digitalinvitro/CPLD-plus-8085/hardware/README.md

# hardware/ — машиночитаемые и визуальные данные платы retro_PCLD_board V2

Экспорт из EasyEDA (проект **CPLD_108_for_retro V2**, дата экспорта 2026-10-20) для платы
retro_PCLD_board V2 (Intel 8085 + CPLD XC95108). Словесным эталоном схемы остаётся
[SCHEMATIC.md](../SCHEMATIC.md) в корне репозитория; файлы здесь — экспорты того же проекта
в стандартных форматах.

## Состав

| Файл | Содержимое | Формат |
|---|---|---|
| `retro_PCLD_board-V2_2026-10-20.net` | Нетлист: 74 компонента, 126 цепей, 394 пина, с номиналами и корпусами | Текст (Protel/Tango): блоки `[ refdes / корпус / значение ]` + цепи `( ИМЯ пины )` |
| `retro_PCLD_board-V2_2026-10-20.svg` | Визуальная схема, один лист (Sheet_1, REV 1.0) | SVG, вектор, текст ищется поиском по странице |
| `BOM_CPLD_108_for_retro-V2_2026-10-20.csv` | Перечень элементов: 45 позиций / 74 компонента | CSV, UTF-8, разделитель — табуляция |

## Верификация (2026-10-21)

- 126/126 цепей и все 394 пина нетлиста совпали с §6 SCHEMATIC.md (имена и наборы пинов);
- цоколёвки всех компонентов совпали с §5 SCHEMATIC.md, расхождений нет;
- одно-пиновых цепей нет; номиналы нетлиста совпадают с колонкой Name в BOM;
- нетлист 2026-10-20 побитно совпал по топологии с ранее проверенным нетлистом
  2026-10-05 — схема не менялась.

## Примечания

- В экспортном BOM отсутствовала позиция LD1 — добавлена строка 45:
  **LD1 = 4-разрядный 7-сегментный индикатор 14,2 мм (0.56"), общий анод,
  Kingbright CA56-126WA** (аноды цифр CA0–CA3 = пины 6/8/9/12; сегменты
  a/b/c/d/e/f/g/dp = пины 11/7/4/2/1/10/5/3).
- Штамп SVG не обновлялся с 2024-12-25 (TITLE: Sheet_1, Company: Your Company) —
  косметика исходного проекта EasyEDA, на схему не влияет.
- «retro_PCLD_board V2» — имя листа/платы, «CPLD_108_for_retro» — имя проекта в
  EasyEDA; это одна и та же плата.
- Не включены (есть в поставке экспорта, добавляются по решению владельца): исходник
  проекта EasyEDA (JSON), Altium .schdoc, PADS-вариант нетлиста (без номиналов),
  SPICE-нетлист.
- Ключевые компоненты: U1 XC95108-PQG100, U3 i8085 в панели ZIF40, U4 SRAM 64K×8
  (UM61512AK-15), U6 CH340G с кварцем X1 12 МГц, U7 LTC6905HS5-80 (в схеме — 80MHz),
  U10 A29040B (flash 512K×8).
