digitalinvitro/CPLD-plus-8085/SCHEMATIC.md

# SCHEMATIC.md — центральная база знаний схемы retro_PCLD_board

> **Правила ведения (договорённость с владельцем проекта):**
> 1. Этот файл — **единственный центральный источник сведений о схеме**.
>    Возвращаясь к проекту, читаем его, а НЕ перечитываем SCHDOC/нетлисты/переписку.
> 2. История изменений проекта ведётся **только в `history.txt`** (корень проекта).
> 3. В исходниках проекта (HDL, прошивки, программы) **исторических сведений нет**.
> 4. При любом изменении схемы: обновляем этот файл + дописываем запись в `history.txt`.
> 5. Таблицы ниже генерируются скриптом `scripts/build_kb.py`; курируемые разделы
>    (описания, проблемы, блоки) редактируются в самом скрипте или прямо в файле.

## 1. Что это за плата

Отладочная плата ретро-системы на процессоре **Intel 8080/8085** (совместимость по шине):
- **U1 XC95108-PQG100** (Xilinx CPLD, MQFP-100, LCSC C3273098) — вся логика обвязки:
  шина процессора, дешифраторы, клавиатура/индикатор, UART-мост, JTAG-логика;
- **U3 ZIF40** — панель под i8085 (процессор устанавливается без пайки);
- **U10 A29040B** (DIP32) — flash 512Kx8, ПЗУ;
- **U4** «64k x 8 bit SRAM» SKINNY-32 (аннотация на схеме: UM61512AK-15) — ОЗУ;
- **U6 CH340G** — USB-UART мост (Type-C), кварц X1 12 МГц + C1/C2 22p;
- **USB2 Type-C 16P** — разъём питания и USB-UART;
- **U7 LTC6905HS5-80** — тактовый генератор (синтезатор частот) для CPLD: фиксированная опорная частота 80 МГц, встроенный делитель на входе DIV, управляется перемычкой H1 (§5); расхождение с замером Task 29 — §7.5;
- **LD1** — 4-разрядный 7-сегментный индикатор (общий анод, 14,2 мм); драйверы цифр VT1-VT4;
- клавиатура 5x4 (19 тактовых кнопок SW1-SW19 + SW20 RESET);
- **J1** — нестандартный JTAG 1x6 для прошивки CPLD;
- **BUZZER1** — звукоизлучатель (звуковая сигнализация);
- **LED2** — светодиод индикации питания;
- питание: +5 В с USB VBUS; блокировочные конденсаторы — керамика 0,1 мкФ (12 шт.) и электролиты 1000 мкФ (2 шт.); R21-R25 10k — подтяжки рядов клавиатуры на GND.

Концепция: CPLD эмулирует недостающую обвязку классической микро-ЭВМ (шина, COM-порт,
клавиатура/индикация), пользовательский i8085 выполняет программу из flash, ОЗУ — данные.

## 2. Источники и их статус

| Файл | Что это | Статус |
|---|---|---|
| `upload/retro_PCLD_board-V2_2026-10-07.schdoc` | Схема, экспорт EasyEDA Pro -> Protel ASCII v5 | **ЭТАЛОН** (22/22 проверки пройдены, 2026-10-07) |
| `upload/retro_PCLD_board-V2_2026-10-07(1).net` | Нетлист PADS-PCB (родной экспорт FreePCB, RX/TX поправлен пользователем) | Валиден; **топологически идентичен эталону** (126/126 цепей) |
| `ref/retro_PCLD_board-V2_2026-10-05.net` | Нетлист PADS-PCB, восстановлен из git-истории репо (коммит `d8ca176`); RX/TX уже объединены | Источник фактических имён цепей для §6 (126 сигналов) |
| `download/schdoc_netlist_final.json` | Машиночитаемый нетлист эталона | производный от SCHDOC |
| `download/schdoc_netlist_final.txt` | Текстовый список цепей эталона | производный |
| `scripts/freepcb_parsed.json` | Машиночитаемый разбор .net | производный |
| EasyEDA-JSON нетлист (первая сессия) | Экспорт EasyEDA Classic | **ЗАБРАКОВАН** — 28 некорректных пинов U10 |

Важно: SCHDOC от 2026-10-07 — уже **исправленная** версия (объединены метки UART TX/RX).
Старая версия от 2026-10-05 имела разрыв UART: TX(U6.2)!=Tx(U1.38), RX(U6.3)!=Rx(U1.39).

## 3. Сводка соединений (проверено)

- компонентов: **74**, физических пинов: **431**
- цепей: **126**, подключённых пинов: **394**
- не подключёно: **37 пинов**, все помечены No-ERC (X) на схеме
- VCC: **38 пинов**, GND: **44 пина**
- прямых касаний пин-пин без провода: **10** (драйверы индикатора — см. §7)
- 1-пиновых цепей: **0**

## 4. Состав компонентов (74)

| Ref | Библиотека | Корпус | Комментарий |
|---|---|---|---|
| BUZZER1 | BUZZER-12X9 | BUZ-TH_BD12.0-P7.60-D0.6-FD | BUZZER-12X9 |
| C1 | 22pF | C0805 | 22pF |
| C10 | 0.1uF | C0805 | 0.1uF |
| C11 | 0.1uF | C0805 | 0.1uF |
| C12 | 0.1uF | C0805 | 0.1uF |
| C13 | 0.1uF | C0805 | 0.1uF |
| C14 | 1000u | CAP-D6.3-F2.5 | 1000u |
| C15 | 0.1uF | C0805 | 0.1uF |
| C16 | 1000u | CAP-D6.3-F2.5 | 1000u |
| C17 | 0.1uF | C0805 | 0.1uF |
| C2 | 22pF | C0805 | 22pF |
| C3 | 0.1u | C0805 | 0.1u |
| C4 | 0.1uF | C0805 | 0.1uF |
| C5 | 0.1uF | C0805 | 0.1uF |
| C6 | 0.1uF | C0805 | 0.1uF |
| C7 | 0.1uF | C0805 | 0.1uF |
| C8 | 0.1uF | C0805 | 0.1uF |
| C9 | 0.1uF | C0805 | 0.1uF |
| H1 | 2.54-1*3 | HDR-TH_3P-P2.54-V-M-1 | 2.54-1*3 |
| J1 | JTAG | HDR-M-2.54_1X6 | JTAG |
| LD1 | DISPLAY 14.2MM RED 4DIGIT CA | 12PIN QUAD LED DISPLAY TH100X600 | DISPLAY 14.2MM RED 4DIGIT CA |
| LED2 | POWER | LED-TH_BD3.0_GREEN | POWER |
| R1 | 1K | R0805 | 1K |
| R10 | 240 | R0805 | 240 |
| R11 | 240 | R0805 | 240 |
| R12 | 240 | R0805 | 240 |
| R18 | 240 | R0805 | 240 |
| R19 | 16K | R0805 | 16K |
| R2 | 240 | R0805 | 240 |
| R20 | 1.1K | R0805 | 1.1K |
| R21 | 10k | R0805 | 10k |
| R22 | 10k | R0805 | 10k |
| R23 | 10k | R0805 | 10k |
| R24 | 10k | R0805 | 10k |
| R25 | 10k | R0805 | 10k |
| R3 | 5.1k | R0805 | 5.1k |
| R4 | 100 | R0805 | 100 |
| R5 | 240 | R0805 | 240 |
| R6 | 240 | R0805 | 240 |
| R7 | 240 | R0805 | 240 |
| R8 | 240 | R0805 | 240 |
| R9 | 240 | R0805 | 240 |
| SW1 | A | B3F-1052 | A |
| SW10 | 5 | B3F-1052 | 5 |
| SW11 | 6 | B3F-1052 | 6 |
| SW12 | F | B3F-1052 | F |
| SW13 | 1 | B3F-1052 | 1 |
| SW14 | 2 | B3F-1052 | 2 |
| SW15 | 3 | B3F-1052 | 3 |
| SW16 | _ | B3F-1052 | _ |
| SW17 | 0 | B3F-1052 | 0 |
| SW18 | F1 | B3F-1052 | F1 |
| SW19 | F2 | B3F-1052 | F2 |
| SW2 | B | B3F-1052 | B |
| SW20 | RESET | KEY-TH_OMRON_B3F-31XX | RESET |
| SW3 | C | B3F-1052 | C |
| SW4 | D | B3F-1052 | D |
| SW5 | 7 | B3F-1052 | 7 |
| SW6 | 8 | B3F-1052 | 8 |
| SW7 | 9 | B3F-1052 | 9 |
| SW8 | E | B3F-1052 | E |
| SW9 | 4 | B3F-1052 | 4 |
| U1 | XC95108-PQG100 | MQFP-100_L20.0-W14.0-P0.65-LS24.0-BL | XC95108-PQG100 |
| U10 | A29040B | DIP32 | A29040B |
| U3 | ZIF40 | 40 PIN ZIF SOCKET | ZIF40 |
| U4 | 64k x 8 bit SRAM | SKINNY-32 | 64k x 8 bit SRAM |
| U6 | CH340G | CH340G | CH340G |
| U7 | 80MHz | TSOT-23-5_L2.9-W1.6-P0.95-LS2.8-BR | 80MHz; по маркировке: LTC6905HS5-80 |
| USB2 | CQ-USB- TYPE-C 16P | USB-C-SMD_CQ-USB-TYPE-C | CQ-USB- TYPE-C 16P |
| VT1 | ? | TO-92-3_L4.9-W3.7-P1.27-L | — |
| VT2 | ? | TO-92-3_L4.9-W3.7-P1.27-L | — |
| VT3 | ? | TO-92-3_L4.9-W3.7-P1.27-L | — |
| VT4 | ? | TO-92-3_L4.9-W3.7-P1.27-L | — |
| X1 | 12MHZ | OSC-49S-1 | 12MHZ |

## 5. Ключевые цоколёвки (пин -> цепь)

### U1 — Xilinx XC95108, PQFP-100 (CPLD)

Все 100 пинов подключены: 7xVCC (7,28,40,53,59,90,100), 8xGND (2,23,33,46,64,71,77,86), 85 I/O.

| Пин | Имя пина | Цепь |
|---|---|---|
| 1 | IO_GSTR | RST |
| 2 | GND | GND |
| 3 | IO3F2 | A14 |
| 4 | IO4F2 | A12 |
| 5 | IO_GTS1 | g |
| 6 | IO_GTS2 | dig0 |
| 7 | VCCint_5V | VCC |
| 8 | IO8F2 | A13 |
| 9 | IO9F2 | A7 |
| 10 | IO10F2 | A8 |
| 11 | IO11F2 | A6 |
| 12 | IO12F2 | A9 |
| 13 | IO13F2 | A5 |
| 14 | IO14F2 | A11 |
| 15 | IO15F1 | A4 |
| 16 | IO16F1 | #OEr |
| 17 | IO17F1 | A3 |
| 18 | IO18F1 | A10 |
| 19 | IO19F1 | A2 |
| 20 | IO20F1 | #CSr |
| 21 | IO21F1 | A1 |
| 22 | IO22F1 | D7 |
| 23 | GND | GND |
| 24 | IO_GCK1 | #WE |
| 25 | IO_GCK2 | #CS |
| 26 | IO26F1 | A0 |
| 27 | IO27F1 | D6 |
| 28 | VCCio_3.3/5 | VCC |
| 29 | IO_GCK3 | clk |
| 30 | IO30F1 | D0 |
| 31 | IO31F3 | D5 |
| 32 | IO32F3 | D1 |
| 33 | GND | GND |
| 34 | IO34F3 | D4 |
| 35 | IO35F3 | D2 |
| 36 | IO36F3 | D3 |
| 37 | IO37F3 | #OE |
| 38 | IO38F3 | TX |
| 39 | IO39F3 | RX |
| 40 | VCCio_3.3/5 | VCC |
| 41 | IO41F3 | col3 |
| 42 | IO42F3 | col2 |
| 43 | IO43F3 | col1 |
| 44 | IO44F3 | col0 |
| 45 | IO45F3 | a |
| 46 | GND | GND |
| 47 | TDI | TDI |
| 48 | IO48F5 | dig3 |
| 49 | TMS | TMS |
| 50 | TCK | TCK |
| 51 | IO51F3 | row4 |
| 52 | IO52F5 | row3 |
| 53 | VCCio_3.3/5 | VCC |
| 54 | IO54F5 | row2 |
| 55 | IO55F5 | row1 |
| 56 | IO56F5 | row0 |
| 57 | IO57F5 | d |
| 58 | IO58F5 | e |
| 59 | VCCint_5V | VCC |
| 60 | IO60F5 | dp56 |
| 61 | IO61F5 | c |
| 62 | IO62F5 | b |
| 63 | IO63F5 | dig1 |
| 64 | GND | GND |
| 65 | IO65F5 | dig2 |
| 66 | IO66F5 | f |
| 67 | IO67F6 | SND |
| 68 | IO68F6 | cpu21 |
| 69 | IO69F6 | cpu20 |
| 70 | IO70F6 | cpu19 |
| 71 | GND | GND |
| 72 | IO72F6 | cpu18 |
| 73 | IO73F6 | cpu17 |
| 74 | IO74F6 | cpu16 |
| 75 | IO75F6 | cpu15 |
| 76 | IO76F6 | cpu14 |
| 77 | GND | GND |
| 78 | IO78F6 | cpu13 |
| 79 | IO79F6 | cpu12 |
| 80 | IO80F6 | cpu11 |
| 81 | IO81F6 | cpu10 |
| 82 | IO82F4 | cpu9 |
| 83 | IO83F4 | cpu8 |
| 84 | IO84F4 | cpu7 |
| 85 | TDO | TDO |
| 86 | GND | GND |
| 87 | IO87F4 | cpu6 |
| 88 | IO88F4 | cpu5 |
| 89 | IO89F4 | cpu4 |
| 90 | VCCio_3.3/5 | VCC |
| 91 | IO91F4 | cpu3 |
| 92 | IO92F4 | cpu2 |
| 93 | IO93F4 | cpu1 |
| 94 | IO94F4 | cpu0 |
| 95 | IO95F4 | A18 |
| 96 | IO96F4 | A16 |
| 97 | IO97F4 | A15 |
| 98 | IO98F2 | A17 |
| 99 | IO99F2 | CS |
| 100 | VCCint_5V | VCC |

### U3 — ZIF-панель на 40 пинов под i8085

Цоколёвка = Intel P8085A: AD0-AD7(12-19)->шина A0-A7, A8-A15(21-28), VCC=40, GND=20; управление: cpu0-21 (29-39 = cpu0..cpu10; 1-11 = cpu21..cpu11 по убыванию).

| Пин | Имя пина | Цепь |
|---|---|---|
| 1 | 1 | cpu21 |
| 2 | 2 | cpu20 |
| 3 | 3 | cpu19 |
| 4 | 4 | cpu18 |
| 5 | 5 | cpu17 |
| 6 | 6 | cpu16 |
| 7 | 7 | cpu15 |
| 8 | 8 | cpu14 |
| 9 | 9 | cpu13 |
| 10 | 10 | cpu12 |
| 11 | 11 | cpu11 |
| 12 | 12 | A0 |
| 13 | 13 | A1 |
| 14 | 14 | A2 |
| 15 | 15 | A3 |
| 16 | 16 | A4 |
| 17 | 17 | A5 |
| 18 | 18 | A6 |
| 19 | 19 | A7 |
| 20 | 20 | GND |
| 21 | 21 | A8 |
| 22 | 22 | A9 |
| 23 | 23 | A10 |
| 24 | 24 | A11 |
| 25 | 25 | A12 |
| 26 | 26 | A13 |
| 27 | 27 | A14 |
| 28 | 28 | A15 |
| 29 | 29 | cpu0 |
| 30 | 30 | cpu1 |
| 31 | 31 | cpu2 |
| 32 | 32 | cpu3 |
| 33 | 33 | cpu4 |
| 34 | 34 | cpu5 |
| 35 | 35 | cpu6 |
| 36 | 36 | cpu7 |
| 37 | 37 | cpu8 |
| 38 | 38 | cpu9 |
| 39 | 39 | cpu10 |
| 40 | 40 | VCC |

### U10 — A29040B flash 512Kx8, DIP32

| Пин | Имя пина | Цепь |
|---|---|---|
| 1 | A18 | A18 |
| 2 | A16 | A16 |
| 3 | A15 | A15 |
| 4 | A12 | A12 |
| 5 | A7 | A7 |
| 6 | A6 | A6 |
| 7 | A5 | A5 |
| 8 | A4 | A4 |
| 9 | A3 | A3 |
| 10 | A2 | A2 |
| 11 | A1 | A1 |
| 12 | A0 | A0 |
| 13 | D0 | D0 |
| 14 | D1 | D1 |
| 15 | D2 | D2 |
| 16 | GND | GND |
| 17 | D3 | D3 |
| 18 | D4 | D4 |
| 19 | D5 | D5 |
| 20 | D6 | D6 |
| 21 | D7 | D7 |
| 22 | /CE | #CSr |
| 23 | A10 | A10 |
| 24 | /OE | #OEr |
| 25 | A11 | A11 |
| 26 | A9 | A9 |
| 27 | A8 | A8 |
| 28 | A13 | A13 |
| 29 | A14 | A14 |
| 30 | A17 | A17 |
| 31 | /WE | N$14 |
| 32 | VCC | VCC |

### U4 — SRAM 64Kx8 (UM61512AK-15), SKINNY-32

| Пин | Имя пина | Цепь |
|---|---|---|
| 1 | N/C | — не подключён (No-ERC) — |
| 2 | N/C | — не подключён (No-ERC) — |
| 3 | A14 | A14 |
| 4 | A12 | A12 |
| 5 | A7 | A7 |
| 6 | A6 | A6 |
| 7 | A5 | A5 |
| 8 | A4 | A4 |
| 9 | A3 | A3 |
| 10 | A2 | A2 |
| 11 | A1 | A1 |
| 12 | A0 | A0 |
| 13 | I/O1 | D0 |
| 14 | I/O2 | D1 |
| 15 | I/O3 | D2 |
| 16 | GND | GND |
| 17 | I/O4 | D3 |
| 18 | I/O5 | D4 |
| 19 | I/O6 | D5 |
| 20 | I/O7 | D6 |
| 21 | I/O8 | D7 |
| 22 | /CE | #CS |
| 23 | A10 | A10 |
| 24 | /OE | #OE |
| 25 | A11 | A11 |
| 26 | A9 | A9 |
| 27 | A8 | A8 |
| 28 | A13 | A13 |
| 29 | /WE | #WE |
| 30 | CE2 | CS |
| 31 | A15 | A15 |
| 32 | +5v | VCC |

### U6 — CH340G USB-UART, SOP-16

| Пин | Имя пина | Цепь |
|---|---|---|
| 1 | GND | GND |
| 2 | TXD | TX |
| 3 | RXD | RX |
| 4 | V3 | N$4 |
| 5 | UD+ | N$39 |
| 6 | UD- | N$38 |
| 7 | XI | N$2 |
| 8 | XO | N$3 |
| 9 | CTS# | — не подключён (No-ERC) — |
| 10 | DSR# | — не подключён (No-ERC) — |
| 11 | RI | — не подключён (No-ERC) — |
| 12 | DCD# | — не подключён (No-ERC) — |
| 13 | DTR# | — не подключён (No-ERC) — |
| 14 | RTS# | — не подключён (No-ERC) — |
| 15 | R232 | — не подключён (No-ERC) — |
| 16 | VCC | VCC |

### USB2 — USB Type-C 16P

| Пин | Имя пина | Цепь |
|---|---|---|
| 0 | EP | — не подключён (No-ERC) — |
| A1B12 | GND | GND |
| A4B9 | VBUS | VCC |
| A5 | CC1 | — не подключён (No-ERC) — |
| A6 | DP1 | N$39 |
| A7 | DN1 | N$38 |
| A8 | SBU1 | — не подключён (No-ERC) — |
| B1A12 | GND | GND |
| B4A9 | VBUS | VCC |
| B5 | CC2 | N$18 |
| B6 | DP2 | N$39 |
| B7 | DN2 | N$38 |
| B8 | SBU2 | — не подключён (No-ERC) — |

### U7 — LTC6905HS5-80: тактовый генератор 80 МГц, TSOT-23-5 (см. §7.5)

| Пин | Имя пина | Цепь |
|---|---|---|
| 1 | V+ | VCC |
| 2 | GND | GND |
| 3 | OE | N$15 |
| 4 | DIV | N$5 |
| 5 | OUT | clk |

Назначение выводов (даташит LTC6905-XXX): V+ — питание; OE — разрешение выхода
(подключён через R19 16K + R20 1.1K к VCC — выход постоянно включён); DIV —
трёхуровневый вход выбора деления (VCC -> /1, плавающее состояние -> /2, GND -> /4),
управляется перемычкой H1; OUT — выход тактовой частоты в цепь clk.

### LD1 — Индикатор на 4 цифры, общий анод, 12 пинов

| Пин | Имя пина | Цепь |
|---|---|---|
| 1 | e | e |
| 2 | d | d |
| 3 | CL | dp56 |
| 4 | c | c |
| 5 | g | g |
| 6 | CA0 | N$9 |
| 7 | b | b |
| 8 | CA1 | N$6 |
| 9 | CA2 | N$7 |
| 10 | f | f |
| 11 | a | a |
| 12 | CA3 | N$8 |

### J1 — JTAG 1x6 (нестандартная распиновка)

| Пин | Имя пина | Цепь |
|---|---|---|
| 1 | 1 | VCC |
| 2 | 2 | TCK |
| 3 | 3 | TDO |
| 4 | 4 | TDI |
| 5 | 5 | TMS |
| 6 | 6 | GND |

### H1 — Перемычка 1x3 (выбор режима генератора U7)

| Пин | Имя пина | Цепь |
|---|---|---|
| 1 | 1 | GND |
| 2 | 2 | N$5 |
| 3 | 3 | VCC |

Средний контакт H1.2 соединён с входом DIV генератора U7.4 (цепь N$5); крайние
контакты: H1.1 — GND, H1.3 — VCC. Вход DIV — трёхуровневый (three-state): уровень
на нём задаёт коэффициент деления опорной частоты U7 80 МГц (даташит LTC6905-XXX).
Такое подключение реализует все три состояния входа DIV, предусмотренные даташитом:

| Положение перемычки | Уровень DIV -> деление | GCK3 | X1 (после /5 в U1) | CPU (X1/2) | Режим |
|---|---|---|---|---|---|
| Шунт H1.1–H1.2 | GND -> /4 | 20 МГц | 4,0 МГц | 2,0 МГц | **штатный** (замер Task 29 дал 25 МГц — см. §7.5) |
| Шунт снят (H1.2 свободен) | плавающее состояние -> /2 | 40 МГц | 8,0 МГц | 4,0 МГц | нештатный: CPU выше спецификации i8085A (3 МГц) |
| Шунт H1.2–H1.3 | VCC -> /1 | 80 МГц | 16,0 МГц | 8,0 МГц | **запрещено**: срыв генерации CPU (см. §7.5). НЕ переключать |

Примечание: штатное положение — шунт между H1.1 и H1.2 (DIV = GND, деление /4);
фактическую установку на плате сверить по фото Task 29 (upload/).

## 6. Полный список цепей (126)

Имена цепей канонические — как в SCHDOC. Колонка «Имя в .net» заполнена фактическими
именами из нетлиста `retro_PCLD_board-V2_2026-10-05.net` (см. §2, `ref/`); сопоставление
выполнено скриптом `scripts/fill_net_names.py` по наборам пинов: 126/126 цепей идентичны.
Правила имён: именованные цепи — в верхнем регистре (`cpu0`->`CPU0`, `clk`->`CLK`),
безымянные — автогенерированы в формате `REF_PIN` (`N$5`->`U7_4`, `N$15`->`U7_3`).

| Цепь (SCHDOC) | Имя в .net | Пины | Назначение |
|---|---|---|---|
| #CS | #CS | U1.25, U4.22 |  |
| #CSr | #CSR | U1.20, U10.22 |  |
| #OE | #OE | U1.37, U4.24 |  |
| #OEr | #OER | U1.16, U10.24 |  |
| #WE | #WE | U1.24, U4.29 |  |
| A0 | A0 | U1.26, U10.12, U3.12, U4.12 |  |
| A1 | A1 | U1.21, U10.11, U3.13, U4.11 |  |
| A10 | A10 | U1.18, U10.23, U3.23, U4.23 |  |
| A11 | A11 | U1.14, U10.25, U3.24, U4.25 |  |
| A12 | A12 | U1.4, U10.4, U3.25, U4.4 |  |
| A13 | A13 | U1.8, U10.28, U3.26, U4.28 |  |
| A14 | A14 | U1.3, U10.29, U3.27, U4.3 |  |
| A15 | A15 | U1.97, U10.3, U3.28, U4.31 |  |
| A16 | A16 | U1.96, U10.2 |  |
| A17 | A17 | U1.98, U10.30 |  |
| A18 | A18 | U1.95, U10.1 |  |
| A2 | A2 | U1.19, U10.10, U3.14, U4.10 |  |
| A3 | A3 | U1.17, U10.9, U3.15, U4.9 |  |
| A4 | A4 | U1.15, U10.8, U3.16, U4.8 |  |
| A5 | A5 | U1.13, U10.7, U3.17, U4.7 |  |
| A6 | A6 | U1.11, U10.6, U3.18, U4.6 |  |
| A7 | A7 | U1.9, U10.5, U3.19, U4.5 |  |
| A8 | A8 | U1.10, U10.27, U3.21, U4.27 |  |
| A9 | A9 | U1.12, U10.26, U3.22, U4.26 |  |
| CS | CS | U1.99, U4.30 |  |
| D0 | D0 | U1.30, U10.13, U4.13 |  |
| D1 | D1 | U1.32, U10.14, U4.14 |  |
| D2 | D2 | U1.35, U10.15, U4.15 |  |
| D3 | D3 | U1.36, U10.17, U4.17 |  |
| D4 | D4 | U1.34, U10.18, U4.18 |  |
| D5 | D5 | U1.31, U10.19, U4.19 |  |
| D6 | D6 | U1.27, U10.20, U4.20 |  |
| D7 | D7 | U1.22, U10.21, U4.21 |  |
| GND | GND | C1.2, C10.2, C11.2, C12.2, C13.2, C14.2, C15.2, C16.2, C17.2, C2.2, C3.2, C4.2, C5.2, C6.2, C7.2, C8.2, C9.2, H1.1, J1.6, LED2.2, R21.2, R22.2, R23.2, R24.2, R25.2, R3.2, R4.1, SW20.3, SW20.4, U1.2, U1.23, U1.33, U1.46, U1.64, U1.71, U1.77, U1.86, U10.16, U3.20, U4.16, U6.1, U7.2, USB2.A1B12, USB2.B1A12 | Земля (44 пина) |
| RST | RST | SW20.1, U1.1 | Сброс системы: SW20 -> GSTR(U1.1). ПРИМЕЧАНИЕ Task 25: на плате кнопка с активным уровнем 1 (покой RST=0, нажатие RST=1 — эксперименты A/B/C); netlist противоречит (подтяжка R2 240 к VCC на SW20.2 должна давать актив.0) — проверить установку R2/SW20 мультиметром (U1.1: покой ~0 В, нажатие ~+5 В) |
| RX | RX | U1.39, U6.3 | UART RX: CH340G RXD(U6.3) <-> CPLD Tx-выход(U1.39); метки унифицированы 2026-10-07 |
| SND | SND | BUZZER1.1, U1.67 | Звук: CPLD -> BUZZER1.1 (активный звукоизлучатель, питание от VCC) |
| TCK | TCK | J1.2, U1.50 | JTAG TCK (J1.2) |
| TDI | TDI | J1.4, U1.47 | JTAG TDI (J1.4) |
| TDO | TDO | J1.3, U1.85 | JTAG TDO (J1.3) |
| TMS | TMS | J1.5, U1.49 | JTAG TMS (J1.5) |
| TX | TX | U1.38, U6.2 | UART TX: CH340G TXD(U6.2) <-> CPLD Rx-вход(U1.38); метки унифицированы 2026-10-07 |
| VCC | VCC | C10.1, C11.1, C12.1, C13.1, C14.1, C15.1, C16.1, C17.1, C4.1, C5.1, C6.1, C7.1, C8.1, C9.1, H1.3, J1.1, R1.1, R18.2, R2.1, R20.1, U1.100, U1.28, U1.40, U1.53, U1.59, U1.7, U1.90, U10.32, U3.40, U4.32, U6.16, U7.1, USB2.A4B9, USB2.B4A9, VT1.1, VT2.1, VT3.1, VT4.1 | Питание +5 В (38 пинов): USB VBUS; блокировка C4-C17 — керамика 0,1 мкФ x12 + электролиты 1000 мкФ x2 (C14, C16) |
| a | A | LD1.11, U1.45 |  |
| b | B | LD1.7, U1.62 |  |
| c | C | LD1.4, U1.61 |  |
| clk | CLK | U1.29, U7.5 | Тактирование CPLD: U7.5 (LTC6905HS5-80: опорная частота
  80 МГц; штатно деление /4 через H1 -> GCK3 = 20 МГц; замер Task 29 дал 25 МГц —
  см. §7.5) -> GCK3(U1.29) — глобальный тактовый сигнал CPLD;
  делитель U1: /5 -> X1 = 4,0 МГц штатно |
| col0 | COL0 | SW1.4, SW13.4, SW17.4, SW5.4, SW9.4, U1.44 |  |
| col1 | COL1 | SW10.4, SW14.4, SW18.4, SW2.4, SW6.4, U1.43 |  |
| col2 | COL2 | SW11.4, SW15.4, SW19.4, SW3.4, SW7.4, U1.42 |  |
| col3 | COL3 | SW12.4, SW16.4, SW4.4, SW8.4, U1.41 |  |
| cpu0 | CPU0 | U1.94, U3.29 |  |
| cpu1 | CPU1 | U1.93, U3.30 |  |
| cpu10 | CPU10 | U1.81, U3.39 |  |
| cpu11 | CPU11 | U1.80, U3.11 |  |
| cpu12 | CPU12 | U1.79, U3.10 |  |
| cpu13 | CPU13 | U1.78, U3.9 |  |
| cpu14 | CPU14 | U1.76, U3.8 |  |
| cpu15 | CPU15 | U1.75, U3.7 |  |
| cpu16 | CPU16 | U1.74, U3.6 |  |
| cpu17 | CPU17 | U1.73, U3.5 |  |
| cpu18 | CPU18 | U1.72, U3.4 |  |
| cpu19 | CPU19 | U1.70, U3.3 |  |
| cpu2 | CPU2 | U1.92, U3.31 |  |
| cpu20 | CPU20 | U1.69, U3.2 |  |
| cpu21 | CPU21 | U1.68, U3.1 |  |
| cpu3 | CPU3 | U1.91, U3.32 |  |
| cpu4 | CPU4 | U1.89, U3.33 |  |
| cpu5 | CPU5 | U1.88, U3.34 |  |
| cpu6 | CPU6 | U1.87, U3.35 |  |
| cpu7 | CPU7 | U1.84, U3.36 |  |
| cpu8 | CPU8 | U1.83, U3.37 |  |
| cpu9 | CPU9 | U1.82, U3.38 |  |
| d | D | LD1.2, U1.57 |  |
| dig0 | DIG0 | R5.1, U1.6 |  |
| dig1 | DIG1 | R10.1, U1.63 |  |
| dig2 | DIG2 | R11.1, U1.65 |  |
| dig3 | DIG3 | R12.1, U1.48 |  |
| dp56 | DP56 | LD1.3, U1.60 |  |
| e | E | LD1.1, U1.58 |  |
| f | F | LD1.10, U1.66 |  |
| g | G | LD1.5, U1.5 |  |
| row0 | ROW0 | R25.1, SW1.1, U1.56 |  |
| row1 | ROW1 | R24.1, SW5.1, U1.55 |  |
| row2 | ROW2 | R23.1, SW9.1, U1.54 |  |
| row3 | ROW3 | R22.1, SW13.1, U1.52 |  |
| row4 | ROW4 | R21.1, SW17.1, U1.51 |  |
| N$1 | BUZZER1_2 | BUZZER1.2, R4.2 | звукоизлучатель BUZZER1.2 -> токоограничивающий R4 100 -> GND |
| N$2 | U6_7 | C1.1, U6.7, X1.2 | кварц 12 МГц X1 -> C1 22p -> XI(U6.7) CH340G |
| N$3 | U6_8 | C2.1, U6.8, X1.1 | кварц 12 МГц X1 -> C2 22p -> XO(U6.8) CH340G |
| N$4 | U6_4 | C3.1, U6.4 | V3(CH340G) -> C3 0.1u -> GND (внутренний источник 3,3 В) |
| N$5 | U7_4 | H1.2, U7.4 | U7.4 -> перемычка H1.2 (H1: 1=GND, 3=VCC) — выбор коэффициента деления генератора (см. §5, H1) |
| N$6 | LD1_8 | LD1.8, R7.2 | CA1 индикатора LD1.8 -> R7 240 (коллекторная цепь VT2) |
| N$7 | LD1_9 | LD1.9, R8.2 | CA2 индикатора LD1.9 -> R8 240 (коллекторная цепь VT3) |
| N$8 | LD1_12 | LD1.12, R9.2 | CA3 индикатора LD1.12 -> R9 240 (коллекторная цепь VT4) |
| N$9 | LD1_6 | LD1.6, R6.2 | CA0 индикатора LD1.6 -> R6 240 (коллекторная цепь VT1) |
| N$10 | R1_2 | LED2.1, R1.2 | LED2 POWER (зелёный) -> R1 1K -> VCC |
| N$11 | VT2_2 | R10.2, VT2.2 | база VT2 -> R10 240 -> dig1 |
| N$12 | VT3_2 | R11.2, VT3.2 | база VT3 -> R11 240 -> dig2 |
| N$13 | VT4_2 | R12.2, VT4.2 | база VT4 -> R12 240 -> dig3 |
| N$14 | U10_31 | R18.1, U10.31 | ВНИМАНИЕ: /WE(U10.31) -> R18 240 -> VCC — единственное управление записью во flash |
| N$15 | U7_3 | R19.2, U7.3 | U7.3 -> R19 16K (цепь OE генератора 80 МГц) |
| N$16 | R19_1 | R19.1, R20.2 | узел R19.1–R20.2; R20 1.1K -> VCC (последовательно в цепи OE генератора) |
| N$17 | R2_2 | R2.2, SW20.2 | SW20 RESET.2 -> R2 240 -> VCC (подтяжка сброса); см. примечание к цепи RST (Task 25: плата ведёт себя как актив.1) |
| N$18 | USB2_B5 | R3.1, USB2.B5 | CC2 (USB2.B5) -> R3 5.1K -> GND (Rd для USB-C) |
| N$19 | VT1_2 | R5.2, VT1.2 | база VT1 -> R5 240 -> dig0 |
| N$20 | R6_1 | R6.1, VT1.3 | коллектор VT1 -> R6 240 -> CA0 |
| N$21 | R7_1 | R7.1, VT2.3 | коллектор VT2 -> R7 240 -> CA1 |
| N$22 | R8_1 | R8.1, VT3.3 | коллектор VT3 -> R8 240 -> CA2 |
| N$23 | R9_1 | R9.1, VT4.3 | коллектор VT4 -> R9 240 -> CA3 |
| N$24 | SW1_2 | SW1.2, SW2.1 | сегмент линии row0: SW1.2–SW2.1 (через внутренние выводы 1-2 кнопок) |
| N$25 | SW10_2 | SW10.2, SW11.1 | сегмент линии row2: SW10.2–SW11.1 |
| N$26 | SW9_2 | SW10.1, SW9.2 | сегмент линии row2: SW9.2–SW10.1 |
| N$27 | SW11_2 | SW11.2, SW12.1 | сегмент линии row2: SW11.2–SW12.1 |
| N$28 | SW14_1 | SW13.2, SW14.1 | сегмент линии row3: SW13.2–SW14.1 |
| N$29 | SW14_2 | SW14.2, SW15.1 | сегмент линии row3: SW14.2–SW15.1 |
| N$30 | SW15_2 | SW15.2, SW16.1 | сегмент линии row3: SW15.2–SW16.1 |
| N$31 | SW18_1 | SW17.2, SW18.1 | сегмент линии row4: SW17.2–SW18.1 |
| N$32 | SW19_1 | SW18.2, SW19.1 | сегмент линии row4: SW18.2–SW19.1 |
| N$33 | SW2_2 | SW2.2, SW3.1 | сегмент линии row0: SW2.2–SW3.1 |
| N$34 | SW3_2 | SW3.2, SW4.1 | сегмент линии row0: SW3.2–SW4.1 |
| N$35 | SW5_2 | SW5.2, SW6.1 | сегмент линии row1: SW5.2–SW6.1 |
| N$36 | SW6_2 | SW6.2, SW7.1 | сегмент линии row1: SW6.2–SW7.1 |
| N$37 | SW7_2 | SW7.2, SW8.1 | сегмент линии row1: SW7.2–SW8.1 |
| N$38 | U6_6 | U6.6, USB2.A7, USB2.B7 | USB D- (USB2.A7/B7 -> UD- U6.6) |
| N$39 | U6_5 | U6.5, USB2.A6, USB2.B6 | USB D+ (USB2.A6/B6 -> UD+ U6.5) |

## 7. Функциональные блоки (как устроено)

### 7.1 Шина процессора
- AD0-AD7 (ZIF 12-19) <-> CPLD, буферизуются в шину A0-A7; A8-A15 (ZIF 21-28)
  идут напрямую в память; A15 заведён и в SRAM (U4), A16-A18 — только во flash;
- D0-D7 — общая шина данных flash+SRAM+CPLD (cpu-порт D0-D7);
- управление: cpu0..cpu21 (29-39: HOLD,HLDA,CLK,RESET_IN,READY,IO/M,RD,WR,ALE,S0,S1;
  1-11: INTA->cpu11 … X1->cpu21 — по убыванию); RST -> GSTR(U1.1); тактирование: U7 LTC6905HS5-80 (база 80 МГц, штатно /4 = 20 МГц) -> GCK3(U1.29).

### 7.2 Питание и USB
- VBUS Type-C -> VCC (38 пинов); блокировочные конденсаторы C4-C17: керамика 0,1 мкФ (по одному у каждой МС) + электролиты 1000 мкФ (C14, C16);
- CC2 (B5) имеет Rd 5.1K на GND (R3); **CC1 (A5) НЕ подключён** — см. проблемы;
- LED2 POWER + R1 1K.

### 7.3 UART
- CH340G: UD±->USB, TXD(U6.2)->TX->U1.38, RXD(U6.3)<-RX<-U1.39; кварц 12 МГц X1+C1/C2 22p;
- неиспользуемые модемные сигналы U6.9-15 — No-ERC.

### 7.4 Индикатор и клавиатура
- Драйвер цифр: U1 dig0-3 -> R5/R10/R11/R12 240 -> базы VT1-VT4 (PNP, эмиттер на VCC);
  коллекторы -> R6/R7/R8/R9 240 -> CA0-CA3 (пины 6/8/9/12 LD1) — касания пин-пин без проводов;
- сегменты a-g и dp56 идут с CPLD напрямую (U1.45->a…U1.5->g, U1.60->dp56);
- клавиатура 5x4: ряды row0-row4 (R21-R25 10k на GND — подтяжки вниз), столбцы col0-col3;
  линии рядов замыкаются ЧЕРЕЗ внутренние выводы 1-2 тактовых кнопок (N$24-N$37 —
  сегменты этих линий; при трассировке PCB помнить: пины 1-2 B3F закорочены внутри);
- SW20 RESET: RST = SW20.1, подтяжка R2 240 к VCC на SW20.2. ПРИМЕЧАНИЕ Task 25:
  кнопка на плате с активным уровнем 1 (покой 0, нажатие 1); в CPLD RESET_IN = ~(RST|POR),
  сброс всех FF синхронный (RST|POR), GSR не используется.

### 7.5 Генератор тактовой частоты и JTAG
- **U7 = LTC6905HS5-80** (Analog Devices/Linear Technology, TSOT-23-5; чип подтверждён
  владельцем по маркировке корпуса) — кремниевый тактовый генератор семейства
  LTC6905-XXX с фиксированной опорной частотой 80 МГц и встроенным делителем
  на входе DIV. По даташиту вход DIV трёхуровневый: VCC -> /1 (80 МГц), плавающее
  состояние -> /2 (40 МГц), GND -> /4 (20 МГц); вход OE разрешает выход.
  На плате: OE (U7.3) подтянут к VCC через R19 16K + R20 1.1K (выход всегда включён),
  DIV (U7.4) идёт на средний контакт перемычки H1 (см. §5, H1), выход clk -> GCK3(U1.29).
  Характеристики семейства (даташит): питание 2,7-5,5 В, точность частоты ±0,5 % (тип.),
  температурная стабильность ±20 ppm/°C, запуск ~100 мкс, скважность 50 % ±2,5 %.
- Расхождение с замером Task 29 (2026-10-10, осциллограф, фото в upload/): при штатном
  DIV = GND (/4) ожидается GCK3 = 20 МГц -> X1 = 4,0 МГц -> CPU = 2,0 МГц; замер дал
  GCK3 = 25 МГц, X1 = 6,4 МГц, CLK OUT = 3,14 МГц (CPU исправен, CLK OUT = X1/2).
  Замеренные 25 МГц соответствовали бы чипу LTC6905-100 при делении /4. Причина не
  выяснена: неточность замера или другой чип семейства на плате — сверить маркировку,
  повторить замер.
- История: до установки делителя /5 в U1 наблюдались срывы тактирования CPU:
  X1 получал полную частоту GCK3 (замер 25 МГц -> внутренние 12,5 МГц) -> срыв
  генератора CPU на субгармонику ~1,5 МГц с паразитным акустическим шумом (в записях
  Task 29 фигурирует как «сверчок»). После добавления делителя U1: /5 (mod-5, декод
  с регистрацией) -> X1 = 5,0 МГц, CPU = 2,5 МГц — под прежнюю гипотезу базы ~100 МГц;
  при подтверждении опорной частоты 80 МГц ожидается X1 = 4,0 МГц, CPU = 2,0 МГц
  (см. ARCHITECTURE.md §7).
- J1 JTAG: 1=VCC, 2=TCK, 3=TDO, 4=TDI, 5=TMS, 6=GND; подтяжек TMS/TDI нет (см. проблемы).

### 7.6 Звук
- SND (CPLD) -> BUZZER1.1; BUZZER1.2 -> R4 100 -> GND.
- **10-24, статус по факту:** BUZZER1 (BUZZER-12X9) был активным излучателем —
  владелец заменил его на **пассивный** (тон чище, форму задаёт строб SND).
  Остался выброс индуктивности на фронте SND (слышен как глитч): кандидат —
  последовательный резистор 100–470 Ом в цепь SND, снаббер RC или
  встречно-параллельный диод. Детали — beta/01_timer/README.md.

## 8. Известные проблемы схемы

| № | Проблема | Статус |
|---|---|---|
| 1 | UART разорван из-за несовпадения регистра меток (TX!=Tx, RX!=Rx) | **ИСПРАВЛЕНО** в SCHDOC 2026-10-07: метки унифицированы, цепи TX/RX объединены |
| 2 | CC1 (USB2.A5) висит: Rd 5.1K только на CC2 — питание USB гарантировано только в одной ориентации кабеля | **ОТКРЫТА** |
| 3 | U10.31 /WE управляется только подтяжкой R18 240 к VCC — запись во flash невозможна (цепь N$14) | **ОТКРЫТА** |
| 4 | EP (shell) разъёма USB висит | **ОТКРЫТА** (низкий приоритет) |
| 5 | J1 JTAG без подтяжек TMS/TDI | **ОТКРЫТА** (для отладочной платы допустимо) |

## 9. Верификация

- `scripts/schdoc_extract.py` — парсер SCHDOC + 22 встроенные проверки эталона: все PASS
  (74 компонента / 431 пин / 126 цепей / 394 пина / VCC=38 / GND=44 / U10=32 / U3=i8085 /
  цепи UART объединены / 0 одно-пиновых / 37 No-ERC).
- `scripts/diff_nets.py` — поцепное сравнение SCHDOC <-> FreePCB .net: **126/126 цепей идентичны**
  по наборам пинов; расхождения только в именах (регистр + автогенерация).
- История вопроса «+10 цепей» (118->126): закрыта. 10 цепей — прямые касания пин-пин
  драйверов индикатора (VT/LD/R), старый парсер их не учитывал, FreePCB-нетлист — корректен.

## 10. Инструменты (scripts/)

| Скрипт | Назначение |
|---|---|
| `schdoc_extract.py` | Разбор Protel ASCII SCHDOC (диалект EasyEDA Pro) -> нетлист JSON/TXT + проверки эталона |
| `freepcb_parse.py` | Парсер/валидатор нетлистов FreePCB (`[parts]`/`[nets]`) и PADS-PCB (`*PART*`/`*NET*`/`*SIGNAL*`) |
| `diff_nets.py` | Поцепное сравнение двух нетлистов по множествам пинов |
| `build_kb.py` | Повторная генерация этого файла из JSON |

Повторная генерация эталона: `python3 scripts/schdoc_extract.py upload/retro_PCLD_board-V2_2026-10-07.schdoc --json download/schdoc_netlist_final.json --report download/schdoc_netlist_final.txt`

## 11. Памятка ИИ-агенту

- Любой вопрос про соединения/цоколёвку/состав — смотреть §4-6 этого файла,
  а не перечитывать исходники; углубляться в SCHDOC только при подозрении на ошибку.
- При изменении схемы пользователем: прогнать `schdoc_extract.py` (если есть новый SCHDOC)
  и `diff_nets.py`, обновить §3-§8 и дописать `history.txt`.
- Имена цепей: канонические — SCHDOC; в HDL допустимы имена в верхнем регистре (clk->CLK и т.п.).
- Формат координат/записей SCHDOC и типичные проблемы парсинга — см. докстринг `schdoc_extract.py`.
