digitalinvitro/CPLD-plus-8085/ОПИСАНИЕ_РЕПОЗИТОРИЯ.md

# Описание сути репозитория (тестовый файл)

> Этот файл создан ИИ-агентом (Z.ai) в качестве тестового задания на работу с GitHub.
> Дата анализа: 21.10.2026. Анализ выполнен по файлам репозитория: нетлист, PDF-схема, состав файлов.

## Что это за проект

**CPLD-plus-8085** — экспериментальная учебная плата для ретро-вычислений на базе
легендарного 8-битного процессора **Intel 8085** (1976 г.) в корпусе DIP-40.

Особенность проекта: вместо классической «обвязки» из множества микросхем логики
(дешифраторы адреса, регистры, буферы) используется **CPLD Xilinx XC95108**
(семейство XC9500, 108 макроячеек, корпус TQFP-100 / PQG100), программируемый по JTAG.
Отсюда и название: **CPLD + 8085**.

## Ключевые компоненты (по нетлисту V2 от 2026-10-05)

| Обозначение | Компонент | Назначение |
|---|---|---|
| U3 | 40-pin ZIF-панель | Установка процессора Intel 8085 без пайки |
| U1 | Xilinx XC95108-PQG100 | CPLD: дешифрация адреса, системная логика, ввод-вывод |
| U4 | SKINNY-32 (панель) | Гнездо ПЗУ/EEPROM (32 выв.) |
| U10 | DIP32 | SRAM типа 62xx (статическое ОЗУ) |
| U6 | CH340G | USB-UART преобразователь (связь с ПК, загрузка программ) |
| U7 | TSOT-23-5 | Стабилизатор питания |
| X1 | OSC-49S | Кварцевый резонатор / тактирование |
| LD1 | QUAD LED DISPLAY | 4-разрядный семисегментный индикатор |
| BUZZER1, LED2 | Зуммер, светодиод | Звуковая и световая индикация |
| J1 | 6-pin разъём | JTAG-программирование CPLD (TCK, TDI, TDO, TMS) |

## Состав файлов репозитория

- `Schematic_CPLD_108_for_retro-V2_2026-10-05.pdf / .svg` — принципиальная схема (V2)
- `PCB_retro_CPLD_PCB-V2_2026-10-05.pdf / .svg` — печатная плата (V2)
- `retro_PCLD_board-V2_2026-10-05.schdoc` — исходник схемы (Altium Designer)
- `retro_PCLD_board-V2_2026-10-05.net` — нетлист платы (формат PADS-PCB)
- `i8085-DIP40.png` — изображение процессора Intel 8085

## Вывод

Это полноценный DIY-проект для изучения архитектуры классических микропроцессоров:
плата собирается из доступных компонентов, процессор вставляется в ZIF-панель,
логика проекта меняется перепрошивкой CPLD по JTAG, а результат виден на семисегментном
индикаторе и слышен через зуммер. Отличный «конструктор» для ретро-энтузиастов
и изучения того, как компьютер устроен «на низком уровне».

---
*Файл добавлен агентом Z.ai по просьбе владельца репозитория. Если он вам не нужен — просто удалите.*
