digitalinvitro/CPLD-plus-8085/beta/README.md

# beta/ — экспериментальные доработки «харда»

Папка для опытов над дизайном CPLD поверх **стабильного baseline** из `hdl/`
(`top_suart.v` v3.2, фит 2026-10-22 «POR6»: 91/108 MC, 0 WARNING/ERROR,
72/72 ноги по UCF, железо проверено в работе).

**Дневник разработки** — `beta/DEVLOG.md`: история версий, перенесённые из
RTL комментарии (с 11-7 шапки чистятся: v3.9.8 → `lowsize/top_suart_por6_v398_clear.v`),
наблюдения железа. В файлах дизайнов остаются только действующие решения.

## Правила

1. `hdl/` не трогаем: baseline остаётся эталоном, от него делаются ветки.
2. Каждый эксперимент — подпапка `beta/<имя>/` со своим комплектом:
   изменённый `.v` (или патч к baseline), `.ucf` (если меняются ноги),
   отчёт фиттера `.rpt` и краткий вывод (влез / не влез / что дало).
3. В `hdl/` переезжает только то, что прошло фит без ошибок И проверку
   на железе. Откат тривиален — baseline всегда в `hdl/`.
4. Свободный ресурс baseline (целься в него, не забивай под ноль):
   **17 MC, 50 FB-входов, 315 PT**; исчерпаны FB1 (входы 36/36) и
   FB6 (макроячейки 18/18); свободные ноги: P74, P75, P76, P78, P79,
   P81, P95, P96, P98 (сейчас PGND).

## Очередь экспериментов

| # | Идея | Статус |
|---|---|---|
| 1 | **Программируемый интервальный таймер** с выходом на маскируемое прерывание CPU (RST 7.5, нога P75): 8-разрядный с устанавливаемым значением, квант 51,2 мкс, ре-арм из ISR | **v3.3b3: ФИТ УСПЕШЕН** (10-22 22:04): 103/108 MC (запас 5), FB-входы 188/216, 0 ERROR; единственный WARNING 897 — D<7> в буфере (FB1: входы 36/36, пин P22 привязан к плате). **Готова тест-прошивка ПЗУ** `01_timer/rom/` v2 (тон ~470 Гц + мигание сегмента ~1 Гц; тихий blink-only вариант; v1 отозвана: PUSH B/POP B затирали счётчик мигания — тон работал, 'g' не мигал; протокол дефекта в README) — см. README. История провалов v3.3b1/b2 и лекарство — там же; ждёт tb и железа. **10-23: железо — тон/мигание v2 ПАСС** (осциллограмма: 493 Гц, меандр 50/50; «нечистый» тон — свойство активного излучателя). **10-23: тест UART** — `timer_test_uart.hex` v4 (бит = N×Q от таймера, 1 прерывание = 1 бит, 2400 бод по умолчанию; референс `uart_sw_test.hex` на софт-делеях). **Прогон на железе: мусор сериями в ~25% строк (дамп) → диагноз: коллизия границы кадра при TX 2465 бод (+2,7%) при кадрах вплотную (след. старт на 26% бита раньше конца кадра приёмника) → фикс v4: 2-й стоп-бит (холостой бит, 11 фронтов/символ), 207 байт. **Уточнена модель кванта**: период = ровно N тиков, Q ≈ 50,7 мкс (clk ≈ 25,2 МГц — «сверчок» +1%); 50 Гц — N=197; арбитр — частотомер на CLKOUT (~2,52 МГц) или прогон n10 (~986 Гц). **10-24: v4 ПАСС на железе** («текст ровный») — TX-тракт закрыт. **10-24: BUZZER1 заменён владельцем на пассивный** (тон чище; остался глитч от выброса индуктивности на фронте SND — кандидат на гасящий резистор, см. README 01_timer). **Следующий шаг: тест приёма-передачи (эхо, RIM/SID)**. XXX_ECHO_READY_XXX — `uart_echo_test.hex` (229 байт): баннер '>' + посимвольное эхо, приём через RIM/SID опросом с DI, 1-й зазор 1,5 бита загрузкой в таймер, сетка 8 квантов/бит из ISR, хвост 3 интервала (урок v4 зеркально: эхо-старт после конца кадра ПКА, запас +2,15 бита); CPLD не менялся (шьётся только ПЗУ); модель sim_uart_echo.py — 400 свипов, запас выборки 130 мкс; verify_hex.py v5 — 5 образов побайтово; paste — задокументированное ограничение v1. **10-24: эхо на железе — баннер '>' ЕСТЬ, эха НЕТ** (ввод не возвращается): TX доказан, приём PC→плата (CH340G.TXD → P38 → SID → RIM) упражняется впервые; бумажная сверка чиста (транзит в фите v3.3b3, медь по нетлисту) → **сделан uart_echo_diag.hex** (352 байта): логика эха не тронута, на дисплей выведены счётчик пойманных старт-битов и последний принятый байт (hex) — локализует разрыв (flow control терминала — главный подозреваемый: модемные линии CH340G не разведены; обрыв P38; SID/ZIF). Верификация: ISR = v1 байт в байт, вставки по контрольным точкам, симуляция с латентностью diag — ПАСС. **10-27: ВЕТКА ПРИОСТАНОВЛЕНА РЕШЕНИЕМ ВЛАДЕЛЬЦА** — возврат к baseline v3.2 (без таймера), софт-машину UART на таймере снять с испытаний, не дожидаясь эхо-теста. Счёт верификации на момент снятия: **TX ПАСС** (v4 «текст ровный», 10-24), **RX-уровень ПАСС дважды** (diag6 10-26, исход N1; 10-27 владелец подтвердил мультиметром сигнал терминала вплоть до CPU.SID и живую реакцию DIG0 на набор = RIM читает биты), **эхо-тест diag4 после починки контакта так и не прогнан** — финальная точка в верификации RX не поставлена (при этом найденные и исправленные по симуляции баги RX-кода v1–v3 никуда не деваются). Возврат: CPLD — фит baseline `hdl/` (POR6, 91/108 MC), ПЗУ — fw_mon в offset 0 (сейчас там diag6). Код, журнал и методика diag2–diag6 сохранены в `beta/01_timer/` — пригодятся при возвращении к таймеру (естественное место — второй CPLD, вариант «чипсет», см. обсуждение V3). Освободившиеся ресурсы baseline: 17 MC, 50 FB-входов, 315 PT |
| 2 | **hiclock — апгрейд тактирования**: U7 LTC6905-80 80 МГц → шунт H1 1-2 → GCK3 25 МГц → CLK_DIV в CPLD → X1/X2 противофазой на CPU (3,125 МГц) | Готовый v3.4 УЖЕ в `hdl/` как релиз (коммит `670c4da`, фит 10-27 10:06PM, железо ПАСС clk10-38: монитор 6000 8N1) — в beta живёт только **кандидат v3.5 «регистровая противофаза X2»** (`hiclock/`): латентный дефект v3.4 — комб. `assign X2 = ~X1` фиттер поднял в same-D регистр (X2 В ФАЗЕ с X1; CPU не задет, не блокер); v3.5 строит противофазу по построению — X2 = регистр `x2_q`, D = `~(x1_q ^ t0_q)` != D(x1_q), init (x1_q=1, x2_q=0), все 4 ветки generate, UCF без изменений (байт-в-байт = hdl). Статус: **дизайн закоммичен; ждёт фита владельца в ISE → .rpt на аудит (чек-лист в README hiclock) → только потом .jed; ДО АУДИТА НЕ ШИТЬ**. Фит 10-28 7:09PM (без v3.5, = v3.4 функционально) в зачёт не идёт — см. worklog clk10-42. **11-6/11-7: линия ВОЗВРАЩЕНА владельцем** — директива «на базе 3.9.8 поднять частоту до 4.167МГц, создать ее в hiclock»: кандидат **v3.9.9h** (база v3.9.8, ЕДИНСТВЕННАЯ переменная — кольцо one-hot N=7→N=6: r0..r5, X1 = r0 duty 1/6 120 нс, X2 = r1|..|r5 = ~r0; clk25/POR-цепь/сброс байт-в-байт v3.9.8) — CPU 4,167 МГц (T=240 нс), терминал 8000 8N1, POR 960 нс (запас 1,33x тот же). Верификация: перебор 64 кодов кольца (sim_v399h_ring6 — двойной kill необходим и достаточен) + tb_poweron_v399h (Icarus: P0a 1280 комбинаций, PX геометрия 120 нс — ПАСС). **Фит владельца 11-6 11:29PM — SUCCESSFUL: 93/108 МЦ (86%), 286 ПТ, 181 вх.ФБ, 64 рег — прогноз сошёлся ТОЧНО, аудит ПАСС** (r6 в нетлисте нет; X2 — своя МЦ, 1 ПТ/5 вх; WARNING 897 — известный буфер D<7>; GSR не использован, п.21 жив). Дизайн перенесён из корня репо в **beta/hiclock/** (историческая папка линии), отчёт: retro_pcld_top (v399h-fit1-1106-1129PM).rpt, шапка RTL дополнена п.25 (аудит фита). **ОГОВОРКА**: у экземпляра 4,17 МГц уже отклонялась (v3.10/v3.11, 10-29/30) — v3.9.9h = перепроверка на новой архитектуре тактирования (X1 duty 1/6 вместо 50/50); откат — .jed v3.9.8. Следующий шаг: .jed → железо (осциллограф: X1 120 нс duty 1/6, X2 противофаза, зазор WR#→ALE 60..108 нс, PUSH-стресс), терминал 8000 8N1. **ИТОГ 11-7: ЖЕЛЕЗО ОТКЛОНИЛО 4,167 МГЦ — кампания ЗАКРЫТА директивой владельца («отставим попытки выбраться за 4МГц»)**: у владельца полный запуск не состоялся (лучший результат линии за всю историю — стабильный POST «8.8.8.8»), стенд коллеги с регулируемым напряжением — CPU не пошёл даже на повышенном питании → предел в ядре ИМ1281ВМ85А, НЕ в питании и НЕ в тактовом тракте CPLD; лестница 25/N между 3,571 (N=7) и 4,167 (N=6) промежуточных шагов не имеет. Производство — **v3.9.8**; v3.9.9h — архивная проверенная платформа на случай экземпляра с лучшим частотным потенциалом |

| 3 | **lowsize — снижение количества ресурсов CPLD** (своя папка `beta/lowsize/`, директива владельца 10-30): база v3.9.1 (перенесена из hiclock; удалена защёлка wb_ram_q — предложение коллеги, п.16); кандидат v3.9.2 — делитель «кольцо N=7» → двоичный счётчик mod-7 (−4 МЦ, частоты/POR бит-в-бит v3.9). Решение владельца: соединение CE2/READY — внутри CPLD дизайном, без пайки (CS1/READY = ровно 2 МЦ по 0 ПТ и 0 входов ФБ). Тест-прошивки дисплея/клавиатуры — в `beta/lowsize/rom/` | **v3.9.1: фит 10-30 (88/108 МЦ, 205 ПТ, 186/216 вх. ФБ, 58 триггеров) — РАБОТАЕТ В ЖЕЛЕЗЕ 10-30** (МЦ не 87: фиттер отдал освободившуюся ячейку под переупаковку; выигрыш −9 ПТ, −16 вх. ФБ, исчерпан остался только ФБ3). **v3.9.2: фит 10-30 8:32PM — АУДИТ ПАСС (85/108 МЦ = ровно «85 при хелпере por_ce», 209 ПТ, 180/216 вх. ФБ, 54 триггера, X1/X2 XOR 4 ПТ, запрещённых литералов 0); ЖЕЛЕЗО 10-30: дисплей ПАСС, клавиатура ПАСС** (9 «мёртвых» кнопок были просто нераспаяны — цепи замыкались через них в линию); послесвечение глифов устранено в прошивках блэнкингом «гашение → разряд → глиф» (клк10-67). **ФИНАЛ 10-30: v3.9.2 ПРИНЯТА владельцем** — перепрошивка образами с блэнкингом, послесвечения нет; итог lowsize против v3.9: −3 МЦ (88→85), −22 вх. ФБ (202→180, 94%→83%), −5 ПТ, −5 триггеров, исчерпанных ФБ 4→1). **v3.9.3 (11-2): сброс логики → сеть GSR (п.18) — ЗАКРЫТА ПО ПОЛНОМУ ЦИКЛУ**: фит 11-2 7:54PM аудит ПАСС (86/108 МЦ, 192/540 ПТ, 173/216 вх. ФБ, 54 триггера — лучшие значения линейки; «Signal 'RST' mapped onto global set/reset net GSR», «GSR : 1 1», 38 триггеров через GSR, литералы сброса в термах 133→3); узловой сим владельца A–G ПАСС; **железо 11-2 — работоспособность подтверждена**; повторный фит 11-2 9:54PM (тот же RTL, 85/108 МЦ, 195 ПТ, 171/216 вх. ФБ — рекорд линии, исчерпанных ФБ нет, por_ce-хелперы $449/$452 как в v3.9.2, без Cpld:897) **ПРОШИТ и РАБОТАЕТ** — его .jed известен хороший. Следствие для txclient: перенос GSR-схемы (cpu_rst в фите v5 = 306 вхождений) — ВЫПОЛНЕНО 11-3 (txclient v7, см. строку 4). **11-5: v3.9.4 = М1 (por_sh 8→4 со стробом x1_n, одобрена «Делаем Б») — кандидат: генератор gen_v394.py (3 строки + п.19), дифсим v3.9.3 vs v3.9.4 (tb_v394_diff, Icarus) 10 595 циклов 0 расхождений + T0 (ровно 4 сдвига F→7→3→1→0, por_run 1020 нс ≥ 840, повторного POR нет); фит владельца 11-4 10:15PM — **SUCCESSFUL (82/108 МЦ, 182 ПТ, 168/216 вх. ФБ, 50 рег — рекорды линии по всем метрикам), аудит ПАСС** (М1 в нетлисте точная, GSR бит-в-бит v3.9.3; IL 16 вместо 28 — оговорка, разбор в README lowsize); .jed — чекпоинт маршрута Б «запасная прошивка»; дальше — v4.0.1 (перебазирование hwuart). **11-5: v3.9.5 — ДЕФЕКТ СТАРТА v3.9.3/v3.9.4 НАЙДЕН И ПОЧИНЕН** (жалоба владельца: нестабильный запуск по питанию/кнопке, v3.9.2 стабилен): мера GSR п.18 оставила FSM живой в окне POR на плавающей шине CPU — доказано fuzz-тестом «плавающей» шины (tb_por_fuzz.v, 100 сидов: грязь на выходе из POR v3.9.2 0/100 — v3.9.4 100/100 — v3.9.5 0/100; rd_drive-контеншн в POR 86 тактов только у v3.9.4); фикс п.20 — GSR-источник расширен RST → cpu_rst = RST|por_run (2 слова RTL, gen_v395.py; условие v3.9.2 на асинхронной структуре v3.9.3); дифсим v3.9.4 vs v3.9.5 — 10 595 циклов 0 расхождений, RST-окна строгие, T0 POR бит-в-бит; .jed v3.9.4 НЕ ШИТЬ (дефектная база) — фит v3.9.5 → .rpt на аудит (чек-лист 3c); НАСЛЕДНИКАМ ТА ЖЕ МЕРА: hwuart v4.0.2, txclient v9. **11-6: v3.9.6 — ХАРДРЕНИНГ ЦЕПИ СБРОСА (п.21)**: жалоба владельца на v3.9.5 (у ОБОИХ фитов Exhaustive ON/OFF): «только выкл-вкл питания возвращает работоспособность по сбросу; просто сброс не может восстановить»; гипотеза п.1 разбора (подтяжка RST) владельцем СНЯТА — резистор стоит давно; причина: в фите v3.9.5 сырой пин RST доходит напрямую до гейта RESET_IN и 40 PTC-сбросов (дребезг/фронт размазывает отпускание CPU и логики; модель sim_v395_rst_float: спад 10 мкс — BOOT 7-10/20, ложные /WE ~50%); мера: RST входит в кристалл ТОЛЬКО через регистры — 2FF-синхронизатор + квалификатор 8 тактов + cpu_rst = rst_press\|por_run + RESET_IN — регистр reset_q (INIT=0) + гейт S_T2 с !rst_press; POR бит-в-бит v3.9.4; tb_v396_rst — ВСЕ ПАСС (EQ 62 400 выборок 0 расхождений, кнопка 398 нс латентность, глитчи 100/250 нс НЕ сбрасывают — новое свойство, дребезг 8 экскурсий — финал чистый, сброс посреди /WE — импульс доводится до конца); прогноз 85-87 МЦ / 220-230 ПТ / 165-172 вх.ФБ / 57 рег; RTL+генератор+тб в beta/lowsize, ждёт фита владельца — ДО УСПЕШНОГО ФИТА НЕ ШИТЬ; наследникам — вместо «2 слов v4.0.2» полная мера п.21. **11-6bis: застревание сведено к аналоговой лотерее включения** (M1 «clk мёртв» — точное воспроизведение жалобы tb_poweron P2; «недопустимая ситуация делителя» опровергнута перебором; чек-лист D1-D4 владельцу). **11-6 (позже): v3.9.7 = ВОЗВРАТ КОЛЬЦЕВОГО ДЕЛИТЕЛЯ (п.22, директива владельца)** — полевой эксперимент с одной переменной: кольцо one-hot r0..r6 вместо счётчика mod-7 (пор-цепь М1/GSR/хардренинг — бит-в-бит v3.9.6); отказоустойчивость доказана на RTL (P0a: 4096 комбинаций, one-hot ≤2 фронтов из любого кода); выходы бит-в-бит v3.9.6 (tb_v397_diff: 69 044 выборки, 0 расхождений); кросс-версионная матрица tb_poweron (дополнение 11-7): дефект 11-5 воспроизведён на 3.9.3/3.9.4 (139-140 провалов P1 из 100 сидов), v3.9.2/v3.9.5 чисты, классы включения у ВСЕХ версий идентичны — контраст «v3.9.2 стабилен» окончательно не в RTL; окно 40 нс v3.9.6+ самозаживляющееся (100/100 за ≤2 цикла), кандидат v3.9.8 (RESET_IN = ~cpu_rst) заготовлен на будущее. **11-6bis-2: v3.9.8 = УЗЕЛ ТАКТИРОВАНИЯ НА 50 МГц (п.23, схема владельца «берем делитель /2»)**: перемычка H1 без шунта (DIV=÷2 генератора → 50 МГц на GCK3), кольцо r0..r6 напрямую (период 140 нс), x1_n и negedge-домен УДАЛЕНЫ (X1 = r0, duty 1/7: 20/120 нс; X2 = OR(r1..r6) = ~r0 без инверсии регистра — прецедент v3.4); clk25 = ÷2-триггер — вся логика (rst/TX/FSM/порты) бит-в-бит v3.9.7 на 25 МГц (XC95108-15 FSM на 50 не закроет; /WE 80 нс и квалификатор 320 нс живы); por-цепь в 50-домене: por_sh[7:0], строб por_ce = r0 («раз в 140 нс»; r1|r6 дало бы 2 строба/период, а сэмпл стробов clk25 — фазовая лотерея), POR = 1120 нс — номинал v3.9.4-3.9.7; CPU по-прежнему 3,571 МГц (внутренний /2 ВМ85А). Верификация: дифсим tb_v398_diff 69 044 выборки 0 расхождений (por_run/RESET_IN на тех же кромках), tb_poweron_v398 P0a 2560 комбинаций ПАСС, P1 сид-в-сид эталону; прогноз ~92-94/108 МЦ; главная точка аудита фита — clk25 на глобальной тактовой (прецедент GCK2); перед шитьём — переставить H1; риск 20-нс high X1 — откат X1 = r0|r1 одной строкой. **ИТОГ 11-7: v3.9.8 СФИТЧЕНА (94/108 МЦ, 287 ПТ, 183–185 вх.ФБ, 65 рег — аудит «фит золотой») И ПОДТВЕРЖДЕНА владельцем НА ЖЕЛЕЗЕ: стабильно, зависаний нет** — фактическое производство; ветка продолжена линией hiclock → v3.9.9h (строка 2) |
| 4 | **txclient — вывод в ПК без UART-терминала** (своя папка `beta/txclient/`, директива владельца 10-31: «убери SOD, будем знать, когда процессор пишет в область вывода UART»; база v3.9.2): **v6-логгер — ОКНО 8000h–BFFFh (решение владельца «может всё таки перейти к захвату конкретного региона ОЗУ, скажем 8000-C000?» — ДА), ПОЛНЫЙ 16-БИТНЫЙ АДРЕС В ПАКЕТЕ**: классификация цикла по статусу **S0/S1** (MW = IO/M#=0, S1=0, S0=1) → HOLD(P81) в T1 только для записей в окно (ЧТЕНИЯ НЕ ТОРМОЗЯТ; стек FFxx и C000–FFFF вне окна по построению) → **пакет [A15..A8][A7..A0][данные] 3 байта 8N1** в CH340G через TX P39; hi-байт — СЕРИАЛЬНЫЙ захват с живых AH-пинов (9 тиков, старт-бит через мультиплексор на bc==0); **кадры 2/3 — СЕРИАЛЬНАЯ ПРЕДЗАГРУЗКА во время передачи предыдущего, v6/п.23: ИСТОЧНИК СДВИГАЕТСЯ К LSB синхронно с инжекцией — в shreg<8> входит ОДИН провод (addr_latch[0]/bus_reg[0]), 16-входового мультиплексора НЕТ** (фит v5: shreg<8>.D = 26 вх. — ERROR 892); регистровые хелперы adv_q/ld_q (п.21); фазировка baud_cnt<=1 — сетка 13 тиков и зазоры 0 точные; релиз HOLD — в конце пакета; фильтрация региона и рендер — целиком на ПК; soft-UART SOD удалён (−3 МЦ), приём не тронут (RX→SID, RIM 20h); бод **1 923 077** (25 МГц/13) | **ФИТЫ v2 (9:26AM), v3 (11:02AM), v4 (6:16PM), v5 (7:31PM) 11-1: все Placement Failed** (входы ФБ 216/216 → 216/216 → 212/216 → 213/216; v5: 103+8 МЦ = ~111 > 108, ERROR 892 на shreg<8> 18 ПТ/26 вх. — mux in_frame 8+8 источников свернут фиттером в один узел; отчёты заархивированы в beta/txclient/*.rpt). **Лекарство v6: сдвиг источников кадров 2/3 к LSB — инжекция ОДНОГО провода вместо мультиплексора; НОВЫХ ТРИГГЕРОВ НОЛЬ; сдвиг стартует с bc=2 (~1,9 мкс после WR#(вверх), WB давно позади — запас ~1,7 мкс); mux-хелперы $OpTx$ и дубли A<3:4>_BUFR умирают: sim_txclient_v6.py 55/55 ПАСС (T12: в окне WB регистры ЦЕЛЫ, addr_latch=0 к началу кадра 2, bus_reg=0 к началу кадра 3; кадры бит-в-бит как v5; границы BFFF/C000; сбросы). Прогноз: ~102–106/108 МЦ, вх. ФБ ~185–205/216, ПТ ~350–380; UCF без правок. План Б: Collapsing Input Limit 36→24–28; окно 8000–9FFF; BAUD_DIV 16; por_sh 8→4 (база, с одобрения). История: v1-окно F0xx 2 байта (sim 29/29), v3.10-порт 07h (sim 33/33), v2/v3/v4/v5 — сохранены с разбором провалов. Ждёт: tb_txclient_v6.v у владельца (iverilog) → фит С TXCLIENT-UCF → .rpt НА АУДИТ (чек-лист шапки п.23: в shreg<8>.D допустимы РОВНО addr_latch[0]/bus_reg[0]; в addr_latch/bus_reg ДОЛЖНО быть слагаемое сдвига п.23; adv_q/ld_q обязаны быть; HOLD P81 = OUT ~; PGND 8 шт без P81; AH-пины только в 1 ФБ) → .jed и железо. **11-3: v7 = база v3.9.3 — СБРОС ЛОГИКИ И СЕРИАЛИЗАТОРА → СЕТЬ GSR (п.24, задание владельца «на основе последнего lowsize дизайна можно попробовать txclient»)**: RTL v6 бит-в-бит (протокол/шина/сериализатор не тронуты), ОБА always-блока асинхронно по RST → GSR, cpu_rst удалён (в v5 — 306 литералов, должны исчезнуть), ДВА гейта !por_run (вход в WB — класс v3.9.3; взвод hold_req — специфика txclient: floated шина в окне POR не взводит HOLD и не рожает мусорный кадр в TX); вне домена por_sh/por_run и делитель. sim_txclient_v7.py **68/68 ПАСС** (сценарии v6 + POR-окно 3000 тиков: ноль /WE/HOLD/TX; GSR гасит пакет мгновенно); tb_txclient_v7.v — владельцу. **ФИТ 1 v7 (11-3 6:46PM): Placement Failed — 107/108 МЦ размещено + 7 сироп = 114 > 108, вх. ФБ 208/216, ПТ 310/540; при этом МЕРА П.24 СРАБОТАЛА: литералы сброса 306 → 5 (RST×1 = RESET_IN + por_run×4 = RESET_IN и оба гейта), cpu_rst 0, 62 триггера в GSR-домене (53 CLR=RST + 9 PRE=RST — shreg сбрасывается в '1' idle через SET-ветку), SR-ПТ=0 (суммы ПТ по ФБ сходятся), ПТ лучше прогноза на 25-65; «Global ...unused» в шапке — артефакт любого проваленного фита (v2-v5 — то же), чек «GSR : 1» — на первый успешный фит. Стены: (1) МЦ — TX-блок +29 к базе 85; (2) вх. ФБ — свободно 8 на кристалл, а in_cap (mux AH8-14×bit_cnt, единственная нагрузка shreg<8>) коллапсировал в D → shreg<8> 18ПТ/19вх (ERROR 892), 5×D<X>_BUFR по 18 вх. (shift-гварды п.23 разнесли ширину в шинные регистры), addr_latch<1> 9 вх. Лекарства: М1 por_sh 8→4 со стробом вдвое реже (1 строб/цикл cnt: POR = 4×280 ≈ 1120 нс ≥ 840 — возражение расчёта п.18 считало старый строб; −4 МЦ, вся четвёрка por_sh<7:4> в ФБ2 18/18*→14; ЖДЁТ ОДОБРЕНИЯ владельца — там v8 RTL+симы) + М2 Input Limit 28→18 (сам ERROR 892 просит; in_cap остаётся узлом, shreg<8>.D ~8 вх; +1..2 МЦ) + М3 READY/CS1 аппаратно (владелец уже решал «внутри CPLD, без пайки» в lowsize — только последний резерв, −2 МЦ) + резерв М4 hlda_q (−1 МЦ); арифметика: 114 −4 +2 −2 (−1) = 108–109. Аудит: scripts/fit_audit_v7.py; отчёт заархивирован как retro_pcld_top (v7-fit1-1103-646PM-FAILED).rpt. **11-3: владелец ОДОБРИЛ М1 («Делай M1») → v8 ГОТОВ — текущий кандидат**: por_sh 8→4 бита (−4 МЦ por_sh<7:4>, прогноз потребности 110; триггеров 71, из них 62 в GSR-домене — без изменений) СО СТРОБОМ ВДВОЕ РЕЖЕ: por_ce = x1_n — регистровый импульс 40 нс в [140,180) каждого периода cnt (п.17), ровно ОДИН posedge-строб/период ПО ПОСТРОЕНИЮ; три причины: декодов равенства в POR-пути больше НЕТ (класс фитов 7:31/8:55 исключён; в фите 1 v7 декод из 6 литералов был реплицирован во все 8 T-цепей), T-цепь бита 2 ПТ/3 литерала (x1_n AND (sh[k] XOR sh[k+1])), строб = 1 импорт ФБ вместо 3 (cnt<0..2> разбросаны по ФБ1/ФБ2/ФБ6); POR = 4×280 = 1120 нс ≥ нормы 840 (от INIT ~1040 нс, снятие por_run на 26-м такте; в v7 было ~1160), возражение п.18 (560<840) считало СТАРЫЙ строб 2/период; кодовая дельта v7→v8 — 4 строки; sim_txclient_v8.py 73/73 ПАСС (НОВОЕ T0 — цикл-точная модель POR-цепи с NBA-семантикой: стробы [4,11,18,25] t=160 нс, сдвиги F→7→3→1→0, повторного POR нет), tb_txclient_v8.v — владельцу (iverilog); файлы top_txclient_v8_utf8.v / top_txclient_v8.v (CP1251), UCF без правок; ждёт фита: если снова перелив (прогноз 110 > 108, shreg<8> М1 не лечит) — М2 Input Limit 28→18 в ISE, далее М3/М4** |
| 5 | **hwuart — аппаратный UART-трансивер на базе lowsize v3.9.3** (своя папка `beta/hwuart/`, директива владельца 11-3 «отставим пока txclient… сделаем полноценный UART трансивер, пусть полудуплексный, применяя в том числе и мои наработки по размещению UART в малых CPLD»; база v3.9.3, фит 11-2 9:54PM — прошит и работает): **ПОЛУДУПЛЕКСНОЕ ЯДРО 23 МЦ (общие shreg 9 / bit_cnt 4 / baud_cnt 4 на TX и RX — одновременность исключена построением: оба старта только из idle)**: TX = OUT 04h (параллельная загрузка {A,1'b0} из живых A-пинов T2, старт-бит на шине с того же такта, jam baud_cnt<=1 компенсирует лаг adv_q — старт РОВНО 13 тиков; инжекция '1' — shreg сам приходит в idle), RX = hardware-приёмник (2FF-синхронизатор, валидация старта в центре, выборки в центрах битов, стоп-проверка → rx_full); **IN 04h = RX-байт (A-пины, механизм KBROW), IN 05h = статус (RXRDY/TXRDY), IRQ = rx_full → P75 (RST 7.5, прецедент 01_timer; UCF: PGND 9→8)**; TX-транзит v3.7 выпилен (sod_q/tx_pass/tx_q, −3 МЦ), SID = RX сохранён наблюдателем; наработки: uart.v владельца (GOWIN, через v3.10), сериализатор txclient v8 (jam-фазировка, сам-idle shreg, adv_q/ld_q), уроки RX 01_timer (diag1-6), GSR v3.9.3 (ядро в GSR-домене, shreg через SET-ветку) | **v4.0.0 (11-3): RTL + UCF + симуляции ГОТОВЫ: scripts/sim_hwuart_v400.py 75/75 ПАСС** (С1 POR/idle; С2 сетка кадров ровно 13 тиков/бит и старт ровно 13; С3 поток с TXRDY-поллингом; С4 отброс при busy; С5 RX+IRQ+чтение; С6 RX при TX игнор; С7 сбросы посреди кадров — GSR; С8 глитч-аборт с инвариантом bc==0; С9 регрессия базы: порты/KBROW/writeback); tb_hwuart_v400.v — владельцу (iverilog). Прогноз фита: **105-107/108 МЦ**, вх. ФБ ~190-200/216, ПТ ~250-285, рег ~76, ноги 73/81. Ждёт: фит владельца в ISE (top_hwuart_por6_v400.v CP1251 + top_hwuart.ucf) → .rpt НА АУДИТ (чек-лист в README и шапке RTL п.26) → .jed и железо. ДО АУДИТА НЕ ШИТЬ. План Б: −ld_q-декоды (−1 МЦ), 1-ступенный синхронизатор (−1 МЦ), Input Limit 28→18. **Фиты 1-3 (11-4): HDLCompilers:28 исправлен (f137818, блок автомата выше ядра); фит 1 — Design Rule Checking Failed (опции 1/1/ON — вина опций); фит 2 (28/18/OFF) — Placement Failed: стена вх.ФБ 213/216 (99%), потребность 106 МЦ = прогноз README точно, корень — декод io_wr_tx (11 литералов) растворён в 16 МЦ-потребителей (+42 вх.ФБ); фит 3 (16/18/OFF, мера 1) — та же стена: 213/216, потребность выросла до 109 (891 bit_cnt<3>, бездомных 11; Input Limit не действует на $OpTx-хелперы; фаттер держит io_wr_tx узлом И растворяет копии) — опции фиттера исчерпаны. **ПЛАН (одобрен «Делаем Б» 11-5): М1 (por_sh 8→4 со стробом x1_n, −4 МЦ → ~105) — база lowsize v3.9.4 СФИТЧЕНА 11-4 10:15PM (SUCCESSFUL, аудит ПАСС: 82/182/168/50 — база легче v3.9.3 на 3 МЦ/3 вх.ФБ), следующий шаг — те же 3 строки в базовую часть top_hwuart → v4.0.1 (симы на мне, фит владельца); довесок при остаточной стене входов — KEEP io_wr_tx в UCF (ноль RTL); резерв rx_s1 1-ступень (−1 МЦ, риск метастабильности). ОТЧЁТЫ заархивированы: retro_pcld_top (v400-fit1/fit2/fit3-...-FAILED).rpt; ДО УСПЕШНОГО ФИТА НЕ ШИТЬ** **11-5: v4.0.1 ГОТОВ (команда владельца «делаем hwuart v4.01»)** — те же 3 строки М1 в базовой части (por_sh[3:0]=F, строб por_ce=x1_n, сдвиг [3:1]); код-дифф = ровно дельта М1, норм-путь бит-в-бит v4.0.0. Верификация: дифсим v4.0.0 vs v4.0.1 (tb_v401_diff + run_tb_v401.sh, Icarus): ЭКВИВАЛЕНТНОСТЬ ПОДТВЕРЖДЕНА (10 595 циклов + TX/RX-кадры: 0 расхождений, 0 spec, ОЗУ-логи 4077=4077, T0: 4 сдвига F→7→3→1→0, por_run 1020 нс ≥ 840); sim_hwuart_v401.py 75/75; tb_hwuart_v401.v 18/18. Попутно: tb_hwuart_v400.v прогнан впервые — 3 дефекта стимула исправлены (RTL не тронут); открыто свойство RTL: декод io_rd_rx держит rx_full в 0 после OUT 04h до следующего цикла шины (прошивке — поллинг IN 05h, как и написано в контракте). Прогноз фита: потребность 105-106 МЦ (было 109), вх.ФБ ~209-210 (было 213), ПТ ~315-325, рег 69; находка 11-5 для аудита: в фятах 2-3 v4.0.0 GSR-сеть НЕ использована (в lowsize v3.9.3/3.9.4 — использована) — точка «GSR» в чек-листе обязательная. Фит владельца (IL 16 как фит 3, Pterm 18, Exhaustive OFF) → .rpt НА АУДИТ → .jed и железо; ДО УСПЕШНОГО ФИТА НЕ ШИТЬ. **Фит 1 v4.0.1 (11-5 6:50AM): Placement Failed — М1 в нетлисте ТОЧНАЯ (пор-цепь бит-в-бит эталону v3.9.4), стена продвинулась по всем метрикам: потребность МЦ 109→106, вх.ФБ 213→208, ПТ 332→322, рег 74→70 (−4 ровно М1), бездомных 11→7 — но окна ≥8 вх.ФБ для bit_cnt<1..3> нет ни в одном ФБ (свободно 9 МЦ и 8 вх.ФБ, разнесённые по разным ФБ: МЦ-полны FB2/FB5/FB6, вх-полны FB1/FB3; единственная пара — FB4 1 МЦ/1 вх под rx_s0). GSR-разбор закрыт: анатомия RST (1 вх.ФБ/1 терм/65 порт-мэпов) идентична успешному GSR-эталону v3.9.4 — сбросы идут контрольными линиями мимо AND-массивов, гипотеза «GSR-импорт даст 6-12 вх.ФБ» СНЯТА. Следующий выстрел (ноль RTL): фит 2 = IL16/Pterm18 + Exhaustive Fitting ON + KEEP io_wr_tx в UCF; затем IL 12 + Exhaustive; резерв rx_s1 1-ступень против bit_cnt-стены недостаточен. Отчёт: retro_pcld_top (v401-fit1-1105-650AM-FAILED).rpt. ДО УСПЕШНОГО ФИТА НЕ ШИТЬ** **11-5 (вечер): НАЙДЕН ДЕФЕКТ КЛАССА GSR (см. lowsize v3.9.5) — в базе hwuart ТА ЖЕ мера п.18: FSM живёт в окне POR на плавающей шине CPU → нестабильный старт; фиксы фит-2 v4.0.1 (Exhaustive ON) НЕ КАСАЮТСЯ — фит можно гнать ради ресурсной картины, НО .jed v4.0.1 НЕ ШИТЬ ДАЖЕ ПОСЛЕ УСПЕШНОГО ФИТА; нужен v4.0.2 = v4.0.1 + те же 2 слова (posedge RST→posedge cpu_rst, if (RST)→if (cpu_rst) в блоке логики; GSR-источник станет cpu_rst = RST|por_run — RST/por_run уже импортированы в ФБ гейта RESET_IN, цена ~+1 ПТ) — делается после закрытия фит-вопроса v4.0.1, по команде владельца. **11-6, ПОПРАВКА ПОСЛЕ ЖАЛОБЫ НА v3.9.5: 2 слов НЕДОСТАТОЧНО** — cpu_rst-расширение (v3.9.5 lowsize) чинит старт по питанию, но НЕ восстановление по кнопке (сырой RST всё равно доходит до PTC-сбросов и RESET_IN напрямую — дребезг/фронт размазывают отпускание); когда дойдёт до v4.0.2 — делать сразу ПОЛНУЮ МЕРУ П.21 из lowsize v3.9.6: 2FF-синхронизатор + квалификатор 8 тактов + cpu_rst = rst_press\|por_run + регистровый RESET_IN (~+7 рег, +6-8 МЦ, tb_v396_rst — все ПАСС; см. раздел v3.9.6 README lowsize) **|
| 6 | **txuart — исключительно аппаратный передатчик UART** («счётчиковый» бод-рейтинг; своя папка `beta/txuart/`, директива владельца 11-8: «организовать исключительно аппаратный трансмиттер UART, на удобный для счетчиков делителей бод рейтинг, реализации посмотри в txclient, проект разместим в beta\txuart»; v1.0: база v3.9.3; **v2.0: база v3.9.8-clear, кольцо, XC95144**): **TX-ONLY ЯДРО 20 МЦ** — shreg 9 бит (сам-idle, SET-ветка GSR), bit_cnt 4, baud_cnt 4 (**mod-16 СВОБОДНЫЙ ХОД — wrap НАТУРАЛЬНЫЙ без декода терминального счёта: «удобный для счетчиков делителей» рейтинг**), tx_run, adv_q, **ld_tx_q — РЕГИСТРОВЫЙ строб загрузки** (п.28: у декода io_wr_tx ЕДИНСТВЕННЫЙ потребитель вместо 16 у hwuart — лекарство от стены вх.ФБ фитов 11-4/11-5; загрузка {A,1'b0} на тик позже строба — CPU держит данные до подъёма WRn); бод **1 562 500** (25 МГц/2⁴, из списка альтернатив шапки txclient v8); OUT 04h = TXDATA, IN 05h = {000000, TXRDY, 0}; TX-транзит v3.7 выпилен (−3 МЦ), SID = RX сохранён, SOD P72 — наблюдатель keep; UCF = hdl/top_suart.ucf по LOC 1-в-1 (PGND 9, P75 возвращается в PGND) | **11-8: v1.0 — RTL + верификация ГОТОВЫ**: gen_v1.py (12 якорных правок из базы) + check_v1.py 76/76 (CP1251 round-trip, мёртвых идентификаторов в коде нет — Xst:1780 по построению, база бит-в-бит 20 контрольных строк, порядок объявлений); sim_txuart_v1.py **87/87 ПАСС** (С1-С9: сетка 16 тиков точная, старт ровно 16, поток с поллингом без потерь, отброс при busy, гейт POR, GSR-сброс посреди кадра, регрессия базы); tb_txuart_v1.v (реальный RTL, Icarus) **18/18 ПАСС**. Класс-урок: 4'd16 усекается в 0 — BAUD_DIV объявлен [4:0]/5'd16. Прогноз фита: **102-104/108 МЦ**, вх.ФБ ~190-205, ПТ ~250-280, рег 71. Ждёт: фит владельца → .rpt НА АУДИТ → .jed и железо (терминал 1 562 500 8N1). ДО УСПЕШНОГО ФИТА НЕ ШИТЬ. **11-8веч: v2.0 НА БАЗЕ v3.9.8-clear** (директива владельца «Берем дизайн beta\lowsize 398_clear и переделываем txuart на основе него») — кольцо r0..r6 ВЕРНУЛОСЬ в нетлист (разбор вопроса «почему пропало кольцо»: v1.0 был на базе v3.9.3 — линия счётчика mod-7, до-перемычечная эпоха 25 МГц; на плате 50 МГц он давал ТРИ 2х: бод 3,125 М, CPU 7,14 МГц вместо 3,571 (X1 = 2×clk/7 — второй 2х, аудит 11-8 пропустил), FSM на clk 50 — тайминг не закроет); ядро v1.0 бит-в-бит пересажено на (clk25, cpu_rst) — бод = 25/16 = РОВНО 1 562 500 (фикс v1.1 mod-32 не нужен), GSR-источник = cpu_rst (ядро чистится и в POR), RESET_IN = регистр reset_q; ЦЕЛЬ XC95144-15PQ100C (94−3+20 = 111 > 108 МЦ — на 95108 не влезает; совместимость доказана). Верификация: check_v2 129/129, sim_txuart_v2 92/92 (два домена, POR-кромка 1020 нс = документации базы), tb_txuart_v2 (реальный RTL) 23/23. Владельцу: ISE Device → xc95144-15pq100c, фит IL16/Pterm18/DENSITY → .rpt НА АУДИТ (чек-лист п.32) → .jed → железо (терминал 1 562 500 8N1). ДО УСПЕШНОГО ФИТА НЕ ШИТЬ |

## Встретившиеся проблемы

Журнал проблем, встретившихся при отработке экспериментов (детали — в README
соответствующей подпапки). Проблема закрывается записью диагноза и фикса;
открытые помечены ✚.

| Дата | Симптом | Локализация → диагноз | Статус |
|---|---|---|---|
| 10-24 | UART-эхо v1: баннер '>' в терминале есть, эха нет (ввод не возвращается) | Диагностические образы v1–v4 (счётчики и таймлайн кадра на дисплее/в hex-терминале): сигнал с PC до CPU доходит, но ввод «не собирался» → в v4 найдены и исправлены 3 бага RX-кода (RAR не кладёт SID в CY; LHLD TSB затирал накопитель L; LHLD разворачивал пару таймлайна в очереди) | закрыта 10-24 (фикс v4; проверка instruction-level симуляцией) |
| 10-25→10-26 | ✚ diag4: вместо баннера '>' терминал непрерывно принимает `00` (~150–170 Б/с), при этом `timer_test_uart.hex` (TX-поток) работает как положено | ПО исключено на всех уровнях: файл == чип == исполнение (тройная CRC-сверка эталон/ридбек/pzu `C5D3FD9A`; дисплей 8.8.8.8→0000 = BAN жив). Диф «поток vs одиночный кадр» → diag5 «кричащий баннер» (RX отключён): 10-26 на железе поток '>' + счётчик кадров = **TX-тракт ЦЕЛ** ⇒ флуд `00` — автоэхо нулей: при SID=0 цикл POLL diag4 ловит «старт-бит» на каждом проходе, 12 выборок дают L=00 → эхо `00 00 00` | локализована; уровень SID снят diag6 10-26 (idle ВЫСОКИЙ, исход N1); финал — эхо-тест diag4 ✚ |
| 10-26 | Почему SID (U3.5) читает 0: RX-линия (провод «TX» CH340G.TXD → P38, транзит → SID) либо прижата, либо её нет | Выдан `uart_echo_diag6.hex` «монитор SID» (ISR/init/DMUX = diag5 байт-в-байт, плотный опрос RIM ~25–50 мкс): DIG0 = живой уровень SID ('1'/'0'), DIG1 = счётчик нулевых выборок (любая активность с линии уводит из нуля навсегда), DIG2/3 = сырое RIM hex (норма 8B при SID=1, 0B при SID=0; 83 = IE=0). Исходы: `[1][0][8B]` = тракт RX до CPU цел → вернуть diag4; `[0][крутится][0B]` = линия прижата → мультиметр P38/CH340G.TXD (ожидание ~3,3–5 В; пин TXD, не RTS/DTR; питание CH340; пайка P38) | **закрыта 10-26**: diag6 на железе — исход N1: дисплей `8B 8 1` (слева направо: RIM=8Bh, счётчик нулей=8, уровень SID=1), приглашение '>' после сброса. SID idle ВЫСОКИЙ, RIM = 8Bh — каждый бит в норме (SID=1, RST7.5-латч чист, IE=1, маски как в init). Счётчик нулей = 8 ≈ один импульс ~0,2–0,4 мс с линии (глитч CH340G при подаче питания/открытии терминала; печатный символ дал бы десятки выборок) — «датчик движения» подтвердил: линия живая, прижатия НЕТ. Флуд-условие (SID=0) не воспроизводится → финальная проверка RX-тракта — diag4 (эхо-тройки `[байт][tl-hi][tl-lo]`) |
| 10-27 | «Моргание» дисплея на diag6: DIG0 мигает, DIG1 — «мерцающая восьмёрка» одинаково в покое и при приёме, DIG3 «не меняется, горит 8», на DIG2 слегка подсвечены потушенные в 'b' сегменты | Расшифровка по коду DMUX/SIDLP: DIG0 1↔0 при приёме = НОРМА (живой SID, данные читаются RIM — исход N4, RX-динамика ПАСС). DIG3 «твёрдый 8» — не противоречие: глифы '8'(7Fh)/'0'(3Fh) отличаются ТОЛЬКО сегментом g — самым тусклым при 25% duty и токоограничении 240 Ом на анод — мерцание 8↔0 есть, но глазом почти неуловимо. DIG2: 'b' стабильна корректно (мл. ниббл 8B/0B одинаков), подсветка a/b — призрак перехода DIG2→DIG3 (OUT SEGP грузит глиф DIG3 за ~7 мкс до переключения строба, ghost ~1,6%) — косметика. Единственный открытый вопрос: мерцание DIG1 в ПОКОЕ (замороженный счётчик мерцать не может): (а) SID фонит на idle (нет подтяжки P38 — UCF «прямое подключение»; предельный контакт) или (б) драйвер разряда DIG1 (P63→R10→VT2) — 30-секундный дискриминатор (руки прочь / P38→+5В 1 кОм) не завершён ✚. Измерительная кампания 10-27: сигнал терминала владельцем подтверждён DMM вплоть до CPU.SID (нога 5) — цепь CH340G.TXD→P38→транзит→SID цела | **ветка приостановлена владельцем 10-27** (решение: возврат к baseline v3.2); линия по всем фактам ЖИВАЯ (данные читаются CPU); открытый пункт — тест DIG1 в покое, ничего не блокирует |
