digitalinvitro/CPLD-plus-8085/beta/xstream/README.md

# beta/xstream — ПРЕРЫВАНИЕ → ВЕСЬ ЭКРАН В UART (XSTREAM v1)

> **Идея владельца (ТЗ 11-12):** «8085, *прерываясь*, выдаёт в UART весь экран,
> потом идёт работать по своим делам в монитор fw_mon_ACdE.hex. Частоту
> прерывания надо рассчитать так, чтобы не нагружать ЦП больше 50% — от этого
> зависит FPS, но FPS не должен проваливаться и должен быть в интервале 20–25
> кадров/с. Если ЦП перегружен выдачей экрана — требование к FPS снижается,
> скажем до 10 FPS. Экран лежит по фиксированному адресу ОЗУ, например 0xB000.
> ПО клиента на ПК принимает поток и формирует экран в окне GUI».
>
> Это подпроект **xstream** — не путать с `beta/gfxstream` (демо-плеер с темпом
> от ПК): здесь темп задаёт ПЛАТА, экран — текстовый буфер ОЗУ, а монитор
> продолжает работать. Вся папка — прошивка, клиент, симулятор, расчёты.

**Статус (11-12, после железного прогона владельца):** первая прошивка дала
на живой плате глифы-призраки «L.L.L.1» поверх ACdE — **урок 6: указатель
глифа в XDIG был парой DE, а я положил D=0F5h/E=бит → LDAX D читал мусор ОЗУ
0F5xx** (сим не ловил: читал дефолт и не проверял глифы). Исправлено
(DE=0FFF5h+idx, бит в C; порядок ГАШЕНИЕ→РАЗРЯД→ГЛИФ как в REFRESH), в сим
добавлена дисплейная модель «чужие глифы, норма 0» — на старой сборке она
воспроизводит 110 призраков, на новой 0. Симулятор ПО РЕАЛЬНОМУ HEX —
**«ВСЁ ОК»** в обоих вариантах (SW-тик и HW-таймер): 0 отбросов TX, мин. гэп
33T ≥ 31.25T, период 49.75/49.98 мс = 20.1/20.0 FPS, нагрузка ЦП 48.5/48.2%,
SEQ без пропусков, побайтовая сверка экрана, клавиши монитора работают.
Клиент `xstream_view.ps1` v1.1: DoubleBuffered через рефлексию (защищённое
свойство — прямое присвоение роняло GUI на 5.1), SelfTest #2 детерминирован.
Аппаратный вариант требует CPLD v24 — см. §7 (стена МЦ XC95108).

**Статус (11-13, второй железный отчёт владельца, v1.2):** три факта — всё
найдено и исправлено. (1) **SelfTest №2 FAIL «frames=1, rs=0»**: в v1.1 мусор
`$garb` создавался, но НЕ подавался в парсер (потерян `Add-Bytes`) —
подача добавлена. (2) **GUI падал на старте окна**:
`[Brush]::new([SolidBrush](…))` — `Brush` абстрактный, конструктора с 1
аргументом нет → `SolidBrush::new(цвет)`. (3) **«Дрожание» дисплея платы** —
настоящий корень в ПРОШИВКЕ, **урок 9**: XDIG v1.1 брала бит разряда из C,
но к вызову C=0 (съеден счётчиком подгруппы `MVI C,25`), и `LDA SNDST`
затирал бит в A → `OUT DIGP = SNDST (0/1)`: дисплей гас на всю посылку
24.2 мс (при тоне — все 4 глифа циклом на DIG0) → 20 Гц мигание.
**Фикс v1.2**: XDIG самодостаточна — бит вычисляется из фазы глифа E
(`idx=(E+3)&3`, `01h RLC idx`) и переживает `LDA SNDST` в C (как в REFRESH —
там бит живёт в B); недо-фикс rc1 (бит снова затёрт LDA) поймала трасса
портов сима (OUT DIGP=00). В сим добавлена модель «глиф ⇔ РАЗРЯД»: на v1.1
воспроизводит 230 гашений посылки, на v1.2 — 0. Сим по реальному hex —
**«ВСЁ ОК»** SW и HW: 0 отбросов, мин. гэп 33T, период 49.86/50.09 мс =
20.06/19.97 FPS, нагрузка 48.6/48.3%. (4) Аудит клиента нашёл **ЛАТЕНТНЫЙ**
дефект RX: `Register-ObjectEvent -Action` НЕ видит `$script:`-переменные
(Action живёт в скопе PSEventJob-модуля, там `$script:RxQueue = $null`,
Enqueue падал в пустой `catch{}` → 0 кадров при живом потоке — всплыло бы
сразу после фикса кистей); чтение порта перенесено в GUI-таймер (опрос
BytesToRead→Read, буфер драйвера 256 КБ ≈ 2.6 с потока). Плюс фикс A5-набега
в state 1 (мусор, кончающийся A5 перед шапкой, копился в Buf и сдвигал кадр
на 1 Б: SEQ=5A). SelfTest теперь 5/5 (зеркальный прогон векторов в Python
подтвердил и фикс, и воспроизведение дефектов v1.1). КЛИЕНТ v1.2,
ПРОШИВКА v1.2 — ВЛАДЕЛЬЦУ: перезалить xstream_view.ps1, перешить
xstream_v1.hex (4175b2e8) — «дрожание» уйдёт: дисплей во время выдачи кадра
теперь реально регенерируется.

**Статус (11-13, третий железный отчёт владельца, v1.2.1):** фиксы v1.2
подтверждены на живом железе: SelfTest у владельца — все проверки OK,
включая бывший FAIL «ресинк мусора» («ресинк=1, кадр принят без потерь»)
и кейс 2b A5-набега (SEQ=7, scr0=87); дисплей платы —
**«работает замечательно»** — урок 9 закрыт. Новый дефект №4 — только
с `-Log`: `FormatException «Индекс (отсчитываемый от нуля) должен быть
... меньше размера списка аргументов»` в `Write-Log` (строка 63) —
**урок 11**: `-f <список>` прямо в скобках метод-вызова PowerShell делит
по запятым на АРГУМЕНТЫ метода: `WriteLine("fmt" -f a,b,c)` парсится как
`WriteLine(("fmt" -f a), b, c)` → `-f` получал 1 аргумент при 7
подстановках `{0}..{6}` → FormatException при вычислении первого
аргумента, скрипт умирал на первой же записи OPEN (EAP=Stop) — окно
не открывалось только с `-Log` (SelfTest и GUI без лога `Write-Log` не
вызывали; статус-строка и `Write-Host` всегда работали — там `-f` в своих
скобках; в gfx_view v1.5 то же место обёрнуто двойными скобками
`.Add(("…" -f …))` — потому капкан не стрелял). Фикс v1.2.1: формат
собирается в переменную `$line`, затем `WriteLine($line)` (WriteLine(string)
без composite-formatting). Заодно: счётчик SelfTest 5/5 → **6/6** (кейс 2b
добавили в v1.2, счётчик не обновили — у владельца было 6 OK при «5/5»),
OK payload не печатается после FAIL. Прошивка не тронута
(4175b2e8/e5ed908c в силе).

**Статус (11-13, четвёртый железный отчёт владельца, v1.2.2):** живой
сеанс с `-Log` — **117.9 с, 2412 кадров, 4 838 677 Б, ресинков 0** (линия
чистая все 118 с), «Итог»: FPS 21.39 (EMA), SEQ-гэпов 113. Разбор лога
`scripts/xlog_analyze.py upload/xlog.csv --frames 2412`:

- **РАБОЧАЯ ТОЧКА ПОДТВЕРЖДЕНА ЖИВЫМ ЛОГОМ**: медиана dt 49.1 мс =
  **20.4 FPS** (сим-прогноз 20.1 FPS / 49.8 мс — сходимость в 1.4%,
  урок 15 в силе); средний за сеанс 20.46 FPS (окно ТЗ 20–25 ✓).
  «EMA 21.4» в статусе просто перекош в быстрые кадры (dt 37.6–58.6
  p10–p90) — по медиане нагрузка ≈ 49% ≤ 50% ТЗ ✓.
- **113 «гэпов» = 110 + 3**: один эпизод 14:37:18 — пауза 462 мс,
  SEQ 145 → **0**: плата ПЕРЕЗАПУСТИЛА поток (счётчик SEQ обнулился —
  рестарт, не потеря кадров) → +110 ложных «гэпов»; остальные 3 —
  честные пропуски по 1 кадру (SEQ n→n+2, dt 86–99 мс: плата
  промедлила один период — 3 за 110 с, безвредно).
- **Дефект №5, найден в логе — «фантомная 8-я колонка»** (урок 12):
  шапка CSV объявляет 7 колонок, а ВСЕ 2516 строк несут 8 полей,
  5-е — всегда одна цифра 0–9. Корень: `{3:F1}` в `Write-Log`
  форматируется оператором `-f`, который берёт КУЛЬТУРУ ПОТОКА —
  на ru-RU Windows `F1` даёт `17,1` (десятичная ЗАПЯТАЯ), и в
  запятой-CSV поле расщепляется на `17` и `1`. Данные не терялись
  (анализатор склеивает обратно), но лог был невалидным CSV.
- **Фикс v1.2.2**: (1) `Write-Log` — dt и штамп времени ЯВНО через
  InvariantCulture, строка собирается конкатенацией (ни `-f`, ни
  культурных сюрпризов); (2) правило рестарта: dt > 250 мс (~5
  периодов) И скачок SEQ → счётчик `Restarts` + строка `R` в CSV,
  `SeqGaps` не растёт (на живом логе даёт: гэпов 3, рестартов 1 —
  вместо пугающих 113); (3) статус и «Итог» показывают рестарты,
  «ресинк N Б» → «ресинков N»; (4) SelfTest 6/6 → **7/7** (кейс 3b:
  пауза 1 с + скачок SEQ = рестарт). Байтовая смета: 2412 × 2003 =
  4 831 236 + 7441 Б мусора/недокадров (0.15% — стык: клиент стартовал
  посреди кадра платы) = 4 838 677 ✓. Скорость линии 40.1 КБ/с = 40%
  от 100 КБ/с — как рассчитано. Прошивка НЕ тронута
  (4175b2e8/e5ed908c в силе, перешивать не надо). ВЛАДЕЛЬЦУ:
  перезалить `xstream_view.ps1` (v1.2.2).

---

## 1. Архитектура режима

```
                    ┌───────────────────────── плата ─────────────────────────┐
 тик кадра ────────▶│  ISR/тик: выдать ВЕСЬ экран B000h..B7CFh в TX-UART      │
 (таймер v24 или    │  (2000 Б равномерно 35..49T/Б, слоты дисплея внутри)    │
  SW-накопитель)    │  → возврат: монитор fw_mon "ACdE" живёт дальше          │
                    └──────────────┬──────────────────────────────────────────┘
                                   ▼  1 000 000 бод 8N1 (CPLD TX-ядро v2.3, OUT 04h)
                    ┌──────────────┴──────────────────────────────────────────┐
                    │  xstream_view.ps1: A5 5A [SEQ] + 2000 Б → GUI 80x25     │
                    │  ресинк по магии, SEQ mod 256, FPS/гэпы/ресинки, -Log   │
                    └─────────────────────────────────────────────────────────┘
```

- **Экран** = текстовый буфер ОЗУ **B000h..B7CFh** (80×25 = 2000 Б, row-major).
  Любая программа (и сам монитор через режим E/C) может писать туда свой
  текст/графику — кадр уходит в ПК целиком, «как есть» (у клиента CP1251).
- **Монитор fw_mon «ACdE» не переписан, а ДОПОЛЕН**: вектор RST 7.5 (003Ch),
  init демо-экрана при холодном старте, тик кадра. Все режимы A/C/D/E/F1/F2,
  клавиатура, бип и дебаунс — работают как раньше.
- **Кто рисует в B000h:** при холодном старте прошивка выводит демо-экран
  (заголовок + живой счётчик SEQ в строке 22). Дальше буфер — полная
  собственность пользователя: пишешь текст по B000h → он появляется в окне ПК.

## 2. Что в папке

| Файл | Что это |
|---|---|
| `xstream_v1.asm` | прошивка-канон (CP1251): монитор fw_mon + XSTREAM-блок, ключ `TMR_HW 0/1` |
| `xstream_v1_utf8.asm` | тот же исходник в UTF-8 (близнец, как принято в репо) |
| `xstream_v1.hex` / `.lst` | сборка TMR_HW=0 (для текущего CPLD txuart v2.3), 1829 Б, md5 `4175b2e8…` (v1.2) |
| `xstream_v1_hw.hex` / `_hw.lst` | сборка TMR_HW=1 (для будущего CPLD v24 с таймером), 1854 Б, md5 `e5ed908c…` (v1.2) |
| `xstream_view.ps1` | клиент ПК v1.2.2: GUI 80×25, ресинк, метрики (гэпы/рестарты/ресинки), `-Log` (InvariantCulture), `-SelfTest` 7/7, опрос порта в таймере |
| `scripts/xlog_analyze.py` | анализатор CSV-лога: форматы v1.2.1 (фантомная 8-я колонка, авто-склейка dt) и v1.2.2 (R-строки), гэпы/ресинки/байтовая смета/FPS |
| `scripts/asm85.py` | копия ассемблера (с фиксом резолва меток в IF-ветках — см. §8) |
| `scripts/xstream_calc.py` | расчёты режима (таблицы §3, смета, периоды) |
| `scripts/sim_xstream_v1.py` | симуляция ПО РЕАЛЬНОМУ HEX: интерпретатор 8085 + TX-ядро v2.3 + клавиатура + таймер v24 |

Сборка (регрессия: `asm85.py` пересобирает `fw_mon.hex` и `fw_mon_fast.hex`
байт-в-байт, md5 `f9ad5c6d…` и `33c37943…`):

```bash
python3 scripts/asm85.py xstream_v1.asm -o xstream_v1.hex -l xstream_v1.lst
python3 scripts/asm85.py xstream_v1.asm -o xstream_v1_hw.hex -D TMR_HW=1
python3 scripts/sim_xstream_v1.py xstream_v1.hex          # SW: вердикт «ВСЁ ОК»
```

## 3. РАСЧЁТ режима (scripts/xstream_calc.py, подтверждено симом)

### 3.1 Исходные данные (железо, проверено на плате)

| Параметр | Значение | Откуда |
|---|---|---|
| CPU 1821ВМ85 (8085) | **3.125 МГц, T = 320 нс** | кольцо s0..s3 на 25 МГц (txuart v2.2/v2.3) |
| TX-UART CPLD | **1 000 000 бод 8N1**, байт = 10.0 мкс = **31.25T** | 25 МГц / 25, сетка CH340G точная |
| Линия | 100 000 Б/с; потолок подачи CPU **97 656 Б/с (97.7%)** | p04-прогон железно 97 887 Б/с |
| Запись в busy | **отбрасывается** ядром (кадр не портится) | топология v2.x; урок SPRINT 11-10-5 |

### 3.2 Кадр

- Экран 2000 Б + шапка `A5 5A [SEQ]` = **2003 Б/кадр**; чистый провод 20.03 мс.

### 3.3 Посылающий цикл — почему именно 35T/Б

TX-ядро принимает 1 Б за 31.25T; запись в занятое ядро **отбрасывается**, поэтому
пейсинг обязан быть **равномерным на КАЖДЫЙ байт** (урок SPRINT: пачки
развёртки 31T → каждый 2-й байт отбрасывается, даже при среднем 31T). Минимальная
петля из ОЗУ `MOV A,M (7) + OUT 04h (10) + INX H (6) = 23T` + пад из NOP с шагом 4T
→ 31T (8T пада) **меньше 31.25T — отбросы**; рабочий шаг = **35T/Б** (3 NOP).
Амортизация счётчика (DCR C + JNZ = 14T) на подгруппу 8 Б:

- подгруппа: 7×35T + 49T = **294T/8 Б = 36.75T/Б**;
- слот дисплея XDIG (~180T с CALL, без стеша) каждые 200 Б → **итого ≈ 37.7T/Б**;
- **посылка = 24.21 мс** (сим v1.2; расчёт 24.12 + слоты XDIG — сходится).

### 3.4 Нагрузка ЦП vs FPS (нагрузка = доля тактов, отданная выдаче кадра)

| FPS | период, мс | нагрузка ЦП | вердикт |
|---:|---:|---:|---|
| 10.0 | 100.0 | 24.1% | фолбэк ТЗ (не потребовался) |
| **20.0** | **50.0** | **48.2%** | **нижняя граница окна — ПРИНЯТО** |
| 20.1 | 49.9 | 48.6% | **рабочая точка v1.2 (сим: 49.86 мс)** |
| 21.0 | 47.6 | 50.6% | ЦП > 50% — не годится |
| 21.3 | 46.9 | 51.4% | (сетка 3 тика — не достижима при ≤50%) |
| 25.0 | 40.0 | 60.3% | не достижима при ≤50% |

**Вывод по ТЗ:** при 20–25 FPS и нагрузке ≤50% достижимое окно — **20.0–20.5 FPS**;
21 FPS и выше требуют >50% ЦП → по ТЗ владельца требование к FPS снижается до
**20 FPS** (нижняя граница окна 20–25, без провалов: сим держит 46.9–49.8 мс
даже при нажатых клавишах). Фолбэк 10 FPS = 24% ЦП — константой `XS_TH`/`TMR_N`,
не понадобился.

### 3.5 Период тика

- **SW-режим (TMR_HW=0, текущий CPLD):** тик = накопитель слотов скана монитора
  (`XS_TH=71` слотов × 0.361 мс) + посылка 24.2 мс → **период 49.86 мс = 20.1 FPS**.
  Тик живёт в контексте монитора: поток идёт в меню, при наборе адреса/кода и
  во время дебаунса; **во время пользовательской программы (E) поток
  останавливается** — ЦП у программы.
- **HW-режим (TMR_HW=1, CPLD v24):** таймер CPLD → RST 7.5. Период =
  посылка + `XS_DIVN × N × 51.2 мкс`; **N=250, XS_DIVN=2 → 24.2 + 25.6 =
  49.8 мс (сим 50.09 с накладными ISR) = 20.0 FPS, 48.3%**. ISR выбивает из монитора и из пользовательской
  программы (пока та не DI) — поток НЕ останавливается никогда. Сим HW-варианта:
  50.09 мс, 0 отбросов, «ВСЁ ОК».

### 3.6 Дисплей и тон платы

Во время посылки регенерация 7-сегментника НЕ замирает: слот XDIG каждые 200 Б
(2.35 мс) → полный цикл 4 разрядов ~9.4 мс (~106 Гц — выше порога слияния
мерцания; в паузе между кадрами монитор сканирует своими слотами ~0.36 мс на
разряд). Заполнение разряда в обоих режимах ~25% — яркость и частота обновления
не скачут, «дрожания» нет (в v1.1 XDIG писала в DIGP съеденный C: дисплей гас
на всю посылку — урок 9 в §8; фикс v1.2 подтверждён симом: 230 гашений → 0).
Тон бипа продолжается: XDIG OR-ит SNDST (D4) в бит разряда.

## 4. Память и порты

| Область | Что |
|---|---|
| 0000h–7FFFh | ПЗУ (flash, запись железом отбрасывается); 0000h `JMP MAIN`; **003Ch вектор RST 7.5 = `JMP XISR`**; монитор с 0040h (вектор сместил SETTLE на 3 Б) |
| **B000h–B7CFh** | **ЭКРАН 80×25 (2000 Б)** — пользовательская область, xstream читает её каждый кадр |
| FFFAh–FFFCh | переменные xstream: `XSSEQ` (SEQ mod 256), `XSPASS` (SW-накопитель), `XSDIV` (HW-делитель); выше PREVST (FFF9h), стек (FFE7h↓) не доходит |
| FFE8h–FFF9h | переменные монитора (без изменений) |
| 8000h–B7CEh | остальное ОЗУ — свободно для программ |
| 00h/01h/02h/03h | сегменты / разряды+SND / колонки / ряды (монитор) |
| 04h / 05h | TXDATA / TXRDY (ядро TX v2.3) |
| 06h | **в v24 — загрузка N таймера** (на v2.3 записи игнорируются — прошивка безопасна на обоих образах CPLD) |

## 5. Формат провода (2003 Б/кадр)

```
A5 5A [SEQ] [2000 Б экрана: строка 0 (80 Б), строка 1, ... строка 24]
```
- SEQ++ mod 256 в каждом кадре — клиент считает гэпы (пропуски/сброс платы).
- Ресинк по A5 5A: мусор до магии отбрасывается (счётчик ресинков).
- Хвост без добивки — кадр распознаётся по счёту 2000 Б после шапки.

## 6. Запуск

**Плата (SW-режим, текущий CPLD txuart v2.3):** прошить `xstream_v1.hex`
во flash с offset 0 (вместо монитора — монитор внутри), терминал на 1 000 000
8N1 закрыть.

**ПК:**
```powershell
.\xstream_view.ps1 -Port COM13                    # окно 80x25, метрики в статусе
.\xstream_view.ps1 -Port COM13 -Log xs_log.csv    # + CSV: utc,kind,seq,dt_ms,...
.\xstream_view.ps1 -SelfTest                      # 7/7 без порта: склейка чтения,
                                                  # мусор→ресинк (2 кейса), гэп SEQ,
                                                  # рестарт потока, CP1251
```
Статусная строка: FPS (EMA), период мс, кадров, SEQ-гэпы, рестарт, ресинки,
КБ, время.

**CSV-лог (v1.2.2):** 7 колонок `utc,kind,seq,dt_ms,bytes_total,resyncs,seq_gaps`,
всё через InvariantCulture (десятичная ТОЧка — урок 12). kind:
`OPEN` — порт открыт; `D` — декодирован кадр (dt — межкадровый интервал);
`S` — статус-снимок раз в ~1 с; **`R` — рестарт потока платы** (пауза
> 250 мс + скачок SEQ — счётчик SEQ обнулился, кадры не терялись;
в v1.2.1 такие эпизоды раздували seq_gaps — живой лог 11-13: 110 из 113);
`FIN` — порт закрыт. Логи v1.2.1 (фантомная 8-я колонка) читаются
анализатором: `python3 scripts/xlog_analyze.py xlog.csv --frames N`.

Критерий приёмки: **FPS 20±0.5 стабильно (медиана dt ≈ 49–50 мс), SEQ-гэпов 0
в стационаре** (3 пропуска по 1 кадру за 110 с — норма платы в SW-режиме),
рестартов 0 без вмешательства в плату, ресинков 0, экран в окне = демо-экран
платы, счётчик SEQ в строке 22 ticking.

## 7. Железо: таймер → RST 7.5 (CPLD v24) и стена МЦ XC95108

Для «настоящего» прерывания нужен остров таймера в CPLD (база таймерной линии —
`beta/01_timer`, v3.3b3: тик 51.2 мкс, загрузка N через порт, стоп-в-нуле,
ре-арм из ISR, вектор 003Ch). Но:

| Сборка | МЦ | Источник |
|---|---|---|
| база v3.9.8-clear | 94/108 | фит 11-7 |
| **txuart v2.3 (текущая)** | **103/108** (вх.ФБ 211/216 = 98%) | фит 11-9 7:26PM |
| txuart + остров таймера | **~121/108** — НЕ ЛОЖИТСЯ | прескалер 8 МЦ (txm_cnt в базе v2.3 удалён) + счётчик 8 + строб 1 + P75 1 |

Вывод: на XC95108 совмещение «1М TX-ядро + таймер» невозможно (это же
подтверждает обе линии по отдельности: txuart-103 и таймер-v3.3b3-103 на
базе v3.2). Варианты: (а) XC95144 — недоступна; (б) v24 с зачисткой — отдельная
работа по смете. Поэтому v1 работает в SW-режиме на текущем образе CPLD, а
прошивка уже содержит полный HW-путь: вектор 003Ch, ISR с делителем и ре-армом
(`OUT 06h`), маску SIM — при будущем фите v24 достаточно `-D TMR_HW=1`.
Расчёты HW-режима (§3.5) и сим таймера v24 (инъекция прерываний по `OUT 06h`)
уже выполнены.

## 8. Уроки этой линии (для DEVLOG)

1. **asm85: метка на строке `IF`** получает адрес… никакой — резолв уходил в
   0x0000 (`CALL XSCHK` = `CALL 0000` → цикл перезагрузок 30 мс). Метки — на
   всегда-активных строках; фикс резолва в `scripts/asm85.py` (неактивные
   ветки не участвуют), регрессия fw_mon/fw_mon_fast — байт-в-байт.
2. **Равномерность пейсинга важнее среднего**: развёртка 4 Б с общим падом
   давала гэпы 23T (отбросы) при среднем 32.5T. Гэп КАЖДОЙ записи ≥ 31.25T —
   как в p04.
3. **Счётчик группы — часть бюджета тактов**: DCR C+JNZ добавлял 3.5T/Б сверх
   модели → посылка 25.8 мс вместо 24.2. Амортизировать на подгруппу 8 Б.
4. **Сим: CMP не меняет A; STAX/LDAX — полная пара; MOV r,M — из памяти** —
   три классических бага интерпретатора, пойманы побайтовыми сверками.
5. **Период HW = посылка + XS_DIVN × N тиков** (не (DIVN−1)!): делитель
   инкрементируется в ISR ПОСЛЕ ре-арма; делитель 3 дал 61 мс (сим поймал до
   железа).

6. **LDAX D — это DE-пара** (D — СТАРШИЙ байт!): «D=0F5h, E=бит» дало адреса
   0F5xx — мусор ОЗУ вместо DIGIMG → глифы-призраки на живой плате
   («L.L.L.1» поверх ACdE). Сим не поймал — у него не было модели дисплея;
   добавлена проверка «чужие глифы, норма 0» (на старой сборке = 110,
   воспроизводит железо 1-в-1).
7. **PowerShell 5.1: Form/Panel.DoubleBuffered — защищённое свойство**,
   прямое присвоение = PropertyAssignmentException до открытия порта.
   Лечение — рефлексия: `GetProperty("DoubleBuffered", Instance+NonPublic)`.
8. **SelfTest не должен зависеть от сида рандома**: «мусор» из NextBytes
   мог не содержать одиночного A5 → Resyncs=0 → FAIL. Мусор теперь
   детерминированный: A5 + заведомо не-5A.
9. **Слот дисплея внутри посылки — САМОДОСТАТОЧНЫЙ** (урок железа 11-13): XDIG
   v1.1 брала бит разряда из C — но к вызову C=0 (съеден счётчиком подгруппы
   `MVI C,25`) и `LDA SNDST` затирал бит в A → `OUT DIGP = SNDST (0/1)`:
   дисплей гас на ВСЮ посылку (или все глифы циклом на DIG0 при тоне) =
   «дрожание» на живой плате. Фикс v1.2: бит вычисляется из фазы глифа E
   (`idx=(E+3)&3`, `01h RLC idx`) и переживает `LDA SNDST` в C (как в REFRESH —
   там бит живёт в B). НЕДО-ФИКС rc1 (бит вычислили, но LDA опять затёр)
   поймала трасса портов сима (OUT DIGP=00). Сим добил модель «глиф ⇔ РАЗРЯД»:
   v1.1 = 230 гашений посылки, v1.2 = 0 — класс «дисплей не проверяли».
10. **PowerShell: `Register-ObjectEvent -Action` НЕ видит `$script:`-переменные** —
    Action выполняется в скопе PSEventJob-модуля: очередь чтения молча умирала
    в пустом `catch{}` (0 кадров при живом потоке; не всплыло только потому,
    что GUI раньше падал на кистях — `[Brush]::new([SolidBrush](…))`, Brush
    абстрактный → `SolidBrush::new(цвет)`). Чтение — опросом в GUI-таймере
    (BytesToRead→Read). Плюс: SelfTest обязан не только СОЗДАВАТЬ тестовые
    данные, но и ПОДАВАТЬ их (v1.1 создала `$garb` и не вызвала `Add-Bytes` →
    frames=1, rs=0); парсер: в state 1 держим ТОЛЬКО последний A5 — иначе
    A5-набег из мусора перед шапкой копится в Buf и сдвигает кадр на 1 Б
    (SEQ=5A, экран со сдвигом; фикс v1.2 + кейс 2b).
11. **PowerShell: `-f <список>` в скобках метод-вызова режется запятыми на
    аргументы метода** (урок железа 11-13): `WriteLine("fmt" -f a,b,c)`
    парсится как `WriteLine(("fmt" -f a), b, c)` — формат получал 1 аргумент
    при 7 подстановках `{0}..{6}` → `FormatException «Индекс ... меньше
    размера списка аргументов»` при вычислении ПЕРВОГО аргумента (v1.2
    Write-Log, всплывало только с `-Log`, скрипт умирал до открытия окна).
    Лечение: формат в переменную на уровне оператора (`$line = "fmt" -f …`
    — там список = массив), затем `WriteLine($line)`; либо обёртка в
    лишние скобки `WriteLine(("fmt" -f a,b,c))` — так сделано в
    gfx_view v1.5, поэтому там тот же капкан не стрелял. Диагностика по
    отчёту без кода: подчёркнут весь вызов `WriteLine(...)` = исключение
    при вычислении аргумента метода, а не внутри `-f`.
12. **CSV и культура потока: `-f` и `ToString()` дают ДЕСЯТИЧНУЮ ЗАПЯТУЮ
    на ru-RU Windows** (урок живого лога 11-13, v1.2.2): `{3:F1}` в
    `Write-Log` на машине владельца печатало `17,1` — и в запятой-CSV
    поле расщеплялось на `17` и `1`: шапка объявляла 7 колонок, все 2516
    строк несли 8 полей (5-е — всегда одна цифра 0–9: дробный разряд dt).
    Правило: **в машиночитаемые форматы — только InvariantCulture**
    (`.ToString("F1", [Globalization.CultureInfo]::InvariantCulture)` и
    конкатенация полей, `-f` для CSV не использовать вовсе); культурно-
    чувствительное форматирование — только в ЧЕЛОВЕЧЕСКИЙ вывод (статус,
    «Итог»). Диагностика по логу без кода: 5-е поле из одной цифры 0–9 в
    каждой строке = расщеплённая дробная часть dt, а не «лишний счётчик».
13. **Скачок SEQ после большой паузы — рестарт потока, а не потеря кадров**
    (v1.2.2): плата при перезапуске потока обнуляет счётчик SEQ (живой
    лог 11-13: пауза 462 мс, SEQ 145 → 0 → +110 ложных «гэпов» и
    «SEQ-гэпов 113» в «Итоге», из которых честных только 3). Правило
    клиента: dt > 250 мс (~5 периодов) И d ≠ 1 → `Restarts++` + строка
    `R` в CSV, `SeqGaps` не растёт. Честные пропуски той сессии (SEQ
    n→n+2 при dt 86–99 мс) классифицируются как раньше.
