digitalinvitro/CPLD-plus-8085/beta/txuart/README.md

# beta/txuart — исключительно аппаратный передатчик UART («счётчиковый» бод-рейтинг)

> **АКТУАЛЬНО (11-10-5): ШАГ 0 ПЛАНА GFXSTREAM ПРИНЯТ — ПОТОЛОК 32T ПОДТВЕРЖДЁН
> ЖЕЛЕЗОМ: FLOOD 97 887 Б/с = 97,9% ЛИНИИ, СМЕШАННЫЙ ЦИКЛ 91,4%, 0 ОШИБОК.**
> Полный 60-с прогон uart_speed v1.3 на p04-прошивке (COM13, 1М 8N1, ПЗУ
> `txstress_v11_p04.hex` = TX_BOTH=0, `uart_speed_v13_com13_p04_60s.log`):
> **71/71 цикла** ровно 76 711 Б за 840 мс (ср 839,1; цикл 1 = 799 мс — пачки
> доставки), ср **91 402 Б/с = 91,4% линии** (было 69 770 = 69,8% на TX_BOTH=1);
> FLOOD 65 536×71, паттерн +1 ЦЕЛ (0 разрывов), B=7/7, токены 7→497 (+7/цикл),
> стационар **97 887 Б/с** против потолка 32T = 97 656 (+0,24% — пачки ПК);
> SPRINT U=581 632 = 8192×71 ровно (фаза 21T/Б: 16 384 записей → каждый 2-й,
> модель 110,07 мс), BURST U=199 936 = 2816×71 ровно, ЧУЖИХ 0; вердикт «бит-
> ошибок НЕТ». Модель цикла сошлась: 671,1 (FLOOD) + 110,1 (SPRINT) + 39,0
> (BURST) + ~20 (пауза/маркеры) ≈ 840 мс. Разбор — СТАТУС 11-10-5. **ВЛАДЕЛЬЦУ:
> p04 принят — шаг 0 закрыт; ПЗУ оставить на p04 до сборки gfxstream v1.**
>
> **ПРЕДЫДУЩЕЕ (11-10-3): ПРИЁМКА TXSTRESS ЗАКРЫТА — КОНТРОЛЬНЫЙ ПРОГОН v1.3
> ЧИСТЫЙ, ВЕРДИКТ «бит-ошибок НЕТ».** Полный 60-с прогон uart_speed v1.3
> (COM13, 1М 8N1, ПЗУ txstress_v11.hex, `uart_speed_v13_com13_60s.log`):
> 52/52 цикла ровно 76 711 Б за 1097-1100 мс, ср 69 770 Б/с = 69,8% линии —
> ЕДИНИЦЫ теперь честные (v1.2 показала бы «70 Б/с, 0,1% линии»); FLOOD
> 65 536×52 с паттерном +1 ЦЕЛ (0 разрывов), B=7/7, токены 7→364 (+7/цикл);
> SPRINT U=425 984 = 8192×52 ровно, BURST U=146 432 = 2816×52 ровно, ЧУЖИХ 0;
> окно 4 024 333 Б = 52 цикла + хвост FLOOD 53-го; старт чистый (HEXDUMP с
> баннера). Два полных лога суммарно (v1.2 + v1.3) = 8,22 МБ без единой
> бит-ошибки. **ВЛАДЕЛЬЦУ: приёмка завершена — вернуть в ПЗУ монитор ACdE**
> (txstress_v11.hex больше не нужен; uart_speed.ps1 v1.3 — финальная,
> заморожена, оставить регресс-измерителем). Разбор, уточнение модели фаз и
> известная косметика — СТАТУС 11-10-3.
>
> **ПРЕДЫДУЩЕЕ (11-10-2): TXSTRESS v1.1 ПОДТВЕРЖДЁН ЖЕЛЕЗОМ — ФАЗЫ, ПАТТЕРН,
> ЛЕНДМАРКИ, СКОРОСТИ ЦИКЛОВ — ВСЁ КАК В ТЕОРИИ.** Живой прогон владельца
> (COM13, 1М 8N1, ПЗУ txstress_v11.hex): 53 ЦИКЛА ЗА 60 С БЕЗ СБОЯ (полный
> лог v1.2 = 4,19 МБ, 0 бит-ошибок; паста 8 циклов — начало), такт цикла
> ~1.100 с (сим обещал 1.091), FLOOD 65 536 Б/цикл с паттерном
> +1 ЦЕЛ, B= 7/7 (токены " TXSTRESS" растут +7/цикл), SPRINT U=8192 чужих 0,
> BURST U=2816 чужих 0 (ровно уточнённая сетка 14T/28T), цикл 76 711 Б =
> 65 536 + 8 192 + 2 816 + 167 маркеров — сходится БАЙТ В БАЙТ. Коррумпиро-
> ванный v1.0.hex был единственной причиной трёх «безбаннерных» прогонов.
> **БАГ ЕДИНИЦ uart_speed v1.2 ИСПРАВЛЕН (v1.3)**: скорость считалась как
> байты/dt(мс), а печаталась «Б/с» — занижение ровно ×1000; все 8 вычислений
> через Get-Rate(байты, dt_мс); чанк чтения 65536→4096, ReadBufferSize
> 128 КБ не тронут. Самотест pwsh 7.4.6 на эталоне 4/4. Пункт «перекачать
> v1.3 и повторить полный прогон 60 с» — ВЫПОЛНЕН 11-10-3 (СТАТУС 11-10-3).
> ПЗУ НЕ ТРОГАТЬ (v1.1 подтверждён). Разбор — СТАТУС 11-10-2.
>
> **ПРЕДЫДУЩЕЕ (11-10): ТРИ ПРОГОНА TXSTRESS РАСКРЫТЫ — hex v1.0 В ПЗУ БЫЛ
> КОРРУПТИРОВАН БАГОМ АССЕМБЛЕРА** (`size_of()` считал ANI/ADI/ACI/CPI
> однобайтовыми → все метки после первого ANI уезжали на +13..14 → баннер
> печатался как 13 байтов КОДА, после FLOOD ЦП уходил в дикий цикл, печатая
> байт 53h ('S') ~58.2 КБ/с — реконструкция симуляцией 1-в-1 совпала с
> прогонами владельца: 58 936/59 624 Б/с, 0 баннеров, топ-байт 53h 99.99 %).
> **ЛЕКАРСТВО: ассемблер исправлен, TXSTRESS v1.1 пересобран** (баннер v1.1;
> POR-пауза 503 мс; чин гейта лендмарков → ровно 7 шт B=0020..00E0; токен
> " TXSTRESS" в лендмарке — поток сам называет себя каждые 8 КБ; пауза ~20 мс
> перед баннером), верифицирован интерпретатором ПО РЕАЛЬНОМУ HEX (4/4 баннера,
> FLOOD 73 942 Б/с, цикл 1091 мс, SPRINT 8192 U, BURST 2816 U). **uart_speed.ps1
> v1.2 — диагностический релиз**: сырая диагностика без баннера (+1-пробеги/
> топ-байт/кандидаты «фактический T»), HEXDUMP, пустые секунды, -Probe, -SaveRaw.
> **ВЛАДЕЛЬЦУ: перекачать uart_speed.ps1 v1.2 и ПРОШИТЬ rom/txstress/
> txstress_v11.hex** (v1.0.hex в ПЗУ — битый). Полный разбор — СТАТУС 11-10.
>
> **ПРЕДЫДУЩЕЕ (11-9веч): v2.3 — УРОК ПЕРВОГО ЖЕЛЕЗНОГО ПРОГОНА: МУСОР В ТЕРМИНАЛЕ.**
> **ДИАГНОЗ ДОКАЗАН ПО ДАМПУ: TX-путь 1-в-1 (CPLD v2.2 + прошивка РАБОТАЮТ!),**
> **но CH340G ФИЗИЧЕСКИ НЕ УМЕЕТ 1 562 500.** Байтовая статистика дампа (1143 байта):
> биты 0–6 ВСЕГДА точны, старший бит = '1' в ~половине байтов ('2'→0xB2, '.'→0xAE,
> '='→0xBD, CR→0x8D, LF→0x8A) — приёмник получил НЕ запрошенные 1 562 500: сетка
> CH340G = 48 МГц/(2^k·m), 1 562 500 = 12 МГц/7,68 в ней НЕ СУЩЕСТВУЕТ (даташит WCH:
> …921600, **1500000**, 2000000), драйвер **МОЛЧА ставит 1 500 000** (Linux ch341.c:
> div = 48М/(4×1562500) = 7.68 → div 4, fact 0 = ровно 1,5 М). Систематика +4,17 %:
> семпл бита 7 съезжает в стоп-бит → старший бит '1'. **ЛЕКАРСТВО — v2.3: бод
> 25/25 = РОВНО 1 000 000** (точная сетка любого моста: 48М/48 = 12М/12, ошибка 0 %;
> численная модель: 0 % сбоев по всем битам даже при пессимистичном лаге
> синхронизатора +2 такта 12 МГц и дрожании ±83 нс). baud_cnt 4→5 бит (+1 МЦ,
> ожидание фита 104/108); FW/узел/CPU/контракт — БЕЗ ИЗМЕНЕНИЙ (hex прошивки
> байт-в-байт тот же, сим 10/10 при кадре 31 T). Верификация: check_v23 **75/75**,
> tb_v23 **27/27** (сетка кадров ровно 1000 нс). **Терминал теперь 1 000 000 8N1.**
> **ФИТ 11-9 7:26PM: Successful, 103/108 МЦ — ПОДНЯЛСЯ БЕЗ РОСТА МЦ** (наивный
> бюджет 104; фиттер поглотил 5-й бит baud_cnt: рег 76→77 — ровно +1, ПТ
> 341→339, вх.ФБ 213→211). Прошита, в терминале 1М — **ЧИСТО** («TXUART v2.2
> OK N=87…98», подпись v2.2 в ПЗУ намеренно). **v2.3 ПРИНЯТА ЖЕЛЕЗОМ.** Нюанс
> прогона: владелец запустил фит с Exhaustive ON + IL 15 (INFO:Cpld:994 в
> отчёте) вместо рецепта (OFF/IL 28) — упаковка другая, check_fit_v23 даёт 7
> строгих несовпадений (все разбораны — см. СТАТУС 11-9веч-2); на следующий
> фит ОПЦИИ ВЕРНУТЬ К РЕЦЕПТУ. Дальше — стресс-тест скорости
> `rom/txstress` (TXSTRESS v1.0) + измеритель PC-стороны `scripts/uart_speed.ps1`.
> История: v2.2 (фит 11-8 23:51: 103/108 МЦ, аудит 55/55 — пришит, дал мусор → урок),
> v2.1 (ядро 18 МЦ), v2.0 (цель XC95144), v1.0 (база v3.9.3).
>
> **ПРЕДЫДУЩИЙ СТАТУС — v2.2: ФИТ ПРОШЁЛ 11-8 23:51: 103/108 МЦ, ЧЕК-ЛИСТ ЗАКРЫТ —**
> **ГОТОВО К ПРОШИВКЕ CPLD И ЖЕЛЕЗНОЙ ПРОВЕРКЕ** (директива владельца «Может быть уйти
> на более простой делитель тактовой, подать на вход тактовой не 50, а 25, потом /4 и
> подать на процессор»): кольцо s0..s3 на clk 25 МГц (X1 = 6,25 МГц duty 1/4 → CPU
> 3,125 МГц), clk25_q выпилен — ВСЯ логика на clk 25, ядро бит-в-бит v2.1 (18 МЦ), бод
> 25/16 = РОВНО 1 562 500. Фит: **103/108 МЦ** — верх окна ожидания 101–103 (допуск
> 101–105); аудит `check_fit_v22.py` **55/55** (кольцо 1-в-1 в Equations, PGND ровно
> 9, GCK3, мусора коллапсинга 0, WARNING 897×3 — бенигная буферизация).
> **ЦЕНА: CPU 3,125 МГц (−12,5 %, FW-константы ×1,143) и ШУНТ H1 ОБЯЗАТЕЛЕН**
> (без шунта CPU 6,25 МГц = 1,75× разгона — НЕ ВКЛЮЧАТЬ).
> Верификация: check_v22 77/77, tb 27/27 (P0a — все 16 кодов кольца),
> **прошивка ПЗУ для проверки TX собрана и просимулирована — rom/uart_tx_test**
> (строка «TXUART v2.2 OK N=xx» раз в ~200 мс, индикатор «t.-N», сим 10/10).
> Полное описание — «СТАТУС 11-9» ниже. История: v2.1 (ядро 18 МЦ,
> ждала 105–108 — впритык), v2.0 (база v3.9.8-clear, цель XC95144),
> v1.0 (база v3.9.3).

**Директива владельца (11-8):** «Хорошо давай попробуем организовать исключительно
аппаратный трансмиттер UART, на удобный для счетчиков делителей бод рейтинг,
реализации посмотри в txclient, проект разместим в beta\txuart».

**База:** `beta/lowsize/top_suart_por6_v393.v` (v3.9.3, фит 11-2 9:54PM **прошит
и работает**: 85/108 МЦ, 195/540 ПТ, 171/216 вх.ФБ, 54 триггера, 72/81 ноги,
сброс → GSR). **Правило линии:** база бит-в-бит, ядро ложится ТОЛЬКО на свободный
ресурс + ресурс выпиленных soft-UART-транзитов. Дисплей/клавиатура/FSM/шина/
writeback/POR — не тронуты (контрольные строки — `scripts/check_v1.py`).

## Спека

| Параметр | Значение | Основание |
|---|---|---|
| Что | **TX-only**: только передатчик, RX нет | директива «исключительно аппаратный трансмиттер»; приём — программный (SID = RX, RIM 20h — как в lowsize) |
| Скорость | v2.2: 1 562 500 → **v2.3: 1 000 000 бод 8N1** (25 МГц / 25) | v2.2 брал «удобный» mod-16 (1 562 500 = 25/16) — но эта скорость **вне сетки CH340G** (48М/(2^k·m)); драйвер молча ставил 1,5 М → +4,17 % → мусор (урок железа 11-9). v2.3: mod-25, wrap **явный** по (==24) — компаратор 1 ПТ/5 вх; 1М = **точная** сетка CH340G (48М/48 = 12М/12), 0 % ошибки |
| Доступ CPU | **IO-порты**: `OUT 04h` = TXDATA, `IN 05h` = статус | декод по `addr_latch[2:0]` (класс hwuart); 04h-07h — резерв от удалённого UART (Task 69) |
| Статус | `IN 05h` = {000000, **TXRDY**, 0}: бит A1 = `!tx_run` | позиция бита — совместимость с hwuart v4.0.x (та же прошивка поллинга); чтение — механизмом KBROW (A-пины, `rd_drive`) |
| Кадр | 8N1, 10 бит, стоп ≥ 1 бита (бесконечный idle) | стандарт терминалов; приёмник терпит длинный стоп |
| Транзиты v3.9.3 | **TX-транзит выпилен** (sod_q/tx_pass/tx_q/cpu_rst, −3 МЦ); **SID = RX сохранён** (0 доп. МЦ; старый RIM-ввод и diag6 живут); **SOD (P72) — вход-наблюдатель keep** (выход CPU заземлять нельзя) | класс hwuart v4.0.x |
| Сброс | ядро в GSR-домене: shreg — SET-ветка (INIT=1FF, idle '1' до всякого клока), счётчики/tx_run — CLR; пор-цепь/делитель — вне GSR | класс v3.9.3 п.18 / hwuart п.26 |

## Карта портов (дополнение к §5 базовой)

| Порт | R/W | Биты | Функция |
|---|---|---|---|
| `04h` | OUT | D7..D0 | **TXDATA**: старт кадра. Запись при TXRDY=0 — байт **тихо отбрасывается** (кадр не портится) |
| `05h` | IN | A1 | **TXRDY** (1 = ядро в idle, кадр можно стартовать) |
| `05h` | IN | A0, A7..A2 | 0 (резерв) |
| `04h` | IN | — | **НЕ определён** (RX нет; уходит в bus_reg, не использовать) |

## Архитектура ядра (п.26-п.28 шапки RTL) — 20 МЦ

```
shreg[8:0]    9 МЦ — {данные/выход}: [0]->TX (IO-MC P39, INIT=1 — idle '1');
              загрузка ld_tx_q: {A[7:0], 1'b0} с живых A-пинов (CPU держит
              данные до подъёма WRn — запас ≥ 20 тиков); сдвиги вправо с
              инжекцией '1' -> после 9 сдвигов shreg САМ в все-'1' (idle по
              построению, как shreg 9'h1FF txclient; параллельных загрузок idle НЕТ);
bit_cnt[3:0]  4 МЦ — 0..9 (0=idle, 1..9 — сдвиги кадра);
baud_cnt[3:0] 4 МЦ — mod-16 СВОБОДНЫМ ходом: D = bc+1, wrap натуральный —
              «счётчиковый» делитель; jam <= 1 при загрузке;
tx_run        1 МЦ — идёт передача (TXRDY = !tx_run);
adv_q         1 МЦ — регистровый хелпер тика сдвига (п.21 v8: декод не
              копируется в D-функции битов shreg);
ld_tx_q       1 МЦ — РЕГИСТРОВЫЙ строб загрузки (п.28, см. ниже).
```

**п.28 — главное отличие от hwuart v4.0.x (лекарство от стены вх.ФБ фитов
11-4/11-5):** там декод `io_wr_tx` (11 литералов) грузил shreg НАПРЯМУЮ →
16 потребителей, +42 вх.ФБ, 213/216 (99%), Placement Failed ×3. Здесь
`io_wr_tx` (12 литералов: state×3, 04h×3, IOM, !WRn, !tx_run, !ld_tx_q,
!por_run) имеет **ЕДИНСТВЕННОГО потребителя** (`ld_tx_q.D`); загрузка — на
тик позже строба (данные живы); D-функция бита shreg = 3 ПТ/~5 вх
{ld_tx_q, A[k], adv_q, shreg[k+1], shreg[k]} → все 9 бит ложатся в ОДИН ФБ
(~27 вх ≤ 36).

**Тайминг кадра (п.29):** загрузка → старт-бит '0' с этого такта; jam
`baud_cnt <= 1` → первый сдвиг (adv_q) ровно на T+16 (лаг adv_q 1 такт; jam 0
дал бы 17 — урок v8/hwuart) → старт **ровно 16 тиков**, ВСЕ переходы на сетке
16 тиков; инжекция '1' — на 9-м сдвиге стоп сам в [0]; кадр закрывается на
10-м тике ядра (TXRDY ~15-й тик стопа) — при непрерывном поллинге фактический
стоп у ПК ≥ 1 полного бита.

## Контракт (для прошивки)

1. `OUT 04h` — только при TXRDY=1 (поллинг `IN 05h` бит 1; прецедент hwuart:
   период опроса ≪ бита, потерь нет).
2. Запись при активной передаче — байт ТИХО ОТБРАСЫВАЕТСЯ (кадр не портится).
3. Окно POR: запись 04h отбрасывается (!por_run в стробе) — floated-шина
   CPU в сбросе не рождает кадр-мусор (класс v8/v3.9.3 п.18).
4. ПК-сторона: терминал/приёмник на **1 000 000 8N1** (v2.3; точная сетка
   CH340G 48М/48. v2.2 просил 1 562 500 — CH340G такое не умеет: драйвер
   молча ставил 1 500 000, +4,17 % = мусор, урок 11-9).

## Наработки, применённые в ядре

| Источник | Что взято |
|---|---|
| txclient v8 / hwuart v4.0.1 | shreg 9 бит с idle-заполнением '1' от INIT (SET-ветка GSR), регистровый выход бита из IO-MC пина TX, jam-фазировка baud_cnt<=1, регистровый хелпер adv_q |
| шапка txclient v8 (список альтернатив BAUD_DIV) | выбор 16 → 1 562 500 «wrap без декода» — «удобный для счётчиков» рейтинг |
| hwuart фиты 11-4/11-5 (разбор стены) | регистровый строб загрузки ld_tx_q: у декода io_wr_tx один потребитель вместо 16 |
| lowsize v3.9.3 (п.18) | GSR-схема сброса (ядро в GSR-домене), декоды портов по addr_latch[2:0], гейт !por_run |
| 01_timer / hwuart контракт | TXRDY-поллинг, тихий отброс при busy, «RX терпит длинный стоп» |

## Чек-лист фита (владельцу, после прогона ISE)

Опции: как у фит-3 hwuart/успешной линии — **Input Limit 16, Pterm 18,
Exhaustive OFF, DENSITY**; если ERROR 891/892 — IL 28, далее Exhaustive ON.

1. `Fitting Status: Successful`, 0 ERROR; WARNING Cpld:897 ≤ 1-2 (класс D<7>);
   **WARNING:Xst:1780 в логе синтеза БЫТЬ НЕ ДОЛЖНО** (точка приёмки
   v398_clear: в RTL нет мёртвых идентификаторов — проверено check_v1).
2. Ресурсы (прогноз п.30 шапки): МЦ **102-104**/108 (85 − 3 транзит + 20 ядро
   + 1-2 хелпера $OpTx), вх.ФБ **~190-205**/216, ПТ **~250-280**/540, рег **71**,
   ноги **72/81** (пины = базе, UCF = hdl/top_suart.ucf по LOC 1-в-1).
3. **GSR**: «Signal 'RST' mapped onto global set/reset net GSR.» + «GSR : 1»;
   ядро TXUART + FSM/шина — CLR/SET=RST; por_sh×8/por_run/делитель — вне GSR.
4. **Транзит исчез**: sod_q/tx_pass/tx_q/cpu_rst в .rpt НЕТ; `TX` = shreg[0]
   (IO-MC P39, FDCPE с PRE=RST — SET-ветка GSR, idle '1').
5. **Счётчик бода**: D-функции baud_cnt — свободный инкремент БЕЗ декода
   терминального счёта (натуральный wrap); декод ==15 живёт ТОЛЬКО в baud_tick.
6. Пины: TX P39 вых, SOD P72 вх (INP, наблюдатель), SID P73 вых, RX P38 вх;
   PGND ровно 9: {P74,P75,P76,P78,P79,P81,P95,P96,P98} (rx_int НЕТ — P75
   возвращается в PGND); clk → GCK3, RST = P1.
7. Литералы сброса в термах: RST ×1 (RESET_IN) + por_run ×2 (RESET_IN-класс,
   io_wr_tx) — `scripts/check_fit_v1.py` (после появления .rpt).

## Состав

| Файл | Что |
|---|---|
| `top_txuart_por6_v1.v` | **RTL v1.0**, CP1251 — эталон для ISE |
| `top_txuart_por6_v1_utf8.v` | UTF8-двойник v1.0 для чтения/диффов |
| `top_txuart.ucf` | UCF, CP1251: ноги = hdl/top_suart.ucf 1-в-1 (72/72 LOC), комментарии актуализированы |
| `top_txuart_utf8.ucf` | UTF8-двойник UCF |
| `scripts/gen_v1.py` | генератор v1.0 из базы v3.9.3: 12 якорных правок (E0-E9) + CP1251 round-trip |
| `scripts/check_v1.py` | верификатор: кодировка/двойники, шапка, мёртвые идентификаторы (Xst:1780), структура ядра, база бит-в-бит (20 контрольных строк), порядок объявлений, хвост |
| `scripts/sim_txuart_v1.py` | цикл-точная модель v1.0 (NBA-семантика), сценарии С1-С9 — **87/87 ПАСС** |
| `tb_txuart_v1.v` | тестбенч владельцу (iverilog, реальный RTL) — **18/18 ПАСС** |
| `scripts/run_tb_v1.sh` | раннер tb (Icarus 12.0 из tools/iverilog) |
| `scripts/gen_ucf_v1.py` | генератор UCF из hdl/top_suart.ucf (6 правок комментариев, NET 1-в-1) |
| `README.md` | этот документ |

## СТАТУС 11-8веч: v2.0 НА БАЗЕ v3.9.8-clear — RTL + ВЕРИФИКАЦИЯ ГОТОВЫ, ЖДЁТ ФИТА ВЛАДЕЛЬЦА (XC95144)

Директива владельца: «Берем дизайн beta\lowsize 398_clear и переделываем txuart
на основе него». Причина (разбор фита v1.0 и вопроса «почему пропало кольцо»):
v1.0 был собран от базы v3.9.3 — до-перемычечной эпохи 25 МГц с двоичным
счётчиком mod-7 вместо кольца; на текущей плате (H1 без шунта, 50 МГц) он давал
ТРИ 2х-проблемы: бод 3,125 М (известный БЛОКЕР), CPU 7,14 МГц вместо 3,571
(X1 = 2×clk/7 — второй 2х, аудит 11-8 его пропустил), FSM/шина на clk 50
напрямую (тайминг XC95108-15 не закроет — собственное заключение v3.9.8 п.23).

**v2.0 = база v3.9.8-clear ред.2 БИТ-В-БИТ** (кольцо r0..r6 на clk 50, X1 = r0,
X2 = OR(r1..r6), clk25 = /2, por-цепь в 50-домене со стробом r0, харденинг
сброса п.20/21, FSM шины) **+ ядро TXUART v1.0, пересаженное на (clk25,
cpu_rst)**:

| Что | v1.0 (база v3.9.3) | **v2.0 (база v3.9.8-clear)** |
|---|---|---|
| Узел тактирования | счётчик mod-7 + x1_n (¬clk) | **КОЛЬЦО r0..r6** на clk 50, X1 = r0 |
| Такт ядра | clk (на плате 50 МГц → бод 2х) | **clk25** → бод = 25/16 = ровно 1 562 500 |
| CPU | 2×clk/7 → 7,14 МГц на плате (2х) | 3,571 МГц (кольцо, бит-в-бит базы) |
| FSM/шина | clk напрямую | clk25 (тайминг закрывается — доказано фитами v3.9.8) |
| GSR | сырой RST (POR-окно не покрывал) | **cpu_rst** = rst_press \| por_run (п.20: ядро чистится и в POR) |
| RESET_IN | ~(RST\|por_run) комб. | регистр **reset_q** (п.21, бит-в-бит базы) |
| Сброс кнопки | мгновенный | квалификатор ~400..440 нс (класс п.21 — приёмник кадр отбрасывает) |
| Целевое устройство | XC95108 (100/108) | **XC95144-15PQ100C** (прогноз 111–113/144) |
| io_wr_tx | 12 литералов, !por_run | + !rst_press (класс п.21e, оба источника сброса) |

Ядро (shreg/bit_cnt/baud_cnt/tx_run/adv_q/ld_tx_q, mod-16, jam, инжекция '1',
регистровый строб ld_tx_q) — **бит-в-бит v1.0**, пересажено только по такту и
сбросу. Транзит v3.7 выпилен (sod_q/tx_pass/tx_q); SOD (P72) — вход-наблюдатель
keep; SID = RX сохранён.

**Верификация:** `check_v2.py` **129/129 ПАСС** (CP1251 round-trip, двойники
синхронны, мёртвых идентификаторов в коде НЕТ — sod_q/tx_pass/tx_q + legacy
узла cnt/x1_n/…; 40+ контрольных строк базы бит-в-бит — кольцо с двойным kill,
por-цепь 50-домена, квалификатор, FSM; структура ядра на clk25/cpu_rst;
порядок объявлений). `sim_txuart_v2.py` (цикл-точная NBA-модель, ДВА домена:
тик 20 нс, узел на clk 50, логика/ядро на clk25) — **92/92 ПАСС**: С1 POR
кромка ~1020 нс (= документации базы), X1 период 7 тиков duty 1/7, X2 = ~X1,
one-hot кольца; С2 кадры на сетке РОВНО 32 тика (640 нс), PC-приёмник,
shreg сам в 1FF; С3 поток с поллингом; С4 отброс при busy; С5 статус;
С6 гейт POR (GSR + !por_run); С7 сброс через квалификатор ~400 нс — ядро
вычищено, после снятия кадр идёт; С8 ALE-глюк; С9 регрессия базы (/WE ровно
4 тика = 2 такта clk25, ПЗУ без /WE, кольцо живо). `tb_txuart_v2.v`
(владельцу, iverilog, РЕАЛЬНЫЙ RTL): **23/23 ПАСС** — X1 период ровно 140 нс,
X2 противофаза, старт ровно 640 нс.

**Прогноз фита (п.31 шапки):** 94 (база) − 3 (транзит) + 20 (ядро) + 1–2
$OpTx = **111–113/144 МЦ** на **XC95144-15PQ100C** (77–78 %); вх.ФБ ~225–240/288,
ПТ ~340–370/720, рег ~82, ноги 72/81, PGND 9. На XC95108 НЕ влезает (111 > 108)
— в ISE-проекте СМЕНИТЬ устройство. UCF — `top_txuart.ucf` (ноги 1-в-1,
комментарии/TIMESPEC актуализированы: 50 МГц).

**Владельцу (TODO ред. v2.0, п.32 шапки):** 1) в ISE-проекте Device →
xc95144-15pq100c, Set as Top Module = `top_txuart_por6_v2.v` (CP1251), UCF =
`top_txuart.ucf`; 2) фит IL 16 / Pterm 18 / Exhaustive OFF / DENSITY (при
891/892 — IL 28, далее Exhaustive ON) → .rpt НА АУДИТ ДО ПРОШИВКИ (чек-лист
п.32: кольцо в FB без декодов, X1 = r0, X2 без регистра в фазе, GSR : 1 или
fallback, ядро в GSR-домене, baud_cnt без декода, PGND ровно 9, Xst:1780
НЕТ); 3) .jed → железо (H1 уже без шунта = 50 МГц; осциллограф: X1 = 7,14
МГц duty 1/7, X2 противофаза, CLKOUT 3,57 МГц; терминал **1 562 500 8N1**).
**ДО УСПЕШНОГО ФИТА НЕ ШИТЬ.**

### Состав v2.0 (дополнение)

| Файл | Что |
|---|---|
| `top_txuart_por6_v2.v` | **RTL v2.0**, CP1251 — эталон для ISE (XC95144) |
| `top_txuart_por6_v2_utf8.v` | UTF8-двойник v2.0 |
| `top_txuart.ucf` / `top_txuart_utf8.ucf` | UCF: ноги 1-в-1 (72/72 LOC), комментарии/TIMESPEC актуализированы (50 МГц, XC95144) |
| `scripts/gen_v2.py` | генератор v2.0 из базы v3.9.8-clear: 16 якорных правок (E0-E13) + CP1251 round-trip |
| `scripts/gen_ucf_v2.py` | актуализация UCF: 8 правок комментариев + TIMESPEC 50 МГц, LOC нетронуты |
| `scripts/check_v2.py` | верификатор v2.0 — 129/129 ПАСС |
| `scripts/sim_txuart_v2.py` | цикл-точная модель v2.0 (два домена) — 92/92 ПАСС |
| `tb_txuart_v2.v` + `scripts/run_tb_v2.sh` | тестбенч владельцу (iverilog) — 23/23 ПАСС |
| `retro_pcld_top (txuart-fit1-1108-0510PM-SUCCESSFUL).rpt` | фит v1.0 (11-8) — заархивирован, история линии |
| `retro_pcld_top.rpt` (upload, 11-8 7:14PM) | FAILED-фит v2.0 на xc95108 — заархивирован у владельца; разбор — п.27 шапки v2.1 |

## СТАТУС 11-9: v2.2 — УЗЕЛ /4 НА 25 МГЦ (ШУНТ) — ФИТ ПРОШЁЛ 103/108, ЧЕК-ЛИСТ ЗАКРЫТ, ГОТОВО К ПРОШИВКЕ

Директива владельца (11-9): «Может быть уйти на более простой делитель
тактовой, подать на вход тактовой не 50, а 25, потом /4 и подать на
процессор». Контекст: v2.1 была готова, но её запас был впритык
(105–108 из 108 МЦ); кольцо N=7 + clk25_q — самые «дорогие» части узла.

### Что изменилось (узел, п.34 шапки RTL)

| Что | v2.1 (узел v3.9.8-clear) | **v2.2** |
|---|---|---|
| Вход CPLD | 50 МГц (H1 БЕЗ шунта, DIV=/2) | **25 МГц (H1 С ШУНТОМ, DIV=/4) — шунт ОБЯЗАТЕЛЕН** |
| Делитель | кольцо r0..r6 (N=7, 9 МЦ с X1/X2) | **кольцо s0..s3 (N=4, 6 МЦ с X1/X2) — −3 МЦ** |
| X1 | r0, 7,14 МГц duty 1/7 (20/120 нс) | **s0, 6,25 МГц duty 1/4 (40/120 нс — ШИРЕ)** |
| X2 | OR(r1..r6) = ~r0 (класс п.10) | **OR(s1..s3) = ~s0 (тот же класс п.10)** |
| Такт логики | clk25 = /2-триггер (+1 МЦ) | **clk 25 МГц напрямую, clk25_q ВЫПИЛЕН (−1 МЦ)** |
| CPU | 3,571 МГц (T = 280 нс) | **3,125 МГц (T = 320 нс, −12,5 %)** |
| por-цепь | 50-домен, строб r0, 8×140 = 1120 нс | **домен clk 25, строб s0, 8×160 = 1280 нс (норма 960, запас 1,33 — тот же)** |
| Бод TX | 25/16 = 1 562 500 | **ТОТ ЖЕ: 25/16 = 1 562 500 (сетка 16 тиков × 40 нс = 640 нс/бит не изменилась)** |
| Ядро TXUART | 18 МЦ | **БИТ-В-БИТ v2.1** (проверено check_v22 C5) |
| Кольцо, самоочистка | 128 кодов → one-hot ≤ 2 фронтов | **16 кодов → one-hot (tb P0a — все 16 проверены)** |

Бюджет: 94 (база) − 3 (транзит) − 3 (узел) − 1 (clk25_q) + 18 (ядро) =
105 наивно; прецедент v1.0 (−2) → **ожидание 101–103, допуск 101–105 ≤ 108**.
Если фит скажет «needs N», N > 108 — НЕ крутить опции, писать на аудит
(резерв п.33 не трогать).

### Цена решения (принята владельцем) — ПРОВЕРИТЬ ПРОШИВКУ

1. **CPU 3,571 → 3,125 МГц (×0,875)**: все такто-калиброванные константы
   FW тянутся **×1,143** (DLY ~1 мс = LXI D,0095h → ~00AAh; программный
   UART 4800 диагностики uart_echo → 4200, константы 744 → 651 такт/бит).
   **Монитор ACdE терминала НЕ использует** — индикатор/клавиатура/звук
   деградируют безбольно (частота сканирования/тон SND ниже на 12,5 %).
2. **ШУНТ H1 ОБЯЗАТЕЛЕН ДО ПОДАЧИ ПИТАНИЯ**: без шунта 50 МГц →
   X1 = 12,5 МГц → CPU 6,25 МГц (1,75× разгона ВМ85А/ОЗУ), бод 3,125 М
   (вне CH340G). После v3.9.8 плата стоит БЕЗ шунта — **ПЕРЕСТАВИТЬ**.
3. Безопасность частоты: 3,125 < 3,571 — ОЗУ/ВМ85А только в выигрыше;
   high X1 40 нс ШИРЕ золотого 20 нс (v3.9.8, железом подтверждён).

### Верификация (всё зелёное)

- `check_v22.py` — **77/77 ПАСС**: CP1251 round-trip, двойники, мёртвых
  идентификаторов в КОДЕ нет (r0..r6/clk25/clk25_q/x1_n/cnt/adv_q/tx_run/
  sod_q/tx_pass/tx_q/wb_ram_q), узел s0..s3 (двойной kill, NOR4, X1 = s0,
  X2 = s1|s2|s3, por_ce = s0, CLK_DIV == 4), ядро **строки 1-в-1 v2.1**
  (26 кодовых строк), база 1-в-1 v2.1 (210 строк, кроме узла), порядок
  объявлений, POR-структура, константы документа.
- `tb_txuart_v22.v` (iverilog, РЕАЛЬНЫЙ RTL) — **27/27 ПАСС**: C1 POR
  (RESET_IN поднимается на 1220 нс — расчёт 8×160+дрейн сходится), C1b
  X1 период ровно 160 нс / high 40 / low 120, X2 противофаза; C2 кадр 55h
  — старт ровно 640 нс, PC-приёмник декодирует, shreg сам в 1FF; C3 поток
  с поллингом; C4 busy-drop; C5 статус 02h; C7 сброс посреди кадра;
  **P0a — все 16 кодов кольца** (× инъекция между кромками) → one-hot,
  кольцо продолжает цикли, X1 160 нс после восстановления.
- Ядро бит-в-бит v2.1: доказательства переносимы — sim_txuart_v21.py
  92/92, diffsim_v2_v21.py 8 283 тика 0 расхождений (механика кадра не
  менялась ни на бит; сменился только сетевой такт clk25 → clk с той же
  частотой 25 МГц).
- Регрессия v2.1/v2.0/v1.0: файлы не тронуты (check_v22 C0).

### ФИТ 11-8 23:51 — ЗАКРЫТ (retro_pcld_top, xc95108-15pq100c, Successful)

Отчёт: `retro_pcld_top (txuart-fit2-1108-1151PM-SUCCESSFUL).rpt` (в репо).
Аудит: `scripts/check_fit_v22.py` — **55/55 ПАСС**. Ключевое:

- **МЦ 103/108 (95%)**, ПТ 341/540 (63%), вх.ФБ 213/216 (99% — впритык,
  но Successful), регистры 76, ноги 72/81 = UCF 1-в-1. Верх окна
  ожидания 101–103 (допуск 101–105) — прецедент «−2 от наивного» снова
  сработал точно.
- **Кольцо s0..s3 в Equations 1-в-1**: `X1_D = ~X1 & ~s1 & ~s2` (1 ПТ —
  advance от s3 + рестарт из dead легально свёрнуты: на достижимых
  состояниях эквивалент s3 | ~s0&~s1&~s2&~s3), `s2_D`/`s3_D`/`s1_rnm0_D`
  по 1 ПТ, `X2 = NOT(~s1 & ~s2 & ~s3)` = s1|s2|s3 (1 ПТ через polarity
  макроячейки — функционально 1-в-1). Старое r0..r6/clk25_q/adv_q/tx_run
  в нетлисте НЕТ.
- **Ядро v2.1 в отчёте**: baud_cnt_D(0) = `~ld_tx_q & ~bc0` (jam), декод
  bc==15 только в тиках bit_cnt, строб `ld_tx_q_D` = порт 04h (addr=100,
  IOM, !WRn, ~|bit_cnt), чтение 05h A1 = ~|bit_cnt (TXRDY), TX = P39
  4 ПТ SET, ld_tx_q есть, shreg<1..8> есть.
- Глобальное: clk → GCK3 (P29); **GSR-сеть НЕ используется** — это
  СТАРТОВАЯ архитектура v2.2 (RST — обычный вход, синхронизатор
  rst_meta/rst_sync + por_sh<0..7> по X1: 8×160 = 1280 нс, por_run,
  rst_press/rst_qcnt) — пункт «GSR: 1» чек-листа v1.0-эпохи заменён
  fallback-вариантом сознательно (п.32 ред. v2.2).
- Чистота: $OpTx$BIN_* = **0** (мусора коллапсинга нет), $OpTx$FX_DC
  ровно 5 здоровых декодов {61,67,70,71,73}, INFO:Cpld:994 нет,
  WARNING:Xst нет; WARNING:Cpld:897 ×3 (A<1>, D<5>, D<4> буферизация)
  — бенигный класс п.25, граница «≤1-2» v1.0-эпохи превышена на 1,
  на результат не влияет (по 1 буферному МЦ).
- PGND: закопанные МЦ ровно на {74,75,76,78,79,81,95,96,98}; READY
  (P87) и CS1 (P99) — константы '1' (0 ПТ); CLKOUT/HLDA/S0/S1/INTAn/
  RSTOUT/AH8..14/RX/SOD — входы-наблюдатели на местах.

**Вердикт: РАЗОБРАН, ЧЕК-ЛИСТ ЗАКРЫТ — CPLD МОЖНО ШИТЬ (после установки
шунта H1). До прошивки ПЗУ — раздел ниже.**

### Владельцу (TODO, ред. 11-9веч-2 — после железной приёмки v2.3)

0. **ВЫПОЛНЕНО 11-9:** фит v2.3 (7:26PM, 103/108), CPLD прошита, терминал
   1 000 000 8N1 — вывод чистый («TXUART v2.2 OK N=87…98»). TX-путь и
   скорость 1М — **ПРИНЯТЫ**.
1. **ТЕСТ СКОРОСТИ:** в ПЗУ вместо `uart_tx_test.hex` прошить
   `rom/txstress/txstress_v10.hex` (TX_BOTH=1 — пишет в 04h и 05h, безопасно
   при любой редакции ядра; порт 05h на запись — no-op в v2.3). Когда
   подтвердится рабочий порт — можно собрать/прошить вариант
   `txstress_v10_p04.hex` (только 04h, темпы выше). Терминал/PuTTY ЗАКРЫТЬ.
2. **ИЗМЕРИТЕЛЬ (PC-сторона, Windows PowerShell):**
   `scripts/uart_speed.ps1` — `.\uart_speed.ps1 -Port COM3` (по умолчанию
   1 000 000, окно 60 с; для ядра v2.2 — `-Baud 1562500`; список портов
   `-ListPorts`; чистый замер потока без TXSTRESS — `-Mode monitor`).
   Утилита печатает ожидания по фазам и сверяет факт: скорость фаз,
   целостность паттерна FLOOD (+1), объём U в SPRINT/BURST, лендмарки B=,
   вердикт по бит-ошибкам; CSV — `-Csv speed.csv`.
3. **ОПЦИИ ФИТА — ВЕРНУТЬ К РЕЦЕПТУ** (класс-урок п.27 повторился): в
   прогоне 11-9 7:26PM стояли Exhaustive ON + Input Limit 15 (INFO:Cpld:994
   в отчёте) вместо рецепта **Exhaustive OFF, IL 28, Pterm 18, DENSITY**.
   Фит прошёл (103/108), но упаковка изменилась (TX 3 ПТ вместо 4, новые
   ID FX_DC-декодов, буфер A<1>_BUFR) — строгий чекер это ловит. На
   следующий фит — сверять опции до прогона.
4. После прогона TXSTRESS (или вместо него): вернуть в ПЗУ монитор ACdE
   (его FW-константы ×1,143 — DLY 0095h→00AAh; терминал монитора НЕ
   использует).

## СТАТУС 11-9веч-2: v2.3 ПРИНЯТА ЖЕЛЕЗОМ (1М — ЧИСТО); ТЕСТ СКОРОСТИ `rom/txstress` (TXSTRESS v1.0) + ИЗМЕРИТЕЛЬ `scripts/uart_speed.ps1`

Директивы владельца 11-9веч: «1. Смотри отчет. Выдавай по нему резюме сразу
же. 2. Напиши тест который максимально загружает UART на вывод» → далее
«комить и пуш тест» + «напиши утилиту на powershell для проверки скорости
передачи в UART».

### Фит v2.3 (11-9 7:26PM, `retro_pcld_top (txuart-fit3-1109-0726PM-SUCCESSFUL).rpt`) — разбор

- **Successful, XC95108-15-PQ100: 103/108 МЦ (95 %), 339/540 ПТ, 211/216
  вх.ФБ (98 %), 77 триггеров, 72/81 ноги.** Наивный бюджет 104 (103 v2.2 +
  1 бит baud_cnt) — фиттер поглотил 5-й бит БЕЗ роста МЦ: триггеры 76→77
  (ровно +1 = `baud_cnt<4>`), ПТ 341→339, вх.ФБ 213→211.
- Ядро на месте: `TX` = FB3_11, P39, **3 ПТ, FAST SET** (idle '1'); в v2.2
  было 4 ПТ — следствие другой упаковки, пин и SET верны. `baud_cnt<0>`
  FB2_7 (2 ПТ, jam/wrap в D(0) через FX_DC$18098), `ld_tx_q` FB4_12,
  `s1_rnm0` FB4_1, буфер `A<1>_BUFR` FB4_18. `$OpTx$BIN_*` = 0 (мусора
  коллапсинга нет), FX_DC-декодов ровно 5 (новые ID 18098/18105/18110/
  18116/18120 вместо v2.2-шных 61/67/70/71/73), WARNING 897 ×1 (A<1> —
  бенигный класс п.25).
- **ОТКЛОНЕНИЕ ОТ РЕЦЕПТА:** в отчёте `INFO:Cpld:994 - Exhaustive fitting
  is trying pterm limit: 18 and input limit: 15` — фит запущен с
  **Exhaustive ON + IL 15** (рецепт: Exhaustive OFF, IL 28). Класс-урок
  п.27 повторился. Последствия — ТОЛЬКО упаковка (числа ПТ, ID декодов,
  форма уравнений), функция та же: `check_fit_v23.py` даёт 7 несовпадений,
  все 7 — строгие строковые/числовые паттерны прежней упаковки (994-строка,
  s1_rnm0, TX 4 ПТ, jam-форма в D(0), строб 04h, TXRDY-чтение, ID FX_DC).
  Вердикт: **ПРИНЯТО ПО ФАКТУ ЖЕЛЕЗА** (чистый вывод на 1М = ground truth),
  чекер к этой упаковке не применять, на следующий фит — рецепт опций.
- Железо: строка «TXUART v2.2 OK N=87…98» на 1 000 000 8N1 — чисто, счётчик
  идёт → **v2.3 принята** (подпись v2.2 в тексте ПЗУ — намеренная, hex не
  менялся).

### TXSTRESS v1.0 — `rom/txstress/` — тест максимальной нагрузки на TX

Автономная прошивка ПЗУ (0–0163h, 356 байт кода, `asm8085.py`), бесконечный
цикл из трёх фаз с маркерами в потоке; T = 320 нс (CPU 3,125 МГц):

| Фаза | Что шлёт | Темп записи | 1 000 000 бод (кадр 31,25T) | 1 562 500 (кадр 20T) |
|---|---|---|---|---|
| FLOOD | 64 КБ инкремент (+1 mod 256), лендмарк `B=xxxx` на каждые 32 блока (8 КБ) — **7 шт**: 0020…00E0 | 42T/Б (TX_BOTH=1) / 32T/Б (p04) | чисто, **74 405 Б/с** (p04: 97 656) | чисто, те же 74 405 / 97 656 |
| SPRINT | 16 384 × `U` (0x55) слепо | 31T/Б / 21T (p04) | **каждый 2-й принят** (31 < 31,25T) → 50 403 Б/с, U=8192 (p04: 74 405) | чисто **100 807 Б/с**, U=16384 (p04: 148 810) |
| BURST | 8 КБ × `U`, порт 04h | 14,875T/Б | перегруз ~1 из 3 → ~70 000 Б/с | перегруз ~1 из 2 → ~105 000 Б/с |

- Фазы разделяются маркерами `TXSTRESS v1.0` / `FLOOD OK` / `SPRINT OK` /
  `BURST OK` + CRLF; после BURST — пауза ~154 мкс (слив искорёженного кадра).
- **TX_BOTH=1** (головной `txstress_v10.hex`): каждый байт пишется и в 04h,
  и в 05h — работает при любой редакции ядра (чужой порт на запись — no-op,
  декод записи в ядре только addr=100). **TX_BOTH=0** (`_p04.hex`): только
  04h, темпы выше — собирать после подтверждения рабочего порта.
- Сборка: `python3 asm8085.py txstress_v10_utf8.asm txstress_v10
  [TX_BOTH=0]` (CP1251-канон `txstress_v10.asm` тоже собирается — фолбэк
  кодировки в asm8085.py). Верификация: `scripts/verify_txstress.py` —
  HEX↔BIN, CS, DAA-трюк перевода ниббла ('0'…'F' через ADI 90h/DAA/ACI 40h/
  DAA), аудит темпов. Оба .hex пересобраны бит-в-бит (utf8 = cp1251 = hex
  прошлой сессии).
- Лендмарков в цикле **7, не 8** (D&1F==0 даёт D = 0x20…0xE0; при 256-м
  блоке D = 0x01 — выход по CPI 001h) — поймано самотестом утилиты, см.
  урок ниже.

### `scripts/uart_speed.ps1` — измеритель скорости и целостности (Windows, PowerShell 5.1+)

- **Что меряет:** поток Б/с посекундно (мин/макс/средняя, % линии = baud/10);
  в режиме txstress — фазы по маркерам: счёт байтов и U/чужих в окнах,
  целостность паттерна FLOOD (+1 mod 256, лендмарки отфильтровываются),
  последовательность лендмарков, средний цикл banner→banner (самое точное
  окно), вердикт по бит-ошибкам, код выхода (0/1 порча/2 обрыв порта);
  CSV посекундно — `-Csv`. Ожидания по фазам считает из `-Baud`/`-TxBoth`
  и печатает перед прогоном. `-Mode monitor` — чистый замер любой прошивки.
- **Механика:** Latin-1 (байт↔символ 1:1), BaseStream.Read + таймаут 250 мс,
  буфер 128 КБ, машина фаз с хвостом 18 символов (маркеры через границу
  чанка не теряются и не дублируются), время позиции потока — интерполяция
  по чанкам приёма (счётчики байтов точные, скорости фаз — с точностью
  единиц процентов).
- **Самотест ДО железа (pwsh, синтетический поток = точная модель TXSTRESS
  на 1М, TX_BOTH=1, 25+ циклов):** чистый поток — все счётчики бит-в-байт
  (FLOOD 65 536, разрывов 0, B= 7/7 за цикл, SPRINT U=8192/цикл, BURST
  U=2731/цикл, чужих 0, вердикт зелёный); порченый поток (потеря байта
  FLOOD + бит-ошибка SPRINT + бит-ошибка BURST) — все три порчи найдены
  (РАЗРЫВОВ +1: 1, ЧУЖИХ 1+1, вердикт красный, exit 1). Монитор-режим и
  `-ListPorts` проверены. Сборка самотеста: `scripts/gen_txstress_sim.py`
  (эталон потока) + `scripts/make_ps1_sim.py` (подмена COM-порта фидером —
  код Close-Phase/Get-TimeAtPos остаётся 1-в-1).
- **УРОК (класс «лови до железа»):** первая вычитка предполагала 8 лендмарков
  (0020…0100) — самотест на эталонном потоке поймал 7 «плохих»: при D&1F==0
  D ходит 0x20…0xE0 (7 попаданий), на 256-м блоке D=0x01 — выход. Комментарий
  в asm «каждые 32 блока (8 КБ)» верен; «8 штук» в ожиданиях утилиты —
  исправлено на 7.

### Состав 11-9веч-2 (дополнение)

| Файл | Что |
|---|---|
| `rom/txstress/txstress_v10.asm` | **TXSTRESS v1.0**, CP1251+CRLF канон |
| `rom/txstress/txstress_v10_utf8.asm` | UTF-8 двойник (исходник сборки asm8085.py) |
| `rom/txstress/txstress_v10.hex` | Intel HEX, TX_BOTH=1, 356 байт кода (0000h–0163h) — **прошивать в ПЗУ** |
| `rom/txstress/txstress_v10_p04.hex` | вариант TX_BOTH=0 (только порт 04h), 330 байт |
| `rom/txstress/txstress_v10.lst` / `_p04.lst` | листинги сборки (с T-состояниями) |
| `rom/txstress/asm8085.py` | мини-ассемблер 8085 (листинг с T, .bin/.hex, фолбэк CP1251) |
| `scripts/verify_txstress.py` | верификатор: HEX↔BIN/CS, DAA-трюк, аудит темпов |
| `scripts/uart_speed.ps1` | **измеритель скорости/целостности PC-стороны** (UTF-8 BOM, PS 5.1+) |
| `scripts/gen_txstress_sim.py` + `scripts/make_ps1_sim.py` | самотест uart_speed.ps1: эталон потока TXSTRESS + подмена порта |
| `retro_pcld_top (txuart-fit3-1109-0726PM-SUCCESSFUL).rpt` | **фит v2.3 11-9 7:26PM**: 103/108 МЦ, Successful (Exhaustive ON/IL 15 — см. разбор) |

### Состав v2.2 (дополнение)

| Файл | Что |
|---|---|
| `top_txuart_por6_v22.v` | **RTL v2.2**, CP1251 — эталон для ISE (XC95108) |
| `top_txuart_por6_v22_utf8.v` | UTF8-двойник v2.2 |
| `top_txuart.ucf` / `top_txuart_utf8.ucf` | UCF v2.2: TIMESPEC/комментарии 25 МГц + шунт; LOC 1-в-1 (72/72) |
| `scripts/gen_v22.py` | генератор v2.2 из v2.1: 49 якорных правок + CP1251 round-trip |
| `scripts/gen_ucf_v22.py` | актуализация UCF: 7 правок (TIMESPEC/комментарии), LOC нетронуты |
| `scripts/check_v22.py` | верификатор v2.2 — **77/77 ПАСС** |
| `tb_txuart_v22.v` + `scripts/run_tb_v22.sh` | тестбенч владельцу (iverilog) — **27/27 ПАСС** |
| `retro_pcld_top (txuart-fit2-1108-1151PM-SUCCESSFUL).rpt` | **фит v2.2 11-8 23:51**: 103/108 МЦ, Successful |
| `scripts/check_fit_v22.py` | аудит фита по чек-листу — **55/55 ПАСС** |
| `rom/uart_tx_test.asm` (+ `_utf8`) | **прошивка ПЗУ для железной проверки TX** (CP1251 канон) |
| `rom/uart_tx_test.hex` / `.lst` | Intel HEX (0000h–0303h, 772 байта) / листинг CP1251 |
| `rom/sim_uart_tx_test.py` | симуляция прошивки (8085-интерпретатор + модель TXRDY/дисплея) — **10/10 ПАСС** |
| `rom/asm85.py` | копия ассемблера из beta/01_timer/rom (сборка) |

## Прошивка ПЗУ для железной проверки TX — `rom/uart_tx_test`

Задача владельца «готовь прошивку в ПЗУ для проверки работы UART на
передачу». Прошивка автономная (не монитор): после POR шлёт в
аппаратный TXUART строку и мультиплексирует индикатор.

**Что делает:**

- Раз в ~200 мс: строка **`TXUART v2.2 OK N=xx`** + CR LF, xx — счётчик
  строк (hex, mod 256). Каждый байт — строго после поллинга **TXRDY=1**
  (`IN 05h, ANI 02h` — контракт п.1; запись при busy тихо отбрасывается
  ядром, поэтому поллинг обязателен).
- Индикатор: мультиплекс 1 мс/разряд (250 Гц): DIG3=`t` (тест идёт),
  DIG2/DIG1=`-`, DIG0 = млад. нибл счётчика. OUT 00h = сегменты,
  OUT 01h = разряды (A4 = SND — держится 0, звук молчит).
- Прерывания запрещены (INT-линии заземлены PGND), стек в ОЗУ на
  0E000h, CPU 3,125 МГц (T = 320 нс).

**Тайминги (померены симуляцией по реальному HEX):** срез 1 мс =
3117 T = 997,4 мкс (−0,3 %); период строк 626 870 T = 200,6 мс; кадр
UART 6,4 мкс = 20 T; период опроса TXRDY ~27–90 T — TXRDY уровень,
промаха нет; первый байт уходит при TXRDY=1 (ядро idle с POR).

**Проверки симуляции `rom/sim_uart_tx_test.py` (10/10 ПАСС,
672 мс CPU = 2,1 млн T):** C0 первый байт при TXRDY=1; C1 все OUT 04h
при TXRDY=1 (84/84, нарушений 0); C2 поток 1-в-1 «TXUART v2.2 OK
N=00..03» ×4, хвост 0 (байты не теряются/не дублируются); C3 период
строк 626 870 T; C4 срез 3117 T; C5 фазы 01→02→04→08 по 3117 T, глифы
DIG0=HTAB[C&0F]/'-'/='t', призрак seg→dig < 15 T; C6 бит A4 (SND) всех
записей порта 01h = 0; C7 нет HLT/зависаний.

**Сборка и проверка:**

```
python3 beta/01_timer/rom/asm85.py beta/txuart/rom/uart_tx_test.asm \
        -o beta/txuart/rom/uart_tx_test.hex -l beta/txuart/rom/uart_tx_test.lst
python3 beta/txuart/rom/sim_uart_tx_test.py     # из любого места
```

(в `rom/` лежит копия asm85.py — можно собирать из каталога;
исходник CP1251, канон проекта; `_utf8`-двойник рядом.)

**Что ожидать на железе** (после шунта H1 + прошивки CPLD + прошивки
ПЗУ): терминал 1 562 500 8N1 — ~5 строк/с, N растёт на 1; индикатор:
`t.-N`. Если строк НЕТ, но индикатор жив — TX-путь (CPLD P39 → CH340G
RXD) или терминал; если нет и индикатора — CPU/шина/питание (индикатор
после сброса должен светить «8.8.8.8.» до первого OUT 00h — прошивка
берёт дисплей на себя за первые миллисекунды).

**Примечание:** уроки первой сборки (исправлены в v2 финала): (1)
таблицы глифов/масок положены на границы страниц 0200h/0300h — страничная
адресация `MVI H,страница` + `MOV L,индекс`; (2) PUTH шлёт в UART
ASCII-символ ('0'..'9','A'..'F'), а не глиф индикатора; HTAB — только
для дисплея. Симулятор (по прецеденту lowsize/verify_fw.py) выловил
оба до железа + собственные баги симулятора: PUSH 8085 — pre-decrement
SP, rp-пары (lo,hi).

## СТАТУС 11-10-5: ПРОГОН НА p04 (TX_BOTH=0) ПРИНЯТ — ПОТОЛОК 32T ПОДТВЕРЖДЁН ЖЕЛЕЗОМ, ШАГ 0 GFXSTREAM ЗАКРЫТ

**Доклад владельца 11-10-5** (COM13, 1 000 000 8N1, ПЗУ `txstress_v11_p04.hex`
— вариант TX_BOTH=0 из 63f64b2, uart_speed v1.3, полный прогон 60 с —
`uart_speed_v13_com13_p04_60s.log`, OEM-866 → UTF-8; разбор
`/home/z/my-project/scripts/analyze_log2_p04.py`). Это **шаг 0** плана
gfxstream: проверка прогноза «FLOOD 97 656 Б/с (97,7%), цикл ~845 мс (~91%),
~70 циклов за 60 с». **ИТОГ — ВСЁ СБЫЛОСЬ С ТОЧНОСТЬЮ ПАЧЕК ДОСТАВКИ:**

| Метрика | Прогноз p04 (63f64b2) | Факт (log2) | Статус |
|---|---|---|---|
| Циклов за 60 с | ~70 | **71** (71×76 711 = 5 446 481 из 5 484 263) | ✔ |
| Цикл, мс | ~845 | **839,1 ср** (69× ровно 840; 799/820 — циклы 1-2) | ✔ |
| Средняя по окну | ~91% | **91 402 Б/с = 91,4%** | ✔ |
| FLOOD | 97 656 Б/с (97,7%) | **ср 98 021, стационар 97 887** (+0,24%) | ✔ |
| SPRINT | U=8192, фаза ~110 мс | **U=581 632 = 8192×71 ровно**, приём ср 92 549 | ✔ |
| BURST | U=2816, ~42 мс | **U=199 936 = 2816×71 ровно**, приём ср 79 887 | ✔ |
| Паттерн/лендмарки | +1 ЦЕЛ, B=7/7, +7 токенов | 0 разрывов, B=7/7×71, токены 7→497 | ✔ |
| ЧУЖИХ / бит-ошибки | 0 / вердикт зелёный | **0 / «бит-ошибок НЕТ»** | ✔ |

**(1) АРИФМЕТИКА ЗАМКНУЛАСЬ ДО БАЙТА И ДО МИКРОСЕКУНДЫ.** Цикл p04 = 76 711 Б
за **840 мс** = сумма фаз из исходника: FLOOD 256 блоков×256×32T =
2 097 152T = **671,1 мс** (провод 65 536×31,25T = 655,4 мс → 97,7% фазы);
SPRINT 16 384 записей×21T (MOV+OUT+MOV+OUT+DCR+JNZ без второго OUT) =
344 064T = **110,1 мс**, TX_BUSY 31,25T > 21T → каждый 2-й → U=8192
(приём 74 425 Б/с по модели — пачки ПК показывают 92 549, как в 11-10-3);
BURST 8 192×14,875T = 121 856T = **39,0 мс** (U=2816, как в v1.1);
маркеры 167 Б + пауза 19,7 мс. Сумма ≈ 840,2 мс — **измерение совпало с
моделью**, дальше нечего объяснять.

**(2) ПОТОЛОК ПОЛОСЫ ТЕПЕРЬ ЖЕЛЕЗНЫЙ ФАКТ.** Стационарная FLOOD 97 887 Б/с
(после цикла 1) против теоретических 97 656 = зазор 240 нс/Б (32T−31,25T)
подтверждён; смешанный канал 91,4% — выше не бывает на этой архитектуре
(остаток = SPRINT/BURST-фазы с их сетками + пауза тишины). Для gfxstream
это даёт бюджет кадра **3 906 Б на 25 FPS** (40 мс × 97 656).

**(3) ФОРЕНЗИКА.** Цикл 1: dt 799 мс, FLOOD 107 401 Б/с — прогрев чтения
после 2-с паузы до сброса (та же картина, что в v1.2/v1.3: первый пачечный
чанк сжимает фазовые dt; счётчики цикла 1 точны — 76 711 ровно). Цикл 2:
820 мс. Далее 69 циклов подряд **ровно 840 мс** — такт стабильнее сотых
доли процента. Посекундно: мин 88 237 / макс 92 956 (±2,6% = пачки USB);
алиасинга 11-с бампов v1.3 больше нет — цикл 0,84 с не резонирует с 1-с
вёдрами. Хвост окна: 37 782 Б = баннер 72-го цикла на ~59,61 с + 0,387 с
FLOOD. В логе нет построчной таблицы «t=N c» (только сводка) — не ошибка:
v1.3 печатает её в полном виде, копия владельца обрезана по ИТОГ.

**(4) ИТОГ ШАГА 0.** Линия/CPLD/ядро/ПЗУ проверены в ОБЕИХ конфигурациях
(TX_BOTH=1: 69,8% цикл, 74,4% FLOOD; TX_BOTH=0: 91,4% цикл, 97,7% FLOOD),
суммарно три полных лога = 12,7 МБ без единой бит-ошибки. Заявленный в SPEC
(gfxstream §5) критерий шага 0 выполнен — **переходим к firmware gfxstream v1**
(beta/gfxstream/SPEC.md п.6): баннер `GFXSTREAM v1`, TYPE 01 160×100 1bpp
тест-паттерн на 25 FPS, затем TYPE 02 дельты; ПК-вьюер `gfx_view.ps1`.

## СТАТУС 11-10-3: КОНТРОЛЬНЫЙ ПРОГОН uart_speed v1.3 — ПРИЁМКА ПРОЙДЕНА (52/52 цикла, 0 ошибок), TXSTRESS-кампания ЗАКРЫТА

**Доклад владельца 11-10-3** (COM13, 1 000 000 8N1, ПЗУ `txstress_v11.hex`,
`uart_speed.ps1` v1.3, полный прогон 60 с — `uart_speed_v13_com13_60s.log`,
OEM-866 → UTF-8). Старт ЧИСТЫЙ: HEXDUMP начинается с баннера
`0D 0A "TXSTRESS v1.1" 0D 0A` (17 Б), данные с t≈2,3 с (t=0..1 — пауза до
сброса ПЗУ). ИТОГ прогона:

```
Циклов: 52; средний цикл 76 711 Б за 1099 мс -> 69 770 Б/с (69,8% линии)
  FLOOD : 65 536 Б/цикл, паттерн +1 ЦЕЛ, B= 7/7, ср. 74 786 Б/с (ожид. 74 405)
  SPRINT: U=425 984 (ожидание 425 984 — 1-в-1), ЧУЖИХ 0, ср. 59 529 Б/с
  BURST : U=146 432 (ожидание ~146 432 — 1-в-1), ЧУЖИХ 0, ср. 82 184 Б/с
ВЕРДИКТ: бит-ошибок НЕТ, все фазы целы
Окно: 60,0 c, 4 024 333 байт -> 67 070 Б/с (67,1% линии)
```

Сверка арифметики (скрипт-разбор): 52/52 цикла РОВНО 76 711 Б
(65 536 + 8 192 + 2 816 + 167), нумерация 1..52 без пропусков — ни одного
потерянного баннера; dt цикла 1097-1100 мс (ср 1099,58 — такт стабильнее
0,3%); скорость цикла 69 752-69 953 Б/с, ср 69 770 = 69,77% линии — та же
величина в v1.2 печаталась «70 Б/с (0,1% линии)», баг единиц закрыт на
живом прогоне; FLOOD 65 536×52, разрывов +1: 0, лендмарков 364 = 7×52
(плохих 0), токенов 364 с приростом ровно +7/цикл; SPRINT U=8192×52 и
BURST U=2816×52 — счётчики точные кратные числа циклов. Окно 4 024 333 Б =
52 цикла (3 988 972) + 35 361 Б хвоста = баннер 53-го цикла на ~59,5 с +
0,475 с FLOOD (74 405 Б/с) до закрытия окна. **Суммарно два полных лога
(v1.2: 4 190 994 + v1.3: 4 024 333) = 8 215 327 Б ≈ 8,22 МБ без ЕДИНОЙ
бит-ошибки.**

### Скорости фаз: уточнение модели — средние реальные, разброс был шумом интерполяции

FLOOD ср. 74 786 (ожидание 74 405, +0,5%) — отлично. SPRINT ср. 59 529 и
BURST ср. 82 184 — выше оценок ОЖИДАНИЙ (50 403 / 70 028). **Честная
поправка к прогнозу «после чанк-фикса подойдут к номиналу»**: v1.3 (чанк
4096) сжала именно РАЗБРОС фазовых скоростей (SPRINT 57-98 → 55,5-71,4
стационар; BURST 79-125 → 75,7-91,2 стационар), а средние остались ~60 К /
~82 К — значит завышение средних в v1.2 было НЕ интерполяционным шумом
(шум давал хвосты распределения), а реальной концентрацией доставки:
оценка ОЖИДАНИЙ делила U на ПОЛНУЮ номинальную длительность фазы
(162,5 / 39,0 мс), а фактические фазовые dt = 137,6 / 34,3 мс — буфер
вычитывается пачками на фоне производства записей, приём смещён к началу
фазы. На целостность и U это не влияет: U — счётная величина и точна
до байта.

### Единичные выбросы — пачки доставки, счётчики точны

- Цикл 1: фазовые скорости завышены (FLOOD 81 267 / SPRINT 73 881 / BURST
  93 418 против стационара 73,9-74,8 К / 55,5-71,4 К / 75,7-91,2 К) —
  прогрев чтения: после 2-с паузы первый чанк доставляется пачкой, фазовые
  dt занижены; счётчики цикла 1 точны (76 711 ровно, паттерн ЦЕЛ).
- Цикл 10, BURST 223 383 «Б/с»: 2 816 Б за ~12,6 мс — разовая пачка
  USB/драйвера; U = 2 816, чужих 0 — странная только мгновенная скорость.

### Посекундные бампы: алиасинг такта цикла с 1-секундными вёдрами

Бампы >70 К/с в t=9-11, 20-22, 31-33, 42-44, 53-55 — интервал между
группами РОВНО 11,0 с = бит-период 1/(1 − 1/1.0994) = 11,1 с между тактом
цикла 1.0994 с и сеткой 1-с вёдер: раз в бит-период граница фазы/тишины
выравнивается с краем ведра, и пачечная доставка перекидывает ~1,5-2,2 К
между соседними секундами. Сумма по окну сходится до байта — на счётчики
не влияет; этим же объясняется «макс 71 464» в ИТОГ.

### Косметика v1.3 (известна, вердикту не мешает, утилита ЗАМОРОЖЕНА)

- «ПУСТЫХ: 2 из 60 (поток прерывался!)» на каждом чистом холодном старте —
  секунды t=0..1 паузы до сброса ПЗУ, НЕ обрыв (подтверждено: HEXDUMP с
  баннера, 52/52 цикла подряд).
- «мин 1» в посекундной строке — краевое ведро t=60 (1 Б после закрытия
  окна), не разрыв.

### ИТОГ КАМПАНИИ

TXSTRESS v1.1 (ПЗУ) + uart_speed v1.3 — ПРИНЯТЫ. Линия 1 000 000 8N1,
CH340G, CPLD TXUART (v2.3), ядро и ПЗУ-прошивка закрыты 8,22 МБ двух
полных логов без единой бит-ошибки; три «безбаннерных» прогона полностью
объяснены коррумпированным v1.0.hex (баг size_of ассемблера). **ВЛАДЕЛЬЦУ:
вернуть в ПЗУ монитор ACdE** (txstress_v11.hex больше не нужен);
uart_speed.ps1 v1.3 — финальная версия, оставить регресс-измерителем на
случай правок CPLD.

## СТАТУС 11-10-2: TXSTRESS v1.1 ПОДТВЕРЖДЁН ЖЕЛЕЗОМ (8 циклов, паттерн +1 ЦЕЛ, B=7/7, U=8192/2816) + uart_speed v1.3 — ФИКС ЕДИНИЦ СКОРОСТИ (×1000)

**Доклад владельца 11-10-2** (COM13, 1 000 000 8N1, ПЗУ `txstress_v11.hex`,
`uart_speed.ps1` v1.2): фазовый разбор ЗАРАБОТАЛ — 8 циклов в пасте:

```
=== ЦИКЛ k: 76 711 Б за 1097-1100 мс -> 70 Б/с (0,1% линии)  [единицы v1.2, см. ниже]
  FLOOD : 65 536 Б, паттерн +1 ЦЕЛ, B= 7/7 (токенов 7k), 75-84 «Б/с»
  SPRINT: 8 192 Б, U=8 192, чужих 0, 57-98 «Б/с»
  BURST : 2 816 Б, U=2 816, чужих 0, 79-125 «Б/с»
```

Сверка с теорией/симуляцией v1.1: цикл 1.097-1.100 с (сим 1.091 с); FLOOD
65 536 Б/цикл ровно, разрывов +1 ноль; лендмарков ровно 7 за цикл, значения
по порядку 0020..00E0, токен " TXSTRESS" в каждом (счётчик +7/цикл); SPRINT
U=8192 (каждый 2-й из 16 384 записей), чужих 0; BURST U=2816 (ровно
уточнённая сетка 14T внутри прохода + 28T на стыке проходов), чужих 0 — на
границе линии кадры ЦЕЛЫ, переполнение = тихая потеря записей, как задумано.
**76 711 Б/цикл = 65 536 (FLOOD) + 8 192 (SPRINT) + 2 816 (BURST) + 167
маркеров (баннер 17 + 7 лендмарков ×17 + FLOOD OK 10 + SPRINT OK 11 +
BURST OK 10) — сходится БАЙТ В БАЙТ.** ВЫВОД: прошивка v1.1 работает
1-в-1 проекту; причина трёх «безбаннерных» прогонов — только коррумпированный
v1.0.hex (баг ассемблера), плата/ядро/линия ни при чём.

### БАГ ЕДИНИЦ v1.2: скорость печаталась в Б/мс под подписью «Б/с» (×1000)

Во всех скоростных строках v1.2: `$rate = байты / dt`, где dt — МИЛЛИСЕКУНДЫ
(Stopwatch/интерполяция), а печаталось «Б/с»; «% линии» делил ту же величину
на 100 000 Б/с. Живое доказательство: «76 711 Б за 1097 мс -> 70 Б/с (0,1%
линии)» — на самом деле 69 928 Б/с = 69,9% линии. **v1.3**: все 8 вычислений
(цикл+%, FLOOD, SPRINT/BURST, ИТОГ цикл/FLOOD/SPRINT/BURST) через
`Get-Rate(байты, dt_мс) = 1000·байты/dt`; блок ОЖИДАНИЙ и «средняя по окну»
в ИТОГ были правильными (там dt в секундах) — не тронуты. Бонус-точность:
чанк чтения 65536 → 4096 Б — сетка (время,позиция) для Get-TimeAtPos стала
плотнее фазы; по живому прогону v1.2 FLOOD шёл +1.4% (75 000 vs 74 405 —
норма), короткие SPRINT/BURST завышались ~+15% (57-98/79-125 «Б/мс» — шум
интерполяции на чанке ДЛИННЕЕ фазы). ReadBufferSize 131072 НЕ тронут — это
драйверный буфер против пульсаций USB, не размер чтения PS.

### САМОТЕСТ v1.3 (pwsh 7.4.6, эталон `gen_txstress_sim.py` = точная модель v1.1)

- **чистый поток 60 циклов**: счётчики 1-в-1 эталону (FLOOD 65 536 Б/цикл,
  паттерн +1 ЦЕЛ, B= 7/7, токены +7/цикл; SPRINT U=8192×N, BURST U=2816×N,
  чужих 0), вердикт зелёный, exit 0; единицы проверены по каждой строке ЦИКЛ
  («Б за X мс -> 1000·76711/X Б/с»);
- **порченый поток** (потеря байта FLOOD + бит SPRINT + бит BURST + битое
  ЗНАЧЕНИЕ лендмарка): все 4 порчи найдены в своих фазах (РАЗРЫВОВ +1: 1;
  ЧУЖИХ 1; ЧУЖИХ 1; B= 6/7 плохих 5), вердикт «ПОРЧЕНИЯ», exit 1;
- **v1.0-совместимость**: баннер «TXSTRESS v1.0» + лендмарки без токена —
  разбор идёт, токенов 0 (норма);
- **безбаннерный непрерывный +1**: «ПОХОЖЕ: непрерывный инкрементный (+1)
  поток», таблица кандидатов «фактический T», exit 1;
- парсер PS — 0 ошибок; копии download/, scripts/, beta/txuart/scripts/
  бит-в-бит.

### ПОЛНЫЙ ЛОГ v1.2 (60 с, COM13) — 53 ЦИКЛА ПОДРЯД, ВЕРДИКТ ЗЕЛЁНЫЙ (доклад 11-10-3)

Полный 60-секундный лог `uart_speed_v12_com13_60s.log` (консоль OEM-866,
декодирован в UTF-8) — усилывает пасту 8 циклов до **53 полных циклов
подряд** без единого сбоя:

- **все 53 цикла — 76 711 Б за 1100 мс** (разброс 0 — такт цикла стабильнее
  сотых доли процента); такт 69 737 Б/с = 69,7% линии;
- счётчики — точные кратные 53: лендмарков 371 = 7×53 (плохих 0, токенов
  371), SPRINT U=434 176 = 8192×53, BURST U=149 248 = 2816×53, ЧУЖИХ 0
  везде; **ВЕРДИКТ: бит-ошибок НЕТ, все фазы целы** (exit 0);
- окно 60,0 c: 53×1.100 = 58,3 c + 1,7 c частичных фрагментов = 125 311 Б
  (1,63 цикла-эквивалента); темп фрагментов 73 712 Б/с ≈ FLOOD 74 405 —
  оба фрагмента чистые FLOOD-хвосты: старт захвата В СЕРЕДИНЕ FLOOD
  (HEXDUMP начинается с 47h 'G', баннер пришёл на ~0,9 с; v1.2 верно
  показала «!! баннера нет, но найден лендмарк B=0040 TXSTRESS» и не
  засчитала хвост до первого баннера как порчу) и обрез окна посреди
  FLOOD 54-го цикла;
- **баг единиц v1.2 подтверждён на ИТОГ**: «FLOOD ср. 75» = 75 000 Б/с
  (+0,8% к ожиданию 74 405 — точность интерполяции для FLOOD отличная);
  «SPRINT ср. 60» = 60 000 (+19,0%: dt 136,5 мс против честных 162,5);
  «BURST ср. 81» = 81 000 (+15,7%: dt 34,8 мс против 39,0) — систематика
  ровно та, что предсказана (чанк 64 КБ длиннее короткой фазы), лечится
  чанком 4096 в v1.3; «средний цикл … -> 70 Б/с» = 69 737;
- строка, которая была права всегда: «средняя 69 846 Б/с (69,8% линии)» —
  dt в секундах, не тронута багом;
- посекундно: мин 1 / макс 76 711, секунд 61, ПУСТЫХ нет — «мин 1» это
  граничное ведро (секунда, обрезанная стартом/концом окна), не разрыв
  потока: 53 цикла идут тютелька в тютельку.

ЗАКЛЮЧЕНИЕ по железу: линия/CPLD/ядро/прошивка v1.1 — 53/53 цикла без
единой бит-ошибки на 4,19 МБ; утилита v1.2 умеет всё, кроме честных единиц
(исправлено в v1.3); остаётся только перекачать v1.3 и снять контрольный
прогон с настоящими Б/с.

### Владельцу (TODO, ред. 11-10-2)

1. **ПЕРЕКАЧАТЬ `scripts/uart_speed.ps1` (v1.3)** — в v1.2 скорости занижены
   ×1000 («70 Б/с» вместо 69 900).
2. **ПЗУ НЕ ТРОГАТЬ** — `txstress_v11.hex` подтверждён железом.
3. Полный прогон 60 с: `.\uart_speed.ps1 -Port COM13` (терминал закрыть).
   Ожидать в НАСТОЯЩИХ единицах: «=== ЦИКЛ N: ~76 711 Б за ~1097 мс ->
   ~69 900 Б/с (69,9% линии)»; ИТОГ: FLOOD ср. ~74 000 (ожидание 74 405),
   SPRINT ~50-55 К, BURST ~70-80 К (оценка по интерполяции), U за окно
   = 8192×циклов / ~2816×циклов, вердикт зелёный, exit 0.
4. Прислать ИТОГ целиком (можно с `-Csv speed.csv`) — после ОК вернуть в
   ПЗУ монитор ACdE (п.5 ред. 11-10).

## СТАТУС 11-10: КОРЕНЬ ТРЁХ ПРОГОНОВ НАЙДЕН — БАГ АССЕМБЛЕРА size_of; ПРОШИВКА TXSTRESS v1.1 (пересборка + лендмарки) + УТИЛИТА v1.2 (сырая диагностика)

**Доклад владельца 11-10** (COM13, 1 000 000 8N1, TX_BOTH=1, `uart_speed.ps1`
v1.1, окно 60 с, `rom/txstress/txstress_v10.hex` в ПЗУ): три прогона —
(1) 60.2 c, 614 871 Б → 10 212 Б/с, активных секунд 11 (мин 37 453 / макс
62 080); (A) 60.0 c, 3 577 536 Б → 59 624 Б/с (59.6 % линии), секунд 61,
мин 31 / макс 61 280; (B) 58 936 Б/с, мин 1 / макс 59 616. **Во всех трёх
ИТОГ без фаз: баннер «TXSTRESS v1.0» не найден ни разу** — ни циклов, ни
вердикта. Поток A/B непрерывен и стабилен ~59.6 КБ/с — не похож ни на одну
фазу (FLOOD 74 405, SPRINT-приём 50 403, BURST-приём ~70 028).

### Диагноз: hex v1.0 исполнялся КОРРУПТИРОВАННЫМ — виноват ассемблер, не плата

Разбор листинга `txstress_v11.lst` первой сборки: `JNZ FLC` кодировался
в 0x0086, а метка FLC реально стояла в 0x0093. Причина — `size_of()` в
`rom/txstress/asm8085.py` не знал двухбайтовых непосредственных ALU
(**ANI/ADI/ACI/SUI/SBI/XRI/ORI/CPI**): проход 1 считал их однобайтовыми,
проход 2 эмиссил два байта → все метки ПОСЛЕ первого ANI уезжали: +1 к
PB2D (один ANI гейта), **+13 к FLC** (гейт + 4 цифры × ANI+ADI+ACI), **+14
ко всему дальше** (ещё CPI). В прошитом v1.0.hex:

- `LXI H,M_BAN` грузил **M_BAN−14** → PBAN печатал байты КОДА до ближайшего
  00h: `CA 19 01 D3 04 D3 05 23 C3 0C 01 C3 0A 00` — баннера в потоке НЕТ,
  вместо него 13 мусорных байтов;
- лендмарки не печатались никогда (гейт `JNZ FLC` валился в середину
  цифро-печатного кода);
- **после FLOOD ЦП уходил в дикий цикл**: прыжки `JZ FDONE`/`JNZ SPIN`
  вели в чужой код, и программа навсегда печатала байт **53h ('S')** в темпе
  цикла печати 54T/байт ≈ 58.2 КБ/с.

**ДОКАЗАТЕЛЬСТВО** — `scripts/sim_txstress_v10_repro.py` (интерпретатор 8085
по РЕАЛЬНОМУ v10.hex + модель ядра TX): за 9.6 с — 0 вхождений «TXSTRESS
v1.0», средний темп **58 195 Б/с**, медиана активной секунды **58 962 Б/с**,
топ-байт **53h × 99.99 %**, макс-пробег +1 = 255 (единственный чистый блок
FLOOD в начале) — 1-в-1 картина прогонов A/B владельца (58 936/59 624,
0 баннеров, непрерывный поток). Прогон 1 (10.2 КБ/с, 11 активных секунд) —
та же прошивка: на плате поток непрерывен, значит рвалась ДОСТАВКА на PC
(USB/хост) — v1.2 теперь считает ПУСТЫЕ секунды и умеет `-SaveRaw`, при
повторении будет видно.

### ФИКС ассемблера + пересборка TXSTRESS v1.1

`size_of()` дополнен списком непосредственных ALU (2 байта). Повторная
сборка: все метки 1-в-1 (`LXI H,M_BAN` → 0138h = M_BAN; `JNZ FLC` → 0093h
= FLC; …). Изменения исходника v1.1:

1. **Баннер «TXSTRESS v1.1»** (PC-сторона принимает оба баннера по regex).
2. **Чин гейта лендмарков** (независимо от бага ассемблера, поймано по
   столу): в v1.0 гейт смотрел СТАРШИЙ байт счётчика (`MOV A,D; ANI 01Fh`)
   — весь первый килоблок DE=0000h..00FFh даёт D=00 → лендмарк печатался бы
   КАЖДЫЙ блок (256 «B=00xx» вместо 7). Теперь `MOV A,E; ANI 01Fh; JNZ FLC;
   MOV A,E; ORA A; JZ FLC` → кратен 32 блокам И E≠0 → **ровно 7 лендмарков
   B=0020..00E0**, 1-в-1 с ожиданиями uart_speed и эталон-генератором.
3. **Токен синхронизации**: лендмарк = `B=xxxx TXSTRESS\r\n` — поток сам
   называет себя каждые 8 КБ (~107 мс): если баннер цикла не пойман,
   PC-сторона доказуемо видит, что исполняется TXSTRESS, и где она внутри
   FLOOD.
4. **POR-пауза 126 → 503 мс** (`LXI D,0000h`): запас открыть терминал/скрипт
   до первого баннера.
5. **Пауза ~19.7 мс тишины** перед баннером каждого цикла (`LXI D,0A00h`):
   баннер выходит из чистого idle; хвост «BURST OK → баннер» остаётся пустым
   по байтам.

Темпы фаз НЕ тронуты (FLOOD 42T, SPRINT 31T, BURST 14.875T); head = 379
байт (0000h–017Ah), p04 = 353 байта.

### ВЕРИФИКАЦИЯ v1.1 (по реальному hex, `scripts/sim_txstress_v11.py`)

Мини-интерпретатор 8085 + модель ядра TX (кадр 31.25T, отброс при busy):
баннеров 4/4; лендмарков ровно 7 `0020..00E0` с токеном за цикл; FLOOD
65 536 байт +1 mod 256, 0 разрывов; SPRINT — слепо 16 384 записей по 31T →
принято ровно **8192 'U'**; **BURST — ровно 2816 'U'** (реальная сетка
записей 14T внутри прохода + 28T на стыке: 5.5 приёма/проход × 512 проходов
— прежнее «~2730» было приближением равномерной сетки 14.875T); FLOOD-факт
**73 942 Б/с** (42T + лендмарки), цикл **1091.2 мс**; p04: FLOOD **96 860
Б/с**, цикл **828.6 мс**; раскладки «05h = no-op» и «05h = алиас того же
ядра» дают **бит-в-бит одинаковый баннер+FLOOD** (алиас легально принимает
больше 'U' в SPRINT — 12 288 — это НЕ порча, uart_speed v1.2 это знает);
«BURST OK → баннер» — 0 байт. `verify_txstress.py`: HEX↔BIN/CS — 4 файла
(v10+v11) ОК.

### uart_speed.ps1 v1.2 — ДИАГНОСТИЧЕСКИЙ РЕЛИЗ

- баннер ищется ВЕСЬ поток по regex (`TXSTRESS v1.0` и `v1.1`); лендмарки
  принимаются с токеном и без (v1.0);
- **сырая диагностика при отсутствии баннера**: +1-разрывы/пробеги,
  доля 55h('U'), ТОП-байт (нативно через Add-Type C#, fallback — первые
  64 КБ в PS), период байта и таблица «если это FLOOD/SPRINT/BURST —
  фактический T = …нс» (совпал T=320нс → фаза опознана; не совпал нигде →
  в ПЗУ чужая программа);
- **HEXDUMP первых байт** (`-HexDump`, по умолчанию 256) — что реально идёт
  по линии с первого байта;
- счёт **ПУСТЫХ секунд** (симптом прогона 1 виден сразу);
- **-Probe**: короткий диагноз (3 с + hexdump 512) без полного замера;
- **-SaveRaw <файл>**: сырой поток в файл (до 64 МБ) для разбора;
- лендмарк-токен в IDLE печатается сразу: «баннера нет, но найден
  B=… TXSTRESS — это TXSTRESS, идёт FLOOD»;
- хвост до ПЕРВОГО баннера больше не считается порчей.

**Самотест (pwsh 7.4.6, хирургия порта `make_ps1_sim.py` — якоря $sp v1.2,
код Close-Phase/Get-TimeAtPos 1-в-1):** (1) чистый v1.1-эталон 60 циклов —
113/113 циклов по 76 711 Б точно, FLOOD +1 цел, B= 7/7, SPRINT U=8192/цикл,
BURST U=2816/цикл, вердикт зелёный, exit 0; (2) поток из СИМУЛЯЦИИ hex
(txs11_sim.bin) — зелёный, 52 цикла точных, exit 0; (3) v1.0-совместимость
(баннер v1.0, лендмарки без токена) — зелёный, exit 0; (4) порченый поток
(4 порчи: потеря байта FLOOD, бит в SPRINT, бит в BURST, битое ЗНАЧЕНИЕ
лендмарка) — все найдены, вердикт «ПОРЧЕНИЯ», exit 1; (5) АУТЕНТИЧНЫЙ
дикий поток реконструкции v1.0 (txs10_repro.bin из sim_repro) — «СИНХРОНИЗАЦИЯ:
баннер не найден… в ПЗУ, вероятно, НЕ TXSTRESS» + «монотонный поток одного
байта 53h — дикий цикл печати» + hexdump `CA 19 01 D3 04…`, exit 1;
(6) безбаннерный непрерывный +1 — «FLOOD-подобный, БЕЗ маркеров», exit 1;
(7) `-Probe` — 3 с, hexdump 512, диагноз, exit 1. Синтаксис парсером PS —
0 ошибок; BOM сохранён; копии download/, scripts/, beta/txuart/scripts/
бит-в-байт.

### Состав (новое 11-10)

| Файл | Что |
|---|---|
| `rom/txstress/txstress_v11.asm` | **прошивка v1.1**, CP1251 канон |
| `rom/txstress/txstress_v11_utf8.asm` | UTF8-двойник |
| `rom/txstress/txstress_v11.hex/.bin/.lst` | head, TX_BOTH=1, 379 Б |
| `rom/txstress/txstress_v11_p04.hex/.bin/.lst` | p04, TX_BOTH=0, 353 Б |
| `rom/txstress/asm8085.py` | **ИСПРАВЛЕН** (size_of: imm-ALU = 2 байта) |
| `scripts/sim_txstress_v11.py` | интерпретатор по hex: аудит v1.1 + дамп эталона |
| `scripts/sim_txstress_v10_repro.py` | реконструкция прогонов на битом v10.hex |
| `scripts/uart_speed.ps1` | **v1.2** — сырая диагностика, -Probe, -SaveRaw |
| `scripts/gen_txstress_sim.py` | эталон v1.1 (+v1.0-совместимость, +безбаннерные) |
| `scripts/make_ps1_sim.py` | хирургия под v1.2 ($sp + обход проверок порта) |

### Владельцу (TODO, ред. 11-10)

0. **ВЫПОЛНЕНО 11-9:** v2.3 принята железом (1М чисто); фит-опции к
   следующему фиту — по рецепту (Exhaustive OFF, IL 28, Pterm 18, DENSITY).
1. **ПЕРЕКАЧАТЬ `scripts/uart_speed.ps1` (v1.2)** — старая v1.1 не поймёт
   баннер v1.1 и не покажет сырую диагностику.
2. **ПРОШИТЬ В ПЗУ `rom/txstress/txstress_v11.hex`** — hex v1.0, который
   сейчас в ПЗУ, КОРРУПТИРОВАН (баг ассемблера), его обязательно заменить.
   (Позже, после подтверждения рабочего порта — вариант `txstress_v11_p04.hex`.)
3. Терминал/PuTTY ЗАКРЫТЬ; `.\uart_speed.ps1 -Port COM13` (1 000 000, окно
   60 с). Ожидать: баннер «TXSTRESS v1.1» каждые ~1.09 с, циклы «=== ЦИКЛ
   N: ~76 700 Б», вердикт зелёный.
4. **Если баннера снова нет** — сразу `.\uart_speed.ps1 -Port COM13 -Probe`
   и прислать вывод целиком; для длинного разбора добавить `-SaveRaw raw.bin`.
5. После ОК — вернуть в ПЗУ монитор ACdE (FW-константы ×1,143: DLY
   0095h→00AAh; терминал монитора НЕ использует).

## СТАТУС 11-8веч-2: v2.1 — СЖАТИЕ ЯДРА 20 → 18 МЦ ПОД XC95108, RTL + ВЕРИФИКАЦИЯ ГОТОВЫ, ЖДЁТ ФИТА ВЛАДЕЛЬЦА

**Директива владельца (11-8веч):** «У нас нет еще 144 Xilinxm все так же на
108, смотри отчет фит нее лезет» (+ `.rpt` 11-8 7:14PM: xc95108, **Fitting
Status: Design Rule Checking Failed**, ERROR:Cpld:837 «needs at least **431**
but only 108 left», ERROR:Cpld:868, «No logic has been mapped», 386
незмапленных узлов, GCK/GSR/GTS не назначены).

### Разбор фит-отчёта (п.27 шапки v2.1)

**431 МЦ — НЕ размер дизайна, а ФАНТОМ чужих опций фиттера.** В прогоне 11-8
7:14PM стояли **Exhaustive Fitting: ON + Input Limit: 1 + Pterm Limit: 1**
(видно в хвосте отчёта, «Compiler Options»). При IL/PT=1 коллапсинг выключен:
каждый аддер/мультиплексор рассыпается на однолитеральные осколки
`$OpTx$BIN_AND/BIN_STEP` (296 из 386 незмапленных узлов) — 111 МЦ честной
логики раздувается в 431 МЦ фантома. INFO:Cpld:994 «pterm limit: 1 and input
limit: 1» в успешных .rpt линии НЕ встречается вовсе. **Успешная линия всегда:
Exhaustive OFF, Input Limit 16..28, Pterm 18, DENSITY.**

НО: честный бюджет v2.0 (п.31 ред. v2.0) **111–113 МЦ > 108** — на XC95108
v2.0 не влезала и с правильными опциями (потому целью был XC95144). Директива
11-8веч: 144 НЕТ → ядро сжато, цель СНОВА XC95108.

### Что сделано в v2.1 (ядро 20 → 18 МЦ, п.31 шапки)

| Узел | v2.0 | **v2.1** |
|---|---|---|
| `adv_q` (1 МЦ) | хелпер тика сдвига | **ВЫПИЛЕН**: jam `baud_cnt <= 0` вместо `<= 1` — первый сдвиг на ТОТ ЖЕ фронт (лаг adv_q 1 такт скомпенсирован) |
| `tx_run` (1 МЦ) | флаг занятости | **СВЁРНУТ**: `bit_cnt` = 1..10 — НОМЕР БИТ-ТАЙМА кадра (1 = старт, 2..9 = данные, 10 = стоп), 0 = idle; busy = `\|bit_cnt` (1 ПТ), TXRDY = `~\|bit_cnt`, гейт io_wr_tx — 4 inline-литерала |
| `shreg[8:0]` 9 МЦ | сам-idle, `{A,1'b0}` | **БЕЗ ИЗМЕНЕНИЙ** |
| `ld_tx_q` 1 МЦ | регистровый строб (п.30) | **БЕЗ ИЗМЕНЕНИЙ** |
| Узел v3.9.8-clear | кольцо r0..r6, clk25, POR 50-домена | **БИТ-В-БИТ базы** |

**Бюджет (п.31):** наивно 94 − 3 (транзит) + 18 = **109 МЦ**; прецедент v1.0:
наивная сумма 102, фит лёг в 100 (−2 — фиттер сверяет логику ядра с шинной)
→ **ожидание 105–108 ≤ 108 — ВЛЕЗАЕТ**. Допуск чек-листа: МЦ 105–108,
рег ~78, вх.ФБ ~200–212/216, ПТ ~300–340/540, ноги 72/81. Если фит скажет
«needs N», N > 108 — НЕ крутить опции (класс-урок п.27!), писать на аудит;
следующий рычаг — **резерв п.33** (−1 МЦ: ld_tx_q → одноразовость от
`!wr_seen`, строб загрузки станет комбинационным) — ТОЛЬКО по команде
владельца.

**Верификация (всё зелёное):**

- `check_v21.py` — **131/131 ПАСС** (CP1251 round-trip, двойники синхронны;
  мёртвых идентификаторов в КОДЕ нет — sod_q/tx_pass/tx_q + **adv_q/tx_run**;
  40+ контрольных строк базы бит-в-бит; структура ядра v2.1: jam 0, tx_idle
  = `~\|bit_cnt`, закрытие `(bit_cnt == 4'd10) ? 4'd0`; порядок объявлений).
- `sim_txuart_v21.py` (цикл-точная NBA-модель, два домена) — **92/92 ПАСС**
  (С1–С9, те же сценарии, что v2.0).
- **`diffsim_v2_v21.py` — ДИФСИМ v2.0 ↔ v2.1: 8 283 тика, РАСХОЖДЕНИЙ 0**:
  обе модели с идентичным стимулом (POR, кадры 55h/00h/FFh/A3h, поток с
  поллингом TXRDY, busy-drop, порты 00h–05h, циклы памяти с writeback,
  ALE-глюк, OUT 04h в окне POR, сброс посреди кадра, случайные паузы) —
  сравнение ПОСЛЕ КАЖДОГО тика всех наблюдаемых выходов (TX, A_out вкл.
  TXRDY, D_out, CS/OE/WE, RESET_IN, SID, seg/dig/snd/col, X1/X2) и общих
  регистров (shreg, ld_tx_q, FSM, addr_latch, bus_reg, порты, rst-цепь,
  узел). Легальные внутренние отличия (не наблюдаются): фаза baud_cnt
  после jam (1 против 0 — фронты сдвигов совпадают, покрыто строгим
  равенством shreg), кодировка bit_cnt (1..10 против 0..9).
- `tb_txuart_v21.v` (iverilog, РЕАЛЬНЫЙ RTL) — **23/23 ПАСС** (X1 ровно
  140 нс, X2 противофаза, старт ровно 640 нс, busy-drop, сброс посреди
  кадра).
- Регрессия v2.0: check_v2 129/129, sim_v2 92/92, tb_v2 23/23 — файлы v2.0
  не тронуты.

**Владельцу (TODO ред. v2.1, п.32 шапки):**

1. В ISE-проекте **УСТРОЙСТВО xc95108-15pq100c** (v2.0 просил xc95144 —
   ВЕРНУТЬ, если менялось); Set as Top Module = `top_txuart_por6_v21.v`
   (CP1251); UCF — прежний `top_txuart.ucf` (ноги НЕ менялись).
2. **ОПЦИИ ФИТТЕРА СВЕРИТЬ С КОМПИЛЯТОРОМ: Input Limit 28, Pterm Limit 18,
   Exhaustive OFF, Optimization DENSITY** (в прогоне 11-8 7:14PM стояли
   IL 1 / PT 1 / Exhaustive ON — класс-урок п.27!). Фит и .rpt НА АУДИТ ДО
   ПРОШИВКИ (чек-лист п.32: кольцо в FB без декодов, X1 = r0, X2 без
   регистра в фазе, GSR : 1 или fallback, ядро в GSR-домене, baud_cnt без
   декода терминального счёта, бит-таймы bit_cnt 1..10, ld_tx_q в .rpt ЕСТЬ,
   PGND ровно 9, Xst:1780 НЕТ; МЦ 105–108).
3. Если фит скажет «needs N», N > 108 — НЕ крутить опции самовольно, писать
   на аудит; резерв п.33 (−1 МЦ) применить ТОЛЬКО по команде.
4. По успешному фит-у: .jed → железо (H1 БЕЗ шунта = 50 МГц; осциллограф:
   X1 = 7,14 МГц duty 1/7, X2 противофаза, RESET_IN низ ~1,04 мкс; терминал
   **1 562 500 8N1**, тест OUT 04h / поллинг IN 05h).
   **ДО УСПЕШНОГО ФИТА НЕ ШИТЬ.**

### Состав v2.1 (дополнение)

| Файл | Что |
|---|---|
| `top_txuart_por6_v21.v` | **RTL v2.1**, CP1251 — эталон для ISE (XC95108) |
| `top_txuart_por6_v21_utf8.v` | UTF8-двойник v2.1 |
| `scripts/gen_v21.py` | генератор v2.1 из v2.0: регионы A/B1/D/E + чек-листы f/g/h + CP1251 round-trip |
| `scripts/check_v21.py` | верификатор v2.1 — 131/131 ПАСС |
| `scripts/sim_txuart_v21.py` | цикл-точная модель v2.1 — 92/92 ПАСС |
| `scripts/diffsim_v2_v21.py` | **дифсим v2.0 ↔ v2.1** — 8 283 тика, 0 расхождений |
| `tb_txuart_v21.v` + `scripts/run_tb_v21.sh` | тестбенч владельцу (iverilog) — 23/23 ПАСС |

## Статус

- **11-8: v1.0 — RTL + верификация ГОТОВЫ, ждёт фита владельца.**
  Верификация: `sim_txuart_v1.py` **87/87 ПАСС** (С1 POR/idle/X1-узор/SID/статус;
  С2 кадры 55h/AAh — все переходы на сетке ровно 16 тиков, старт ровно 16,
  PC-приёмник декодирует, shreg сам в idle 1FF; С3 поток "ABC" с TXRDY-поллингом
  без потерь, межкадровые стопы ≥ 16 тиков; С4 отброс при busy — кадр цел,
  0x99 на линии нет; С5 статус 02h/00h; С6 гейт POR — OUT 04h в окне POR
  отброшен, после POR кадр проходит; С7 RST посреди кадра — GSR, TX='1' в
  первый такт, ядро вычищено, после сброса кадр идёт; С8 строб требует
  T2 && !WRn — ALE-глюк до данных кадра не рожает; С9 регрессия базы: порты
  00-02h, KBROW, writeback /WE ровно 2 тика, ПЗУ без /WE). `tb_txuart_v1.v`
  (владельцу, iverilog, РЕАЛЬНЫЙ RTL): **18/18 ПАСС**. `check_v1.py`: **76/76 ПАСС**
  (CP1251 round-trip, двойники синхронны, мёртвых идентификаторов в коде нет,
  база бит-в-бит — 20 контрольных строк, порядок объявлений).
  Владельцу: фит в ISE (`top_txuart_por6_v1.v` CP1251 + `top_txuart.ucf`),
  опции IL 16 / Pterm 18 / Exhaustive OFF / DENSITY → .rpt НА АУДИТ (чек-лист
  выше + шапка RTL п.31) → .jed и железо (терминал 1 562 500 8N1).
  **ДО УСПЕШНОГО ФИТА НЕ ШИТЬ.**
  По результату: механика ld_tx_q — кандидат на перенос в hwuart v4.0.2 и/или
  txclient v9 (лекарство от стены вх.ФБ, доказанное отдельным дизайном).

## СТАТУС 11-8: ФИТ 1 — Successful, ресурсы сошлись, НО БЛОКЕР БОД 2× — НЕ ШИТЬ

Фит владельца (txuart-fit1-1108-0510PM, заархивирован здесь): Successful,
0 ERROR, только benign-варнинги; 100/108 МЦ, 259/540 ПТ, 190/216 вх.ФБ,
71 рег, 72/81 ноги, PGND 9 — прогноз п.30 сошёлся по всем метрикам; стена
Cpld:891 взята (п.28 ld_tx_q сработал). Аудит уравнений нетлиста: ядро
здорово, база (X1/X2 mod-7) байт-в-байт v3.9.3.

БЛОКЕР: baud_cnt считает mod-16 на posedge clk (50 МГц) -> на плате
3,125 Мбод, а спека 1 562 500 (25 МГц/16); tb/sim моделировали ядро на
25 МГц (CLKP=40/TICK=40) и пропустили 2×; 3,125 М выше потолка CH340G
(2 Мбит/с). ФИКС v1.1: mod-32 — baud_cnt<4> (+1 МЦ), adv_q.D += b4;
бод = 50/32 = ровно 1 562 500; tb: CLKP=20 нс. Подробно — beta/DEVLOG.md,
запись 11-8 (ФИТ 1). Примечание аудита: b0 baud_cnt и shreg<8> в .rpt
напечатаны в инверсном домене (экономия 1 ПТ) — НЕ дефект, сверять с RTL.
