digitalinvitro/CPLD-plus-8085/beta/lowsize/README.md

# beta/lowsize — линия СНИЖЕНИЯ количества ресурсов CPLD

Папка для работ над **уменьшением размера HDL-дизайна в CPLD** (число МЦ /
ПТ / входов ФБ по фиту) при неизменной функциональности и неизменной
производственной частоте **CPU 3,571 МГц** (X1/X2 = 7,143 МГц, кольцо N=7,
терминал 6857 8N1).

## База и статус

| Версия | Статус | Ресурсы (фит) |
|---|---|---|
| **v3.9.1** | база линии (перенесена из `beta/hiclock`, clk10-64). РТЛ принят владельцем, эквивалентность v3.9 доказана (дифсимуляция 10 595 циклов + формальный перебор произведения машин). **Фит владельца 10-30 7:28PM: 88/108 МЦ — РАБОТАЕТ В ЖЕЛЕЗЕ (10-30)**. Откат — .jed v3.9 10-29 8:45PM | фит 10-30: **88/108 МЦ, 205/540 ПТ, 186/216 вх. ФБ, 58 триггеров**. Прогноз «~87 МЦ» по МЦ НЕ сошёлся: фиттер потратил освободившуюся МЦ (ячейка FB2_17 от wb_ram_q) на переупаковку — въехали state_FSM_FFd1/FFd2 (из исчерпанного ФБ4 18/18\*) и addr_latch<0>/<6>; выигрыш вышел в ПТ/входах: −9 ПТ (214→205), −16 вх. ФБ (202→186, 94→86%), исчерпан остался только ФБ3 (в v3.9 — ФБ1, ФБ3, ФБ4 и ФБ6) |
| **v3.9.2** | кандидат (clk10-65): делитель «кольцо N=7» → двоичный счётчик mod-7 (−4 МЦ). Частоты/узор X1/X2/POR/терминал — бит-в-бит v3.9, доказано двумя ступенями (дифсимуляция чипа 10 595 циклов 0 расхождений + узловая симуляция 15/15 ПАСС). **Фит владельца 10-30 8:32PM — АУДИТ ПАСС. ЖЕЛЕЗО 10-30: дисплей ПАСС, клавиатура ПАСС** (изначально 9 кнопок «не работали» — были нераспаяны, цепи колонок замыкались через них в линию; после распайки матрица полная). Послесвечение глифов устранено в прошивках (блэнкинг, клк10-67 — см. rom/). **ФИНАЛ 10-30: v3.9.2 ПРИНЯТА владельцем** — перепрошил образами с блэнкингом, послесвечения нет. Откат — .jed v3.9 10-29 8:45PM | фит 10-30: **85/108 МЦ (79%), 209/540 ПТ, 180/216 вх. ФБ (83%), 54 триггера** — ровно прогноз «85 при хелпере»: por_ce = (cnt==1)\|(cnt==6) фиттер продублировал в 2 МЦ-хелпера ($OpTx$FX_DC$517/520, по 2 ПТ). Аудит: узел тактирования 4 триггера (cnt<0> FB6_6, x1_n FB6_7, cnt<2> FB6_8, cnt<1> FB6_10); X1/X2 — комбинационные XOR ровно 4 ПТ = (cnt!=0)^x1_n, X2 = ~X1; уравнения por-цепи бит-в-бит v3.9 (hold/shift на 517/520); запрещённых литералов (r0..r6, x1_p/x2_p, t0_q/x1_q/x2_q, wb_ram_q) в нетлисте 0; клавиатурный тракт байт-в-байт v3.9.1; ноги 72/72 (CS1=FB2_3/P99, READY=FB4_5/P87); предупреждения — штатная пара (iSE-репозиторий + Cpld:897 буфер D<7>), не блокер |
| **v3.9.3** | 2026-11-02: **сброс логики → сеть GSR** (мера по сбросу — директива владельца «отрабатывать по линии lowsize, в более новой прошивке»). Норм-путь бит-в-бит v3.9.2 (дифсимуляция 10 595 циклов 0 расхождений + узловый сим 9/9 ПАСС). Два фита владельца 11-2 (RTL один и тот же, анатомия сброса идентична): **фит 1 7:54PM — АУДИТ ПАСС** («Signal 'RST' mapped onto global set/reset net GSR», «GSR : 1»; пин P1 = GSR/I, буфер в FB2_5; 38 триггеров через GSR; литералы сброса в термах 133 → 3: RST ×1 (RESET_IN) + por_run ×2 (RESET_IN + гейт POR-окна); вне GSR por_run/cnt/x1_n/por_sh/sod_q — по плану); **фит 2 9:54PM — ПРОШИТ В ЖЕЛЕЗО, РАБОТАЕТ** (владелец 11-2). Мера п.18 закрыта по всем трём уровням (фит + сим + плата). Известно хороший .jed теперь и у v3.9.3 (фит 9:54PM); откат дальний — .jed v3.9 10-29 8:45PM | фит 2 (прошит): **85/108 МЦ (79%), 195/540 ПТ (36%), 171/216 вх. ФБ (79%), 54 триггера, ноги 72/81** — рекорд линии по вх. ФБ, МЦ = минимуму (v3.9.2); исчерпанных ФБ НЕТ (худшие ФБ1/ФБ3 по 35/36). фит 1: 86/192/173. Прогноз п.18 сошёлся по направлению во всём; цена сброса по литералам упала в ~44 раза (133 → 3, в обоих фита́х). Отличие фитов только в упаковке: в фите 2 строб por_ce возвращён в паттерн v3.9.2 — 2 выделенных МЦ-хелпера ($OpTx$FX_DC$449/452, по 2 ПТ), предупреждений меньше v3.9.2 (штатная пара, Cpld:897 ушёл) |
| **v3.9.4** | 2026-11-05: **POR-счётчик 8→4 со стробом x1_n** (М1 из txclient v8; одобрена владельцем «Делаем Б» 11-5; закрывает возражение п.18 — строб 1/период 280 нс вместо пары {200,80}). Норм-путь бит-в-бит v3.9.3: дифсимуляция v3.9.3 vs v3.9.4 (scripts/tb_v394_diff.v, Icarus 12.0) — **10 595 циклов 0 расхождений, 0 spec-нарушений, логи ОЗУ идентичны (4077), T0 POR: ровно 4 сдвига F→7→3→1→0, por_run на 1020 нс ≥ 840 нс нормы, повторного POR нет**. **Фит владельца 11-4 10:15PM — SUCCESSFUL, аудит ПАСС** (чек-лист TODO 3b сошёлся весь, М1 в нетлисте точная, GSR-анатомия бит-в-бит v3.9.3 — разбор ниже). Оговорка: прогон с Input Limit 16 (у референсов 3.9.1-3.9.3 — 28), сравнение режимов не чистое, но итог всё равно рекордный. **.jed фита годится в прошивку — чекпоинт «запасная прошивка» маршрута Б достигнут**. Откат — .jed v3.9.3 (фит 11-2 9:54PM) | фит 1 (11-4): **82/108 МЦ (76%), 182/540 ПТ (34%), 168/216 вх. ФБ (78%), 50 триггеров, ноги 72/81 — рекорд линии по всем четырём метрикам**. Прогноз: МЦ 79-81 — промах +1 (упаковочные BUF_x1_n/X2_cmp_D2 + шинный хелпер $123), ПТ ~170-180 — промах +2 (в lowsize пор-цепь — D-мьюксы 2ПТ/бит, а не T-цепи 4ПТ как в txclient v8), вх. ФБ ~164-168 — сошлось, триггеры 50 — сошлось |
| **v3.9.5** | 2026-11-05: **ИСПРАВЛЕНИЕ ДЕФЕКТА СТАРТА v3.9.3/v3.9.4** (жалоба владельца 11-5: нестабильный запуск по питанию/кнопке, у товарища не стартует вовсе, v3.9.2 стабилен): **GSR-источник расширен RST → cpu_rst = RST \| por_run** (п.20 шапки) — логика снова держится в сбросе весь POR, как в v3.9.2, но АСИНХРОННО через сеть GSR. Дельта RTL — 2 слова (`posedge RST`→`posedge cpu_rst`, `if (RST)`→`if (cpu_rst)`; генератор `scripts/gen_v395.py`). Доказательство дефекта и фикса — fuzz-тест «плавающей» шины в окне POR (`scripts/tb_por_fuzz.v`, 100 сидов): **грязь в момент снятия por_run — v3.9.2 0/100, v3.9.4 100/100 (дефект воспроизведён), v3.9.5 0/100 (фикс)**; rd_drive-контеншн с '573 в окне POR — 86 тактов у v3.9.4, 0 у v3.9.5. Дифсим v3.9.4 vs v3.9.5 (`tb_v395_diff.v`): **10 595 циклов 0 расхождений, RST-окна строго, T0 POR бит-в-бит v3.9.4** (4 сдвига, ≥840 нс, повторного POR нет). **Фит 11-5 10:40PM SUCCESSFUL — аудит ПАСС с одним отклонением (GSR fallback), .jed v3.9.5 ШИТЬ** | фит факт: **79/108 МЦ, 217/540 ПТ, 163/216 вх.ФБ, 50 рег, 72/81 ног** — МЦ/вх.ФБ лучше прогноза, ПТ +27 сверх прогноза (GSR не свёлся: 40 асинхронных PTC-сбросов вместо сети GSR, D-функции чистые, +5 вх.ФБ — дешёвый fallback, разбор в разделе) |
| **v3.9.6** | 2026-11-06: **ХАРДРЕНИНГ ЦЕПИ СБРОСА** (п.21 шапки; жалоба владельца 11-6 на v3.9.5 — у ОБОИХ фитов Exhaustive ON/OFF: «только выкл-вкл питания возвращает работоспособность по сбросу; просто сброс не может восстановить, пока не восстановится по питанию»; гипотеза п.1 разбора — подтяжка цепи RST — владельцем СНЯТА: резистор стоит давно, ничего не висит). Причина: в фите v3.9.5 сырой пин RST доходил НАПРЯМУЮ до гейта RESET_IN (нога CPU) и до 40 PTC-сбросов — мид-рейл/дребезг/помеха на SW20 размазывают моменты отпускания CPU и триггеров (модель `sim_v395_rst_float.py`: спад 10 мкс — BOOT 7-10/20, ложные /WE и контеншн ~50%; у механической кнопки — миллисекунды дребезга на отпускании). Мера: **RST входит в кристалл ТОЛЬКО через регистры** — 2FF-синхронизатор + квалификатор 8 тактов (переворот rst_press) + cpu_rst = rst_press\|por_run + **RESET_IN — регистр reset_q** (INIT=0, снятие чистым фронтом) + гейт S_T2 с !rst_press; POR бит-в-бит v3.9.4. Норм-путь бит-в-бит v3.9.5: дифсим `tb_v396_rst.v` — 600 циклов, 62 400 выборок 5 нс, 0 расхождений; сбросовые сценарии ВСЕ ПАСС (POR ≥840 нс у обоих; кнопка — латентность 398 нс, чистый старт, запись ОЗУ после; глитчи 100/250 нс НЕ сбрасывают — НОВОЕ свойство; дребезг 8 экскурсий на тихой и враждебной шине — финал чистый у обоих; сброс посреди /WE — v3.9.5 обрывает мгновенно, v3.9.6 доводит 80 нс импульс до конца). **ЖДЁТ ФИТА владельца — ДО УСПЕШНОГО ФИТА НЕ ШИТЬ**. Дополнение 11-6bis (фактура «проводничок на ногу CPU тоже не помогает»): застревание сведено к аналоговой лотерее включения — M1 «clk мёртв (LTC6905)»/M3 «RST=1»; делитель опровергнут исчерпывающим перебором (tb_poweron, 256 комбинаций, ВСЕ ПАСС), жалоба воспроизведена в симуляции точно (P2), контраст «v3.9.2 стабилен» не в RTL (пор-путь бит-в-бит у 3.9.2–3.9.5); чек-лист D1–D4 на плате — различить M1/M3 | прогноз фита: **85-87/108 МЦ, 220-230 ПТ, 165-172 вх.ФБ, 57 рег** (+7: rst_meta/rst_sync/rst_press/rst_qcnt<2:0>/reset_q; у v3.9.5 было 79/217/163/50, свободно 29 МЦ). Чек-лист 3d: литерал RST только в 1 ФБ синхронизатора; reset_q Init=RESET без PRE (CPU держится с t=0); GSR опционален |
| **v3.9.7** | 2026-11-06: **ВОЗВРАТ КОЛЬЦЕВОГО ДЕЛИТЕЛЯ** (п.22 шапки; директива владельца: «возвращаем в дизайн 3.9.7 делитель на основе кольцевого сдвигового регистра»; продолжение исследования застревания 3.9.3–3.9.6). Машина состояний g_div2p5: двоичный mod-7 `cnt[2:0]` → **кольцо one-hot r0..r6** (v3.9/v3.9.1 — единственная конфигурация узла тактирования, устойчиво работавшая в поле у обоих экземпляров; двойной kill: любой из 128 кодов power-up → one-hot за ≤2 фронта — на RTL v3.9.7 доказано tb_poweron_v397 P0a, 4096 комбинаций). ВСЁ ОСТАЛЬНОЕ БЕЗ ПРАВОК: строб por_ce = x1_n и por_sh[3:0] (М1, п.19) сохранены — POR бит-в-бит v3.9.4-3.9.6; GSR (п.18/20) и хардренинг RST (п.21) не тронуты; x1_n set r3/clear r4 — те же фазы, что cnt==3/4. Выходы бит-в-бит v3.9.6: дифсим `tb_v397_diff.v` — POR+600 циклов+кнопка+дребезг, 69 044 выборки 5 нс, 0 расхождений; X1 ровно 140 нс, X2=~X1 всегда. Критерий полевого эксперимента: лотерея сохранится — она ЗА ПРЕДЕЛАМИ делителя (чек-лист D1–D4 остаётся главным инструментом); исчезнет — у стохастики была цифровая компонента анатомии фита узла. **ЖДЁТ ФИТА владельца** | прогноз фита: **~88-90/108 МЦ** (узел 4→8 триггеров, +4), ПТ ~215-230 (ядра X1/X2 4→2 ПТ, kill-литералы), вх.ФБ ~165-175; логика шины/сброса бит-в-бит v3.9.6. Чек-лист: в узле декодов равенства БЫТЬ НЕ ДОЛЖНО (появились — собран исходник v3.9.2-3.9.6!), r0..r6 с двойным kill, cnt в нетлисте отсутствует |
| **v3.9.8** | 2026-11-06: **УЗЕЛ ТАКТИРОВАНИЯ НА 50 МГц** (п.23 шапки; схема владельца, сообщение 11-6bis-2: «почему ты держишься за 25МГц входной частоты на CPLD, берем делитель /2 и делаем все гораздо проще» + код кольца N=7 на 50 МГц). Вход CPLD 50 МГц (перемычка H1 БЕЗ шунта: DIV=÷2 генератора U7; штатное /4 давало 25). Кольцо r0..r6 (п.22) БЕЗ ИЗМЕНЕНИЙ тактируется 50 МГц (период 140 нс); **x1_n и весь negedge-домен УДАЛЕНЫ** — вторая кромка теперь даётся самим clk 50: X1 = r0 (фронт строго каждые 140 нс = 7,143 МГц, duty 1/7: high 20 / low 120 нс), X2 = r1|r2|r3|r4|r5|r6 = ~r0 в легальном one-hot (6-ПТ OR **без** инверсии регистра — прецедент v3.4); внутренний /2 ВМ85А → CLK = 3,571 МГц duty 50% — **частота CPU НЕ изменилась**. Логика (rst/TX/FSM/порты) — на clk25 = ÷2-триггер clk25_q (XC95108-15 FSM на 50 МГц не закроет; /WE 80 нс, квалификатор 320 нс — бит-в-бит v3.9.7). por-цепь в 50-домене: por_sh[7:0] (8×140 = 1120 нс — номинал v3.9.4-3.9.7), строб por_ce = r0 (ровно 1 за период 140 нс, «раз в 140 нс» владельца; r1|r6 на кольце 50 дало бы 2 строба/период, а сэмпл стробов тактом clk25 — фазовая лотерея: при нечётной фазе стробы НЕ ВИДНЫ ВОВСЕ). Верификация: дифсим tb_v398_diff — **69 044 выборки 5 нс, 0 расхождений** на всех выходах логики (por_run, RESET_IN, кромки кнопки — на тех же кромках, что v3.9.7); XP: X1 ровно 140 нс у обоих, duty 100/40 → 20/120; tb_poweron_v398: P0a 2560 комбинаций (128 кодов кольца × 10 por_sh × 2 фазы clk25) — one-hot ≤2 фронтов, дрейн ≤1600 нс, P1 сид-в-сид эталону v3.9.7 (те же 3/100 хвостовых /WE — принятый класс окна), P2–P5 ПАСС. **ФИТ владельца ПРОШЁЛ — аудит «фит золотой»**: 94/108 МЦ (87%), 287/540 ПТ, 183–185/216 вх.ФБ, 65 рег, 72/81 ноги; сравнение IL 16 vs IL 28 — байт-в-байт (IL вычеркнут из влияющих факторов, остаёмся на 28). **ЖЕЛЕЗО: стабильно, зависаний нет — БАЗОВЫЙ КАНДИДАТ ЛИНИИ** (перемычка H1 — без шунта) | прогноз фита: **~92-94/108 МЦ** (+clk25_q, por_sh 4→8 бит, −x1_n = +4), ПТ ~225-240 (X2 — 6 ПТ), вх.ФБ ~170-180; ГЛАВНАЯ ТОЧКА АУДИТА: сеть clk25 — на глобальной тактовой (прецедент: complement of clk → GCK2 в фите v3.9.5) |

Откат всегда тривиален: в hdl/ стоит релиз, на плате — .jed фита v3.9.3
11-2 9:54PM (известен хороший, железо проверено); дальний откат — .jed
v3.9 10-29 8:45PM.

## v3.9.8-clear ред.2 (11-7): чистка комментариев + ВЫЧЕРКИВАНИЕ мёртвого кода

Директива владельца 11-7 («много исторического мусора в комментариях [v3.9.8]…
оставить только те комментарии, которые представляют настоящие решения в
аппаратуре, дизайн назвать v398_clear») → **ред.1**: создан
`top_suart_por6_v398_clear.v` (+ `_utf8`) — код бит-в-бит v3.9.8, шапка
937 → 313 строк (вся история — дословно в `../DEVLOG.md`), legacy-ветки
делителя оставлены для отката.

Директива владельца 11-7 после фита ред.1 («ты плохо почистил 398_clear,
например там остались неиспользуемые сигналы» — Xst:1780 по x2_q, x2_p,
x1_q, x1_p, x1_n, t0_q, cnt — «кроме того в комментариях осталась
информация о тех блоках которые уже не реализуются в этой версии дизайна,
прибери тщательно, отчет об очистке выведи») → **ред.2** (870 → 803 строки):

- **Из RTL вычеркнуты** legacy-ветки делителя `g_div2`/`g_div4`/`g_div_even`/
  `g_div_odd`, их регистры `cnt/x1_q/t0_q/x1_p/x1_n/x2_q/x2_p` и
  `localparam MEV/NMOD/NHALF`; в generate осталась **единственная ветка
  `g_div2p5`** (параметры ОБЯЗАНЫ быть (2,1)); нюанс: закрывающий `end`
  целевой ветки стоял в одной строке с `else if` — при вычёркивании веток
  он сохранён (иначе синтаксическая ошибка);
- **Из шапки вычищены** описания legacy-механики: п.17, п.23 (оговорка про
  декларацию `x1_n` «для legacy g_div_odd»), TODO 3, чек-лист h) —
  переписаны под факт «вычеркнуто из RTL»; в чек-лист g) добавлено
  ожидание «ресурсы 1-в-1 с v3.9.8»;
- Откат legacy-веток — исходник `top_suart_por6_v398.v` (не тронут).

**Почему .jed не меняется**: эти сигналы и в v3.9.8 НЕ попадали в нетлист
(XST их триммил — те самые Xst:1780), поэтому нетлист/ресурсы/тайминги
ожидаются 1-в-1 с v3.9.8: шить можно прежним .jed; формальный рефит
рекомендуется ради проверки отсутствия Xst:1780 в логе синтеза и сверки
.rpt с эталоном v3.9.8 (чек-лист g)). В ISE вместо v398 ставится clear
(Set as Top Module).

Верификация ред.2 — `scripts/clear_rev2.py` (без аргументов — верификация,
`apply` — пересборка из ред.1; старый генератор `scripts/gen_v398_clear.py`
выведен из действия и передаёт управление туда же):

- тело clear == тело v3.9.8 + ТОЛЬКО 9 документированных правок (поблочная
  сверка с базой);
- в коде без комментариев нет ни одного из вычеркнутых идентификаторов
  (cnt/x1_q/x1_p/x1_n/x2_q/x2_p/t0_q/MEV/NMOD/NHALF);
- единственная ветка generate `g_div2p5`, закрыта `end`; CP1251
  round-trip; `_utf8`-двойник байт-в-байт; хвост — `endmodule` без
  завершающего `\n`, как у базы;
- **tb_poweron_v398 (Icarus 12.0) на ред.2: полный лог равен логу ред.1**
  `scripts/tb_poweron_v398_clear.log` (единственное различие — формат пути
  tb в строке `$finish`); RESULT-строки сид-в-сид эталону `tb_poweron_v398.log`
  (P0a 2560 комбинаций PASS, P0b PASS, P2–P5 PASS, P1 — те же 3/100
  принятого класса окна).

**РЕФИТ 11-7 10:09PM (IL 28) — ВЕРДИКТ «1-В-1 ЗОЛОТОМУ v3.9.8», ЖЕЛЕЗО
РАБОТАЕТ** (аудит 11-8, `scripts/fit_diff_v398clear.py`; .rpt
заархивирован как `retro_pcld_top (v398clear-fit1-1107-1009PM).rpt`,
эталон — `retro_pcld_top (v398-fit1-1106-719PM).rpt`, золотой IL 16):
дифф — ЕДИНСТВЕННОЕ различие = строка опции Input Limit (16 → 28;
IL 28 — директива п.25 «остаться на IL 28», золотые IL 16/28 уже сверены
между собой); с золотым прогоном IL 28 различий нет вовсе (кроме строки
Date). Ресурсы 94/108 МЦ, 287/540 ПТ, 183/216 вх.ФБ, 65 рег, 72/81 ноги —
прогноз чек-листа g) сошёлся (вычеркивание мёртвого кода .rpt не
изменило); PGND = {P74,P75,P76,P78,P79,P81,P95,P96,P98}; точки шапки —
кольцо r0..r6 в FB6, X2 NOR-форма 1 ПТ/6 вх, clk25_q 1 триггер, por_sh
8 бит Init=FF, сброс п.21, GSR fallback, WARNING:Cpld:897 (D<7>) —
известный класс; cnt/x1_q/x1_p/x1_n/x2_q/x2_p/t0_q в нетлисте НЕТ.
`.jed` = золотому v3.9.8. Слово владельца: «Отчет по 398_clear смотри,
железо - работает!» — петля ред.2 ЗАКРЫТА (аудит — новый п.26 шапки,
TODO 3 выполнен).

Ред.1 (для истории): генератор `scripts/gen_v398_clear.py` — тело дословно,
код без комментариев байт-в-байт; исправлено устаревшее «2048 комбинаций»
P0a → фактические 2560 (128 колец × 10 por_sh × 2 фазы — по TB и логу).

## Решение владельца по подтяжкам CS1/READY (фиксация, clk10-64)

Соединение CE2 ОЗУ (P99 → CS1) и READY (P87 → CPU) — **внутри CPLD
дизайном, БЕЗ пайки**. Вариант «внешние подтяжки резисторами + свободные
МЦ» отклонён. Проверено по фиту v3.9 10-29 8:45PM (retro_pcld_top (v39).rpt):

- `CS1` — **FB2_3, нога 99: 0 ПТ, 0 входов ФБ** (`CS1 <= '1'` в Equations);
- `READY` — **FB4_5, нога 87: 0 ПТ, 0 входов ФБ** (`READY <= '1'`).

Итого дизайн-внутреннее соединение стоит **ровно 2 МЦ** — и это самые
дешёвые МЦ дизайна (ни одного птерма, ни одного входа ФБ, логики нет).
В v3.9.2 и дальше CS1/READY остаются константами '1' в RTL без изменений.

## Принципы линии lowsize

1. Частота CPU, тайминги шины (T = 280 нс, /WE 80 нс, t_AS 40 нс), POR
   (1120 нс, запас 1,33x) и терминал 6857 8N1 — НЕИЗМЕННЫ. Меняется только
   реализация.
2. Каждая версия — полный комплект: RTL CP1251 (+UTF8-копия), генератор
   из предыдущей версии, симуляция эквивалентности/узла, шапка с чек-листом
   фита, обновление этого README.
3. Верификация ДО фита: дифсимуляция двух RTL (новый vs предыдущий) на
   общем стимуле — расхождение выходов 0; для узла тактирования — ещё и
   побитовая эквивалентность X1/X2/por старой реализации.
4. Фит владельца в ISE → .rpt на аудит → только потом .jed.

## v3.9.2 (clk10-65, 2026-10-30): кольцо one-hot N=7 → двоичный счётчик mod-7

Первая версия линии lowsize после базы v3.9.1. Мотивация по фиту v3.9
(10-29 8:45PM): 88/108 МЦ, входы ФБ 202/216, узел тактирования = 8
триггеров (r0..r6 + x1_n). Кольцо в v3.8 выбрали ради входной ренты
(декоды равенства ели входы двух ФБ), но МЦ-бюджет оно платит сполна:
7 триггеров состояния. Двоичный mod-7 хранит то же состояние в 3:

- `cnt[2:0]`: двоичный 0..6, wrap по декоду cnt==6, INIT=000; нелегальное
  111 недостижимо, при внешнем попадании восстанавливается за 1 фронт
  (7+1 = переполнение 3 бит → 000);
- фаза X1 — **комбинационная**: `X1 = (cnt != 0) ^ x1_n` — точный
  эквивалент `(~r0) ^ x1_n` кольца (состояние k кольца <=> cnt==k,
  включая INIT r0=1 <=> cnt=0); узор «1111100» (100/40 нс), X2 = `~X1`
  точно, фронты ровно 140 нс, CLK CPU 280 нс 50/50 — **бит-в-бит v3.9**;
- `x1_n`: set cnt==3 / clear cnt==4 (NEGEDGE) — те же фазы, что r3/r4
  кольца, импульс 40 нс;
- `por_ce = (cnt==1) | (cnt==6)` — те же состояния, что r1|r6: интервалы
  200/80 нс, POR = 1120 нс бит-в-бит v3.9 (пара {0,1} дала бы POR 2240 нс
  — забраковано по требованию эквивалентности).

Цена: декоды равенства вернулись в узел (класс п.9 — фиттер трижды терял
полярность декодов в фятах 10-22); теперь они 3-битные и дешёвые,
чек-лист h) в шапке RTL требует сверку уравнений по таблице истинности.
Ядра X1/X2 выросли 2 → 4 ПТ. Экономия: **−4 МЦ** (8 → 4 триггера узла;
прогноз 88 → 84/108, 85 если фиттер выделит por_ce в хелпер-МЦ).

Верификация (обе ступени ПАСС, до фита):
1. **Дифсимуляция двух RTL** (scripts/tb_v392_diff.v + run_tb_v392.sh,
   Icarus Verilog 12.0): v3.9.1 (эталон) и v3.9.2 в одном тестбенче,
   общий стимул, сравнение всех 18 выходов/шин каждые 5 нс: направленные
   сценарии (POR, шина чтения/записи/writeback, порты, клавиатура, TX
   v3.7, ALE-глюки, cpu_rst в каждой фазе) + рандом 4 сида = 10 595
   циклов, 4078 импульсов /WE: **0 расхождений**, логи виртуальных ОЗУ
   идентичны 4077/4077, спеков 0 (/WE ровно 80 нс, t_AS ≥ 40 нс).
2. **Узловая симуляция** (scripts/sim_v392_div7.py): точная семантика
   RTL, счётчик против модели кольца: 15/15 ПАСС — бит-в-бит X1/X2/
   por_ce/por_run на 200 мкс; узор «1111100»; rising/falling фронты
   ровно через 140 нс; duty-интервалы 100/40 нс; por_ce {10,4} полутакта
   (200/80), среднее ровно 140 нс; POR 1140 нс ≥ нормы 840 (запас
   1,33x); перебор 8 состояний cnt (111 → 000 за 1 фронт, узор ==
   кольцу); регрессия эталона — 128 состояний кольца → one-hot за
   ≤ 3 posedge.

## v3.9.3 (2026-11-02): сброс логики → сеть GSR

Директива владельца после разбора «проблемы сброса» по трём фита́м линии
(v3.9 / v3.9.1 / v3.9.2): мера по сбросу направлена на снижение размера
прошивки — отрабатывать её по линии lowsize, в более новой прошивке.

Что было (v3.9 → v3.9.2, Task 25): пин RST (SW20) физически стоит на
выводе I/O/GSR (P1), но **сеть GSR не использовалась** — все три .rpt
фиксируют «Global set/reset net(s) unused», «GSR : 0». Сброс был
**синхронным через D-gating**: `cpu_rst = RST | por_run` входил
литералами в D-функции всех триггеров логики. Цена по фита́м:

| Фит | вх. ФБ | литералы сброса | защиты NOT RST / NOT por_run / OR (RST) |
|-----|---|---|---|
| v3.9 (10-29) | 202/216 | RST+por_run во всех 6 ФБ = 12 (5,9%) | 57 / 42 / 2 |
| v3.9.1 (10-30) | 186/216 | те же 12 (6,5%) | без изменений |
| v3.9.2 (10-30) | 180/216 | те же 12 (6,7%) | 70 / 55 / 3 |

Что стало (п.18 шапки RTL):

- триггеры логики (state, rd_seen, wr_seen, addr_latch, bus_reg, seg_q,
  dig_q, snd_q, kbcol_q) описаны **асинхронно** (`posedge clk or
  posedge RST, if (RST)`) → фиттер сводит общий асинхронный сброс на
  **сеть GSR**: минус ~2 входа в большинстве ФБ (прогноз 180 → ~168-172),
  минус литералы сброса в D-функциях (ПТ 209 → ~190-205);
- **вне домена GSR** (бит-в-бит v3.9.2): делитель cnt/x1_n (X1 не
  глушится, фаза CLKOUT не прыгает), por_sh/por_run (POR только по
  питанию, INIT=FF/1), sod_q, tx_pass/tx_q (async SR по cpu_rst —
  cpu_rst держит tx_pass=0 весь POR: враждебный SOD в окне POR не
  «захватывает» TX), `RESET_IN = ~(RST \| por_run)` — без изменений;
- **защита окна POR**: FSM в окне por_run=1 живой (GSR не активен), а
  шина CPU в сбросе «floated» (ВМ85А: управления/адрес/данные в 3-м
  состоянии) → вход в writeback гейтится (`!por_run` в S_T2) — /WE в
  окне POR невозможен по построению;
- поведение: сброс логики стал асинхронным (фиксация значений в момент
  нажатия, снятие в момент отпускания; v3.9.2 — на такт позже);
  нормальные циклы бит-в-бит v3.9.2.

Верификация (обе ступени ПАСС, до фита):
1. **Дифсимуляция двух RTL** (scripts/tb_v393_diff.v + run_tb_v393.sh,
   Icarus 12.0): v3.9.2 (эталон) vs v3.9.3, общий стимул, все выходы/шины
   каждые 5 нс; НОВОЕ: окно асинхронного сброса (±45 нс вокруг кнопки —
   ожидаемое свойство меры), **враждебные «плавания» шины в окне POR**
   (имитация floated-линий ВМ85А, 27 тактов), spec «/WE никогда не низок
   при RESET_IN=0» для обеих версий, записи-«тени» (аборты /WE в окне
   300 нс после RST) в логах ОЗУ помечаются и пропускаются. Итог: 10 595
   циклов, 4078 /WE, 476 случайных сбросов (17 в окне /WE), 674 ALE-глюка:
   **0 расхождений, 0 спеков, не-тени логов идентичны**.
2. **Узловая симуляция** (scripts/sim_v393_gsr.py): 9/9 ПАСС — POR 1140 нс
   (норма 840, запас 1,33x) в обеих моделях; узор X1 «1111100» и
   интервалы por_ce {80,200} бит-в-бит v3.9.2; гейт POR: 3000 прогонов
   случайных «плаваний» — 0 входов в WB в окне por_run у v3.9.3 (гейт) и
   у v3.9.2 (заморозка); норм-путь: 0 расхождений траекторий на 7500
   тактов; сброс посреди WB: v3.9.3 консервативнее (никаких «лишних»
   записей); пост-сбросные состояния побитно равны; RESET_IN: взвод
   мгновенный (обе), снятие ≤ 40 нс.

### Фиты владельца 11-2: фит 1 7:54PM — аудит ПАСС; фит 2 9:54PM — ПРОШИТ, ЖЕЛЕЗО РАБОТАЕТ

RTL один и тот же (`top_suart_por6_v393.v`), анатомия сброса в обоих
фита́х идентична (38 через GSR, литералы в термах 1+2); отличается
только упаковка. rpt заархивированы: `retro_pcld_top (v393).rpt`
(7:54PM), `retro_pcld_top (v393-fit2-1102-954PM).rpt` (9:54PM — прошит).

| Показатель | v3.9 | v3.10 | v3.9.2 | фит 1 (7:54PM) | **фит 2 (9:54PM, прошит)** | Прогноз п.18 |
|---|---|---|---|---|---|---|
| МЦ | 88 | 86 | 85 | 86/108 | **85/108** | ~84-85 |
| ПТ | 214 | 203 | 209 | 192/540 | **195/540** | ~190-205 |
| вх. ФБ | 202 | 192 | 180 | 173/216 | **171/216** | ~168-172 |
| триггеры | 59 | 56 | 54 | 54 | **54** | 54 без изм. |
| GSR | unused | unused | unused | **RST→GSR («GSR : 1 1»)** | **RST→GSR («GSR : 1 1»)** | used |
| литералы сброса в термах | 60+48 = 108 | 60+48 = 108 | 73+60 = 133 | **1+2 = 3** | **1+2 = 3** | ~0 |
| предупреждения | — | — | +Cpld:897 (буфер ФБ1) | штатная пара | **штатная пара** | — |

Аудит по чек-листу f)/3a) шапки — все пункты сошлись:

- «Signal 'RST' mapped onto global set/reset net GSR»; «GSR : 1 1»;
  «Global Set/Reset Optimization: ON»; пин 1 = RST (SW20), тип буфера
  GSR/I, МЦ буфера FB2_5 (0 ПТ); на GSR заведён ТОЛЬКО RST — por_run и
  por_sh не на GSR (FDCPE_por_run: порт-мэп (…,clk,'0','0') — триггер
  пор-цепи вне домена, по плану);
- 38 триггеров логики сбрасываются асинхронно через GSR:
  `FDCPE(…,clk,RST,'0')` — D<7:0>, addr_latch<7:0>, seg<7:0>, dig<3:0>,
  col<3:0>, state_FSM<3:1>, rd_seen, wr_seen, SND — ровно как в п.18;
- литералы сброса в термах: RST ×1 (RESET_IN) + por_run ×2 (RESET_IN и
  гейт `!por_run` в терме state_FSM_FFd2_D) = **3** против 133 в v3.9.2
  (RST×73 + por_run×60) — цена сброса упала в ~44 раза; уравнение
  `RESET_IN <= (NOT RST AND NOT por_run)` сохранено;
- tx_pass/tx_q — async SR по cpu_rst (не через GSR), делитель
  cnt/x1_n/por_sh и sod_q — без GSR: вне домена по плану;
- ресурсы (фит 1): 86/108 МЦ, 192/540 ПТ, 173/216 вх. ФБ, 54 регистра,
  72 ноги — лучшие значения всей линейки одновременно (v3.9: 88/214/202;
  v3.10: 86/203/192; v3.9.2: 85/209/180). МЦ +1 к v3.9.2 — вся прибавка
  в ФБ2 (15→16, его ПТ при этом упали 48→32); относительно v3.9 (88)
  разгрузился исчерпанный ФБ4 (18/18\* → 14), ФБ1 −1, ФБ5 −1, ФБ2 +4 —
  загрузка по ФБ выровнялась. Детальный расклад по ФБ — в разделе ниже.

**Фит 2 (9:54PM) — тот же RTL, та же анатомия сброса, упаковка другая:**

- **85/108 МЦ, 195/540 ПТ, 171/216 вх. ФБ, 54 триггера** — рекорд линии
  по входам ФБ, МЦ = минимуму линии (85, как v3.9.2); исчерпанных ФБ НЕТ
  (худшие ФБ1 и ФБ3 — по 35/36; в v3.9.2 ФБ3 был 36/36\*);
- строб por_ce вернулся в паттерн v3.9.2: **2 выделенных МЦ-хелпера**
  `$OpTx$FX_DC$449/$452` (по 2 ПТ, FB4_17/18) кормят por_sh_D(0..7) —
  в фите 1 хелперов было 9 ($288…$301, $432/$433) на 86 МЦ, здесь 7
  ($133…$137, $449/$452) на 85 МЦ;
- предупреждения ЧИЩЕ v3.9.2: штатная пара (iSE-репозиторий + INFO BUFG
  по P29) — WARNING Cpld:897 «буферизация ФБ1» УШЁЛ (в v3.9.2 был);
- глобальные сети: GCK3 = clk, **GCK2 = дополнение clk** (x1_n на NOT
  clk — обе глобальные тактовые сети работают), GSR = RST, «GCK : 1 1»,
  «GSR : 1 1», «Global Set/Reset Optimization: ON»;
- **ПРОШИТ В ЖЕЛЕЗО 11-2 и РАБОТАЕТ** (владелец) — .jed фита 9:54PM
  теперь известен хороший для отката.

**Железо 11-2: работоспособность подтверждена владельцем** — плата
прошита .jed фита 2 (9:54PM) и работает. Мера п.18 закрыта по всем
трём уровням: фит/аудит + симуляции + железо. Класс-риск GSR
(метастабильность снятия кнопки асинхронно к 25 МГц) самозатухающий
(FSM в S_IDLE, гейт стоит) — на плате не проявился.

### Рекорды ресурсов 11-2: расклад по ФБ, v3.9.3 против предшественников

Сводка закоммиченных скриптов (`scripts/fit_survey.py`,
`scripts/fit_literals.py`) по архивным отчётам линейки; XC95108XL =
108 МЦ / 540 ПТ / 216 вх. ФБ / 81 нога. Формат ячейки: МЦ / вх. ФБ / ПТ;
звёздочка — упирание в потолок (36/36 вх. или 18/18 МЦ).

| ФБ | v3.9 | v3.10 | v3.9.2 | фит 1 (7:54PM) | фит 2 (прошит) |
|----|---|---|---|---|---|
| FB1 | 13 / 36\* / 38 | 13 / 36\* / 38 | 12 / 35 / 37 | 12 / 35 / 39 | 12 / 35 / 39 |
| FB2 | 12 / 31 / 35 | 12 / 31 / 35 | 15 / 31 / 48 | 16 / 29 / 32 | 16 / 29 / 31 |
| FB3 | 12 / 36\* / 33 | 12 / 36\* / 33 | 12 / 36\* / 33 | 12 / 35 / 33 | 12 / 35 / 33 |
| FB4 | 18/18\* / 29 / 42 | 17 / 24 / 35 | 14 / 18 / 21 | 14 / 22 / 20 | 13 / 16 / 19 |
| FB5 | 17 / 34 / 37 | 16 / 31 / 35 | 16 / 31 / 36 | 16 / 30 / 34 | 16 / 29 / 39 |
| FB6 | 16 / 36\* / 29 | 16 / 34 / 27 | 16 / 29 / 34 | 16 / 22 / 34 | 16 / 27 / 34 |
| **Σ** | **88 / 202 / 214** | **86 / 192 / 203** | **85 / 180 / 209** | **86 / 173 / 192** | **85 / 171 / 195** |

Достижения линии (у обоих фитов 11-2, у прошитого фита 2 — с запасом):

1. **Два минимума линейки ОДНОВРЕМЕННО** — ПТ (192/195 против 203…214 у
   предшественников) и вх. ФБ (173/171 против 180…202); раньше приходилось
   выбирать (v3.9.2 имел 85 МЦ, но 209 ПТ). Прошитый фит 2 добавляет и
   минимум по МЦ (85, паритет v3.9.2) — все три ключевых ресурса в
   рекордном или равнорекордном значении одним фитом.
2. **Потолок вх. ФБ снят по всей матрице**: в v3.9 вплотную к 36/36\*
   стояли три ФБ (ФБ1, ФБ3, ФБ6), в v3.9.2 — ФБ3; в v3.9.3 потолка не
   касается никто (худшие ФБ1/ФБ3 — 35/36). ФБ6 опустился 36 → 22 (фит 1)
   / 27 (фит 2), ФБ4 — с 29 у v3.9 до 16 (фит 2).
3. **Причина выигрыша одна на оба ресурса**: GSR убрал 130 литералов
   сброса из термов (133 → 3) — разгрузились сразу и продукты (ПТ), и
   фан-ин (вх. ФБ); на карте ФБ это видно как −7…−14 вх. в ФБ4/ФБ6.
4. **Выравнивание загрузки**: исчерпанный в v3.9 ФБ4 (18/18\*)
   разгрузился до 13–14 МЦ; +1 МЦ к v3.9.2 у фита 1 целиком сидит в ФБ2
   (15→16, его ПТ при этом упали 48 → 32); фит 2 вернул паритет 85.
5. **Запас под следующие шаги** (прошитый фит 2): 23 МЦ, 345 ПТ,
   45 вх. ФБ свободно — в т.ч. ресурс под txclient v6, где перенос
   GSR-схемы должен снять ~300 литералов cpu_rst.

Следствие для txclient: в проваленном фите v5 cpu_rst схлопнут фиттером
в RST×151 + por_run×155 (306 вхождений) — перенос GSR-схемы v3.9.3 в
v6 (RST→GSR, cpu_rst только для сериализатора) — кандидат в решающие
меры для прохождения фита v6.

Примечание об альтернативе «por_sh 8→4» (Plan B txclient): при por_ce
~140 нс POR вышел бы 560 нс < нормы 840 нс — нелегально без переделки
строба сдвига; GSR-мера дешевле и таймингов CPU не трогает. Переделка
строба выполнена в v3.9.4 (М1: por_ce = x1_n, 1 строб/период) — см.
раздел v3.9.4 ниже.

## v3.9.4 (2026-11-05): М1 — POR-счётчик 8→4 со стробом x1_n

Мотивация: линия hwuart (полноценный полудуплексный UART-трансивер,
`beta/hwuart`) не фитится — стена входов ФБ 213/216 (99%) при потребности
109/108 МЦ (фиты 1-3 от 11-4, разбор в `beta/hwuart/README.md`). М1 —
мера №1 плана и та же, что опустила потребность txclient v8 с 114 до
103 МЦ. Одобрена владельцем («Делаем Б» 11-5): сначала база v3.9.4
(этот файл) + фит, затем те же 3 строки в базовую часть hwuart (v4.0.1).

Кодовая дельта — 3 строки (генератор `scripts/gen_v394.py`, якоря и
контролы неизменности норм-пути внутри):

- `reg [7:0] por_sh = 8'hFF` → **`reg [3:0] por_sh = 4'hF`**;
- строб `por_ce = (cnt==1)|(cnt==6)` → **`por_ce = x1_n`** (импульс
  40 нс в [140,180) каждого периода cnt 280 нс — ровно ОДИН posedge за
  период ПО ПОСТРОЕНИЮ; декодов равенства в POR-пути больше НЕТ);
- сдвиг `{1'b0, por_sh[7:1]}` → `{1'b0, por_sh[3:1]}`.

Логика шины, делитель (cnt/x1_n/X1/X2), UART-транзиты (v3.7) и GSR-сброс
(п.18) — БЕЗ ПРАВОК. Пор-цепь вне домена GSR — как было (INIT=F/1).

Тайминг: POR = 4 × 280 = **1120 нс ≥ нормы 840 нс** (3 такта CLK OUT),
запас ×1,33 (в v3.9.2/v3.9.3: 8 × ~140 = 1120-1140 нс). Возражение
примечания выше («560 нс < 840») считало СТАРЫЙ строб 2/период — со
стробом 1/период мера легальна (снято в txclient v8, «Делай M1» 11-3).

Верификация (11-5, прогнана в сессии): дифсимуляция v3.9.3 vs v3.9.4 —
`scripts/tb_v394_diff.v` + `run_tb_v394.sh` (Icarus 12.0): 10 595
случайных циклов + все направленные сценарии (порты 00-03h, KBROW,
ALE-глюки 1/2 тика, RST посреди WB и в T2, враждебные «плавания» шины
в окне POR) — **0 расхождений выходов/шин, 0 spec-нарушений, логи
виртуального ОЗУ идентичны** (4077 записей, тени 50 = 50); RST-окна
сравнивались СТРОГО (поведение GSR идентично); окно сравнения закрыто
только на время POR — момент снятия por_run и есть ожидаемое отличие
меры. **T0** (иерархические ссылки dut394.por_sh/por_run): INIT F/1,
ровно 4 сдвига F→7→3→1→0 (стробы x1_n каждые 280 нс), por_run падает на
1020 нс при фазе clk тб (≥ 840 нс), повторного POR нет (500 тактов).
Код-дифф DUT = ровно 3 строки М1 (печатается run-скриптом).

Сравнение фитов линии (для владельца, «насколько далось снижение»):

| Показатель | v3.9.1 (10-30) | v3.9.2 (10-30) | v3.9.3 (11-2, прошит) | v3.9.4 прогноз | v3.9.4 фит |
|---|---|---|---|---|---|
| МЦ | 88/108 | 85/108 | 85/108 | **79-81/108** | **82/108** |
| ПТ | 205/540 | 209/540 | 195/540 | **~170-180/540** | **182/540** |
| вх. ФБ | 186/216 | 180/216 | 171/216 | **~164-168/216** | **168/216** |
| триггеры | 58 | 54 | 54 | **50** | **50** |

Откуда прогноз: −4 МЦ (por_sh<7:4>) и −2 МЦ (хелперы декода por_ce
$OpTx$FX_DC$449/452 — декодов больше нет); ПТ: T-цепи 4ПТ/5лит →
2ПТ/3лит (por_sh<3> — 1ПТ/2вх, в сдвиг входит '0'); вх.ФБ: из ФБ с
T-цепями уходят cnt<0..2> (строб больше не декодируется), x1_n уже
импортирован.

Чек-лист .rpt (TODO 3b шапки RTL): por_sh<3:0> ровно 4 триггера (FTCPE),
por_sh<7:4> В НЕТЛИСТЕ НЕТ; T-цепи 2ПТ/3вх (por_sh<3> 1ПТ/2вх);
декодов cnt<0..2> в POR-цепи НЕТ; por_run.D = por_sh[0], Init=SET;
триггеров 50. **ОПЦИИ ФИТА — как у v3.9.1-3.9.3: Input Limit 28,
Pterm Limit 18, Exhaustive OFF** (режим честного сравнения; лимит 16 —
разовый рецепт тесного hwuart, здесь НЕ нужен). ЕСЛИ por_sh 8 бит
вернулся — собран старый исходник, .rpt на разбор.

### Фит 1 v3.9.4 (11-4 10:15PM) — SUCCESSFUL: аудит ПАСС, рекорды линии, оговорка по опциям

Отчёт заархивирован: `retro_pcld_top (v394-fit1-1104-1015PM).rpt`. Опции
прогона (хвост .rpt): **Input Limit 16**, Pterm Limit 18, Exhaustive OFF,
Global Set/Reset Optimization ON. У референсов v3.9.1/3.9.2/3.9.3 —
Input Limit 28 (см. оговорку ниже).

Итог: **82/108 МЦ (76%), 182/540 ПТ (34%), 168/216 вх. ФБ (78%), 50
триггеров, 72/81 ноги** — все четыре метрики лучше v3.9.3 (85/195/171/54);
исчерпанных ФБ нет (худшие FB1/FB3 по 35/36 вх., свободно 48 вх.ФБ);
предупреждения — штатная пара (iSE-репозиторий + INFO BUFG по P29),
0 ERROR, Cpld:897 нет. Заметнее всего пор-зона: FB4 13 → 10 МЦ (там были
пор-хелперы $449/$452), FB6 вх.ФБ 27 → 21 (там были por_sh<7:4>).

Чек-лист TODO 3b — сошёлся весь (по `scripts/fit_diff_v394.py` +
fit_survey/fit_literals):

- por_sh<3:0> — ровно 4 регистра, por_sh<7:4> в нетлисте НЕТ; все
  Init=SET, вне GSR (порт-мэпы `(...,clk,'0','0')`) — по плану;
- строб: por_sh_D(0..2) = x1_n ? сдвиг : hold (2ПТ/3вх), por_sh_D(3) =
  NOT x1_n AND por_sh(3) (1ПТ/2вх) — по ПТ/входам ровно прогноз; в lowsize
  это FDCPE D-мьюксы, а не FTCPE T-цепи (формулировка чек-листа переписана
  с txclient v8 — там действительно FTCPE с XOR-T-цепями);
- декодов cnt<0..2> в POR-цепи НЕТ: пор-хелперы $OpTx$FX_DC$449/$452
  (cnt==1|cnt==6) исчезли; все 6 оставшихся $OpTx — шинные декоды
  (state_FSM + ALE/IOM/WRn/addr_latch), как в v3.9.3;
- por_run.D = por_sh[0], Init=SET; триггеров 50;
- GSR-анатомия бит-в-бит v3.9.3 (обоих фитов): RST → GSR, CLR=RST 38,
  RST 39 = 38 порт-мэпов + 1 терм (RESET_IN), por_run 3 = 1 порт-мэп +
  2 терма; X1/X2/cnt/GCK2/GCK3, SID <= RX, ноги — бит-в-бит базы.

Сравнение с прогнозом (задача владельца «насколько далось снижение»):

| Показатель | прогноз | факт (фит 1) | вердикт |
|---|---|---|---|
| МЦ | 79-81/108 | **82/108** | промах +1 к верхней границе |
| ПТ | ~170-180/540 | **182/540** | промах +2 |
| вх. ФБ | ~164-168/216 | **168/216** | сошлось (верхняя граница) |
| триггеры | 50 | **50** | точно |

Разбор дельты МЦ 85 → 82 (поимённый диф buried/хелперов): −4 por_sh<7:4>
и −2 пор-декода $449/$452 (сама М1) = −6, плюс +3 упаковочных узла,
которых прогноз не учитывал: **BUF_x1_n** (4ПТ/4вх) и **X2_cmp_eq0000_D2**
(1ПТ/3вх) — в v3.9.3 фиттер растворял их в x1_n (2ПТ/4вх) и хелпер $133,
здесь вынес отдельными МЦ; и **$123** — вынесенный из wr_seen декод T2
(wr_seen 5ПТ/8вх → 3ПТ/9вх). Нетто −6 + 3 = **−3**.

Разбор дельты ПТ 195 → 182 (−13, сходится поимённо до нуля): −7
(por_sh<7:4>) − 1 (por_sh<3>) − 2 (wr_seen) − 1 (x1_n) − 4 (пор-декоды
$449/$452) + 1 ($123) + 5 (BUF_x1_n/X2_cmp) − 4 (X1/X2: по 4ПТ → 2ПТ) =
−13.

Почему прогноз по МЦ/ПТ чуть не сошёлся: (1) ПТ-прогноз «T-цепи 4ПТ/5лит
→ 2ПТ/3лит» переписан с txclient v8, где por_sh — FTCPE с XOR-T-цепями; в
lowsize пор-цепь и в v3.9.3 была D-мьюксами по 2ПТ/4вх — худеть было
нечему, кроме por_sh<3>, отсюда −13 вместо −15..−25; (2) три упаковочных
узла — нормальная вариативность упаковки ±1..3 МЦ (в v3.9.3 между фитами
1 и 2 было то же: 86 ↔ 85).

Оговорка по опциям: владелец сфитчил с Input Limit 16 (осталось от фита 3
hwuart), референсы — с 28, поэтому сравнение РЕЖИМОВ не чистое. Но:
(а) М1 в нетлисте точная — сравнение РЕШЕНИЙ корректно; (б) итог всё
равно лучше v3.9.3 по всем метрикам. Опционально для канонической строки
таблицы: рефит с IL 28 (упаковочные узлы по 3-4 входа легко растворяются;
ожидание 80-81 МЦ, ~178-180 ПТ). Текущий .jed уже годится в прошивку —
чекпоинт маршрута Б.

Следствие для маршрута Б: база v3.9.4 = 82 МЦ / 168 вх.ФБ / 50 рег —
легче v3.9.3 на 3 МЦ / 3 вх.ФБ / 4 рег; прогноз потребности hwuart v4.0.1
улучшается на те же ~3 МЦ / ~3 вх.ФБ (в фита́х v4.0.0 было 109 МЦ /
213 вх.ФБ → ожидание ~105-106 / ~209-210) + довесок KEEP io_wr_tx при
остаточной стене входов.

## v3.9.5 (2026-11-05): GSR-источник = cpu_rst — исправление дефекта старта v3.9.3/v3.9.4

Жалоба владельца (11-5): «после включения питания плата запускается очень
нестабильно, не может запуститься по сбросу, передёргивание питания
рано или поздно помогает; если запустилась — работает как часы; на плате
товарища не запускается вовсе; при этом v3.9.2 запускается очень
стабильно». Дельта-фактор обеих дефектных версий против стабильной
v3.9.2 — ОДИН: мера GSR (п.18, v3.9.3); v3.9.4 = v3.9.3 + М1 (por-цепь
бит-в-бит, не при чём).

**Механизм дефекта.** В v3.9.2 блок логики держался `cpu_rst = RST |
por_run` КАЖДЫЙ такт всего POR — FSM прикована к IDLE, флаги и шинные
регистры в нулях, любой мусор вытирается каждым фронтом. В v3.9.3
условие сброса стало RST (только кнопка) — **FSM ЖИВЁТ в окне POR
(~1 мкс)**, а шина CPU в сбросе «floated» (ВМ85А 3-стирует
управления/адрес/данные; уровни плавающих линий дрейфуют вместе с
растром питания). FSM срисовывает плавающие ALE/RDn/WRn/IOM/A15:
бродит по T1H/T2, пачкает rd_seen/wr_seen/addr_latch/bus_reg и ПОРТЫ
(seg_q/dig_q/kbcol_q/snd_q пишутся «записями» с плавающей шины), и
встречает CPU на выходе из сброса ГРЯЗНОЙ. Класс-эффекты на старте:
rd_drive=1 → контеншн CPLD против '573 на A-сетях; мусорные декоды
портов. Кнопка сброса не спасает (снятие GSR снова оставляет FSM на
плавающей шине), передёргивание питания перебрасывает «лотерею»
порогов плавающих линий — отсюда «рано или поздно запускается» и
разброс по платам. Гейт `!por_run` (добавлен в v3.9.3) закрыл только
заход в writeback — и держит его честно (WE_n=0 в POR: 0 нарушений),
но весь остальной блуд он не закрывает.

**Доказательство (fuzz-тест, `scripts/tb_por_fuzz.v` +
`run_tb_por_fuzz.sh`, Icarus 12.0, 100 сидов)** — модель «плавающей»
шины: случайные переключения ALE/RDn/WRn/IOM/A15/A/D каждые 10 нс
в окне POR + 200 нс хвост («лотерея порогов» по сидам):

| Метрика | v3.9.2 | v3.9.4 (дефект) | v3.9.5 (фикс) |
|---|---|---|---|
| грязь в момент снятия por_run | **0/100** | **100/100** | **0/100** |
| rd_drive в окне POR (тактов с контеншном A) | 0 | 86 | 0 |
| WE_n=0 в окне POR (нарушение gate) | 0 | 0 | 0 |
| «грязь на старте CPU» (+200 нс хвост) | 84/100 | 100/100 | 94/100 |

Хвост (+200 нс после снятия por_run) — общий для ВСЕХ линий (cpu_rst
снят и в v3.9.2: 84/100!) и в поле не убивает старт (v3.9.2 стабильна:
первый реальный цикл CPU вымывает свежий мусор); смерть старта — это
входить в хвост ГРЯЗНОЙ и ГЛУБОКО (порты/шины, накопленные за весь
POR), чем v3.9.3/v3.9.4 и отличаются.

**Фикс (мера п.20):** `always @(posedge clk or posedge cpu_rst) begin
if (cpu_rst) ...` — условие v3.9.2 на асинхронной структуре v3.9.3.
GSR-сеть теперь запускается от узла cpu_rst (RST|por_run): в окне POR
логика прикована АСИНХРОННО с t=0 (por_run INIT=1 → GSR=1 ещё до
первого фронта), кнопка — прежняя (RST=1 → GSR=1), POR-цепь/делитель/
sod_q — по-прежнему ВНЕ GSR (por_run сам себя сбрасывать не должен),
гейт `!por_run` в S_T2 остаётся вторым рубежом, tx_pass/tx_q (async SR
по cpu_rst) — без правок. Дельта RTL — 2 слова (генератор
`scripts/gen_v395.py` контролирует её автоматически).

Верификация фикса: (1) fuzz — таблица выше, v3.9.5 = 0/100 грязи,
0 контеншна; (2) дифсим v3.9.4 vs v3.9.5 (`scripts/tb_v395_diff.v` +
`run_tb_v395.sh`): **10 595 циклов, 0 расхождений выходов/шин, 0
spec-нарушений, логи ОЗУ идентичны (4077/тени 50=50), RST-окна
строгие** (поведение сброса у обеих идентично: при por_run=0 условие
cpu_rst ≡ RST); окно сравнения закрыто до конца блока враждебных
«плаваний» (1200 нс, ресинхронизация) — в «плаваниях» траектории
ЗАКОННО расходятся (v3.9.4 входит с «стартовым преимуществом»
бродяжничества, v3.9.5 — чистым из IDLE): это и есть тот мусор,
который убирает фикс, свойство меры, не дефект; T0 POR: 4 сдвига,
≥840 нс, повторного POR нет. (3) RTL-дельта = ровно 2 строки
(контроль в gen_v395.py), round-trip CP1251.

Экономика (прогноз фита): источник GSR = узел cpu_rst вместо ноги RST
напрямую — +1 ПТ (OR) в ФБ гейта RESET_IN (RST и por_run уже
импортированы туда), вх.ФБ +0..2; ожидание ~82-84/108 МЦ, ~180-190
ПТ, ~168-172 вх.ФБ. ЕСЛИ фиттер не сведёт узел на GSR (fallback —
PT-сбросы на каждом триггере) — функционально корректно, дороже по
ПТ/вх (анатомия v3.9.2: ~12 вх.ФБ импортов) — .rpt на разбор в обоих
случаях. **Следствие для линий-наследников: тот же класс дефекта
живёт в beta/hwuart (v4.0.0/v4.0.1 — та же GSR-мера в базе) и
beta/txclient (v7/v8) — в hwuart нужен v4.0.2 с теми же 2 строками;
.jed v4.0.1 не шить даже после успешного фита.**

### Фит 1 v3.9.5 (11-5 10:40PM) — SUCCESSFUL: аудит ПАСС с одним отклонением — GSR не свёлся, fallback дешёвый (40 PTC-сбросов)

**Ресурсы: 79/108 МЦ (73%), 217/540 ПТ (40%), 163/216 вх.ФБ (75%), 50 триггеров, 72/81 ног.**
0 ERROR; предупреждения штатные (WARNING о пути iSE-репозитория — безвредное; INFO о
BUFG-infer для clk по LOC P29 — известная рекомендация объявить BUFG явно; INFO:994 —
строка прогона). GCK бит-в-бит v3.9.4: clk→GCK3, !clk→GCK2; FASTConnect/GCK/GSR-оптимизации
ON, DENSITY, Keep LOC ON (ноги = UCF, clk P29, RST P1 — GSR-нога как обычный вход, легально).

**Оговорка по опциям: Exhaustive Fitting = ON при заданном OFF** (IL 16/Pterm 18 соблюдены;
у v3.9.4 fit1 — OFF). Отступление, вероятно, и помогло упаковке — рекорд МЦ линии 79 (см.
ниже). Для чистоты родословной возможен рефит с OFF, но ресурсного смысла нет — .jed валиден.

**Сверка с прогнозом:** МЦ 79 vs 82-84 — ЛУЧШЕ на 3; вх.ФБ 163 vs 168-172 — ЛУЧШЕ на 5;
ПТ 217 vs 180-190 — ХУЖЕ на 27 (цена fallback, см. ниже); рег 50 — точно; ноги 72 — точно.

**Чек-лист TODO 3c:**
- **п.1 (GSR-источник = узел cpu_rst) — НЕ СОШЛОСЬ:** «Global set/reset net(s) unused» —
  фиттер не свёл узел на GSR, сработал предсказанный fallback. Разбор показал ДЕШЁВЫЙ
  вариант — НЕ синхронные сбросы в D-функциях (анатомия v3.9.2: ~12 вх.ФБ + 81 терм), а
  асинхронные **PTC-сбросы**: 40 триггеров получили CLR/PRE = NOT RESET_IN по продуктовому
  терму своей макроячейки (1 ПТ/триггер). Гейт `RESET_IN <= NOT por_run AND NOT RST`
  (1 ПТ, FB4 — RST/por_run локальны) — это cpu_rst в инверсии (De Morgan:
  NOT(por_run|RST) = NOT por_run AND NOT RST); RESET_IN импортирован в 5 ФБ (FB1/2/3/5/6,
  +1 вх.ФБ каждый). Свойство v3.9.2 «чистка с t=0» в железе СОХРАНЕНО: por_run
  INIT=SET=1 → RESET_IN=0 → CLR=1 у всех 40 триггеров до первого фронта, асинхронно, без
  тактов. Состав 40: D×8, addr_latch×8, seg×8, dig×4, col×4, SND, TX (PRE — TX=1 в сбросе,
  корректно для UART), state_FSM×3, rd_seen, wr_seen, tx_pass; вне сброса, как и задумано:
  por_run+por_sh<3:0>, cnt<2:0>, x1_n, sod_q (10 шт, все Init по месту: por-цепь SET).
- **п.2 (D-функции без литералов сброса) — СОШЛОСЬ:** скан уравнений
  (`scripts/fit_diff_v395.py`): RST/RESET_IN/cpu_rst в правых частях — только в гейте
  RESET_IN; por_run — 3 вхождения, все функциональные, бит-в-бит v3.9.4 (гейт п.18 в
  state_FSM_FFd2_D + гейт RESET_IN); ни одного сбросового литерала в D-мьюксах — сброс
  живёт только на CLR/PRE-пинах.
- **п.3 (por-цепь вне GSR, Init=SET) — СОШЛОСЬ:** por_sh<3:0> и por_run — Init=SET
  (таблица Reg Init), порт-мэпы `FDCPE(...,clk,'0','0')` без CLR/PRE, уравнения М1
  бит-в-бит v3.9.4 (4 бита, строб x1_n, 4 сдвига F→7→3→1→0).

**Бухгалтерия ПТ +35 (182→217), сходится до нуля** (`scripts/fit_diff_v395.py`):
**+38** PTC-сбросы (38 триггеров переведены с GSR-сети на индивидуальные PTC: было 2 PTC +
38 GSR, стало 40 PTC; поимённо addr_latch×8 2→3, D×8/seg×8/dig×4/col×4/SND 2→3 — сумма
выходов 111→136, state_FSM_FFd1/2/3 +1, rd_seen 6→7, wr_seen +1; tx_pass/TX — уже были
PTC в v3.9.4, это и есть те 2 старых PTC, не изменились) — **−7**
растворение 4 упаковочных хелперов (BUF_x1_n 4ПТ/4вх, X2_cmp_eq0000_D2 1ПТ/3вх,
io_rd_kb_D2 1ПТ/4вх, rd_drive_D2 1ПТ/6вх — функции легли в существующие узлы) — **+2**
возврат декода T2 внутрь wr_seen ($123 растворился: 3ПТ/9вх → 6ПТ/9вх) — **+1** T-мьюкс
x1_n вернулся на место (1ПТ/1вх → 2ПТ/4вх, BUF_x1_n ушёл) — **+1** сдвиг состава $-хелперов
(6→7 шт., 7→8 ПТ: $38/$42 против $124+$123-семейства). Итого 38−7+2+1+1 = +35 ✓.

**МЦ −3 (82→79, рекорд линии):** buried без $ 31→27 (ушли 4 хелпера-узла, новых нет) при
$-хелперах 6→7; семейство x1_n/X1/X2 сжалось 10ПТ/5МЦ → 6ПТ/3МЦ. Вклад Exhaustive ON
вероятен (сравнение опций с v3.9.4 не чистое — оговорка выше).

**вх.ФБ −5 (168→163):** +5 импортов RESET_IN перекрыты −11 вх.ФБ в FB4 (ушли узлы
io_rd_kb_D2 и соседи: 10 МЦ/20 вх → 7 МЦ/9 вх). По ФБ: FB1 35→36 (**СТЕНКА 36/36\*** —
впервые в линии), FB2 28→31, FB3 35→35, FB4 20→9, FB5 29→30, FB6 21→22.

**Стены на будущее:** FB1 вх.ФБ исчерпан (36/36\*), FB3 35/36, МЦ-полнота FB2/FB5/FB6
(16/18). Свободно 29 МЦ (FB1 6, FB3 6, FB4 11) и 53 вх.ФБ (FB4 27, FB6 14, FB5 6, FB2 5,
FB3 1) — окна ≥8 вх.ФБ только в FB4/FB6. Для lowsize не блокер (версия замораживается в
.jed). Для наследников: в hwuart-линии сбросы УЖЕ PTC-based (GSR unused во всех фятах
v4.0.0/v4.0.1), так что расширение источника до cpu_rst для v4.0.2 почти бесплатно
(+0..2 вх.ФБ, +1 ПТ) и стену bit_cnt не двигает.

**Вердикт: .jed v3.9.5 ГОДЕН К ПРОШИВКЕ** — фит успешен, чек-лист закрыт (отклонение п.1
разобрано: функционально эквивалентно, свойство «чистка с t=0» подтверждено уравнениями),
ресурсы с запасом (ПТ 40%, МЦ 73%). Шить, тест-прошивки rom/, затем железная проверка
старта (питание ×N, кнопка) на обеих платах.

## v3.9.6 (2026-11-06): хардренинг цепи сброса — RST только через регистры, RESET_IN — регистр

### Жалоба владельца 11-6 и разбор

Прошиты ОБА фита v3.9.5 (Exhaustive Fitting = ON и = OFF) — эффект одинаковый:
**«только по питанию можно привести комплекс в порядок: просто сброс не может
восстановить работоспособность, пока она не восстановится по питанию»**. Старт по
питанию при этом работает (дефект старта v3.9.3/v3.9.4 закрыт п.20) — сломано
именно ВОССТАНОВЛЕНИЕ по кнопке.

Разбор (модель `scripts/sim_v395_rst_float.py`, лог `sim_v395_rst_float.log`) построил
поведенческую модель v3.9.5 (сверена с .rpt и RTL: POR 4 сдвига/1020 нс, mod-7, узор
X1 — всё сошлось) и прогнала сценарии сброса:

| Сценарий (20 сидов) | BOOT_OK | ложные /WE | контеншн A/AD |
|---|---|---|---|
| питание (POR) — эталон | 19/20 | 0/20 | 0/20 |
| кнопка, быстрый фронт (плата с идеальной цепью RST) | 19/20 | 0/20 | 0/20 |
| кнопка, плавающий спад ~10 мкс, CPU отпускается раньше | **7/20** | 9/20 | 9/20 |
| кнопка, плавающий спад, CPU отпускается позже | 17/20 | 1/20 | 2/20 |
| плавающий спад + хардренинг RTL (будущий v3.9.6) | 18/20 | **0/20** | **0/20** |

Развёртка по времени спада (сценарий C): 0 мкс → 28/30; 2 мкс → 13/30; 10 мкс → 10/30 —
деградация растёт с временем фронта. Первоначальный вывод «п.1 — в цепи RST нет
подтяжки вниз, линия висит в воздухе» владелец СНЯЛ: **резистор стоит на месте давно,
ничего не висит** (Task 25 закрыт по железу). Что остаётся вне зависимости от цепи:

**В фите v3.9.5 сырой пин RST входит в кристалл напрямую** — гейт
RESET_IN <= NOT por_run AND NOT RST (нога CPU) и все 40 PTC-сбросов CLR/PRE = NOT
RESET_IN питаются от КОМБИНАЦИИ с пином. Любое неидеальность фронта SW20 — дребезг
контакта на отпускании (у механики — миллисекунды), мид-рейл, помеха — без фильтра
доходит до сбросовых входов всех триггеров и до CPU: моменты фактического отпускания
размазываются на время фронта, часть ячеек встречает снятие сброса в непонятном
состоянии (пороги входов CLR у ячеек разных ФБ не совпадают, снятие у CPU и у логики
разнесено). Питание обходит RST целиком (por_run INIT=1 держит сброс с t=0 и снимает
регистровым фронтом) — потому «только по питанию».

### Мера п.21: RST входит в кристалл ТОЛЬКО через регистры

1. **2FF-синхронизатор** `rst_meta/rst_sync` (вне сброса, INIT=0): сырой пин больше
   не касается ни PTC-сбросов, ни RESET_IN; метастабильность гасится до использования.
2. **Квалификатор** `rst_qcnt<2:0>/rst_press`: переворот на 8-м такте ПОДРЯД
   устойчивого `rst_sync != rst_press` (двусторонний — и взвод, и снятие). Дребезг/
   глитч короче ~280 нс не виден ВОВСЕ; длиннее — полноценный повторный сброс:
   каждый взвод заново чистит все 40 триггеров, поэтому ПОСЛЕДНЕЕ снятие всегда
   из held-чистого состояния регистровым фронтом.
3. **cpu_rst = rst_press \| por_run** — в цепи сброса не осталось ни одной
   комбинации от пинов.
4. **RESET_IN — регистр `reset_q`** (INIT=0: CPU в сбросе с t=0 до всякого клока —
   как от INIT=SET por_run в v3.9.5; вне сброса): снятие сброса CPU ВСЕГДА чистым
   фронтом, моменты отпускания CPU и логики совпадают до скоха одной сети.
5. **Гейт S_T2**: `!por_run` → `!por_run && !rst_press` (рубеж п.18/20 распространён
   на окна кнопочного сброса).
6. Семантика /WE: начатый импульс (80 нс) квалификатор (400 нс) НЕ успевает оборвать —
   запись доводится до конца (полный t_WP ОЗУ — даже безопаснее обрыва), сброс гасит
   драйвы сразу после (п.21f).

**Новые свойства**: глитч на RST короче ~280 нс сброс НЕ вызывает (v3.9.5 вызывал
любой — это и есть класс уязвимости «восстановление лотереей порогов»); латентность
кнопки 400..440 нс на взвод/снятие (кнопка живёт в миллисекундах); POR бит-в-бит
v3.9.4, низ RESET_IN по питанию 1020 → до 1160 нс (норма 840, запас ×1,35).
**Цена**: +7 триггеров (57), прогноз 85-87 МЦ / 220-230 ПТ / 165-172 вх.ФБ (у v3.9.5
было 79/217/163/50; свободно 29 МЦ — влезает с запасом).

### Верификация (tb_v396_rst.v, Icarus 12.0 — ВСЕ ПАСС)

| Тест | Результат |
|---|---|
| T0 POR у обоих | низ RESET_IN 1020/1060 нс ≥ 840 нс нормы |
| EQ норм-путь: 600 случайных циклов, сравнение каждые 5 нс | 62 400 выборок, **0 расхождений** — бит-в-бит v3.9.5 |
| S1 чистая кнопка | взвод/снятие через 398 нс (11 тиков), только на кромке clk; все 40 рег чисты; запись ОЗУ после — OK |
| S3 глитчи 100/250 нс | v3.9.6 НЕ сбрасывается (и состояние не дрогнуло); v3.9.5 на тот же глитч сбрасывается мгновенно (контраст мер) |
| S2 дребезг 8 экскурсий (тихая шина) | /WE не звенел у обоих; финал чистый; запись после — OK |
| S2h тот же дребезг на враждебной шине | финал чистый у ОБОИХ (вымывание финальным пересбросом) |
| S4 сброс посреди /WE | v3.9.5 обрывает мгновенно; v3.9.6 доводит импульс (80 нс) и вступает после; чисто; запись после — OK |
| REG регистровость RESET_IN | **0** смен вне кромок clk за весь прогон (у v3.9.5 — 42: комбинация от RST) |

### Что делать владельцу

1. Фит в ISE: `top_suart_por6_v396.v` (CP1251) + UCF БЕЗ ИЗМЕНЕНИЙ, опции как у
   v3.9.5 (Input Limit 16, Pterm 18, Exhaustive OFF; фактический ON при заданном OFF
   не приговор — прецедент v3.9.5).
2. .rpt НА АУДИТ (чек-лист 3d шапки): литерал RST — только во входах ФБ rst_meta
   (1 ФБ); reset_q = FDCPE(clk,'0','0') без PRE (Init=RESET — CPU держится с t=0;
   сверять как у por-цепи — прецедент 2565246); гейт S_T2 с !rst_press; D-функции
   логики по-прежнему без литералов сброса; GSR опционален.
3. .jed → железо. **ГЛАВНЫЙ ТЕСТ — кнопка сброса в работающую плату ×N** (тот самый
   сценарий жалобы 11-6), плюс питание ×N на обеих платах, тест-прошивки rom/.
4. Если v3.9.6 НЕ вылечит восстановление по кнопке — остаток НЕ в CPLD: следующая
   точка — периферия комплекса, не сбрасываемая кнопкой (только питанием), и питание
   под сбросом; диагностика — осциллограф на RESET_IN (P84) в момент нажатия:
   низ должен держаться нажатие + ~0,5 мкс, подъём — один чистый фронт.
5. **Наследникам: НЕ «2 слова v4.0.2», а полная мера п.21** — жалоба 11-6 показала,
   что расширения GSR-источника до cpu_rst (v3.9.5) недостаточно: сырой RST всё
   равно доходит до сбросовых входов. hwuart v4.0.2 (база v4.0.1) — та же связка
   синхронизатор+квалификатор+регистровый RESET_IN (~+7 рег, +6-8 МЦ); txclient v9 —
   при возвращении к линии.

### Дополнение 11-6bis: новая фактура владельца — «проводничок на ногу CPU тоже не помогает»; застревание сведено к аналоговой лотерее включения

Новая фактура (после разбора п.21): «включаю плату — на дисплее 8.8.8.8, кнопка
сброса много раз — нуль; беру проводничок и ресетную ногу процессора БЕЗ участия
CPLD — никаких изменений; включение-выключение питания СЛУЧАЙНЫМ образом возвращает
работоспособность, после чего сброс работает штатно». Гипотеза владельца: «делитель
на сдвиговом регистре входит в недопустимую ситуацию, решаемую только подачей
напряжения». Задание: сверка 3.9.2↔3.9.3 и 3.9.4↔3.9.5 + придумать симуляцию
стохастического процесса включения.

**Ключевые шаги сведения** (все проверены по RTL v3.9.5 и .rpt фита):

1. **«8.8.8.8» — штатный паттерн СБРОСА, не мусор**: INIT/reset кладёт
   `seg_q=8'hFF, dig_q=4'hF` («INIT «8888.» на индикаторе», строка 1081 RTL); в
   фите выходные регистры seg/dig инвертированы, PTC-сброс `CLR=NOT RESET_IN`
   держит НА ПИНАХ нули — при общем аноде горят все сегменты и все разряды.
   Горящий 8.8.8.8 ⇔ RESET_IN=0 (CPU и логика в сбросе) — «залип» не в дисплее,
   а в цепи сброса.
2. **Держать RESET_IN=0 может только двое**: гейт `RESET_IN <= NOT por_run AND
   NOT RST` (.rpt v395-fit1, 1 ПТ, FB4_3) — значит либо `por_run=1` вечно, либо
   `RST=1` вечно. Других входов у гейта нет.
3. **«Недопустимая ситуация в делителе» ИСЧЕРПЫВАЮЩЕ ОПРОВЕРГНУТА**
   (`tb_poweron.v`, P0a/P0b, Icarus 12.0 — ПАСС): делитель с v3.9.2 — ДВОИЧНЫЙ
   счётчик mod-7 (кольцо-сдвиговый регистр удалено ещё там; все 8 состояний на
   орбите, 111 самовосстанавливается за 1 фронт); POR-цепь (единственный
   сдвиговый регистр в узле) — `por_sh` дрейнит в 0000 из ЛЮБОГО из 16 кодов за
   ≤1600 нс и навсегда (256 комбинаций cnt×por_sh×x1_n; `por_run` после дрейна
   0 навсегда — пути SET нет); из достижимых в железе состояний (орбита INIT=F:
   F,7,3,1,0) снятие монотонное. **При живом clk пор-цепь освобождает сброс
   ВСЕГДА — застрять в цифре нечему.**
4. **Кнопка и проводничок в мёртвом состоянии бесполезны ПО ПОСТРОЕНИЮ**:
   при `por_run=1` гейт `NOT(por_run OR RST)` = 0 при ЛЮБОМ RST (P2: 5 нажатий
   с отпусканиями — нуль эффекта); ручное утверждение сброса на cpu36 — no-op
   (CPU уже в сбросе), а при мёртвом clk CPU не исполняет НИЧЕГО даже без
   сброса (X1 статичен — P2). **P2 = точное воспроизведение полного
   симтом-комплекса жалобы.**
5. **Сверки (задание владельца)**: дифф 3.9.2→3.9.3 = сброс ЛОГИКИ
   sync→async GSR + гейт `!por_run` в S_T2; дифф 3.9.4→3.9.5 = источник GSR
   расширен RST→cpu_rst. **Путь «кто держит CPU в сбросе» (гейт RESET_IN +
   пор-цепь) бит-в-бит одинаков у ВСЕХ ЧЕТЫРЁХ версий** — наблюдаемый контраст
   «v3.9.2 стабилен, v3.9.3–v3.9.5 лотерея» НЕ объясняется RTL: либо у v3.9.2
   лотерея просто не выпадала (другая выборка включений), либо с той поры дрейф
   железа (LTC6905/H1/питание).
6. **Классы включений и подписи** (`sim_poweron_stoch.py`, R1): M1 «clk мёртв»
   (LTC6905 не стартовал — кремниевые RC-осцилляторы умеют не стартовать на
   медленном растре) — СОВПАДАЕТ С ЖАЛОБОЙ ТОЧНО (X1 статичен, кнопка/проводник
   нуль, лечится только передёргиванием, Монте-Карло даёт геометрию «рано или
   поздно»); M2 «clk поздний» — плата «дозревает» сама, чего в жалобе НЕТ ⇒ в
   плохих сессиях clk не приходит ВООБЩЕ; M3 «RST=1 вне кнопки» — X1 жив, но
   ОТПУСКАНИЕ кнопки оживляет мгновенно (P4), чего в жалобе тоже НЕТ ⇒ M3
   вычеркивается, если отпускание доходит до U1.1 (проверка D2/D4).

**Чек-лист диагностики на плате (плохая сессия, 2–5 минут, различает M1/M3)**:

| # | Действие | Результат → вывод |
|---|---|---|
| D1 | Осциллограф/частотомер на **X1 (U1.68, cpu21)** в плохой сессии | статика (0) → **M1: clk мёртв** — смотреть clk U1.29, U7 LTC6905, перемычку H1; 7,14 МГц есть → M1 снят, идти D2 |
| D2 | Мультиметр **U1.1 (RST)** при открытой SW20 | ~0 В = норм; единица/мида → цепь RST (M3) → D4; заодно снять противоречие SCHEMATIC.md 514 ЗАМЕРОМ в плохой сессии |
| D3 | Проводничком через 1 кОм подать **+5 на cpu36** (принудительно отпустить сброс CPU) | дисплей ожил → держал CPLD-сброс при живом X1 → вопрос к RST-цепи (D2); не ожил → **CPU без X1 — M1 подтверждён** |
| D4 | В плохой сессии замкнуть **U1.1 на GND через 100 Ом** на 2 с | ожила → RST-цепь держит единицу (M3: SW20/R2 — вскрыть, промерить покой/нажатие на U1.1); нет → M1 |

**Отношение к v3.9.6**: мера п.21 НЕ трогает ни гейт RESET_IN↔por_run, ни
пор-цепь — класс M1 (и M3) она лечить не должна и не будет; это НЕ ошибка
v3.9.6 — она лечит другую болезнь (размазанное отпускание кнопки, ложные /WE на
фронте). Шить v3.9.6 можно; но чек-лист D1–D4 стоит пройти В НЕЗАВИСИМОСТИ от
фита — его результат определяет, где искать остаток (кристалл+питание
LTC6905/H1 vs цепь SW20/R2), и он же объяснит, почему «v3.9.2 стабилен».

Файлы: `scripts/sim_poweron_stoch.py` + `.log` (модель, решётка M1–M4,
Монте-Карло, эквивалентность версий), `scripts/tb_poweron.v` +
`run_tb_poweron.sh` + `sim_poweron_stoch_tb.log` (P0a/P0b/P1/P2/P3/P4/P5 —
ВСЕ ПАСС на реальном RTL v3.9.5).

## v3.9.7 (2026-11-06): возврат кольцевого делителя + Дополнение 11-7 (кросс-версионная матрица tb_poweron)

**Директива владельца**: «возвращаем в дизайн 3.9.7 делитель на основе
кольцевого сдвигового регистра» + «продолжай исследовать старые дизайны
3.9.3–3.9.6 на непонятную проблему со сбросом».

### Мера п.22 — кольцо one-hot r0..r6 вместо двоичного mod-7

Мотив: застревание сведено к аналоговой лотерее включения (дополнение
11-6bis), гипотеза «недопустимой ситуации делителя» опровергнута
перебором — НО единственной конфигурацией узла тактирования, дававшей в
поле стабильные сессии, остаётся кольцо (v3.9/v3.9.1: «отлично всё
работает» 10-29 у обоих экземпляров; счётчик v3.9.2-3.9.6 стабилен был
только по выборке владельца). v3.9.7 — полевой эксперимент с ОДНОЙ
переменной: возвращена ТОЛЬКО машина состояний делителя; строб
por_ce = x1_n и por_sh[3:0] (М1, п.19) сохранены (строб кольца v3.9.1
r1\|r6 с por_sh 8 бит НЕ возвращается — иначе в эксперименте две
переменные); GSR/хардренинг/TX/автомат — без правок.

**Код-дифф** (контроль генератора, 20 позитивных + 13 негативных
проверок): +7 регистров r0..r6 (двойной kill `r_i <= r_{i-1} & ~r_i &
~r_{i+1} & ~r_{i+2}`, рестарт из 00 по NOR7), x1_n set r3/clear r4
(вместо cnt==3/cnt==4 — те же фазы), X1 = (~r0)^x1_n, X2 = r0^x1_n
(вместо декодов cnt). Пор-цепь, логика шины, сброс — бит-в-бит v3.9.6.

**Эквивалентность выходов** (`scripts/tb_v397_diff.v` +
`run_tb_v397.sh`, Icarus 12.0; эталон v3.9.6, сравнение СТРОГОЕ с t=0 —
INIT кольца r0=1 эквивалентен cnt=000):

| Сценарий | Результат |
|---|---|
| T0 POR + EQ 600 случайных циклов шины (+ иерархический por_run) | 69 044 выборки каждые 5 нс — **0 расхождений**, бит-в-бит |
| XP узор X1 / X2 | период ровно 140 нс; X2 == ~X1 в каждой выборке у обоих |
| S1 чистая кнопка | взвод/снятие 398 нс на ОДНОЙ кромке у обоих; логика чистая; запись ОЗУ A=21 D=5A на /WE у обоих |
| S2 дребезг (тихая шина) | /WE не звенит у обоих (0/0), финал чистый |
| S2h дребезг на враждебной шине | финал чистый у обоих, поведение одинаковое (0 расхождений в EQ) |

**Отказоустойчивость кольца к стохастике включения**
(`scripts/tb_poweron_v397.v` + `run_tb_poweron_v397.sh`, RTL v3.9.7):

| Фаза | Что доказано | Результат |
|---|---|---|
| P0a | перебор 128 кодов кольца × 16 por_sh × 2 x1_n = 4096: one-hot за ≤2 фронта ИЗ ЛЮБОГО кода + дрейн por_run ≤1600 нс навсегда | **ПАСС** — «недопустимая ситуация» от случайного power-up кода невозможна |
| P0b | орбита пор-цепи F→7→3→1→0, монотонное снятие | ПАСС (пор-цепь бит-в-бит v3.9.4-3.9.6) |
| P1 | 100 сидов: плавающая шина в POR + 1 мкс после старта CPU | /WE в хвосте 200 нс — 3/100 (эталон v3.9.5 без окна: 1/100 — один класс, окно не дискриминатор); грязь 40-нс окна в 57/100 сидов самозаживляется: 85 с 1-го цикла + 15 со 2-го = **100/100** |
| P2 | мёртвый clk (LTC6905 не стартовал) | **ПАСС — точное воспроизведение жалобы 11-6bis: 8.8.8.8 горит, X1 статичен, RESET_IN=0, кнопка ×5 и проводничок — нуль эффекта** — ТАК ЖЕ, как на счётчике |
| P3 | поздний clk (30 мкс) | снятие ≤1600 нс — «дозревание» без передёргивания; в жалобе подписи НЕТ |
| P4 | RST=1 вне кнопки | оживление отпусканием с первого раза (латентность 440 нс — норма меры п.21) |
| P5 | лотерея передёргиваний (20 циклов, P(старт)=3/4) | геометрия «рано или поздно» — как в жалобе |

### Дополнение 11-7: кросс-версионная матрица tb_poweron (исследование 3.9.3–3.9.6)

ОРИГИНАЛЬНЫЙ `tb_poweron.v` (эталон, без правок) прогнан на всех старых
дизайнах (`scripts/run_tb_poweron_xver.sh`, логи
`scripts/tb_poweron_xver_*.log`):

| Фаза | v3.9.2 | v3.9.3 | v3.9.4 | v3.9.5 | v3.9.7 (кольцо) |
|---|---|---|---|---|---|
| P0a/P0b пор-цепь | ПАСС | ПАСС | ПАСС | ПАСС | ПАСС (4096 комбин.) |
| P1 чистый старт | **ПАСС** | **ПРОВАЛ 139** | **ПРОВАЛ 140** | **ПАСС** | ПАСС* (см. выше) |
| P2 мёртвый clk | ПАСС | ПАСС** | ПАСС** | ПАСС | ПАСС |
| P3 поздний clk | ПАСС | ПАСС | ПАСС | ПАСС | ПАСС |
| P4 RST=1 | ПАСС | ПАСС | ПАСС | ПАСС | ПАСС |
| P5 лотерея | ПАСС | ПАСС | ПАСС | ПАСС | ПАСС |

\* P1 у v3.9.7 прогнан в РАСШИРЕННОЙ семантике (окно 40 нс анатомии
v3.9.6+: GSR снимается на кромке N, CPU — reset_q на N+1; в
v3.9.2–3.9.5 RESET_IN снимался ВМЕСТЕ с GSR, окна не было).

\** у v3.9.3/v3.9.4 P2 фиксирует ГРЯЗЬ, ПЕРЕНЕСЁННУЮ из P1: у этих
версий в POR не было чистки (GSR только от кнопки), и грязь без клока
ЗАМОРАЖИВАЕТСЯ навсегда (seg_q/state не возвращаются) — ещё одна
демонстрация дефекта 11-5, а не свойство мёртвого клока (у свежего
включения INIT=FF дал бы 8.8.8.8 штатно).

**ВЫВОДЫ ДОПОЛНЕНИЯ 11-7**:

1. **Дефект 11-5 воспроизведён tb_poweron на 3.9.3/3.9.4** — P1 провален
   на ВСЕХ 100 сидах (грязь в момент снятия сброса: FSM живёт весь POR
   на плавающей шине). v3.9.5 (GSR от cpu_rst) и v3.9.2 (заморозка
   каждый такт) — 0/100 грязи. Картинка прежних разборов подтверждена
   независимым тестбенчем.
2. **Симуляция НЕ различает «стабильный» v3.9.2 и «лотерейные»
   3.9.3–3.9.6 по классам включения** (P2/P3/P5 идентичны у всех):
   мёртвый clk U7 LTC6905 — равновероятная угроза ЛЮБОЙ версии, включая
   v3.9.2. Полевой контраст «v3.9.2 стабилен» — НЕ в RTL (теперь
   подтверждено и поведенческими классами, не только сверкой пор-пути).
3. **Окно 40 нс анатомии v3.9.6/v3.9.7** (логика оживает на кромку
   раньше CPU): грязь в 57/100 сидов агрессивной модели полностью
   самозаживляется (100/100 за ≤2 реальных цикла, защиты ALE-abort +
   повторный захват T1H), ложных /WE не добавляет (3/100 против 1/100 у
   эталона v3.9.5 в том же расширенном хвосте — один класс). Регрессией
   НЕ считается; кандидат v3.9.8 на будущее (НЕ включён в v3.9.7, чтобы
   не смешивать переменные полевого эксперимента): `assign RESET_IN =
   ~cpu_rst` вместо регистра reset_q — CPU отпускается на ТОЙ ЖЕ кромке,
   что и логика (окно закрывается, −1 триггер; INIT por_run=1 держит CPU
   с t=0; сырой RST по-прежнему нигде — смысл п.21 сохранён).
4. Кольцо (v3.9.7) по отказоустойчивости к стохастике включения
   ЭКВИВАЛЕНТНО счётчику: оба самовосстанавливаются из любого кода
   (кольцо — за ≤2 фронта, счётчик — за 1 фронт из единственного
   нелегального 111), оба дают точный симптом-комплекс жалобы при
   мёртвом clk. **Выбор между ними в цифре нейтрален — решать полю.**

Файлы: `top_suart_por6_v397.v` (+ `_utf8`), `scripts/gen_v397.py`,
`scripts/tb_v397_diff.v` + `run_tb_v397.sh` + `tb_v397_diff.log`,
`scripts/tb_poweron_v397.v` + `run_tb_poweron_v397.sh` +
`tb_poweron_v397.log`, `scripts/tb_poweron_v395_tail.v` (контроль
эталона) + `run_tb_poweron_xver.sh` + логи `tb_poweron_xver_*.log`.

## v3.9.8 (2026-11-06): узел тактирования на 50 МГц — схема владельца

### Мера п.23 — кольцо на clk 50, X1 = r0, clk25 = /2 для логики, por-цепь в 50-домене

Схема владельца (сообщение 11-6bis-2): «почему ты держишься за 25МГц входной частоты
на CPLD, берем делитель /2 и делаем все гораздо проще» + эскиз: кольцо N=7 на 50 МГц,
`X1 = r0` (duty 1/7), `X2 = ~r0`, `por_ce = r1|r6` «раз в 140 нс». Реализация с тремя
инженерными уточнениями (все — в пользу бит-в-бит сохранения остального дизайна):

1. **Вход 50 МГц** — перемычка H1 без шунта (DIV = ÷2 генератора U7; штатное положение
   с шунтом давало 25 МГц, замер Task 29-d — 25,00 от базы ~100). Кольцо r0..r6 (п.22,
   уравнения НЕ тронуты) тактируется 50 МГц — период 140 нс. **x1_n удалён вместе со
   всем negedge-доменом**: вставка второй кромки в период кольца (весь смысл x1_n в
   v3.9–v3.9.7) больше не нужна — её даёт сам clk 50. X1 = r0: фронт строго каждые
   140 нс (7,143 МГц), duty 1/7 (high 20 / low 120 нс); внутренний /2 ВМ85А тактируется
   фронтами X1 → CLK = 3,571 МГц, duty ровно 50% — **частота CPU не изменилась**.
2. **X2 = r1|r2|r3|r4|r5|r6** (= ~r0 в каждом легальном one-hot), а не дословное `~r0`:
   6-ПТ OR **без одиночной инверсии регистра** — класс п.10/прецедент v3.4 (фиттер
   поднимал ~X1 в регистр В ФАЗЕ — X2 в фазе = нет генерации CPU). В illegal-кодах
   кольца на самоочистке (≤2 фронта при включении) X2 отличается от ~X1 — транзиент
   во время POR, схемно незначимо (в XP-контроле дифсима сравнение X2=~X1 идёт после POR).
3. **Логика остаётся на 25 МГц** (clk25 = ÷2-триггер clk25_q, INIT=0): XC95108-15 FSM/шина
   на 50 МГц не закроет, а /WE 80 нс (2 тика), квалификатор кнопки 320 нс (8 тиков) и все
   тиковые константы v3.9.2–3.9.7 обязаны остаться → вся логика переведена на clk25
   бит-в-бит (в RTL — только смена тактовой сети в 7 always-блоках).
4. **por-цепь переведена в 50-домен**: por_sh[7:0] (Init=FF), строб por_ce = r0 — РОВНО
   один строб 20 нс за период кольца 140 нс («раз в 140 нс» владельца). Почему не r1|r6
   дословно: на кольце 50 МГц r1|r6 стреляет ДВАЖДЫ за период (70 нс) — POR уполовинился
   бы; а сэмпл 20-нс стробов тактом clk25 — фазовая лотерея (при нечётной фазе clk25 стробы
   НЕ ВИДНЫ ВОВСЕ → por_run не снимается НИКОГДА). POR = 8 × 140 = 1120 нс — номинал
   v3.9.4–3.9.7 (4 × 280), запас 1,33×; дрейн 1000 нс и снятие por_run на кромке 1020 нс —
   **совпадают с v3.9.7** (дифсим: por_run и RESET_IN на тех же кромках).

### Верификация (Icarus 12.0)

- **Дифсим v3.9.7 vs v3.9.8** (`scripts/tb_v398_diff.v` + `run_tb_v398.sh`): СТРОГОЕ
  сравнение с t=0 — **69 044 выборки 5 нс, 0 расхождений** на всех выходах логики и обеих
  шинах, включая иерархический por_run и кромки RESET_IN (POR и кнопка — на тех же
  кромках, что у эталона). XP: X1 ровно 140 нс у ОБОИХ; duty 100/40 (v3.9.7) → 20/120
  (v3.9.8 — схема владельца); X2 = ~X1 после POR у обоих; clk25_q тогглится.
  Технический нюанс tb: INIT clk50=1 в Icarus даёт фантомный posedge x→1 в t=0 — гасится
  возвратом d8 в INIT-состояние на t=1 (комментарий в tb).
- **tb_poweron_v398** (`run_tb_poweron_v398.sh`): P0a — 2560 комбинаций (128 кодов кольца ×
  10 кодов por_sh × 2 фазы clk25): one-hot ≤2 фронтов из ЛЮБОГО кода, дрейн por_sh ≤1600 нс
  навсегда, por_run падает и не возвращается, clk25_q тогглится при обеих фазах — ПАСС;
  P0b орбита FF→7F→…→00 ПАСС; P1 — 100 сидов: **сид-в-сид эталону v3.9.7** (грязь окна
  57/100, вычищение 85+15=100/100, хвостовые /WE — те же сиды 74/92/96 на 160–200 нс —
  принятый класс самозаживляющегося окна дополнения 11-6/11-7); P2 мёртвый clk — точное
  воспроизведение жалобы (8.8.8.8, X1 статичен в '1' — r0 INIT=1, кнопка ×5 и проводничок
  — нуль); P3 поздний clk ПАСС; P4 RST=1 ПАСС (латентность 420 нс — анатомия п.21);
  P5 лотерея ПАСС. Итог: 3 «ошибки» = ровно эталонный класс P1 v3.9.7.

### Экономика и риски

- МЦ: +1 (clk25_q) +4 (por_sh 4→8) −1 (x1_n) = **+4 → прогноз ~92-94/108**; ПТ ~225-240
  (X2 — 6 ПТ против 2), вх.ФБ ~170-180 (X2 ест 6 колец в FB6).
- **Главный риск фита**: сеть clk25 (выход триггера) должна сесть на ГЛОБАЛЬНУЮ тактовую —
  прецедент: «complement of clk mapped onto GCK2» в фите v3.9.5; если фиттер повесит clk25
  на обычную трассировку — проверить skew/setup в .rpt (25 МГц закрывались с запасом во
  всех фятах v3.9.x).
- **Риск аналоговый**: high X1 теперь 20 нс (было min 40) — если генерация CPU не заведётся,
  откат одной строкой RTL: `X1 = r0 | r1` (high 40 нс), частоты те же.
- Если шунт H1 не переставлен — всё работает вдвое медленнее (X1 3,57 МГц, CPU 1,79 МГц) —
  это НЕ поломка.

Файлы: `top_suart_por6_v398.v` (+ `_utf8`), `scripts/gen_v398.py`,
`scripts/tb_v398_diff.v` + `run_tb_v398.sh` + `tb_v398_diff.log`,
`scripts/tb_poweron_v398.v` + `run_tb_poweron_v398.sh` + `tb_poweron_v398.log`.

## Состав

| Файл | Что это |
|---|---|
| `top_suart_por6_v391.v` | база линии v3.9.1 (clk10-62; из hiclock): CS_n в writeback от состояния FSM, защёлка wb_ram_q удалена. CP1251 |
| `top_suart_por6_v391_utf8.v` | UTF-8 копия v3.9.1 (для чтения/диффов; в ISE брать CP1251-файл) |
| `scripts/gen_v391.py` | генератор v3.9.1 из v3.9 (исторический) |
| `scripts/sim_v391_equiv.py` | формальное доказательство эквивалентности v3.9.1 == v3.9 (исторический) |
| `scripts/tb_v391_diff.v` | дифференциальный тестбенч v3.9 vs v3.9.1 (исторический) |
| `scripts/run_tb_v391.sh` | сборка/запуск дифсимуляции на Icarus 12.0 из tools/iverilog (исторический) |
| `top_suart_por6_v392.v` | **v3.9.2 (clk10-65) — кандидат lowsize**: база v3.9.1, кольцо N=7 → счётчик mod-7 (−4 МЦ), бит-в-бит v3.9. CP1251 |
| `top_suart_por6_v392_utf8.v` | UTF-8 копия v3.9.2 (для чтения/диффов; в ISE брать CP1251-файл) |
| `scripts/gen_v392.py` | генератор v3.9.2 из v3.9.1: 17 хирургических правок, контроль r0..r6 в коде, round-trip CP1251 |
| `scripts/tb_v392_diff.v` | диф-тестбенч v3.9.1 vs v3.9.2 (наследник tb_v391_diff.v, все сценарии/спеки без изменений) |
| `scripts/gen_tb_v392.py` | генератор tb_v392_diff.v из tb_v391_diff.v (однопроходная замена по токенам) |
| `scripts/run_tb_v392.sh` | сборка/запуск дифсимуляции v3.9.1 vs v3.9.2 |
| `scripts/sim_v392_div7.py` | узловая симуляция: счётчик mod-7 vs модель кольца v3.9, 15/15 ПАСС |
| `top_suart_por6_v393.v` | **v3.9.3 (2026-11-02) — принят владельцем (железо 11-2 ПАСС)**: база v3.9.2, сброс логики → сеть GSR (п.18). CP1251 |
| `top_suart_por6_v393_utf8.v` | UTF-8 копия v3.9.3 (для чтения/диффов; в ISE брать CP1251-файл) |
| `retro_pcld_top (v393).rpt` | фит владельца 11-2 7:54PM (86/192/173, GSR : 1 1) — аудит ПАСС |
| `retro_pcld_top (v393-fit2-1102-954PM).rpt` | **фит владельца 11-2 9:54PM — ПРОШИТ, ЖЕЛЕЗО РАБОТАЕТ** (85/195/171, GSR : 1 1, por_ce-хелперы $449/$452, без Cpld:897) |
| `retro_pcld_top (v394-fit1-1104-1015PM).rpt` | **фит владельца v3.9.4 11-4 10:15PM — SUCCESSFUL, аудит ПАСС** (82/182/168/50 — рекорды линии; IL 16 — оговорка в разделе v3.9.4) |
| `retro_pcld_top (v395-fit1-1105-1040PM).rpt` | **фит владельца v3.9.5 11-5 10:40PM — SUCCESSFUL, аудит ПАСС с отклонением** (79/217/163/50 — рекорд МЦ; GSR unused → fallback 40 PTC-сбросов; Exhaustive ON — оговорка в разделе v3.9.5) |
| `scripts/fit_survey.py` | сводка фит-отчётов линейки (v3.9/v3.10/v3.9.2/v3.9.3 ×2/v3.9.4/v3.9.5): дата/статус/ресурсы/флаг GSR/литералы |
| `scripts/fit_literals.py` | точный подсчёт литералов сброса в секции Mapped Logic (термы vs порт-мэпы FDCPE; воспроизводит 108/108/133/3) |
| `scripts/gen_v393.py` | генератор v3.9.3 из v3.9.2: 13 правок, контролы cpu_rst=5/GSR-конструкций/пор-цепи бит-в-бит, round-trip CP1251 |
| `scripts/tb_v393_diff.v` | диф-тестбенч v3.9.2 vs v3.9.3: + окно асинхронного сброса (cmp_hold 45 нс), враждебные «плавания» в окне POR, spec /WE-при-RESET_IN=0, записи-«тени» в логах ОЗУ |
| `scripts/gen_tb_v393.py` | генератор tb_v393_diff.v из tb_v392_diff.v (токен-проход + якорные вставки) |
| `scripts/run_tb_v393.sh` | сборка/запуск дифсимуляции v3.9.2 vs v3.9.3 |
| `scripts/sim_v393_gsr.py` | узловая симуляция семантики сброса: 9/9 ПАСС (POR/гейт/норм-путь/аборты/пост-сброс/RESET_IN) |
| `top_suart_por6_v394.v` | **v3.9.4 (2026-11-05) — текущий кандидат**: база v3.9.3, М1 — POR-счётчик 8→4 со стробом x1_n (п.19), норм-путь бит-в-бит v3.9.3. CP1251 |
| `top_suart_por6_v394_utf8.v` | UTF-8 копия v3.9.4 (для чтения/диффов; в ISE брать CP1251-файл) |
| `scripts/gen_v394.py` | генератор v3.9.4 из v3.9.3: дельта М1 (3 строки) + п.19/TODO 3b/чек-лист, контролы норм-пути бит-в-бит (X1/X2/cnt/GSR/cpu_rst=5), round-trip CP1251 |
| `scripts/make_tb_v394.py` | генератор tb_v394_diff.v из tb_v393_diff.v (переименования версий+идентификаторов, окно сравнения только POR, RST-окна строгие, вставка T0) |
| `scripts/tb_v394_diff.v` | диф-тестбенч v3.9.3 vs v3.9.4: все сценарии/спеки tb_v393 + НОВОЕ T0 — цикл-точная проверка POR-цепи v3.9.4 (INIT F/1, ровно 4 сдвига F→7→3→1→0, por_run ≥ 840 нс, повторного POR нет) |
| `scripts/run_tb_v394.sh` | сборка/запуск дифсимуляции v3.9.3 vs v3.9.4 + печать код-диффа DUT (ожидается ровно дельта М1) |
| `scripts/fit_diff_v394.py` | диф buried-узлов/выходов/хелперов v3.9.3 fit2 → v3.9.4 fit1: раскладывает дельты −3 МЦ / −13 ПТ поимённо (por_sh<7:4>, $449/$452, BUF_x1_n, X2_cmp, $123, X1/X2) |
| `scripts/fit_diff_v395.py` | диф фит-отчётов v3.9.4 fit1 → v3.9.5 fit1: сводки/опции (вкл. Exhaustive), ФБ-таблица, анатомия сброса (порт-мэпы NOT RESET_IN, литералы RST/por_run/cpu_rst, импорты RESET_IN по ФБ, GSR/GCK), скан литералов сброса в D-функциях, buried/outputs/$-хелперы, por-цепь с Init |
| `top_suart_por6_v395.v` | **v3.9.5 (2026-11-05) — текущий кандидат**: база v3.9.4, мера п.20 — GSR-источник = cpu_rst = RST\|por_run (исправление дефекта старта v3.9.3/v3.9.4), дельта 2 слова, норм-путь бит-в-бит v3.9.4. CP1251 |
| `top_suart_por6_v395_utf8.v` | UTF-8 копия v3.9.5 (для чтения/диффов/симов; в ISE брать CP1251-файл) |
| `scripts/gen_v395.py` | генератор v3.9.5 из v3.9.4: дельта п.20 (2 слова) + п.20 шапки/чек-лист 3c/TODO ред. v3.9.5, контроль дельты, round-trip CP1251 |
| `scripts/tb_v395_diff.v` | диф-тестбенч v3.9.4 vs v3.9.5: сценарии/спеки tb_v394 без изменений, окно сравнения до конца блока «плаваний» (1200 нс), RST-окна строгие, T0 POR |
| `scripts/make_tb_v395.py` | генератор tb_v395_diff.v из tb_v394_diff.v (сдвиг идентификаторов 393→394→395 + переписанная шапка + cmp_hold до 1200 нс) |
| `scripts/run_tb_v395.sh` | сборка/запуск дифсимуляции v3.9.4 vs v3.9.5 + печать код-диффа DUT (ожидаются ровно 2 строки п.20) |
| `scripts/tb_por_fuzz.v` | **фазз-тест окна POR** (доказательство дефекта/фикса): два DUT на общей «плавающей» шине (случайные переключения ALE/RDn/WRn/IOM/A15/A/D), замер грязи GSR-блока в момент снятия por_run и на «старте CPU», счётчики rd_drive/WE_n в POR |
| `scripts/run_tb_por_fuzz.sh` | фаззинг v3.9.2 vs v3.9.4 (100 сидов по умолчанию) + агрегат |
| `scripts/run_tb_por_fuzz_v395.sh` | фаззинг v3.9.2 vs v3.9.5 (контроль фикса) |
| `top_suart_por6_v396.v` | **v3.9.6 (2026-11-06) — текущий кандидат**: база v3.9.5, мера п.21 — хардренинг цепи сброса: RST только через регистры (2FF-синхронизатор + квалификатор 8 тактов), RESET_IN — регистр reset_q; POR/норм-путь бит-в-бит. CP1251 |
| `top_suart_por6_v396_utf8.v` | UTF-8 копия v3.9.6 (для чтения/диффов/симов; в ISE брать CP1251-файл) |
| `scripts/gen_v396.py` | генератор v3.9.6 из v3.9.5: 12 правок (блок сброса п.21, гейт S_T2 с !rst_press, assign RESET_IN = reset_q, п.21 шапки + чек-лист 3d + комментарий /WE + порты), 6+3 контроля дельты, round-trip CP1251 |
| `scripts/sim_v395_rst_float.py` (+ `.log`) | модель жалобы 11-6 (разбор ДО v3.9.6): поведение v3.9.5 по RTL+Init .rpt; сценарии питание/кнопка с быстрым фронтом/плавающий спад (CPU раньше/позже)/хардренинг; развёртка по спаду 0-50 мкс; вердикт «цифровая логика корректна, дефект — в неидеальности фронта RST, доходящей до PTC-сбросов и RESET_IN»; гипотеза п.1 (подтяжка) владельцем снята |
| `scripts/tb_v396_rst.v` | диф-тестбенч v3.9.5 vs v3.9.6 ПО ЦЕПИ СБРОСА: T0 POR, EQ 600 циклов (сравнение каждые 5 нс), S1 чистая кнопка (латентность 400-440 нс/чистота/запись ОЗУ), S3 глитчи 100/250 нс (не сбрасывают), S2 дребезг 8 экскурсий (тихая шина), S2h дребезг на враждебной шине (финал чистый у обоих), S4 сброс посреди /WE (семантика обрыва/доведения), REG-контроль регистровости RESET_IN |
| `scripts/run_tb_v396_rst.sh` | сборка/запуск tb_v396_rst (Icarus 12.0 из tools/iverilog) + печать код-диффа DUT (ожидается ровно блок п.21 + гейт + assign RESET_IN) |
| `scripts/sim_poweron_stoch.py` (+ `.log`) | модель стохастического включения питания (дополнение 11-6bis): решётка сценариев M1 «clk мёртв»/M2 «clk поздний»/M3 «RST=1»/M4 «эталон» с подписями на плате, Монте-Карло лотереи передёргиваний (геометрия «рано или поздно»), доказательство эквивалентности пор-пути 3.9.2–3.9.5 (сверка версий) — жалобу воспроизводит ТОЛЬКО M1 |
| `scripts/tb_poweron.v` | доказательный тестбенч на реальном RTL v3.9.5: P0a перебор 256 начальных состояний пор-цепи (дрейн por_sh в 0000 из любого кода — «недопустимой ситуации» в делителе НЕТ), P0b монотонное снятие из достижимых (F,7,3,1,0), P1 100 сидов чистого старта на плавающей шине, P2 мёртвый clk = ТОЧНОЕ воспроизведение жалобы (8.8.8.8/X1 статичен/кнопка ×5 и проводничок — нуль), P3 поздний clk (само-оживание — подписи в жалобе нет), P4 RST=1 (отпускание лечит с 1-го раза — класс вычеркнут), P5 лотерея передёргиваний |
| `scripts/run_tb_poweron.sh` (+ `sim_poweron_stoch_tb.log`) | сборка/запуск tb_poweron (Icarus 12.0 из tools/iverilog); итог: ВСЕ ПАСС, 0 ошибок |
| `top_suart_por6_v397.v` | **v3.9.7 (2026-11-06) — текущий кандидат**: база v3.9.6, мера п.22 — возврат кольцевого делителя one-hot r0..r6 (двойной kill, рестарт NOR7) вместо двоичного mod-7; пор-цепь/GSR/хардренинг бит-в-бит v3.9.6. CP1251 |
| `top_suart_por6_v397_utf8.v` | UTF-8 копия v3.9.7 (для чтения/диффов/симов; в ISE брать CP1251-файл) |
| `scripts/gen_v397.py` | генератор v3.9.7 из v3.9.6: span-замены (ветка g_div2p5, чек-листы 3/h/e/g) + п.22 шапки + TODO ред. v3.9.7; 20 позитивных + 13 негативных контролей, round-trip CP1251 |
| `scripts/tb_v397_diff.v` (+ `.log`) | диф-тестбенч v3.9.6 vs v3.9.7: СТРОГОЕ сравнение с t=0 (INIT кольца <=> cnt=000) — T0 POR, EQ 600 циклов (+иерархический por_run), XP узор X1/X2, S1 кнопка, S2/S2h дребезг; итог 69 044 выборки, 0 расхождений |
| `scripts/run_tb_v397.sh` | сборка/запуск дифсимуляции v3.9.6 vs v3.9.7 + печать код-диффа DUT (ожидается только блок делителя) |
| `scripts/tb_poweron_v397.v` (+ `.log`) | доказательный тестбенч на RTL v3.9.7 (адаптация tb_poweron под кольцо + анатомию сброса v3.9.6): P0a 4096 комбинаций (128 кодов кольца × 16 por_sh × 2 x1_n) с проверкой one-hot ≤2 фронтов, P0b-P5; итог: P1 3/100 в расширенном хвосте (эталон 1/100 — один класс), остальное ПАСС |
| `scripts/run_tb_poweron_v397.sh` | сборка/запуск tb_poweron_v397 (Icarus 12.0 из tools/iverilog) |
| `scripts/tb_poweron_v395_tail.v` (+ лог в составе xver) | контрольный вариант эталонного tb_poweron: единственная правка — P1 с хвостом 200 нс/1 мкс (базовая линия для сравнения окна v3.9.6/v3.9.7: ранних /WE 1/100) |
| `top_suart_por6_v398.v` | **v3.9.8 (2026-11-06) — текущий кандидат**: база v3.9.7, мера п.23 — узел тактирования на 50 МГц (кольцо напрямую, X1 = r0 duty 1/7, X2 = OR(r1..r6), clk25 = /2 для логики, por-цепь в 50-домене со стробом r0, x1_n удалён); логика шины/сброса бит-в-бит v3.9.7. CP1251 |
| `top_suart_por6_v398_utf8.v` | UTF-8 копия v3.9.8 (для чтения/диффов/симов; в ISE брать CP1251-файл) |
| `scripts/gen_v398.py` | генератор v3.9.8 из v3.9.7: 26 точечных + 3 span-замены (ветка g_div2p5, чек-листы 3/h) + п.23 шапки + TODO ред. v3.9.8; 28 позитивных + 14 негативных контролей, round-trip CP1251 |
| `scripts/tb_v398_diff.v` (+ `.log`) | диф-тестбенч v3.9.7 vs v3.9.8: СТРОГОЕ сравнение с t=0 — T0 POR (кромки совпадают), EQ 600 циклов = 69 044 выборки 5 нс, 0 расхождений (por_run иерархически), XP (периоды X1 140 нс у обоих, duty 100/40 → 20/120, X2=~X1 после POR, clk25_q тогглится), S1 кнопка (398 нс на тех же кромках), S2/S2h дребезг |
| `scripts/run_tb_v398.sh` | сборка/запуск дифсимуляции v3.9.7 vs v3.9.8 + печать код-диффа DUT (ожидается только узел тактирования) |
| `scripts/tb_poweron_v398.v` (+ `.log`) | доказательный тестбенч на RTL v3.9.8: P0a 2560 комбинаций (128 × 10 por_sh × 2 фазы clk25) с проверками one-hot ≤2 фронтов / дрейна / тоггла clk25_q, P0b-P5; P1 сид-в-сид эталону v3.9.7 (3/100 хвостовых /WE — принятый класс) |
| `scripts/run_tb_poweron_v398.sh` | сборка/запуск poweron-теста v3.9.8 |
| `scripts/run_tb_poweron_xver.sh` (+ `tb_poweron_xver_*.log`) | кросс-версионная матрица (дополнение 11-7): оригинальный tb_poweron на v3.9.2/3.9.3/3.9.4/3.9.5 + tb_poweron_v395_tail; дефект 11-5 воспроизведён на 3.9.3/3.9.4 (139-140 провалов P1), v3.9.2/v3.9.5 чисты, классы включения у всех идентичны |

## rom/ — тест-прошивки дисплея и клавиатуры (clk10-65)

Функциональные тесты трактов seg/dig/SND/kbcol/kbrow — прошиваются в flash
A29040B с offset 0 (временно заменяют fw_mon; вернуть — перешить монитор).
Не зависят от версии CPLD (транзиты одинаковы в v3.2…v3.9.x) — придуманы
как приёмочный тест платы после любого нового фита (в т.ч. v3.9.2).

**Железо 10-30 (на фите v3.9.2)**: тест дисплея — ПАСС; тест клавиатуры —
после распайки недостающих кнопок ПАСС (изначально 9 кнопок «не работали»:
цепи колонок замыкались через них в линию — артефакт незапаянной матрицы,
НЕ дефект прошивки/CPLD). **Найдено и исправлено в железе (клк10-67):
послесвечение чужого глифа** (на плате: сквозь «1» просвечивал «2» при коде
«2 1»). Причина: наивный порядок «глиф → разряд» в регенерации (REFRESH kbd,
TE5T disp) писал новый глиф в SEGP, пока старый разряд ещё горел (~16 мкс
каждый переход, до ~5% яркости слота; видно только когда глиф-призрак
добавляет сегменты: сквозь «1» (b,c) виден «2» (a,b,d,e,g), а обратный
призрак «1» сквозь «2» — нет, b,c уже горят). Фикс: порядок **ГАШЕНИЕ
(SEGP=0) → РАЗРЯД → ГЛИФ** — разряд переключается только при пустых
сегментах, призрак невозможен по построению. verify_fw.py дополнен
проверками блэнкинга (tE5t: 172 фазы подряд без нарушений; kbd: 0
нарушений) — 26/26 ПАСС (было 24/24). Образы: fw_test_disp 160 б,
fw_text_kbd 300 б; тон бипа по замеру ~475 Гц (полупериод 1054 мкс).
**Финал приёмки (10-30): владелец перепрошил новые образы —
послесвечения нет, тесты ПАСС; прошивки утверждены как штатные
приёмочные для будущих фитов.**

| Файл | Что это |
|---|---|
| `rom/fw_test_disp.asm` (.hex, .lst) | **ТЕСТ ДИСПЛЕЯ**: обходит все 32 сегмента — разряды 0→3, внутри разряда сегменты a→dp; каждый сегмент горит ~0,9 с (896,6 мс, диапазон 0,8–1,0 с) с НЕПРЕРЫВНЫМ тоном ~500 Гц (SND-бит D4 порта 01h тогглится каждый ~1 мс); между сегментами тёмная пауза ~59 мс; в каждый момент горит ровно один сегмент одного разряда. Финал — динамическое «tE5t» (78/79/6D/78, регенерация ~167 Гц, с блэнкингом — клк10-67) до сброса. Полный обход ~30,6 с (160 б) |
| `rom/fw_text_kbd.asm` (.hex, .lst) | **ТЕСТ КЛАВИАТУРЫ**: непрерывный скан матрицы 4×5 (колонка → пауза 25 мкс → ряды); нажатие = бип ~0,21 с (~475 Гц) + вывод на дисплей: СЛЕВА (DIG3) номер строки, СПРАВА (DIG0) номер колонки, нумерация аппаратная с нуля (строки 0–4, колонки 0–3); в покое «--» (два прочерка); после отпускания дебаунс ~31 мс; дисплей показывает последнюю кнопку; регенерация с блэнкингом (клк10-67; 300 б) |
| `rom/fw_test_disp_fast.hex`, `rom/fw_text_kbd_fast.hex` | FAST-варианты (укороченные выдержки, -D FAST=1) — для стендовой быстрой прогонки; единица ~1 мс и вся логика идентичны полным |
| `rom/verify_fw.py` | верификатор: мини-интерпретатор 8085 (точные T-состояния Intel 8085A) исполняет РЕАЛЬНЫЕ .hex с хуками портов и моделью матрицы; 26/26 ПАСС: порядок сегмент×разряд, длительности в T, тогглы SND, глифы, скан, бип, дебаунс, второе нажатие + блэнкинг (клк10-67): разряд переключается только при погашенных сегментах, после — ровно глиф фазы |
| `rom/asm85.py` | ассемблер (копия из beta/01_timer/rom) |

**Отловлено и исправлено симуляцией ДО железа** (цена вопроса — вышедшая
бы на плате мимоходная симптоматика): (1) MS_UNIT/MS_QUIET/SETTLE/SCANALL
затирают A/B/C — рабочие биты (разряд, сегмент, колонка) переносены в D/E
и ОЗУ; (2) в скане клавиатуры не инкрементировался индекс колонки E —
на дисплее всегда была бы колонка «0». Сборка: `python3 asm85.py
fw_test_disp.asm -o fw_test_disp.hex -l fw_test_disp.lst` (исходники CP1251,
round-trip проверен). Тайминги полных образов: единица ~1 мс = 3558 T
(замер симуляцией), выдержка 900×996 мкс = 896,6 мс, бип 200 ед ≈ 0,21 с.

## rom/ — МОНИТОР fw_mon: дисплей + клавиатура, меню ACDE (клк10-69/70)

Штатный монитор платы (прошивается в flash A29040B с offset 0; тест-
прошивки выше после приёмки 10-30 больше не нужны). По ТЗ владельца:
меню — 4 буквы на 4 разрядах **«ACDE»** (клк10-70: C вместо посаженной
раньше на B клавиши «P» — C созвучно с Code и физически есть на матрице
0__2; B снова обычная тетрада; добавлен режим D).
**Инструкция пользователя с примерами: [manuals/fw_mon_acde_manual.md](../../manuals/fw_mon_acde_manual.md)** · PDF в ретро-стиле (с рисунками 7-сегментного индикатора к командам): [manuals/fw_mon_acde_manual_retro.pdf](../../manuals/fw_mon_acde_manual_retro.pdf).
**F1 (4__1) — системное меню «ACDE»** (из любого режима);
**F2 (4__2) — показ адреса операций (задание владельца 11-7)**: из любого
режима (включая меню) выводит на 4 разряда текущий ADDR («8012») — адрес,
по которому C пишет/D читает/E запускает; повторное F2 возвращает прежний
экран (поле кода/адреса и просмотр байта сохраняются бит-в-бит — PREVST
FFF9h, стек с FFE7 вниз её не трогает); Enter/тетрады в показе игнорируются
(адрес случайно не сдвинуть), F1 — в меню; состояние ST_SHOW = 4;
**A (0__0) — ввод адреса** (4 тетрады, вдвигаются справа: 8 → «___8»,
80 → «__80», 5-я вытесняет старшую; Enter — запись);
**C (0__2) — ввод кода (Code)**: байт в кодах 8085 — 2 тетрады в правых
разрядах («__C3»), Enter — записать в [ADDR] и ADDR++, пустой Enter —
игнор, F1 — конец ввода, в меню;
**D (0__3) — просмотр кода с введённого адреса**: в правых разрядах байт
[ADDR] («__C3»), Enter — ADDR++ и следующий байт, F1 — в меню; режим
только чтение (тетрады игнорируются);
**E (1__3) — запуск с введённого адреса** (по умолчанию 8000h): гасит
дисплей, DI, регистры 0, SP=FFE8h, в стеке адрес возврата — выход из
пользовательской программы **RET (C9)** возвращает в «ACDE» (ждёт
отпускания клавиш + дебаунс), иначе RESET. В меню остальные клавиши
(0-9, B, F, Enter) игнорируются; в режимах адреса/кода A–F —
тетрады. Короткий тик ~32 мс (~468 Гц) на каждое нажатие, дисплей при
тике НЕ гаснет (SND едет в записи DIGP). Регенерация с блэнкингом
«гашение → разряд → глиф» (клк10-67). Память: переменные монитора
FFE8h–FFF9h, стек с FFE7h вниз; пользовательская область 8000h–FFE7h;
запись в ROM (0000–7FFF) железо отбрасывает. Образ 1041 байт
(0000h–0410h).

Верификация ДО железа: `rom/verify_mon.py` (наследник verify_fw.py:
мини-8085 с точными T + DI/EI, модель портов/матрицы/дисплея, запись в
ROM отбрасывается) — **54/54 ПАСС**: boot-гашение «8.», меню ACDE, F1
глобально, F2-показ адреса (после загрузки 8000, из меню, из кода/адреса/
просмотра — ADDR показан вместо поля, повторное F2 — прежний экран цел,
Enter в показе — игнор, F1 — в меню), ввод адреса посимвольно, Enter,
ввод кода по C с записью в ОЗУ и ADDR++, игнор пустого Enter, отброс
записи в ROM, запуск E с исполнением RET пользователя и возвратом в меню,
просмотр D (байт, Enter — следующий, тетрады игнорируются, F1 — в меню),
B снова тетрада (в меню — игнор), вытеснение 5-й тетрады, нет авто-повтора
при удержании, карта клавиш (row,col)→клавиша, блэнкинг — 0 нарушений
на 6709 фаз, тон 467 Гц, тик 32,1 мс (замер на FAST-образе, единица
1071 мкс = 3826 T). Ранее (клк10-69) отловлены и исправлены
3 бага ДО железа: (1) DISPATCH затирал код клавиши чтением STATE (все
ветки сравнивали не клавишу); (2) счётчики циклов TICKON/дебаунса были
в HL, который портит новый 4-разрядный REFRESH (вечный тик); (3) пороги
показа тетрад адреса были инверсными. Ассемблер asm85.py: метка на
отдельной строке получает адрес 0000 — везде инструкция на одной строке
с меткой.

ЖЕЛЕЗО (11-8): монитор Изд. 2 подтверждён владельцем на плате («монитор
работает») — меню, ввод кода, просмотр, пуск, F1/F2. Мануал актуализирован
под Изд. 2: в §7 пример дополнен подглядыванием адреса посреди набора
(F2 — адрес, F2 — назад, поле цело), в Пример 1 добавлены шаги 3а/3б с F2,
FAQ про F2 расширен, сквозная пометка об издании, факт железного
подтверждения в финальном пункте (54/54 + плата).

| Файл | Что это |
|---|---|
| `rom/fw_mon.asm` (.hex, .lst) | **МОНИТОР** (полный): меню ACDE — адрес A, код C, просмотр D, показ адреса F2, пуск E, тик, блэнкинг; 1041 байт |
| `rom/fw_mon_fast.hex` (.lst) | FAST-вариант (-D FAST=1: тик 4 ед, дебаунс 2 ед) — для стендовой симуляции |
| `rom/verify_mon.py` | верификатор монитора: 54/54 ПАСС (сценарии выше), требует verify_fw.py рядом |

## Дальше

1. **v3.9.3 — ЗАКРЫТА ПО ПОЛНОМУ ЦИКЛУ** (два фита 11-2: аудит ПАСС
   у обоих, GSR применилась в обоих, второй прошит — железо работает).
   Литераль сброса в термах 133 → 3, ресурсы: фит 1 — 86/108 МЦ,
   192/540 ПТ, 173/216 вх. ФБ; фит 2 (прошит) — 85/108, 195/540,
   171/216 (рекорд линии по вх. ФБ), 54 триггера, исчерпанных ФБ нет.
2. **v3.9.4: фит 1 11-4 10:15PM — SUCCESSFUL, аудит ПАСС** (82/108 МЦ,
   182 ПТ, 168/216 вх. ФБ, 50 рег — рекорды линии, разбор в разделе
   v3.9.4): .jed годится в прошивку — чекпоинт маршрута Б «запасная
   прошивка»; при шитье — тест-прошивки rom/ (дисплей/клавиатура).
   Откат — .jed v3.9.3 (фит 11-2 9:54PM). Следующий шаг маршрута Б —
   **v4.0.1**: те же 3 строки М1 в базовую часть `top_hwuart_por6_v400.v`
   → симы на мне → фит владельца.
3. Тест-прошивки дисплея и клавиатуры (`rom/`) — функциональная проверка
   трактов seg/dig/SND/kbcol/kbrow на плате после любого нового фита.
4. Перенос GSR-схемы сброса в txclient — ВЫПОЛНЕНО (txclient v7 11-3:
   cpu_rst 306 вхождений → 0; затем v8 = М1).
5. **v3.9.5 — ПОЛНЫЙ ЦИКЛ ДО .JED**: дефект старта v3.9.3/v3.9.4 починен (fuzz 0/100
   против 100/100 у v3.9.4, дифсим 0 расхождений — раздел v3.9.5); **фит владельца
   11-5 10:40PM SUCCESSFUL — аудит ПАСС с отклонением** (79/217/163/50; чек-лист 3c:
   п.2/п.3 сошлись, п.1 — GSR не свёлся, fallback 40 PTC-сбросов функционально
   эквивалентен, «чистка с t=0» в железе подтверждена уравнениями; Exhaustive ON —
   оговорка). **.jed v3.9.5 ШИТЬ** — единственная исправная версия (v3.9.4 дефектна,
   v3.9.3 с дефектом старта): при шитье — тест-прошивки rom/ (дисплей/клавиатура),
   затем железная проверка старта по питанию и кнопке на обеих платах (чек-пункт
   RST-цепи SCHEMATIC.md 514 остаётся). Откат — .jed v3.9.3 (аварийный). Наследникам —
   та же мера: hwuart v4.0.2 (2 строки в базе v4.0.1; сбросы в hwuart уже PTC-based —
   расширение источника почти бесплатно), txclient v9 при возвращении к линии;
   .jed v4.0.1 не шить.
6. **v3.9.6 — ЖДЁТ ФИТА ВЛАДЕЛЬЦА (хардренинг сброса, п.21)**: жалоба 11-6 (восстановление
   только по питанию, у обоих фитов v3.9.5) разобрана — модель sim_v395_rst_float,
   гипотеза п.1 (подтяжка RST) снята владельцем, мера «RST только через регистры»
   построена независимо от цепи платы (раздел v3.9.6; tb_v396_rst — ВСЕ ПАСС,
   норм-путь бит-в-бит v3.9.5). Фит в ISE (опции v3.9.5: IL 16/Pterm 18/Exhaustive OFF,
   фактический ON не приговор), чек-лист 3d → .jed → железо: **главный тест — кнопка
   сброса в работающую плату ×N** + питание ×N. Если не вылечит — остаток не в CPLD
   (периферия, не сбрасываемая кнопкой; осциллограф на P84). Наследникам — вместо
   «2 слов v4.0.2» полная мера п.21 (расширение GSR-источника недостаточно:
   сырой RST всё равно доходит до PTC-сбросов и RESET_IN).
7. **Дополнение 11-6bis — новая фактура (ручной сброс ноги CPU тоже не помогает)
   свела застревание к аналоговой лотерее включения** (раздел «Дополнение 11-6bis»):
   «8.8.8.8» = штатный паттерн сброса; держать RESET_IN=0 могут только por_run=1 или
   RST=1; «недопустимая ситуация в делителе» опровергнута исчерпывающим перебором
   (tb_poweron P0: 256 комбинаций — дрейн ≤1600 нс из любого кода); кнопка/проводничок
   в мёртвом классе бесполезны ПО ПОСТРОЕНИЮ (P2 — точное воспроизведение жалобы);
   сверки 3.9.2↔3.9.3/3.9.4↔3.9.5 показали: пор-путь бит-в-бит у всех версий —
   контраст «v3.9.2 стабилен» НЕ в RTL. **ЧЕК-ЛИСТ D1–D4 (X1/RST/cpu36+1к/100 Ом на
   U1.1) — пройти в плохой сессии НЕЗАВИСИМО от фита v3.9.6**: он различит M1
   (clk/LTC6905/H1) и M3 (цепь SW20/R2 — противоречие SCHEMATIC.md 514 замером).
   v3.9.6 шить можно, но от неё излечения M1 ждать не следует (она про другое).
8. **v3.9.7 — ЖДЁТ ФИТА ВЛАДЕЛЬЦА (кольцевой делитель, п.22)**: полевой
   эксперимент с одной переменной (кольцо вместо счётчика; всё прочее
   бит-в-бит v3.9.6 — раздел v3.9.7). Фит в ISE (опции как у v3.9.5/3.9.6:
   IL 16/Pterm 18/Exhaustive OFF), чек-лист шапки (в узле декодов
   равенства быть не должно; r0..r6 двойной kill; cnt в нетлисте
   отсутствует) → .jed → железо. Сценарий сравнения с v3.9.6: серия
   включений питания на ОБОИХ прошивках в плохие сессии; критерий — в
   разделе v3.9.7. Если лотерея сохранится на обоих — остаток за
   пределами CPLD-узла делителя (чек-лист D1-D4 из дополнения 11-6bis —
   главный инструмент). Кандидат v3.9.8 (заготовлен выводом 3 дополнения
   11-7): `assign RESET_IN = ~cpu_rst` вместо регистра reset_q — закрытие
   40-нс окна (CPU и логика отпускаются одной кромкой), −1 триггер,
   смысл п.21 сохранён; делать ТОЛЬКО после полевого вердикта по
   кольцу, чтобы не смешивать переменные.
9. **v3.9.8 — ЖДЁТ ФИТА ВЛАДЕЛЬЦА (узел тактирования на 50 МГц, п.23)**:
   схема владельца («берем делитель /2»): H1 без шунта (50 МГц на GCK3),
   кольцо напрямую, X1 = r0 duty 1/7, X2 = OR(r1..r6), clk25 = /2 — вся
   логика бит-в-бит v3.9.7, por-цепь в 50-домене (строб r0, POR 1120 нс —
   тот же номинал). Дифсим 69 044 выборки 0 расхождений; tb_poweron P0a
   2560 комбинаций ПАСС, P1 сид-в-сид эталону. Фит в ISE (опции как у
   v3.9.5-3.9.7: IL 16/Pterm 18/Exhaustive OFF) → .rpt НА АУДИТ (главная
   точка: clk25 на глобальной тактовой — прецедент GCK2; X2 = 6-ПТ OR без
   инверсии — прецедент v3.4) → .jed → ПЕРЕСТАВИТЬ H1 БЕЗ ШУНТА → железо:
   осциллограф (GCK3 = 50 МГц, X1 140 нс duty 1/7, X2 противофаза,
   CLKOUT 3,57 МГц 50%, RESET_IN ~1,04 мкс) + серия включений питания на
   обеих прошивках (v3.9.6/v3.9.7-база vs v3.9.8) в плохие сессии.
   Если генерация CPU не заведётся на 20-нс high X1 — откат одной
   строкой: X1 = r0|r1 (high 40 нс). Кандидат v3.9.9 = заготовка п.8
   (RESET_IN = ~cpu_rst) — после полевого вердикта по v3.9.8.
