digitalinvitro/CPLD-plus-8085/beta/hiclock/README.md

# beta/hiclock — кампания частоты ЗАКРЫТА (директива владельца 11-7: «отставим попытки выбраться за 4МГц»): 4,167 МГц (v3.9.9h) отклонена железом на ОБЕИХ платах — у владельца полный запуск не состоялся (но POST «8.8.8.8» стабилен — лучший результат hiclock-линии), у коллеги на стенде с регулируемым напряжением CPU не пошёл даже на повышенном питании; предел — в ядре ИМ1281ВМ85А. Производство — **v3.9.8** (N=7, 3,571 МГц, фит «золотой», железо стабильно). Ниже — история обеих кампаний (вторая: v3.9.9h 11-6/11-7; первая 10-28..10-30: v3.5..v3.11)

## v3.9.9h (11-6/11-7, линия lowsize → hiclock) — единственная переменная: кольцо N=7 → N=6, CPU 4,167 МГц

Директива владельца (11-6): **«Предлагаю попробовать на базе 3.9.8 поднять
частоту до 4.167МГц, создать ее в hiclock»** — тема, закрытая 10-30,
переоткрыта на НОВОЙ архитектуре тактирования (оговорка — ниже, после аудита).
База — **v3.9.8** (`beta/lowsize`, подтверждена владельцем на железе:
стабильно, зависаний нет). Всё остальное байт-в-байт v3.9.8: clk25 = /2 для
логики, por-цепь 50-домена, хардренинг RST п.21, TX v3.7, автомат шины,
legacy-ветки делителя. Ряд дискретный: CPU = 25/N МГц (50 МГц на GCK3, H1 без
шунта), поэтому 4,0 недостижимо — ближайший шаг вверх от 3,571 это N=6.

### Частотные параметры v3.9.9h

| Параметр | v3.9.8 (N=7) | **v3.9.9h (N=6)** |
|---|---|---|
| Вход CPLD (GCK3, H1 без шунта) | 50 МГц | 50 МГц |
| Кольцо | r0..r6, период 140 нс | **r0..r5, период 120 нс** |
| X1 = r0 | 7,143 МГц, duty 1/7 (20/120) | **8,333 МГц, duty 1/6 (20/100)** |
| X2 | r1\|..\|r6 = ~X1 | **r1\|..\|r5 = ~X1** |
| CPU (внутренний /2 ВМ85А) | 3,571 МГц, T=280 нс | **4,167 МГц, T=240 нс** |
| Логика (clk25) | 25 МГц | 25 МГц (без изменений) |
| POR = 8 x период кольца | 1120 нс | **960 нс** (норма 3 CLK = 720 нс, запас 1,33x — тот же) |
| Снятие por_run (штатный старт) | 1020 нс | **880 нс** (<= 980 нс из любого кода) |
| Терминал (бод = 1920 x f_CPU) | 6857 8N1 | **8000 8N1** (48000/6 ровно) |
| Зазор WR#(вверх)->след.ALE | 70..126 нс | **60..108 нс** (окно WB тоньше) |
| Ресурсы (фит) | 94/108 МЦ, 287 ПТ, 65 рег | **93/108 МЦ (86%), 286 ПТ, 181 вх.ФБ, 64 рег** |

### Состав

- `beta/hiclock/top_suart_hiclock_v399.v` (CP1251 — для ISE) + `_utf8` копия;
- `scripts/gen_v399h.py` — генератор из v3.9.8 (28 span-замен, каждая РОВНО
  1 раз; негативные контроли RTL-зоны: r6/NOR7/7,143/140 нс/1120 —
  отсутствуют; позитивные: уравнения r0..r5, X2 5-ПТ, NOR6, 4,167, 960 нс;
  round-trip CP1251);
- `scripts/sim_v399h_ring6.py` — полный перебор модели узла: 64 кода кольца →
  one-hot <= 2 фронтов (макс = 2), орбита периода 6; power-on 64x8x2 = 1024
  комбинации — 0 ошибок; негативные контроли: наивное кольцо (без kill) из
  пары '11' ходит вечно, ОДИНАРНЫЙ kill (v3.8) на N=6 орбитит 22/64 кода —
  двойной kill НЕОБХОДИМ и ДОСТАТОЧЕН (перебор);
- `scripts/tb_poweron_v399h.v` + `scripts/run_tb_poweron_v399h.sh` + лог;
- `retro_pcld_top (v399h-fit1-1106-1129PM).rpt` — архив фита 1 владельца.

### Верификация (Icarus 12.0, tools/iverilog, RTL v3.9.9h)

- ЭЛАБОРАЦИЯ: все 5 веток generate компилируются, 0 ошибок;
- **P0a PASS**: 1280 комбинаций (64 кольца x 10 por_sh x 2 фазы clk25) —
  one-hot <= 2 фронтов из ЛЮБОГО кода; дрейн por_sh в 00 <= 1400 нс навсегда;
  por_run падает и не возвращается; clk25_q тогглится 640/640;
- **P0b PASS**: орбита дрейна FF→7F→3F→1F→0F→07→03→01→00 монотонная;
- **PX PASS**: 50 фронтов X1 с шагом РОВНО 120 нс, high РОВНО 20 нс
  (duty 100/600 = 1/6 точно), X2 == ~X1 в каждом сэмпле, por_ce — РОВНО один
  строб за 120 нс; RESET_IN снялся через 900 нс (модель: 880 + кромка clk25);
- **P1**: 1 «ошибка» ЭТАЛОННОГО класса окна 40 нс (самозаживляющаяся,
  100/100; у эталона v3.9.8 тем же методом — 3; путь сброса байт-в-байт
  v3.9.8, окно НЕ расширялось);
- **P2/P3/P4/P5 PASS** (мёртвый clk, поздний clk, RST=1, лотерея
  передёргиваний) — см. лог `scripts/tb_poweron_v399h.log`.

### Фит 1 (11-6 11:29PM) — SUCCESSFUL, АУДИТ ПАСС

- Ресурсы: **93/108 МЦ (86%)** — прогноз сошёлся ТОЧНО; 286/540 ПТ (53%),
  181/216 вх.ФБ (84%), 64/108 рег, 72/81 ноги; дельта к v3.9.8: −1 МЦ (r6),
  −1 ПТ, −2..−4 вх.ФБ (183–185 → 181), −1 рег; исчерпаны ФБ3 (входы 36/36),
  ФБ4 и ФБ6 (МЦ 18/18); DENSITY, IL 28, Pterm 18, Exhaustive OFF;
- Кольцо: X1 = r0 (FB6_3, P68, INIT SET, 2 ПТ/6 вх) + r1..r5 (INIT RESET,
  все в FB6) = 6 триггеров, **r6 в нетлисте НЕТ**; уравнения фиттера = RTL
  байт-в-байт: r0.D = (r5 & ~r0 & ~r1 & ~r2) | NOR6 — рестарт из 00 и
  kill-литералы на месте, декодов равенства нет;
- X2 = r1|..|r5 — своя МЦ FB6_5 (P69), 1 ПТ/5 вх: фиттер свернул 5-ПТ OR в
  NOR-форму с инверсией выхода (класс п.10, эквивалент точный); X2
  комбинационный (регистра нет — «в фазе r0» исключено); keep=TRUE сработал;
- clk25_q — 1 триггер (FTCPE, T='1', 0 ПТ) — как в v3.9.8; por_sh[7:0] на
  clk 50 (INIT FF), строб X1, por_run = por_sh(0) → **POR = 960 нс**
  (норма 720 нс, запас 1,33x);
- Сброс байт-в-байт v3.9.8 (п.21): RST P1 — обычный вход (GSR НЕ
  использован), rst_meta/rst_sync/rst_qcnt/rst_press на clk25 (квалификатор
  320 нс), wr_seen_RSTF = !rst_press·!por_run, RESET_IN — регистр (FB4_3);
- WARNING:Cpld:897 — буфер D<7> (D<7>_BUFR в FB5_3, 5 ПТ/12 вх) — известный
  класс v3.9.8, не блокер (первый подозреваемый при бит-специфичных сбоях
  D7); INFO:Cpld BUFG по P29 — штатно; clk P29 → GCK3 — единственная
  глобальная сеть.

**Вердикт: фит золотой — .jed строить и шить.** Полный аудит продублирован
в шапке RTL (п.25).

### Железо 11-7: первый прогон v3.9.9h — «8.8.8.8» появляется и гасит, СТАБИЛЬНО

Отчёт владельца 11-7: на его плате полный запуск не состоялся — «дальше по
частоте на этом железе продвинуться не можем, возможно сдерживает питание»,
НО дизайн **стартует, гасит «8.8.8.8» и делает это стабильно** — «раньше все
hiclock версии такого не смогли сделать». План: проверка у коллеги на стенде
с регулируемым напряжением (влияние питания на потолок частоты).

Трактовка (наша): «8.8.8.8» — сбросовый паттерн индикатора (seg_q=FF /
dig_q=F при cpu_rst) и POST прошивки; его появление И гашение (блэнкинг
прошивки, клк10-67) означают, что CPU **стартует и исполняет прошивку на
4,167 МГц** — первая кампания 10-29/30 этого не давала (v3.10 «не тянет»,
v3.11 — частичный старт без «85»). Полного запуска нет — главный
подозреваемый теперь ПИТАНИЕ, а не тактовый тракт. Откат — известный
хороший .jed v3.9.8 (без пайки). Запись продублирована в `../DEVLOG.md`.

### ФИНАЛ 11-7: стенд коллеги — 8085 не пошёл даже на повышенном напряжении; кампания ЗАКРЫТА

Директива владельца: «Нет, у коллеги не пошел 8085 даже на повышенном
напряжении питания, отставим попытки выбраться за 4МГц».

Решающий эксперимент состоялся: повышение питания НЕ оживило CPU на
4,167 МГц → ограничение — в ядре ИМ1281ВМ85А, НЕ в питании и НЕ в тактовом
тракте CPLD (POST «8.8.8.8» у владельца шёл стабильно). Вердикт первой
кампании 10-29/30 («виновато ядро») подтверждён независимым стендом на
новой архитектуре тактирования.

Итоги второй кампании (v3.9.9h):

- фит «золотой» (93/108 МЦ, прогноз сошёлся точно) — архитектура «кольцо
  N=6 напрямую от 50 МГц» полностью работоспособна в кремнии: X1/X2,
  POR 960 нс, сброс п.21 — вне подозрений;
- лучший результат hiclock-линии за всю историю: стабильный POST «8.8.8.8»
  на 4,167 МГц (первая кампания не давала и этого);
- лестница 25/N дискретна: между N=7 (3,571 МГц — стабильно у обоих) и
  N=6 (4,167 — не стартует ни у кого) промежуточных шагов нет; потолок
  экземпляра лежит в этом интервале.

Производство — **v3.9.8** (3,571 МГц). v3.9.9h остаётся в папке как
проверенная платформа: если появится экземпляр ВМ85А с лучшим частотным
потенциалом — кандидат на 4,167 МГц готов (RTL + фит-отчёт + .jed).

### ⚠ Оговорка: лестница частот ЭТОГО экземпляра (обязательно к чтению)

У экземпляра ИМ1281ВМ85А 4,17 МГц уже отклонялась железом — первая кампания
(10-29/30, история ниже): v3.10 (X1 8,33 МГц duty 50/50, POR 3,58 такта) —
«не тянет»; v3.11 (POR 5,58 такта) — не стартует (частичный старт: терминал
есть, «85» на дисплее нет); маржа POR исключена, вердикт той кампании —
«виновато ядро». **v3.9.9h перепроверяет ту же частоту ЦП на другой
архитектуре тактирования** (кольцо N=6 напрямую от 50 МГц; X1 duty 1/6 —
high 20/low 100 нс вместо 50/50; X2 = ~X1 канонично) по директиве
владельца. Возможные исходы: (а) старт — значит, в первой кампании вклад
давала и старая схема тактирования, а не только ядро; (б) та же картина
частичного старта — подтверждение вердикта 10-30 новым методом. Откат в
обоих случаях — известный хороший .jed v3.9.8 (перепрошивка, без пайки).

### Что делать владельцу

1. ~~Фит в ISE~~ — ВЫПОЛНЕНО (фит 1 SUCCESSFUL 11-6 11:29PM);
2. ~~.rpt на аудит~~ — ВЫПОЛНЕНО (аудит ПАСС: выше + п.25 шапки RTL);
3. **.jed → железо**: осциллограф (GCK3 50 МГц; X1 120 нс duty 1/6; X2 8,33
   противофаза — два луча; CLKOUT 4,17 МГц 50%; RESET_IN низ ~0,9 мкс),
   **зазор WR#→ALE (ожидание 60..108 нс)**, серия включений, PUSH-стресс;
   при неудаче — сравнить картину с v3.10/v3.11 (частичный старт без «85»?)
   и вернуть .jed v3.9.8;
4. Терминал **8000 8N1**.

---

## История первой кампании частоты (10-28..10-30): ФИНАЛ — производство v3.9 «кольцо N=7» (CPU 3,571 МГц, работает на плате); оверклок 4,17 МГц отклонён железом ОКОНЧАТЕЛЬНО — v3.11 (POR 5,58 такта CPU) тоже не стартует: маржа POR исключена, виновато ядро

*Тема была закрыта 10-30; 11-6 переоткрыта директивой владельца — см. v3.9.9h
выше. Текст ниже сохранён без изменений.*

Статус: **ФИНАЛ КАМПАНИИ ЧАСТОТЫ (владелец, 10-30): ОСТАЁМСЯ НА
v3.9 — CPU 3,571 МГц, X1 7,143 МГц 71/29, терминал 6857 8N1;
.jed v3.9 известен хороший (работал на плате).** Приказ «делаем
v3.11» исполнен (clk10-58) И ПРОВЕРЕН ЖЕЛЕЗОМ — проба старта с
удлинённым POR на CPU 4,17 МГц дала ОТРИЦАТЕЛЬНЫЙ результат.
Дословно владельца (10-30): «видно что пытается запустится, даже
что вываливается в терминал, но дисплей не 85, не хватает» —
попытка старта ВИДНА, но загрузка не завершается, сигнатуры «85»
на дисплее нет. Расширение POR с 3,58 до 5,58 такта CPU (запас
1,86× к норме даташита 3 такта) исход НЕ изменило → маржа POR
ИСКЛЮЧЕНА; по правилу п.17 шапки RTL v3.11 — «ядро окончательно,
возврат на v3.9 без вариантов». Диагностическая ценность пробы:
активность в терминале означает, что на 4,17 МГц ядро ИСПОЛНЯЕТ
код (в сбросе/простое TX = '1' по логике v3.7 — фреймы в терминал
дают только реальные SIM/SOD-выводы fw_mon v5): кристалл частично
дееспособен и отваливается по ходу загрузки — классическая
картина маргинального оверклока, а НЕ мёртвого тактирования;
часы CPLD подтверждены осциллографом ранее (X1 = 8,4 МГц, ровно
50/50). Чистый вердикт ЯДРУ данного экземпляра ИМ1281ВМ85А на
частоте 4,17 МГц.

ЛЕСТНИЦА ЧАСТОТ ЭКЗЕМПЛЯРА (эмпирика, опора 25 МГц): 5,00 (v3.8,
кольцо N=5) — нестабильный старт / 4,17 (v3.10, /3 XOR-пара, POR
3,58 такта) — НЕ ТЯНЕТ / 4,17 (v3.11, POR 5,58 такта) — НЕ
СТАРТУЕТ (частичный старт: терминал есть, «85» на дисплее нет) /
3,571 (v3.9, кольцо N=7) — СТАБИЛЬНО = ПРОИЗВОДСТВО / 2,5
(v3.0–3.2) — историческая. С опорой 25 МГц точек между 4,17 и
3,57 НЕТ (CPU = 25/N, N целое; XOR-ветка — 25/(2M), M нечётное;
полуцелый 3,5 даёт те же 3,571). Номинальный класс части (5 МГц)
экземпляром не подтверждается.

ЗАДЕЛ НА БУДУЩЕЕ (гипотеза владельца, 10-30): «для такого
оверклока нужно поднимать питание, пока не могу проверить» —
зафиксирована как единственная дверь обратно к 4,17: при
появлении возможности поднять Vcc кандидат v3.11 готов (RTL
CP1251+UTF8 и симуляция 19/19 ПАСС в комплекте, один фит до
.jed); фит-отчёт v3.11 (.rpt) в комплект НЕ поступал — перед
повторной прошивкой сначала на аудит. До тех пор производство =
v3.9.

ПЕРЕНОС (clk10-64, 2026-10-30, директива владельца): **v3.9.1 выбыл из
hiclock** — RTL (`top_suart_por6_v391.v`, `_utf8`) и его 4 скрипта
(`gen_v391.py`, `sim_v391_equiv.py`, `tb_v391_diff.v`, `run_tb_v391.sh`)
переехали в новую папку **`beta/lowsize/`** — линию работ над СНИЖЕНИЕМ
количества ресурсов CPLD (v3.9.1 = её база; там же развивается v3.9.2 и
тест-прошивки). Секция v3.9.1 ниже сохранена как историческая. Пробник
clk10-63 (`tb_col_probe.v`, `gen_col_probe.py`) остался здесь: это
одноразовый артефакт вердикта, не версия.

## v3.11 (clk10-58, 2026-10-29) — ПРОБА СТАРТА: POR 8 → 12 FF (1340 нс = 5,6 такта CPU) — ЖЕЛЕЗО: СТАРТА НЕТ → ВОЗВРАТ НА v3.9

База v3.10 БАЙТ-В-БАЙТ, единственное изменение (п.17 шапки RTL):
`reg [7:0] por_sh = 8'hFF` → `reg [11:0] por_sh = 12'hFFF`, сдвиг
`{1'b0, por_sh[7:1]}` → `{1'b0, por_sh[11:1]}`. Вся остальная POR-цепь
(por_run.D = por_sh[0], INIT=SET, cpu_rst = RST \| por_run, повтора POR
нет) НЕ тронута. Узел /3, автомат шины, TX v3.7, терминал 8000 8N1 —
без изменений.

| Параметр | v3.10 (не тянет) | v3.11 (проба) |
|---|---|---|
| por_sh | 8 FF | **12 FF (+4 МЦ → ~90/108)** |
| POR | 860 нс = **3,58 такта CPU** (самый короткий старт всех версий) | **1340 нс = 5,58 такта** (запас к норме 720 нс = 1,86×) |
| X1/CPU | 8,333 МГц 50/50 / 4,167 МГц | те же (бит-в-бит, проверка R) |
| Терминал | 8000 8N1 | 8000 8N1 |

Верификация (scripts/sim_v311_div3_por12.py, точная семантика RTL): **19/19
ПАСС** — все 17 проверок v3.10 (A–L) + POR ровно 1340 нс (k=67 =
43+24, прирост +480 нс = ровно 4 тика por_ce) + регрессия R/R2:
X1/X2/cnt бит-в-бит == v3.10 на всём прогоне 200 мкс, por_run
отличается ТОЛЬКО окном 43..66 полутактов (860..1320 нс: v3.10 = 0,
v3.11 = 1).

Интерпретация на плате (написана в п.17 шапки ДО теста): СТАРТУЕТ И
РАБОТАЕТ → маржа POR была фактором — ОСТАЁМСЯ НА 4,17 МГц (v3.11 =
финал); НЕ СТАРТУЕТ → ядро окончательно, ВОЗВРАТ НА v3.9 (3,57 МГц,
терминал 6857) БЕЗ ВАРИАНТОВ — тема частоты закрыта.

ИТОГ НА ЖЕЛЕЗЕ (владелец, 10-30): **НЕ СТАРТУЕТ — исполнен возврат
на v3.9, тема частоты закрыта.** Дословно владельца: «видно что
пытается запустится, даже что вываливается в терминал, но дисплей
не 85, не хватает». Трактовка: попытка старта видна — активность в
терминале (на CPU 4,167 UART = 8000 бод, терминал настроен ровно)
означает, что ядро исполняет код монитора: в сбросе и простое TX =
'1' (логика v3.7: PRE = NOT RESET_IN, tx_pass держит линию idle до
первого SOD='1'), фреймы в терминал даёт только реальный SIM/SOD-
вывод fw_mon v5. Кристалл на 4,17 МГц частично дееспособен —
выборка/исполнение идут и отваливаются по ходу загрузки, до
сигнатуры «85» на дисплее дело не доходит. POR 5,58 такта (запас
1,86× к норме 3) исхода не изменил → маржа POR исключена, виновато
ядро экземпляра. Часы CPLD подтверждены ранее осциллографом (X1 =
8,4 МГц, ровно 50/50) — тактирование не при чём. Оговорка: фит-
отчёт v3.11 (.rpt) в комплект не поступал, структурный аудит
нетлиста v3.11 не проводился — но частичная работа (исполнение
кода + UART) подтверждает, что собранное соответствует замыслу.

Гипотеза владельца на будущее (10-30): «для такого оверклока нужно
поднимать питание, пока не могу проверить» — зафиксирована: при
появлении возможности поднять Vcc кандидат v3.11 готов (один фит
до .jed, симуляция 19/19 ПАСС), до тех пор производство = v3.9.

## v3.10 (clk10-56/57, 2026-10-29) — делитель /3: X1 = 8,33 МГц ровно 50/50, CPU = 4,17 МГц — ЖЕЛЕЗО ОТКЛОНИЛО (аудит и вердикт — ниже, перед секцией v3.9)

Директива-вопрос владельца: «Можем ли мы поднять входную частоту
до 8 или 9МГц» (после подтверждённого железом успеха v3.9).
Разбор вариантов (probe_freq_steps.py, три модели):

| Вариант | X1 | CPU | Симуляция | Вердикт |
|---|---|---|---|---|
| Кольцо N=6 (чётное, XOR-архитектура) | — | — | периоды X1 чередуются 100/140 нс → CLK с джиттером | ❌ БРАК: чётное N в XOR-архитектуре не работает |
| ÷3 toggle-пара (голый счётчик) | 8,33 (80/40) | 4,167 | периоды чистые 120 нс, POR 900 нс | рабочий, но duty 67/33 и новая архитектура |
| U7 → LTC6905-80 (20 МГц), RTL = v3.8 | 8,00 ровно (75/50) | 4,000 | периоды чистые 125 нс, POR 975 нс | ✅ но автомат переезжает на 20 МГц — зазор WR#→ALE пересчитывать |
| «9 МГц» (опора 50 МГц, N=11 → 9,09) | — | 4,55 | — | ❌ переделка автомата + X1 low 20 нс + ФБ-бюджет |

ПРИНЯТ четвёртый путь — делитель /3 в legacy-архитектуре XOR-пары
(g_div_odd): та же схема, что исторически работала на /5 = 5 МГц
(v3.0–v3.2), в RTL НЕ ТРОНУТА с clk10-35 — v3.10 = переключение
параметров CLK_DIV=3/CLK_HALF=0 + сужение cnt. Существенно лучше
голого toggle: duty РОВНО 50/50 (60/60 нс; обе полуволны длиннее
проверенных железом low 40 нс v3.9) и двойник x2_p даёт X2 = ~X1
по построению.

| Параметр | v3.9 (N=7, работает) | v3.10 (/3) |
|---|---|---|
| X1/X2 | 7,143 МГц, 71/29 (100/40) | **8,333 МГц, РОВНО 50/50 (60/60)** |
| CPU (CLK OUT) | 3,571 МГц (280 нс) | **4,167 МГц (240 нс)** |
| Терминал | 6857 8N1 | **8000 8N1** (1920 × 4,167) |
| por_ce | r1\|r6, 200/80 нс | (cnt==0), импульс 40 нс каждые 120 нс |
| POR | 1120 нс (норма 840, 1,33×) | 960 нс (норма 720, **1,19–1,25×**) |
| Узел делителя | 8 FF (кольцо r0..r6 + x1_n) | **5 FF** (cnt[1:0] + x1_p/x1_n/x2_p) |
| Старт | переходного нет | X1 стартует '1', глобально периодична с t=0 |

КЛЮЧЕВЫЕ точки: NMOD=NHALF=2 — x1_p тогглит на posedge при cnt==0
(фронты 20+120k), x1_n — на negedge при cnt==2 (фронты 80+120k) →
фронты X1 ровно через 60 нс С ПЕРВОГО; INIT cnt=0 лежит на легальной
орбите — переходного процесса нет (строже v3.6-класса init).
cnt сужен [3:0] → [1:0] (CNT_W параметризован: 2/3/4 бита по
CLK_DIV) — старшие биты застряли бы в 0, а фиттер v3.6 держал их
как МЦ; эквивалентность сужения бит-в-бит доказана симуляцией
(проверка K).

Верификация (scripts/sim_v310_div3.py, точная семантика ветки
g_div_odd, 200 мкс + живучесть): **16/16 ПАСС** — X2 == ~X1
(10000/10000); фронты ровно 3 полутакта (60 нс) с первого (t=20);
duty 50,000%; периодичность X1(k+6)==X1(k) с t=0; x1_p/x1_n —
ровно 1 тоггл за 120 нс на своих фазах; cnt только {0,1,2};
por_ce подъёмы каждые 120 нс, ширина 40 нс (первый 20 — фаза
INIT); POR 860 нс ≥ 720 (в RTL +1 клок на регистрацию por_run →
~900); живучесть: из 4/4 состояний cnt (включая нелегальное 11)
на орбиту за ≤ 1 posedge без ложных тогглов; cnt[1:0] == cnt[3:0]
бит-в-бит.

Автомат шины НЕ тронут (домен 25 МГц: /WE 80 нс, t_AS 40 нс).
T_CPU = 240 нс: зазор WR#(вверх)→след.ALE сжимается до
0,25..0,45 T = 60..108 нс (v3.9: 70..126) — окно T1H закрыто по
расчёту с запасом ~2–3 такта 25 МГц; ПОСЛЕ ФИТА ПЕРЕИЗМЕРИТЬ
зазор на осциллографе (п.4/п.16 шапки).

Бюджет (прогноз): узел 8 → 5 FF → ~85/108 MC (−3 к v3.9);
птермы ~216/540 (+2 — декоды cnt 2-битные, дёшевы); входы ФБ
~198–202/216. Куда ляжет узел — решает фиттер; декоды cnt==0/==2
разделяются фиттером (NMOD=NHALF).

Последствия: терминал **8000 8N1**; CLK OUT = 4,167 МГц duty 50%;
t_RD/t_WR CPU сжимаются на 14% против v3.9 (маржа памяти
остаётся: /WE 80 нс фиксирован автоматом). Риск один — скорость
ядра экземпляра ИМ1281ВМ85А: 4,17 МГц = +17% к проверенным 3,57
(но форма импульсов безопаснее v3.8 на 5 МГц по всем метрикам).
Методика: прошить, погонять старт 20–30 раз, тесты; откат — jed
v3.9 без переделок. Далее вверх на этой опоре пути НЕТ
(следующая точка сетки 10,00 МГц — CPU 5,00, не тянет).

Предыдущий кандидат **v3.9 (clk10-54/55) — ОТКАТ ЧАСТОТЫ ПО ЖЕЛЕЗУ: экземпляр
ИМ1281ВМ85А не держит CPU 5 МГц (нестабильный старт простых тестов,
запустившись — работают); кольцо делителя РАСШИРЕНО 5 → 7 триггеров:
X1/X2 = 2×25/7 = 7,143 МГц (период ровно 140 нс, high 100 / low 40,
duty 71/29), X2 = ~X1 точно, CPU = 3,571 МГц (период ровно 280 нс,
duty 50/50), POR = 8×140 = 1120 нс (норма 3 такта CLK = 840 нс,
запас 1,33×), терминал 6857 8N1. Найден и закрыт ДО фита дефект
формулы коллеги для N=7: одинарный kill оставляет вечную орбиту
парам '1' на дистанции 3-4 (14 из 128 состояний) — в v3.9 двойной
kill (любое из 128 состояний → one-hot за ≤ 2 фронта). Симуляция
`scripts/sim_v39_ring7.py` — ПАСС. **ЖЕЛЕЗО ПОДТВЕРДИЛО (владелец,
2026-10-29): собрано, прошито, «отлично всё работает» — нестабильный
старт v3.8 устранён откатом на 3,57 МГц.** Фит .rpt владельца
ожидается для аудита ФАКТИЧЕСКИХ ресурсов и обязательных точек
чек-листа (п.15/TODO 78 шапки RTL — фронт X1/X2 по осциллографу).
Фит владельца 10-29 8:45PM ПОЛУЧЕН И ПРОАУДИРОВАН (clk10-55,
раздел «Аудит фита v3.9» ниже): МЦ 88/108 (прогноз ~89), птермы
214/540 (прогноз ~209, +5 — kill-литералы r5/r6), входы ФБ 202/216
(прогноз 201-204 — точное попадание), триггеры 59 (арифметика
бит-в-бит) → .jed этого фита УЖЕ НА ПЛАТЕ И РАБОТАЕТ.
Откат на 5 МГц: v3.8 — фит владельца 10-29 4:39PM ПОЛУЧЕН И
ПРОАУДИРОВАН (clk10-53, 15/15 ПАСС — раздел «Аудит фита v3.8» ниже):
отчёт ПОЛНЫЙ (63 КБ, краша писателя больше нет), МЦ 87/108 (v3.6:
102), птермы 206/540 (v3.6: 271), декодов равенства в узле — 0,
x1_n на НЕGEDGE (GCK2 = ~clk), init-пары верны → .jed от этого фита
СТРОИТЬ МОЖНО (но CPU 5 МГц текущий экземпляр не держит); финальный
арбитр фазы X1/X2 — осциллограф (TODO п.4 шапки). История: v3.8
(clk10-52) — one-hot кольцо вместо двоичного mod-5 (идея владельца
и коллеги) поверх v3.7 (TX-маска удалена, захват по первому
SOD='1'; окно SOD=0 покрыто ПО СТРОЕНИЮ). Хвост v3.6 закрыт
автоматически: фит 10-29 6:59AM остаётся ЧАСТИЧНЫМ 8/10 (clk10-50,
.rpt обрезан крашем) — для v3.6 вопрос снят.
Структурная часть аудита v3.6 — ПАСС (см. раздел ниже). Предыдущий
кандидат v3.5 (регистровая противофаза X2) — аудит
6/6 ПАСС (см. ниже, история clk10-48): файл владельца
`upload/top_suart_por6_v35.v` == `beta/hiclock/top_suart_por6_v35.v` == эталон
(sha1 `722bdd9286285da5eb3b8c2375181bbcd54a1887`, 33 547 байт, CP1251), фит
10-28 6:20PM — 6/6 ПАСС, осциллограмма «X2 в противофазе к X1» СОГЛАСОВАНА.

## Аудит фита v3.10 (clk10-57, 2026-10-29) — 10:07PM, .rpt ПОЛНЫЙ 63 647 б + ВЕРДИКТ ЖЕЛЕЗА

Фит владельца `retro_pcld_top (v310).rpt` (10-29 10:07PM,
XC95108-15-PQ100, Fitting Status: Successful, 0 ERROR, warning 897 —
1, тот же буфер D<7> в FB1, что и в v3.8/v3.9). Отчёт ПОЛНЫЙ
(Equations дописаны до конца, Compiler Options в хвосте,
оптимизация DENSITY, slew FAST, все 86 МЦ high performance).

| Проверка | Результат |
|---|---|
| Ресурсы | МЦ 86/108 (80%), птермы 203/540 (38%), входы ФБ 192/216 (89%), триггеры 56/108, ноги 72/81 (72/72 по UCF) |
| vs прогноз | МЦ ~85→86 ✓, PT ~216→203 (лучше на 13), входы ФБ 198–202→192 (лучше), FF 59→56 ✓ (узел 8→5 FF бит-в-бит) |
| Исчерпанные ФБ | 2 записи: FB1 (вх 36/36), FB3 (вх 36/36) — ЛУЧШИЙ результат всех версий (v3.9: 4, v3.8: 3, v3.6: 6) |
| cnt | cnt<0> FB4_8: FDCPE, D = ~cnt0 & ~cnt1 (cnt0 <= ~(cnt0\|cnt1)) ✓; cnt<1> FB6_10: FDCPE, D = cnt0 & ~cnt1 ✓; оба Init=RESET; нелегальное 11 недостижимо |
| x1_p | FB4_4: FTCPE, T = cnt_0__and0000_D2 (cnt==0 — ТОТ ЖЕ декод, что por_ce — разделяётся фиттером), posedge clk (GCK3), Init=SET ✓ |
| x2_p | FB4_2: FTCPE, T = cnt==0, Init=RESET → x2_p = ~x1_p по построению ✓ |
| x1_n | FB6_6: FTCPE, T = cnt1 & ~cnt0 (cnt==2), clock = NOT clk (GCK2), Init=RESET ✓ |
| X1/X2 | `X1 <= x1_p XOR x1_n` (FB6_3), `X2 <= x2_p XOR x1_n` (FB6_5) — XOR-ядра 2 PT/2 вх, регистров на пинах нет, NOT нет ✓ |
| por | por_ce = cnt_0__and0000_D2 литерально во всех por_sh_D (shift/hold); por_sh 8×SET; por_sh_D(7) = por_sh(7) & ~por_ce (0 в MSB); por_run.D = por_sh(0) SET; RESET_IN = NOT por_run AND NOT RST (P84) ✓ |
| v3.7 TX | TX FDCPE PRE=NOT RESET_IN, Init=SET — в сбросе линия '1' ✓; tx_pass async clear NOT RESET_IN, sod_q = сэмпл SOD ✓ |
| Мусор | r0..r6/t0_q/x1_q/x2_q/txm_cnt в нетлисте НЕТ ✓ (кольцо v3.8/v3.9 элайзилось корректно) |
| GCK | ~clk → GCK2 (x1_n negedge), clk → GCK3 ✓; GSR/GTS/GOE не заняты |
| Fmax | не считывался (узел: T-FF + 2-вх декоды cnt — проще кольца v3.8/v3.9) |

ВЕРДИКТ СТРУКТУРНЫЙ: нетлист = RTL v3.10 бит-в-бит — фит СДЕЛАЛ
ТО, ЧТО ЗАДУМЫВАЛОСЬ. ЖЕЛЕЗО (владелец, 10-29): по осциллографу
X1 = 8,4 МГц (номинал 8,333 — в пределах погрешности измерения,
форма 50/50) — узел /3 и часы CPLD работают; процессор на
CPU 4,167 МГц НЕ РАБОТАЕТ («процессор не тянет»). Вина НЕ в CPLD:
ядро данного экземпляра ИМ1281ВМ85А не достигает 4,17 МГц.

ЛЕСТНИЦА ЧАСТОТ CPU ЭКЗЕМПЛЯРА (эмпирика, все на опоре 25 МГц):

| CPU | Версия | X1 | Результат |
|---|---|---|---|
| 5,00 МГц | v3.8 (кольцо N=5) | 10,00 МГц (60/40) | нестабильный старт простых тестов |
| 4,167 МГц | v3.10 (/3 XOR-пара) | 8,333 МГц (ровно 50/50) | **НЕ ТЯНЕТ** (осл. X1 8,4 МГц) |
| 4,167 МГц | v3.11 (= v3.10 + POR 5,58 такта) | 8,333 МГц (ровно 50/50) | **НЕ СТАРТУЕТ** — частичный старт (терминал есть, «85» на дисплее нет); ядро окончательно |
| 3,571 МГц | v3.9 (кольцо N=7) | 7,143 МГц (71/29) | **СТАБИЛЬНО — ПРОИЗВОДСТВО** |
| 2,5 МГц | v3.0–3.2 (/5) | 5,00 МГц (50/50) | историческая рабочая |

С опорой 25 МГц точек между 4,167 и 3,571 НЕТ: CPU = 25/N (кольцо,
N целое: 25/7 = 3,571; 25/6 = 4,167), XOR-ветка — 25/(2M), M
нечётное; полуцелый делитель 3,5 даёт те же 3,571. Номинальный
класс части (5 МГц, аналог 8085A-2) данным экземпляром не
подтверждается.

POR В ТАКТАХ CPU: v3.10 = 860 нс / 240 нс = **3,58 такта** — самый
короткий старт всех версий (v3.8 и v3.9 имели ровно 4,0 такта;
норма даташита 8085A — «minimum of three clock periods»).
Теоретический остаточный шанс — что 4,17 не тянет именно СТАРТ
(маржа POR), а не ядро. Решается одним экспериментом БЕЗ смены
железа: v3.11 = v3.10 + por_sh 8 → 12 FF (POR ≈ 1340 нс = 5,6
такта CPU, +4 МЦ → ~90/108, остальное без изменений). Если и с
5,6 тактами старта нет — ядро окончательно, возврат на v3.9 без
вариантов. Дефолт — сразу прошить v3.9 обратно (известно
хорошее).

ПОСЛЕСЛОВИЕ (10-30): эксперимент v3.11 ВЫПОЛНЕН — результат
ОТРИЦАТЕЛЬНЫЙ: старта нет и при POR 5,58 такта (частичный старт —
секция v3.11 выше). Остаточный шанс «не тянет именно СТАРТ»
закрыт; вердикт «ядро данного экземпляра не тянет 4,17 МГц»
окончателен. Гипотеза владельца о подъёме питания — задел на
будущее.

## Расклад ресурсов по блокам (фит v3.10, clk10-60) + вердикт по подтяжкам CS/#CS ОЗУ

Разбор `retro_pcld_top (v310).rpt` по функциональным блокам — все
86 МЦ и 203 ПТ разложены без остатка (для производства v3.9 —
88 МЦ / 214 ПТ — расклад тот же с точностью до узла делителя:
кольцо r0..r6 вместо cnt, узел такта 10 МЦ вместо 8):

| Блок | МЦ | Сигналы | ПТ |
|---|---|---|---|
| Такт: делитель /3 + X1/X2 | 8 | cnt<0>, cnt<1>, cnt_0__and0000, x1_p, x1_n, x2_p, X1, X2 | 10 |
| POR + RESET_IN | 10 | por_sh<0..7>, por_run, RESET_IN (весь в FB4) | 17 |
| Защёлка адреса + демультиплексор A0-A7 | 16 | addr_latch<0..7> (FB6), A<0..7> (IO-МЦ) | 45 |
| Шина данных D0-D7 | 10 | D<0..7>, D<7>_BUFR, bus_reg<7> (OE данных) | 35 |
| Writeback-FSM + флаги | 6 | state_FSM_FFd1-3, wr_seen, rd_seen, wb_ram_q | 32 |
| Декоды ПЗУ/ОЗУ + упр. памятью | 6 | CSr_n, OEr_n, CS_n, OE_n, WE_n, CS1 | 8 |
| Клавиатура | 7 | col0-3, io_rd_kb, rd_drive, A_7_IOBUFE (row0-4 — входы без МЦ) | 11 |
| Индикация | 12 | seg<0..7>, dig<0..3> | 24 |
| UART-транзиты + звук | 10 | TX, tx_pass, sod_q, SID, SND + 5 служебных $OpTx$-декодеров | 21 |
| Константы на пинах | 1 | READY = '1' (P87) | 0 |
| **Итого** | **86** | | **203** |

Входы ФБ в таблице не выделены — они делятся между блоками
(сигнал считается один раз на ФБ независимо от числа
потребителей). Давит на входную ёмкость исчерпанных FB1/FB3
(36/36) НЕ декод памяти, а шинные трансиверы: FB1 = A<0-4> и
D<0>, D<6>, D<7> (по 6-13 входов каждый) + FSM + строки
клавиатуры; FB3 = D<1-5> (по 14 сигналов / 12 входов каждый!)
+ seg<0> + col0-3. Весь память-глю (6 выходов) опирается в
FB1/FB3 на 7 разных входных сигналов, почти все из которых
нужны и другим МЦ тех же ФБ; чистое высвобождение при полном
удалении декодов — 1-2 входа из 36.

ВЕРДИКТ ПО ПОДТЯЖКАМ (вопрос владельца 10-30: «если CS и #CS
ОЗУ подтянуть внешними резисторами — высвободит ещё пару FB?»):

| Сигнал | Пин | Что в CPLD | Резистором? | Выгода |
|---|---|---|---|---|
| CS1 = CE2 ОЗУ | P99 | константа '1' (0 ПТ, 0 входов; FB2_3) | **ДА** — 10к на Vcc, замена 1:1 | −1 МЦ, −1 нога |
| CS_n = /CE ОЗУ | P25 | декод NOT((~IOM·A15) ∨ (FFd3·wb_ram_q) ∨ (FFd2·~FFd1·wb_ram_q)); 3 ПТ, 6 входов (FB1_14) | **НЕТ**: подтяжка вверх — ОЗУ мертво (монитор и данные живут в ОЗУ); вниз — ОЗУ выбрано всегда и срывается двойная защита записи (сейчас нужен одновременно /WE=0 в фазе WB3 и защёлкнутый wb_ram_q) | (только «вниз», с рисками): −1 МЦ, −3 ПТ, FB1 −1 вход |
| READY | P87 | константа '1' (FB4_5) — вторая такая же, бонус | **ДА** — 10к на Vcc | ещё −1 МЦ, −1 нога |

ИТОГ: пара ФБ НЕ высвободится. Пара ФБ = 36 МЦ, а один выход =
1 МЦ; обе безопасные подтяжки (CS1 + READY) дают −2 МЦ (86→84)
и −2 ноги (72→70), входы ФБ не трогают; исчерпанные FB1/FB3
остаются исчерпанными (от CS_n у FB1 чистое облегчение 1 вход —
wb_ram_q: A15, IOM и биты FSM нужны в FB1 ещё и OEr_n/WE_n/
CSr_n и D-защёлке; FB3 не трогается вовсе — OE_n нужен). Даже
весь память-глю целиком (6 сигналов) — 6 МЦ ≈ треть одного ФБ.
Реальные резервы чипа и так есть: 22 МЦ, 337 ПТ, 9 ног; дефицит
только по входам ФБ (24 свободных: FB4 12, FB2 5, FB5 5, FB6 2)
— и он лечится не подтяжками, а выносом целых блоков
(клавиатура+индикация = 19 МЦ) с переделкой платы. Применимость
подтяжек — только в связке с будущим рефитом (проба v3.11 на
поднятом питании): пины P99/P87 в новом фите оставить входами
(сети подтянуты к Vcc, Hi-Z без конфликтов); на стабильном
производстве v3.9 ничего не паять и не перешивать.

## Предложение коллеги (10-30, clk10-61): удалить «избыточный» wb_ram_q — ВЕРДИКТ: ПРАВ; кандидат v3.9.1 (пока НЕ прошивать)

ПОЛИТИКА НУМЕРАЦИИ (владелец, 10-30): v3.10/v3.11 — ПОБОЧНАЯ ветка,
заморожена до подтверждения работы процессоров на 4,17 МГц; база
отсчёта = v3.9; новые ветки — v3.9.1, v3.9.2, v3.9.3, ...

Доказательство эквивалентности коллеги проверено ПОСТРОЧНО против
RTL v3.9 (top_suart_por6_v39_utf8.v, строки 741-834) — все посылки
подтвердились:

| # | Посылка коллеги | Факт RTL v3.9 |
|---|---|---|
| 1 | wb_ram_q присваивается только в ветке записи T2 | ✓ места: 715 (иниц. 0), 746 (сброс в cpu_rst), 794 (установка `!IOM && A15` в S_T2 при wr_seen && WRn) — других НЕТ |
| 2 | Установка — тем же фронтом, что вход в WB1, тем же значением | ✓ строки 794 и 797 в одном begin: `wb_ram_q <= !IOM && A15;` / `state <= (!IOM && A15) ? S_WB1 : S_IDLE;` |
| 3 | S_WB1 достижим ТОЛЬКО из этой ветки и только при !IOM && A15 | ✓ единственный `state <= S_WB1` — строка 797; остальные переходы: IDLE→T1H→T2, T2→IDLE (2 пути: стробы и ALE-глюк, 782-783), WB1→WB2→WB3→WB4→IDLE, default→IDLE |
| 4 | В WB2..WB4 не переприсваивается; сброс — только cpu_rst | ✓ строки 803-806 wb_ram_q не трогают; сброс СИНХРОННЫЙ в одном блоке со state (743+746) — оба чистятся ОДНИМ фронтом, окна «state в WB, wb=0» нет даже при cpu_rst посреди WB |
| 5 | Следовательно in_wb (state >= S_WB1) влечёт wb_ram_q == 1 | ✓ единственный читатель wb_ram_q — CS_n (829); разность функций `in_wb&&wb` и `in_wb` ПУСТА — эквивалентность полная, не только на сценариях |

УСИЛИВАЮЩИЙ АРГУМЕНТ (коллегой не назван): драйверы writeback УЖЕ
работают без wb_ram_q — A-сети (`wb_out ? addr_latch`, 818-820),
D-шина (`wb_out ? bus_reg`, 821) и WE_n = !in_welo (834) управляются
от in_wb НАПРЯМУЮ (wb_out = in_wb, 735). Если бы in_wb мог быть
истинным без RAM-записи, импульс /WE УЖЕ писал бы мимо — защёлка
ничего не страхует, реальная защита = структура FSM (WB1 только при
!IOM·A15). CS_n с wb_ram_q — единственный оставшийся в v3
belt-and-suspenders; правка делает CS_n консистентным с WB-трактом.
Деталь: та же ветка 794 СБРАСЫВАЕТ wb_ram_q в 0 при каждой не-ОЗУ
записи (ПЗУ/порт) — защёлка «дышит» следом за последней записью;
это не ломает доказательство, но объясняет её происхождение.

ЦЕНА/ВЫГОДА (фит v3.9): −1 МЦ (88→87; wb_ram_q = FB2_17, 5 ПТ,
10 входов, ЗАРЫТАЯ — пина НЕТ, «пин 14» в rpt — сосед AH11),
−5 ПТ (214→209), FB1 −1 вход (литерал wb_ram_q у CS_n, 6→4 входа),
FB2 разгружается от D-логики защёлки. Новая строка:
`assign CS_n = in_wb ? 1'b0 : (!A15 | IOM);` + удаление reg.
Исчерпанность FB1/FB3 практически не снимает (FB1 станет 35/36) —
цель правки ЧИСТОТА, не ресурс: свободно и так 20 МЦ.

ПРОЦЕСС ПРИНЯТИЯ (дисциплина аудитов): v3.9.1 = v3.9 с ЕДИНСТВЕННОЙ
правкой; симуляция эквивалентности CS_n бит-в-бит против v3.9
(ОЗУ/ПЗУ/порт записи, чтения, записи подряд, ALE-глюк в T2,
cpu_rst посреди WB1..WB4); фит владельца → .rpt на аудит (в
нетлисте wb_ram_q НЕТ, МЦ 87, CS_n без литерала) → железо:
RAM-тест 4 паттерна × 32K (методика Task 69-j) + контрольная
загрузка. Откат мгновенный (.jed v3.9 известен хороший).

РЕКОМЕНДАЦИЯ: предложение ПРИНЯТЬ. RTL v3.9.1 + симуляция ВЫПОЛНЕНЫ
(clk10-62, секция v3.9.1 ниже); производство не перешивать ради одной
правки — шить в связке с первым реальным поводом (подтяжки CS1/READY,
новая фича или проба питания). Риск низкий, но «работает — не трогай»,
пока нет повода.

## v3.9.1 (clk10-62, 2026-10-30): CS_n в writeback от состояния FSM — RTL ПРИНЯТ владельцем, эквивалентность ДОКАЗАНА

Изменение: v3.9 байт-в-байт МИНУС защёлка wb_ram_q (вердикт по
предложению коллеги — секция clk10-61 выше): удалены reg/сброс/взвод
(в v3.9 строки 715/746/794), единственный потребитель переписан:
`assign CS_n = in_wb ? 1'b0 : (!A15 | IOM);` (было
`(in_wb && wb_ram_q) ? 1'b0 : ...`). Защита записи п.5 сохранена
ПОСТРОЕНИЕМ: в WB1..WB4 CS_n=0 без A15/IOM — живой декод во время
конфликта адресов по-прежнему не участвует; /WE как был, от in_welo
(ровно 2 тика = 80 нс).

Верификация (скрипты в scripts/, Icarus Verilog 12.0 + Python):

1. ДИФСИМУЛЯЦИЯ двух RTL в одном тестбенче (scripts/tb_v391_diff.v,
   scripts/run_tb_v391.sh): общий стимул, сравнение ВСЕХ 18 выходов
   и обеих шин каждые 5 нс 4-значной логикой ===, раздельные
   виртуальные ОЗУ (лог фактических записей: адрес+данные на верхе
   /WE при активном /CE) + спек-мониторы:
   - направленные сценарии D1-D14, все ПАСС: POR/константы (RESET_IN
     ~1120 нс, X1 ровно 140 нс, X2=~X1, «8888.»); защита п.5 (запись
     ОЗУ 77<-A5 со сменой адреса на ПЗУ-овый ПОСРЕДИ WB: CS_n держится
     0 весь импульс, запись попадает по защёлкнутому адресу; после WB
     декод возобновляется); чтение ОЗУ (rd_drive) и ПЗУ; IO-запись
     при A15=1 (CS_n=1, /WE нет; порты 00h/01h/02h приняты); IO-чтение
     KBROW (mux row0-4 на A); запись в ПЗУ отброшена; PUSH-стресс
     4 записи подряд с зазором 2 тика (лог 20<-11, 1F<-22, 1E<-33,
     1D<-44); «дыхание» защёлки (RAM-запись -> IO-запись: CS_n=1);
     ALE-глюк 1 тик в T2 (abort, записи нет, машина жива) и 2 тика
     (запись НЕ теряется — завершается штатно с ИСХОДНЫМ адресом,
     защита п.6); cpu_rst в WB1/WB2/WB3/WB4 и в T2 (импульс /WE
     гасится, после сброса запись работает); TX-захват v3.7.
   - случайный стимул: 4 сида x 2500 циклов = 10 595 циклов, из них
     3828 RAM-записей, 1264 IO/ПЗУ-записей, 3033 чтения, 674 ALE-глюка,
     475 случайных сбросов (17 в окне низкого /WE): расхождений
     выходов/шин 0, логи виртуальных ОЗУ ИДЕНТИЧНЫ (4077/4077 записей
     байт-в-байт), спек-нарушений 0 (/WE ровно 80 нс, t_AS >= 40 нс,
     /WE=0 => /CE=0).
   - побочные находки (поведение v3.9-идентичное): зазор <= 1 тик
     «глотает» ALE следующего цикла (задокументированное окно п.4);
     при сбросе посреди импульса /WE окно декода в момент обрыва
     определяет, попадает ли обрывающаяся запись в лог ОЗУ.

2. ФОРМАЛЬНОЕ ДОКАЗАТЕЛЬСТВО (scripts/sim_v391_equiv.py): полный
   перебор произведения машин (state, rd_seen, wr_seen, wb_ram_q) x
   64 комбинации входов (cpu_rst, ALE, WRn, RDn, IOM, A15) от
   стартового состояния: 28 достижимых состояний из 112, 1792
   перехода — 0 расхождений выходов и переходов; инвариант коллеги
   «in_wb => wb_ram_q=1» подтверждён на ВСЕХ достижимых состояниях;
   «дыхание» защёлки (wb=1 вне WB: IDLE/T1H/T2) замаскировано гейтом
   in_wb; все 20 состояний «in_wb=1 при wb_ram_q=0», на которых
   функции CS_n РАЗЛИЧАЮТСЯ, — НЕДОСТИЖИМЫ из сброса. Индукция по
   длине входного слова => v3.9.1 == v3.9 для ЛЮБЫХ входных
   последовательностей. Контроль: 10^7 случайных шагов — 0
   расхождений.

Статус: RTL принят владельцем (10-30) — «это шаг, который нужно
проверить в железе». Дальше: фит в ISE -> .rpt на аудит (ожидания:
wb_ram_q в нетлисте НЕТ, МЦ 87, ПТ ~209, CS_n от state_FSM_FFd1..3 +
A15/IOM) -> RAM-тест 4 паттерна x 32K + контрольная загрузка ->
прошивка в связке с первым реальным поводом (подтяжки CS1/READY,
новая фича, проба питания). Откат мгновенный (.jed v3.9 известен
хороший).

## v3.9 (clk10-54/55, 2026-10-29) — кольцо 5 → 7 триггеров: X1 = 7,14 МГц, CPU = 3,57 МГц (РАБОТАЕТ НА ПЛАТЕ)

Директива владельца: «Предлагаю уйти на 7 триггеров и частоту
X1 - 7.14МГц». Предыстория: нестабильный запуск на v3.8 (простые
тесты запускаются через раз, запустившись — работают; сигналы
живые: адреса, ALE, сброс, X1/X2 в противофазе) + подтверждение
владельца: «у меня ИМ1281ВМ85А, наверное 5МГц не достижимо».
Владелец и коллега просчитали ряд частот из 25 МГц по длине
кольца N (N=5 → 10,00 МГц — текущий; N=7 → 7,14; N=9 → 5,56;
N=11/13 — уже не ложатся в бюджет) и выбрали N=7.

| Параметр | v3.8 (N=5) | v3.9 (N=7) |
|---|---|---|
| X1/X2 | 10,00 МГц (100 нс) | 7,143 МГц (ровно 140 нс) |
| Duty X1 | 60/40 | 71/29 (high 100 / low 40 нс) |
| CPU (внутр. /2 по фронтам) | 5,000 МГц | 3,571 МГц (ровно 280 нс, 50/50) |
| por_ce | 120/80 нс (среднее ровно 100) | 200/80 нс (среднее ровно 140) |
| POR | 800 нс (норма 600) | 1120 нс (норма 3×280 = 840; запас 1,33× — тот же) |
| Терминал | 9600 8N1 | **6857 8N1** (1920 × 25/7) |
| Регистры узла | r0..r4 + x1_n = 6 FF | r0..r6 + x1_n = 8 FF (+2) |
| x1_n set/clear (negedge) | r2 / r3 | r3 / r4 (SET=(N-1)/2, CLR=(N+1)/2) |
| por_ce (уравнение) | r1 \| r4 | r1 \| r6 |
| Самоочистка | одинарный kill | **двойной kill** (см. ниже) |

КЛЮЧЕВАЯ НАХОДКА симуляции (до фита!): формула коллеги
`r_i <= r_{i-1} & ~r_{i+1} & ~r_i` для N=7 НЕ гасит пары '1' на
дистанции 3-4 — 14 состояний из 128 ОРБИТИРУЮТ ВЕЧНО (в N=5
проблемы нет: малое кольцо сталкивает пары при обходе — потому
v3.8 прошёл полный перебор). В v3.9 самоочистка УСИЛЕНА двойным
kill: `r_i <= r_{i-1} & ~r_i & ~r_{i+1} & ~r_{i+2}`. Разбор всех
зазоров: gap-1 → 00 → рестарт; gap-2/3 — последователь блокирован
своим kill-хвостом, лидер идёт; gap-4 — лидера блокирует его
собственный kill-литерал через wrap (~r_{q+7} = ~r_q). Итог: ЛЮБОЕ
из 128 состояний → one-hot за ≤ 2 фронта (полный перебор). На
легальном цикле поведение = формуле коллеги байт-в-байт (200 мкс).

Верификация (`scripts/sim_v39_ring7.py`, точная семантика RTL,
200 мкс + перебор 128 состояний): **ПАСС** — X2 == ~X1
(10000/10000), one-hot 10000/10000; узор X1 «1111100»; фронты
ровно через 140 нс (7,143 МГц); CLK CPU ровно 280 нс 50/50;
por_ce 10/4 полутакта (200/80, среднее ровно 140); POR 1140 нс ≥
840 (запас 1,33×); x1_n — ровно один импульс 40 нс за период
кольца; живучесть ≤ 2 posedge; explicit == generic-формула на
легальном цикле.

Автомат шины НЕ тронут (домен 25 МГц): /WE 80 нс, t_AS 40 нс —
фиксированные. При T=280 нс зазор WR#(вверх)→след.ALE сжимается до
~0,25..0,45 T = 70..126 нс (при T=400 было 100..180); окно захвата
T1H = gap + ~0,9T − 160..200 нс на WB-цепочку → запас ~120..220 нс
(3..5 тактов 25 МГц) — закрыт, НО коэффициенты сняты платой при
T=1280: после фита ПЕРЕИЗМЕРИТЬ зазор на осциллографе (п.4 шапки;
арбитр — осциллограф, как и для фазы X1/X2).

Бюджет (ПРОГНОЗ подтверждён фиттом 10-29 8:45PM): +2 МЦ (r5/r6) →
88/108 (прогноз ~89); птермы 214/540 (прогноз ~209, +5 — kill-литералы
r5/r6 и ветка r6 в por_ce); входы ФБ 202/216 (прогноз 201-204 — точно);
триггеры 59/108 (арифметика бит-в-бит: 57 + r5 + r6). Кольцо легло
КОМПАКТНО: r0..r6 ВСЕ в FB4 (r0 — FB4_10, 2 PT/7 вх из-за двойного
kill + рестарт NOR), x1_n — в FB5, ядра X1/X2 — в FB6.

Последствия: терминал **6857 8N1** (ПЗУ fw_mon v5 не перешивается:
бод = 1920 × f_CPU: 4800@2,5 → 6000@3,125 → 9600@5 → 6857@3,571;
CH340G произвольные боды держит); CLK OUT = 3,571 МГц duty 50%;
POR 1120 нс; t_RD/t_WR CPU растут — маржа памяти увеличивается.
TX-захват v3.7 по уровню — частотно-независим, не тронут.
Если 3,57 МГц окажется за гранью и для этого экземпляра —
следующий шаг ряда: N=9 (X1 5,56 МГц, CPU 2,78 МГц, +4 FF) — по
бюджету ложится.

## Аудит фита v3.9 (clk10-55, 2026-10-29) — 8:45PM, .rpt ПОЛНЫЙ 63 333 б

Фит владельца `retro_pcld_top (v39).rpt` (10-29 8:45PM, XC95108-15-PQ100,
Fitting Status: Successful, 0 ERROR, warning 897 — 1, тот же буфер D<7>
в FB1, что и в v3.8). Отчёт ПОЛНЫЙ (краша писателя нет, Equations
дописаны до конца, Compiler Options в хвосте). Структурная часть —
ПАСС по всем пунктам чек-листа:

| Проверка | Результат |
|---|---|
| Ресурсы | МЦ 88/108 (81%), птермы 214/540 (40%), входы ФБ 202/216 (94%), триггеры 59/108, ноги 72/81 (72/72 по UCF) |
| vs прогноз | МЦ ~89→88 ✓, PT ~209→214 (+5: kill-литералы r5/r6, ветка r6 в por_ce), входы ФБ 201-204→202 ✓, FF 59→59 ✓ бит-в-бит |
| Кольцо | r0..r6 ВСЕ в FB4 (r0 FB4_10, r1 FB4_8, r2 FB4_7, r3 FB4_6, r4 FB4_4, r5 FB4_2, r6 FB4_1); r_i = 1 PT/4 вх (двойной kill), r0 = 2 PT/7 вх (kill от r6 + рестарт NOR — фиттер минимизировал без ~r6 во втором терме, эквивалент) |
| x1_n | FDCPE на NOT clk (GCK2), D = r3 \| (NOT r4 AND x1_n) — set r3/clear r4 ✓ (SET=(N-1)/2, CLR=(N+1)/2), Init=RESET |
| X1/X2 | `X1 <= NOT (r0 XOR x1_n)`, `X2 <= r0 XOR x1_n` — XOR-ядра 2 PT/2 вх, регистров на пинах нет, NOT только у X1 (X2=~X1) ✓ |
| por | por_ce = r1\|r6 литерально во всех por_sh_D (shift/hold), por_sh 8×SET (INIT=FF), por_run.D=por_sh(0) SET, RESET_IN = NOT por_run AND NOT RST (P84) ✓ |
| v3.7 TX | TX Init=SET, FDCPE PRE=NOT RESET_IN — в сбросе линия '1' ✓; tx_pass async clear NOT RESET_IN, sod_q = сэмпл SOD ✓ |
| Мусор legacy | cnt/x1_p/x2_p/t0_q/x1_q/x2_q/txm_cnt в нетлисте НЕТ ✓ (элайзятся) |
| Исчерпанные ФБ | 4 записи: FB1 (вх), FB3 (вх), FB4 (МЦ 18/18), FB6 (вх 36/36 — дожат веткой r6 в por_ce; v3.8: 3) |
| GCK | ~clk → GCK2 (x1_n), clk → GCK3 — как v3.8 ✓ |
| Fmax | не считывался (путь кольца = 1 локальный птерм — как v3.8) |

ВЕРДИКТ: .jed этого фита соответствует RTL v3.9, УЖЕ ПРОШИТ И РАБОТАЕТ
на плате (запуск стабильный). Обязательные точки п.15/TODO 78 (фронт
X1 7,14 МГц 71/29, X2 противофаза, CLKOUT 3,57 МГц 50/50, RESET_IN
~1,12 мкс, терминал 6857 8N1) — подтвердить осциллографом/терминалом
при удобной ревизии; работа платы их де-факто подтверждает.

## v3.8 (clk10-52, 2026-10-29) — делитель = one-hot кольцо вместо двоичного mod-5

Идея владельца и коллеги: «использовать как основу кольцевой счётчик на
сдвиговом регистре; +2 триггера против текущего — высвободит нужные
ресурсы по FB». Вердикт: **идея верная, и она оказалась даже дешевле,
чем думали авторы** — вместо +2 триггеров узел стал на 1 триггер
КОРОЧЕ. Ресурсная стена по фиту v3.6 (10-29): МЦ 102/108, входы ФБ
197/216 — жмут именно ВХОДЫ ФБ (4 ФБ на 35-36/36, FB6 Exhausted),
птермов свободно 50%. Узел платил входную ренту сразу в два ФБ:
FB6 (пины X1/X2) ел cnt<0..3> + x1_p/x2_p/x1_n = 7 входов, FB4 —
cnt<0..3> + x1_n = 5 (+копия декода por_ce $OpTx$FX_DC$163 на 4
литерала cnt).

Что сделано (п.14 шапки v3.8):

| Элемент | v3.6 (mod-5) | v3.8 (кольцо) |
|---|---|---|
| Регистры узла | cnt<0..3> (4! cnt<3> — балласт 4-го бита) + x1_p + x1_n + x2_p = 7 FF | r0..r4 + x1_n = 6 FF (**−1 МЦ**) |
| Декоды равенства | 4 шт (==4 wrap ×2, ==1, ==2, ==3) — класс п.9, аудит «обе полярности!» на каждом фите | **0** (состояние = выход триггера; терять полярность нечему) |
| x1_p/x2_p | отдельные триггеры-двойники | **сокращены**: x1_p ≡ ~r0, x2_p ≡ r0 (один posedge) |
| X1/X2 | x1_p^x1_n / x2_p^x1_n | (~r0)^x1_n / r0^x1_n — SOP по 2 птерма, функции различны (same-D слияние невозможно, п.10) |
| por_ce | (cnt==4)\|(cnt==1), 2 птерма × 3-4 литерала | r1\|r4 — 2 птерма × 1 литерал |
| Птермы узла (с копией декода) | 11 | 8; макс. ширина литерала 4 → 2 |
| Входы ФБ от узла | FB6: 7, FB4: 5 | FB6: 6, FB4: 0..2 |
| Нелегальные состояния | выплывает до 12 тактов | **≤2 фронта** (самоочистка «убей преемника» + рестарт из 00; наивное кольцо НЕ годилось: пара '1' ходит вечно, 00000 = мёртвый клок) |

Ключевые эквивалентности (доказаны трассировкой фронтов, закреплены
симуляцией): x1_p(t) ≡ ~r0(t) и x2_p(t) ≡ r0(t) после любого posedge;
x1_n — без изменений (set r2 / clear r3 = те же фронт-пары, что
cnt==2/3). Единственное отличие от v3.6 — до ПЕРВОГО posedge X1='0'/
X2='1' (v3.6: 1/0): CPU всё это время в POR, схемно незначимо; с
первого фронта X1/X2/por_ce/por_run совпадают с v3.6 пофронтово.

Верификация (`scripts/sim_v38_ring.py`, точная семантика RTL, 200 мкс):
**ПАСС** — X1/X2/por_ce байт-в-байт == v3.6 на всех полутактах с первого
posedge; узор «11100» (10,000 МГц, 60/40); CLK CPU ровно 200 нс 50/50;
por_ce 6/4 (среднее ровно 100 нс); POR 800 нс; one-hot инвариант
10000/10000; живучесть: ЛЮБОЕ из 32 состояний кольца → one-hot за ≤2
фронта; por_run снимается в тот же полутакт, что и в v3.6.

Прогноз ресурсов против фита v3.6: 102 → ~93 МЦ (с учётом −7…−8 от
v3.7), входы ФБ 197 → ~191, декоды равенства в тактовом тракте — 0.

### Аудит фита v3.8 (clk10-53, 2026-10-29) — .rpt 4:39PM: 15/15 ПАСС, .jed можно строить

Файл: `retro_pcld_top (v38).rpt` (в комплекте), 10-29 4:39PM,
Successful, **ПОЛНЫЙ** — 62 811 байт / 1192 строк, хвост Device Pin Out
+ Compiler Options на месте (фикс libPortabilityNOSH сработал, обрыва
как у фита v3.6 нет), 0 ERROR, WARNING:Cpld:897 — **1** (v3.6: 7):
только историческая D<7>/FB1, шина D вернулась в IO-МЦ.

Ресурсы против фита v3.6 (10-29 6:59AM):

| Ресурс | v3.6 | v3.8 | Δ |
|---|---|---|---|
| МЦ | 102/108 (94%) | **87/108 (81%)** | **−15** (прогноз ~93 — факт лучше) |
| Птермы | 271/540 (50%) | **206/540 (38%)** | **−65** |
| Входы ФБ | 197/216 (91%) | 199/216 (92%) | +2 (нюанс ниже) |
| Триггеры | 63/108 | 57/108 | −6 (−14: cnt<3:0>+x1_p+x2_p+txm_cnt; +5 кольцо; +3 v3.7 — сходится бит-в-бит) |
| Исчерпанные ФБ | 6 записей в 5 ФБ (FB1-вх, FB2-МЦ, FB3-МЦ+вх, FB5-МЦ, FB6-вх) | **3 записи в 3 ФБ** (FB1-вх, FB3-вх, FB4-МЦ) | FB2/FB5/FB6 освобождены целиком |

Сверка уравнений с пунктом h) шапки (байт-в-байт):

| # | Пункт | Факт в .rpt | Вердикт |
|---|---|---|---|
| 1 | r1.D = r0 AND NOT r2 | точно | ПАСС |
| 2 | r2.D = r1 AND NOT r3 | точно | ПАСС |
| 3 | r3.D = r2 AND NOT r4 | точно | ПАСС |
| 4 | r4.D = r3 AND NOT r0 | точно | ПАСС |
| 5 | r0.D: сдвиг + рестарт из 00, 2 птерма | (NOT r0 AND NOT r1 AND r4) OR (NOT r0 AND NOT r2 AND NOT r3 AND NOT r1) — фиттер выбросил NOT r4 из рестарта (состояние {r4} уже покрыто 1-м термом), эквивалентно RTL (проверено перебором) | ПАСС |
| 6 | Init r0=SET, r1..r4=RESET; кольцо posedge | Reg Init по колонке; все FDCPE_r* на clk | ПАСС |
| 7 | x1_n NEGEDGE, D = (r2) OR hold OR ~r3 | FDCPE(x1_n,…,NOT clk,…) — GCK2 = комплемент clk; D = (r2) OR (NOT r3 AND x1_n); Init=RESET | ПАСС |
| 8 | X1 = (~r0)^x1_n, X2 = r0^x1_n, без регистров на пинах | X1 = NOT(x1_n XOR (r0)), X2 = x1_n XOR (r0) — по 2 птерма/2 входа {r0,x1_n}, Reg Init пуст, NOT только у X1 → X2 = ~X1; МЦ FB6_3/FB6_5 раздельны (same-D слияние невозможно) | ПАСС (полярность XOR-B в рендере невидима — класс clk10-48; арбитр — осциллограф, TODO п.4) |
| 9 | por_ce = r1 OR r4, декодов равенства нет | $OpTx$FX_DC$533 = NOT r1 AND NOT r4 (1 птерм, литеральный); por_sh_D(i) = hold при $533 / сдвиг при r1\|r4 — пофронтово как v3.6; вопрос clk10-50 о фазе DC$163 снят по построению | ПАСС |
| 10 | por_sh 8 бит, Init=SET ×8; por_run.D = por_sh(0), Init=SET; RESET_IN = ~por_run & ~RST | точно (P84) | ПАСС |
| 11 | cnt/x1_p/x2_p/t0_q/x1_q/x2_q/txm_cnt в нетлисте отсутствуют | grep по полному отчёту — 0 упоминаний | ПАСС |
| 12 | v3.7 на месте: sod_q/tx_pass, TX Init=SET + async set при сбросе | sod_q FB6_6 (RESET), tx_pass FB4_8 (RESET), TX = IO-МЦ P39: Init=SET, PRE = NOT RESET_IN → в POR/RST линия TX = '1' (фантомного фрейма нет); SID <= RX (1 птерм/1 вход) | ПАСС |
| 13 | Ноги 72/72 по UCF; PGND = {74,75,76,78,79,81,95,96,98}; P73=SID | точно по Device Pin Out | ПАСС |
| 14 | GCK3 = clk, GCK2 = ~clk; GSR/GTS/GOE не используются | точно; RST на GSR-пине P1, GSR net unused | ПАСС |
| 15 | state = 3 триггера (без FFd4) | state_FSM_FFd1..3 | ПАСС |

Нюансы (не блокируют):
- Входы ФБ 199 (+2 к v3.6) вместо прогнозных ~191: кольцо фиттер
  разбросал (FB4 исчерпан по МЦ → r1 лёг в FB6), кросс-импорты соседей
  подняли FB4 с 20 до 30 входов. Суть гипотезы не в тотале, а в
  исчерпании: стена «4 ФБ на 35-36/36» убрана — FB6 35/36, FB5/FB2
  31/36; оставшиеся FB1/FB3 (36/36) — шинная логика D/A, узлу
  тактирования они больше ничего не должны.
- FB4 18/18 по МЦ — «полная, но здоровая» ячейка: 52 птерма и 6 входов
  свободны, узел живёт локально.
- Fmax (.tim) не считался; критический путь кольца — 1 локальный
  птерм, запас против 25 МГц многократный.

## v3.7 (clk10-51, 2026-10-29) — TX-маска удалена: захват по первому SOD='1'

Директива владельца: «почему мы вообще должны обращать на TX особое
внимание, если он полностью определяется софтом? Артефакт можно вырезать
полностью: один триггер, в сбросе CPLD — '1', INIT='1', задержка
стробирования на 25 МГц — ничто». Вердикт: ПРА на ~90% — механизм
(регистр, INIT=1, async set, 25 МГц) принят дословно; НО голый транзит
возвращал бы баг v2-эпохи: сброс CPU очищает SOD в '0' (датасшит
IM1821ВМ85А, вывод SR: «...триггеров входа INR4 и ВЫХОДА TFD...»), и до
первого SIM прошивки (~4-20 мкс, TXIDLE fw_mon v5) линия '0' = «фиктивный
start-bit» → пустой фрейм в терминале — ровно то, против чего маска
заводилась. Окно закрыто СХЕМНО, без счётчика:

| Триггер | Роль | Сброс/INIT |
|---|---|---|
| `sod_q` | синхронизация входа SOD по clk 25 МГц (метастабильность гасится до использования; статический путь пин→пин разорван) | без сброса, INIT=0; должен лечь в IO-MC входа SOD P72 |
| `tx_pass` | «линия захвачена прошивкой»: взводится первым сэмплом SOD='1' после сброса | async clear по cpu_rst, INIT=0; 1 лог. MC |
| `tx_q` | выходной регистр TX: до захвата — '1' (чистый idle), после — транзит sod_q | async set по cpu_rst, INIT=1; должен лечь в IO-MC пина TX P39 |

Что это даёт против v3.6: txm_cnt<7:0> (8 FF, ~9 МЦ, почти весь FB4) и
параметр TXM_W удалены → прогноз ~102 → **~94/108 МЦ**; окно SOD=0 покрыто
ПО СТРОЕНИЮ (TXM_W, запас 1,28x и привязка к частоте X1/CPU упразднены —
работает на 3,125/5/6,25 МГц и с любой длиной init); сброс/кнопка уводят
TX='1' мгновенно (async set, без клока); латентность транзита 40-60 нс
(0,2-0,3 такта CLK 200 нс; 0,05% бита 9600). Требование к прошивке одно:
первое касание SOD после сброса = SOD:=1 (fw_mon v5 делает это в TXIDLE;
любой soft-UART начинает кадр с idle '1'). Теоретическая уязвимость
(документирована в п.13 шапки): импульс SOD='1' длительностью ≥1 такта
25 МГц в окне ложно открыл бы захват — физически невероятен (вход CPU в
сбросе статичен, звон шины мВ-уровня до VIH не достаёт); лечение, если
когда-нибудь проявится: захват по 2 сэмплам подряд (+1 FF).

Верификация (`scripts/sim_v37_txpass.py`, точная семантика RTL, 4,0 мс):
**ПАСС** — регрессия делителя v3.6 байт-в-байт (узор «11100», период ровно
100 нс, CLK ровно 200 нс 50/50, por_ce 6/4, POR 800 нс); TX='1' от INIT и
на всём cpu_rst; окно SOD=0 **112 мкс** (в 4,4 раза длиннее маски v3.6 —
у «голого транзита»/v3.6-счётчика здесь был бы фантом-фрейм) — TX='1' без
счётчика; захват ≤60 нс после TXIDLE; кадры 9600 8N1 и стресс 8 мкс/бит —
бит-в-бит, латентность 40/60 нс (обе фазы сэмпла); кнопка RST в середине
старт-бита — TX='1' в тот же полутакт (async), повторный захват и кадр —
норма; INFO: 1-тактный импульс SOD в окне ложно открывает захват
(см. теоретическая уязвимость выше).

Обязательные точки фита v3.7 (в дополнение к чек-листу v3.6): txm_cnt/
txm_run в Equations ОТСУТСТВУЮТ; tx_q — регистр IO-MC пина TX P39
(Init=SET, async set = RST+por_run); sod_q — IO-MC входа SOD P72 (если
фиттер положил в лог. MC — тоже норм, +1 МЦ); tx_pass — 1 лог. MC
(Init=RESET); декодов (==, !=) в TX-тракте НЕТ.

## Аудит фита v3.6 10-29 6:59AM (clk10-50) — ЧАСТИЧНЫЙ: .rpt ОБРЕЗАН крашем

Файл: `retro_pcld_top (1029-0659AM).rpt` (в комплекте), 49 470 байт.
**Ключевой факт: cpldfit завершил ФИТ (`Fitting Status: Successful`, полные
таблицы ресурсов/FB-деталей), но упал ПОСРЕДИ записи секции Equations** — файл
обрывается на уравнении `OEr_n`; отсутствуют уравнения por_*/txm_cnt/X1/X2/
x1_p/x2_p/cnt/state и хвостовые секции (у эталонного фита v3.5 после Equations
ещё ~150 строк + блок Compiler Options; 69 КБ). Диагноз «красного креста»
уточнён: падение — в писателе отчёта, НЕ в подгонке и НЕ в HTML-генерации
(отчёт текстовый). Лекарство то же: libPortabilityNOSH.dll → libPortability.dll
в `ISE\lib\nt64` И `common\lib\nt64`, проект ПОЛНОСТЬЮ вне синхронизируемых
папок, исключения антивируса → Re-Run Implement → полный .rpt (~70 КБ,
хвост с Compiler Options) + .tim.

Проверено по видимой части (Mapped Resource Summary / FB Details):

| # | Пункт чек-листа | Факт в .rpt 10-29 | Вердикт |
|---|---|---|---|
| a | clk P29 GCK3; RST P1 | clk FB1_16 P29 GCK; RST FB2_5 P1 GSR/I/O входом | ПАСС |
| b | ноги по UCF | все 72/72 совпали (X1 P68, X2 P69, SOD P72, RX P38, CLKOUT P83, AH8-14…) | ПАСС |
| c | PGND-ноги без сигналов | P74/78/79/81 в таблицах отсутствуют; P75/76/95/96/98 — только (b)-позиции закопанных МЦ (x2_p, addr_latch<0>, txm_cnt<7>, x1_n, por_run); P73 = SID задействован | ПАСС (строка опции — в отрезанном хвосте) |
| d/e | входы/выходы | READY P87 и CS1 P99 — константы; SID = 1 PT/1 вход (чистый транзит RX); TX P39 = 1 PT/12 сигналов (маска) | ПАСС |
| f | GSR не используется | «Global set/reset net(s) unused» | ПАСС |
| g1 | MC < 108 | 102/108 (прогноз ~98: +cnt<3> — RTL объявляет reg[3:0], mod-5 использует 3 бита, cnt<3> безопасно висит в '0' (D = cnt0&cnt1&cnt2, состояние недостижимо); +2 хелпера фиттера DC$163/SC$164) | ПАСС |
| g2 | мусор div4 отсутствует | t0_q/x1_q/x2_q В НЕтлисте НЕТ (FB2_1 теперь txm_cnt<5>; в фите v3.5 там был t0_q); ровно cnt<3:0>+x1_p+x1_n+x2_p; FF = 63 = 59−3+7 ТОЧНО | ПАСС |
| g3 | X1/X2 без регистров на пинах | X1/X2 — комбинационные (Reg Init пуст): X1 = f{x1_p, x1_n} 2 PT (FB6_3/P68), X2 = f{x2_p, x1_n} 2 PT (FB6_5/P69) — фиттер НЕ поднял XOR-пары в регистры | ПАСС |
| g4 | init-полярности | x1_p FB6_6 **SET**, x1_n FB4_15 **RESET**, x2_p FB6_4 **RESET**, cnt<3:0> **RESET**×4, por_run FB2_2 **SET**, por_sh<0..7> **SET**×8 — всё по RTL | ПАСС |
| g5 | negedge-ветка в нетлисте | **комплемент clk на GCK2** (в v3.5 был GCK3-only) — прямое следствие `always @(negedge clk)` для x1_n | ПАСС (ожидаемое отличие от v3.5) |
| h | уравнения декодов (==4/==1/==2/==3, wrap-инверсия, D(x1_p)/D(x2_p), negedge-D(x1_n), por_ce, por_run.D=por_sh[0], TX) | **в отрезанном хвосте — непроверяемо** | **БЛОК** |
| g6 | Fmax >> 25 МГц | нужен .tim (не создан) | **БЛОК** |

Зафиксировано для первоочередной проверки в полном отчёте:
1. `$OpTx$FX_DC$163 = (cnt==1)|(cnt==2)` — по RTL por_ce = (cnt==4)|(cnt==1).
   Если DC$163 питает por_ce — фаза сэмплов сдвинута (длительности POR 800 нс
   и TX-маски 25,6 мкс НЕ изменятся — любые 2 сэмпла за 200 нс), но сверить.
2. Полярности ВСЕХ декодов ветки — класс отказа п.9 (фиттер терял их трижды).

**Вердикт clk10-50: 8/10 ПАСС, 2 БЛОК → шить запрещено (правило «ДО АУДИТА НЕ
ШИТЬ»), пересборка обязательна в любом случае — нужен ЦЕЛЫЙ .rpt.**

## v3.6 (clk10-49, 2026-10-29) — полуцелый делитель 25/2,5 → X1/X2 = 10 МГц

Решение владельца: внешний каскад НЕ трогаем (U7 → шунт H1 1-2, DIV=GND, /4 →
GCK3 = 25,00 МГц), делитель перестраивается ВНУТРИ дизайна. Вариант «/2»
(12,5 МГц → CPU 6,25 — ВНЕ ТУ) отклонён владельцем как разгон. Цель:
X1/X2 = 10 МГц → внутренний /2 ВМ85А → **CLK = 5,000 МГц — ровно паспортный
максимум**.

25/10 = 2,5 — деление полуцелое, toggle-каскадом недостижимо. Новая ветка
`g_div2p5` (выбор: CLK_DIV=2 + НОВЫЙ параметр CLK_HALF=1): mod-5 счётчик
(cnt, posedge) + пара x1_p (posedge) / x1_n (negedge), X1 = x1_p ^ x1_n:

| Сигнал | Тактирование | D / условие | INIT | Интервалы '1' |
|---|---|---|---|---|
| cnt (mod-5) | posedge | (cnt==4) ? 0 : cnt+1 | 0 | — |
| x1_p | posedge | (cnt != 4) | 1 | [0,160)+[200,360)… нс (по 160) |
| x1_n | **negedge** | set cnt==2 / clear cnt==3 | 0 | [60,100)+200k (по 40 нс) |
| x2_p | posedge | (cnt == 4) = НЕ D(x1_p) | 0 | = ~x1_p |
| X1 | — | x1_p ^ x1_n (комб.) | — | узор «11100» по полутактам |
| X2 | — | x2_p ^ x1_n (комб.) | — | = ~X1 ТОЧНО |

Ключ: у «наивного» posedge-деления /2,5 фронты 80/120 нс (период плавает);
negedge-сдвиг x1_n выравнивает ПЕРИОД — фронты X1 через РОВНО 100 нс
(10,000 МГц, high 60 / low 40). Duty X1 процессору безразличен: внутренний /2
тактируется ФРОНТАМИ → CLK = 5,000 МГц, период РОВНО 200 нс, duty РОВНО 50/50
(лучше, чем 40/60 у наивного варианта).

Гарантия противофазы v3.5 сохранена ПО ПОСТРОЕНИЮ: D(x2_p) = (cnt==4) ≠
D(x1_p) = (cnt≠4), INIT инверсный → same-D слияние невозможно; X2 = x2_p ^
x1_n = ~x1_p ^ x1_n = ~X1 ТОЧНО. Регистры ТОЛЬКО существующие
(cnt/x1_p/x1_n/x2_p) → прогноз ~98/108 MC (−t0_q/−x1_q/−x2_q ветки div4,
+cnt 3 +x1_p +x1_n +x2_p).

Верификация (`scripts/sim_v36_div2p5.py`, точная семантика RTL, 200 мкс):
**ПАСС** — инвариант X2==~X1 (10000/10000 полутактов), узор X1 «11100»,
период РОВНО 100 нс, CLK процессора РОВНО 200 нс / 50/50, por_ce 120/80 нс
(среднее ровно 100), POR 820 нс ≥ нормы 600 нс, TX-маска 25,5 мкс. Регрессия
v3.5-веток (2/4/5/6/8/10) — ПАСС (`scripts/sim_v35_x2phase.py`).

Последствия (пересчёт от v3.4, всё в ТУ): CLKOUT = 5,000 МГц duty 50%; POR
800 нс (запас 1,33x — тот же); окно TX-маски 25,6 мкс против окна SOD=0
~4-20 мкс (запас 1,28x — тот же, TXM_W=8 не тронут); терминал 6000 → **РОВНО
9600 8N1** (ПЗУ fw_mon v5 не перешивается: 4800 @ 2,5 → 6000 @ 3,125 → 9600
@ 5 МГц).

ВНИМАНИЕ (п.9 шапки v3.6): в ветке 4 ДЕКОДА (==4/==1/==2/==3) — mod-5 иначе
недостижим; аудит .rpt по чек-листу g)-h) ОБЯЗАТЕЛЕН (полярности декодов,
wrap-ветка счётчика!). UCF — без изменений (ноги те же).

---

## История v3.5: почему вердикт clk10-46/47 снят (доказательство clk10-48)

База: стабильный релиз **v3.4** (`hdl/top_suart.v`, коммит `670c4da`, фит
2026-10-27 10:06PM: 95/108 MC, 243/540 PT, 213/216 FB-входов, 59/108 FF,
72/72 ноги по UCF, GCK3-only, GSR не используется — железо ПАСС clk10-38).
`hdl/` не тронут (правило №1 beta/): v3.5 живёт ТОЛЬКО здесь, в `hdl/`
переедет отдельным релизом по команде владельца.

## Почему вердикт clk10-46/47 снят (доказательство clk10-48)

1. cpldfit — технологический фиттер: он НЕ ИМЕЕТ ПРАВА менять функцию
   пришедшего нетлиста.
2. Фит v3.4 (hdl/retro_pcld_top.rpt, 10-27 10:06PM) собран из комбинационного
   `assign X2 = ~X1` — его функция ОБЯЗАНА быть «X2 = ¬X1» при всех t. Фиттер
   реализовал её законной репликацией регистра: `FDCPE(X2, X2_D, clk)`,
   Init X2=RESET (комплементарен X1=SET). Такая репликация корректна ТОЛЬКО при
   `X2_D = ¬(X1 XOR t0_q)` — т.е. инверсия свёрнута ВНУТРЬ пятого (XOR-B)
   продукта макроячейки XC9500 (PT5 = {¬t0_q}); выходной pin = Q, Init=RESET —
   всё сходится. (Аргумент clk10-47 «свёртка исключена, init был бы SET»
   разбирал свёртку на ВЫХОДЕ (pin=~Q); свёртка на ВХОДЕ XOR init не меняет.)
3. Этот v3.4-фит рендерится в отчёте БАЙТ-В-БАЙТ той же строкой
   `X2_D <= X1` / `XOR` / `X2_D <= t0_q` — следовательно, такая строка НЕ
   РАЗЛИЧИЕТ XOR и XNOR: рендерер pseudo-VHDL слеп к полярности XOR-B входа
   (при этом NOT внутри AND-термов он печатает исправно — вся таблица
   txm_cnt/A_I это показывает). В целом .rpt cpldfit для XC9500 других XOR
   не содержит — калибровочного примера нет, и.literal «same-D» читать нельзя.
4. Следствие: **по .rpt фиты v3.4 и v3.5 неразличимы в принципе** — явный
   регистр v3.5 `x2_q <= ~(x1_q ^ t0_q)` оптимизируется в ТО ЖЕ 2-PT
   XOR-ядро (FB6: X2 = 2 PT / 2 вх {X1, t0_q}). Дифф hdl(10-27) vs 6:20PM —
   506 строк: дата, переименования $OpTx$, перестановка слагаемых — это
   ожидаемая картина ОДИНАКОВОГО нетлиста, а не улика «старого исходника».
   «Сети x2_q нет» — тоже не улика: регистр, управляющий портом, фиттер всегда
   переименовывает в имя порта (X2).
5. Железный аргумент: при same-D X2(n+1) = X1(n+1) — противофаза
   схлопывается за 1 такт после POR. Устойчивая противофаза на осциллограмме
   = исполняется X2 = ¬X1. Осциллограф и .rpt теперь говорят одно и то же.

## Аудит фита 10-28 6:20PM (retro_pcld_top.rpt, добавлен в комплект)

| # | Пункт чек-листа | Факт в .rpt | Вердикт |
|---|---|---|---|
| 1 | X2 — регистр, D ≠ D(x1) | `FDCPE_X2` (регистр, НЕ комб. инвертор), D через макроячеечный XOR от {X1, t0_q}; полярность XOR-B PT рендером не показывается, same-D опровергнут п.2–5 выше | ПАСС (с оговоркой формата отчёта) |
| 2 | Init-полярности | X1 FB6_3/P68 **SET**; X2 FB6_5/P69 **RESET**; t0_q FB2_1 **RESET**; por_run FB6_4 **SET**; por_sh\<0..7\> **SET ×8** — POR-цепь цела | ПАСС |
| 3 | Мусорные сети div4 | x1_p/x1_n/por_cnt = 0; отдельного `cnt` нет (только txm_cnt — UART) | ПАСС |
| 4 | Тактирование | clk → **GCK3** (1/1); GSR не используется; GTS не используется | ПАСС |
| 5 | Ресурсы | 95/108 MC (все HP), 243/540 PT, 213/216 FB-вх, 59/108 FF, 50 buried, **72/72** ноги (X1 P68, X2 P69, clk P29) — идентично v3.4 | ПАСС |
| 6 | ERROR/WARNING | **0 ERROR**; варнинги те же, что у v3.4: 7× Cpld:897 (буферы D/seg в buried MC) + 1 безвредный (путь к .ise) + INFO BUFG | ПАСС |

Урок для будущих аудитов: пункт чек-листа «X2_D = NOT(...)/XNOR-форма» в этом
формате отчёта НЕИСПОЛНИМ буквально — cpldfit не отображает полярность XOR-B;
дискриминаторы: Init-пара (SET/RESET), отсутствие комбинационного инвертора,
и железная фаза.

## Суть v3.5 (зачем; остаётся в силе)

Фит v3.4 поднял комбинационный `assign X2 = ~X1` в регистр (репликация).
Функция получилась верной, но ПО СЛУЧАЙНОСТИ фиты: полярность была свёрнута
фиттером внутрь XOR-B PT, что в отчёте неотличимо от реального same-D слияния.
v3.5 делает противофазу СВОЙСТВОМ RTL — регистр `x2_q` с D, отличным от D(x1),
same-D слияние невозможно по построению:

| Ветка CLK_DIV | X1 | X2 (v3.5) | Гарантия |
|---|---|---|---|
| 2 | `x1_q <= ~x1_q` | `x2_q <= x1_q` | D = `x1_q` != `~x1_q`; init (1,0) |
| **4 (цель)** | `x1_q <= x1_q ^ t0_q` | `x2_q <= ~(x1_q ^ t0_q)` | D = XNOR != XOR; противофаза с 0-го такта (x1: 1,1,0,0…; x2: 0,0,1,1…) |
| чётные N>=6 | toggle при `cnt==MEV` | toggle при `cnt==MEV` | синхронная toggle-пара, init (1,0) |
| нечётные (не исп.) | `X1 = x1_p ^ x1_n` | `X2 = x2_p ^ x1_n` | `x2_p` — двойник `x1_p` с инверсным INIT |

Инициализация: `x1_q = 1`, `x2_q = 0` (POR); keep на порте X2 сохранён.

## Состав

| Файл | Что это |
|---|---|
| `top_suart_por6_v391.v` (+`_utf8`), `scripts/gen_v391.py`, `sim_v391_equiv.py`, `tb_v391_diff.v`, `run_tb_v391.sh` | **ПЕРЕНЕСЕНО в `beta/lowsize/` (clk10-64)** — см. README lowsize; описание v3.9.1 — в исторической секции выше |
| `top_suart_por6_v311.v` | **v3.11 (clk10-58) — ЖЕЛЕЗО: СТАРТА НЕТ на 4,17 МГц (как у v3.10) → маржа POR исключена, ядро окончательно**: база v3.10 БАЙТ-В-БАЙТ, единственное изменение por_sh 8 → 12 FF (`12'hFFF`, сдвиг `[11:1]`) → POR 1340 нс = 5,58 такта CPU (было 860 = 3,58 — самый короткий старт всех версий). X1 = 8,333 МГц ровно 50/50, CPU 4,167 МГц, терминал 8000 8N1. Остался заделом на будущую пробу с поднятым питанием. CP1251 |
| `top_suart_por6_v311_utf8.v` | UTF-8 копия v3.11 (для чтения/диффов; в ISE брать CP1251-файл) |
| `top_suart_por6_v310.v` | **v3.10 (clk10-56) — ЖЕЛЕЗО ОТКЛОНИЛО**: база v3.9, узел кольца → делитель /3 (ЦЕЛЕВАЯ legacy-ветка g_div_odd, XOR-пара): CLK_DIV=3/CLK_HALF=0, cnt сужен [1:0], x1_p тогглит posedge при cnt==0, x1_n — negedge при cnt==2, x2_p — двойник x1_p с инверсным INIT; X1 = 8,333 МГц РОВНО 50/50, CPU 4,167 МГц, POR 860 нс (3,58 такта CPU), терминал 8000 8N1. Фит чистый (86/108 МЦ, исчерпанных ФБ 2) — но ядро CPU не тянет 4,17 МГц. CP1251 |
| `top_suart_por6_v310_utf8.v` | UTF-8 копия v3.10 (для чтения/диффов; в ISE брать CP1251-файл) |
| `top_suart_por6_v39.v` | **ПРОИЗВОДСТВО v3.9 (clk10-54) — .jed этого фита НА ПЛАТЕ И РАБОТАЕТ**: база v3.8 + кольцо 5 → 7 триггеров (r0..r6 + x1_n; двойной kill в самоочистке; x1_n set r3/clear r4; por_ce = r1\|r6). X1/X2 = 7,143 МГц (140 нс, 71/29), CPU 3,571 МГц (280 нс, 50/50), POR 1120 нс. CP1251; параметры CLK_DIV=2, CLK_HALF=1 (селектор исторический) |
| `top_suart_por6_v39_utf8.v` | UTF-8 копия v3.9 (для чтения/диффов; в ISE брать CP1251-файл) |
| `top_suart_por6_v38.v` | эталон v3.8 (clk10-52, ПРЕДЫДУЩИЙ кандидат / откат на CPU 5 МГц): база v3.7 + one-hot кольцо в делителе (r0..r4 + x1_n; x1_p/x2_p/cnt<0..3> из целевой ветки удалены, декодов равенства нет, самоочистка + рестарт из 00). CP1251; параметры CLK_DIV=2, CLK_HALF=1 |
| `top_suart_por6_v38_utf8.v` | UTF-8 копия v3.8 (для чтения/диффов; в ISE брать CP1251-файл) |
| `top_suart_por6_v37.v` | эталон v3.7 (clk10-51, ПРЕДЫДУЩИЙ кандидат): база v3.6 + TX-захват вместо маски (txm_cnt/TXM_W удалены, sod_q/tx_pass/tx_q). CP1251; параметры CLK_DIV=2, CLK_HALF=1 |
| `top_suart_por6_v37_utf8.v` | UTF-8 копия v3.7 (для чтения/диффов; в ISE брать CP1251-файл) |
| `top_suart_por6_v36.v` | эталон v3.6 (clk10-49, ПРЕДЫДУЩИЙ кандидат): база v3.5 + ветка g_div2p5 (25/2,5 → X1/X2 = 10 МГц, CPU 5 МГц). CP1251; параметры CLK_DIV=2, CLK_HALF=1 (новый), TXM_W=8 |
| `top_suart_por6_v36_utf8.v` | UTF-8 копия v3.6 (для чтения/диффов; в ISE брать CP1251-файл) |
| `top_suart_por6_v35.v` | эталон v3.5 (ПРЕДЫДУЩИЙ кандидат, полный откат): база v3.4 (пор6-версия владельца) + регистровая противофаза X2 (clk10-41). CP1251, 562 строки, шапка «top_suart.v v3.5», `parameter CLK_DIV = 4`, строка 323 `x2_q <= ~(x1_q ^ t0_q);` |
| `scripts/tb_col_probe.v` | пробник предложения коллеги о слиянии захвата адреса с переходом (clk10-63): 3 DUT (база v3.9.1 + вариант A полный + вариант B только addr_latch), модель шины с задержкой валидности адреса/данных относительно ALE, счётчики порчи адресов/записей/портов |
| `scripts/gen_col_probe.py` | генератор вариантов A/B предложения коллеги из v3.9.1 (одноразовый пробник, НЕ версия 3.9.2) |
| `top_suart.ucf` | копия релизного UCF из `hdl/` байт-в-байт (73 NET-констрейнта, CP1251): ноги не менялись |
| `retro_pcld_top.rpt` | фит владельца 10-28 6:20PM (добавлен clk10-48, аудит 6/6 ПАСС) |
| `retro_pcld_top (1029-0659AM).rpt` | фит владельца v3.6 10-29 6:59AM (добавлен clk10-50): **ОБРЕЗАН крашем cpldfit при записи Equations** — структурный аудит 8/10 ПАСС, пункты h)/g6) заблокированы |
| `retro_pcld_top (v310).rpt` | фит владельца v3.10 10-29 10:07PM (добавлен clk10-57): Successful, ПОЛНЫЙ (63 647 б) — структурный аудит ПАСС (узел /3 бит-в-бит по RTL); железо: CPU не тянет 4,17 МГц — версия ОТКЛОНЕНА |
| `retro_pcld_top (v39).rpt` | фит владельца v3.9 10-29 8:45PM (добавлен clk10-55): Successful, ПОЛНЫЙ (63 333 б) — аудит ПАСС, **.jed этого фита на плате и работает** |
| `retro_pcld_top (v38).rpt` | фит владельца v3.8 10-29 4:39PM (добавлен clk10-53): Successful, ПОЛНЫЙ (62 811 байт) — аудит 15/15 ПАСС, **.jed от него можно строить** |
| `README.md` | этот файл |

## Железные наблюдения владельца (10-28) и их трактовка

- Плата работает, монитор fw_mon 6000 8N1 → X1 = 6,25 МГц точно (CLKOUT 3,125 МГц).
- Осциллограф: X1 — «чистый синус», X2 — «меандроподобный», В ПРОТИВОФАЗЕ =
  целевая функция v3.5 подтверждена.
- Форма X2: драйвер CPLD работает ПАРАЛЛЕЛЬНО выходу внутреннего усилителя
  ВМ85А; в v3.5 их полярности СОГЛАСОВАНЫ (контенденции нет) → жёсткий меандр.
- Форма X1: нога X1 — аналоговый узел ВНУТРЕННЕГО генератора ВМ85А (инвертирующий
  усилитель X1→X2, внутренняя ОС, ёмкости, защита) — он в кремнии и без кварца.
  «Чистый синус» на экране — почти наверняка щуп: режим x1 (~100 пФ, полоса
  ~10 МГц) или недокомпенсированный x10 на 6,25 МГц срезает 3-ю/5-ю гармоники
  меандра. Проверка: щуп x10, компенсация по калибратору, короткая
  земля-пружинка, точка касания — нога CPLD P68 → почти меандр. На работу не
  влияет: процессору нужны пороги V_IL/V_IH и частота.

## Остаточный контроль (1 минута, формальность)

Запуск осциллографа по ФРОНТУ X2 (CH2, инверсия ВЫКЛ): синус X1 должен ПАДАТЬ
через точку запуска = противофаза. Если РАСТЁТ — проверить инверсию канала;
при подтверждённой фазе «в фазе» — гигиена ISE (в Sources один top-файл
v3.5, Cleanup, Re-Run All). NB: даже нетлист div4 у v3.4 и v3.5 идентичен
(доказано диффом) — на функцию железа выбор исходника не влияет; различие —
структурная гарантия different-D в RTL v3.5.

## Предложение коллеги (10-30, clk10-63): слияние захвата адреса с переходом IDLE→T1H — ВЕРДИКТ: ОТКЛОНИТЬ

Суть предложения: `if (state == S_T1H && ALE) addr_latch <= A;` заменить
захватом в ветке перехода (`S_IDLE: if (ALE) begin state <= S_T1H;
addr_latch <= A; end`), T1H — «чистое ожидание !ALE», минус 1 литерал.

ЧТО В ПРЕДЛОЖЕНИИ ВЕРНО: структурная защита п.6 не страдает — вход в
T1H по-прежнему только из IDLE, значит посреди импульса /WE адрес не
перезаписывается. И при предпосылке «адрес уже валиден к подъёму ALE»
поведение совпадает — симуляция это подтверждает (фаза aset=0:
0 расхождений).

ПОЧЕМУ ВСЁ ЖЕ ОТКЛОНИТЬ:

1. Посылка «&& ALE избыточно, т.к. в T1H попадаешь только по ALE»
   смешивает ВХОД в состояние с СЭМПЛИРОВАНИЕМ в нём. Блок захвата
   срабатывает на КАЖДОМ posedge, пока state==T1H && ALE, — это не
   одноразовый захват, а ОКНО повторного сэмплирования. Методология
   задокументирована в шапке (строки 398 и 754): «Метод захвата —
   повторное сэмплирование, пока строб активен (последний сэмпл
   гарантированно валиден)». Условие && ALE — строб этого окна, а не
   избыточность.

2. Правка меняет СЕМАНТИКУ: «последний сэмпл» -> «первый сэмпл».
   По даташиту 8085 адрес валиден ПОЗЖЕ подъёма ALE (задержка
   t_AD больше задержки подъёма ALE), первый сэмпл 25 МГц читает
   УСТАРЕВШЕЕ содержимое A-сетей: данные предыдущего чтения (CPLD
   снимает их по ALE, но сеть держит заряд), данные/адрес предыдущей
   записи, адрес writeback в конфликтной ситуации.

3. СИМУЛЯЦИЯ (scripts/tb_col_probe.v + scripts/gen_col_probe.py,
   3 DUT в одной симуляции: база v3.9.1, вариант A — полный перенос
   addr_latch+bus_reg в переход, вариант B — только addr_latch):
   - фаза aset=0 (адрес валиден до ALE, 8 циклов): 0 расхождений;
   - реалистичная модель (адрес валиден через 1..4 тика после входа
     в T1H, данные памяти — через 3..6; ALE 3..6 тиков): 4024 цикла:
     addr_latch разошёлся с базой в 2472 (61%), СОДЕРЖИМОЕ логов ОЗУ —
     1105 записей по ЧУЖИМ адресам (45% всех 2516 записей попадают
     мимо!), порты (seg/dig/col/snd) — 3895 расхождений (IO-записи
     уходят не в те регистры: декод порта идёт по мусорному
     addr_latch), A-шина — 43 472 расхождения (вариант A к тому же
     захватывает bus_reg первым сэмплом — чтения возвращают мусор);
   - оба варианта дают ОДИНАКОВУЮ картину по addr_latch (2472) и
     порче записей (1105) — перенос одного только addr_latch НЕ
     спасает.

4. «Минус 1 литерал» НЕ подтверждается учётом фита: по .rpt v3.9
   каждый бит addr_latch = 2 ПТ / 9 входов (FB6_10..17). Разрешающий
   птерм в каждой МЦ меняется с T1H·ALE на IDLE·ALE — обе конструкции
   4-литеральные, а птермы XC9500 принадлежат МЦ и между МЦ не
   шарятся. Итог: ΔПТ = 0, Δлитералов = 0. Птерм перехода state
   (IDLE·ALE) существовал и остаётся.

ИТОГ: цена предложения — не экономия (её нет), а потеря ЕДИНСТВЕННОГО
запаса по времени захвата адреса на медленном кремнии (экземпляр
ИМ1281ВМ85А на 3,57 МГц). База сэмплирует до последнего момента окна
ALE и имеет запас (aset <= t_ALE_tikov - 2); вариант берёт худший
сэмпл всегда — запас ноль. Если хочется улучшить читаемость —
достаточно комментария-оглавления у блока захвата, не трогая логику.

## Дальше

1. ПРОИЗВОДСТВО = v3.9 (CPU 3,571 МГц, X1 7,143 МГц 71/29, терминал
   6857 8N1): .jed от фита v3.9 10-29 8:45PM — известен хороший;
   на плате должен стоять именно он.
2. Тема частоты ЗАКРЫТА: 5,00 (v3.8), 4,17 (v3.10), 4,17 + POR
   5,58 такта (v3.11) — железо отклонило все три; ядро данного
   экземпляра подтверждено только на 3,571 МГц.
3. Единственная дверь обратно к оверклоку — питание: при появлении
   возможности поднять Vcc выше номинала кандидат v3.11 готов
   (один фит до .jed, симуляция 19/19 ПАСС; .rpt нового фита —
   сначала на аудит). Без этого — v3.9 остаётся финалом.
4. Ресурсный запас CPLD на будущее (расклад по блокам и вердикт —
   в разделе «Расклад ресурсов по блокам»): безопасные внешние
   подтяжки CS1 (P99) и READY (P87) — обе уже константы '1' —
   дали бы −2 МЦ и −2 ноги (86→84, 72→70); подтяжка CS_n
   (/CE ОЗУ) НЕВОЗМОЖНА — это декод адреса с защитой writeback,
   а не константа. Исчерпанные FB1/FB3 подтяжками не
   разблокируются — их заполняют шинные трансиверы A/D, а не
   декоды памяти. Делать только в связке с будущим рефитом;
   на производстве v3.9 ничего не трогать.
   ОТВЕТ НА ВОПРОС владельца (10-30) «нужны ли нам эти
   освобождения»: СЕЙЧАС НЕТ. (а) Ресурс не дефицитен — в v3.9
   свободно 20 МЦ. (б) Пины P99/P87 после подтяжек НЕ становятся
   новыми I/O — они распаяны на сети CE2 ОЗУ и READY CPU; выгода
   только внутренняя (−2 МЦ), копить «про запас» нечего. Вернуться
   к вопросу — только когда появится рефит со своим поводом,
   которому не хватит именно МЦ.
5. v3.9.1 (удаление wb_ram_q по предложению коллеги) — вердикт
   ПРАВ; RTL ПРИНЯТ владельцем, эквивалентность доказана (секция
   v3.9.1 выше: дифсимуляция + формальный перебор, 0 расхождений).
   Следующий шаг — фит владельца в ISE, .rpt на аудит (wb_ram_q в
   нетлисте НЕТ, МЦ 87, ПТ ~209, CS_n от state_FSM_FFd1..3 + A15/IOM);
   шить только в связке с реальным поводом (п.4), не standalone.
6. Предложение коллеги «слить захват адреса с переходом IDLE→T1H»
   — ОТКЛОНЕНО (clk10-63, секция выше): захват первого сэмпла ловит
   устаревшую шину (61% циклов, 45% записей ОЗУ по чужим адресам
   в реалистичной модели), «−1 литерал» не подтверждается фитом
   (2 ПТ/9 входов на бит, птермы пер-МЦ).
