digitalinvitro/CPLD-plus-8085/beta/hwuart/README.md

# beta/hwuart — аппаратный UART-трансивер на базе lowsize v3.9.3

**Директива владельца (11-3):** «Отставим пока эту затею [txclient], попробуем на варианте 3.9.3 lowsize сделать полноценный UART трансивер, пусть полудуплексный, применяя в том числе и мои наработки по размещению UART в малых CPLD. Заведи каталог beta\hwuart и размести дизайн там.»

**База:** `beta/lowsize/top_suart_por6_v393.v` (v3.9.3, фит 11-2 9:54PM **прошит и работает**:
85/108 МЦ, 195/540 ПТ, 171/216 вх. ФБ, 54 триггера, 72/81 ноги, сброс → GSR).
**Правило линии:** база бит-в-бит, UART ложится ТОЛЬКО на свободный ресурс + ресурс выпиленных
soft-UART-транзитов. Дисплей/клавиатура/FSM/шина/writeback/POR — не тронуты.

## Спека (выбор владельца, 11-3)

| Параметр | Значение | Основание |
|---|---|---|
| Скорость | **1 923 077,8 бод 8N1** (25 МГц / 13) | как txclient; ровно 13 тиков/бит; CH340G проверен |
| Доступ CPU | **IO-порты**: `OUT 04h` = TX, `IN 04h` = RX-байт, `IN 05h` = статус | декод по `addr_latch[2:0]` (уже в матрице); 04h-07h — резерв от удалённого UART (Task 69) |
| Прерывание | **RXRDY → RST 7.5 (P75)**, уровень = `rx_full` | прецедент 01_timer: P75→RST 7.5 проверена железом (UART-тест v4) |
| Транзиты v3.9.3 | **TX-транзит выпилен** (sod_q/tx_pass/tx_q, −3 МЦ); **SID = RX сохранён** (наблюдатель входа, 0 доп. МЦ: IO-MC и так был; старый софт-UART-ввод RIM и diag6 продолжают работать) | решение владельца «выпилить оба»: TX-транзит заменён аппаратурой, SID-пин обязан чем-то держаться — транзит дешевле и полезнее константы |
| Кадр | 8N1, RX терпит длинный стоп | стандарт терминалов |
| Дуплекс | **полудуплекс**: общие shreg / bit_cnt / baud_cnt | лицензия владельца; ядро влезает только общим |

## Карта портов (дополнение к §5 базовой)

| Порт | R/W | Биты | Функция |
|---|---|---|---|
| `04h` | OUT | D7..D0 | **TXDATA**: старт кадра (параллельная загрузка из живых A-пинов T2). Приём запрещён при TXRDY=0/RXRDY=1 — байт отбрасывается (контракт ниже) |
| `04h` | IN | A7..A0 | **RXDATA**: принятый байт (из shreg[8:1]); чтение снимает RXRDY/IRQ |
| `05h` | IN | A0 | **RXRDY** (1 = байт ждёт в shreg) |
| `05h` | IN | A1 | **TXRDY** (1 = ядро в idle, кадр можно стартовать) |
| `05h` | IN | A7..A2 | 0 (резерв: A2 — FE, план Б) |

Чтение — тем же механизмом, что KBROW (03h): CPLD отдаёт байт на A-пины (AD0-7) в T2 при `rd_drive` — драйверы и мультиплекс уже есть, добавлены только селекторы.

## Архитектура полудуплексного ядра (п.26 шапки RTL)

Один набор счётчиков/сдвигов на TX и RX (одновременность исключена: старты разрешены только из idle):

```
shreg[9]     9 МЦ — {данные/байт RX, выход}: [0]->TX pin (IO-MC, INIT=1);
               TX-загрузка: {A[7:0], 1'b0} из живых A-пинов T2; сдвиги вправо с
               инжекцией '1' -> после кадра shreg сам приходит в все-'1' (idle
               по построению, как shreg 9h1FF txclient);
bit_cnt[4]   4 МЦ — 0..9 (0=idle/старт, 1..9=биты кадра) — общий;
baud_cnt[4]  4 МЦ — mod 13 свободным ходом; jam-фазировка при стартах
               (TX: <=0 — сдвиг №1 ровно через 13 тиков; RX: <=6 — выборка
               центра старт-бита на T+6, далее каждые 13);
rx_s0/rx_s1  2 МЦ — 2-ступенный синхронизатор входа RX (P38);
rx_run       1 МЦ — идёт приём; rx_start = спад rx_s1-vs-rx_s0 в idle;
rx_full      1 МЦ — RXRDY + IRQ RST 7.5 (P75); сброс — IN 04h;
tx_run       1 МЦ — идёт передача (TXRDY = ~tx_run);
adv_q/ld_q   2 МЦ — регистровые хелперы тика/конца кадра (наработка v8:
               декоды счётчиков вынуты из D-функций shreg).
Итого ядро: 24 МЦ; минус транзит −3 => прогноз фита 85−3+24(+0..2 хелпера
декодов io_wr_tx/io_rd_rx/io_rd_st) = **106..108/108 МЦ**, вх.ФБ ~190-200/216,
ПТ ~255-290/540, рег ~76-78, ноги 73/81 (+P75=rx_int, PGND 9→8).
```

RX-механика (уроки 01_timer): валидация старт-бита В ЕГО ЦЕНТРЕ (тик T+6:
`rx_s1=='0'` — иначе глитч, abort без порчи shreg), выборки битов строго в
центрах (T+13k+6), стоп-проверка на T+123 (bc=9): `rx_full := 1`. Без FE-флага в v1.

TX-механика (наработка txclient v8): загрузка в T2 записи порта — ОДИН такт,
байт берётся с живых A-пинов (тот же строб, что штатный `bus_reg <= A`); старт-бит
на шине С ТОГО ЖЕ такта (бит [0] загружен '0'); сдвиги по baud_tick bc=0..9
(10 бит ровно по 13 тиков); стоп-заполнение — инжекция '1' (константа):
после кадра shreg == все-'1' без отдельных загрузок.

## Контракт полудуплекса (для прошивки и ПК-стороны)

1. `OUT 04h` — только при TXRDY=1 (поллинг IN 05h.1; прецедент v3.10: буфер с
   TXRDY-поллингом даёт те же гарантии без потерь, период опроса << бита).
2. Запись в TX при активном RX/передаче — байт ТИХО ОТБРАСЫВАЕТСЯ (кадр не портится).
3. RX-байт прочитать (IN 04h) до следующего OUT 04h: чтение снимает RXRDY;
   новая загрузка TX перезапишет shreg.
4. Одновременный спад RX и запись TX в один такт — приоритет RX (TX-байт отброшен).
5. ПК-сторона: не слать байты во время кадров платы (двухпроводная линия
   электрически полнодуплексна, ядро — нет; коллизия = потеря байта RX).
6. Прошивка: IRQ RST 7.5 (фронт rx_full) — IN 04h в ISR снимает запрос;
   после EI не забыть SIM-разблокировку RST 7.5 (прецедент 01_timer).

## Наработки владельца, применённые в ядре

| Источник | Что взято |
|---|---|
| `uart.v` (digitalinvitro/GOWIN), адаптация в txclient v3.10 | счётчик бода с константным декодом (RCONST→BAUD_DIV), shreg с idle-заполнением '1' от INIT, регистровый выход бита из IO-MC |
| txclient v6-v8 (п.21-23 шапки) | jam-фазировка baud_cnt при старте кадра; «shreg сам приходит в idle» (инжекция констант, параллельных загрузок idle НЕТ); регистровые хелперы adv_q/ld_q против копий декодов в D-функции каждого бита shreg (лекарство ERROR 892/216-вх.ФБ); бит shreg[0] в IO-MC пина TX |
| v3.7 TX-транзит (clk10-51) | регистровое качество выхода (TX = регистр в IO-MC), INIT=1: TX='1' до всякого клока; гейт !por_run на стробах от floated-шины |
| 01_timer RX-кампания (diag1-6) | валидация старт-бита в центре, выборка в середине бита, допуски коллизий кадров |
| lowsize v3.9.3 (п.17/18) | GSR-схема сброса (ядро UART в GSR-домене, shreg через SET-ветку: idle '1' по INIT), счётчик mod-7, декоды портов по addr_latch[2:0] |

## Чек-лист фита (владельцу, после прогона ISE)

1. `Fitting Status: Successful`, 0 ERROR; WARNING Cpld:897 — ожидаемы ≤1-2 (см. выше).
2. Ресурсы (v4.0.1, М1): МЦ потребность **105-106** (фит 3 v4.0.0 был 109; −4 por_sh<7:4>,
   −2 хелпера декода por_ce, +1..2 упаковочные узлы класса BUF_x1_n), вх. ФБ **~209-210**
   (было 213), ПТ ~315-325 (было 332), рег 70 (фит 3 был **74** = 64 размещённых + 10
   бездомных; строка «73» в аудите фита 3 была бухгалтерской ошибкой), ноги 73/81.
   ФАКТ фита 1 (11-5): 106 / 208 / 322 / 70 / 73-81 — сошлось по всем четырём метрикам.
3. **GSR**: строка «Signal 'RST' mapped onto global set/reset net GSR.» + «GSR : 1»;
   пин 1 = RST, буфер GSR/I; ядро UART в GSR-домене: shreg — SET-ветка (INIT=1, idle '1'),
   bit_cnt/baud_cnt/rx_*/tx_run/adv_q/ld_q — CLR; ВНЕ домена (бит-в-бит v3.9.3):
   por_sh×4/por_run/cnt×3/x1_n.
   **РАЗБОР ЗАКРЫТ (11-5, фит 1 v4.0.1 — строка снова «unused», третий раз подряд)**:
   анатомия RST в v4.0.1 = **1 вх.ФБ** (FB4 — терм `RESET_IN <= NOT RST AND NOT por_run`)
   + 1 терм + **65 порт-мэпов** async-CLR (54 FDCPE + 16 FTCPE минус 5 пор-триггеров без
   сброса). У **GSR-эталона** lowsize v3.9.4 (успешен, работает) ТА ЖЕ анатомия —
   1 вх.ФБ / 1 терм / 38 порт-мэпов — при НАПЕЧАТАННОЙ строке «RST→GSR». У **sync-эталона**
   v3.9.2 («unused» правдиво) RST жал 6 вх.ФБ (по одному на ФБ) + 81 терм. ВЫВОД:
   асинхронные сбросы в обеих линиях идут КОНТРОЛЬНЫМИ ЛИНИЯМИ МИМО AND-массивов и НЕ
   стоят вх.ФБ; гипотеза «импорт RST в GSR даст 6-12 вх.ФБ» СНЯТА — GSR-импорт рычагом
   против стены НЕ является; строка остаётся маркером диф-контроля линии (fit_literals).
   Там же установлено: `FDCPE_por_*(…,clk,'0','0')` без PRE-инициализации в уравнениях —
   константа ОТОБРАЖЕНИЯ cpldfit (Init=SET в уравнениях не виден), у работающего
   v3.9.4 побайтно то же — НЕ дефект. Попутно: «Global clock net(s) unused» — константа
   линии hwuart (фиты 1-4); clk во всех отчётах обеих линий занимает 0 вх.ФБ; в lowsize
   clk→GCK3 / !clk→GCK2 — вопрос маршрутизации, не ресурсов.
4. Транзит TX-старый исчез: sod_q/tx_pass/tx_q в .rpt НЕТ; `TX` = shreg[0] (IO-MC P39).
5. P75 = rx_int — выход (не PGND!); PGND = {P74,P76,P78,P79,P81,P95,P96,P98} — 8 шт;
   P73 (SID) — выход (транзит RX), в PGND быть не должна.
6. Литералы сброса в термах: RST ×1 (RESET_IN) + por_run ×6 (факт v4.0.1: RESET_IN,
   io_wr_tx-хелпер $155, io_rd_rx-класс, rx-старт ×2, writeback) — `fit_literals.py`.
7. Строб io_wr_tx содержит !por_run (защита окна POR от floated-шины — класс v8).

## Состав

| Файл | Что |
|---|---|
| `top_hwuart_por6_v401.v` | **RTL v4.0.1 (М1, п.27)**, CP1251 — эталон для ISE |
| `top_hwuart_por6_v401_utf8.v` | UTF8-двойник v4.0.1 для чтения/диффов |
| `top_hwuart_por6_v400.v` | RTL v4.0.0, CP1251 — эталон дифсима (заморожен) |
| `top_hwuart_por6_v400_utf8.v` | UTF8-двойник v4.0.0 |
| `top_hwuart.ucf` | UCF, CP1251: от hdl/top_suart.ucf — P75 = rx_int (выход), PGND 9→8 |
| `scripts/gen_v401.py` | генератор v4.0.1 из v4.0.0: 11 якорей (титул/история/пор-блок/п.27/TODO/чек-лист) + контроли норм-пути |
| `scripts/check_v401_decl_order.py` | контроль v4.0.1: CP1251/двойник, порядок объявлений, дельта М1 в коде |
| `scripts/sim_hwuart_v401.py` | цикл-точная модель v4.0.1 (NBA-семантика), сценарии С1-С9, 75/75 |
| `scripts/make_sim_v401.py` | адаптер симов v4.0.0→v4.0.1 (модель + tb владельца) |
| `scripts/make_tb_v401.py` | генератор диф-тб tb_v401_diff.v из tb_v394_diff.v (lowsize) |
| `scripts/tb_v401_diff.v` | диф-тб v4.0.0 vs v4.0.1 (rx_int + hwuart-сценарии D13/D14) |
| `scripts/run_tb_v401.sh` | раннер дифсима (Icarus 12.0 из tools/iverilog) |
| `scripts/sim_hwuart_v400.py` | цикл-точная модель ядра v4.0.0 (NBA-семантика), сценарии С1-С9 |
| `scripts/fix_v400_decl_order.py` | правка 11-4: перенос блока объявлений автомата выше ядра UART (CP1251 + двойник синхронно) |
| `scripts/check_v400_decl_order.py` | контроль 11-4: объявления раньше использований, порядок секций, CP1251/двойник |
| `tb_hwuart_v401.v` | тестбенч владельцу (iverilog, v4.0.1) |
| `tb_hwuart_v400.v` | тестбенч v4.0.0 (iverilog) — фикс стимула 11-5 (см. статус) |
| `README.md` | этот документ |

## Статус

- **11-5: v4.0.1 = М1 в базу — ТЕКУЩИЙ КАНДИДАТ (шаг 2 маршрута Б, команда владельца
  «делаем hwuart v4.01»; шаг 1 закрыт: фит 1 lowsize v3.9.4 УСПЕШЕН 11-4 10:15PM,
  82/108 МЦ, чекпоинт «запасная прошивка»)**. После успеха базы те же 3 строки RTL
  перенесены в базовую часть `top_hwuart_por6_v401.v`: `reg [3:0] por_sh = 4'hF`
  (было 8'hFF), строб `por_ce = x1_n` (1 импульс 40 нс в [140,180) каждого периода
  cnt 280 нс — ровно один posedge-строб/период ПО ПОСТРОЕНИЮ, декодов равенства в
  POR-пути больше НЕТ; было (cnt==1)|(cnt==6) с интервалами {200,80}), сдвиг
  `{1'b0, por_sh[3:1]}`. Шина/FSM/порты/делитель/ядро UART/GSR — бит-в-бит v4.0.0
  (код-дифф = ровно дельта М1). POR = 4×280 = 1120 нс ≥ нормы 840 (запас ×1,33;
  от INIT ~1020-1040 нс, в v4.0.0 было ~1140-1160).
  **ВЕРИФИКАЦИЯ:** (1) дифсим v4.0.0 vs v4.0.1 (`tb_v401_diff.v` + `run_tb_v401.sh`,
  Icarus 12.0; база — tb_v394_diff lowsize + hwuart-сценарии D13/D14, сравнение
  rx_int в общем цикле): **ЭКВИВАЛЕНТНОСТЬ ПОДТВЕРЖДЕНА** — 10 595 случайных циклов
  + направленные (шина, ALE-глюки 674, сбросы 476, TX-кадр OUT 04h 55h со стартом
  ровно 520 нс, отброс при busy, RX 5Ah→IRQ→чтение): **0 расхождений выходов/шин,
  0 spec-нарушений**, логи виртуальных ОЗУ идентичны (4077 записей, тени 50=50);
  RST-окна сравнивались СТРОГО (GSR идентичен), окно сравнения закрыто только на
  время POR (момент снятия por_run — ожидаемое отличие меры); T0: INIT F/1, ровно
  4 сдвига F→7→3→1→0, por_run 1020 нс ≥ 840, повторного POR нет (500 тактов);
  (2) `sim_hwuart_v401.py` **75/75 ПАСС** (С1 переверен: POR 26 тиков модели =
  1040 нс; в v4.0.0 было 29); (3) `tb_hwuart_v401.v` (владельцу, iverilog)
  **18/18 ПАСС**.
  Попутно: `tb_hwuart_v400.v` прогнан впервые — найдены и исправлены 3 дефекта
  СТИМУЛА (RTL не тронут, 18/18): C3 — цикл опроса TXRDY (одиночный опрос попадал
  в работающий кадр), C5 — пре-чтение IN 05h перед приёмом, C7 — иерархическая
  проверка dut.tx_run (d0=1 у C3, линия высока в области данных).
  **Найдено при верификации (свойство RTL v4.0.0, сохранено в v4.0.1 — для
  прошивки):** декод `io_rd_rx` КОМБИНАЦИОННЫЙ от живого IOM и защёлкнутого
  addr_latch — после OUT 04h он активен в КАЖДЫЙ такт и ДЕРЖИТ rx_full в нуле до
  следующего цикла шины; прошивке опрашивать IN 05h (или любой цикл шины) между
  OUT 04h и ожиданием RX (естественный поллинг статуса это делает сам).
  **ПРОГНОЗ ФИТА** (против фита 3 v4.0.0: потребность 109 МЦ, 213/216 вх.ФБ, 332 ПТ,
  73 рег): потребность **105-106 МЦ** (−4 por_sh<7:4>, −2 хелпера декода por_ce,
  +1..2 упаковочные узлы класса BUF_x1_n — по факту дельты lowsize v3.9.3→v3.9.4),
  вх.ФБ **~209-210**, ПТ ~315-325, рег 69 (73-4); при остаточной стене входов —
  довесок KEEP io_wr_tx в UCF (ноль RTL); резерв — rx_s1 1-ступень.
  Владельцу: фит в ISE (`top_hwuart_por6_v401.v` + `top_hwuart.ucf`), опции как в
  фите 3 (**Input Limit 16, Pterm 18, Exhaustive OFF**; альтернатива IL 28 — как фит 2,
  если 16 даст ERROR 891 на ином узле) → .rpt НА АУДИТ (чек-лист выше + шапка RTL
  п.27/TODO 3b, включая точку GSR) → .jed и железо. **ДО УСПЕШНОГО ФИТА НЕ ШИТЬ.**
- **v4.0.0 (11-3): RTL + симуляции; фиты 1-3 — Placement Failed (см. ниже); вытеснен
  кандидатом v4.0.1.**
- **11-4, правка компиляции: HDLCompilers:28** (первый прогон ISE: 'state'/'S_T2'/'addr_latch'
  has not been declared, старые строки 985-989). Причина: блок ОБЪЯВЛЕНИЙ автомата шины
  (localparam S_*, state, addr_latch...) стоял в файле НИЖЕ ядра UART, а декоды
  io_wr_tx/io_rd_rx/io_rd_st в ядре на них ссылаются - ISE требует объявления ДО
  использования. Исправлено: блок перенесён ВВЫШЕ, порядок секций теперь POR →
  объявления автомата → ядро UART → шинный движок; комбинационные провода (in_wb..rd_drive)
  остались в блоке. RTL НЕ менялся (чистый перенос) - симуляции 75/75 в силе. Номера строк
  после ~947 сдвинулись на +45; контроль: `scripts/check_v400_decl_order.py`.
- **Фит 1 v4.0.0 (11-4 8:00PM) — FAILED, причина НЕ в RTL: опции фиттера.** Отчёт:
  `retro_pcld_top (v400-fit1-1104-800PM-FAILED).rpt`. Status: Design Rule Checking
  Failed, ERROR:Cpld:837 «needs at least **476** МЦ» + Cpld:868. Опции прогона
  (хвост отчёта): **Input Limit = 1, Pterm Limit = 1, Exhaustive Fitting = ON** —
  во ВСЕХ 12 прежних прогонах репозитория (успешных и Placement Failed): **28 / 18 /
  OFF**. С лимитом входа 1 и одним ПТ на узел свёртка запрещена: каждый бит A/D-
  мультиплексоров и декодов разложился в цепочки 2-входовых интермедиатов — 430
  непомещённых buried-узлов, из них ~358 `$OpTx$BIN_STEP/BIN_AND/FX_DC/FX_SC` и
  только ~72 реальных узлов дизайна (addr_latch×8, shreg×8, por_sh×8, baud_cnt×4,
  bit_cnt×4, state×3, cnt×3, слои _D2/_or0000/BUF_*) + 46 выходов = 476. «No logic
  has been mapped», «GSR/clock unused» — артефакты незапустившегося размещения.
  ЧТО РАБОТАЕТ даже в этом отчёте: пины 73/81 легли по UCF (RX P38 вх., TX P39,
  SID P73, rx_int P75, X1 P68/X2 P69); видимые уравнения выходов семантически
  верны: RESET_IN = NOT por_run AND NOT RST; CSr_n = NOT(NOT IOM AND NOT A15);
  CS1/READY = '1'; SID = RX; TX — FDCPE с PRE=RST (SET-ветка GSR, idle '1');
  D-шина — FDCPE CLR=RST; X2 = NOT X1-термы (SOP разведён). Масштаб потребности при
  нормальных лимитах: ~72 buried + 46 выходов ≈ верхняя граница 118 МЦ, слияния
  дают прогноз README (105-108) — 476 это взрыв от лимитов, не дизайн.
  **РЕЦЕПТ ПЕРЕПРОГОНА: вернуть опции фита v3.9.3 ТОЧНО — Input Limit = 28,
  Pterm Limit = 18, Exhaustive Fitting = OFF.** M2 из txclient (Collapsing Input
  Limit 28→**18**) — только если после возврата опций появится ERROR 892/стена
  входов ФБ; лимит 1 — это НЕ M2, при 1/1 не фитится ничего (доказано этим
  прогоном: не свернулась даже база, фитящаяся в 85 МЦ в v3.9.3).
- **Фит 2 v4.0.0 (11-4 8:17PM) — Placement Failed при ВЕРНЫХ опциях: честная стена ёмкости, не
  настройки.** Отчёт: `retro_pcld_top (v400-fit2-1104-817PM-FAILED).rpt`. Опции прогона (хвост
  .rpt): **Input Limit = 28, Pterm Limit = 18, Exhaustive = OFF** — рецепт v3.9.3 соблюдён ТОЧНО
  (фит 1 был 1/1/ON). Итог: размещено 102/108 МЦ (94%), ПТ 322/540 (60%), **вх.ФБ 213/216 (99%) —
  СТЕНА**, рег 73, ноги 73/81; НЕ размещено 4 узла: `$OpTx$FX_SC$155` (3ПТ/17вх), `shreg_or0002`
  (7ПТ/18вх), `A<0>_BUFR` (8ПТ/9вх — буфер по 897), `baud_cnt<2>` (4ПТ/8вх, FDCPE) => потребность
  **106 МЦ = прогноз README (106-108) ТОЧНО**; ПТ-потребность 344 и вх.ФБ выше прогноза
  (255-290 / 190-200). Корень: декод `io_wr_tx` (11 литералов: state×3 + addr_latch[2:0]=04h +
  IOM + !WRn + !por_run) при лимите 28 РАСТВОРЁН фиттером в 16 МЦ-потребителей (shreg_D×8,
  bit_cnt_T×4, baud_cnt_D0, tx_run_T, shreg_or0002, $155) => +42 вх.ФБ к базе (171→213). Свободно:
  6 МЦ (ФБ3×5, ФБ4×1) и всего 3 вх.ФБ (ФБ2×1, ФБ6×2) — бездомным нужны окна 8-18 вх в ОДНОМ ФБ,
  таких нет. Чек-лист: WARNING 897 ×2 (ожидалось ≤1-2 ✓), пины по UCF целиком (RX P38 вх, TX P39,
  SID P73, rx_int P75 = ВЫХОД, PGND 8 шт. не тронуты ✓), «Global clock/set-reset net(s) unused» —
  [РЕД. 11-5: НЕ артефакт, честный статус сети — см. находку в чек-листе п.3; прецедент
  txclient фит-1 в этой трактовке тоже снят] «GSR : 1» — проверять на первом УСПЕШНОМ. МЕРЫ (по возрастанию цены): **(1) фит 3, ноль RTL — Input Limit 28→16**: жертвы
  $155 (17вх) и shreg_or0002 (18вх) — при лимите 16 НЕ формируются, io_wr_tx-декод остаётся
  отдельным узлом (~11 вх ≤ 16), shreg_D худеют с 16-19 до ~6-9 вх, окна входов появляются; цена
  +2..4 МЦ => потребность 108-110 — на грани; попробовать ПЕРВЫМ (5 минут). **(2) М1 из txclient
  v8 — В ЭТОЙ БАЗЕ ЕЩЁ НЕ ПРИМЕНЕНА**: por_sh в v4.0.0 остался 8-битным со старой парой декодов
  cnt==1|cnt==6 (в отчёте FTCPE_por_sh0..7, T-цепи по 4ПТ/5вх): −4 МЦ (por_sh<7:4>, ФБ2
  18/18*→14), −8..10 ПТ, −3..4 вх.ФБ, POR = 4×280 нс = 1120 нс ≥ 840 нс (запас ×1,33); ЭТО ПРАВКА
  БАЗЫ v3.9.3 (правило «база бит-в-бит») — ждёт явного «Делай М1»; тогда v4.0.1: 4 строки RTL
  (класс v8) + близнец + правка С1 в sim + tb, симы перегоняю я (Python-модель), фит — владелец
  с лимитом 16. Резерв: rx_s1 в 1 ступень (план Б(б), −1 МЦ, риск метастабильности); ld_q-декоды
  экономии МЦ НЕ дадут (ld_q в фите уже свёрнут в tx_run_T/rx_run_T — отдельного узла нет).
  Прогноз (1)+(2): 103-105/108 МЦ, вх.ФБ ~195-205 — FIT. ДО УСПЕШНОГО ФИТА НЕ ШИТЬ.
- **Фит 3 v4.0.0 (11-4 8:40PM) — Placement Failed: мера (1) применена ТОЧНО (хвост .rpt: Input Limit = 16,
  Pterm 18, Exhaustive OFF), сработала наполовину.** Отчёт: `retro_pcld_top (v400-fit3-1104-840PM-FAILED).rpt`.
  Что СБЫЛОСЬ: ERROR 892 ушёл — `$OpTx$FX_SC$155` и `shreg_or0002` легли (18/19 вх — вопреки прогнозу «не
  сформируются»: Input Limit не действует на фаттеровские $OpTx-хелперы, он режет только коллапс
  пользовательской логики); io_wr_tx выжил отдельным узлом `$OpTx$FX_SC$1243` (1ПТ/9 вх.ФБ, FB6);
  shreg_D похудели 19→13 вх (недобор против прогноза 6-9: оставшиеся 13 — собственные литералы
  D-мьюкса shreg, их лимит не трогает). Что НЕ СБЫЛОСЬ: **вх.ФБ остались 213/216 (99%) — стена на
  месте**, потребность МЦ 106→**109** (>108; верх прогноза 108-110), бездомных 4→11 (реги bit_cnt<1,2,3>,
  por_sh<3..7>, rx_s0 + комб. cnt<0>, rd_drive_D2; 64 рег размещено + 9 бездомных = 73, как в фите 2);
  ERROR:Cpld:891 bit_cnt<3> (7ПТ/8вх) — свободно всего 3 вх.ФБ (ФБ4×1, ФБ6×2), окон на 8 вх нет.
  Попутно видно: фаттер ДЕРЖИТ io_wr_tx узлом и ОДНОВРЕМЕННО растворяет копии в tx_run_T (9 литералов),
  baud_cnt_D0/T2/D3, N60 — дублирование декода съедает окна. ВЫВОД: опциями фиттера стена не снимается,
  мера (1) исчерпана; следующий шаг по плану — **М1 (por_sh 8→4 со стробом x1_n)**: −4 МЦ
  (109→105 ≤ 108, запас 3), −3..4 вх.ФБ, −8..10 ПТ; ПРАВКА БАЗЫ v3.9.3 (правило «база бит-в-бит») —
  **жду явного «Делай М1»**; после неё v4.0.1 (4 строки RTL + близнец + С1 в sim + tb, симы на мне,
  фит владельца с лимитом 16). Довесок при остаточной стене входов (ноль RTL): KEEP на io_wr_tx в UCF —
  запретить растворение копий; резерв — rx_s1 в 1 ступень (−1 МЦ, риск метастабильности на 1,92 Мбод).
  ДО УСПЕШНОГО ФИТА НЕ ШИТЬ.

- **Фит 1 v4.0.1 (11-5 6:50AM) — Placement Failed: М1 применилась ТОЧНО (бит-в-бит эталону
  lowsize v3.9.4), стена продвинулась по всем метрикам, но окно для bit_cnt так и не
  появилось.** Отчёт: `retro_pcld_top (v401-fit1-1105-650AM-FAILED).rpt`. Опции фита 3
  соблюдены точно (хвост .rpt: **Input Limit 16, Pterm 18, Exhaustive OFF**; GSR/GCK/FASTConnect-оптимизации
  ON). ERROR:Cpld:891 bit_cnt<3> (7ПТ/8вх) + 868; WARNING Cpld:897 штатные (FB1 A<1>/A<0>,
  FB3 TX — как в фите 2).
  **М1 В НЕТЛИСТЕ:** por_sh_D(0..2) = x1_n ? por_sh[k+1] : por_sh[k] (2ПТ/3вх),
  por_sh_D(3) = NOT x1_n AND por_sh(3) (1ПТ/2вх), por_run.D = por_sh(0) — уравнения
  бит-в-бит v3.9.4; por_sh<7:4> и пор-декоды (cnt==1|cnt==6) ИСЧЕЗЛИ из нетлиста
  (в уравнениях остались только нормальные декоды X1/X2 и baud-цепи); por_sh<2>
  переложился в бездомные уже с новой М1-анатомией (был mapped со старой). Остаток
  пор-литералов: RST ×1 (RESET_IN), por_run ×6 — ровно по чек-листу.
  **СВЕРКА С ПРОГНОЗОМ** (директива «Сравнивай с прогнозом»): МЦ-потребность **106**
  (99 размещено + 7 бездомных) vs 105-106 — ✓ верхняя граница; ПТ **322** vs 315-325 — ✓;
  вх.ФБ **208/216 (96%)** vs ~209-210 — ✓ верхняя граница (−5 от 213); рег **70** vs
  прогноз 69 — расхождение снято: база прогноза была ошибочна, фит 3 фактически
  **74** (64 размещённых + 10 бездомных; в аудите фита 3 значилось 73), корректная
  дельта М1 −4 → 70 — сошлось ТОЧНО; ноги 73/81; триггеры 54 FDCPE + 16 FTCPE = 70.
  Потребность ПТ 345 (322+23) против 370 (332+38) у фита 3 — −25. Бездомных **11→7**:
  bit_cnt<1,2,3> (7/8, 4/8, 7/8 ПТ/вх — размеры бит-в-бит фита 3: нативная сложность,
  Input Limit их не режет), cnt<0> (1/3), por_sh<2> (2/3), por_sh<3> (1/2), rx_s0 (1/1);
  rd_drive_D2 лёг (FB5_1).
  **GSR-ТОЧКА ЧЕК-ЛИСТА (разбор закрыт — см. чек-лист п.3):** «GSR unused» третий раз,
  но анатомия RST (1 вх.ФБ / 1 терм / 65 порт-мэпов) идентична успешному GSR-эталону
  v3.9.4 (1/1/38) — сбросы идут контрольными линиями мимо AND-массивов и вх.ФБ НЕ
  занимают; гипотеза «GSR-импорт даст 6-12 вх.ФБ» СНЯТА. «Global clock net(s) unused» —
  константа линии (clk 0 вх.ФБ во всех отчётах обеих линий; в lowsize clk→GCK3/!clk→GCK2).
  **СТЕНКА СТРУКТУРНАЯ:** свободно 9 МЦ (FB1 5, FB3 3, FB4 1) и 8 вх.ФБ (FB5 4, FB6 2,
  FB2 1, FB4 1), но FB2/FB5/FB6 МЦ-полны (18/18*), а FB1/FB3 вх-полны (36/36*) —
  единственная пара «МЦ+входы» это FB4 (1 МЦ / 1 вх): туда лечь может только rx_s0
  (1ПТ/1вх) → 7→6 бездомных. bit_cnt<1,2,3> требуют по 8 вх.ФБ — окна ≥8 нет нигде.
  ВЫВОД: данная пара «нетлист + IL16/Pterm18» не фитится при любом порядке жадного
  поиска — нужны варианты упаковки.
  **СЛЕДУЮЩИЙ ВЫСТРЕЛ (ноль RTL, владелец): фит 2 = те же IL16/Pterm18 +
  Exhaustive Fitting: ON** (единственный неиспробованный глобальный рычаг — полный
  перебор размещений/коллапсов; время фита вырастет — норма) **+ сразу KEEP io_wr_tx
  в UCF** (ноль риска: io_wr_tx и так узел $OpTx$FX_SC$1234, 1ПТ/9 вх.ФБ, FB6_16 — KEEP
  фиксирует статус-кво против вариативности). Если Exhaustive мимо — IL 12 + Exhaustive
  ON (осторожно: МЦ-запас 2; bit_cnt при IL16 не ужались, эффект под вопросом). Резерв
  rx_s1 1-ступень (−1 МЦ) ПРОТИ bit_cnt-стены недостаточен; далее — только разговор о
  реструктуризации ядра (вне маршрута Б). ДО УСПЕШНОГО ФИТА НЕ ШИТЬ.

- **Верификация v4.0.0: `scripts/sim_hwuart_v400.py` — 75/75 ПАСС** (цикл-точная модель
  NBA-семантики, полутакты x1_n): С1 POR/idle (TX='1' от INIT, RESET_IN, X1 7 тиков 5/7,
  SID-транзит, TXRDY) · С2 кадры 55h/AAh (**все переходы линии на сетке ровно 13 тиков,
  старт ровно 13** — jam=1 компенсирует лаг adv_q, PC-приёмник декодирует, shreg сам в
  idle 1FF) · С3 поток 3 байт с TXRDY-поллингом без потерь · С4 OUT при busy — байт тихо
  отброшен, кадр цел · С5 RX 55h: rx_full/фронт rx_int, статус RXRDY, IN 04h = байт,
  чтение гасит IRQ · С6 RX при активном TX игнорируется (полудуплекс), кадр TX цел ·
  С7 RST посреди TX- и RX-кадров: GSR гасит TX='1' в первый такт, ядро вычищено,
  приёмник жив после сброса · С8 глитч RX 3 тика — аборт в центре старта, инвариант
  bc==0 · С9 регрессия базы (порты 00-02h, KBROW 03h, writeback /WE ровно 2 тика,
  ПЗУ без /WE). `tb_hwuart_v400.v` — владельцу (iverilog): ключевые сценарии С1/С2/С3/С5/С7.
- Найдено и исправлено при верификации (в RTL и модели синхронно): jam TX-старта
  `baud_cnt <= 1` (НЕ 0: лаг adv_q 1 такт делал старт-бит 14 тиков = BREAK у приёмника);
  инвариант idle после глитч-аборта RX (bit_cnt <= 0 в ветке аборта).
- План Б (если МЦ не влезут, по возрастанию цены): (а) свернуть ld_q-класс декодов
  (декоды в 4 потребителя, −1 МЦ); (б) rx_s1 — 1 ступень синхронизатора (прецедент
  sod_q, −1 МЦ, риск метастабильности на 1,92 Мбод — только по результату фита);
  (в) FE-флаг статуса не вводить; (г) Collapsing Input Limit 28→18 по рецепту
  txclient М2 — на случай ERROR 892.
