digitalinvitro/CPLD-plus-8085/beta/txclient/README.md

# beta/txclient — вывод CPU → ПК без классического UART-терминала

База версий v1–v6: **v3.9.2** (`beta/lowsize/top_suart_por6_v392_utf8.v`,
фит 10-30 8:32PM: 85/108 МЦ, 209/540 ПТ, 180/216 вх. ФБ, 54 триггера —
принята владельцем). **База v7/v8: v3.9.3** (сброс логики → сеть GSR, фит 11-2
«GSR : 1 1», железо ПАСС; задание владельца 11-3 «на основе последнего
lowsize дизайна можно попробовать txclient»; исходная директива: *«нам не нужен TX [терминальный] — убери
SOD; будем знать, когда процессор пишет в область вывода UART; дизайн в
beta/txclient»*; развитие: *«на ПК определяется запись в какой регион
происходит и на ПК же принимается решение транслировать данные … в
примитивный текстовый экран»*; *«захват большей страницы ОЗУ чем 4К не
получается?»* — **получается: txclient захватывает окно ОЗУ с полным 16-битным
адресом**. Фиты v2 (11-1 9:26AM), v3 (11-1 11:02AM), v4 (11-1 6:16PM) и v5
(11-1 7:31PM) у владельца — все четыре **Placement Failed** (входы ФБ
216/216 → 216/216 → 212/216 → 213/216, разбор ниже); **фит 1 v7** (11-3
6:46PM) — тоже **Placement Failed**, но впервые стена — ёмкость/упаковка
(потребность 114 МЦ против 108, вх. ФБ 208/216; GSR-мера п.24 при этом
СРАБОТАЛА: литералы сброса 306 → 5, ПТ 383 → 310) — разбор в разделе v7;
**v8 — мера М1 из аудита (por_sh 8→4 со стробом вдвое реже, одобрена
владельцем «Делай M1») — текущий кандидат**; **фит 1 v8** (11-3 8:47PM) —
Placement Failed по той же стене упаковки, но **М1 перебила прогноз**:
потребность 114 → **103 МЦ** (прогноз был 110), бездомных узлов **7 → 3**
(shreg<8> 18ПТ/19вх + 2 хелпера); **Collapsing Input Limit в прогоне = 28 —
М2 ещё НЕ применялся**, следующий шаг — М2 (28→18 в ISE поверх v8) — разбор
в разделе v8; на вопрос владельца
*«может всё таки перейти к захвату конкретного региона ОЗУ, скажем
8000-C000?»* — ответ **ДА** (окно 8000h–BFFFh принято в v5); **v6 = сдвиг
источников кадров 2/3 к LSB — инжекция ОДНОГО провода вместо
16-входового мультиплексора** — убирает последний жир (shreg<8>.D = 26
входов в фите v5).

**11-2**: v6 у владельца не прошёл даже HDL-компилятор — XST
`ERROR:HDLCompilers:28 "'…' has not been declared"`, ×17 (`al_shift`,
`br_shift`, `bit_cnt`, `tx_byte`). Разбор: в коммиченном v6 все объявления
**были** (строки 1472–1494), а фронт-енд XST такой порядок пропускает — v5
с тем же построением (mux выше `reg`) скомпилировался и дошёл до плейсмента
(в .rpt v5 нет ни одной HDLCompilers, 94 упоминания `bit_cnt` в нетлисте).
Вероятная причина — **несинхронная локальная копия**
`rtl_txclient/top_txclient_v6.v` без блока объявлений. Страховка от всего
класса: в v6 (правка п.23.1, поведение не менялось) объявления сериализатора
подняты выше ВСЕХ использований (блок — перед шинным движком; внутри блока
регистры выше `in_cap`/`in_frame`) + новый `scripts/check_decl_order.py` —
статическая проверка «объявление раньше использования» до запуска ISE (на
v6-до правки даёт ровно набор XST; на v3.9.2 и v6-после — ноль; сознательно
строже XST, чтобы исходник проходил и iverilog, которым владелец гоняет tb).
Владельцу: пересинхронизировать файл в `rtl_txclient/` и перекомпилировать.

**11-3 (v7)**: вместо перефита v6 — перенос GSR-схемы сброса v3.9.3 в
txclient: в проваленном фите v5 cpu_rst развёрнут фиттером в RST×151 +
por_run×155 (**306 литералов**, +12 импортов во все 6 ФБ) — прямое давление
на непоместившиеся узлы (shreg<8> 18ПТ/26вх, bit_cnt<1>, tx_byte_FSM_FFd2,
hold_req__or0000). v7 = RTL v6 БЕЗ ПРАВОК (протокол/шина/сериализатор
бит-в-бит) + ОБА always-блока асинхронно по RST → СЕТЬ GSR, cpu_rst удалён
(в коде 0 упоминаний), ДВА гейта !por_run (вход в WB — класс v3.9.3 п.18;
взвод hold_req — специфика txclient). `scripts/sim_txclient_v7.py`:
**68/68 ПАСС**. Подробности — раздел «v7-логгер» ниже.

В папке **семь версий** одного направления — SOD-транзит удалён во всех,
приём не тронут во всех (`CH340G.TXD → RX P38 → транзит → CPU.SID, RIM 20h`
— *«на ввод процессор продолжает осуществлять приём сам программным
способом»*):

| | **v8-логгер** (текущий кандидат, база v3.9.3/GSR + М1) | **v1-окно** | **v3.10-порт** (коммит 1250057) |
|---|---|---|---|
| Триггер | **любая запись в ОЗУ ОКНА 8000h–BFFFh** (`!IOM && A15 && !AH14 && S0 && !S1`, решение владельца — п.22) | запись в страницу F000h–F0FFh (`WR#`, `IOM=0`) | запись в порт 07h (`OUT 07h`) |
| Что шлётся | **[A15..A8][A7..A0][данные]** — 3 байта, полный адрес; **hi — сериальный захват с живых AH-пинов** (9 тиков), **кадры 2/3 — сериальная предзагрузка во время передачи СО СДВИГОМ источника к LSB** (инжекция ОДНОГО провода — п.23; параллельных загрузок и 16-входового мультиплексора НЕТ), декоды кадров — в регистровых хелперах `adv_q`/`ld_q` | [адрес A0–A7][данные] — 2 байта, страница = константа F0h | только байт (адреса нет вообще) |
| Кто решает «куда» | **ПК**: сам фильтрует регион и рендерит (видеобуфер/терминал/лог) | ПК знает страницу (константа) + смещение | ПК не знает ничего, кроме порядка байт |
| Поток шины | HOLD/HLDA: CPU заморожен **весь пакет** (~16 мкс/запись) | HOLD/HLDA: CPU заморожен на голову пакета (~11–13 мкс) | без HOLD; буфер 1 байт + TXRDY-поллинг |
| Чтения/исполнение | **ноль издержек** (классификация по статусу S0/S1) | чтение окна = пинг-понг HOLD-HLDA 1–2 мкс | ноль издержек |
| Бод | **1 923 077,8** (25 МГц/13) | 1 923 077,8 | 115 207,4 |
| Ресурсы | фит 1 v7: потребность 114 МЦ; **v8/М1, фит 1 (11-3): потребность 103 МЦ** (прогноз 110 перебит), ПТ 310→294, бездомных узлов 7→3; **М2 (Input Limit 28→18) ещё не применялся** | прогноз ~104/108 МЦ | оценка 103/108 МЦ |
| Верификация | `scripts/sim_txclient_v8.py` **73/73 ПАСС** (сценарии v6/v7 + T0-модель POR-цепи М1) + `scripts/tb_txclient_v8.v` | `scripts/sim_txclient.py` 29/29 ПАСС | `sim_txclient.py` (корень) 33/33 PASS |
| Файлы | `top_txclient_v8_utf8.v` / `top_txclient_v8.v` (UCF общий) | `top_txclient_v1*.v`, `top_txclient*.ucf` | `top_txclient_por6_v310*.v` (в корне) |

---

# v6-логгер: сдвиг источников кадров к LSB (СОХРАНЁН — был кандидатом до 11-3; у владельца пал на XST-компиляции 11-2, вероятно несинхронная копия; теперь — база для v7)

## Разбор фит-провалов у владельца (все четыре — Placement Failed, входы ФБ)

### Фит v2 (retro_pcld_top (v2-fit-1101-FAILED).rpt, 11-1 9:26AM)

- Ресурсы фита: **МЦ 90/108, ПТ 328/540 — запас есть; входы ФБ 216/216
  (100%) — все 6 ФБ по 36/36**. `ERROR:Cpld:891 — Cannot place signal
  shreg<4>. Too many function block inputs required`; 21 узел не размещён
  (`shreg<2,4,5,7>`, `addr_latch<0..6>`, `hlda_q`, `por_sh<3..7>`,
  `state_FSM_FFd2`, `bit_cnt<1>`…); 6×`WARNING:Cpld:896` в FB3 (буферы
  BUFR `D<5..1>`, `TX` — +6 МЦ).
- **Причина**: параллельная загрузка `ah_bus` в shreg (идея v2) требует
  входы `{A15, AH14..AH8}` **в каждый ФБ, где лежит триггер shreg** — а
  shreg расползается по 3–4 ФБ (в фите — FB2/FB4/FB6) = +8–9 входов × 3–4
  ФБ, плюс коллапс фитайтера: D-функции shreg по 25–29 входов (`shreg<6>`
  28, `shreg<3>` 29, `shreg<1>` 26). Итог — входы ФБ кончились.
- **⚠ UCF НЕ ПРИМЕНИЛСЯ**: в отчёте `HOLD … FB4_14, pin 95` — фиттер
  поставил HOLD на **P95** (на плате это земля флэш-A16!), а P81 (CPU.HOLD,
  нога 39) остался unused → «Ground on Unused IOs» заземлил бы его. Фит
  собран **без** `beta/txclient/top_txclient.ucf` (там `NET "HOLD"
  LOC="P81"`). Остальные ноги совпадают с картой. **Перефитовать только с
  txclient-UCF и сверять: HOLD = P81 со знаком `~`.** С .jed от этого фита
  txclient молчал бы вечно (HOLD прибит к земле), а на P95 дёргался бы
  hold_req (безвредно только потому, что /CE флэша при hold_req=1 гасится).
- План Б без правки RTL: в ISE Process Properties → Fit → **Collapsing
  Input Limit 36 → 20–24** (фитайтер сам просил в ERROR 891) — запрет
  коллапса вынесет декоды в хелпер-МЦ; применим и к v4, если тот не ляжет.

### Фит v3 (retro_pcld_top (v3-fit-1101-1102AM-FAILED).rpt, 11-1 11:02AM)

- Ресурсы: **МЦ 91/108 размещено + 15 узлов НЕ размещено** (реальная
  потребность 106/108), ПТ 331/540 — запас; **входы ФБ 216/216 — все 6 ФБ
  по 36/36\***. `ERROR:Cpld:891 — Cannot place signal por_sh<0>`; не
  разместились `hold_req__or0000_D2` (**24 входа!**), `shreg<2,6,7,8,9>`,
  `por_sh<0..7>`, `rd_drive_D2`. Compiler Options: Input Limit 28 —
  декоды в лимит влезают, дублирование по ФБ — нет.
- Сериальный захват v3 СДЕЛАЛ СВОЁ (AH-пины в 1 ФБ: D-функции битов shreg
  25–29 → 16–22 входа), НО каждая загрузка кадра всё ещё несёт ПОЛНЫЙ
  декод: `baud_tick` (4 вх) + `bit_cnt==9` (4 вх) + `tx_byte` (2 вх) =
  10–11 литералов × 2–3 загрузки НА КАЖДЫЙ БИТ shreg — и это копируется в
  каждый ФБ, где лежит бит (фит разложил shreg по FB2/FB4/FB5/FB6) =
  ~80–100 слотов входов на сериализатор против ~45–50 при упаковке в
  1–2 ФБ.
- UCF в этом фите применился: HOLD = P81 OUT ✓, PGND 8 шт без P81 ✓,
  `tx_req`/`sod_q`/`tx_pass` в нетлисте нет ✓ (имена `$OpTx$…` — служебные
  хелперы фитайтера, НЕ наши сигналы).

### Фит v4 (retro_pcld_top.rpt 11-1 6:16PM; заархивирован:
### retro_pcld_top (v4-fit-1101-618PM-FAILED).rpt)

- Ресурсы: **МЦ 94/108 размещено + 12 узлов НЕ размещено** (реальная
  потребность 106/108 — В ЛИМИТЕ), ПТ 307/540 — запас, ноги 73/81 —
  запас; **входы ФБ 212/216 (98%) — свободно 4 слота на весь кристалл**.
  `ERROR:Cpld:892 — Cannot place signal shreg<8>` + `WARNING:Cpld:897`
  (буферизация `A<4>` в FB1); не разместились `shreg<1..8>` (10–14 ПТ,
  17–27 вх.), `baud_cnt<1..3>` (6–9 ПТ, 17–19 вх.), `por_sh<1>` (3 ПТ/
  6 вх. — не влез из-за 4 свободных слотов ВОВСЕ).
- Хелперы `adv_q`/`ld_q` своё СДЕЛАЛИ — декоды кадров больше не копируются
  в биты shreg (v3-диагноз снят). Остались ТРИ ЖИРА: (1) **параллельные
  загрузки** `{addr_latch / bus_reg, 1'b0}` — 8+8 источников данных +
  декоды ld_q/tx_byte в каждый ФБ с битом shreg; (2) **9-литеральный
  строб захвата** с предзагрузкой shreg<=000 — размазан по 13 регистрам
  (9 бит shreg + 4 baud_cnt); (3) **win_hit с 7-литеральным декодом
  EXCL_PAGE** — AH8–14 в FB6: `hold_req__or0000_D2` = 10 ПТ/23 вх.,
  HOLD = 8 ПТ/19 вх.
- UCF применился: HOLD P81 OUT ✓, PGND 8 шт без P81 ✓, SOD P72 вход ✓.
- → лекарство v5 (ниже).

### Фит v5 (retro_pcld_top.rpt 11-1 7:31PM; заархивирован:
### retro_pcld_top (v5-fit-1101-731PM-FAILED).rpt)

- Ресурсы: **МЦ 103/108 размещено + 8 узлов НЕ размещено** (потребность
  ~111/108 — перелив ~3 МЦ, впервые считаемся и по МЦ), ПТ 383/540 —
  запас, ноги 73/81 — запас; **входы ФБ 213/216 (99%) — свободно 3 слота
  на весь кристалл**. `ERROR:Cpld:892 — Cannot place signal shreg<8>`
  (**18 ПТ/26 вх.!**); не разместились `bit_cnt<1>` (7 ПТ/9 вх.),
  `tx_byte_FSM_FFd2` (4/10), `hold_req__or0000` (5/17), дубли
  `A<3>_BUFR`/`A<4>_BUFR` (по 10 ПТ/12 вх. — WARNING:Cpld:896, FB1
  переполнен) и 2 mux-хелпера `$OpTx$1712/1718`.
- Хелперы 22.2 СДЕЛАЛИ СВОЁ: **shreg<1..7> РАЗМЕСТИЛИСЬ** (по 2 ПТ/5 вх. —
  в фите v4 не размещался НИ ОДИН бит), por_sh/baud_cnt легли; окно
  8000-BFFF сработало (AH8–13 из FB6 ушли: hold_req 23 → 17 вх.). НО
  **мультиплексор in_frame всё равно тащит 8+8 источников**
  (`addr_latch[bc-2]` ИЛИ `bus_reg[bc-2]`) — XST свернул его ЦЕЛИКОМ в
  `shreg<8>.D` = 26 входов (18 ПТ) — в такой ФБ не помещается.
- UCF применился (HOLD P81, PGND 8 шт без P81). → лекарство v6 (ниже).

## Лекарство v6: сдвиг источников кадров 2/3 к LSB (инжекция одного провода)

`in_frame` в v5 выбирал бит (bc−2) из ПОЛНОГО регистра (8+8 источников +
выбор) — фиттер сворачивал его в `shreg<8>.D` (26 вх.). Лечение:

- **addr_latch и bus_reg СДВИГАЮТСЯ ВПРАВО (к LSB) синхронно с
  инжекцией**: тик adv_q с bc=2..9 кадра N читает `addr_latch[0]`/
  `bus_reg[0]` И сдвигает регистр (`{1'b0, r[7:1]}`); за 8 тиков мимо
  инжекции проходят ВСЕ 8 бит (A0..A7 / D0..D7), к концу кадра регистр
  = 0. `in_frame` худеет с 26 до ~8 входов (bc, tx_byte, al[0], br[0],
  константы); mux-хелперы с литералами D(i)/addr_latch(i), i>0 — УМИРАЮТ;
  D-функция shreg<8> становится размещаемой. **НОВЫХ ТРИГГЕРОВ НОЛЬ** —
  регистры уже есть; цена — 3 ПТ на бит (терм сдвига) в addr_latch/bus_reg.
- **Безопасность базы**: сдвиг стартует с bc=2 ПЕРВОГО кадра — ~1,9 мкс
  после WR#(вверх); writeback (WB1..4, A/D-пины гонят эти регистры)
  кончается через ~0,2 мкс — ЗАПАС ~1,7 мкс. Вне пакета сдвига НЕТ
  (условия TXB_HI/TXB_LO + adv_q); загрузка T1/T2 — прежняя (приоритет
  выше — else-if в шинном движке).
- Прогноз: **~102–106/108 МЦ** (−4..−6 хелпер-МЦ, дубли A<3:4>_BUFR
  складываются обратно в FB1), **вх. ФБ ~185–205/216**, ПТ ~350–380.
  Провод НЕ изменился ([hi][lo][data] 8N1, бит 520 нс) — ПК-софт БЕЗ ПРАВОК.
- План Б: (а) ISE Fit → Properties → **Collapsing Input Limit 36 → 24–28**;
  (б) окно ЕЩЁ уже (A15 & !AH14 & !AH13 = 8000–9FFFh); (в) BAUD_DIV 13 → 16
  (бод 1 562 500, натуральный wrap минус декод ==12); (г) por_sh 8 → 4
  (БАЗА — только с одобрения!).

## Лекарство v5 (история): окно 8000-BFFF + сериальная предзагрузка кадров 2/3

Хелперы adv_q/ld_q своё сделали (декоды кадров больше не копируются в
биты shreg — провал v3 снят), но в фите v4 осталось три жира:

1. **Параллельные загрузки** `{addr_latch / bus_reg, 1'b0}` в конце
   кадров тащат в каждый ФБ с битом shreg 8+8 источников данных + декоды
   ld_q/tx_byte.
2. **9-литеральный строб захвата** (`state==S_T2 && !WRn && !wr_seen &&
   hold_req && TXB_IDLE`) с предзагрузкой `shreg<=000` размазан по 13
   регистрам (9 бит shreg + 4 baud_cnt).
3. **win_hit с 7-литеральным декодом EXCL_PAGE** держит AH8–14 в FB6:
   `hold_req__or0000_D2` = 10 ПТ/23 вх., HOLD = 8 ПТ/19 вх.

Лекарства:

- **Окно = 8000h–BFFFh** (решение владельца, `A15 && !AH14` — 2 литерала
  вместо 7): AH8–13 уходят из FB6, `hold_req__or0000_D2` растворяется
  (hold_req.D ~3 ПТ/~11 вх., HOLD ~2–3 ПТ/~9 вх.); стек fw_mon (FFEx–FFF8)
  и C000–FFFF — вне окна ПО ПОСТРОЕНИЮ.
- **Кадры 2/3 грузятся в shreg СЕРИАЛЬНО, во время передачи предыдущего**
  (классический двойной буфер): вход shreg<8> на тике bc кадра N = бит
  (bc−1) кадра N+1: bc0 → '1' (стоп текущего), bc1 → '0' (старт
  следующего — только если кадр ЕСТЬ), bc2..9 → addr_latch[bc−2] (кадр 2)
  / bus_reg[bc−2] (кадр 3) / '1' (кадра 4 нет — idle). Параллельных
  загрузок больше НЕТ: D-функция бита shreg<8:1> = 3 ПТ/~5 входов — все
  9 бит ложатся в ОДИН ФБ по построению; источники данных — только в
  мультиплексорах in_cap/in_frame (каждый в своём МЦ).
- **Строб захвата = только взвод cap_run** (8 литералов в ОДНОМ триггере
  вместо размазки на 13): предзагрузка shreg<=000 УДАЛЕНА (старт-бит
  заходит через in_cap на bc==0), счётчики в стробе не трогаются
  (bit_cnt==0 в TXB_IDLE — структурный инвариант: ld_q конца кадра 3 и
  сброс пишут 0), !wr_seen удалена (повторный старт блокирует !cap_run
  со 2-го тика !WRn — состояние то же).

Захват hi: 8 → 9 тиков (bc 0..8) — последнее чтение AH на 400-й нс от
спада WR# (окно валидности AH 650–700 нс — запас ~250 нс; в v4 было 360).
Старт-бит кадра 1 виден на тике 10 от первого !WRn (в v4 — на 9-м);
сетка дальше ТА ЖЕ: baud_cnt<=1 в конце захвата, старт-бит ровно 13
тиков, зазоры 0, кадр ровно 130 тиков. **Провод НЕ изменился**:
[hi][lo][data] 8N1, бит 520 нс — ПК-софт БЕЗ ПРАВОК.

Бюджет: МЦ ~105–107/108 (−hold_req__or0000_D2, +in_cap/in_frame); ПТ
~330–360/540; **вх. ФБ ~170–195/216 — ЗАПАС впервые с v1**. Ноги 73/81,
UCF без правок (AH8–14 — входы мультиплексора in_cap). План Б: ISE Fit →
Collapsing Input Limit 36 → 24–28 (узлы уже мелкие — докрутит упаковку
без новых МЦ).

## Лекарство v4 (история): регистровые хелперы adv_q/ld_q + shreg 9 бит

Два триггера:

```
adv = (tx_byte != IDLE) && baud_tick;   ld = adv && (bit_cnt == 9);
adv_q <= adv;   ld_q <= ld;
```

**Выход триггера фиттер НЕ МОЖЕТ коллапсировать в D-функции потребителей**
— каждый ФБ с битом shreg платит 1 вход вместо ~10 развёрнутых декодов.
D-функция бита shreg сжимается с 16–22 до ~9 входов (adv_q, ld_q, сосед,
источник, tx-селект, RST/por) → все 9 бит shreg упаковываются в 1–2 ФБ
(~45–50 слотов вместо ~80–100); hold_req.D ~24 → ~20.

Плюс shreg 10 → 9 бит: **стоп-бит подставляет ИНЖЕКТ '1'** при сдвиге
(`{1'b1, shreg[8:1]}`); после 9 сдвигов shreg сам приходит в все-'1' =
idle — отдельная idle-загрузка (10'h3FF в v2/v3) УДАЛЕНА. Захват hi
10 → 8 тиков: старт-бит **предзагружается** (`shreg <= 9'h000` на старте
захвата: b0=0 = старт, b8..b1 = 0 вымываются 8 сдвигами), мультиплексор
входа стал **чистым 8:1** (`ah_rev[bit_cnt[2:0]]` — без констант старта/
стопа и без 3-бит вычитания v3).

Фазировка сетки: в конце захвата `baud_cnt <= 4'd1` (НЕ 0) — первый сдвиг
кадра ровно на 13-м такте после спада TX (старт-бит ровно 13 тиков);
загрузки кадров — по ld_q (на такт позже baud_tick), baud_cnt НЕ трогается
→ сетка 13 тиков и зазоры 0 точные (симуляция: фронты на сетке S1+130·k).

**Провод НЕ изменился вовсе**: `[hi][lo][data]` 8N1, бит 520 нс, кадр
ровно 130 тиков, зазоры 0, HOLD до конца пакета, релиз в стоп-бите кадра 3
(+1 такт к v3 — не видно). ПК-софт БЕЗ ПРАВОК.

Механика: `cap_run` ставится тем же стробом (`state==S_T2 && !WRn &&
!wr_seen && hold_req && TXB_IDLE`); счётчик фазы — штатный `bit_cnt`
(0..7 в захвате); во время фазы `case(tx_byte)` не выполняется (защитный
релиз IDLE недостижим); `TX = shreg[0] | cap_run` (1 ПТ в IO-MC) — во
время захвата TX='1', джанк сдвига и предзагрузка в линию не выходят.

Тайминг захвата: старт — на тик после первого `!WRn` (перепад state в T2),
8 тиков = ~320 нс от спада WR#. Окно валидности AH-пинов: ~650–700 нс от
спада WR# — запас вырос (был ≥130 нс при 10 тиках).

## Протокол (не изменился с v2; окно — новое в v5)

| Параметр | Значение |
|---|---|
| Триггер | запись в ОЗУ **окна 8000h–BFFFh**: `!IOM && A15 && !AH14 && S0 && !S1` (статус ВМ85А: MW = IO/M#=0, S1=0, S0=1; стабилен с начала цикла; решение владельца, п.22) |
| Вне окна | **по построению**: стек/переменные fw_mon FFE8–FFF8 и вся область C000–FFFF — мимо потока и **без HOLD** (декод-исключение EXCL_PAGE удалён — экономия 6 литералов) |
| Пакет | **3 байта 8N1**: `[A15..A8][A7..A0][данные]`; A15 в hi-байте всегда 1 (в окне — A15=1 и A14=0) |
| Бод | **1 923 077,8** (`BAUD_DIV = 13`; бит ровно 520 нс) |
| Задержка | ~16–18 мкс на запись (HOLD = T1 → конец пакета, 30 бит) |
| Потолок | ~55 тыс. записей/с; экран 80×25 ≈ 36 мс |

## Как это работает (одна запись в ОЗУ)

```
T1 (ALE=1): win_hit = !IOM && A15 && !AH14 && S0 && !S1 (окно 8000-BFFF, п.22)
            -> hold_req=1 -> HOLD(P81) - ВМ85А сэмплирует его в T2 ЭТОГО ЖЕ цикла
T2 (1-й тик !WRn): данные записи -> bus_reg (штатный захват v3);
            cap_run=1 (ТОЛЬКО взвод, п.22): 9 тиков - старт-бит ('0' на bc==0)
            и A8..A15 сдвигом с AH-пинов (AH живы весь цикл записи);
            затем TX='0' - старт (виден на тике 10 от первого !WRn)
кадры 1/2: следующий байт (addr_latch/bus_reg) СЕРИАЛЬНО предзагружается
            во время передачи текущего: инжекция ОДНОГО провода ([0]),
            источник СДВИГАЕТСЯ к LSB (п.23); на ld_q меняются только
            tx_byte/hold_req
конец кадра 3 (стоп): tx_byte->IDLE, hold_req=0 (shreg уже все '1' -
            in_frame кадра 3 льёт '1') - CPU покидает HLDA ПОСЛЕ конца
            пакета (раньше нельзя: hi следующей записи попал бы в
            работающий сериализатор)
```

Пока CPU вне шины (`tx_hold = hold_req | hlda_q`), выбор памяти гасится
жёстко (`CS_n`/`CSr_n` = 1); выбор ОЗУ в WB — от состояния FSM (п.16 базы).
Защитная ветка: hold_req, не подкреплённый пакетом (глюк S0/S1), снимается
при HLDA + FSM=IDLE — пинг-понг 1–2 мкс.

## Правила для прошивки

1. Писать в ОЗУ можно **куда угодно** — логгер прозрачен (writeback v3
   доезжает до SRAM штатно).
2. Стек fw_mon (FFE8–FFF8) и вся область **C000–FFFF — вне окна** (п.22):
   CALL/PUSH не тормозят и в поток не пишутся.
3. Плотные записи троттлятся до ~55 тыс./с; для «текстового экрана»
   незаметно.
4. **Видеобуфер должен лежать в 8000h–BFFFh** — записи выше BFFF на ПК
   не попадают (если понадобится шире — вернуть декод EXCL_PAGE:
   +6 литералов, не лезло в v2–v4).

## Сторона ПК

Приёмник 1 923 077 8N1, кадры тройками `[hi][lo][data]`; фильтрация и
рендер — целиком на ПК.

```python
import serial
s = serial.Serial("/dev/ttyUSB0", 1923077)      # ядро >=2.6.32, драйвер ch341
# Если ОС/драйвер не берёт произвольную ставку - ioctl(TCSETS2) c BOTHER:
import fcntl, termios, struct
def set_custom_baud(fd, baud):
    TCSETS2 = 0x402C742F                        # x86_64/aarch64
    cflag = termios.CS8 | termios.CREAD | termios.CLOCAL | termios.BOTHER
    buf  = struct.pack("IIII", 0, 0, cflag, 0)  # iflag/oflag/cflag/lflag
    buf += struct.pack("B", 0) + bytes(19)      # c_line + c_cc[19]
    buf += struct.pack("II", baud, baud)        # ispeed/ospeed (всего 44 байта)
    fcntl.ioctl(fd, TCSETS2, buf)
# разбор: поток байт группами по 3: addr = hi<<8 | lo; data = третий байт.
# ПК сам решает: addr в регионе экрана -> рисовать, иначе -> лог.
```

Windows (CH341SER): pyserial принимает 1923077 напрямую (SetCommState);
проверить на стенде.

## Ресурсы / верификация v6

- Прогноз от фита v5 (потребность ~111 МЦ, вх. ФБ 213/216): **минус
  mux-хелперы ($OpTx$1712/1713/1716/1717/1718/1719) и дубли
  A<3:4>_BUFR = ~102–106/108 МЦ**; ПТ ~350–380/540; **вх. ФБ
  ~185–205/216**. Ноги 73/81, UCF без правок.
- `scripts/sim_txclient_v6.py` — **55/55 ПАСС** (2026-11-02; модель РОВНО
  по RTL п.23: инжекция СТАРОГО LSB, сдвиг источников в шинном движке с
  приоритетом ниже загрузки): фаза захвата цикл-точна (ровно 9 тиков,
  старт-бит через мультиплексор на bc==0, TX='1' всю фазу, старт-бит на
  тике 10 от первого !WRn; порядок битов из in_cap — тест 0xB3), кадры
  hi/lo/data бит-в-бит как v5, сетка 13 тиков, зазоры 0, HOLD на весь
  пакет и релиз в конце стоп-бита кадра 3, гейты CS в tx_hold (/WE ровно
  2 тика), границы окна: BFFF — захват [BF][FF][9D], C000 — мимо, FFxx,
  ПЗУ, IO, чтение ОЗУ без HOLD вовсе, бэку-ту-бэк (6 кадров), ложная
  классификация (защитный релиз), сброс в фазе захвата и посреди пакета;
  НОВОЕ (T12, п.23): в окне WB (WB1..WB4) регистры ЦЕЛЫ (/WE 2 тика,
  /CE ОЗУ=0 — writeback состоялся), на 1-й инжекции (bc=2) addr_latch
  ещё цел, addr_latch=0 к началу кадра 2, bus_reg=0 к началу кадра 3.
- `scripts/tb_txclient_v6.v` — для владельца: `iverilog -o tb_v6.vvp
  scripts/tb_txclient_v6.v top_txclient_v6_utf8.v && vvp tb_v6.vvp`
  (фаза захвата ровно 9 тиков, TX='1' в ней; вне-оконность C000; п.23:
  к концу пакета addr_latch/bus_reg = 0).

## Что делать (v6) — ИСТОРИЯ (кандидат теперь v7)

1. **UCF = `beta/txclient/top_txclient.ucf`** (HOLD = P81!). Фит → `.rpt`
   на аудит: прогноз ~102–106/108 МЦ, вх. ФБ ~185–205/216; `adv_q`/`ld_q`
   в нетлисте быть ОБЯЗАНЫ; в shreg<8>.D допустимы РОВНО `addr_latch[0]`
   и `bus_reg[0]` (литералы с индексами 1–7 появились — фит из старого
   исходника); в addr_latch<7:0>/bus_reg<7:0> ДОЛЖНО быть слагаемое
   сдвига п.23 (adv_q & TXB & bc>=2 & сосед); mux-хелперов $OpTx$ с
   D(i)/addr_latch(i), i>0 — быть НЕ ДОЛЖНО; `tx_req`/`sod_q`/`tx_pass`
   быть не должно; `shreg<0>` в IO-MC P39; HOLD P81 = OUT со знаком `~`;
   PGND = ровно 8 пинов без P81; AH-пины только в ОДНОМ ФБ (вх. in_cap).
2. Прогнать `scripts/tb_txclient_v6.v` у владельца.
3. `.jed` в плату; осциллограф: TX idle '1'; после записи в ОЗУ
   8000-BFFF — пакет 3 байта, бит 520 нс; HOLD '1' от T1 записи до конца
   пакета; чтения ОЗУ, записи FFxx и C000+ HOLD не дают.
4. ПК-приёмник (сниппет выше) — фильтрация и «текстовый экран» на ПК.
5. Если снова не ляжет: ISE Fit → Properties → **Collapsing Input Limit
   36 → 24–28** и перефит (узлы уже мелкие); дальше — план Б п.23
   (окно 8000–9FFF / BAUD_DIV 16 / por_sh 8→4 — база, с одобрения).

---

# v7-логгер: база v3.9.3 — сброс логики и сериализатора → СЕТЬ GSR (текущий кандидат)

Директива владельца (11-3): «на основе последнего lowsize дизайна можно
попробовать txclient». RTL v6 БЕЗ ПРАВОК (протокол [hi][lo][data] 8N1,
бит 520 нс, окно 8000-BFFF, инжекция одного провода п.23 — всё бит-в-бит);
меняется ТОЛЬКО сброс (п.24 шапки RTL):

- **что было** (база v3.9.2 во всех фита́х txclient): `cpu_rst = RST | por_run`
  синхронно в D-функциях всех триггеров; в проваленном фите v5 фиттер
  развёрнул его в **RST×151 + por_run×155 = 306 литералов** (+12 импортов
  во все 6 ФБ) — прямое давление на непоместившиеся узлы (shreg<8>
  18ПТ/26вх, bit_cnt<1>, tx_byte_FSM_FFd2, hold_req__or0000);
- **что стало**: ОБА always-блока (шинный движок 38 триггеров +
  сериализатор 24) описаны асинхронно (`posedge clk or posedge RST,
  if (RST)`) → фиттер сводит общий асинхронный сброс на СЕТЬ GSR (пин P1
  и так GSR/I/O; схема доказана фитом v3.9.3 11-2: «GSR : 1 1», железо
  ПАСС, литералы 133 → 3, вх. ФБ −7…−9, ПТ −14…−17); `cpu_rst` УДАЛЁН
  (в коде 0 упоминаний); вне домена — por_sh/por_run (POR только по
  питанию, INIT=FF/1) и делитель cnt/x1_n (X1 не глушится);
- **защита окна POR — ДВА гейта !por_run** (FSM и сериализатор в окне POR
  живые, шина CPU «floated»): (1) вход в writeback (`S_T2 → WB1`) — класс
  v3.9.3 п.18: /WE в окне POR невозможен ПО ПОСТРОЕНИЮ; (2) взвод
  `hold_req` в T1H — НОВОЕ, специфика txclient (аналога в v3.9.3 не было —
  там не было HOLD-движка): floated A/S0/S1 не взводят hold_req → HOLD/HLDA
  и ложный захват с мусорным кадром в TX невозможны (cap_run возможен
  только при hold_req=1 — второго гейта не нужно);
- **поведение**: сброс стал асинхронным — нажатие SW20 мгновенно гасит FSM
  и пакет (HOLD падает сразу, TX→'1' сразу, shreg→1FF через SET-ветку GSR;
  v6 — на такт позже); класс-риск GSR (recovery/removal) — самозатухающий
  (FSM в IDLE, оба гейта стоят), на v3.9.3 железом НЕ проявился.

Верификация: `scripts/sim_txclient_v7.py` — **68/68 ПАСС** (11-3): все
сценарии v6 (пакеты бит-в-бит, окно BFFF/C000/FFxx, бэку-ту-бэк, CS-гейты,
T12-сдвиг источников) + НОВОЕ: T8/T9 сброс = GSR-семантика (мгновенно,
ещё ДО такта), T13 — hostile-«плавания» шины в окне POR (3000 тактов,
методика sim_v393_gsr.py): ноль /WE, ноль HOLD, ноль TX, cap_run/hold_req
ни разу, FSM живая но WB1..4 недостижимы; после POR — штатный пакет
[80][12][5A]; T14 — сброс посреди пакета гасит HOLD мгновенно.
`scripts/tb_txclient_v7.v` — для владельца (Icarus): то же + T6 POR-окно
на LFSR 2000 тиков (force dut.por_run) и T7 сброс посреди пакета (`#1`
после `RST=1` — проверка мгновенности GSR).

Прогноз (от фита v5: потребность ~111 МЦ, вх. ФБ 213/216, ПТ 383): **МЦ
~100–105/108, вх. ФБ ~178–198/216, ПТ ~335–375/540** (эффект v3.9.3
масштабируется: литералов сброса здесь 306 против 133 — выигрыш НЕ
меньше); триггеров 75 (54 v3.9.2 − 3 SOD/UART + 24 сериализатора), из них
**62 через GSR**; ноги 73/81, UCF без правок; план Б п.23 (Collapsing
Input Limit 24–28) остаётся в резерве.

## Фит 1 (11-3 6:46PM) — Placement Failed: аудит GSR ПАСС, стена — ёмкость

Отчёт заархивирован: `retro_pcld_top (v7-fit1-1103-646PM-FAILED).rpt`,
аудит — `scripts/fit_audit_v7.py`. Итог: **107/108 МЦ размещено (99%),
310/540 ПТ (57%), 208/216 вх. ФБ (96%), 68 триггеров, ноги 73/81; НЕ
размещено 7 узлов** — shreg<8> (18ПТ/19вх, ERROR:Cpld:892), D<0,1,2,3,5>_BUFR
(по 7ПТ/18вх), addr_latch<1> (3ПТ/9вх) → **потребность 114 МЦ против 108**,
перелив ~6; прогноз п.24 (100–105) оптимистичен на ~10. Упаковка по краю
всюду: ФБ1/3/5/6 = 18/18\* МЦ, ФБ2/5/6 = 36/36\* вх. ФБ; предупреждения 897
(ФБ1) и 896 ×5 (ФБ3).

**Мера п.24 (GSR) СРАБОТАЛА — главный позитив фита:**

- литералы сброса в термах: **RST×1 (RESET_IN) + por_run×4 (RESET_IN + оба
  гейта п.24: S_T2→WB1 в state_FSM_FFd1_D/FFd3_T + взвод hold_req в HOLD_D)
  = 5 против 306 в v5**; cpu_rst — 0; порт-мэпов с por_run — 0 (пор-цепь вне
  домена бит-в-бит п.24);
- анатомия 75 триггеров: **53 CLR=RST + 9 PRE=RST** (все девять бит shreg —
  сброс в '1' idle через SET-ветку GSR!) = **62 в GSR-домене**; 13 вне
  домена (por_sh×8, por_run, cnt×3, x1_n) — ровно по плану;
- SR-ПТ нигде не начислены (суммы ПТ уравнений = итогам ФБ: ФБ2 55=55,
  ФБ3 41=41, ФБ4 42=42, ФБ6 64=64), RST в сигнальных списках только в ФБ4
  (гейт RESET_IN) — сброс бесплатный, GSR в модели включилась;
- ПТ 310 — ЛУЧШЕ прогноза (335–375) и на 73 лучше v5 (383);
- строки «Global clock/set-reset net(s) unused» в шапке — **артефакт любого
  проваленного фита** (то же в v2/v3/v4/v5; в успешных rpt строка заменяется
  на «Signal 'RST' mapped onto global set/reset net GSR») — формальный чек
  «GSR : 1» переносим на первый УСПЕШНЫЙ фит;
- чек-лист п.24: RESET_IN, оба гейта, пор-цепь/делитель без GSR, adv_q/ld_q,
  HOLD P81, TX P39 — ВСЁ на месте; единственное отклонение — в shreg<8>.D
  литералы AH8-14×bit_cnt: это КОЛЛАПС in_cap (единственная нагрузка —
  shreg<8>), а не старый исходник (литералов addr_latch/bus_reg[1..7] нет).

**Почему не влез — две стены:**

1. МЦ: TX-блок добавил ~29 МЦ к базе 85 → 114 > 108. Сдвиг источников п.23
   сузил shreg<8> (26→19 вх), но МЦ НЕ убрал, а упаковку сделал жёстче.
2. вх. ФБ: свободно 8 слотов на весь кристалл (по ФБ: 1/0/3/4/0/0), а
   сиропам нужно: shreg<8> — 19 (in_cap коллапсировал в D), 5×D<X>_BUFR —
   по 18 (T1H/T2-захват + shift-гварды п.23 разнесли ширину из shreg<8> в
   шинные регистры: размещённые D<6>_BUFR 22 сигн./12 вх., D<4>_BUFR 21/17,
   D<7>_BUFR 19/11), addr_latch<1> — 9.

**Лекарства (арифметика от 114):**

- **М1 — por_sh 8→4 со стробом вдвое реже** (por_ce = 1 строб на цикл cnt
  вместо пары cnt==1|cnt==6 с её интервалами {200,80}): POR = 4×280 нс ≈
  **1120 нс ≥ 840 нс** — запас ×1,33, практически тот же (сейчас 1140 нс);
  возражение расчёта из п.18 (560 нс < 840) считало СТАРЫЙ строб. −4 МЦ
  (por_sh<7:4>, вся четвёрка в ФБ2: 18/18\*→14), −8..10 ПТ, −4 вх.ФБ →
  **110**. Требует одобрения владельца (база) + правки POR-тестов в симах.
- **М2 — Input Limit 28→18** (Plan Б п.22/23, ещё не применялся; сам
  ERROR:892 его и просит): in_cap (11 вх) остаётся узлом, shreg<8>.D
  худеет до ~8 вх, 892 уходит. Цена +1..2 МЦ → 111–112. Применять ПОСЛЕ М1.
- **М3 — READY и CS1 = '1'** на отдельных МЦ (0 ПТ, константы): если плате
  можно завязать их аппаратно — −2 МЦ → 109. Решение за владельцем (плата).
- М4 (резерв) — hlda_q → HLDA напрямую (вход квазистатический) — −1 МЦ.
- Итог: 114 − 4 + 2 − 2 (−1) = 108–109 + упаковочная вариативность хелперов
  $OpTx$ (сейчас 3; в v3.9.3 фит1→фит2 было 9→7) — впритык; если не ляжет —
  М4 и компрессия cap_run/ld_q/adv_q в tx_byte FSM.

## Что делать (v7)

1. В ISE-проекте заменить исходник на **`top_txclient_v7.v` (CP1251!)**,
   UCF прежний (`beta/txclient/top_txclient.ucf`, HOLD = P81).
2. Фит → `.rpt` на аудит ДО прошивки: `python3 scripts/fit_audit_v7.py
   <отчёт>`. Ключевые точки: литералы RST/por_run в термах ≤ 5, cpu_rst 0;
   62 триггера в GSR-домене (53 CLR=RST + 9 PRE=RST = shreg); SR-ПТ = 0
   (суммы ПТ сходятся); в первом УСПЕШНОМ фите — строка «Signal 'RST'
   mapped onto global set/reset net GSR» / «GSR : 1»; непоместившихся узлов
   НЕТ (потребность ≤ 108 МЦ).
3. Прогнать `scripts/tb_txclient_v7.v` у владельца.
4. `.jed` в плату; осциллограф — как v6 (TX idle '1', пакет 3 байта после
   записи в 8000-BFFF, HOLD на весь пакет, бит 520 нс) + НОВОЕ: нажатие
   SW20 во время пакета гасит HOLD мгновенно (GSR, п.24).
5. Следующий фит — только ПОСЛЕ мер: (М1) по одобрению готовлю v8 —
   por_sh 8→4 + строб вдвое реже (POR ≈ 1120 нс ≥ 840, RTL+симы+tb);
   (М2) в ISE: Fit → Collapsing Input Limit 28→18; (М3) вопрос по плате:
   можно ли аппаратно завязать READY/CS1 (−2 МЦ)?

---

# v8-логгер: М1 — por_sh 8→4 со стробом вдвое реже (текущий кандидат)

Одобрение владельца (11-3): **«Делай M1»** — мера №1 из аудита фита 1 v7.
RTL v7 БЕЗ ПРАВОК в логике шины и сериализатора; меняется ТОЛЬКО POR-цепь
(п.25 шапки RTL). Кодовая дельта — **4 строки**:

- `reg [7:0] por_sh = 8'hFF` → **`reg [3:0] por_sh = 4'hF`** — сдвиговый
  регистр вдвое короче (−4 МЦ: por_sh<7:4> исчезают);
- строб `por_ce = (cnt==1)|(cnt==6)` → **`por_ce = x1_n`** (ветка
  g_div2p5): регистровый импульс 40 нс в [140,180) каждого периода cnt
  280 нс (п.17) — **ровно ОДИН posedge-строб за период ПО ПОСТРОЕНИЮ**
  (было два: {200,80} нс — наследие требования бит-в-бит v3.9);
- сдвиг `{1'b0, por_sh[7:1]}` → `{1'b0, por_sh[3:1]}`.

**Почему строб — именно x1_n** (а не декод одного состояния cnt):

1. **декодов равенства в POR-пути больше НЕТ ВОВСЕ** — класс фитов 7:31 и
   8:55 («фиттер печатал por-декоды с потерянной инверсией», п.8 шапки)
   остаётся исключён; в фите 1 v7 декод por_ce (6 литералов) был
   реплицирован во все 8 T-цепей por_sh;
2. T-цепь бита худеет до `x1_n AND (sh[k] XOR sh[k+1])` — 2 ПТ/3 литерала
   (por_sh<3> — 1 ПТ/2: в сдвиг входит '0');
3. цена строба — 1 импорт ФБ (x1_n) вместо трёх (cnt<0..2> в фите 1 v7
   разбросаны по ФБ1/ФБ2/ФБ6).

**Тайминг POR**: 4 × 280 = **1120 нс** при норме 3 такта CLK OUT = 840 нс
(запас по номиналу ×1,33, как в v3.4/v3.8/v7); от INIT фактический низ
RESET_IN ~**1040 нс** (первый строб x1_n на t=160 нс, снятие por_run на
26-м такте 25 МГц; в v7 было ~1160 нс) — обе величины ≥ нормы. Возражение
п.18 lowsize («por_sh 8→4: POR 560 нс < 840») считало СТАРЫЙ строб
2/период (4×140=560) — со стробом 1/период мера легальна.

**Экономика** (арифметика аудита от фита 1 v7): потребность МЦ 114 → **110**
(−4 МЦ por_sh<7:4>, вся четвёрка por_sh<3:0> — в ФБ2: 18/18\*→14), ПТ
310 → ~290–300 (T-цепи 2ПТ/5лит → 2ПТ/3лит + минус убранные биты), вх. ФБ
208 → ~204 (−4); триггеров 71 (75−4), из них 62 в GSR-домене — без
изменений. МЦ всё ещё впритык (110 > 108): **shreg<8> (18ПТ/19вх,
ERROR:Cpld:892) М1 НЕ ЛЕЧИТ** — следующий шаг **М2: Collapsing Input Limit
28→18 в ISE** (сам ERROR:892 его и просит), М3/М4 — резервы.

**Фит 1 v8** (11-3 8:47PM, владелец): **Placement Failed** — ожидаемо
(«Что делать» п.4), при этом М1 перебила прогноз: размещено 100/108 МЦ,
бездомных узлов **3 против 7** в v7 (все пять D<X>_BUFR и addr_latch<1>
легли), потребность 114 → **103 МЦ**, ПТ 310 → **294**, рег 70 (= 71 минус
бездомный shreg<8>), ноги 73/81. Стена та же: **shreg<8> 18ПТ/19вх**
(ERROR:Cpld:892) + bus_reg_and0001_D2 (5ПТ/12вх) + $OpTx$FX_SC$200
(4ПТ/10вх); вх.ФБ 212/216, пять ФБ на 36/36\*, свободно 4 вх. в FB6 —
упаковка не сходится по ВХОДАМ ФБ, а не по МЦ. Сброс цел (чек-лист п.2
сошёлся): 62 в GSR-домене (53 CLR=RST + 9 PRE=RST = shreg), вне домена 9
(por_sh<3:0>, por_run, cnt<2:0>, x1_n), cpu_rst 0, RST в термах 1
(RESET_IN), por_run 4 ≤ 5; T-цепи por_sh ровно по чертежу (por_sh<3> —
1ПТ/2вх, остальные 2ПТ/3вх), декодов cnt в POR-цепи нет. **Опции прогона:
Collapsing Input Limit = 28 — М2 НЕ применялся** (узел в 19 вх. при лимите
18 не сформировался бы). Аудит: `python3 scripts/fit_audit_v7.py
"retro_pcld_top (v8-fit1-1103-847PM-FAILED).rpt"`.

Верификация: `scripts/sim_txclient_v8.py` — **73/73 ПАСС** (11-3): все
сценарии v7 + НОВОЕ **T0** — цикл-точная модель POR-цепи (cnt mod-7 +
x1_n + por_sh<3:0> + por_run, РОВНО по RTL, с NBA-семантикой por_run.D =
старый por_sh[0]): стробы ровно каждые 7 тиков (280 нс), первые четыре на
тиках [4,11,18,25] (t=160 нс), сдвиги F→7→3→1→0, por_run падает на 26-м
такте (1040 нс ≥ 21 такта нормы), повторного POR нет (1000 тиков тишины),
RESET_IN = ~(RST|por_run). `scripts/tb_txclient_v8.v` — для владельца
(Icarus): то же + T0 структурно (`dut.por_sh`/`dut.por_run`: INIT 4'hF/1 —
вне домена GSR, RST не трогает; к 30-му такту погашено; 1000 тиков без
повторного POR). Пор-цепь и делитель — вне домена GSR, как в v7 (п.24).

## Что делать (v8)

1. В ISE-проекте заменить исходник на **`top_txclient_v8.v` (CP1251!)**,
   UCF прежний (`beta/txclient/top_txclient.ucf`, HOLD = P81).
2. Фит → `.rpt` на аудит ДО прошивки: `python3 scripts/fit_audit_v7.py
   <отчёт>` (скрипт универсален). Ключевые точки v8: литералы RST/por_run
   в термах ≤ 5, cpu_rst 0; **62 триггера в GSR-домене, por_sh<3:0> — 4
   бита, T-цепи = x1_n AND (sh[k] XOR sh[k+1]), ДЕКОДОВ cnt в POR-цепи
   БЫТЬ НЕ ДОЛЖНО** (появились — фит из старого исходника); в первом
   УСПЕШНОМ фите — строка «Signal 'RST' mapped onto global set/reset net
   GSR» / «GSR : 1»; непоместившихся узлов НЕТ (потребность ≤ 108 МЦ;
   прогноз 110 — если снова перелив, это ожидаемо: следующий шаг М2).
3. Прогнать `scripts/tb_txclient_v8.v` у владельца (Icarus).
4. Если Placement Failed снова — применять М2 (Fit → Collapsing Input
   Limit 28→18) ПОВЕРХ v8 и фитовать ещё раз; М3 (READY/CS1 аппаратно) —
   вопрос по плате, М4 (hlda_q → HLDA напрямую) — резерв. Фит 1 v8
   подтвердил этот сценарий (блок «Фит 1 v8» выше): перелив случился при
   Input Limit 28 — М2 теперь обязателен.

---

# v5-логгер: окно 8000-BFFF + сериальная предзагрузка кадров (СОХРАНЁН — фит 7:31PM провалился)

**Статус:** фит 11-1 7:31PM — Placement Failed (входы ФБ 213/216, разбор
выше). RTL `top_txclient_v5_utf8.v` / `top_txclient_v5.v`, модель
`scripts/sim_txclient_v5.py` (48/48), `scripts/tb_txclient_v5.v`. Идея
сериальной предзагрузки верна (декоды кадров в хелперах, shreg<1..7>
разместились) — **v6 убирает последний жир: 16-входовый mux in_frame →
инжекция одного провода со сдвигом источника к LSB**. Протокол и всё
остальное — как у v6.

---

# v3-логгер: сериальный захват 10 тиков (СОХРАНЁН — фит 11:02AM провалился)

**Статус:** фит 11-1 11:02AM — Placement Failed (входы ФБ 216/216, разбор
выше). RTL `top_txclient_v3_utf8.v` / `top_txclient_v3.v`, модель
`scripts/sim_txclient_v3.py` (42/42), `scripts/tb_txclient_v3.v`. Идея
сериального захвата верна (AH-пины в 1 ФБ) — **v4 добавляет к ней
хелперы и 9-битный shreg**. Если v4 не ляжет — пробовать v3 с
**Collapsing Input Limit 20–24**. Протокол и всё остальное — как у v4.

---

# v2-логгер: параллельный захват hi (СОХРАНЁН — история)

**Статус:** фит 11-1 9:26AM — Placement Failed (входы ФБ 216/216, см. разбор
выше). RTL `top_txclient_v2_utf8.v` / `top_txclient_v2.v`, модель
`scripts/sim_txclient_v2.py` (37/37), `scripts/tb_txclient_v2.v`. Идея была
честная: hi-байт грузится параллельно в shreg стробом захвата T2 — но
`ah_bus` лезет во все ФБ с триггерами shreg. История цепочки: v2 → v3
(сериальный захват) → v4 (хелперы + 9 бит). Протокол и всё остальное —
как у v4.

## Прочее (общее для v2/v3/v4/v5/v6)

- Релиз HOLD — только в конце пакета: hi следующей записи при работающем
  CPU попал бы в работающий сериализатор и испортил хвост пакета №1;
  бэку-ту-бэк при этом беспотерь.
- Классификация по статусу S0/S1: чтения не тормозят вовсе (в v1 чтение
  окна = пинг-понг HOLD-HLDA); при полном ОЗУ это обязательно.

---

# v1-окно: монитор записей CPU в страницу F0xx (дешёвая альтернатива)

**Статус:** 2 байта, HOLD на голову пакета, ~77 тыс. записей/с, прогноз
~104/108 МЦ — если полный лог ОЗУ не нужен, а окно 256 байт устраивает.
RTL `top_txclient_v1_utf8.v` / `top_txclient_v1.v`, UCF
`top_txclient*.ucf`, верификация `scripts/sim_txclient.py` (29/29 ПАСС) +
`scripts/tb_txclient.v`.

## Протокол

| Параметр | Значение |
|---|---|
| Окно | страница **F000h–F0FFh** (`localparam WIN_PAGE = 8'hF0`) |
| Триггер | запись в память (`IOM=0`, `WR#=0`) с адресом страницы |
| Пакет | **2 байта 8N1**: `[адрес A0–A7][данные]`; старший байт адреса = F0h — константа |
| Бод | **1 923 077,8** (`BAUD_DIV = 13`) |
| Задержка вывода | ~11–13 мкс на запись (CPU заморожен только на голову пакета) |
| Потолок | ~77 тыс. записей/с |

## Как это работает (одна запись в окно)

```
T1 (ALE=1): декод win_hit = !IOM && {A15..A8}==F0h  ->  hold_req=1 -> HOLD(P81)
            (HOLD стабилен задолго до T2 -> ВМ85А сэмплирует его в T2 ЭТОГО ЖЕ
             цикла, HLDA - в конце его же; addr_latch/bus_reg не перезаписать)
T2:         данные записи -> bus_reg (штатный захват v3), WR# отработал
WB1..WB4:   writeback в ОЗУ КАК В v3.9.2 (запись не теряется и не дублируется)
HLDA:       CPU отпустил шину; FSM вернулась в IDLE ->
            пакет: [addr_latch][bus_reg], 20 бит, 10,4 мкс
2-й байт:   в момент его загрузки в shreg hold_req/tx_req СНИМАЮТСЯ - CPU
            работает, пока хвост пакета доезжает
```

Во время окна «CPU вне шины» (`tx_hold = hold_req | hlda_q`) выбор памяти
гасится жёстко (`CS_n`/`CSr_n` = 1): в HLDA процессор **флоатит** A15/IOM, и
живой декод выбирал бы ОЗУ/ПЗУ случайно. В WB выбор ОЗУ — по-прежнему от
FSM (п.16 базы). Заодно гейт закрывает окно «HOLD снят, HLDA ещё не упал».

HOLD берётся именно в **T1** цикла записи (а не по факту WR#): HOLD, поднятый
в T1, гарантированно сэмплируется ВМ85А в T2 этого же машинного цикла —
грант без промежуточных циклов, зафиксированный `addr_latch`/`bus_reg`
корректен всегда. Релиз — на загрузке 2-го байта.

## Почему в v1 было 2 байта (история вопроса о «4К»)

3-байтовый пакет (hi+lo+data) требует +8 триггеров под захват A8–A15: во
время HLDA наблюдатели AH8–AH14/A15 **флоат**, читать их на передаче нельзя.
От фита v3.9.2 это 85 − 3 (soft-UART) + 22 лог. МЦ txclient = ~104/108; плюс
8 МЦ под hi = 112 — **не лезет** в 108. **В v2/v3 вывод пересмотрен**: в v2
hi-байт грузится параллельно в shreg (без +8 FF, но фит не лёг по входам
ФБ), в v3 — сериально с живых пинов (и дёшево, и влезает).

## Правила для прошивки (v1)

1. Окно **только ЗАПИСЫВАТЬ**: чтение из F0xx тоже замирает CPU на один
   цикл (пинг-понг HOLD-HLDA) — без пакета, просто ~1–2 мкс простоя.
2. Код из окна **не исполнять** (выборка команды — тот же «цикл чтения»).
3. Никаких портов не нужно; стек/переменные монитора (FFE8–FFF8) окно
   не задевает.

## Сторона ПК (v1)

Приёмник 1 923 077 8N1, кадры парами `[lo][data]`, страница F0 — константа.

## Состав (v1)

| Файл | Что это |
|---|---|
| `top_txclient_v1_utf8.v` / `top_txclient_v1.v` | RTL (UTF-8 для чтения / CP1251 для ISE), round-trip проверен; шапка п.18 — полное ТЗ |
| `top_txclient_utf8.ucf` / `top_txclient.ucf` | UCF = `hdl/top_suart.ucf` + `NET "HOLD" LOC="P81"`, PGND 9→8, SOD — наблюдатель |
| `scripts/sim_txclient.py` | верификация ДО фита: модель FSM+монитора+сериализатора, **29/29 ПАСС** |
| `scripts/tb_txclient.v` | TB для владельца: `iverilog -o tb.vvp scripts/tb_txclient.v top_txclient_v1_utf8.v && vvp tb.vvp` |
| *(корень)* `top_txclient_por6_v310*.v`, `sim_txclient.py`, `tb_txclient.v` | **v3.10-порт** — сохранённая первая реализация (см. ниже) |

---

# v3.10-порт: терминальный вывод через захват записи в порт 07h (сохранено)

**Статус:** RTL готов, верифицирован цикл-точной моделью (33/33 PASS, `sim_txclient.py` в корне).
Фит в ISE НЕ выполнялся. База: **v3.9.2** — всё, кроме TX-тракта, бит-в-бит v3.9.2.

## Идея

Передатчик пишет **только то, что процессор пишет в область вывода**. CPLD ловит
запись в порт **07h** и пересылает байт в CH340G своим UART. Адрес на провод не
выносится — ПК знает, что весь поток = вывод терминала. SOD-транзит (CPU
бит-бэнжал SOD → CPLD → CH340, v3.7) удалён; приём (CH340 → CPLD → SID, RIM 20h)
не тронут. **Вопрос владельца «зачем порт 07h» закрыт**: это был триггер v3.10;
в оконной/логгерной схеме порты не нужны вовсе (04h–07h в v3.9.2 — резерв от
удалённого UART, Task 69).

## Протокол

| Операция | Смысл |
|---|---|
| `OUT 07h, A` | символ в терминал ПК (UART 115200 8N1, нога P39 → CH340G.RXD) |
| `IN 07h` | бит 0 = **TXRDY** (1 = окно приёма открыто, запись будет принята); биты 7–1 = 0 |
| `OUT 00h/01h/02h`, `IN 03h` | без изменений (сегменты / разряды+SND / колонки / KBROW) |
| `OUT 04h…06h` | резерв, как в v3.9.2 |

- Декод порта — по **A2–A0** (стиль проекта): алиасы `0Fh, 17h, …` тоже работают.
- Кадр: старт + 8 бит (LSB first) + стоп; **бит = 217 тиков 25 МГц = 8,68 мкс =
  115207,4 бода (+0,006 % к 115200; CH340G на 115200 точен)**.
- `RCONST` — параметр модуля `serial_tx` (216 по умолчанию).

## Контракт прошивки

```asm
; putchar: символ в C — без потерь, темп до ~12,5 тыс. знаков/с
PUTC:   IN    A,(07h)     ; 10T
        RRC               ;  4T   ; бит 0 -> CY
        JC    PUTC_OK     ; 10T/7T
        JP    PUTC        ; ожидание (период опроса 21T = 5,9 мкс)
PUTC_OK:MOV   A,C
        OUT   (07h),A
```

- **Пишешь без опроса — байты теряются** (окно закрыто → строб игнорируется).
  Это документированное поведение, а не дефект.
- TXRDY=1 гарантирует приём: писатель один (CPU), окно непрерывно до загрузки.

## Безопасность по построению (+2 МЦ к голой схеме uart.v)

Маркер `busy` в uart.v падает **на старте бита b7** — перезагрузка, попав в первые
50 % бита b7, портила бы ещё не отобранный приёмником бит (запас съедает
квантование CH340 ±0,2 %). В v3.10 окно приёма

```
tx_acc = !busy & !stop_q & !busy_d          (TXRDY = tx_acc)
stop_q: set — падение busy (начался b7); clear — bittick через бит (начался стоп)
```

открывается **только со старт-бита стопа** — перезагрузка физически не может
попасть в биты данных (худший случай — срезанный стоп = FE-флаг у ПК, байты
целы). Плюс 1-тактный строб `tx_send_q` вместо защёлкивания уровнем.

## Вердикт «холд vs буфер» (вопрос владельца)

Буфер: WR# к моменту захвата уже отработан, HOLD лишь придерживал бы следующий
доступ; холд = те же 21 МЦ + FSM HOLD/HLDA (+5..8) = 106..109/108 на грани
непомещения, с троттлингом CPU и касанием ноги 81 (PGND). Буфер с TXRDY-поллингом
даёт те же гарантии без потерь (период опроса 21T = 5,9 мкс < бит 8,68 мкс).
**В v1–v3 вердикт пересмотрен**: там HOLD несёт другую функцию — не защита
захвата (адрес/данные и так защёлкнуты FSM), а удержание шины, пока пакет не
загружен; в v2–v4 — ещё и гарантия валидности трёх источников пакета
(hi/lo/data) до конца передачи.

## Ресурсы / верификация v3.10

- Оценка: 103/108 МЦ (95%), ~260–280/540 ПТ, 72 триггера, ~190–200/216 вх.ФБ
  (все сигналы строба уже в матрице, новых пинов НЕТ), ноги 72/81 — UCF не меняется;
  план Б в шапке RTL (RCONST=50 → 500 кбод, −2 МЦ; без IN 07h; в пределе без stop_q).
- `sim_txclient.py` (корень) — 33/33 PASS: POR/TX='1'/TXRDY=1; кадр 55h с ширинами
  бит 217±2 тика; поток 18 байт бит-в-бит; структурная проверка «перезагрузок в
  бите b7 — 0»; перегрузка (отброс, TXRDY=0 в полёте); SOD мёртв; SID=RX жив;
  регрессия портов 00/01/02/03; writeback ОЗУ; отброс записи в ПЗУ; RESET в
  середине кадра; алиас 0Fh.
- `tb_txclient.v` (корень) — для владельца: `iverilog … && vvp`.
- ЗАМЕТКА: со старой прошивкой fw_mon вывод через SOD пропадёт (дисплей/клавиатура
  в норме) — putchar через OUT 07h в fw_mon = отдельная задача в beta/lowsize/rom;
  для v1–v3 аналогично — вывод fw_mon через запись в ОЗУ.
