digitalinvitro/CPLD-plus-8085/beta/01_timer/README.md

# beta/01_timer — программируемый интервальный таймер → RST 7.5 (P75)

Статус: **v3.3b3 — ФИТ УСПЕШЕН (2026-10-22 22:04): 103/108 MC (запас 5),
FB-входы 188/216, 0 ERROR; 1 WARNING 897 — D<7> в буфере (безвредно);
ждёт tb и железа**.
База: стабильный baseline v3.2 (`hdl/`, фит POR6). ТЗ и анализ — в
[ANALYSIS.md](ANALYSIS.md); здесь — реализация и отличия от анализа.

## Состав

| Файл | Что это |
|---|---|
| `top_suart.v` | копия стабильного v3.2 **+ таймер** (v3.3b3; в v3.3b3 код POR и TX-маски возвращён к v3.2, прескалер таймера — txm_cnt, добавлены `(* keep *)`-стробы — см. протокол ниже) |
| `top_suart.ucf` | копия стабильного UCF **+ P75 = RST75** (вышла из PGND), шапка и чек-лист обновлены |
| `tb/timer_tb.v` | тестбенч (ISim/iverilog): квант, INIT FFh, стоп-в-нуле, загрузка N, ре-арм |
| `ANALYSIS.md` | зафиксированный анализ (ресурсы, выбор вектора, математика тика) |
| `README.md` | этот файл |

## Архитектура (что добавлено, v3.3b3: 11 новых MC)

```
por_ce (X1 = 5 МГц, 1 такт clk / 200 нс, уже есть в дизайне)
   │  CE
   ▼
прескалер = txm_cnt[7:0] (УЖЕ ЕСТЬ: свободный счёт вверх от por_ce,
   в v3.2 он же — TX-маска; с v3.3b3 стоп в FF убран) ──обёртка 7Fh→80h──▶
   tmr_tick (комбинация) ──▶ tmr_tick_q (РЕГИСТР, 1 MC)
                                                                 │ 1 такт / 51,2 мкс
OUT 04h (T2, IOM, WR#=0) ──▶ bus_reg (уже есть) ──▶ tmr_load_q (РЕГИСТР, 1 MC)
                                                                 │
tmr_cnt[7:0] (8 MC): загрузка N из bus_reg, счёт вниз по тикам,
СТОП в 0 (enable = tmr_tick_q & !RST75_r), INIT/сброс = FFh
                                                                 │
RST75_r = (tmr_cnt == 0) — РЕГИСТР в МС выхода P75 (1 MC) ──▶ RST75 (P75)
```

Плюс 4 хранимых строба-хелпера `(* keep *)` (по 1 MC): `cpu_rst`, `al_cap`,
`bus_rd`, `wr_cap` — см. протокол v3.3b3 ниже.

- **Квант тика** = 256 × 200 нс = **51,2 мкс** (это строка «X1 5 МГц, k=8»
  из таблицы ANALYSIS.md §3).
- **Тик** = обёртка прескалера `7Fh→80h`: условие `tmr_tick = por_ce &
  (txm_cnt==7Fh)` захлопывается в **регистр tmr_tick_q** (1 такт clk) —
  декод 11 входов сидит в ОДНОЙ MC, а не размазан по 8 битам счётчика.
  Фаза та же, что у прежнего {tmr_hi, por_cnt}: 1-й тик через 128 por_ce
  после конца POR.
- **Счётчик** `tmr_cnt[7:0]`: параллельная загрузка N **из bus_reg** при
  `OUT 04h` (bus_reg захватывает A тем же фронтом, что seg_q; данные CPU
  держит до WR#↑ — дисциплина «последний сэмпл валиден» сохранена),
  декремент по тикам, **останов в нуле**.
- **Выход** `RST75` = регистр `RST75_r = (tmr_cnt==0)`: **фронт** защёлкивается
  CPU как RST 7.5 (вектор 003Ch), маска SIM M7.5, защёлка чистится при
  обслуживании или `SIM` R7.5. Регистр на выходе — ещё и без комбинационного
  глитча декода нуля на ноге.
- Прескалер свободный (без сброса — период 2^k от фазы не зависит);
  INIT `tmr_cnt = FFh` → после RESET **нет ложного фронта** (RST75=0), а
  без записи счёт дойдёт до нуля за 255 тиков (~13,1 мс) — CPU в этот момент
  держит маску RST 7.5 (даташит), так что прерывания не будет до снятия
  маски программой.

## Отличия от ANALYSIS.md (и почему)

| # | В анализе | В реализации | Почему |
|---|---|---|---|
| 1 | квант 102,4 мкс от **CLKOUT** (P83) | квант **51,2 мкс от внутреннего por_ce** (X1) | фронт CLKOUT приходит через ~30–120 нс (t_d CPU) после фронта X1 → сэмплирование пина в 25 МГц домене = гонка выборки; клок от пина = PT-клок. Оба варианта запрещены дисциплиной проекта (один домен 25 МГц, без edge-детекторов и PT-клоков). Сэмплер CLKOUT — это ещё +1 MC: 9+8+1 = 18 > 17 свободных |
| 2 | автоперезагрузка при нуле | **ре-арм из ISR** (`OUT 04h`) | автоперезагрузка требует 8-битный регистр значения (+8 MC → 25 > 17); bus_reg непригоден — переписывается каждым циклом чтения памяти. Ре-арм = `MVI A,N / OUT 04h` в ISR, джиттер ~5 мкс на период ~10 мс |
| 3 | период = (N+1) × квант | период = **N × квант** | счётчик останавливается в 0, повторная загрузка того же N даёт ровно N тиков между фронтами |

50 Гц при этом достигается: **N=195** (тик 9,984 мс) + **деление на 2 в ISR**
→ 19,968 мс — ровно те же 19,968 мс, что давал N=194 × 102,4 мкс из анализа.

## Протокол фита v3.3b1 → ПРОВАЛ → лекарство v3.3b2 (10-22)

Фит v3.3b1 (`retro_pcld_top.rpt`, 18:39) — **Placement Failed**:
`ERROR:Cpld:892` (Cannot place cnt<3>) + `ERROR:Cpld:868`; 98 MC размещено
+ 8 сирот (addr_latch<1..4>, tmr_cnt<0..1>, cnt<3>, A<4>_BUFR);
FB-входы 202/216 (FB1/2/3/5 — по 36/36); `WARNING:897` — A<4> ушёл в
BUFR-буфер. Смета «17 MC / ≤34 FB-входа» оказалась неверной.

**Диагноз** (по диффу с POR6 по-сигнально): остров 16 MC при 17 свободных
зажал фиттер по MC — он **схлопнул 10 хелперов XST** (`seg_q_0__or0001`,
`addr_latch_0__or0000`, `por_ce_D2`, `io_rd_kb_D2`, `$OpTx$FX_SC$164`…)
в приёмники, и вся стабильная логика v3.2 распухла по FB-входам
(D-регистры 7→13-14, col 4→15, seg 4→13-16, addr_latch 4→9-10), а общий
термин тика/нуля/загрузки `$OpTx$FX_SC$97` (**8 PT / 31 вход**) сел в FB6
и съел его целиком. Итог: спрос ~202+80 входов при бюджете 216.

**Лекарство** (то же, что спасло v3.2 — «FF не схлопывается»):

1. **Прескалер = {tmr_hi[1:0], por_cnt[5:0]}**: por_cnt после POR свободно
   считает вверх — младшие 6 бит прескалера переиспользованы (**-6 MC**).
   `por_run` сделан липким (`por_nz & por_run`) — после POR он 0 навсегда,
   повторный POR по-прежнему невозможен; поведение POR (12,8 мкс,
   INIT=FF/1, счёт только при живом clk) не изменилось.
2. **tmr_tick_q — регистр тика**: декод (por_ce & pre==7F, 11 входов) в
   одной MC, приёмникам — 1 вход вместо размазанного на 8 бит терма.
3. **RST75_r — регистр нуля в МС выхода P75**: NOR8 один раз (бонус:
   на ноге нет комбинационного глитча декода).
4. **tmr_load_q — регистр строба OUT 04h**, загрузка tmr_cnt **из bus_reg**
   (N захвачен туда тем же фронтом, что у seg_q; тактовый лаг +1 безвреден —
   bus_reg продолжает сэмплировать A, пока активен строб).
5. СТОП: `enable = tmr_tick_q & !RST75_r` — лаг регистра 1 такт безопасен:
   следующий тик только через 12 800 тактов.

Семантика НЕ изменилась: T = N × 51,2 мкс, стоп в нуле, INIT/сброс FFh,
ре-арм OUT 04h. Полный лаг цепочки +2 такта clk (80 нс) — в допусках tb
(±1 тик = ±51,2 мкс).

## Протокол фита v3.3b2 → ПРОВАЛ → лекарство v3.3b3 (10-22)

Фит v3.3b2 (`retro_pcld_top.rpt`, 19:35) — **Placement Failed** снова:
`ERROR:Cpld:892` (Cannot place **txm_cnt<1>**) + `ERROR:Cpld:868`;
103 MC размещено + 6 сирот (D<2..5,7>_BUFR, txm_cnt<1>) = **109 > 108**;
`WARNING:897` ×7 — D<7>, D<5..1>, seg<0> ушли в BUFR-буферы; FB-входы
203/216 (FB1/3/5 — по 36/36, FB6 34/36).

**Диагноз** (сравнение с POR6 по-сигнально): регистры-приёмники НЕ стали
уже (лекарство v3.3b2 вынесло в регистры только термы самого таймера),
зато остров (+13 MC) **съел запас фиттера** — и cpldfit перестал выносить
общие стробы в хелперы: в v3.2 их делали `$OpTx$FX_SC$164` (декод T2&!WRn)
и обратная связь выхода RESET_IN, в v3.3b2 каждый приёмник получил полный
инлайн-декод: bus_reg 7→13, col 4→13, seg 4→13, addr_latch 4→9,
txm 10→14, por_cnt 7→11 входов (сумма 166→203). FB1/3/5 переполнились —
фиттер **выселил регистры bus_reg<1..5,7> и seg_q<0> из пиновых МС** в
отдельные буфер-регистры (2 МС на бит вместо 1) → +7 MC → 109/108.
txm_cnt<1> (14 входов) не помещается ни в один FB (максимум свободного —
10 в FB4). Plan Б из v3.3b2 (Collapsing Input Limit 36→20) при ЭТОЙ
болезни не помогает: уравнения и так < 20, дефицит — суммарный.

**Лекарство v3.3b3** — факторинг v3.2 зафиксирован В ИСХОДНИКЕ
(`(* keep = "TRUE" *)`), больше не надеемся на щедрость фиттера:

1. **Хранимые стробы** (каждый = 1 МС, приёмники видят 1–2 входа вместо
   5–9): `cpu_rst` (RST\|por_run — 1 вход во всех синхро-сбросах вместо
   пары RST+por_run; аналог трюка v3.2 с обратной связью RESET_IN),
   `al_cap` = T1H&ALE (захват addr_latch), `bus_rd` = al_cap&!IOM (захват
   bus_reg с D-сети), `wr_cap` = T2&!WRn (захваты с A-сети: bus_reg,
   seg_q, dig_q, kbcol_q, snd_q, wr_seen, tmr_wr04), `por_ce` (аналог
   por_ce_D2 из v3.2).
2. **txm_cnt — свободный счёт вверх** (стоп в FF удалён) и он ЖЕ
   прескалер таймера: тик = `por_ce & txm_cnt==7Fh`; **tmr_hi (2 МС)
   удалён**; фаза та же (1-й тик через 128 por_ce после конца POR).
3. **POR возвращён к коду v3.2**: por_cnt только вниз, после POR стоит
   в 00; `por_run <= por_nz` (липкость v3.3b2 не нужна — счёта вверх
   больше нет). Уравнения por_cnt сузились (7→без ветки вверх).
4. **TX-маска — в регистр txm_mask_q** (set cpu_rst, clear при
   txm_cnt==FF): выход TX видит 3 входа вместо ~11 — NOR8 по 8 битам
   txm_cnt больше не тащится в FB3. Окно тот же (256 периодов X1 =
   51,2 мкс от снятия сброса, лаг регистра 1 такт).
5. **cnt[3:0] → cnt[2:0]**: mod-5 делитель помещается в 3 бита,
   cnt<3> был константным FF (−1 МС). Диапазон CLK_DIV: нечётные ≤ 7,
   чётные ≤ 16 (используется 5).

Буфер-регистры BUFR умирают: уравнения захвата снова 4–7 входов,
bus_reg<1..5,7> и seg_q<0> возвращаются в свои пиновые МС (−7 МС).
Семантика не изменилась: POR 12,8 мкс; TX-маска 51,2 мкс (±1 такт);
T = N × 51,2 мкс; tb не меняется.

## Смета ресурсов v3.3b3 (против POR6: свободно 17 MC / 315 PT / 50 FB-входов)

| Ресурс | v3.3b1 (провал) | v3.3b2 (провал) | **v3.3b3** | Вердикт |
|---|---|---|---|---|
| MC | 106 (98+8 сирот) | 109 (103+6 сирот) | **~106** = 91 (v3.2) + 11 остров + 4 keep + 1 txm_mask_q − 1 cnt | запас ~2 |
| PT | 332/540 | 275/540 | ~280–300 | ок |
| FB-входы | 202/216 | 203/216, FB1/3/5 по 36/36 | ~175–195: приёмники снова 4–7 входов (bus_reg 13→6, addr_latch 9→4, seg/col 13→8), BUFR исчезли | цель ≤ 200 |

**План Б'** (если снова не ляжет — по новому .rpt, в порядке дешевизны):
1) снять `keep` с `bus_rd` (−1 МС, приёмники bus_reg +1 вход);
2) снять `keep` с `por_ce` (−1 МС);
3) Collapsing Input Limit 36→20 в Fit Properties — помогает только от
распухания уравнений, НЕ от дефицита MC.

Старый **План Б** v3.3b2 (CIL 36→20, затем PT Limit 25) при болезни
«109/108 + BUFR» не работает — уравнения и так узкие.

**Факт (фит 22:04): MC 103/108 (запас 5), PT 257/540, FB-входы 188/216 —
всё внутри сметы; План Б' НЕ понадобился** (keep не снимали, CIL не
трогали). Подробности — в разделе «Фит v3.3b3 → УСПЕХ» ниже.

## Фит v3.3b3 → УСПЕХ (retro_pcld_top.rpt, 2026-10-22 22:04)

**Fitting Status: SUCCESSFUL, 0 ERROR, сирот 0** (в v3.3b2 было: ERROR 892,
6 сирот, 109 > 108). Ресурсы:

| Ресурс | v3.2 (POR6) | **v3.3b3 (факт)** | Смета v3.3b3 |
|---|---|---|---|
| MC | 91/108 (84%) | **103/108 (95%) — запас 5** | ~106 (запас ~2) |
| PT | 225/540 | 257/540 (48%) | ~280–300 |
| FB-входы | 166/216 | **188/216 (87%)** | ~175–195 |
| Регистры | 60/108 | 71/108 (66%) | — |
| Пины | 72/81 | 73/81 (+RST75 P75) | — |

Сверка чек-листа по .rpt:

- ✅ **bus_reg<1..5> и seg<0> — В СВОИХ пиновых МС** (уравнения захвата
  4–8 входов; в v3.3b2 их выталкивало в BUFR-буферы). **Единственное
  исключение — D<7> (bus_reg<7>)**: его уравнение захвата 4 PT / 7 входов
  не влезло в FB1 (входы 36/36 исчерпаны, пин P22 жёстко привязан к плате —
  перенос в другой FB невозможен) → фиттер вынес мультиплексор захвата в
  буфер-регистр **D<7>_BUFR (FB5_18, +1 МС)**, пиновая МС FB1_11 осталась
  выходным буфером. Это единственный WARNING 897 в отчёте. Функционально
  эквивалентно: пин выдаёт тот же зарегистрированный байт, доп. маршрут
  FB5→FB1 (~нс) несущественен при clk 25 МГц / шине 5 МГц.
- ✅ PGND = ровно {P74, P76, P78, P79, P81, P95, P96, P98} — 8 шт (P75
  вышла — выход RST75, FAST).
- ✅ Хелперы живы (по 1 МС): cpu_rst (FB2_5), al_cap (FB2_6), bus_rd
  (FB3_13), wr_cap (FB2_1), por_ce (FB6_5); **cnt<3> отсутствует**
  (cnt = 3 бита, mod-5).
- ✅ Таймер: tmr_cnt 8 бит — загрузка из bus_reg по tmr_load_q (IOM &
  wr_cap & addr 04h), декремент по tmr_tick_q & !RST75, стоп в 0;
  tmr_tick_q — регистр (декод por_ce & txm_cnt==7Fh); RST75 — регистр
  в МС выхода P75 (NOR8 нуля счётчика, без комбинационного глитча).
- ✅ txm_cnt — СВОБОДНЫЙ счёт вверх (стопа в FF нет; сброс в 0 по cpu_rst);
  txm_mask_q — регистр маски. Примечание: уравнения txm_mask_q / por_run /
  por_cnt_T в листинге записаны в ДОПОЛНЕННОЙ фазе — XST перевернул регистр
  (у txm_mask_q 2 PT вместо 3). Та же конвенция листинга, что в отчёте
  железно проверенной v3.2 (por_run_D/por_cnt_T там тоже в дополнениях) —
  семантика силикона соответствует HDL.
- ✅ Нет схлопнутых функций шире ~20 входов: максимум tmr_cnt<7> (13),
  state_FSM_FFd2 (11), txm_mask_q (11).
- ✅ clk = P29 → GCK3 (дублёр: дополнение clk → GCK2 для negedge-триггера
  x1_n делителя); GSR не используется; опции фита — как у стабильного
  (DENSITY, Keep User LOC, Ground Unused IOs, Keep Unused Inputs, FAST).

Свободный остаток: 5 МС (FB1_1, FB1_6, FB1_7, FB3_1, FB3_7 — все в FB1/FB3,
где FB-входы 36/36: для новой логики с НОВЫМИ сигналами места почти нет),
8 свободных ног, 283 PT.

## Софт-интерфейс

Порт **04h** (запись): N = период в тиках. `T = N × 51,2 мкс`
(N=1..255 → 51,2 мкс … 13,05 мс; N=0 = стоп).

```
TMR_N    EQU 195            ; 195 x 51,2 мкс = 9,984 мс; /2 в ISR = 19,968 мс ~ 50 Гц
TMRPORT  EQU 04h
...
      MVI  A, TMR_N
      OUT  TMRPORT          ; загрузить N и запустить (первый тик через ~10 мс)
      MVI  A, 00011000b     ; MSE=1, M7.5=0 (НЕ маскировать 7.5), 6.5/5.5 маскированы
      SIM
      EI                    ; вектор RST 7.5 = 003Ch
      ...
; ---- ISR (адрес 003Ch) ----
ISR:  PUSH PSW
      LDA  TICKS            ; программное деление на 2: действие каждые 2 тика
      XRI  01h
      STA  TICKS
      ANI  01h
      JNZ  ISR_DONE         ; нечётный тик — выйти
      ...                   ; чётный тик: работа 50 Гц (дисплей/часы)
ISR_DONE:
      MVI  A, TMR_N
      OUT  TMRPORT          ; РЕ-АРМ (обязательно! автоперезагрузки нет)
      POP PSW
      EI
      RET
```

Замечания:
- RESET IN ставит маску RST 7.5 — после сброса прерываний нет, пока
  программа не выполнит SIM (снять маску) и EI;
- защёлка RST 7.5 помнит фронт даже при маске: пропущенный на DI-участке
  тик «догонит» одним прерыванием после снятия маски;
- счётчик после сброса = FFh → без записи единственный фронт через ~13,1 мс
  и потом стоп (ре-арма нет) — программа обязана сделать `OUT 04h` в
  инициализации, если таймер нужен;
- ISR обязан ре-армиться (`OUT 04h`) и завершаться EI — классика 8085;
- изменение N на лету допустимо (следующий период уже с новым N).

## Тест-прошивка ПЗУ (rom/)

**Звук или мигание?** Рекомендация: **звук** — показательнее. Тон — это сотни
прерываний в секунду: любой сбой (залипание счётчика, потеря ре-арма, срыв ISR)
слышен мгновенно, а кратность кванта проверяется высотой тона (вдвое медленный
прескалер = тон на октаву ниже). Мигание сегмента — удобный фоновый визуальный
контроль, но 1 Гц скрывает пропуски отдельных тиков. Поэтому **основной образ
делает оба**: тон — главный индикатор, мигание — «секундный маяк» и заодно
проверка дисплея. Для тихих сессий есть отдельный blink-only образ.

### Состав rom/

| Файл | Что это |
|---|---|
| `timer_test.asm` | исходник (CP1251): векторы, ISR (тон + мигание + ре-арм), MAIN |
| `asm85.py` | мини-ассемблер 8085: двухпроходный, Intel HEX, `-D`, IF/ELSE/ENDIF, листинг, дизасм; 10-23: исправлен размер DB со строкой в проходе 1 (считался как 1 элемент, а не len(символов) — метки после такой DB уезжали) |
| `verify_hex.py` | независимая побайтовая сверка образов с ручным эталоном (карта опкодов Intel); v5: + эталон echo (всего 5 образов) |
| `timer_test_tone.hex` | **основной образ**: тон ~470 Гц + мигание 'g' ~1 Гц (160 байт, 0000h–009Fh) |
| `timer_test_blink.hex` | тихий образ (`-D TONE=0`): только мигание |
| `timer_test_n10.hex` | разделительный образ кванта (`-D TMR_N=10`), см. «Уточнение модели кванта» |
| `timer_test_uart.asm/.hex` | **UART-тест TX (ПАСС 10-24)**: вывод «TIMER-UART OK» CRLF, бит = N×Q от таймера (v4, 207 байт, 0000h–00CEh) |
| `uart_sw_test.asm/.hex` | референс для сравнения: тот же вывод на софт-делеях (114 байт, 0000h–0071h) |
| `uart_echo_test.asm/.hex` | **UART-тест приём-передача (эхо)**: баннер '>' + посимвольное эхо, приём через RIM/SID, бит = N×Q от таймера (229 байт, 0000h–00E4h) |
| `uart_echo_diag.asm/.hex` | **Диагностика приёма на дисплее** (эхо + индикатор): пара разрядов = счётчик пойманных старт-битов, вторая пара = последний принятый байт (hex); 352 байта, 0000h–015Fh |
| `uart_echo_diag2.asm/.hex` | **Диагностика v2: биты хвоста**: [счётчик mod 16][E = 3 бита линии после d7, 7 = хвост чист][байт]; решает кейс «счётчик тикает, эхо невидимо, редкая 'ю'» (368 байт, 0000h–016Fh) |
| `uart_echo_diag3.asm/.hex` | **Диагностика v3: полный таймлайн кадра**: 12 выборок (старт-верификация ~0,5 бита + d0..d7 + хвост ×3) → 12-битный TSB в ОЗУ; эхо ТРЕМЯ байтами [байт][tl-hi][tl-lo], дисплей [чистые старты][захваты СВОЕГО эха SSELF][байт]; у v3 найдены 3 бага ввода — исправлены в v4, образ остаётся эталоном сравнения (480 байт, 0000h–01DFh) |
| `uart_echo_diag4.asm/.hex` | **Диагностика v4: исправленный ввод** (RLC вместо RAR, защита накопителя L, порядок эха tl-hi/tl-lo); протокол, TX и дисплей — те же, что в diag3, но тройки соответствуют таблице (480 байт, 0000h–01DFh) |
| `uart_echo_diag5.asm/.hex` | **Диагностика v5: «кричащий баннер»** (дискриминатор «одиночный кадр vs тракт», 26-10): ISR/init/DMUX = diag4 байт-в-байт, баннер '>' повторяется ВЕЧНО с паузой ~70-140 мс, RX отключён (E=0), DIG0 = счётчик кадров (480 байт, sum 8905h, CRC32 A6DB528A) |
| `uart_echo_diag6.asm/.hex` | **Диагностика v6: «монитор SID»** (после ПАССА diag5: TX цел, остался уровень RX-линии): ISR/init/DMUX = diag5 байт-в-байт (один '>' при сбросе = маркер), хвост MAIN = плотный опрос RIM (~25-50 мкс): DIG0 = живой уровень SID ('1'/'0'), DIG1 = счётчик нулевых выборок (крутится, пока линия низкая; активность уводит из нуля навсегда), DIG2/3 = сырое RIM hex (норма 8Bh при SID=1 / 0Bh при SID=0; IE=0 → 83h) (480 байт, sum 8775h, CRC32 E9A641EB) |
| `check_diag5_hex.py` | сверка diag5 против diag4: зоны 0000h-0129h и 0170h-01DFh байт-в-байт, хвост MAIN 012Ah-0143h по эталону, паддинг нули |
| `check_diag6_hex.py` | сверка diag6 против diag5 И diag4 (двойная): зоны 0000h-0129h и 0170h-01DFh байт-в-байт, хвост-монитор SID 012Ah-0141h по эталону, паддинг нули |
| `check_diag2_hex.py` | побайтовая сверка diag2 против diag v1 (критичный путь = байт в байт) |
| `check_diag3_hex.py` | сверка diag3: вектор 003Ch = v1 байт в байт, вентиль на E, RXN1=4+SIM-выброс, обе ветви RIM, релиз/очередь |
| `check_diag4_hex.py` | сверка diag4: структура зон vs diag3, эталон хвоста, PUSH/POP H и порядок tl-hi/tl-lo |
| `check_diag_hex.py` | сверка diag v1 (352 байта) против uart_echo_test: векторы/ISR = v1 (кроме 2 адресов RXE 0099h→009Dh), вставки/DMUX/SEGTAB по контрольным точкам |
| `lst_hex_check.py` | побайтовая сверка каждого `*.lst` с парным `*.hex` (тело + паддинг, отчёт по образам) |
| `sim_diag3_timeline.py` | модель таймлайна diag3: 2400 → 'a' = 61 04 37 (1000/1000), линия-низ/самозахват → 00 00 00 |
| `sim_diag4_isr.py` | полная эмуляция 8085 ISR diag4 (instruction level): diag3 → 00 00 00, diag4 → корректные тройки, дисплей и очередь |
| `sim_rx_signature.py` | сигнатурная модель приёма: при ЧЕСТНЫХ 2400 мусор невозможен (1000/1000 свипов фазы) |
| `sim_uart_echo.py` | модель эхо-теста: 400 свипов фазы/латентности, запас выборки 130,4 мкс |
| `*.lst` | листинги сборки (CP1251) |

### Как это работает

- **Тон.** N = 20 → период 20 × 51,2 мкс = 1,024 мс; ISR инвертирует D4 (SND)
  → меандр. Частота НЕ ровно 488 Гц, а **~470 Гц**: к кванту добавляются
  накладные входа в ISR и ре-арма (~40 мкс, тело ISR до ре-арма ~91 такт ≈ 36 мкс +
  квитанция прерывания) — это норма. Если тон ~230 Гц (на октаву ниже) —
  квант 102,4 мкс вместо 51,2, дефект прескалера HDL.
- **Мигание.** Каскадный счётчик 116 × 4 = 464 прерывания ≈ 0,49 с на
  полупериод → цикл ~1 с. Инвертируется сегмент 'g' (средняя черта) на всех
  4 разрядах; dp горит постоянно — маячок «дисплей жив». Индикация статическая
  (все разряды сразу) — нагрузка заведомо меньше INIT «8.».
- **Регистр B:C — счётчик мигания, живёт между прерываниями.** Поэтому в ISR
  НЕТ PUSH B/POP B (урок v2, см. протокол дефекта ниже): POP B каждую квитанцию
  возвращал счётчику исходные 4:116, и он никогда не досчитывал до нуля.
  Сохраняется только PSW — ISR портит лишь A и флаги; вложенных прерываний
  нет (8085 запрещает IE на входе в ISR, EI только в конце).
- **MAIN:** LXI SP,FFFFh → порты (SEG=C0h, DIG=0Fh) → `OUT 04h` (запуск) →
  `SIM 1Bh` (маскировать 5.5/6.5, РАЗРЕШИТЬ 7.5; бит R7.5 = 0 — латч не трогаем,
  ложных фронтов до EI нет: после POR CPLD счётчик стоит в нуле и первого
  фронта RST 7.5 ещё не было) → EI → HLT-цикл:
  процессор спит между прерываниями, нагрузка ~5 %.
- **Векторы:** 0000h → JMP 0080h (MAIN); 003Ch → JMP 0040h (ISR). Свободные
  адреса заполнены 00h (NOP), а не FFh (FF = RST 7 — опасно при исполнении).
- **ISR обязан ре-армиться** (`OUT 04h`) — автоперезагрузки нет (стоп в нуле);
  копии регистров SEG/DIG держатся в ОЗУ 8000h/8001h (порт 01h перезаписывает
  весь байт).

### Ожидаемое поведение и диагностика

| Наблюдение | Вывод |
|---|---|
| ровный тон ~470 Гц + мигание ~1 Гц | **ПАСС**: квант, RST 7.5, ISR, ре-арм, SEG из ISR |
| раз в ~1 с лёгкий «тик» в тоне | норма: путь мигания в ISR длиннее на ~9 мкс |
| тишина, но мигает | таймер ОК; смотреть цепь SND/излучатель |
| тон ~230 Гц (октавой ниже) | квант 102,4 мкс — дефект прескалера HDL |
| тон рваный/дрожит | прерывания теряются (латч/маска/EI в ISR) |
| тон звучит «грязно»/с хрипотцой, но счётчик DSO показывает ровные ~493 Гц | норма: BUZZER1 — АКТИВНЫЙ излучатель, SND только включает его (см. осциллограмму v2 ниже); слухом высоту строба не оценивать — только частотомером |
| тон есть, горят g+dp, мигания НЕТ | прошивка v1 (счётчик мигания затирался POP B) — прошить v2; если v2 и так — смотреть запись SEG из ISR |
| горит «8.», ни звука, ни миганий | программа не стартует (ПЗУ/шина/CPLD) |

### Протокол дефекта v1 → v2 (PUSH B/POP B против счётчика мигания)

- **Симптом на железе (первая прошивка v1):** тон есть, таймер/RST 7.5/ре-арм
  работают, но мигания нет — на дисплее постоянно горят сегменты 'g' и dp
  (SEG = C0h, маячок MAIN не переключается).
- **Диагноз:** в ISR стояли `PUSH B` (вход) и `POP B` (выход). Счётчик мигания
  живёт в B:C и ОБЯЗАН переживать прерывания, но `POP B` каждую квитанцию
  восстанавливал со стека исходные KB:KA = 4:116: `DCR C` делал 116→115,
  а POP возвращал 116. Ноль не достигался никогда → ветка
  `LDA SEGST / XRI 40h / STA / OUT 00h` не выполнялась ни разу (мёртвый код).
  Тон при этом работал: ветка тона B:C не трогает.
- **Лекарство v2:** PUSH B/POP B убраны. B:C выделены ISR (инициализация один
  раз в MAIN — `LXI B,KB*256+KA`; вложенных прерываний нет — 8085 запрещает IE
  на входе в ISR, EI только в конце, B:C больше никто не трогает). Сохраняется
  один PSW. Побочный выигрыш: ISR короче на 22 такта (PUSH B 12 + POP B 10) —
  тон поднялся с ~465 до ~470 Гц, накладные снизились с ~55 до ~40 мкс.
- **Проверка:** программная эмуляция каскада — ровно 464 прерывания между
  инверсиями, период стабилен; оба образа побайтово совпали с обновлённым
  ручным эталоном (verify_hex.py: checksum + эталон + контрольные точки
  0041h=3Ah «нет C5», 0065h=F1h «нет C1»); размер прежний — 160 байт
  (0000h–009Fh), т.к. MAIN стоит на фиксированном ORG 0080h.
- **10-23, только комментарий:** уточнён текст комментария к `SIMW EQU 1Bh`:
  в 1Bh бит R7.5 = 1 — латч RST 7.5 СБРАСЫВАЕТСЯ (раньше комментарий
  утверждал «латч не трогаем»; на поведение и байты не влияло — образы
  пересобраны, hex не изменились, эталоны сошлись).

### Осциллограмма v2 (SND_magnify, 250 мкс/дел): форма сигнала и «нечистый» тон

- Замер владельца на прошивке **v2** (мигание работает — само по себе признак
  v2: в v1 ветка мигания была мёртвым кодом и физически не могла мигать).
  Счётчик DSO: **493,024 Гц**; независимо по сетке экрана: период
  203 px × 10 мкс/px = 2030 мкс → 492,6 Гц — счётчик подтверждён (сетка
  12 дел × 25 px, запись 3,0 мс; калибровка px/дел сошлась с частотомером
  до 0,1%).
- **Форма: меандр 50/50** (включённая половина 1020 мкс, выключенная
  1010 мкс) — SND инвертируется каждое прерывание, период прерываний
  ~1,01 мс. «Тик» мигания (+9 мкс раз в 464 прерывания) на экране 3 мс
  не виден — как и предсказано.
- **BUZZER1 — активный излучатель** (SCHEMATIC §6/§7.6, BUZZER-12X9): SND не
  «играет» тон, а включает/выключает питание модуля. На осциллограмме щуп
  стоит на R4 (100 Ом) = ток излучателя: включено — пьедестал ~300 мВ
  (~3 мА, средний потребляемый ток) + узкие пики до ~490 мВ (~4,9 мА) с
  шагом ~106 мкс (~9,4 кГц пиков; для квадратного возбуждения собственная
  частота излучателя ~4,7 кГц) — работает его ВНУТРЕННИЙ генератор;
  выключено — 0 мА (мелкие выбросы до −164 мВ — разряд ёмкостей после
  выключения).
- **«Нечистый» тон — свойство активного излучателя при жёстком гейтинге**,
  не дефект таймера/прошивки/CPLD: слышен собственный резкий тон модуля
  (~4–5 кГц), промодулированный стробом 493 Гц, а не чистая синусоида 493 Гц.
- **Следствие для методики:** высоту строба слухом не оценить — слух слышит
  излучатель, а не частоту прерываний. Частотный оракул — счётчик частоты
  DSO или период по сетке (оба согласуются выше — расхождение 0,1%).
- **Частота 493,024 Гц снова ВЫШЕ потолка 488,3 Гц** (модель «период = N
  тиков» даже при нулевых накладных) → модель «(N−1) тик + накладные»
  подтверждена и на v2 (на v1 было 494,01 Гц). Ожидание для v2 ~496 Гц
  (ISR короче v1 на 12 тактов до ре-арма), измерено 493,0 — расхождение
  ~0,7% в пределах точности счётчика DSO на пиковом сигнале (уровень
  срабатывания сидит в зоне пиков, точка пересечения гуляет). Разделительный
  тест кванта — `timer_test_n10.hex`: **~995 Гц ((N−1)) vs ~903 Гц (N)** —
  счётчик различит однозначно.

### Излучатель: 10-24 — BUZZER1 заменён на пассивный

Владелец подтвердил предыдущий вывод и пошёл дальше: BUZZER1 действительно
был **активным** излучателем (что и объясняло «нечистый» тон выше), и он
**заменил его на пассивный**. Результат: тон стал чище — теперь форму и
высоту звука определяет строб SND от программы (как и задумано в
MEMORY_MAP: «пассивный зуммер — тон генерирует программу»), а не внутренний
генератор модуля.

Осталась особенность: **выброс индуктивности в начале фронта** — глитч,
слышимый в начале тона. Причина: излучатель висит на ноге CPLD напрямую
(токоограничивающий R4 100 Ом стоит только на землю), при переключении SND
фронт бьёт в индуктивность/ёмкость излучателя без демпфирования — выброс
звенит и слышен как щелчок в начале каждого фронта тона. CPLD (24 мА
драйв) выброс переживает, но на звук он выходит.

Кандидаты-лекарства (по возрастанию вмешательства в плату):

1. Последовательный резистор в цепь SND (100–470 Ом между CPLD и
   излучателем): гасит выброс и звон, снижает громкость; самый дешёвый
   эксперимент.
2. Снаббер RC параллельно излучателю (для магнитного типа).
3. Встречно-параллельный диод (клемп выброса при индуктивной нагрузке).

Пока опыт ставится на одной плате — пометка в SCHEMATIC §7.6 оставлена с
примечанием о замене. Для тестов таймера/UART это ни на что не влияет
(SND в них не используется).

### Прошивка и возврат монитора

- Образ шьётся **вместо монитора fw_mon**: offset 0000h flash A29040B
  (видна нижняя половина младшего банка, окно 0000h–7FFFh — MEMORY_MAP §3).
- После теста прошить монитор fw_mon v5 обратно (offset 0).

### Пересборка

```
cd beta/01_timer/rom
python3 asm85.py timer_test.asm -o timer_test_tone.hex  -l timer_test_tone.lst
python3 asm85.py timer_test.asm -o timer_test_blink.hex -l timer_test_blink.lst -D TONE=0
python3 asm85.py timer_test.asm -o timer_test_n10.hex   -l timer_test_n10.lst  -D TMR_N=10
python3 asm85.py timer_test_uart.asm -o timer_test_uart.hex -l timer_test_uart.lst
python3 asm85.py uart_sw_test.asm    -o uart_sw_test.hex    -l uart_sw_test.lst
python3 asm85.py uart_echo_test.asm  -o uart_echo_test.hex  -l uart_echo_test.lst
python3 asm85.py uart_echo_diag.asm  -o uart_echo_diag.hex  -l uart_echo_diag.lst
python3 verify_hex.py
python3 check_diag_hex.py   # побайтовая сверка diag с v1 + контрольные точки
```

Параметры — в шапке `timer_test.asm`: `TMR_N` (период), `KA`/`KB` (мигание),
`TONE`/`BLINK`. Таблица тонов (с накладными ~40 мкс):

| TMR_N | период прерываний | тон |
|---|---|---|
| 5 | ~0,30 мс | ~1,7 кГц |
| 10 | ~0,55 мс | ~900 Гц |
| 20 | ~1,06 мс | **~470 Гц (по умолчанию)** |
| 40 | ~2,09 мс | ~240 Гц |
| 195 | ~10,0 мс | ~50 Гц — не тон (рабочий режим: 100 Гц прерываний, /2 в ISR = 50 Гц) |

## Уточнение модели кванта: период = РОВНО N тиков, Q ≈ 50,7 мкс (10-23)

Анализ HDL v3.3b3 (`top_suart.v`) закрыл вопрос «(N−1) против N»:

- декремент `tmr_cnt` идёт **только** по тикам (`tmr_tick_q & !RST75_r`);
- загрузка N (`tmr_load_q`) имеет **приоритет** над декрементом;
- при ре-арме **раньше следующего тика** (Δ < Q — у v2 Δ ≈ 40 мкс < 51,2)
  тик не теряется: первый декремент после загрузки — на ближайшей сетке
  тиков, ноль достигается через ровно N тиков после фронта.

Следствие: **период фронтов RST 7.5 = N × Q точно; накладные ISR в период
НЕ входят** (сетка тиков свободно-бежащая). Модель «(N−1) тик + накладные»
(записана по замерам 10-22/10-23) была альтернативной подгонкой той же
кривой в предположении Q = 51,2 мкс — Verilog её исключает.

Тогда замер 493,024 Гц при N=20 означает:
**Q = 1014,2 мкс / 20 = 50,71 мкс → clk = 1280/Q ≈ 25,24 МГц** — «сверчок»
LTC6905 идёт на ~+1% от номинальных 25,000 МГц (в пределах допуска
семейства; прежний замер «25,00 МГц» был округлён). Замер v1 (494,01 Гц)
даёт Q = 50,61 мкс (clk ≈ 25,29 МГц) — обе читки согласуются с учётом
заявленной погрешности счётчика DSO на пиковом сигнале (±0,7%).

Разделительный тест `timer_test_n10.hex` (N=10): предсказание **~986 Гц**
(модели «N тиков, Q ≈ 50,7» и «(N−1)+накладные» дают 986–998 Гц — счётчиком
DSO почти неразличимы; наивная «N×51,2+накладные» давала бы ~903 Гц —
исключается). Однозначный арбитр — частотомер на **CLKOUT** (U3.37):
ожидаются ~2,52 МГц против номинальных 2,50.

Следствия для расчётов: рабочий тон N=20 — фактические **~493 Гц** (таблица
выше писала ~470 по модели с накладными); 50 Гц при делении на 2 в ISR —
**N=197** (197 × 50,71 мкс = 9,99 мс → 50,05 Гц), а не 195/196.

## Тест-прошивка UART: таймер как задатчик бодрейта (10-23)

Задание владельца: практическое применение таймера — формировать битовые
интервалы UART прерываниями, а не калиброванными циклами, и оценить,
насколько это упрощает/удорожает код против полностью софтверного варианта.

**Тракт передачи** (PORTS_MAP §8, Task 70-a): CPU.SOD (запись через SIM) →
CPLD P72 → P39 (прозрачный транзит; TX-маска держит '1' 51,2 мкс после
сброса — BREAK невозможен, но прошивка и сама ставит SOD=1 первым делом) →
CH340G.RXD (U6.2) → USB → виртуальный COM-порт ПК. Приём (на будущее):
CH340G.TXD → CPLD RX → SID (RIM 20h).

### Как работает timer_test_uart (v4: 207 байт, 0000h–00CEh)

- **Одно прерывание RST 7.5 = один бит.** Период прерываний = ровно N×Q
  (см. «Уточнение модели кванта»; ре-арм — первое действие ISR, код стоит
  прямо в векторе 003Ch: `MVI A,N / OUT 04h`, ~13 мкс от фронта — тик не
  теряется, а выход SOD лишь сдвинут на постоянную добавку: старт/стоп
  ~+23 мкс, данные ~+35 мкс от фронта тика).
- **Фазы кадра в регистре C**: 0Bh = кадр загружен → 0Ah = старт-бит
  (**+ загрузка байта в D из (HL)**) → 09h..02h = данные d0..d7 (LSB-first,
  единицы втягиваются сверху) → 01h = стоп-бит **+ проверка конца строки**
  → **0Ch = холостой бит (2-й стоп; v4)** → 0Bh = старт следующего.
  Символ = 11 фронтов (10 кадра 8N1 + 1 холостой), фаза 00h не возникает —
  стоп-фаза перезаряжает счётчик сама. Вне кадра D=0FFh — фиксированная
  точка пути данных: холостой бит прокатывается через него, ничего не меняя
  (SOD=1), поэтому отдельной ветки для него в ISR нет.
- **Регистры ISR**: C фаза, D сдвиговый, E счётчик паузы, HL указатель
  сообщения; MAIN живёт в HLT и их не трогает — сохранять нечего (урок v2
  в обратную сторону: выделяй ISR регистры, а не воюй с PUSH/POP).
- **MAIN**: SOD=1 (гасим возможный BREAK) → дисплей «....» (dp на всех
  разрядах, маячок «стартовала» — отличим от v2-тона 'g'+dp) → пуск
  таймера → SIM 1Bh → EI → HLT. Нагрузка CPU ~10% (ISR ~50 мкс из ~406).
- Вывод: `TIMER-UART OK` + CR LF, пауза ~14 бит, повтор (~14 строк/с,
  177 фронтов ≈ 72 мс).

### Скорости (бит = N×Q)

| -D TMR_N | бит (Q=50,6..51,2 мкс) | фактический бод | цель |
|---|---|---|---|
| 2 | 101,3–102,4 мкс | 9770–9870 | 9600 |
| 4 | 202,6–204,8 мкс | 4883–4936 | 4800 |
| **8 (по умолчанию)** | 405,2–409,6 мкс | 2441–2468 | 2400 |
| 16 | 810,4–819,2 мкс | 1221–1234 | 1200 |

Ошибка +1,7..+2,8% (доля «сверчка» + квантование) неустранима квантом —
и именно она выстрелила в первом прогоне (см. ниже). Выборка середины
бита тут не при чём: дрейф за 9,5 бит ≤ 26% бита при лимите ~50%; опасна
была коллизия ГРАНИЦЫ кадра, закрытая холостым битом (2 стоп-битами).
Если мусор остался и с v4 — источник не в скорости: прошить
`-D TMR_N=16` (терминал 1200) и смотреть одиночником на P39.

### Прогон на железе 10-23: мусор сериями → фикс (2-й стоп-бит)

Первый образ (кадры ВПЛОТНУЮ, 10 фронтов/символ) на терминале 2400 давал
~25% строк с мусором СЕРИЯМИ по 6–8 символов в середине строки, мусор
повторялся байт в байт (`TIMQЄ©IQЃOK`, `TIMER-UA*z-5`, потерянные CRLF —
строки склеивались). Это подпись **сдвига на 1 бит в непрерывном потоке**:
приёмник, потеряв бит, «пережёвывает» хвост строки до паузы, где
ресинхронизируется — поэтому следующий столбец/строка снова чистые.

**Механизм:** TX = 2465 бод (+2,7%). При кадрах вплотную следующий
старт-фронт приходит через 10 бит TX = **9,74 бита приёмника 2400 — на
26% бита РАНЬШЕ конца его кадра**: приёмник обязан ловить старт, ещё
«вися» в кадре, и в плохой фазе (набег 0,27 бита/кадр) периодически
промахивается → сдвиг на 1 бит → серия мусора. Детерминизм дампа —
биение фазы приёма против фиксированной строки.

**Фикс v4:** один холостой бит между кадрами = классические 2 стоп-бита:
следующий старт = 11 бит TX = **10,71 бита приёмника — ПОСЛЕ конца его
кадра** (+0,71 бита): коллизия исчезает, ошибка скорости гасится запасом
стоп-времени. Бонус: одиночный сбой отныне портит ≤ 1 символ (ресинхрон
на каждом реальном старте), а не хвост строки. Стоимость: −2 байта образа
(209→207: preload'ы D убраны — загрузка переехала в старт-фазу) и −10%
пропускной способности. Софт-референс НЕ правился: у него +0,8%, след.
старт приходит на 8 мкс позже конца кадра приёмника — коллизии нет.

### Прогон v4 на железе 10-24: ПАСС

Владелец: «тест работает замечательно, текст ровный» — поток «TIMER-UART OK»
без мусора на терминале 2400 8N1. Диагноз коллизии границы кадра и фикс
(2-й стоп-бит) подтверждены; расчёт запаса (+0,71 бита между кадрами)
соответствует железу. Тракт TX (SIM/SOD → P72 → P39 → CH340G → COM) и
таймер как задатчик бодрейта считаются проверенными. Следующий шаг —
**приём** (CH340G.TXD → RX → SID, RIM 20h): тест приёма-передачи (эхо).

### Сравнение с полностью софтверным формированием

Референс `uart_sw_test.hex` (114 байт): тот же текст на экране, но бит
выдерживается счётом тактов — 1042 такта на бит (26 выдать + 24 сдвиг +
978 пауза `LXI H,40`+2×NOP+цикл DCX H + 14 DCR/JNZ) = 416,8 мкс → 2399,2
бода (0,03% при 2,5 МГц; при фактических ~2,52 МГц → 2419 бод, +0,8%).

| Показатель | Таймер (timer_test_uart) | Софт-делеи (uart_sw_test) |
|---|---|---|
| Образ | 207 байт (в т.ч. 57 NOP-заполнение векторов, 16 сообщение) | 114 байт |
| Код+данные без заполнения | ~150 байт | ~111 байт |
| Калибровка | **НЕТ** — 1 бит = 1 прерывание, единственная константа N | ручной баланс 1042 такта/бит; ломается от любой вставки инструкции в цикл бита и от смены тактовой |
| CPU во время передачи | ~10% (ISR ~50 мкс на бит), MAIN в HLT свободен | 100% всю строку (~68 мс), DI на всю передачу |
| Смена скорости | один байт N (2/4/8/16) | пересчёт констант задержки |
| Параллельная работа (дисплей, счёт времени, приём) | да — прерывания и есть задатчик | нет — прерывания запрещены, CPU в циклах |
| Потолок скорости | ~9600 (N=2); выше — только BAUD-делитель в CPLD | любой (ограничен кварцем) |

**Вывод (честный):** байтами таймерный вариант НЕ меньше — автомат в ISR
стоит ~+40 байт кода против цикла с задержкой. Выигрыш в другом: исчезает
хрупкая тактовая калибровка (самая обслуживаемая часть софт-UART), CPU
освобождается на ~90%, а задержка становится декларацией «1 бит = 1
прерывание». Для теста — однострочный блокирующий вывод, софт-вариант
даже экономнее; для всего остального (монитор, приём, фоновой дисплей) —
только таймер.

### Прошивка, терминал, диагностика

- Прошить `timer_test_uart.hex` вместо fw_mon (offset 0000h flash
  A29040B), после теста вернуть монитор.
- Терминал: **2400 8N1**, без управления потоком; ожидание — строка
  `TIMER-UART OK` каждые ~72 мс.

| Наблюдение | Вывод |
|---|---|
| строка повторяется в терминале | **ПАСС**: таймер, RST 7.5, ре-арм, автомат, SOD, CH340G, COM |
| дисплей «....», мусор сериями | коллизия границы кадра (лечение — v4, 2 стоп-бита); если остался и с v4 — не скорость: `-D TMR_N=16`, терминал 1200, осциллограф P39 |
| дисплей «....», терминал молчит | тракт TX: осциллограф на SOD (U3.4) и TX (P39); проверить COM/драйвер CH340G |
| дисплей «8.» или пуст | программа не стартует (ПЗУ/шина/CPLD) |
| строки рвутся/склеиваются | потеря прерываний (латч/маска/EI) — в v3.3b3 не ожидается |

Прошивать `uart_sw_test.hex` не обязательно — это эталон для таблицы
сравнения (если прошить: тот же терминал 2400 8N1, та же строка).

## Тест UART приём-передача: эхо (10-24)

После ПАССА TX-теста (v4) — первый тест тракта **приёма**. Задание
владельца: полноценный UART. Формат — ЭХО: символ, набранный в терминале,
возвращается на экран. И приём, и передача тактируются таймером
(1 прерывание = 1 бит). **CPLD НЕ МЕНЯЛСЯ** — тот же фит v3.3b3: транзиты
RX→SID и SOD→TX уже есть, шьётся только ПЗУ.

Тракты: передача — как в TX-тесте (SIM → SOD → P72 → P39 → CH340G → COM);
приём — CH340G.TXD → CPLD RX (P38) → транзит → CPU.SID (P73), чтение
**RIM 20h** (бит 7 аккумулятора).

### Как работает uart_echo_test (229 байт, 0000h–00E4h)

- **MAIN опрашивает SID в цикле с DI** (`RIM / ANI 80h / JNZ POLL`,
  ~10 мкс на итерацию — латентность обнаружения старта ≤ 10 мкс).
  DI в опросе — принципиально: ISR «не залетают под руку», а любой
  фронт сетки, сработавший под DI, ловится латчем RST 7.5 и выбрасывается
  при арме (см. ниже). Пока MAIN в опросе — TX-движок стоит (кадры к
  этому моменту уже закончились).
- **Атомарный арм приёма** (старт-бит пойман):
  1. `MVI A,RXN1 / OUT 04h` — загрузка **12 квантов (= 1,5 бита)** в
     таймер; загрузка даёт фронт через (N−1)..N квантов (фаза
     прескалера) → первая выборка в середине d0 (окно ±208 мкс, запас
     ≥ 130 мкс по модели);
  2. `MVI A,08h / SIM` — сброс латча RST 7.5 **ПОСЛЕ загрузки**:
     залетевший фронт мог сработать только до этой точки (после загрузки
     новый фронт ≥ 11 квантов) — выбрасывается атомарно, **гонка
     исключена**;
  3. `L=0, H=11, EI` — кадр приёма = **11 интервалов**: 12Q (выборка d0)
     + 8×8Q (d1..d7) + 3×8Q (хвост).
- **RX-автомат в ISR** (регистры H/L): ре-арм в векторе 003Ch держит
  сетку 8 квантов = 1 бит; при H≥4 — выборка (`RIM / ANI 80h / RAR /
  MOV A,L / RAR / MOV L,A` — биты LSB-first втягиваются в L сверху),
  H=3..1 — хвост без выборки, H→0 — **релиз**: если TX свободен
  (C=0FFh) — `MOV D,L / MVI C,0Bh` (эхо стартует следующим фронтом),
  иначе байт отбрасывается (v1 без очереди TX).
- **TX-автомат** — тот же, что в v4 (фазы в C, сдвиговый D, путь данных
  RRC/ANI/ORI/SIM), но **однобайтовый**: стоп-фаза сразу уводит в покой
  (C=0FFh) — 2-й стоп-бит не нужен, кадры далеко друг от друга.
- **Приоритет RX над TX**: вентиль в начале ISR — при H>0 TX-автомат не
  двигается (SOD держит уровень, «заморозка кадра»). При печати за руку
  недостижимо (эхо кончается через ~5 мс после символа); при вставке
  даёт артефакты (ниже).
- **Дрейф выборки**: сетка 8 квантов = 405,7..409,6 мкс против бита
  терминала 416,67 — выборка уезжает на ~7–11 мкс РАНЬШЕ на бит; к d7
  ~72 мкс раньше центра — лимит ±208 мкс, запас > 130 мкс (модель).
- **Хвост 3 интервала (~3 бита) — урок v4 зеркально**: эхо-старт выходит
  на линию только после конца кадра приёмника ПКА (10 бит от ЕГО старта)
  с запасом ~+2,15 бита (модель); без хвоста эхо-старт попадал в
  стоп-бит кадра ПКА — та же коллизия границы кадра, что дала мусор
  сериями в TX-тесте, только в обратную сторону.
- **Баннер**: один символ '>' сразу после сброса (тот же TX-автомат) —
  виден в терминале ~5 мс после RESET, признак «прошивка жива».
  Дисплей: **«8.» на всех 4 разрядах** — маячок (отличим от «....»
  TX-теста v4 и от «g.» тона v2).
- Регистры ISR: C фаза TX, D сдвиговый TX, H интервалы RX, L накопитель
  RX; B, E свободны. MAIN не держит в регистрах ничего долгоживущего.

### Модель (sim_uart_echo.py)

Событийная модель всего тракта: ПКА шлёт на ровно 2400 бод → приёмник
ПКА декодирует эхо с ресинхом по старт-фронту. Таймер моделирован по
HDL v3.3b3 (сетка тиков свободно-бежащая, загрузка даёт фронт через
(N−1)..N квантов, ре-арм из ISR — цепочка точная). Результат:
эхо = баннер + 'AZ5 az19!' на **400 свипах** фазы прескалера и
латентности опроса; минимальный запас выборки середины бита **130,4 мкс**
(лимит 208,3); минимальный запас эхо-старта **+2,15 бита** после конца
кадра ПКА; гонка латча не воспроизводится ни в одной точке свипа.
Стресс «paste» (3 мс между символами): потери ожидаемы (v1 без очереди,
MAIN не опрашивает линию во время чужого кадра) — задокументировано, не
дефект.

### Ограничения v1 (задокументированы, не дефекты)

- **Вставка (paste) блока текста** — потери/мусор: нет очереди TX и
  опрос линии останавливается на время чужого кадра. Печатать по одному
  символу — эхо чистое. Очередь/фоновый буфер — кандидат в v2.
- Символ, набранный во время баннера (первые ~5 мс после сброса),
  теряется.
- Байт отбрасывается, если в момент конца приёма TX ещё занят.
- Скорости: гарантирован дефолт N=8 (2400) и N=16 (1200); 4800/9600 —
  на пределе (аддеры ISR ~30–40 мкс = 15–40% бита): возможны
  эксперименты `-D TMR_N=4/2`, но без гарантий.

### Прошивка, терминал, диагностика

- Прошить `uart_echo_test.hex` вместо fw_mon (offset 0000h), после теста
  вернуть монитор. Терминал: **2400 8N1**, без управления потоком.
- Ожидание: '>' в терминале после RESET; каждый набранный символ
  возвращается (~5 мс).

| Наблюдение | Вывод |
|---|---|
| '>' есть, набранные символы возвращаются | **ПАСС**: тракт RX (CH340G.TXD → RX → SID → RIM), RX-автомат, релиз, эхо через TX |
| '>' есть, эхо нет/мусор на ввод | выборка: RIM в ISR; осциллограф на SID (U3.5) и RX (P38); сверить битность/стопы терминала; **прошить uart_echo_diag.hex** — дисплей покажет, доходят ли старт-биты и что принимается (раздел ниже) |
| '>' нет, дисплей «8.8.8.8.» | тракт TX — как в TX-тесте (SOD U3.4 / P39; сам тест v4 ПАСС, значит искать внешнее: кабель, COM) |
| дисплей пуст или не «8.» | программа не стартует (ПЗУ/шина/CPLD) |
| paste блока — мусор/потери | норма v1 (нет очереди TX); печатать по одному символу |

### Диагностический вариант эха: uart_echo_diag (10-24)

**Ситуация:** на железе баннер '>' пришёл, но эха нет — вводимые символы
не возвращаются. TX-тракт тем самым доказан, а приём PC→плата
(CH340G.TXD → P38 → транзит → SID → RIM) упражняется **впервые**.
Сверка «на бумаге» сомнений не дала: в фите v3.3b3 транзит есть
(`SID <= RX`, RX = вход P38, SID = выход P73), медь платы сходится
с нетлистом (цепь «TX»: U6.2 → U1.38; цепь CPU17: U3.5 ↔ U1.73).
Поэтому сделан диагностический образ: логика эха НЕ тронута, на дисплей
выведен индикатор приёма — видно, ДОХОДИТ ли ввод и ГДЕ рвётся.

**Дисплей (после RESET «0.0.0.0.» — маячок старта):**

- одна пара разрядов — **счётчик пойманных старт-битов** (hex, mod 256):
  растёт на 1 при каждом нажатии клавиши;
- вторая пара — **последний принятый байт** (hex).

Мультиплексия — в MAIN, шаг на каждый цикл опроса (4 фазы, ~610 Гц на
разряд — без мерцания). DMUX портит только A/флаги (HL сохраняется
PUSH/POP; B/C/D/E не трогаются; ISR в покое тоже трогает лишь A) —
взаимных порчей с ISR нет. Цена: ~55 мкс к латентности ловли старта
(окно выборки d0 ±208 мкс; симуляция с периодом опроса 185 тактов
вместо 25 — ПАСС, запасы прежние: выборка 130,4 мкс, эхо-старт +2,16 бита).

**Чтение результатов (вводить по одному символу):**

| Дисплей / поведение | Вывод |
|---|---|
| '>' есть, счётчик НЕ тикает, байт 00 | приём мёртв ДО автоматики: (а) **flow control в терминале** (RTS/CTS или XON/XOFF) — выключить: модемные линии CH340G (U6.9–15) на плате не разведены, CTS терминал не дождётся и молча придержит ввод — баннер при этом приходит как ни в чём не бывало; (б) обрыв CH340G.TXD (U6.2) → P38; (в) контакт ножки 5 (SID) в ZIF U3 / дефект 1821ВМ85 по SID. Осциллограф: кадры при вводе на P38 и U3.5 |
| счётчик ТИКАЕТ, байт неверный (FFh/мусор) | старт ловится, биты читаются мимо сетки: сверить 2400 8N1 терминала; форма P38 осциллографом |
| счётчик ТИКАЕТ, байт ВЕРНЫЙ, эха НЕТ | приём исправен ЦЕЛИКОМ (до RIM и сетка выборки); вопрос к релизу эха (маловероятно — логика релиза не менялась) |
| счётчик МЧИТСЯ сам, байт 00, без ввода | линия RX прижата к 0 (КЗ/мёртвый CH340G): MAIN ловит «старты» непрерывно |

Отличия от v1 по листингу: +4 байта в релизе ISR (`MOV A,L / STA 8001h` —
копия байта на дисплей, пишется даже при уроне эха), `CALL DMUX` перед
`DI` и `INR B` после `SIM` в MAIN, блок DMUX/HSEG с 00F0h, таблица
SEGTAB с 0150h (lo = 50h — `ADD L` без переноса). Верификация:
check_diag_hex.py — векторы и ISR 0000h–008Fh совпали с v1 байт в байт
(кроме 2 адресов переходов на RXE: 0099h → 009Dh), все вставки и
DMUX/SEGTAB — по контрольным точкам.

### diag v2 — биты хвоста: вердикт по кейсу «счётчик тикает, эха нет, редкая 'ю'» (10-24)

**Отчёт владельца по diag v1:** счётчик старт-битов ТИКАЕТ на каждое
нажатие; эхо в терминале почти всегда НЕВИДИМО; изредка (единичные
случаи) выходит буква **'ю'** (CP1251, байт 0FEh). Софт-UART монитора
на той же меди работал полностью.

**Что из этого уже следует (без новой прошивки):**

- счётчик тикает ⇒ старт-биты доходят до MAIN (RIM/SID живы), flow
  control терминала ИСКЛЮЧЁН — при придержанном вводе счётчик молчал бы;
- 'ю' дошла до терминала ⇒ конвейер релиза и эха (релиз RX → TX-автомат
  → SOD → CH340G → COM) РАБОТАЕТ ЦЕЛИКОМ: терминал показал именно то,
  что плата приняла. Вопрос только в ЗНАЧЕНИИ принятого байта: почти
  всегда он «невидимый» (00h–1Fh), изредка 0FEh;
- сигнатурная модель (sim_rx_signature.py): при ЧЕСТНЫХ
  2400 8N1 приём даёт байт = коду клавиши на ЛЮБОЙ фазе прескалера и
  латентности опроса (1000/1000 прогонов, запас ≥ 130 мкс) — мусор
  невозможен. Следовательно, ИСТОЧНИК шлёт НЕ на 2400.

**Сигнатуры** (наш RX 2400 ← терминал X бод; свип фазы/латентности):

| Терминал шлёт | 'a' (61h) | 'b' (62h) | 'o' (6Fh) / '?' (3Fh) | Enter (0Dh) | E, хвост |
|---|---|---|---|---|---|
| **2400 (норма)** | 61 | 62 | 6F / 3F | 0D | 7 |
| **~1200 (вдвое медленнее)** | **06 (невид.)** | **18 (невид.)** | **0FEh = 'ю'** | E6 = 'ж' | 0–4 |
| ~4800 (профиль fw_mon **v5**!) | F4/FC | F4/FC | F5–FD | F1–F9 | 7 |
| ~9600 | FF/FE | FF/FE | FF/FE | FE | 7 |

Картина владельца («байт почти всегда невидимый + изредка 'ю'»)
совпадает ТОЛЬКО со строкой **~1200**. Напоминание: монитор fw_mon
v5 работает на **4800 8N1** (MEMORY_MAP, §ПЗУ), старый fw_mon v1 — на
2400; профиль терминала, «привычный» по монитору, для эхо-теста не
годится — нужен тот же профиль, при котором TX-тест дал «ровный текст»
(**2400 8N1**).

**diag v2** делает вердикт видимым одним нажатием: интервалы хвоста
(H=3..1), как и данные, читают линию — ISR пишет SID в E (MSB-first:
E = t1<<2 + t2<<1 + t3); при чистой сетке хвост ложится на стоп/idle,
то есть **E = 7**; E < 7 — сетка уползла (биты хвоста поймали данные).
Дисплей: **[счётчик mod 16][E][байт]**, после RESET «0.0.0.0.».

Критичный путь приёма НЕ тронут: вектор ре-арма 003Ch–003Fh и выборки
d0..d7 (0083h–0089h) = v1 байт в байт (check_diag2_hex.py; отличия —
операнды JMP MAIN/JZ RXE/JM и блоки вставок: JMP RXDCR 008Ah, RXTAIL
008Dh–0093h; MAIN с 00B0h, DMUX с 0100h, SEGTAB с 0160h).

**Чтение diag v2** (вводить по одному символу, начать с 'a' ×3):

| Дисплей на 'a' | Вывод |
|---|---|
| x1 / 07 / 61 | приём на 2400 исправен целиком — эхо обязано быть видимым; сообщить, что в терминале |
| x1 / 00–04 / 06 | терминал шлёт ~1200 — **выставить 2400 8N1** |
| x1 / 07 / F4–FC | терминал шлёт ~4800 (профиль монитора v5) — **выставить 2400 8N1** |
| x1 / 07 / FE–FF | терминал шлёт ~9600 — **выставить 2400 8N1** |
| x1 / E<7 / 61 | сетка уползает к концу кадра — сообщить код E |

После выставления 2400 8N1 ожидание: **x1 / 07 / 61** и 'a' в терминале
(~5 мс). Затем Enter → 0D/07 и Enter в терминале.

### diag v3 — полный таймлайн кадра в hex-терминале (10-24)

**Отчёт владельца (diag v1, hex-терминал 2400 8N1 подтверждён):** на
ввод строки из ~46 символов плата вернула **21 байт, и все — 00h**;
счётчик старт-битов тикает на каждое нажатие. При ЧЕСТНЫХ 2400 декод
00h невозможен (sim_rx_signature: 1000/1000 прогонов) ⇒ нужен срез
линии глазами платы.

**diag v3** делает это без осциллографа: кадр приёма = **12 выборок** —
старт-верификация (~0,5 бита; RXN1 = N/2 = 4 кванта), d0..d7 (1,5..8,5
бита — сетка НЕ изменилась), хвост ×3 — каждая пишется в 12-битный
таймлайн TSB (ОЗУ 8002h–03h, MSB-first). На каждый кадр плата шлёт в
терминал **ТРИ байта: [принятый байт][таймлайн hi][таймлайн lo]**, где
`tl-hi = 0000 s d0 d1 d2`, `tl-lo = d3 d4 d5 d6 d7 t1 t2 t3`. Эхо — через
очередь 2 байта с ХОЛОСТЫМ битом между кадрами (урок v4; QCNT 8007h).
Дисплей: **[чистые старты mod 16][захваты СВОЕГО эха mod 16][байт]** —
второй счётчик (SSELF, ОЗУ 8006h) растёт, если MAIN поймал «старт»,
пока TX ещё передаёт (признак самозахвата/петли по железу).

**Ожидание на 2400 (симуляция sim_diag3_timeline.py, 1000/1000):**

| Клавиша | Эхо [байт][hi][lo] | Комментарий |
|---|---|---|
| 'a' | **61 04 37** | s=0, данные 0110 0001, хвост 111 |
| 'o' | 6F 07 B7 | |
| '3' | 33 06 67 | |
| Enter | 0D 05 87 | |
| Space | 20 00 27 | |

**Вердикты по факту:**

| Эхо | Вывод |
|---|---|
| `61 04 37` | приём исправен целиком — эхо обязано быть видимым; смотреть, что в обычном терминале |
| **`00 00 00`** | линия НИЗКАЯ во всех 12 точках (~4,7 мс непрерывного нуля): кадр «съеден» — терминал печатает 00 на BREAK/нуле. Если при этом **SSELF (DIG1) > 0** — плата ловит СВОЮ передачу (петля/самозапуск по железу: P38↔P39/SID); SSELF = 0 — линию прижимает извне (CH340G/путь до SID) — осциллограф на P38 и U3.5 |
| s=1 (tl-hi ≥ 08h) | пойманный «старт» вернулся в 1 — глитч или чужой кадр |
| tl-lo & 07 ≠ 07 | сетка уползла к концу кадра |
| сдвиг узора при s=0 | скорость/формат источника ≠ 2400 8N1 (сигнатуры: ~1200 → 'a' = `06 03 00`; ~4800 → `FC 09 FF`) |

Верификация: check_diag3_hex.py — вектор 003Ch = v1 байт в байт;
вентиль на E; RXN1=4 + атомарный SIM-выброс; две ветви выборки
(данные в L **и** таймлайн в TSB); релиз/очередь/холостой бит; SSELF;
SEGTAB 01D0h. 480 байт, 0000h–01DFh. MAIN с 0100h, DMUX с 0170h.

**Самоидентификация образа (по отчёту 10-24 «1234 → эхо один байт 00,
дисплей 0050»):** diag3 на КАЖДЫЙ принятый кадр отвечает ТРЕМЯ байтами —
эхо одним байтом означает, что в ПЗУ диагностический образ НЕ взялся
(не прошивался, прервался или не тот файл). Это же объясняет и прошлый
отчёт «46 символов → 21 байт»: расчёт числа захватов для однобайтового
эха даёт ровно ~21, для diag3 было бы ~14 — то есть diag3 не запускался
ни разу, и все наблюдения шли со старого образа. Чтение «0050» для
старых образов: **diag v1** = [байт 00][счётчик 50h = 80 — накоплен со
всех тестов с последнего RESET, счётчик обнуляется только им];
**diag2** = [байт 00][E=5][счётчик mod 16 = 0], где E=5 — на 10,5 бита
после старта кадра линия НИЗКАЯ: на одиночном символе с чистой линией
норма E=7, «5» — в хвосте виден чужой фронт (кадр-преследователь).
Проверка за минуту без перепрошивки: (1) RESET — счётчик должен
остановиться на 0000; если ПОЛЗЁТ САМ без ввода — петля/самозахват
(решающий признак); (2) одно нажатие 'a': эхо 1 байт — старый образ ⇒
перепрошить `uart_echo_diag3.hex` (480 байт, 0000h–01DFh, Intel-Hex
SHA256 8229274a…, образ SHA256 40d745e2…, сумма байт 58h) с нулевого
смещения и ОБЯЗАТЕЛЬНОЙ верификацией; эхо 3 байта — diag3 в ПЗУ ⇒
слать тройки. Дисплей после 'a' (байт пока 00): «0001» = diag v1 или
diag3 (различать по числу байт эха), «0071» = diag2.

### diag v4 — исправленный ввод: RLC вместо RAR, защита L, порядок эха (10-24)

**Дамп ПЗУ от владельца (10-24):** образ = diag3 байт-в-байт (480 байт,
0000h–01DFh), наблюдение «любой ввод → эхо 00 00 00» подтвердилось.
Причина найдена в КОДЕ выборки/релиза — три ошибки, все ловятся
только на уровне инструкций (событийная симуляция v3 моделировала
ЗАМЫСЕЛ, а не код):

| # | Баг | Следствие | Фикс |
|---|---|---|---|
| 1 | В обеих ветвях выборки `RAR` с комментарием «CY <- бит линии»: RAR кладёт в CY бит A0 (=0), SID (A7) уезжает в A6 и уничтожается | CY=0 всегда ⇒ TSB≡0000, L≡00 ⇒ ЛЮБОЙ кадр = 00 | `RLC` (CY ← A7 = SID) в обеих ветвях + повторный RLC для упаковки TSB |
| 2 | `LHLD TSB` в RXPACK каждый тик перезаписывает L из ОЗУ (8003h) | накопитель байта в L не доживал бы до релиза даже с рабочей выборкой | `PUSH H` перед упаковкой / `POP H` после SHLD |
| 3 | Релиз копировал пару через `LHLD TSB / MOV A,H / MOV A,L`: H-first цепочка RAL пакует пару как V=(L:H) — в ОЗУ 8002h=tl-hi, 8003h=tl-lo, но LHLD даёт L=tl-hi, H=tl-lo, и в очередь первым уходил H (tl-lo) | эхо [байт][tl-lo][tl-hi]: 'a' дала бы 61 37 04 | прямые `LDA TSB / STA QBUF / LDA TSB+1 / STA QBUF+1` |

TX-часть (SIM 40h старт / C0h единица, SDE=A6, SOD-data=A7) и протокол
НЕ тронуты — подтверждены аппаратно.

**Верификация (instruction level, sim_diag4_isr.py):** полная эмуляция
подмножества 8085 (MAIN+ISR+DMUX). На diag3 воспроизводится ТОЧНОЕ
наблюдение владельца: 00 00 00, BYTE0=00, TSB=0000, B тикает. На diag4
— вся документированная таблица: 'a' → **61 04 37**, 'o' → 6F 07 B7,
'3' → 33 06 67, Enter → 0D 05 87; дисплей [B=1][SSELF=0][байт];
старт/стоп/холостые биты волновой формы на местах. check_diag4_hex.py:
TX-автомат, MAIN, DMUX, SEGTAB — байт в байт с diag3.

Образ 480 байт, 0000h–01DFh; Intel-Hex SHA256 f68bac7f7556286d…,
образ SHA256 609996e3d4deb940…, сумма байт 9AD8h. Ожидания на железе —
таблица diag v3 выше, теперь реально достижимая: RESET → «0.0.0.0.»,
одно 'a' → три байта 61 04 37 и дисплей «0061». Если вместо этого
снова 00 00 00 при верифицированной прошивке — это уже честный
вердикт таймлайна про линию (таблица вердиктов diag v3).

## Как собрать

1. В ISE-проекте **beta** (отдельная копия проекта или замена источника):
   `beta/01_timer/top_suart.v` — Set as Top Module; UCF —
   `beta/01_timer/top_suart.ucf`.
2. Опции те же, что у стабильного: Translate: Keep User Location
   Constraints = ON; Place & Route: Ground on Unused IOs = ON; XST: Keep
   Unused Inputs = ON. (План Б, если не ляжет: Fit Properties → Collapsing
   Input Limit = 20.)
3. (Желательно) ISim: `tb/timer_tb.v` + `top_suart.v` — все проверки T0..T5
   должны дать «ВСЕ ПРОВЕРКИ ПРОЙДЕНЫ».
4. Фит → чек-лист .rpt (ниже) → .jed в плату → тест на железе.

## Чек-лист .rpt (beta/01_timer v3.3b3, поверх стабильного)

- **Fitting Status: SUCCESSFUL**, 0 ERROR, сирот нет;
- **WARNING Cpld:897 = 0** — НИ ОДНОГО BUFR: bus_reg<1..5,7> и seg_q<0>
  сидят В СВОИХ пиновых МС (уравнения захвата 4–7 входов);
- PGND = **ровно {P74, P76, P78, P79, P81, P95, P96, P98} — 8 шт** (P75
  вышла — стала выходом RST75);
- **RST75 = P75**, выход, FAST; RST75_r — регистр в МС выхода (входы:
  tmr_cnt[7:0] + cpu_rst);
- Equations: `tmr_cnt` 8 бит (enable `tmr_tick_q & !RST75_r`, загрузка
  `tmr_load_q` из bus_reg); `tmr_tick_q` — регистр (por_ce & txm_cnt==7Fh);
  **txm_cnt — свободный счёт вверх (стопа в FF НЕТ)**; `txm_mask_q` —
  регистр TX-маски (set cpu_rst, clear txm_cnt==FF); **por_run НЕ липкий**:
  `por_run <= por_nz`, por_cnt после POR стоит в 00;
- хелперы живы (по 1 МС): `al_cap`, `bus_rd`, `wr_cap`, `cpu_rst`, `por_ce`;
  **cnt<3> ОТСУТСТВУЕТ** (cnt = 3 бита);
- MC **~106/108** (запас ~2 — не впритык); FB-входы ≤ ~200/216;
- НЕТ схлопнутых функций шире ~20 входов, хелперы `__or0000/__D2` на месте;
- GSR не используется, clk = P29/GCK3, входы на местах (INP) — как у POR6;
- если снимать trce: путь clk → tmr_cnt → RST75_r → P75 стал на 2 такта
  длиннее (регистры tick_q/RST75_r) — запас по частоте только вырос;
  критерий анализа 40 нс — по-прежнему не проблема.

Если снова не ляжет — **План Б'** (см. смету выше): снять keep с bus_rd,
затем с por_ce; прислать новый .rpt.

## Критерии успеха (из ANALYSIS.md §6, с поправками)

1. Фит Successful, 0 ERROR; WARNING:897 — 0 (цель).
2. PGND-чек-лист сжался с 9 до 8 ног: P75 = выход (UCF и шапка уже так).
3. Статика (если снимаем trce): путь clk→декод→P75 не хуже 40 нс.
4. Тестбенч ISim: T0..T5 зелёные (квант 51,2 мкс, N тиков, ре-арм, стоп).
5. Железо: баннер идёт, дисплей живой; при N=195 и ISR с делением на 2 —
   счётчик на дисплее тикает 50 раз/с.
