digitalinvitro/CPLD-plus-8085/beta/gfxstream/SPEC.md

# beta/gfxstream — GFXSTREAM v1: графический поток по UART 1М (спецификация)

> **СТАТУС 11-12-1: v2.2 — КАЛИБРОВКА ПЕРИОДА ПЛАТЫ + ВЬЮЕР v1.5 (КРАСКА БЕЗ
> СЕТКИ WM_TIMER). Владелец по логу v2.1 (2606 кадров / 120,5 с): «мячик не
> плавно и скачет». Форензика (beta/txuart/scripts/gfx_log_analyze.py): провод ЦЕЛ (0
> разрывов SEQ), НО реальный период платы 46,3481 мс ± 0,0023 (10 обёрток
> SEQ) = −1,124% от номинала — сим считал такты по таблице 8085, силикон
> исполняет смесь инструкций быстрее; пад-петля DCX/MOV/ORA/JNZ = 24T на
> обеих архитектурах — нейтральна, коррекция = добавка пада: W_V2
> 2194→2262 + 3 NOP = +1644T → РЕАЛЬНЫЙ период 46,874 мс = РОВНО 3 тика
> (сим-период 148 128T = 47,401 мс, сим-T ≠ реальному — УРОК 15). Следствие
> скользящей фазы: dt размазан 31/47/62, гейт v1.4 давал 3,37% структурных
> пропусков краски (скачки шара на 2 шага) + модуляция каденса; стартовый
> бэклог 10 461 Б = teleport в первые секунды. УРОК 14: краска не должна
> жить на сетке WM_TIMER — каденс краски = каденс ПРОВОДА. ВЬЮЕР v1.5
> (разоморожен владельцем, «добавь диагностику»): таймер 15→2 мс +
> timeBeginPeriod(1), ГЕЙТ 36 мс УДАЛЁН (краска сразу в тике декода, интервал
> краски = интервал провода ± 2 мс), бэклог > 3000 Б сбрасывается (флеш
> вместо teleport-а), CSV v1.5 с колонкой kind: D=декод / P=краска (seq,
> dt краски, пропуски) / F=флеш; статус + сводка при закрытии; старые логи
> совместимы. СИМ v2.2: 940 кадров ВСЁ ОК (пути 148 128T ±54T, ENTR ≤
> 167 610T, баннер «GFXSTREAM v2.2»). Файлы: gfxstream_v22.{asm,hex,bin,lst}
> (md5 hex 3aacb4d0…), gfx_view.ps1 v1.5 (md5 cb72da29…). КРИТЕРИИ ПРИЁМКИ
> (лог2 вьюера v1.5): обёртки SEQ 12,000 с ± 0,3%; интервал краски 47±3 мс
> ровно (p90-p10 ≤ 6 мс); пропуски 0; разрывы SEQ 0; флеши ≤2 (старт).
> TXSTRESS не тронут (69 770 Б/с при номинале — такт платы номинален,
> корень расхождения в смеси инструкций — отдельный эксперимент). Опция
> «плавнее шар»: 32 FPS = 2 тика = 100 000T, шаг 1 клетка (256 px/s) —
> FF-добивку можно укоротить, решать отдельно.**
>
> **ПРЕДЫДУЩЕЕ — СТАТУС 11-11-8: v2.1 — ПЕРИОД КАДРА 46 875 МКС = РОВНО 3
> ТИКА ДИСПЛЕЯ.
> Владелец по живому логу v2 (10 513 кадров ≈ 7 циклов): «только косое
> заполнение плавно, остальные резко меняют позицию объектов». Форензика:
> провод ИДЕАЛЕН во всех сценах (25,27 FPS, dt ср 39,6, buf>2006 <1%) —
> провод и декод не виноваты. Диагноз: гейт вьюера красит на сетке таймера
> 15,625 мс каждые 3 тика (46,875 мс — порог 36 лежит между 31,25 и 46,875),
> а провод даёт кадры каждые 40 мс → 14,7% кадров декодируется, но никогда
> не рисуется → каждый пропуск = скачок дискретного объекта на 2 шага (шар
> 32 px, текст 2 px); дитер скрывает пропуски (сплошной узор, нет объектов).
> УРОК 13: темп провода должен быть КРАТЕН сетке дисплея ПК — пропуски
> кадров неотличимы глазом только на непрерывных узорах. ФИКС v2.1: период
> кадра 146 484T = 46 875 мкс = ровно 3 тика = 21,33 FPS (в исходном ТЗ
> владельца «20-25 FPS»), фазы краски и декода совпадают навсегда (дрейф
> 0,12 мкс/кадр = 1 тик за ~2 мин, глотается буфером) → 1:1 кадр=рисование,
> ноль пропусков. Скорости: шар 16 px/46,9 мс, строка 21 px/s, канал
> 42,8 КБ/с (43%). СИМ: 940 кадров ВСЁ ОК, периоды путей 146 484T ±54T,
> входы в сцену ≤165 966T (53,1 мс, ≤1/цикл — исключение п. v2). Файлы
> gfxstream_v21.{asm,hex,bin,lst}; баннер «GFXSTREAM v2.1». ВЛАДЕЛЬЦУ:
> прошить gfxstream_v21.hex, вьюер тот же.**
>
> **GFXSTREAM v2 — ДЕМО ГРАФИЧЕСКИХ ВОЗМОЖНОСТЕЙ (11-11-7). Прошивка
> rom/gfxstream/gfxstream_v2.{asm,hex,bin,lst} (1 790 Б из 8 КБ ROM; ОЗУ
> ~1,3 КБ). ПРОВОД = ФОРМАТ v1 БЕЗ ИЗМЕНЕНИЙ: A5 5A [TYPE] [N] [SEQ]
> [payload], конверт 2 006 Б, TYPE 01 N=2000, TYPE 02 N=202 (маска 13 Б +
> 9 строк x 21 Б, FF-добивка), SEQ mod 256 — вьюер v1.4 (md5 e3ab74ca)
> работает БЕЗ ПРАВОК. Баннер «GFXSTREAM v2». Цикл 908 кадров = 36,3 с,
> три сцены: (S0) БЫСТРЫЙ ШАР 250 кадров — шар 8 px x 7 строк, шаг
> ±2 клетки (16 px/кадр) и ±2 строки, отскок flip-recompute от 0/19 и
> 0/92; дельта = ровно 9 строк [RMIN..RMIN+8] (7-строчный шар при шаге 2
> даёт те же 9 строк, что 8-строчный при шаге 1 — N=202 сохранён);
> кейфрейм TYPE 01 на входе в сцену и каждый 100-й кадр сцены; (S1)
> ДИТЕР-ВОЛНА 240 кадров — полные кадры, байт строки =
> DIT[(row+NEG16[t&15])&15], 16-ступенчатый дизеринг-занавес, волна вниз
> 1 строка/кадр, полный темп 50 150 Б/с; (S2) БЕГУЩАЯ СТРОКА 420 кадров —
> вход полный кадр (сетка + полоса), далее дельты строк 45..53 (9 строк,
> маска ROM E0h/3Fh); битмап 48 символов x 8 строк («GFXSTREAM V2 -
> 160X100 - 25FPS - FAST BALL DEMO «), шрифт 8x8 23 глифа, сдвиг влево
> 1 px/кадр RAR-цепочкой по убыванию адресов (УРОК 11). ВСЕ КАДРЫ
> строятся аналитически и льются в UART прямо из регистров (FB не нужен):
> генерация+посылка слиты, такт ≥32T/байт (OUT+NOP+NOP+DCR+JNZ) либо
> 37T (LDAX/LDA-вариант), ноль отбросов TX. Период 125 000T: работы путей
> выровнены падами P_BF/P_BD/P_DI/P_MF/P_MD + головной пад P_H (у дельты
> шара в голове строится маска ~1,1kT — остальные пути добирают тем же)
> + единое ожидание W_V2=1300. ИСКЛЮЧЕНИЕ (документировано): кадры входа
> в сцену несут switch-блок (~250T) и на входе в S2 копию битмапа
> мастер→работа (16,9kT) — период ≤145 000T (46,4 мс), ≤1 кадра на цикл,
> дисплеем поглощается. СИМ sim_gfxstream_v2.py (исполнение реального hex
> + эталонная модель сцен): 940 кадров ВСЁ ОК — побайтовая сверка, SEQ
> mod 256 без пропусков, периоды путей 125 000T ±82T, мин. межписьмо
> 32T, 0 отбросов, FPS 24.999; превью сцен download/gfxstream_v2_preview.png.
> СБОРКА: python3 asm8085.py gfxstream_v2.asm gfxstream_v2 (ассемблеру
> аддитивно добавлены RAL/RAR — регрессия: gfxstream_v1.hex пересобран
> байт-в-байт). Шар быстрее v1 вдвое по средней скорости; «сброс как
> кнопка ускорения» больше не нужен.**
>
> **СТАТУС 11-11-6: ПРИЁМКА ШАГА 3 ЗАКРЫТА. Решающий лог v1.4 у владельца
> (358 кадров / 15,56 с, log_accept_v14_1111.csv): критерий ФИКС-5 выполнен —
> пар dt≤5 в полных фазах 0 (все 9 кадров с dt≤5 — первые 130 мс холодного
> старта вьюера, буфер 11 657 Б); эфир после обоих сбросов платы 25,32/25,41
> FPS = 50 797/50 970 Б/с (25±1, ср dt 39,5 мс), разрывы SEQ 2 = оба сбросы
> владельца, потерь нет; dt: 2 тика 38,1% / 3 тика 47,4% / 4 тика 7,8%
> (макс 71 мс, все однокадровые при буфере ≤2006 Б — поглощённый джиттер
> доставки, не пачки); буфер макс 2422 Б (1,2 кадра), ср 928 Б. Симуляция
> гейта 36 мс на реальных utc: 96,9% отрисовок = ровно 46,9 мс → дисплей
> ~21 FPS ровной сеткой, рывков нет. Кейфрейм ROM (SEQ%100=99 → TYPE 01)
> подтверждён 4 раза. Самотест 12/12, декод 238 мс (запас 22×). Вьюер v1.4
> заморожен (md5 e3ab74ca, обе копии). Дальше: вернуть на плату ACdE-монитор
> (README); ускорение шара (шаг 2 клетки, запас канала ~2×) — отдельным шагом.**
>
> **ПРЕДЫДУЩЕЕ — СТАТУС 11-11-5: ФИКС-5 ВЬЮЕРА (КРАСКА ВНЕ ПОТОКА ЧТЕНИЯ) — v1.3 у
> владельца: самотест 12/12 (декод 264 мс на бюджет 5200 — запас 20х) +
> CSV-лог живого сеанса (-Log), 419 кадров. Лог подтвердил ЖЕЛЕЗОМ: разрывов
> SEQ 2 = оба сброса платы владельцем («чтобы шарик быстро бегал»), потерь
> нет, все фазы ср. 25,1-25,4 FPS. Но полные фазы (TYPE 01 после сброса)
> декодировались ПАЧКАМИ (5 и 9 пар dt 0-5 мс с паузами 60-82 мс) — причина:
> краска полного кадра = 16 000 интерпретируемых итераций (~30-70 мс на 5.1)
> в потоке чтения порта; «быстрый шар» после сброса = этот артефакт (прыжки
> по 2 клетки). Фикс v1.4: LUT байт -> 32 Б BGRA + [Array]::Copy на байт FB
> (2000 memcpy вместо 16 000 итераций), один LockBits+Marshal.Copy; краска
> ~2-5 мс и чтение не блокирует. После фикса все фазы ровные, шар идёт
> честные равномерные 25 FPS. Реальное ускорение шара — правка прошивки
> (шаг 2 клетки/кадр, запас канала 2х) — отдельным шагом после приёмки.
> Приёмка шага 3: v1.4 → -SelfTest → -Port COM13 -Log gfx_log.csv, ≥60 с:
> FPS 25±1, инт 40/≤50 мс, пар dt≤5 НЕТ даже в полных фазах, пропуски SEQ 0
> (без сбросов), ресинк 16 Б, ~50 150 Б/с.**
>
> **ПРЕДЫДУЩЕЕ — СТАТУС 11-11-4: ФИКС-4 ВЬЮЕРА (КАДЕНС ОТРИСОВКИ) — v1.2 у владельца:
> «всё так же», рывки на дельтах остались (граница ~кадр 75-80). Цифры
> доклада (кадры 1504, SEQ ~171 растёт, пропуски SEQ 1) — эфир ЦЕЛЫЙ:
> единственный пропуск = сам сброс (SEQ → 0), после сброса потерь нет
> (171 ≡ счёт кадров после сброса mod 256). Диагноз: каденс панели —
> WM_TIMER ~15,6 мс, кадр 40 мс завершается на 2-м/3-м тике (попеременно
> 31/47 мс); после удешевления декода (v1.2) на дельтах ничто не выравнивает
> такт. Фикс v1.3: гейт отрисовки 36 мс (Stopwatch, всегда свежий FB —
> просроченные отбрасываются по п.4), статус в 2 строки + «инт ср/макс мс»
> и «буф макс», ключ -Log <файл> = CSV по кадру (utc,seq,type,dt_ms,buf).
> Приёмка шага 3: v1.3 → -SelfTest → -Port COM13 -Log gfx_log.csv, ≥60 с:
> FPS 25±1, инт 40/≤50 мс, пропуски SEQ 0, ресинк 16 Б, ~50 150 Б/с;
> прислать лог + двухстрочный статус.**
>
> **ПРЕДЫДУЩЕЕ — СТАТУС 11-11-3: ФИКС-3 ВЬЮЕРА (перф, рывки) — у владельца первые 3 с шар
> шёл ровно (75 полных кадров TYPE 01), на дельтах TYPE 02 — рывки:
> FFh-добивка (1798 Б/кадр) пропускалась RemoveAt(0) по одному байту
> (~45 000 вызовов/с), PS 5.1 не успевал, декод шёл пачками. Фикс v1.2:
> серия FFh — одним RemoveRange (семантика 1-в-1); поточечные копии
> payload/FB → .NET-батчи; в -SelfTest добавлен INFO-замер времени декода
> (бюджет 5200 мс на 260 796 Б = темп живого эфира 50 150 Б/с). Провод не
> виноват: период 125 000T ±95T на всех кадрах (сим). Приёмка шага 3
> продолжается: v1.2 → -SelfTest → -Port COM13, ≥60 с без рывков, статус:
> FPS 25±1, пропуски SEQ 0, ресинк 16 Б, Б/с ~50 150.**
>
> **ПРЕДЫДУЩЕЕ — СТАТУС 11-11-2: ФИКС-2 ВЬЮЕРА (рантайм) — у владельца gfx_view.ps1 упал
> на GUI (строка 374): «op_Addition» на [System.Object[]]. Причина: запятая в
> PS связывает крепче «+», «New-Object Size ((160*S)+24, (100*S)+70)» =
> «(160*S) + @(24, (100*S))» = int + массив. Фикс v1.1: оба места
> (ClientSize, lbl.Size) → [System.Drawing.Size]::new(...). BOM-фикс 11-11
> подтверждён владельцем: скрипт исполняется до построения окна. Приёмка
> шага 3 продолжается: v1.1 → -SelfTest (exit 0) → -Port COM13.**
>
> **ПРЕДЫДУЩЕЕ — СТАТУС 11-11: ФИКС ПАРСЕРА ВЬЮЕРА НА 5.1 — gfx_view.ps1 был UTF-8 без BOM,
> Windows PowerShell 5.1 читал его в CP1251 → 9 ошибок ParserError ещё до
> запуска (mojibake-строки, «умные кавычки» рвали литералы). BOM добавлен в
> обе копии, тело не тронуто (SelfTest 12/12 в pwsh 7 в силе). Приёмка шага 3
> перезапускается теми же командами. ПРЕДЫДУЩЕЕ — СТАТУС 11-10-6: ШАГ 0 ПРИНЯТ (p04: 71/71 цикла, FLOOD 97 887 Б/с = 97,9%
> линии, 0 ошибок — СТАТУС 11-10-5 в beta/txuart/README.md). FIRMWARE
> GFXSTREAM v1 ГОТОВА И ПРОВЕРЕНА СИМОМ: `rom/gfxstream/gfxstream_v1.hex`
> (738 Б), сим по реальному hex 205 кадров ВСЁ ОК (0 отбросов TX, SEQ без
> пропусков, побайтовая сверка паттерна, период 125 000T ±95T = 25.000 FPS);
> ПК-вьюер `gfx_view.ps1` (-SelfTest 12/12, pwsh 7.4.6); кросс-проверка:
> поток прошивки ≡ модель вьюера, md5 1-в-1 (260 796 Б). ВЛАДЕЛЬЦУ: прошить
> gfxstream_v1.hex, запустить `.\gfx_view.ps1 -Port COM13`, ожидать 25±1 FPS,
> затем приёмка 60 с (SEQ без пропусков) — п.6.**

> Решение владельца 11-10-4 (выборы после анализа полосы): **рендер — GUI-окно
> WinForms из PowerShell; формат — 1bpp ч/б; геометрия — 160×100; поток —
> TYPE-таблица (расширяемая); цель — 25 FPS; шаг 0 — прошить p04 (TX_BOTH=0)
> и проверить 97,7% линии.**

## 1. Полоса канала (доказано TXSTRESS v1.1 + разбор исходника)

| Режим | Темп | % линии 100 000 Б/с |
|---|---|---|
| Стационарный цикл (прошит, 60 с) | 69 770 Б/с | 69,8% |
| FLOOD TX_BOTH=1 (прошит) | 74 405 Б/с = 42T | 74,4% |
| **FLOOD TX_BOTH=0 (`txstress_v11_p04.hex`, собран, не прошивался)** | **97 656 Б/с = 32T** | **97,7%** |
| Физический потолок (кадр 31,25T) | 100 000 Б/с | 100% |

Потолок софта = 32T, ниже нельзя:
- цикл 8085 `MOV A,C(4)+OUT 04h(10)+INR C(4)+DCR B(4)+JNZ(10)` — убирать
  нечего (OUT и JNZ несжимаемы);
- запись в занятый TX ядро **отбрасывает** (RTL hwuart v401 «отброс при
  busy»; железное доказательство — SPRINT 31T: принята ровно половина,
  U=8192 из 16384, 52/52 цикла);
- опрос TXRDY (`IN 05h`, бит 1) стоит ≥24T/Б — дороже слепых 32T;
- зазор 32T−31,25T = 240 нс/Б — **константа** (оба клока от одного 25 МГц);
- остаток 2,3% — только CPLD FIFO/пейсинг, не влезает в XC95108 (фит 103/108);
- бод >1М бессмысленен: лимит — CPU, его темп от бода не зависит.

## 2. Бюджет кадра при 25 FPS (период 40 мс)

| Темп | Байт/кадр | Посылка TYPE 01 (2 006 Б) | Запас CPU |
|---|---|---|---|
| 74,4К (42T, fallback) | 2 976 | 27,0 мс | 13,0 мс |
| **97,7К (32T, p04)** | **3 906** | **20,5 мс** | **19,5 мс (~61К T-сост.)** |

## 3. Кадр на проводе

```
Кадр = A5 5A [TYPE] [N_LO] [N_HI] [SEQ] [payload]
```
- Магия `A5 5A` — точка ресинка (по прецеденту лендмарков TXSTRESS);
- `TYPE` — тип кадра; `N` — длина payload (LO/HI); `SEQ` — счётчик кадров
  mod 256 (контроль пропусков, отброс просроченных);
- заголовок 6 Б ≈ 0,15–0,3% кадра.

**TYPE 01 — полный 1bpp 160×100** (payload 2 000 Б): 100 строк × 20 Б,
строки сверху вниз, бит MSB = левый пиксель, 1 = светлая точка.

**TYPE 02 — дельта строк**: маска изменённых строк 13 Б (ceil(100/8), бит i
= строка i изменена) + для каждой `[номер 1 Б][20 Б]`. Выгоден при <95
изменённых строк.

**TYPE 03 — RLE**: пары `[счёт 1..255][байт]` до конца payload — для полей,
заливок, осциллографа.

**TYPE 04 — текст 80×25 CP866** (2 000 Б) — рендер моноширинным шрифтом.

## 4. Пейсинг и ОЗУ

- 25 FPS: старт кадра по таймеру платы каждые 40 мс, квитанций нет (у UART
  нет backpressure); ПК по SEQ отбрасывает просроченные, FPS-метр в рендере.
- Двойной буфер: FB_A + FB_B = 2×2 000 = 4 000 Б из 32 768 (12%); рисование
  в теневой буфер, отправка из другого, swap по SEQ.
- Отправка — тот же доказанный 32T-цикл; поток из ОЗУ: `MOV A,M(7)+OUT(10)+
  INX H(6)+DCR B(4)+JNZ(10) = 37T` → развёртка ×2 + набивка NOP-ами до 32T
  (выше 31,25T уходить нельзя — перебор = отбросы).

## 5. Ожидания контрольного прогона p04 (шаг 0)

Прошить `rom/txstress/txstress_v11_p04.hex`, прогон `.\uart_speed.ps1 -Port COM13`:
- FLOOD **97 656 Б/с (97,7%)**, цикл **~845 мс / 76 711 Б (~91%)**, ~70 циклов
  за 60 с; SPRINT U=8 192 (фаза ~110 мс, приём 74 405 Б/с), BURST U=2 816
  (~42 мс, 67 368 Б/с);
- паттерн +1 ЦЕЛ, B=7/7, токены +7/цикл, ЧУЖИХ 0 — критерии те же;
- блок ОЖИДАНИЙ утилиты печатает старые цифры 42T (74 405) — это НЕ ошибка:
  v1.3 заморожена с ожиданиями TX_BOTH=1, вердикт считается по паттерну/
  лендмаркам/U и для p04 действителен.

## 6. План

0. **p04**: прошить, прогнать, прислать ИТОГ (ожидания — п.5). — **ВЫПОЛНЕНО
   11-10-5: 71/71 цикла, FLOOD 97 887 Б/с, 91,4% цикл, вердикт зелёный.**
1. **firmware gfxstream v1** (asm8085): баннер `GFXSTREAM v1`, цикл 25 FPS,
   TYPE 01 тест-паттерн (сетка/полосы/движущийся объект), затем TYPE 02. —
   **ВЫПОЛНЕНО 11-10-6: `rom/gfxstream/` (asm CP1251 + UTF-8, .lst/.bin/.hex,
   738 Б). Отклонения от черновика SPEC, доказанные симом:**
   - **развёртка ×2 из п.4 ОТКЛОНЕНА**: два OUT в теле стоят через 24T —
     меньше TX_BUSY 31,25T → каждый 2-й байт отбрасывается. Практичный
     поток из ОЗУ — линейный цикл `MOV A,M+OUT+INX H+DCX B+MOV A,B+ORA C+
     JNZ = 47T/Б РАВНОМЕРНО на всём кадре` (66 489 Б/с во время посылки,
     кадр 2 006 Б за 30,2 мс) — 47 > 31,25 → НОЛЬ отбросов (счётчик сима);
   - **пейсинг без таймера**: в ядре v2.3 таймера нет (порты 00h–05h) —
     период 40 мс даёт программный цикл ожидания W_FRAME (EQU, калибровка
     по симу) + PAD-выравнивание работы путей (полный путь добит циклом
     PADF до работы дельты — иначе полные кадры перед дельтами растягивались
     на +2 мс: период = посылка + ожидание + работа СЛЕДУЮЩЕГО кадра);
   - **дельта TYPE 02 = ровно 9 строк** (шаг по r всегда ±1: [min(r_prev,
     r_new) .. max+7]), N=202 константа; хвост кадра добит FFh до конверта
     2 006 Б (UART-idle, парсер пропускает тихо по счётчику 1798 Б с
     фолбэком на первый не-FF) → период кадра одинаков в обоих режимах;
   - **маска 13 Б**: бит k байта m = строка 8m+k (LSB = верхняя строка
     группы), стартовый бит — из таблицы TBL (постоянное время вместо
     сдвигового цикла: иначе дрожание периода дельты до ±380T);
   - тест-паттерн: сетка 8×8 (FFh строки кратные 8 + строка 99; 80h иначе;
     байт 19 |= 01h — правый край), шар 8×8 FFh, диагональ с отскоком
     col 0..19, row 0..92; ОЗУ: FB 8000h, SCRAP 9000h, STATE 9800h
     (4 027 Б из 32 КБ); сборка gfxstream_v1.asm (CP1251, есть _utf8 близнец)
     расширенным asm8085.py (добавлены DAD/STAX/LDAX/XCHG/LDA/STA/LHLD/SHLD/
     PUSH/POP + SYM+конст — регрессия: txstress v11/p04 hex байт-в-байт те же);
   - **верификация**: `sim_gfxstream_v1.py` — интерпретатор по РЕАЛЬНОМУ hex
     + модель TX (отброс при busy): 205 кадров ВСЁ ОК — 0 отбросов, SEQ
     0..204 без пропусков, побайтовая сверка с эталонной моделью, период
     125 000T ±95T (±30 мкс), мин. межписьмо 47T; ресурсинки на кадрах 99/199.
2. **ПК `gfx_view.ps1`**: SerialPort 1М 8N1 + WinForms PictureBox 160×100
   (масштаб ×3 = 480×300, NearestNeighbor), ресинк по A5 5A, FPS-метр,
   счётчик SEQ. — **ВЫПОЛНЕНО 11-10-6: beta/gfxstream/gfx_view.ps1 (+ копия
   download/). Самотест `-SelfTest` 12/12 (pwsh 7.4.6): 130 кадров модели,
   FB 1-в-1, дельта ровно 9 строк, мусор → ресинк, удалённый кадр → пропуск
   SEQ; урок: PS `-shl`/`-bor` НЕ расширяют тип — [byte]7 -shl 8 = 0.**
   Кросс-проверка: поток прошивки (сим) ≡ модель вьюера — md5 1-в-1.
3. **Приёмка**: прогон 60 с — SEQ без пропусков, FPS 25±1, вердикт зелёный.
