digitalinvitro/CPLD-plus-8085/MEMORY_MAP.md

# Карта памяти и портов ввода-вывода — retro_PCLD_board V2

> **Статус:** черновик для согласования владельца (Task 12, 2026-10-22). В git **не вносить**
> до ОК по синтезу v3.2.
> **Источники (сверены):** `hdl/top_suart.v` v3.2 (декод + автомат), `SCHEMATIC.md` §5–§7,
> нетлист `retro_PCLD_board-V2_2026-10-20(3).net`, BOM (U4 = UM61512AK-15, U10 = A29040B),
> `hdl/README.md` (частотная модель v3).

## 1. Принципы шины

- Процессор 1821ВМ85 (Intel 8085) имеет мультиплексированную шину: AD0–AD7 (ноги 12–19)
  в такте T1 несут младший байт адреса, разделение по ALE. На плате сети A0–A7 — **одна медь**
  для CPU, CPLD, flash U10 и SRAM U4; CPLD работает **регистровым трансивером**: в T1
  повторно сэмплирует A-сети (последний сэмпл валиден), в T2 отдаёт данные чтения, после записи
  выполняет writeback с защёлкнутым адресом. Старшие адреса A8–A15 идут с CPU напрямую в память.
- Декод памяти — **минимальной ширины: 1 терм на кристалл** (§5 ARCHITECTURE): только A15 и IO/M#.
  IO-порты декодируются по младшим трём битам защёлкнутого адреса (A2–A0).
- Режим: clk 25 МГц → X1 = 5 МГц (XOR-пара /5) → CLK OUT = 2,5 МГц, **T = 400 нс**;
  такт шинного автомата — 25 МГц (один домен). READY = '1' — wait-state нет.
- Адресные входы старших линий памяти: A15 заведён и на flash (U10.3), и на SRAM (U4.31);
  A16–A18 flash заземлены через CPLD (PGND P95/P96/P98).

## 2. Адресное пространство (64 КБ, IO — отдельно)

| Диапазон | Объём | Устройство | Условие выбора (акт. 0) | Чипселект CPLD |
|---|---|---|---|---|
| 0000h–7FFFh | 32 КБ | **ПЗУ** flash U10 A29040B (512К×8, DIP32) | A15=0 **и** IOM=0 | `/CE = #CSr (U1.20) = A15 \| IOM` |
| 8000h–FFFFh | 32 КБ | **ОЗУ** SRAM U4 UM61512AK-15 (64К×8, SKINNY-32) | A15=1 **и** IOM=0 | `/CE = #CS (U1.25) = !A15 \| IOM` |
| IOM=1 (IN/OUT) | 256 портов | **CPLD U1** (регистры индикации/звука/клавиатуры) | IOM=1 + WR#/RD# | внешних чипселектов нет; декод внутри по A2–A0 |

Записей в ПЗУ процессор не может сделать ни при каких условиях (см. §3); всё адресное
пространство памяти покрыто без дыр: чтение 0000–7FFF всегда из ROM, 8000–FFFF всегда из RAM.

## 3. ПЗУ: flash U10 A29040B (окно 0000h–7FFFh)

- Выбор кристалла: `/CE = A15 | IOM` — активна только в циклах памяти с A15=0.
  Строб данных: `/OE = #OEr (U1.16) = CSr_n | wr_phase` — **гасится с T2**: к этому моменту
  данные уже захвачены в `bus_reg`, и флэш не конфликтует с CPLD на шине.
- Адрес кристалла: A0–A7 — защёлкнутый адрес из CPLD, A8–A15 — прямой CPU, **A16–A18 = 0**
  (заземлены через CPLD). Значит видима нижняя половина младшего банка кристалла:
  **образ ПЗУ = offset 0000h–7FFFh самого флэша**. Монитор fw_mon v5 прошивается с offset 0
  (4800 8N1; старый v1 @2400 молчит).
- Запись в кристалл невозможна по железу: `/WE (U10.31) → R18 240 Ом → VCC` (цепь N$14,
  SCHEMATIC.md §8 п.3 — известная особенность схемы). Попытка CPU записи в 0000–7FFF
  отбрасывается и со стороны CPLD: `wb_ram_q = !IOM && A15 = 0` → writeback не запускается.
- Типовые циклы чтения flash: даже медленные градации A29040B (−55…−120 нс) укладываются —
  адрес стабилен с начала T1, CPLD захватывает данные в последнем тике T1 (~200 нс позже).

## 4. ОЗУ: SRAM U4 UM61512AK-15 (окно 8000h–FFFFh)

- Выбор кристалла: `/CE = !A15 | IOM`; второй выбор **CE2 (U4.30) = CS1 (U1.99) = константа '1'**
  — кристалл всегда разрешён по CE2, работаем по /CE.
- Адрес кристалла: A0–A15, причём **A15 на чипе = 1 всегда, когда /CE активен** → SRAM
  отвечает своей **верхней половиной (offset 8000h–FFFFh кристалла)**; нижняя половина
  кристалла (32 КБ) не адресуется. С точки зрения ПО: RAM = 8000h–FFFFh, стек/данные fw_mon живут там.
- Чтение: `/OE = #OE (U1.37) = CS_n | wr_phase` — как у ROM, гасится с T2 (данные в `bus_reg`).
- **Запись — только через writeback CPLD.** В T2 (WR#=0) CPLD захватывает данные с A-сетей
  в `bus_reg`; после WR#↑ автомат WB1→WB4: адрес `addr_latch` на A-сети + данные на D-сети
  (t_AS = 1 тик = 40 нс до импульса), затем `/WE` **2 тика = 80 нс** (≥ t_WP кристалла −15
  с запасом), адрес/данные держатся до конца WB4 (t_AH/t_DH). Импульс `/WE` **защищён от ALE**
  (v3: не обрывается новым циклом, доводится до конца; держатели A/D держат старое до IDLE).
- Защита декода в WB: `/CE` RAM в фазе WB — **защёлкнутый `wb_ram_q`** (захват в момент
  WR#↑): живой декод по A15 во время конфликта адресов взял бы НОВЫЙ адрес CPU и мог сорвать
  запись (v3, п.5 шапки). Конфликт драйверов ≤ 60 нс, выигрывает CPLD (24 мА против 2 мА у ВМ85).
- ОЗУ подтверждена на железе: Task 69-j, 4 паттерна × 32K без ошибок при T = 1280 нс;
  режим T = 400 нс — текущий файл v3.2, tb: T3b/T3d/T3e PUSH-stress.

## 5. Пространство ввода-вывода (IOM=1): регистры CPLD

Декод — по **трём младшим битам** защёлкнутого адреса порта → каждый порт **зеркалится каждые
8 адресов** (00h = 08h = 10h = … = F8h и т.д.). Запись — только в циклы OUT с WR#=0;
чтение порта — IN. Записи в порты 03h–07h игнорируются; прерываний нет — только поллинг.

| Порт | Имя | R/W | Биты | Назначение |
|---|---|---|---|---|
| 00h | SEG | W | A0–A7 | Сегменты индикатора: A0→a, A1→b, A2→c, A3→d, A4→e, A5→f, A6→g, A7→dp. **1 = сегмент горит** (в регистре; на ногах инверсия — общий анод) |
| 01h | DIG/SND | W | A0–A3 | Разряды 0–3: 1 = разряд включён (драйвер VT1–VT4, общий анод) |
| | | W | A4 | SND: 1 = звук (пассивный зуммер — тон генерирует программа) |
| | | — | A5–A7 | Не сохраняются |
| 02h | KBCOL | W | A0–A3 | Активные колонки клавиатуры: 1 = колонка заведена; после сброса 0000 |
| 03h | KBROW | R | A0–A4 | Ряды 0–4: **1 = нажата кнопка в активной колонке**; A5–A7 = 000 |
| 04h–07h | — | — | — | Резерв (аппаратный UART удалён, Task 69; IN 05h статус тоже удалён) |

- Чтение KBROW: CPLD в T2 (после спада ALE) сам драйвит A-сети значением
  `{A7–A5 = 000, A4 = row4, A3 = row3, A2 = row2, A1 = row1, A0 = row0}`.
- Чтение ЛЮБОГО другого порта: CPLD не драйвит шину, память выключена (IOM=1) → AD0–AD7
  в Hi-Z → CPU прочтёт плавающий уровень. Программа должна читать только 03h.
- Клавиатурный опрос: колонка из 02h → пауза → ряды из 03h; подтяжки рядов R21–R25 10к на GND.

## 6. Состояние после сброса (INIT)

| Ресурс | Состояние | Что видит пользователь |
|---|---|---|
| Индикатор | seg_q = FF, dig_q = F | Все 4 разряда показывают «8.» (все сегменты + dp), до первой записи в 00h/01h |
| Колонки | kbcol_q = 0000 | Матрица обесточена, поллинг до первого OUT 02h |
| Звук | snd_q = 0 | Тишина |
| TX (к CH340G) | '1' до конца TX-маски | Чистый UART-idle: окно 2^8 периодов X1 = 51,2 мкс после снятия сброса накрывает SOD=0 процессора (8–40 мкс), потом TX = SOD |
| Шина A/D | CPLD в Hi-Z | До первого ALE процессора драйва нет |
| POR | 12,8 мкс (2^6 × 200 нс = 32 такта CLK OUT) | Даташит 8085A: минимум 3 такта (1,2 мкс) при живом клоке; запас ×10; CLKOUT (P83) тикает весь интервал, квитанция — RSTOUT (P70) |

## 7. Владение шиной по фазам (чтение/запись, T = 400 нс)

| Фаза | AD0–AD7 (A-сети) | D0–D7 | /CE, /OE памяти | /WE RAM |
|---|---|---|---|---|
| T1 (ALE=1) | CPU выдаёт адрес (все слушают) | чтение: память выдаёт данные | активны (декод по A15/IOM) | 1 |
| T1→T2, ALE↓ | CPLD захватывает адрес (`addr_latch`) и данные чтения (`bus_reg`) | — | — | 1 |
| T2 (RD#) | после RDn/ALE — CPLD отдаёт данные чтения на A-сети (`rd_drive`) | память уже off (/OE погашен с T2) | /OE = 1 | 1 |
| T2 (WR#=0) | CPU держит данные записи; CPLD захватывает в `bus_reg` | — | /OE = 1 | 1 |
| WB1 | CPLD: защёлкнутый адрес на A-сети (t_AS 40 нс) | CPLD: данные записи на D-сети | /CE RAM — защёлкнутый `wb_ram_q`; /OE = 1 | 1 |
| WB2–WB3 | как WB1 (импульс не срывается ALE) | как WB1 | как WB1 | **0 (80 нс)** |
| WB4 → IDLE | снятие драйва, шина свободна | Hi-Z | /CE по живому декоду | 1 |

Запись в ROM-окно (A15=0): `wb_ram_q = 0` → writeback не запускается, цикл завершается в IDLE.

## 8. Сводка таймингов памяти (режим v3, T = 400 нс)

| Параметр | Значение | Сравнение |
|---|---|---|
| Цикл шины CPU | 400 нс (2,5 МГц) | чипы −15: запас десятки раз |
| Импульс /WE (WB2–WB3) | 80 нс | t_WP UM61512AK-15 ≈ 15 нс → запас ×5 |
| Установка адреса до /WE (WB1) | 40 нс | t_AS SRAM ≈ 0 нс (требуется только стабильнось) |
| Держание адреса/данных после /WE (WB4) | 80 нс | t_AH/t_DH перекрыты с запасом |
| Зазор WR#↑→ALE (реальный) | 100–180 нс | автомат успевает захватить следующий адрес (hold-off 0) |
| POR | 12,8 мкс | даташит: 1,2 мкс при живом CLKOUT — запас ×10 |
