digitalinvitro/CPLD-plus-8085/PORTS_MAP.md

# Карта портов CPLD U1 XC95108 — retro_PCLD_board V2

> **Статус:** черновик для согласования владельца (Task 12, 2026-10-22). В git **не вносить**
> до ОК по синтезу v3.2 — коммит держим отложенным вместе с `hdl/top_suart.v` / `hdl/README.md`.
> **Источники (сверены между собой):** `SCHEMATIC.md` §5–§6, нетлист
> `retro_PCLD_board-V2_2026-10-20(3).net` (PADS), `hdl/top_suart.ucf`, `hdl/top_suart.v` v3.2,
> отчёт фиттера `hdl/retro_pcld_top.rpt` (72/72 пина совпали с UCF на обоих фитах).

## Как читать карту

- **P** — физическая нога U1 (PQFP-100), нумерация Xilinx; **cpuN** — цепь платы к панельке U3,
  где N — нога процессора 1821ВМ85/8085 по Intel P8085A (U3 = ZIF40, цоколёвка = Intel).
- **Напр.** — направление относительно CPLD: **in** (вход), **out** (выход), **I/O** (двунаправленный),
  **PGND** (нога заземлена фиттером опцией «Ground on Unused IOs»).
- **Пин Xilinx** — функциональное имя ноги из SCHEMATIC.md §5 (GCK — глобальный клок,
  GTS — глобальный output-enable, GSTR — глобальный set/reset, JTAG).
- Состав 100 ног (по отчёту фита): **7× VCC** (P7/P28/P40/P53/P59/P90/P100) + **8× GND**
  (P2/P23/P33/P46/P64/P71/P77/P86) + **4× JTAG** + **72 I/O** (27 in, 28 out, 16 bidir, 1 GCK)
  + **9 PGND** = 100. На плате все шины питания — одна +5 В от USB VBUS.

## 1. Такт и сброс

| P | Пин Xilinx | Сигнал HDL | Напр. | Цепь платы | Куда | Функция |
|---|---|---|---|---|---|---|
| 29 | IO_GCK3 | `clk` | in | clk | U7.5 | Такт CPLD 25,00 МГц (LTC6905HS5-80, факт измерен Task 29-d). Внутри: /5 → X1 5 МГц → CPU 2,5 МГц |
| 1 | IO_GSTR | `RST` | in | RST | SW20.1 | Кнопка RESET: покой = 0, нажатие = **1** (активная 1, доказано платой, Task 25). GSR-сеть не используется — вход гонит синхронный сброс `cpu_rst = RST \| por_run` |

## 2. Шина процессора: управление (входы автомата)

| P | Пин Xilinx | Сигнал HDL | Напр. | Цепь | Куда (U3 нога 8085) | Функция |
|---|---|---|---|---|---|---|
| 93 | IO93F4 | `ALE` | in | cpu1 | 30 — ALE | Строб адресного такта; захват адреса в T1 |
| 92 | IO92F4 | `WRn` | in | cpu2 | 31 — WR# | Строб записи (акт. 0) |
| 91 | IO91F4 | `RDn` | in | cpu3 | 32 — RD# | Строб чтения (акт. 0) |
| 88 | IO88F4 | `IOM` | in | cpu5 | 34 — IO/M# | 1 = IO, 0 = память; входит в оба декода |
| 97 | IO97F4 | `A15` | in | A15 | U3.28, U10.3, U4.31 | Старший адрес: декод ROM/RAM (1 терм на кристалл) |

## 3. Поддержка процессора (выходы)

| P | Пин Xilinx | Сигнал HDL | Напр. | Цепь | Куда (U3 нога 8085) | Функция |
|---|---|---|---|---|---|---|
| 68 | IO68F6 | `X1` | out | cpu21 | 1 — X1 | Такт CPU: 5 МГц = 25/5, XOR-пара, duty ровно 50% (100/100 нс); CLK OUT CPU = X1/2 = 2,5 МГц |
| 87 | IO87F4 | `READY` | out | cpu6 | 35 — READY | Константа '1' — без wait-state (иначе вечные TW). КРИТИЧНО: не заземлять |
| 84 | IO84F4 | `RESET_IN` | out | cpu7 | 36 — RESET IN# | Активный 0: `~(RST \| por_run)`. POR = 12,8 мкс = 32 такта CLK OUT (v3.1, POR_W=6) |

## 4. Наблюдатели — «мёртвые» пины как Hi-Z входы (* keep)

Объявлены входами с `(* keep = "TRUE" *)`, чтобы фиттер (Keep Unused Inputs ON) их не выкинул
и опция Ground on Unused IOs не заземлила: на всех этих ногах — выходы CPU или генератор,
GND запрещён (Task 68-f — «ошибка с ногами»). В логике не используются.

| P | Пин Xilinx | Сигнал HDL | Цепь | Куда (U3 нога 8085) | Что это |
|---|---|---|---|---|---|
| 69 | IO69F6 | `X2` | cpu20 | 2 — X2 | Второй вывод генератора CPU (GND запрещён даташитом) |
| 70 | IO70F6 | `RSTOUT` | cpu19 | 3 — RESET OUT | Квитанция сброса CPU (=1 во время RESET IN#=0) — сигнал для осциллографа при проверке POR |
| 80 | IO80F6 | `INTAn` | cpu11 | 11 — INTA# | Не используется (векторные RST держателями '0' заменены PGND) |
| 82 | IO82F4 | `HLDA` | cpu9 | 38 — HLDA | Не используется (HOLD заземлён — DMA нет) |
| 83 | IO83F4 | `CLKOUT` | cpu8 | 37 — CLK OUT | Такт CPU X1/2 = 2,5 МГц — наблюдаемый аргумент готовности процессорных структур (POR) |
| 94 | IO94F4 | `S0` | cpu0 | 29 — S0 | Статусный выход, не используется |
| 89 | IO89F4 | `S1` | cpu4 | 33 — S1 | Статусный выход, не используется |
| 10 | IO10F2 | `AH8` | A8 | 21 | Прямой старший адрес: U3.21 → U10.27 + U4.27 (мимо логики) |
| 12 | IO12F2 | `AH9` | A9 | 22 | → U10.26 + U4.26 |
| 18 | IO18F1 | `AH10` | A10 | 23 | → U10.23 + U4.23 |
| 14 | IO14F2 | `AH11` | A11 | 24 | → U10.25 + U4.25 |
| 4 | IO4F2 | `AH12` | A12 | 25 | → U10.4 + U4.4 |
| 8 | IO8F2 | `AH13` | A13 | 26 | → U10.28 + U4.28 |
| 3 | IO3F2 | `AH14` | A14 | 27 | → U10.29 + U4.3 |

## 5. Мультиплексированная шина AD0–AD7 (цепи A0–A7, bidir)

Одна медь на четыре потребителя: **U3.12–19 (AD0–AD7 CPU) ↔ CPLD ↔ flash U10 ↔ SRAM U4**.
CPLD работает регистровым трансивером: в T1 захватывает адрес/данные, в T2 отдаёт данные чтения,
в writeback сам драйвит адрес и данные (см. MEMORY_MAP.md §7).

| P | Сигнал HDL | Цепь | Куда | Напр. |
|---|---|---|---|---|
| 26 | `A<0>` | A0 | U3.12 + U10.12 + U4.12 | I/O |
| 21 | `A<1>` | A1 | U3.13 + U10.11 + U4.11 | I/O |
| 19 | `A<2>` | A2 | U3.14 + U10.10 + U4.10 | I/O |
| 17 | `A<3>` | A3 | U3.15 + U10.9 + U4.9 | I/O |
| 15 | `A<4>` | A4 | U3.16 + U10.8 + U4.8 | I/O |
| 13 | `A<5>` | A5 | U3.17 + U10.7 + U4.7 | I/O |
| 11 | `A<6>` | A6 | U3.18 + U10.6 + U4.6 | I/O |
| 9 | `A<7>` | A7 | U3.19 + U10.5 + U4.5 | I/O |

## 6. Шина данных памяти D0–D7 (bidir)

Общая для flash + SRAM + CPLD (на CPU напрямую не заходит — только через CPLD).

| P | Сигнал HDL | Цепь | Куда | Напр. |
|---|---|---|---|---|
| 30 | `D<0>` | D0 | U10.13 + U4.13 | I/O |
| 32 | `D<1>` | D1 | U10.14 + U4.14 | I/O |
| 35 | `D<2>` | D2 | U10.15 + U4.15 | I/O |
| 36 | `D<3>` | D3 | U10.17 + U4.17 | I/O |
| 34 | `D<4>` | D4 | U10.18 + U4.18 | I/O |
| 31 | `D<5>` | D5 | U10.19 + U4.19 | I/O |
| 27 | `D<6>` | D6 | U10.20 + U4.20 | I/O |
| 22 | `D<7>` | D7 | U10.21 + U4.21 | I/O |

## 7. Управление памятью (выходы, активный 0)

| P | Пин Xilinx | Сигнал HDL | Цепь | Куда | Функция |
|---|---|---|---|---|---|
| 20 | IO20F1 | `CSr_n` | #CSr | U10.22 | /CE flash: `A15 \| IOM` → ROM 0000h–7FFFh |
| 16 | IO16F1 | `OEr_n` | #OEr | U10.24 | /OE flash: `CSr_n \| wr_phase` — гасится с T2 (данные уже захвачены) |
| 25 | IO_GCK2 | `CS_n` | #CS | U4.22 | /CE SRAM: `!A15 \| IOM`; в writeback — защёлкнутый `wb_ram_q` (v3) |
| 37 | IO37F3 | `OE_n` | #OE | U4.24 | /OE SRAM: `CS_n \| wr_phase` — чтобы SRAM не воевала с CPLD на D в WB |
| 24 | IO_GCK1 | `WE_n` | #WE | U4.29 | /WE SRAM: **только** импульс writeback 2 тика = 80 нс, ALE-обрывом не снимается (v3) |
| 99 | IO99F2 | `CS1` | CS | U4.30 | CE2 SRAM: константа '1' (выбор кристалла всегда разрешён) |

## 8. Soft-UART транзиты (Task 70-a)

| P | Сигнал HDL | Напр. | Цепь платы | Куда | Функция |
|---|---|---|---|---|---|
| 38 | `RX` | in | «TX» | U6.3 (CH340G.TXD) | Приём: транзит в SID (RIM 20h). Заземлять НЕЛЬЗЯ — выход CH340G |
| 73 | `SID` | out | cpu17 | U3.5 (SID, нога 5) | = RX. До Task 70-a была в PGND — теперь ВЫХОД CPLD |
| 72 | `SOD` | in | cpu18 | U3.4 (SOD, нога 4) | Передача: CPU.SOD → TX (SIM 30h) |
| 39 | `TX` | out | «RX» | U6.2 (CH340G.RXD) | = SOD + TX-маска: до конца окна 2^8 X1 = 51,2 мкс после сброса держит '1' (idle, без BREAK) |

Метки платы «TX»/«RX» исторически перекрёстные (сегодняшний смысл — по CH340G: цепь «TX»
идёт ОТ TXD моста, «RX» — К RXD). Цепи слиты и проверены (SCHEMATIC.md §2, нетлист 126/126).

## 9. Индикация и звук

Выходы `seg`/`dig` инвертированы: в регистре 1 = «горит», на ноге 0 (индикатор LD1 — общий анод,
активный 0). После сброса seg_q=FF, dig_q=F — все 4 разряда показывают «8.» (все сегменты + dp).

| P | Пин Xilinx | Сигнал HDL | Сегмент/разряд | Куда |
|---|---|---|---|---|
| 45 | IO45F3 | `seg<0>` | a | LD1.11 |
| 62 | IO62F5 | `seg<1>` | b | LD1.7 |
| 61 | IO61F5 | `seg<2>` | c | LD1.4 |
| 57 | IO57F5 | `seg<3>` | d | LD1.2 |
| 58 | IO58F5 | `seg<4>` | e | LD1.1 |
| 66 | IO66F5 | `seg<5>` | f | LD1.10 |
| 5 | IO_GTS1 | `seg<6>` | g | LD1.5 |
| 60 | IO60F5 | `seg<7>` | dp56 | LD1.3 |
| 6 | IO_GTS2 | `dig<0>` | разряд 0 | R5 240 → база VT1 (КТ502А) → R6 → CA0 (LD1.6) |
| 63 | IO63F5 | `dig<1>` | разряд 1 | R10 240 → VT2 → R7 → CA1 (LD1.8) |
| 65 | IO65F5 | `dig<2>` | разряд 2 | R11 240 → VT3 → R8 → CA2 (LD1.9) |
| 48 | IO48F5 | `dig<3>` | разряд 3 | R12 240 → VT4 → R9 → CA3 (LD1.12) |
| 67 | IO67F6 | `SND` | звук | BUZZER1.1 (пассивный buzzer-12X9; BUZZER1.2 → R4 100 → GND); бит A4 порта 01h |

## 10. Клавиатура 5×4 (Task 34)

Колонки — зарегистрированные выходы (1 = активная колонка, после сброса 0000 — все выключены).
Ряды — входы с подтяжками R21–R25 10 кОм на GND (покой = 0). Матрица: колонка × ряд → нажатие = 1.

| P | Сигнал HDL | Напр. | Куда |
|---|---|---|---|
| 44 | `col0` | out | SW1/SW5/SW9/SW13/SW17 (нога 4) |
| 43 | `col1` | out | SW2/SW6/SW10/SW14/SW18 (нога 4) |
| 42 | `col2` | out | SW3/SW7/SW11/SW15/SW19 (нога 4) |
| 41 | `col3` | out | SW4/SW8/SW12/SW16 (нога 4) |
| 56 | `row0` | in | SW1.1 + R25 10к → GND |
| 55 | `row1` | in | SW5.1 + R24 |
| 54 | `row2` | in | SW9.1 + R23 |
| 52 | `row3` | in | SW13.1 + R22 |
| 51 | `row4` | in | SW17.1 + R21 |

SW20 (RESET) вне матрицы: SW20.1 → RST (P1), SW20.2 → R2 240 → VCC, SW20.3/4 → GND.

## 11. PGND — 9 ног, заземлённых фиттером (Ground on Unused IOs = ON)

Единственные ноги, которым РАЗРЕШЕНО стать землёй. На плате — входы CPU/flash с жёстким
смыслом «0»: прерывания/hold выключены, старшие банки flash выключены (A16–A18 = 0 →
виден нижний банк кристалла). P73 (SID) с Task 70-a в этом списке БЫТЬ НЕ ДОЛЖНА.

| P | Цепь | Куда | Смысл заземления |
|---|---|---|---|
| 74 | cpu16 | U3.6 (нога 6) | TRAP = 0 |
| 75 | cpu15 | U3.7 (нога 7) | RST 7.5 = 0 |
| 76 | cpu14 | U3.8 (нога 8) | RST 6.5 = 0 |
| 78 | cpu13 | U3.9 (нога 9) | RST 5.5 = 0 |
| 79 | cpu12 | U3.10 (нога 10) | INTR = 0 |
| 81 | cpu10 | U3.39 (нога 39) | HOLD = 0 (DMA нет) |
| 95 | A18 | U10.1 (flash) | Старший банк flash = 0 |
| 96 | A16 | U10.2 (flash) | Банк flash = 0 |
| 98 | A17 | U10.30 (flash) | Банк flash = 0 |

## 12. Питание и JTAG

| P | Пин Xilinx | Сеть | Примечание |
|---|---|---|---|
| 7, 59, 100 | VCCint_5V | VCC | Ядро |
| 28, 40, 53, 90 | VCCio_3.3/5 | VCC | Банки I/O (на плате та же +5 В) |
| 2, 23, 33, 46, 64, 71, 77, 86 | GND | GND | 8 ног |
| 47 | TDI | TDI | J1.4; подтяжек TMS/TDI на плате нет (SCHEMATIC.md §8 п.5) |
| 49 | TMS | TMS | J1.5 |
| 50 | TCK | TCK | J1.2 |
| 85 | TDO | TDO | J1.3 |

## 13. Глобальные ресурсы (по успешному фиту 2026-10-21)

- `clk` (P29) → глобальный клок **GCK3**; дополнение `clk` → **GCK2** (для negedge-триггера
  `x1_n` XOR-пары делителя). GSR-сеть не используется — сброс всех триггеров синхронный через
  `cpu_rst` (D-gating, Task 25), нога P1 работает обычным входом. Global OE-сети свободны.
- Чек-лист по ногам при каждом новом фите — в шапке `hdl/top_suart.v` (пункты a–h):
  PGND == ровно 9 шт из §11, все входы-наблюдатели на местах (INP), READY/CS1 = '1' ногами.
