digitalinvitro/CPLD-plus-8085/beta/01_timer/ANALYSIS.md

# Эксперимент 01: программируемый интервальный таймер → RST 7.5

Дата: 2026-10-22. База: стабильный baseline v3.2 (hdl/, фит «POR6»).
ТЗ владельца: маскируемое прерывание CPU от интервального таймера;
желательно 8-разрядный с устанавливаемым значением; fallback —
фиксированный интервал, «чтобы прерывания не сыпались слишком часто».

## 1. Ресурсная база baseline (из POR6-фита)

| FB | MC св | FB-вх св | PT св | Примечание |
|----|---|---|---|---|
| FB1 | 5 | **0** | 50 | входы исчерпаны — только автаркичная логика от GCK3 |
| FB2 | 2 | 10 | 58 | |
| FB3 | 6 | 4 | 58 | |
| FB4 | 2 | 23 | 65 | |
| FB5 | 2 | 5 | 49 | |
| FB6 | **0** | 8 | 35 | макроячейки исчерпаны |
| Σ | **17** | **50** | **315** | |

Глобально: GCK3 = clk 25 МГц (доступен всем FB без расхода FB-входов),
GCK2 занята (~clk), GCK1-источник (P24) занят под WE_n; GSR/GTS свободны.
Свободные ноги: P74, P75, P76, P78, P79, P81, P95, P96, P98 (сейчас PGND).

## 2. Куда давить: выбор вектора прерывания

Цепи проверены по SCHEMATIC.md §5/§6: все прямые точка-точка
U1↔U3 (сокет CPU), без резисторов и подтяжек.

| Вектор | Пин | Тип | Маска | Годен | Почему |
|---|-----|-----|---|---|---|
| TRAP (RST4.5) | P74 (U3.6) | немаскир. фронт | нет | **НЕТ** | ТЗ требует маскируемый |
| **RST 7.5** | **P75 (U3.7)** | фронт + защёлка в CPU | SIM M7.5 + EI | **ДА — выбор** | один фронт = одно прерывание; защёлка чистится при признании; вектор 003Ch |
| RST 6.5 | P76 (U3.8) | уровень | SIM M6.5 + EI | запасной | пока уровень высок и EI — повторный вход; импульс таймера может быть длиннее ISR |
| RST 5.5 | P78 (U3.9) | уровень | SIM M5.5 + EI | запасной | то же |
| INTR | P79 (U3.10) | уровень | EI | **НЕТ** | в ответ на INTA# нужно выставить код RST n на шину D — отдельная логика драйвера шины, не влезает |
| HOLD | P81 (U3.39) | — | — | НЕТ | выход CPU, не вектор |

Критично: **P74, P75, P76, P78, P79, P81 — все шесть ног сидят в FB6**
(IOxxF6), а в FB6 свободных макроячеек **0** (18/18). Любой выход на
ногу прерывания требует 1 MC в FB6. План: фиттер (DENSITY) переложит
1–2 buried/регистра из FB6 в другие блоки (в FB6 сидят хелперы
addr_latch_0__or0000, $OpTx$FX_SC$164, которые переносимы); план Б —
ручное высвобождение MC в FB6 переработкой логики.

## 3. Математика тика

Источники: clk 25 МГц (GCK3, бесплатен), X1 5 МГц (внутр.), CLKOUT 2,5 МГц
(вход P83 уже есть в HDL; фазово когерентен clk: CLKOUT = X1/2 = clk/10).

Квант программируемого таймера = 2^k × T_тик; период = (N+1) × квант, N = 0..255:

| Тактирование | k | Квант | Макс. период | Мин. частота | Комментарий |
|---|---|---|---|---|---|
| CLKOUT 2,5 МГц | 8 | 102,4 мкс | 26,2 мс | 38 Гц | **оптимум**: покрывает 50 Гц |
| CLKOUT | 7 | 51,2 мкс | 13,1 мс | 76 Гц | 20 мс недостижим |
| X1 5 МГц | 8 | 51,2 мкс | 13,1 мс | 76 Гц | то же |
| clk 25 МГц | 8 | 10,24 мкс | 2,6 мс | 380 Гц | слишком часто |
| CLKOUT | 9 | 204,8 мкс | 52,4 мс | 19 Гц | ещё «реже», +1 бит прескалера |

50 Гц при кванте 102,4 мкс: N = 194 (19,968 мс; девиация +0,16% против
ровных 20 мс — для тиков несущественно). Точный квант 100 мкс потребовал
бы делителя mod-250 с декодами — не дешевле степени двойки, отвергнуто.

## 4. Варианты архитектуры и сметы

### Вариант 1 — ЦЕЛЬ: прескалер 2^8 + 8-разрядный загружаемый счётчик (рекомендован)

- прескалер: 8 рег, свободный счёт вверх от CLKOUT, тик = фронт MSB
  (декод НЕ нужен — 2^k бесплатно);
- счётчик: 8 рег вниз, параллельная загрузка с шины D при OUT 04h,
  перезагрузка при нуле; сброс → q=255 (нет ложного фронта после RESET);
- выход RST 7.5: декод «счётчик == 0» (8 PT) — тот же MC, что пад P75;
  импульс = 1 квант (102,4 мкс >> требования защёлки 8085, ~1 CLK = 400 нс).

| Ресурс | Нужно | Свободно | Вердикт |
|---|---|---|---|
| MC | 17 (8+8+1, из них 1 — в FB6) | 17 (FB6: 0) | впритык, FB6 требует перекомпоновки |
| PT | ~140–170 (счёт ~2 PT/бит, rst-gating 16, mux загрузки 16, декод 8) | 315 | ок |
| FB-входы | ~35–45 (D<7:0> в FB счётчика ×2–4 блока, стробы, клоки UIM) | 50 | **главный риск**; смягчение: D-шина уже заведена в FB1/2/3, фиттер перекомпонует |

### Вариант 2 — FALLBACK: фиксированный делитель 2^16 от CLKOUT

16 рег (счёт вверх), выход = фронт MSB, период 2^16 × 400 нс = 26,2 мс
(38 Гц). Смета: 16 MC + 1 MC P75 = 17; PT ~35; FB-входы ~3–5 (клок UIM +
rst). Деление 2^k — декод не нужен. Программная градация частоты —
делителем в ISR. Влезание почти гарантировано (вопрос только MC в FB6).

### Отклонённые

- 16-бит счётчик с двухбайтной загрузкой (порты 04h/05h): 18 MC — не влезает;
- INTR с выдачей кода RST n на шину в INTA-цикле: +автомат шины, не влезает;
- mod-250/мод-10 прескалеры ради точных 100 мкс: декоды съедают выигрыш;
- чтение счётчика (IN 04h): +8 драйверов шины — не в v1.

## 5. Софт-интерфейс (вариант 1)

```
      порт 04h (запись): N = период таймера
      T_период = (N+1) × 102,4 мкс;  N=194 → 19,968 мс ≈ 50 Гц

      M7.5 EQU 00h          ; бит маски RST 7.5 в SIM
      ...
      MVI A, 194
      OUT 04h               ; запустить таймер, первый тик через ~20 мс
      MVI A, 00011000b      ; MSE=1, M7.5=0 (НЕ маскировать), 6.5/5.5 маскированы
      SIM
      EI                    ; вектор 003Ch
```

Замечания:
- RESET IN ставит маску RST 7.5 (даташит) — после сброса прерываний нет,
  пока программа не снимет маску и не выполнит EI;
- защёлка RST 7.5 помнит фронт даже при маске: прерванный на время
  DI-участок «догонит» одним прерыванием после снятия маски;
- счётчик после сброса = 255 → первый тик без записи через ~26 мс;
- ISR обязан завершаться EI (обычный RET-стиль) — классика 8085.

## 6. Критерии успеха эксперимента

1. Фит Successful, 0 ERROR; WARNING:897 ≤ 1–2 tolerated, но цель — 0.
2. PGND-чек-лист сжимается с 9 до 8 ног: P75 стал выходом (обновить
   шапку UCF и чек-лист!).
3. Статика: если снимаем trce — путь clk→декод→P75 не хуже 40 нс.
4. Железо: баннер идёт, дисплей живой, тест «тик в ISR увеличивает
   счётчик на дисплее» при N=194 → 50 обновлений/с.
