digitalinvitro/CPLD-plus-8085/i8085-DIP40.png

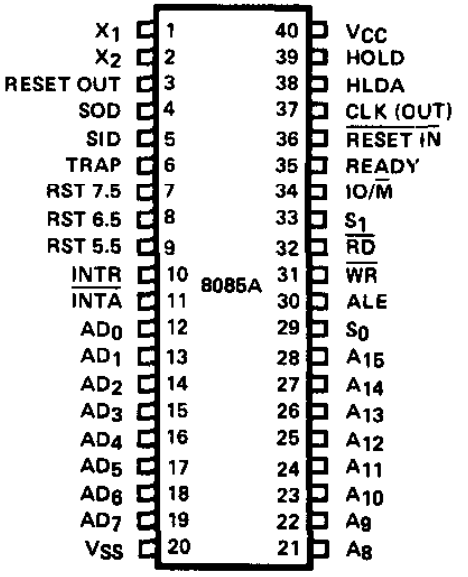
i8085-DIP40.png
