digitalinvitro/CPLD-plus-8085/hardware/BOM_CPLD_108_for_retro-V2_2026-10-20.csv

ID | Name | Designator | Footprint | Quantity | Manufacturer Part
1 | BUZZER-12X9 | BUZZER1 | BUZ-TH_BD12.0-P7.60-D0.6-FD | 1 | buzzer-12X9
2 | 22pF | C1,C2 | C0805 | 2
3 | 0.1u | C3 | C0805 | 1
4 | 0.1uF | C4,C5,C6,C7,C8,C9,C10,C11,C12,C13,C15,C17 | C0805 | 12
5 | 1000u | C14,C16 | CAP-D6.3-F2.5 | 2
6 | 2.54-1*3 | H1 | HDR-TH_3P-P2.54-V-M-1 | 1 | 2.54-1*3
7 | JTAG | J1 | HDR-M-2.54_1X6 | 1
8 | POWER | LED2 | LED-TH_BD3.0_GREEN | 1 | 204-10SYGD/S530-E3
9 | 1K | R1 | R0805 | 1
10 | 240 | R2,R5,R6,R7,R8,R9,R10,R11,R12,R18 | R0805 | 10
11 | 5.1k | R3 | R0805 | 1
12 | 100 | R4 | R0805 | 1
13 | 16K | R19 | R0805 | 1
14 | 1.1K | R20 | R0805 | 1
15 | 10k | R21,R22,R23,R24,R25 | R0805 | 5
16 | A | SW1 | B3F-1052 | 1 | B3F-1052
17 | B | SW2 | B3F-1052 | 1 | B3F-1052
18 | C | SW3 | B3F-1052 | 1 | B3F-1052
19 | D | SW4 | B3F-1052 | 1 | B3F-1052
20 | 7 | SW5 | B3F-1052 | 1 | B3F-1052
21 | 8 | SW6 | B3F-1052 | 1 | B3F-1052
22 | 9 | SW7 | B3F-1052 | 1 | B3F-1052
23 | E | SW8 | B3F-1052 | 1 | B3F-1052
24 | 4 | SW9 | B3F-1052 | 1 | B3F-1052
25 | 5 | SW10 | B3F-1052 | 1 | B3F-1052
26 | 6 | SW11 | B3F-1052 | 1 | B3F-1052
27 | F | SW12 | B3F-1052 | 1 | B3F-1052
28 | 1 | SW13 | B3F-1052 | 1 | B3F-1052
29 | 2 | SW14 | B3F-1052 | 1 | B3F-1052
30 | 3 | SW15 | B3F-1052 | 1 | B3F-1052
31 | _ | SW16 | B3F-1052 | 1 | B3F-1052
32 | 0 | SW17 | B3F-1052 | 1 | B3F-1052
33 | F1 | SW18 | B3F-1052 | 1 | B3F-1052
34 | F2 | SW19 | B3F-1052 | 1 | B3F-1052
35 | RESET | SW20 | KEY-TH_OMRON_B3F-31XX | 1 | B3F-3150
36 | XC95108-PQG100 | U1 | MQFP-100_L20.0-W14.0-P0.65-LS24.0-BL | 1 | XC95108-PQG100
37 | ZIF40 | U3 | 40 PIN ZIF SOCKET | 1 | New SchematicLib
38 | 64k x 8 bit SRAM | U4 | SKINNY-32 | 1 | UM61512AK-15
39 | CH340G | U6 | CH340G | 1
40 | 80MHz | U7 | TSOT-23-5_L2.9-W1.6-P0.95-LS2.8-BR | 1 | LTC6905HS5-80#TRMPBF
41 | A29040B | U10 | DIP32 | 1
42 | CQ-USB- TYPE-C 16P | USB2 | USB-C-SMD_CQ-USB-TYPE-C | 1 | CQ-USB- TYPE-C 16P母座四脚插板有柱
43 | КТ502А | VT1,VT2,VT3,VT4 | TO-92-3_L4.9-W3.7-P1.27-L | 4 | КТ502А
44 | 12MHZ | X1 | OSC-49S-1 | 1 | X49SD12MSD2SC
45,"DISPLAY 14.2MM RED 4DIGIT CA","LD1","12PIN QUAD LED DISPLAY TH100X600","1","CA56-126WA"
