digitalinvitro/CPLD-plus-8085/manuals/fw_mon_acde_manual.md

# Монитор fw_mon (меню ACdE) — инструкция пользователя

> **PDF-версия в ретро-стиле** (с рисунками 7-сегментного индикатора ко всем
> командам): [`manuals/fw_mon_acde_manual_retro.pdf`](fw_mon_acde_manual_retro.pdf) —
> содержание то же, формат книжный.

**Плата retro_PCLD_board V2 · КР1821ВМ85 (i8085) · CPLD lowsize v3.9.x · CPU 3,571 МГц (T = 280 нс) · Изд. 2 (клавиша F2), ноябрь 2026**

Монитор fw_mon — штатная прошивка платы (образ `beta/lowsize/rom/fw_mon.hex`,
1041 байт, прошивается во flash A29040B с нулевого смещения). После подачи
питания или нажатия RESET процессор стартует с адреса 0000h: CPLD на мгновение
зажигает «8. 8. 8. 8.», монитор тут же гасит его и показывает меню из четырёх
букв — по одной на каждый разряд индикатора:

```
┌────┐
│ACdE│    A — адрес · C — ввод кода · d — просмотр · E — пуск
└────┘
```

Умеет ровно то, что нужно для работы «вручную»: ввести адрес, ввести байты
программы в ОЗУ, просмотреть память, запустить программу и вернуть управление
на индикатор и клавиатуру. Вся логика на 4-разрядном семисегментном индикаторе
и матричной клавиатуре 4×5 — мышь и терминал не требуются.

**Обозначения.** Содержимое индикатора пишется в кавычках, погашенные разряды
обозначены подчёркиваниями: «__C9» — два левых разряда не горят, справа байт
C9; «_800» — горит только правый триплет. Тетрады B и D индикатор рисует
строчными «b» и «d» — поэтому меню читается именно «ACdE».

---

## 1. Клавиатура

Матрица 4×5, клавиша (строка, колонка) = **SW{строка·4 + колонка + 1}**:

| | col 0 | col 1 | col 2 | col 3 |
|---|---|---|---|---|
| **row 0** | A (SW1)  | B (SW2) | C (SW3) | D (SW4) |
| **row 1** | 7 (SW5)  | 8 (SW6) | 9 (SW7) | E (SW8) |
| **row 2** | 4 (SW9)  | 5 (SW10) | 6 (SW11) | F (SW12) |
| **row 3** | 1 (SW13) | 2 (SW14) | 3 (SW15) | Enter (SW16) |
| **row 4** | 0 (SW17) | F1 (SW18) | F2 (SW19)  | — (SW20 = RESET) |

- Каждое принятое нажатие подтверждается коротким бипом (~32 мс, тон
  около 500 Гц); индикатор при этом не гаснет.
- Автоповтора нет: удержание вводит клавишу один раз. Отпустите и нажмите
  снова.
- После отпускания монитор ~30 мс ждёт (дебаунс) — следующее нажатие
  считывается сразу после этого.
- F1 — системная клавиша: из любого режима возвращает в меню «ACdE».
- F2 — показывает текущий адрес операций ADDR (куда уйдёт запись C, чтение
  D, пуск E) на всех 4 разрядах: работает в любом режиме, повторное F2
  возвращает прежний экран (см. §7).
- Клавиши A, B, C, D, E, F — это одновременно шестнадцатеричные тетрады:
  в меню они выбирают режимы, в режимах адреса и кода вводят цифры A–F.

## 2. Режимы: сводка

| Клавиша | Режим | Индикатор | Enter | Выход |
|---|---|---|---|---|
| **A** (0__0) | ввод адреса | вводимые тетрады, сдвиг вправо | запомнить адрес, в меню | F1 |
| **C** (0__2) | ввод кода | «__XY» — вводимый байт | записать в [ADDR], ADDR++ | F1 |
| **D** (0__3) | просмотр кода | «__XY» — байт [ADDR] | ADDR++, показать следующий | F1 |
| **E** (1__3) | пуск | (дисплей гаснет) | — | RET или RESET |
| **F2** (4__2) | показ адреса операций | «8012» — текущий ADDR | игнорируется | F2 — назад, F1 — меню |

В меню все прочие клавиши (0–9, B, F, Enter) игнорируются. В режимах
A и C клавиши 0–F — обычные тетрады.

## 3. Меню «ACdE»

Меню — «домашнее» состояние монитора. Сюда ведут клавиша F1, завершение
ввода адреса и возврат из пользовательской программы. Нажатие A, C, D или E
переключает в соответствующий режим (с бипом-подтверждением). Текущий адрес
(ADDR) хранится всегда: после сброса он равен **8000h**, после работы с
программами — тот, на котором вы остановились.

## 4. Режим A — ввод адреса

Тетрады вдвигаются справа, как на калькуляторе, старшие пустые позиции
погашены:

```
A, 8        → «___8»
0           → «__80»
0           → «_800»
0           → «8000»   Enter
```

- **Enter** запоминает адрес и возвращает в меню (пустое поле — игнор).
- Пятая тетрада вытесняет старшую: набрали «12345» — адрес станет 2345h.
- Совет: **вводите все 4 тетрады.** Старшие тетрады при неполном вводе
  не обнуляются — в них остаются значения прежнего ввода.
- Адрес действует во всех режимах: C пишет с него, D читает с него,
  E запускает с него.

## 5. Режим C — ввод кода

Байт вводится двумя тетрадами в правых разрядах, слева пусто. Пусть
текущий адрес ADDR = 8000h:

```
C, C, 3     → «__C3»   Enter → C3 записан в [ADDR]=8000h, адрес стал 8001h,
                        поле погасло — можно вводить следующий байт
0, E        → «__0E»   Enter → 0E записан в 8001h, адрес 8002h
F1          → меню
```

- **Enter** пишет байт по текущему адресу и увеличивает адрес на 1 — байты
  программы вводятся подряд, без переприказа адреса.
- Enter при пустом поле игнорируется.
- Перепутали тетраду — просто продолжайте набор: на индикаторе всегда две
  последние введённые тетрады. Но **Enter жмите, только когда на экране
  обе** — при неполном поле старшая тетрада возьмётся из прежнего ввода.
- Запись в ПЗУ (0000h–7FFFh) отбрасывается железом — ничего не испортится;
  адрес при этом всё равно увеличится. Программировать можно только ОЗУ
  (8000h–FFFFh).
- F1 — конец ввода, в меню. Адрес остаётся за концом введённого блока —
  продолжить ввод можно повторным C.

## 6. Режим D — просмотр кода

Показывает байт по текущему адресу (только чтение, тетрады игнорируются):

```
D           → «__C9» — байт [ADDR]
Enter       → ADDR++, показать следующий («__3E», «__FF», …)
F1          → меню
```

- Работает и по ОЗУ, и по ПЗУ — так можно разглядывать прошивку монитора
  (пример 3 ниже).
- После FFFF адрес заворачивается на 0000h.

## 7. Клавиша F2 — показать адрес операций

F2 выводит на все 4 разряда текущий адрес ADDR — тот, по которому
монитор ведёт запись (C), просмотр (D) и пуск (E):

```
C, C, 3, Enter   → «____»   (записали байт, адрес стал 8001h)
C, A             → «__CA»   (набираем следующий байт — пока не записан)
F2               → «8001»   — вот куда уйдёт CA при Enter
F2               → «__CA»   — назад: прежний экран, поле цело
Enter            → «____»   — CA записан в 8001h, адрес стал 8002h
```

- Работает из **любого** режима, включая меню (после загрузки покажет
  8000h) — адрес хранится всегда.
- Удобно **подглядывать адрес, не отрываясь от набора**: F2 — адрес,
  F2 — назад, поле ввода цело. Так проверяют, куда уйдёт запись, ещё
  до Enter.
- **Повторное F2** возвращает прежний экран: поле ввода кода/адреса
  и просмотр байта сохраняются, набор можно продолжать как ни в чём
  не бывало.
- **Enter и тетрады в режиме показа игнорируются** — адрес случайно
  не сдвинуть и не испортить. F1 — в меню, как обычно.
- Смена экрана подтверждается бипом, как у всех клавиш.

## 8. Режим E — пуск

Запускает программу с текущего адреса:

- индикатор гаснет, звук выключается, прерывания запрещаются (DI);
- регистры A, B, C, D, E, H, L обнуляются;
- SP = FFE8h, и монитор кладёт в стек адрес возврата — указатель становится
  FFE6h (FFE8h − 2), стек программы растёт вниз от этой точки;
- управление передаётся программе по адресу ADDR. Клавиатура с этого момента
  монитором не опрашивается.

**Возврат в монитор — команда RET (C9).** Программа должна закончиться байтом
C9: монитор вернёт управление, дождётся отпускания клавиш, сам погасит звук и
индикатор и покажет меню «ACdE». Адрес сохраняется (это конец программы) —
удобно для повторного пуска после правки.

Если программа зациклилась или повисла — **RESET (SW20)**: монитор перезапустится,
адрес снова 8000h. Не заканчивайте программу командой HLT: прерывания
запрещены, и процессор остановится до сброса.

## 9. Память

| Диапазон | Что там | Можно |
|---|---|---|
| `0000h–7FFFh` | ПЗУ (flash): монитор fw_mon | только читать (C/D; запись отбрасывается) |
| `8000h–FFE7h` | ОЗУ: ваши программы, данные и стек | читать и писать |
| `FFE8h–FFF9h` | служебные переменные монитора (ниже) | не занимать под свои данные |
| `8000h` | стартовый адрес по умолчанию | — |

Служебные переменные монитора (для любопытных, менять из своей программы не нужно):

| Адрес | Имя | Смысл |
|---|---|---|
| FFE8h | SNDST | фаза тона (0/1) |
| FFE9h | STATE | режим: 0 меню, 1 адрес, 2 код, 3 просмотр, 4 показ адреса (F2) |
| FFEAh–FFEBh | ADDRH/L | текущий адрес ADDR |
| FFECh | ADCNT | сколько тетрад адреса введено (0–4) |
| FFEDh–FFF0h | AF3…AF0 | тетрады адреса |
| FFF1h | BDCNT | сколько тетрад байта введено (0–2) |
| FFF2h–FFF3h | BF1/BF0 | тетрады байта |
| FFF4h | DPIDX | фаза регенерации индикатора (0–3) |
| FFF5h–FFF8h | DIGIMG0…3 | глифы разрядов DIG0…DIG3 |
| FFF9h | PREVST | прежний режим для F2 (показ адреса) |

Работа с портами (индикатор, звук, клавиатура) описана в
`PORTS_MAP.md` и в инструкции по программированию
(`manuals/retro_pcld_programming_manual.md`).

---

## 10. Пример 1. Полный цикл: ввести → проверить → запустить

Простейшая «программа» из одного байта — RET (C9). Проверяет весь конвейер:
ввод, просмотр и возврат из пользовательской программы.

| Шаг | Клавиши | Индикатор | Что произошло |
|---|---|---|---|
| 0 | RESET | «ACdE» | меню; адрес по умолчанию 8000h |
| 1 | `C` | «____» | режим ввода кода, поле пустое |
| 2 | `C` `9` | «__C9» | набран байт C9 |
| 3 | `Enter` | «____» | C9 записан в 8000h, адрес стал 8001h, поле погасло |
| 3а | `F2` | «8001» | показ адреса операций: следующий байт уйдёт в 8001h |
| 3б | `F2` | «____» | назад в режим кода — прежний экран |
| 4 | `F1` | «ACdE» | в меню |
| 5 | `A` `8` `0` `0` `0` | «8000» | набираем адрес заново |
| 6 | `Enter` | «ACdE» | адрес 8000h, в меню |
| 7 | `D` | «__C9» | просмотр: байт по адресу 8000h = C9 — записался! |
| 8 | `F1` | «ACdE» | в меню (адрес остался 8000h — в D Enter не жал) |
| 9 | `E` | погас | пуск с 8000h: C9 = RET → мгновенный возврат |
| 10 | — | «ACdE» | мы снова в мониторе |

Если на шаге 9 экран мигнул и меню вернулось — плата, ввод и контракт
«RET = выход в монитор» работают.

## 11. Пример 2. Бип ~0,2 с и «8.» на индикаторе

Небольшая настоящая программа: зажигает все разряды («8.»), затем 100 раз
повторяет период тона — ~1 мс SND=1 и ~1 мс SND=0 — получается
ровный тон ~490 Гц длительностью ~204 мс, затем программа гасит всё и
возвращается в монитор через RET. Программа занимает 42 байта: 8000h–8029h.

| Адрес | Байты | Команда | Комментарий |
|---|---|---|---|
| 8000 | `3E FF` | MVI A,0FFh | все сегменты a–g и dp |
| 8002 | `D3 00` | OUT 00h | на индикаторе «8.» |
| 8004 | `3E 0F` | MVI A,0Fh | все 4 разряда, SND=0 |
| 8006 | `D3 01` | OUT 01h | разряды горят |
| 8008 | `06 64` | MVI B,64h | B = 100 периодов тона |
| 800A | `3E 1F` | MVI A,1Fh | SND=1, разряды не тронуты |
| 800C | `D3 01` | OUT 01h | звук включён |
| 800E | `CD 20 80` | CALL 8020h | пауза ~1 мс (подпрограмма DLY) |
| 8011 | `3E 0F` | MVI A,0Fh | SND=0 |
| 8013 | `D3 01` | OUT 01h | звук выключен |
| 8015 | `CD 20 80` | CALL 8020h | пауза ~1 мс |
| 8018 | `05` | DCR B | период минус |
| 8019 | `C2 0A 80` | JNZ 800Ah | следующий период |
| 801C | `AF` | XRA A | A = 0 |
| 801D | `D3 01` | OUT 01h | тишина, разряды погашены |
| 801F | `C9` | RET | возврат в меню «ACdE» |
| 8020 | `11 95 00` | LXI D,0095h | DLY: счётчик ~1 мс |
| 8023 | `1B` | DCX D | DLY1: |
| 8024 | `7A` | MOV A,D | |
| 8025 | `B3` | ORA E | |
| 8026 | `C2 23 80` | JNZ 8023h | крутиться, пока DE ≠ 0 |
| 8029 | `C9` | RET | выход из DLY |

Тайминги при T = 280 нс (CPU 3,571 МГц): подпрограмма DLY — 3593 T
(1006 мкс); полупериоды тона — 3637/3651 T (1018/1022 мкс), период —
7288 T (2041 мкс), тон 490 Гц; 100 периодов ≈ 204 мс.

**Как ввести.** Наберите адрес и включите режим кода: `A` `8` `0` `0` `0`
`Enter` `C`. Дальше вводите байты по порядку из столбца «Байты»: два
шестнадцатеричных знака и `Enter` на каждый байт (⏎ = Enter). Адрес двигается
сам. В конце — `F1`:

```
3E⏎FF⏎D3⏎00⏎3E⏎0F⏎D3⏎01⏎06⏎64⏎3E⏎1F⏎D3⏎01⏎CD⏎20⏎80⏎
3E⏎0F⏎D3⏎01⏎CD⏎20⏎80⏎05⏎C2⏎0A⏎80⏎AF⏎D3⏎01⏎C9⏎
11⏎95⏎00⏎1B⏎7A⏎B3⏎C2⏎23⏎80⏎C9⏎ F1
```

После ввода адрес стал 802Ah. Верните его на начало и запустите:
`A` `8` `0` `0` `0` `Enter`, затем `E`.

**Что вы увидите:** индикатор вспыхнет «8. 8. 8. 8.», прозвучит ровный тон
~490 Гц примерно 0,2 с, затем дисплей погаснет и через мгновение вернётся
меню «ACdE». Длительность задаёт счётчик периодов — операнд команды
MVI B (байт по адресу 8009): например, C8h даст ~0,41 с, 32h — ~0,10 с.
Тон при этом не меняется (~490 Гц).

Для сравнения — тот же пример в ассемблере (собран и сверен ассемблером
проекта asm85.py, байты в таблице выше):

```asm
        ORG 8000h
START:  MVI  A,0FFh    ; все сегменты
        OUT  00h       ; «8.» на индикаторе
        MVI  A,0Fh     ; все 4 разряда, SND=0
        OUT  01h
        MVI  B,64h     ; 100 периодов тона
LOOP:   MVI  A,1Fh     ; SND=1
        OUT  01h
        CALL DLY       ; ~1 мс
        MVI  A,0Fh     ; SND=0
        OUT  01h
        CALL DLY       ; ~1 мс
        DCR  B
        JNZ  LOOP
        XRA  A         ; тишина, гашение
        OUT  01h
        RET            ; возврат в монитор
DLY:    LXI  D,0095h   ; ~1 мс при 3,571 МГц
DLY1:   DCX  D
        MOV  A,D
        ORA  E
        JNZ  DLY1
        RET
```

## 12. Пример 3. Заглянуть в ПЗУ

Режим D читает и ПЗУ — посмотрим первые байты самого монитора:

```
A, 0, 0, 0, 0  → «0000»   Enter
D              → «__C3»   — код команды JMP
Enter          → «__D3»   — младший байт адреса
Enter          → «__01»   — старший байт адреса
```

Итого C3 D3 01 = **JMP 01D3h** — монитор начинается с перехода на своё
тело (метка MAIN). Так можно читать любую область ПЗУ; записать туда,
напомню, нельзя — железо отбрасывает запись.

## 13. Заметки и частые вопросы

- **«Записал байт в ПЗУ — ничего не изменилось».** Так и задумано: запись
  при A15 = 0 отбрасывается аппаратно. Программируйте ОЗУ (8000h и выше).
- **«Нажал HLT — плата умерла».** Монитор запрещает прерывания, поэтому
  HLT останавливает процессор до RESET. Завершайте программу RET (C9).
- **«После F2 на индикаторе адрес — что дальше».** Это показ текущего
  адреса операций: повторное F2 возвращает прежний экран (поле ввода
  и просмотр целы), F1 — в меню; Enter и тетрады в показе игнорируются.
- **«Держу клавишу — а она вводится один раз».** Автоповтора нет: отпустите
  и нажмите ещё раз.
- **«Ввёл две тетрады адреса, а адрес получился странный».** Вводите всегда
  4 тетрады адреса и 2 тетрады байта — старшие тетрады при неполном вводе
  не обнуляются.
- **«Программа зависла».** RESET (SW20): монитор перезапустится, адрес
  вернётся к 8000h.
- **«Часть кнопок не реагирует».** Проверьте распайку матрицы: цепи колонок
  замыкаются через нераспаянные кнопки (см. `beta/lowsize/README.md`,
  приёмка железа 10-30).
- Поведение монитора подтверждено верификатором `verify_mon.py`
  (54/54 проверок: сценарии всех режимов, F2 — показ адреса из всех
  режимов и возврат, блэнкинг, тик, карта клавиш) и **работой на плате**
  (Изд. 2, ноябрь 2026: меню, ввод кода, просмотр, пуск, F1/F2).
