digitalinvitro/CPLD-plus-8085/beta/DEVLOG.md

# beta/DEVLOG.md — дневник разработки

Исторические комментарии RTL (шапки версий, нестарты, разборы фитов,
переговоры, прогнозы) выносятся сюда **дословно** — в файлах дизайнов
остаются только действующие решения и правила приёмки фита. Свежие записи —
сверху; архив перенесённых текстов — ниже, с указанием исходного файла.
Директива владельца 11-7: «много исторического мусора в комментариях…
вынести в дневник разработки в корне beta… оставить только те комментарии,
которые представляют настоящие решения в аппаратуре».

---

## 2026-11-13-3 — XSTREAM v1.2.2: ЧЕТВЁРТЫЙ ЖЕЛЕЗНЫЙ ОТЧЁТ ВЛАДЕЛЬЦА — ПЕРВЫЙ ЖИВОЙ СЕАНС С -Log ПРОШЁЛ ЧИСТО (117.9 с, 2412 кадров, 4 838 677 Б, РЕСИНКОВ 0), РАБОЧАЯ ТОЧКА ПОДТВЕРЖДЕНА ЛОГОМ (медиана dt 49.1 мс = 20.4 FPS против сим-прогноза 20.1 / 49.8 мс, нагрузка ≈49% ≤ 50% ТЗ) + ДВА ДЕФЕКТА КЛИЕНТА ИЗ ЛОГА: №5 «ФАНТОМНАЯ 8-Я КОЛОНКА CSV» (УРОК 12: -f/ToString() БЕРУТ КУЛЬТУРУ ПОТОКА — ru-RU F1 ДАЁТ "17,1", ЗАПЯТАЯ-CSV РАСЩЕПЛЯЕТ ПОЛЕ) И ЛОЖНЫЕ «ГЭПЫ» ОТ РЕСТАРТА ПОТОКА ПЛАТЫ (УРОК 13). Отчёт владельца 11-13: «Вижу экран, лог прилагаю. Итог: кадров 2412, FPS 21,39, SEQ-гэпов 113, ресинков 0, байт 4838677» — фикс v1.2.1 подтверждён: FormatError строки 63 больше не стреляет, лог пишется с первой записи OPEN до FIN. ФОРЕНЗИКА xlog.csv (анализатор beta/xstream/scripts/xlog_analyze.py): (а) шапка 7 колонок, ВСЕ 2516 строк несут 8 полей, 5-е поле — всегда одна цифра 0-9: это дробный разряд dt — {3:F1} в Write-Log форматируется оператором -f, который берёт КУЛЬТУРУ ПОТОКА, на ru-RU Windows F1 печатает «17,1», и запятая-разделитель дробной части расщепляет поле в запятой-CSV на «17» и «1» (данные не терялись — анализатор склеивает обратно — но CSV был невалидным; урок 12: в машиночитаемые форматы только InvariantCulture и конкатенация, -f для CSV не использовать вовсе, культурные форматы — только в человеческий вывод); (б) 113 «гэпов» = 110 + 3: один эпизод 14:37:18 — пауза 462.4 мс, SEQ 145 → 0 — плата ПЕРЕЗАПУСТИЛА поток (счётчик SEQ обнулился, кадры не терялись), остальные 3 — честные пропуски по 1 кадру (SEQ n→n+2 при dt 86-99 мс: плата промедлила один период — 3 за 110 с, безвредно; урок 13: скачок SEQ после паузы > 250 мс ≈ 5 периодов = рестарт, не гэп); (в) обёртки 255→0 (10 шт) не считаются гэпами — корректно; (г) байтовая смета сходится: 2412×2003 = 4 831 236 + 7441 Б мусора/недокадров (0.15%, стык: клиент стартовал посреди кадра платы) = 4 838 677; (д) рабочая точка: медиана dt 49.1 мс = 20.4 FPS (сим 49.8 мс = 20.1 FPS — сходимость 1.4%, урок 15 в силе), средний за сеанс 20.46 FPS (окно ТЗ 20-25 ✓), «EMA 21.4» в статусе — артефакт сглаживания, перекошенного в быстрые кадры (dt p10-p90 = 37.6-58.6 мс), по медиане нагрузка ≈ 49% ≤ 50%; скорость линии 40.1 КБ/с = 40% от потолка 100 КБ/с — как рассчитано. ФИКС v1.2.2: (1) Write-Log — dt и штамп времени ЯВНО через InvariantCulture, строка собирается конкатенацией ($ts + "," + ... + $dt.ToString("F1", $inv)) — ни -f, ни культурных сюрпризов; (2) правило рестарта в Add-Bytes: dt > 250 мс И d≠1 → Restarts++ + строка kind "R" в CSV, SeqGaps не растёт (на живом логе даёт гэпов 3, рестартов 1 вместо пугающих 113); (3) статус-строка: +рестарт, «ресинк N Б» → «ресинков N» (Resyncs — счётчик, не байты); «Итог»: +рестартов; (4) SelfTest 6/6 → 7/7 (кейс 3b: пауза 1 с + скачок SEQ 5→200 = рестарт=1, гэпов 0; заодно опечатка «SELfTEST» → «SELFTEST»). Проверка: pwsh в песочнице нет — зеркальный прогон векторов в Python (scripts/test_xstream_view_parser.py, семантика Add-Bytes 1:1): v1.2.2 — 7/7, правило рестарта доказано в обе стороны (dt 0.1 мс при SEQ 5→200 = гэп 194, dt 1000 мс = рестарт). Файлы: beta/xstream/{xstream_view.ps1 v1.2.2 (BOM на месте), README.md (§статус/§2/§6 CSV+R-строки/§8 уроки 12-13), scripts/xlog_analyze.py (новый: оба формата CSV — v1.2.1 с авто-склейкой расщеплённого dt и v1.2.2 с R-строками; воспроизвёл все цифры живого лога)}, копия download/xstream. Прошивка НЕ ТРОНУТА (md5 4175b2e8/e5ed908c в силе, перешивать не надо). ВЛАДЕЛЬЦУ: перезалить xstream_view.ps1 (v1.2.2) — CSV станет валидным 7-колоночным, «SEQ-гэпов» перестанет пугать от рестартов платы.

## 2026-11-13-2 — XSTREAM v1.2 ПОДТВЕРЖДЁН ЖЕЛЕЗОМ (SelfTest у владельца: ресинк мусора OK, A5-набег OK; «Дисплей работает замечательно» — урок 9 закрыт) + ЛАТЕНТНЫЙ ФОРМАТНЫЙ ДЕФЕКТ КЛИЕНТА №4: FormatException В Write-Log ПРИ -Log — УРОК 11: «-f <список>» В СКОБКАХ МЕТОД-ВЫЗОВА РЕЖЕТСЯ ЗАПЯТЫМИ. Отчёт владельца 11-13: (1) SelfTest v1.2 на его машине — ВСЕ проверки OK, включая бывший FAIL v1.1: «мусор 137 Б (A5 + не-5A) -> ресинк=1, кадр принят без потерь» и кейс 2b «мусор ...A5 перед шапкой -> кадр выровнен (SEQ=7, scr0=87)»; (2) НОВАЯ ОШИБКА только с -Log: «Ошибка при форматировании строки: Индекс (отсчитываемый от нуля) должен быть больше или равен нулю, но меньше размера списка аргументов» на строке 63 (Write-Log). ПРИЧИНА: «-f <список>» стоял ПРЯМО в скобках метод-вызова: $script:LogSw.WriteLine("{0:...},{6}" -f UtcNow, $kind, $seq, $dt, $total, $rs, $gaps) — PowerShell делит аргументы МЕТОДА по запятым ВЕРХНЕГО уровня, поэтому парсер видит WriteLine(("{0:...}" -f UtcNow), $kind, ...) → оператор -f получает 1 аргумент при 7 подстановках {0}..{6} → string.Format кидает FormatException при вычислении ПЕРВОГО аргумента метода → с EAP=Stop скрипт умирает на самой первой записи OPEN, окно не открывается. Почему не ловили раньше: без -Log Write-Log вообще не вызывался (SelfTest и прежние GUI-прогоны молчали), а статус-строка ($status.Text = (... -f ...)) и Write-Host((... -f ...)) всегда работали — там -f стоит в СВОИХ скобках присваивания/группировки, список = массив; в gfx_view v1.5 то же место обёрнуто двойными скобками .Add((("…") -f …)) — потому капкан там не стрелял. ДИАГНОСТИКА ПО ОТЧЁТУ БЕЗ КОДА: подчёркнут весь WriteLine(...) = исключение при вычислении аргумента метода, а не на уровне оператора -f. ФИКС v1.2.1: формат собирается в переменную ($line = "fmt" -f ... на уровне оператора — список из 7 элементов = массив), затем WriteLine($line) — WriteLine(string), composite-formatting не участвует вовсе. Косметика SelfTest заодно: счётчик 5/5 → 6/6 (кейс 2b добавили в v1.2, счётчик не обновили — у владельца 6 строк OK при «5/5 ПРОЙДЕНЫ») и OK payload не печатается после FAIL (печать была вне if). Файлы: beta/xstream/xstream_view.ps1 v1.2.1 (BOM на месте, проверено), копия download/xstream; README §статус/§2/§6/§8 (+урок 11). Прошивка НЕ ТРОНУТА (md5 4175b2e8/e5ed908c в силе, перешивать не надо). ВЛАДЕЛЬЦУ: перезалить xstream_view.ps1 (v1.2.1) — сеанс с -Log снова безопасен.

## 2026-11-13-1 — XSTREAM v1.2: ВТОРОЙ ЖЕЛЕЗНЫЙ ОТЧЁТ ВЛАДЕЛЬЦА — ТРИ ДЕФЕКТА НАЙДЕНЫ И ИСПРАВЛЕНЫ (SelfTest FAIL rs=0, GUI-пад на кистях, «ДРОЖАНИЕ» ДИСПЛЕЯ ПЛАТЫ = КОРЕНЬ В ПРОШИВКЕ) + ЛАТЕНТНЫЙ RX-ДЕФЕКТ КЛИЕНТА СНЯТ АУДИТОМ. Доклад владельца 11-13: (1) «powershell -File xstream_view.ps1 -SelfTest … FAIL: ресинк мусора (frames=1, rs=0)» — ПРИЧИНА ТРИВИАЛЬНА И ПОУЧИТЕЛЬНА: в v1.1 тест №2 СОЗДАВАЛ $garb (137 Б, A5+не-5A — детерминизм по уроку 8), но ЗАБЫЛ ЕГО ПОДАТЬ: пропущен Add-Bytes $p $garb → rs=0 всегда, «фикс детерминизма» фикс не доложил подачу; урок: SelfTest обязан не только СТРОИТЬ тестовые данные, но и ПОДАВАТЬ их в тестируемый код; (2) GUI падал при старте окна: «Не удается найти перегрузку для "new" и количества аргументов: "1"» на [System.Drawing.Brush]::new([SolidBrush](цвет)) — Brush АБСТРАКТНЫЙ, конструктора с 1 аргументом нет (и SolidBrush не аргумент Brush) → SolidBrush::new(цвет); продолжение урока 7 (5.1-квайны GUI); (3) «Дисплей сейчас в норме, только частота обновления снижена, видно дрожание» — НАСТОЯЩИЙ КОРЕНЬ В ПРОШИВКЕ, УРОК 9: XDIG v1.1 брала бит разряда из C («свободен вне inner»), НО к вызову C=0 — его съедал счётчик подгруппы MVI C,25, И LDA SNDST затирал бит в A → OUT DIGP = SNDST (0/1): при 0 дисплей ГАС на ВСЮ посылку 24 мс (10 слотов × 2.35 мс), при 1 все 4 глифа циклом на DIG0 → 20 Гц мигание = «дрожание»; «частота обновления снижена» = дисплей реально работал только в паузе между кадрами (26 мс из 50). При этом предыдущий фикс «глифов-призраков» (урок 6) был честный: LDAX D теперь читает DIGIMG, но ПОЛУЧАТЕЛЬ (разряд) так и не выбирался — класс «фикс материала без фикса адресата». СИМ ДОБИЛ ДИСПЛЕЙНУЮ МОДЕЛЬ ДО «ГЛИФ ⇔ РАЗРЯД»: чужие глифы + ровно один выбранный разряд + глиф == DIGIMG[разряд]; на v1.1 модель воспроизводит 230 гашений посылки 1-в-1 с жалобой (23 кадра × 10 слотов), на v1.2 — 0. ФИКС v1.2: XDIG САМОДОСТАТОЧНА — бит вычисляется из фазы глифа E (idx=(E+3)&3, 01h RLC idx раз) и переживает LDA SNDST в C (как в REFRESH — там бит живёт в B); ВАЖНО: недо-фикс rc1 (бит вычислили, но LDA SNDST опять затёр) был пойман ТРАССОЙ ПОРТОВ сима до коммита — OUT DIGP=00 — что само по себе урок: трасса портов дешевле разбора железного лога. Сим по реальному hex: SW и HW «ВСЁ ОК» (0 отбросов, мин. гэп 33T, период 49.86/50.09 мс = 20.06/19.97 FPS, нагрузка 48.6/48.3%, посылка 24.21 мс, выбор разряда при глифе: гас/мульти/не тот = 0/0/0). (4) Аудит клиента нашёл ЛАТЕНТНЫЙ дефект, который всплыл бы СРАЗУ ПОСЛЕ фикса кистей: Register-ObjectEvent -Action НЕ ВИДИТ $script:-переменные — Action выполняется в скопе PSEventJob-модуля, там $script:RxQueue = $null, Enqueue падал в ПУСТОЙ catch{} → 0 кадров при живом потоке (DataReceived-схема из v1.0 была мертворожденной); чтение порта перенесено в GUI-таймер (опрос BytesToRead→Read на UI-потоке, буфер драйвера 256 КБ ≈ 2.6 с потока — паузы таймера байтов не теряют; заодно умер по-байтный Enqueue-цикл 100k/с). УРОК 10: в PS событийные -Action-блоки — отдельный скоп; состояние передавать -MessageData/$Event.MessageData или не использовать вовсе. Плюс фикс ПАРСЕРА: в state 1 держим ТОЛЬКО последний A5 (v1.1 копила A5-набег в Buf: мусор, кончающийся A5, перед шапкой давал SEQ=5A и экран со сдвигом на 1 Б — воспроизведено зеркалом парсера, seq=90/scr0=07). SelfTest v1.2 = 5/5 (добавлен кейс 2b A5-набега; зеркальный прогон векторов в Python: v1.2 — 5/5, v1.1-семантика — FAIL на 2b — направление проверки доказано в обе стороны). Файлы: beta/xstream/{xstream_v1{,_utf8}.asm, xstream_v1.hex (1829 Б, md5 4175b2e8), xstream_v1_hw.hex (1854 Б, md5 e5ed908c), xstream_view.ps1 v1.2 (BOM на месте), scripts/sim_xstream_v1.py (+модель глиф⇔разряд, +--hw в main)}, копии в download/xstream. ВЛАДЕЛЬЦУ: перезалить xstream_view.ps1 (v1.2), ПЕРЕШИТЬ xstream_v1.hex (4175b2e8) — дисплей платы во время выдачи кадра теперь реально регенерируется (~106 Гц, заполнение 25% как в паузе — яркость не скачет), «дрожание» уйдёт; клиент: SelfTest 5/5, окно стартует, кадры пошли.

## 2026-11-12-1 — v2.2 (КАЛИБРОВКА ПЕРИОДА ПЛАТЫ) + ВЬЮЕР v1.5 (КРАСКА БЕЗ СЕТКИ WM_TIMER). Владелец по живому логу v2.1 (gfx_log.csv: 2606 кадров / 120,5 с): «ничего не меняется… ошибка в клиенте на повершелл, он не может обработать такой поток, мячик двигается не плавно и скачет по полю». ФОРЕНЗИКА ЛОГА (новый инструмент scripts/gfx_log_analyze.py, различает схемы CSV v1.4/v1.5): провод ЦЕЛ — 0 разрывов SEQ mod 256 на 2606 кадров (потерь байт/кадров НЕТ), сцены совпадают с v2.1 (T02x~97-99+кейфреймы / T01x241 дитер / T02x419 строка). РЕАЛЬНЫЙ ПЕРИОД ПЛАТЫ по 10 обёрткам SEQ: 46,3481 мс ± 0,0023 (SEM), а НЕ 46,875 — плата идёт −1,124% (реальный такт 0,3164 мкс при номинале 0,3200). СЛЕДСТВИЕ: фаза кадра СКОЛЬЗИТ по сетке WM_TIMER 15,625 мс (|P − 3×тик| = 0,527 мс): гистограмма dt размазана — 62% на 3 тиках, 12,2% на 2, 13,2% на 4, 10,2% в зоне гейта; модель гейта v1.4 (тик 15,625 + порог 36 мс) на этом периоде даёт 3,37% структурных пропусков краски (шар прыгает на 2 шага раз в ~1,4 с) + постоянную модуляцию каденса 31/47/62 мс («не плавно»); плюс стартовый бэклог 10 461 Б (5 кадров декодировались пачками dt 2-3 мс = teleport при старте), пачек dt<16 всего 15 (0,58%, остаток = USB-батчинг CH340, всплески buf до 3372/8024). ВАЖНО: сим (побайтово верный) ВРЕЗАЛСЯ В ТАКТ — сим считал такты по таблице 8085, реальный силикон исполняет эту СМЕСЬ инструкций на −1,124%; пад-петля DCX/MOV A,ORA C/JNZ = 24T и на 8080A (5+5+4+10) и на 8085 (6+4+4+10) — НЕЙТРАЛЬНА, поэтому коррекция = ДОБАВКА ПАДА: +1644T = W_V2 2194→2262 (+1632T) + 3 NOP в хвосте WTAIL (+12T); РЕАЛЬНЫЙ период = 146 484T = 46,874 мс = РОВНО 3 ТИКА (остаток −2T = 0,6 мкс/кадр = соскальзывание тика раз в ~12 мин — глотается буфером); в СИМЕ период 148 128T = 47,401 мс (сим-T ≠ реальному — задокументировано в sim). TXSTRESS НЕ ТРОНУТ: его 69 770 Б/с подтверждён при номинальном такте — такт ПЛАТЫ номинален, расхождение живёт в СМЕСИ инструкций (сим vs силикон); точный корень (H1-кварц vs таблица интерпретатора) — отдельный эксперимент, не блокер (закрывается замером сплошного потока: B/s на линии = точный бод = точный такт). УРОК 14 (вьюер): КРАСКА НЕ ДОЛЖНА ЖИТЬ НА СЕТКЕ WM_TIMER — при скользящей фазе провода любой гейт рано или поздно отрезает кадр структурно; каденс краски = каденс ПРОВОДА (краска синхронно в тике декода), гейт уместен только когда краска дорога. УРОК 15 (сим/плата): СИМ-ТАКТЫ ≠ РЕАЛЬНЫМ — абсолютный период на железе сверяется ТОЛЬКО по живому логу (обёртки SEQ, ±0,02%), калибровка пада по измеренному коэффициенту; побайтовая верность сима не гарантирует его тайминг. ФИКСЫ ВЬЮЕРА v1.5 (gfx_view.ps1, разоморожен владельцем — «добавь в скрипт еще диагностику»): (1) таймер 15→2 мс + timeBeginPeriod(1) через P/Invoke winmm — тик реально ~2 мс; ГЕЙТ 36 МС УДАЛЁН — краска СРАЗУ в тике декода: интервал краски = интервал провода ± 2 мс, ни одна позиция не теряется (2+ кадров в одном тике = «пропуск», счётчик); (2) бэклог > 3000 Б (старт окна, батчинг CH340) сбрасывается целиком (DiscardInBuffer + ресинк парсера) — вместо прокрутки устаревших кадров teleport-ом экран ждёт свежий кадр, счётчик «флеш»; (3) CSV v1.5: колонка kind — D=декод (как раньше), P=краска (seq покрашенного, dt краски, пропуски этой краски), F=флеш (сброшено Б); старые логи совместимы, анализатор различает по шапке; (4) статус: краска ср/макс мс + пропуск + флеш; сводка при закрытии окна (кадры/краски/пропуски/флеши/разрывы/ресинк). КРИТЕРИИ ПРИЁМКИ v2.2+v1.5 (по новому логу): обёртки SEQ = 12,000 с ± 0,3%; интервал краски ~47±3 мс ровно (разброс p90-p10 ≤ 6 мс); пропуски краски 0; разрывы SEQ 0; флеши — только старт (≤2). СИМ v2.2: 940 кадров ВСЁ ОК (побайтово, пути 148 128T ±54T, ENTR ≤167 610T ≤169 128T, баннер «GFXSTREAM v2.2»). Файлы: gfxstream_v22.{asm,hex,bin,lst} (md5 hex 3aacb4d0…), gfx_view.ps1 v1.5 (md5 cb72da29…, BOM на месте, 5.1-совместим: только ::new/никаких тернарников), анализатор scripts/gfx_log_analyze.py. ВЛАДЕЛЬЦУ: прошить gfxstream_v22.hex, взять НОВЫЙ gfx_view.ps1 (v1.5 — диагностика в нём), сеанс с -Log, прислать лог2: анализатор сам выдаст ВЕРДИКТ ПРИЁМКИ по критериям выше. Опция на будущее (если захочется ПЛАВНЕЕ шар): 32 FPS = 2 тика = 100 000T с шагом 1 клетка (256 px/s) — формат вьюера позволяет (FF-добивку можно укоротить), решать отдельно.

## 2026-11-11-8 — v2.1: ПЕРИОД КАДРА = 3 ТИКА ДИСПЛЕЯ. Владелец по живому логу v2 (10 513 кадров ≈ 7 циклов, gfx_log.csv 23:02-23:03): «только тест с косым заполнением клеток проходит плавно, остальные резко меняют позицию объектов». ФОРЕНЗИКА: провод ИДЕАЛЕН ВО ВСЕХ СЦЕНАХ — 25,27 FPS, dt ср 39,6, buf>2006 <1%, дисциплина декода ОДИНАКОВАЯ у дитера и шара (пары dt≤20: 358 у дитера / 345 у строки за ~10k кадров) — провод, декод и краска не виноваты. ДИАГНОЗ: гейт вьюера красит на сетке WM_TIMER 15,625 мс каждые 3 тика = 46,875 мс (порог 36 мс специально лежит между 31,25 и 46,875 — УРОК 8), а провод v2 даёт кадры каждые 40 мс → 40/46,875 → 14,7% кадров декодируется, но НИКОГДА не рисуется → каждый пропуск = скачок дискретного объекта на 2 шага (шар 32 px вместо 16, строка 2 px вместо 1) каждые ~6-7 рисовок; дитер пропуски СКРЫВАЕТ (сплошной узор без объектов) — поэтому «косое заполнение плавно, остальные нет». УРОК 13: ТЕМП ПРОВОДА ДОЛЖЕН БЫТЬ КРАТЕН СЕТКЕ ДИСПЛЕЯ ПК — пропуск кадров глазом неотличим только на непрерывных узорах; на дискретных объектах каждый пропущенный кадр = видимый скачок, и никакой гейт этого не скроет. ФИКС v2.1 (ROM, вьюер не тронут): период кадра 146 484T = 46 875 мкс = РОВНО 3 ТИКА = 21,33 FPS (в исходном ТЗ владельца «20-25 FPS»); фазы краски и декода совпадают навсегда (первая рисовка = первый декод, дальше обе += 3 тика; дрейф провода 0,12 мкс/кадр = 1 тик за ~2 мин — глотается буфером) → 1:1 кадр = рисование, НОЛЬ пропусков, равномерный каденс. Скорости: шар 16 px/46,9 мс (быстрее v1 вдвое по шагу), строка 21 px/s, канал 42,8 КБ/с (43%). СИМ sim_gfxstream_v2.py (параметризован: T_FRAME, баннер): 940 кадров ВСЁ ОК, периоды путей 146 484T ±54T, входы ≤165 966T (53,1 мс — исключение 11-11-7), FPS 21.337. Файлы gfxstream_v21.{asm,hex,bin,lst}, баннер «GFXSTREAM v2.1». ВЛАДЕЛЬЦУ: прошить gfxstream_v21.hex, вьюер тот же — шар и строка должны пойти плавно

## 2026-11-11-7 — GFXSTREAM v2: БЫСТРЫЙ ШАР + ДЕМО ГРАФИЧЕСКИХ ВОЗМОЖНОСТЕЙ. Владелец: «Даешь быстрый шар, и вообще демонстрация графических возможностей». Прошивка rom/gfxstream/gfxstream_v2.{asm,hex,bin,lst} (1 790 Б из 8 КБ), формат провода v1 НЕ ТРОНУТ (вьюер v1.4 заморожен, N=202 везде). ТРИ СЦЕНЫ (цикл 908 кадров = 36,3 с): БЫСТРЫЙ ШАР — 8x7 px, шаг ±2 клетки/±2 строки (вдвое быстрее v1; 7-строчный шар при шаге 2 даёт те же 9-строчные дельты, что 8-строчный при шаге 1 — размер дельты сохранён), отскок flip-recompute; ДИТЕР-ВОЛНА — серая шкала из 1bpp, LUT16, полные кадры 25 FPS; БЕГУЩАЯ СТРОКА — шрифт 8x8, битмап 48 символов, дельты строк 45..53. ВСЕ КАДРЫ — аналитическая генерация прямо в UART (FB упразднён, слитые генерация+посылка ≥32T/Б), период 125 000T падами per-путь + головной пад P_H. СИМ sim_gfxstream_v2.py (исполнение hex + модель сцен): 940 кадров ВСЁ ОК — побайтовая сверка, периоды ±82T, 0 отбросов, мин. межписьмо 32T. УРОК 11: 8085 RLC/RRC — ЭТО РОТАТЫ: бит0 ← собственный старый бит7, ВХОДЯЩИЙ CY ИГНОРИРУЕТСЯ — межбайтовый сдвиг изображения через перенос делается только RAL/RAR (добавлены в asm8085 и сим аддитивно; регрессия: gfxstream_v1.hex пересобран байт-в-байт); RLC-цепочка по байтам = побайтовый ротат = каждая 8-px ячейка крутится на месте — выглядит как «сдвиг» на первом кадре и ломается на втором, глазом не ловится, поймано побайтовой сверкой сима. УРОК 12: модель и прошивка пишутся независимо, сверяются побайтово — сим выловил до железа 7 багов v2: part2 18−c вместо 19−c (строки без шара короче на байт), S_R6 = r+6 вместо r+7 (эксклюзивная граница), потерянный SW=1 в init (первый кадр дельтой, кейфрейм на 99-м), выборка LUT «LXI H,DIT; MOV L,C» рвала адрес при непустом младшем байте (страница кода!), MVI B,0 затирал NEG16 в цикле дитера, XCHG/INX D уничтожали счётчики E/DE в полосе, MKLP перетирал DE-глиф указателем приёмника (битмап собрался из кода ROM). ИСКЛЮЧЕНИЕ ЗАДОКУМЕНТИРОВАНО: кадры входа в сцену — +switch-блок, на входе в строку + копия битмапа 16,9kT (период ≤145 000T = 46,4 мс, ≤1 кадра на цикл, дисплеем поглощается). ВЛАДЕЛЬЦУ: прошить gfxstream_v2.hex, вьюер тот же (-Port COM13), шар быстрый сразу; превью сцен — download/gfxstream_v2_preview.png

## 2026-11-11-6 — РЕШАЮЩИЙ ЛОГ v1.4 У ВЛАДЕЛЬЦА: ПРИЁМКА ШАГА 3 GFXSTREAM v1 ЗАКРЫТА. САМОТЕСТ 12/12, ДЕКОД 260 796 Б ЗА 238 МС (БЮДЖЕТ 5200 — ЗАПАС 22Х; ПРОТИВ 264 МС НА v1.3 — ЭФФЕКТ LUT ВИДЕН ДАЖЕ ОФЛАЙН). ЛОГ 358 КАДРОВ / 15,56 С (LOG_ACCEPT_V14_1111.CSV). ФОРЕНЗИКА: (1) РАЗРЫВОВ SEQ 2 — ОБА СБРОСЫ ПЛАТЫ ВЛАДЕЛЬЦЕМ (DT 887/968 МС, «ЧТОБЫ ШАРИК БЫСТРО БЕГАЛ»), ПОТЕРЬ БАЙТ НЕТ; (2) ЭФИР ПОСЛЕ ОБОИХ СБРОСОВ 25,32/25,41 FPS = 50 797/50 970 Б/С (НОМИНАЛ 25±1, СР DT 39,5 МС — ПЛАТА ЧУТЬ БЫСТРЕЕ РАСЧЁТНЫХ 40 МС, В ДОПУСКЕ); СУММА DT = СТЕНЕ С ТОЧНОСТЬЮ 1 МС (8688/8688) — ИЗМЕРЕНИЯ ЧЕСТНЫЕ; (3) КРИТЕРИЙ ФИКС-5 ВЫПОЛНЕН: ПАР DT≤5 В ПОЛНЫХ ФАЗАХ 0 — ВСЕ 9 КАДРОВ С DT≤5 (SEQ 84-93) УЛОЖЕНЫ В ПЕРВЫЕ 130 МС ХОЛОДНОГО СТАРТА (БУФЕР 11 657 Б НАКОПИЛСЯ, ПОКА СТРОИЛОСЬ ОКНО, ВЫЧИТАН ЗА ~200 МС; ДАЛЬШЕ НИ ОДНОЙ ПАЧКИ); (4) DT-ГИСТОГРАММА (344 КАДРА УСТОЙЧИВОГО РЕЖИМА): 2 ТИКА 38,1%, 3 ТИКА 47,4%, 4 ТИКА 7,8% (МАКС 71 МС — ВСЕ ОДНОКАДРОВЫЕ, БУФЕР В ЭТИ МОМЕНТЫ ≤2006 Б), 5 ТИКОВ 0,3%; СР 39,5 / P95 61; (5) БУФЕР: МАКС УСТОЙЧИВЫЙ 2422 Б (1,2 КАДРА), СРЕДНИЙ 928 Б, КАДРОВ С БУФЕРОМ >2006 — 2 (0,6%) — ЗАДЕРЖЕК КРАСКИ БОЛЬШЕ НЕТ; (6) СИМУЛЯЦИЯ ГЕЙТА 36 МС НА РЕАЛЬНЫХ UTC-МЕТКАХ: 96,9% АКТОВ ОТРИСОВКИ РОВНО 46,9 МС (3 ТИКА), 1,7% — 62,5, 0,7% — 78,1, ОСТАЛЬНОЕ — 2 ОКНА СБРОСОВ: ДИСПЛЕЙ ~21 FPS ЗАПЕРТОЙ РОВНОЙ СЕТКОЙ ВМЕСТО ПОПЕРЕМЕННЫХ 31/47 (УРОК 8) — РЫВКИ УСТРАНЕНЫ СТРУКТУРНО; (7) КЕЙФРЕЙМ ROM ПОДТВЕРЖДЁН ЖЕЛЕЗОМ: 4 ШТ. TYPE 01 НА SEQ%100=99 (ASM СТР. 12 «КАЖДЫЙ 100-Й КАДР — TYPE 01 ВСЕГДА»). УРОК 10: КРАЙНИЕ DT ЧИТАЮТСЯ ТОЛЬКО ПАРОЙ С ТЕЛЕМЕТРИЕЙ БУФЕРА — DT 60-71 ПРИ БУФЕРЕ ≤1 КАДРА ЭТО ДЖИТТЕР ДОСТАВКИ USB, А НЕ ГОЛОД; БУКВАЛЬНЫЙ ПРИЁМОЧНЫЙ КРИТЕРИЙ «МАКС ≤50 МС» БЕЗ БУФЕРА ЛОЖНО ОТПРАВИЛ БЫ В v1.5. СТАТУС: ВЬЮЕР v1.4 ЗАМОРОЖЕН (MD5 E3AB74CA, ОБЕ КОПИИ), ДАЛЬШЕ — ВЕРНУТЬ НА ПЛАТУ ACdE-МОНТОР (README; ROM СЕЙЧАС GFXSTREAM_V1.HEX); УСКОРЕНИЕ ШАРА (ШАГ 2 КЛЕТКИ, ЗАПАС КАНАЛА ~2Х) — ОТДЕЛЬНЫМ ШАГОМ, В ПРИЁМКУ НЕ ВХОДИТ

## 2026-11-11-5 — ВЬЮЕР v1.3 У ВЛАДЕЛЬЦА: САМОТЕСТ 12/12 (ИНФО: ДЕКОД 260 796 Б ЗА 264 МС, БЮДЖЕТ 5200 — ЗАПАС 20Х), ПРИСЛАН CSV-ЛОГ ЖИВОГО СЕАНСА (419 КАДРОВ, -Log). ФОРЕНЗИКА: (1) РАЗРЫВОВ SEQ ВСЕГО 2 — ОБА ЭТО СБРОСЫ ПЛАТЫ, СДЕЛАННЫЕ ВЛАДЕЛЬЦЕМ СПЕЦИАЛЬНО «ЧТОБЫ ШАРИК НАЧАЛ БЫСТРО БЕГАТЬ» (DT 866/952 МС, SEQ -> 0) — ПОТЕРЬ БАЙТ НЕТ ВООБЩЕ; (2) ВСЕ ФАЗЫ ДАЮТ СР. 25,1-25,4 FPS — ПЛАТА/ПРОВОД ПОДТВЕРЖДЕНЫ ЖЕЛЕЗОМ (НЕ ТОЛЬКО СИМОМ); (3) ДЕЛЬТЫ ЧИСТЫЕ (31/47 МС, ПАРЫ ЕДИНИЧНЫ), А ПОЛНЫЕ ФАЗЫ ПОСЛЕ СБРОСОВ — ПАЧКАМИ: 5 И 9 ПАР С DT 0-5 МС (2 КАДРА ЗА ОДИН ТИК) С ПАУЗАМИ 60-82 МС. ДИАГНОЗ: ДОРОГАЯ КРАСКА ПОЛНОГО КАДРА (100 СТРОК = 16 000 ИНТЕРПРЕТИРУЕМЫХ ИТЕРАЦИЙ, ~30-70 МС НА 5.1) ВНУТРИ ОБРАБОТЧИКА ТИКА = В ПОТОКЕ ЧТЕНИЯ ПОРТА; «БЫСТРЫЙ ШАР» ВЛАДЕЛЬЦА = ЭТОТ АРТЕФАКТ (ПРЫЖКИ ПО 2 КЛЕТКИ, СРЕДНЯЯ СКОРОСТЬ ТЕ ЖЕ 25 КЛ/С). УРОК 9: КРАСКА НЕ ДОЛЖНА ЖИТЬ В ПОТОКЕ ЧТЕНИЯ — ДОРОГАЯ ОПЕРАЦИЯ ВНУТРИ ТИКА ВЫГЛЯДИТ КАК ЗАТИШЬЕ ЭФИРА; ВЕРДИКТ «ПРОВОД РОВНЫЙ/НЕ РОВНЫЙ» ПО DT МОЖНО ВЫНОСИТЬ ТОЛЬКО КОГДА КРАСКА ДЕШЕВЛЕ ТИКА. ФИКС v1.4: КРАСКА = LUT БАЙТ -> 32 Б BGRA + [Array]::Copy НА КАЖДЫЙ БАЙТ FB (2000 MEMCPY НА ПОЛНЫЙ КАДР ВМЕСТО 16 000 ИТЕРАЦИЙ), ОДИН LockBits+Marshal.Copy; ПИКСЕЛЬНЫЙ ЦИКЛ И pixS/colDark/colLite УДАЛЕНЫ

- Доклад владельца: самотест целиком (12 OK, САМОТЕСТ ПРОЙДЕН) + gfx_log.csv
  + примечание: «два раза за сеанс я нажал сброс на плате чтобы шарик начал
  быстро бегать» — т.е. сброс использовался как «кнопка ускорения», это
  важно для интерпретации: два разрыва SEQ в логе — НЕ сбои.
- Разбор лога (scripts/ по тем же правилам, категория = стены данных):
  стартовый слив buf 12900 (6,4 кадра накопились за построение GUI ~260 мс,
  вьюер дренировал их пачками dt 2-3 мс — безвредно); дельта-фазы: ср.
  39,4-39,5 мс (= 25,4 FPS), интервалы 31/47 мс, пар почти нет; полные
  фазы после сбросов: ср. 39,7/39,9 мс (= 25,2/25,1 FPS), но 5 и 9 пар
  dt<=5 мс с паузами 60-82 мс — кадры приезжают по два.
- Механика: единственная разница фаз на ПК — СТОИМОСТЬ КРАСКИ (полный кадр
  100 строк против 9 у дельты). Краска выполняется в обработчике тика
  ПОСЛЕ чтения порта — пока она идет (~30-70 мс на 5.1), WM_TIMER
  коалесцируется, порт копит 1-2 кадра; следующий тик вычитывает их разом
  -> пара декодов с dt 0-5. Гейт 36 мс (v1.3) каждую пару пропускает
  (после паузы 60-82 мс гейт всегда открыт) — разрыва замкнутого цикла он
  не дает, только ровный каденс РИСОВАНИЯ при неровном декоде.
- «Быстрый шар» после сброса = пары: шар прыгает по 2 клетки раз в ~80 мс
  (12,5 обновлений/с), средняя скорость та же 25 кл/с — выглядит энергичнее
  и «быстрее». После v1.4 артефакт исчезает: везде честные равномерные
  25 FPS. Если нужен РЕАЛЬНО быстрый шар — правится прошивка (шаг 2
  клетки/кадр; конверт кадра не меняется, но дельта станет 10-11 строк
  вместо 9, N — поле заголовка, парсер уже умеет любой N; канал загружен
  на 50%) — отдельным шагом ПОСЛЕ закрытия приёмки шага 3.
- Фикс v1.4 (обе копии, md5 e3ab74ca): предрасчёт LUT GfxByteBgra[256] по
  32 Б BGRA на байт (цвета запечены: 16/230 + альфа 255, порядок BGRA для
  Format32bppArgb); краска = на ГРЯЗНУЮ строку 20 копий по 32 Б в
  GfxPixBuf (64 000 Б), затем один LockBits + Marshal.Copy + масштаб;
  поток чтения больше не блокируется (полная краска ~2-5 мс вместо
  30-70). Самотест не тронут (LUT — чистая математика до ветки SelfTest).
- Критерии следующего доклада: те же (FPS 25±1, инт 40/≤50, пропуски 0,
  ресинк 16 Б, ~50 150 Б/с) + ПАР В DT<=5 БЫТЬ НЕ ДОЛЖНО И В ПОЛНЫХ ФАЗАХ
  тоже (в логе -Log пара возможна только на старте/ресинке). Приёмка шага
  3: v1.4 → -SelfTest (exit 0) → -Port COM13 -Log gfx_log.csv, ≥60 с.

## 2026-11-11-4 — ВЬЮЕР v1.2 У ВЛАДЕЛЬЦА: «ВСЁ ТАК ЖЕ» — РЫВКИ НА ДЕЛЬТАХ ОСТАЛИСЬ (ГРАНИЦА ~КАДР 75-80). ЦИФРЫ ДОКЛАДА (КАДРЫ 1504, SEQ ~171 РАСТЁТ, ПРОПУСКИ SEQ 1) ДОКАЗЫВАЮТ: ЭФИР ПОСЛЕ СБРОСА ЦЕЛЫЙ — ЕДИНСТВЕННЫЙ «ПРОПУСК» = САМ СБРОС (SEQ ПРЫГУЕТ НА 0), ДАЛЬШЕ ПОТОК БЕЗ ПОТЕРЬ (171 ≡ СЧЁТ КАДРОВ ПОСЛЕ СБРОСА MOD 256: 683 ИЛИ 939). ОСТАЛСЯ КАДЕНС ПАНЕЛИ: WM_TIMER ~15,6 МС, КАДР 40 МС ЗАВЕРШАЕТСЯ НА 2-М/3-М ТИКЕ = ПОПЕРЕМЕННЫЕ 31/47 МС; ПОСЛЕ УДЕШЕВЛЕНИЯ ДЕКОДА (v1.2) НА ДЕЛЬТАХ НИЧТО НЕ ВЫРАВНИВАЕТ ТАКТ — НА ПОЛНЫХ КАДРАХ МЕТРОНОМОМ СЛУЧАЙНО РАБОТАЛА ДОРОГАЯ ПЕРЕРИСОВКА. УРОК 8: «УБРАЛ ПОТОЧЕЧНОСТЬ» ≠ «ВЫРОВНЯЛ КАДЕНС» — ДЕШЁВЫЙ КОД ТОЖЕ ДЁРГАЕТСЯ, ЕСЛИ ТАКТ КВАНТУЕТСЯ ТАЙМЕРОМ; КАДЕНС ОТРИСОВКИ ЗАДАЁТСЯ ЯВНО (ГОРКА/ГЕЙТ), А НЕ СКЛАДЫВАЕТСЯ ИЗ СТОИМОСТИ ОБРАБОТКИ. ФИКС v1.3: ГЕЙТ ОТРИСОВКИ 36 МС (STOPWATCH, ВСЕГДА СВЕЖИЙ FB) + ИНСТРУМЕНТАЦИЯ (ИНТ СР/МАКС МС, БУФ МАКС) + CSV-ЛОГ -Log

- Доклад владельца (v1.2, C:\Users\saa\Downloads\gfx_view.ps1): «Все так же,
  где то на 80 кадре, SEQ растет в районе 171, кадры 1504, пропуски SEQ 1».
  Граница рывков не сдвинулась: ~кадр 75-80 = переход TYPE 01 → TYPE 02
  (75 полных × 40 мс = 3,0 с), как и до v1.2.
- Форензика цифр: «пропуски SEQ 1» — это САМ СБРОС: SEQ на проводе прыгнул
  с текущего значения на 0, что даёт ровно один разрыв непрерывности; после
  него все SEQ подряд без разрывов (иначе счётчик был бы больше). SEQ 171
  «растёт» = счёт кадров после сброса mod 256 → после сброса принято
  171 + 256·k кадров (683 или 939), потерь НЕТ. «Кадры 1504» — декодов от
  старта вьюера (включая до-сбросный хвост). Вывод: провод/плата/прошивка
  чистые (сим и до того дал 125 000T ±95T = 25.000 FPS на всех кадрах) —
  рывки остались в тайминге ОТРИСОВКИ на ПК.
- Механика остатка: кадр на проводе 2006 Б за 40 мс; тик WinForms-таймера
  (Interval 15) реально приходит по сетке WM_TIMER ~15,6 мс и читает ~780 Б
  → конверт завершается на 2-м или 3-м тике; дрейф 2,56 тика/кадр даёт
  попеременные интервалы завершений 31,2/46,8 мс. До v1.2 на полных кадрах
  дорогая перерисовка (100 строк × 160 px интерпретируемым циклом, ~10-20 мс
  на 5.1) растягивала тик и случайно работала метрономом; после v1.2 декод и
  перерисовка дельт дешёвые — остаётся чистая сетка таймера, мяч дёргается
  31/47. Этим же объясняется исходное «плавно и БЫСТРО»: на полных кадрах
  декод шёл пачками по 2 (накопившееся вычитывалось разом), шаг шара
  выходил по 2 клетки — движение выглядело быстрее и ровнее.
- Фикс v1.3 (обе копии, md5 7797ab91): (1) ГЕЙТ ОТРИСОВКИ — Update-GfxBitmap
  не чаще раза в 36 мс (Stopwatch.Restart после отрисовки), рисуется всегда
  самый свежий FB (просроченные кадры отбрасываются — по SPEC п.4); гейт в
  диапазоне (31,2; 46,8] превращает попеременные 31/47 в равномерные
  ~40-47 мс (дисплей ~21-25 FPS равномерно; FPS-метр считает ДЕКОДЫ = эфир,
  остаётся 25±1). (2) Инструментация: статус в 2 строки — «инт ср/макс мс»
  между декодами (Stopwatch, монотонный, окно 250 мс) + «буф макс»
  (BytesToRead на тике чтения). (3) -Log <файл>: CSV «utc,seq,type,dt_ms,buf»
  на каждый декод, слив каждые 250 мс (файл открывается на слив — краш-
  безопасно) + финальный слив в FormClosed; в самотесте ветки инертны
  (GfxLogLines = null, BufLast = -1), счётчики самотеста не тронуты.
- Критерии следующего доклада: инт ср ≈ 40 и макс ≤ ~50 → эфир ровный,
  гейт даёт плавный ход — приёмка закрывается; инт макс ≥ 60-100 мс → пачки
  доставки CH340/USB — следующий шаг: вынос чтения/декода из UI-потока
  (DataReceived + Invoke), гейт остаётся. К докладу приложить gfx_log.csv
  (60 с) и двухстрочный статус целиком.
- Приёмка шага 3 продолжается: gfx_view.ps1 v1.3 → -SelfTest (exit 0) →
  -Port COM13 -Log gfx_log.csv → ≥60 с без рывков на дельтах; статус: FPS
  25±1, инт 40/≤50, пропуски SEQ 0 (без сброса), ресинк 16 Б, Б/с ~50 150.

## 2026-11-11-3 — ВЬЮЕР У ВЛАДЕЛЬЦА: ПЕРВЫЕ 3 С ШАР ШЁЛ РОВНО (75 ПОЛНЫХ КАДРОВ TYPE 01), ЗАТЕМ РЫВКИ — ГРАНИЦА ТИПОВ = ДИАГНОЗ: FFh-ДОБИВКА ДЕЛЬТ (1798 Б/КАДР) ПРОПУСКАЛАСЬ RemoveAt(0) ПО ОДНОМУ БАЙТУ (~45 000 ВЫЗОВОВ/С) — НА PS 5.1 GUI-ПОТОК ГОЛОДАЕТ, ДЕКОД ИДЁТ ПАЧКАМИ. УРОК 7: САМОТЕСТ МЕРЯЕТ КОРРЕКТНОСТЬ, НЕ ПРОПУСКНУЮ СПОСОБНОСТЬ — ОФЛАЙН-ФИД 260 КБ ПРОХОДИЛ ЛЮБОЙ ЦЕНОЙ, ЖИВОЙ ТЕМП 50 150 Б/С В ПЕСОЧНИЦЕ НЕ КРЫВАЕТСЯ ВООБЩЕ. ФИКС v1.2: СЕРИЯ FFh — ОДИН RemoveRange (СЕМАНТИКА 1-В-1); ПОТОЧЕЧНЫЕ КОПИИ PAYLOAD/FB → .NET-БАТЧИ; В САМОТЕСТЕ INFO-ЗАМЕР ВРЕМЕНИ ДЕКОДА

- Доклад владельца: «нажал сброс и первые секунды клетка двигалась плавно
  и быстро, а потом перешла на рывки». Числа совпали с границей фаз
  прошивки: 75 полных кадров × 40 мс = 3,0 с ровного хода, дальше TYPE 02.
- Механика: конверт кадра постоянен (2006 Б / 40 мс = 50 150 Б/с эфира), но
  у дельты 202 Б полезных + 1798 Б FFh-добивки; пропускатель добивки
  работал поточечно: RemoveAt(0) (сдвиг остатка очереди) + индексер +
  сравнение на КАЖДЫЙ байт. 1798 × 25 кадр/с ≈ 45 000 итераций/с, в 5.1
  каждая ~10-40 мкс → 0,5-1,5 с CPU на секунду эфира: WinForms-таймер
  (15 мс) голодает, кадры декодируются пачками по 2-3 → мяч дёргается.
  TYPE 01 добивки не имеет (один RemoveRange на кадр) — потому первые 3 с
  были плавными. Провод не виноват: сим прошивки дал 125 000T ±95T на всех
  205 кадрах; у владельца пропусков SEQ/ресинков не докладывалось.
- Фикс v1.2 (обе копии): (1) серия FFh срезается одним RemoveRange с
  подсчётом прогона, cap по ожидаемой добивке и длине очереди — семантика
  1-в-1 со старой (не-FF → FillLeft=0 → обычный скан; FF сверх добивки —
  мусор в ресинк-счётчик); (2) копия payload из очереди — List.CopyTo
  вместо поточечного цикла; (3) заливка FB полным кадром — [Array]::Copy
  вместо 2000 итераций; (4) в самотест добавлен INFO-замер (не Req) времени
  декода 260 796 Б с бюджетом 5200 мс = темп живого эфира 50 150 Б/с —
  чтобы не фалсифицировать приёмку на медленной машине.
- УРОК 7: самотест меряет корректность, не перф; офлайн-поток декодируется
  «успешно» любой ценой. Правила: поточечные RemoveAt(0)/копии в горячем
  пути парсера запрещены — только батч-операции .NET; перф-решения
  принимать по целевой 5.1 (медленнее pwsh 7 в разы, урок 5 продолжается);
  живой темп 25 кадр/с в песочнице не крывается ничем (GUI неисполним) —
  приёмка темпа только у владельца.
- Приёмка шага 3 продолжается: gfx_view.ps1 v1.2 → -SelfTest (exit 0 +
  сообщить INFO-время декода) → -Port COM13 → держать запуск БЕЗ рывков на
  дельтах ≥ 60 с; статус-строка: FPS 25±1, пропуски SEQ 0, ресинк 16 Б,
  Б/с ~50 150; скрин/текст статуса прислать.

## 2026-11-11-2 — ВЬЮЕР У ВЛАДЕЛЬЦА ПРОШЁЛ ПАРСИНГ (ФИКС BOM РАБОТАЕТ, ПОРТ ОТКРЫЛСЯ) И УПАЛ В РАНТАЙМЕ НА GUI: gfx_view.ps1:374 «op_Addition» НА [System.Object[]] — New-Object System.Drawing.Size С ДВУМЯ АРИФМЕТИЧЕСКИМИ АРГУМЕНТАМИ В ОДНИХ СКОБКАХ. УРОК 6: ЗАПЯТАЯ В PS СВЯЗЫВАЕТ КРЕПЧЕ '+' — «Size ((160*S)+24, (100*S)+70)» ГРУППИРУЕТСЯ КАК «(160*S) + @(24, (100*S))» = INT + МАССИВ; GUI-ВЕТКА ДО ВЛАДЕЛЬЦА НЕ ИСПОЛНЯЛАСЬ НИГДЕ (ПЕСОЧНИЦА БЕЗ WINFORMS, САМОТЕСТ ВЫХОДИТ РАНЬШЕ). ФИКС v1.1: [System.Drawing.Size]::new(...) — В ВЫЗОВЕ МЕТОДА ЗАПЯТАЯ = РАЗДЕЛИТЕЛЬ АРГУМЕНТОВ

- Доклад владельца (C:\Users\saa\Downloads\gfx_view.ps1): «Сбой вызова метода
  из-за отсутствия в [System.Object[]] метода с именем "op_Addition"» на
  строке 374: `$form.ClientSize = New-Object System.Drawing.Size
  ((160 * $Scale) + 24, (100 * $Scale) + 70)`. Прогресс относительно 11-11:
  парсинг чистый, отработали Add-Type, выбор порта, `$sp.Open()` — падение
  уже при построении окна.
- Механика: координаты сидят в одной паре скобок с запятой; приоритет
  запятой (конструктор массива) в PowerShell ВЫШЕ бинарного «+», поэтому
  выражение = «(160*S) + (24, (100*S)) + 70»: первый же «int + Object[]»
  бросает op_Addition, тип в ошибке ([System.Object[]]) — массив-операнд.
  Почему не поймали раньше: -SelfTest завершается на строках 313-316 ДО
  GUI-ветки, а GUI на Linux-песочнице неисполним (нет WinForms) — эта ветка
  впервые исполнилась у владельца.
- Фикс (v1.1, обе копии): строки 374 и 388 → `[System.Drawing.Size]::new(...)`:
  в списке аргументов вызова метода запятая = разделитель аргументов,
  арифметика внутри каждого аргумента безопасна; ::new() есть с PS 5.0 —
  5.1-совместимо. Строка 388 («lbl.Size ((160*S)+4, 34)») — та же бомба,
  сработала бы следующей. Остальные New-Object System.Drawing.*
  (Bitmap/Rectangle/Point/Font: 343-345/381/382/387/390 старой нумерации)
  ревизия прошла: запятые на уровне аргументов, «+» вне скобок не
  встречается — не тронуты (минимальный дифф при невозможности исполнения
  GUI в песочнице).
- УРОК 6: арифметические аргументы конструкторов .NET в PS — только через
  ::new() или отдельные переменные; «New-Object T (expr+1, expr2+2)» —
  минное поле. Дополнение к уроку 5: у 5.1-скрипта ревизии подлежат ВСЕ
  ветки, включая GUI — самотест их не крывает, а песочница не исполняет.
- Приёмка шага 3 (SPEC п.6) продолжается: перекачать gfx_view.ps1 v1.1 →
  `.\gfx_view.ps1 -SelfTest` (должен пройти, exit 0) →
  `.\gfx_view.ps1 -Port COM13` → окно 504x370 (PictureBox 480x300),
  ожидание: сетка 8x8 + скачущий шар, FPS 25±1, «пропуски SEQ 0»,
  «ресинк 16 Б» (баннер), далее скрин/статус-строка за 60 с.

## 2026-11-11 — ВЬЮЕР У ВЛАДЕЛЬЦА НЕ СТАРТОВАЛ ДО ЗАПУСКА: gfx_view.ps1 СОХРАНЁН UTF-8 БЕЗ BOM — WINDOWS POWERSHELL 5.1 ЧИТАЕТ .ps1 В CP1251 (9 ОШИБОК PARSERERROR, КИРИЛЛИЦА = МОДЖИБЕЙК, СТРОКИ РВАНЫ «УМНЫМИ КАВЫЧКАМИ»); ФИКС: BOM В ОБЕ КОПИИ, ТЕЛО БАЙТ-В-БАЙТ НЕ ТРОНУТО. УРОК 5: ТЕСТИРОВАЛИ В PWSH 7, ЦЕЛЕВАЯ ОБОЛОЧКА — 5.1; ОНИ ЧИТАЮТ UTF-8 БЕЗ BOM ПО-РАЗНОМУ. ПРАВИЛО: ВСЕ .ps1 РЕПО — С BOM

- Доклад владельца (C:\Users\saa\Downloads\gfx_view.ps1): ParserError с 210-й
  строки — «Отсутствует закрывающий знак }» у `function Invoke-GfxSelfTest` +
  каскад «Непредвиденная лексема» на русских строках; в дампе mojibake
  «РїР?С?Р>РчР?…» — верный признак чтения UTF-8 как CP1251.
- Диагноз по трём фактам: (1) первые 3 байта файла = `23 20 3d` («# =») — BOM
  нет; (2) uart_speed.ps1 — с BOM (`ef bb bf`) и у владельца всегда работал;
  (3) SelfTest 12/12 прошёл в pwsh 7.4.6 — pwsh 7 молча читает UTF-8 без BOM
  как UTF-8, а 5.1 берёт системную ANSI-кодировку (CP1251 на русской Windows).
  Пары байтов UTF-8 при CP1251-декоде дают U+201C/U+201D («умные кавычки»,
  байты 93h/94h) — PowerShell принимает их за кавычки-ограничители → строковые
  литералы рвутся посреди текста → парсеру «не хватает» скобок
  (MissingEndCurlyBrace).
- Фикс: `\xef\xbb\xbf` добавлен в обе копии (beta/gfxstream/gfx_view.ps1 +
  download/gfx_view.ps1); тело не тронуто ни на байт — валидность SelfTest
  12/12 сохраняется; diff копий — идентичны. rg-проверка на 5.1-несовместимый
  синтаксис (тернарник `?:`, `??`, `??=`, `ForEach-Object -Parallel`) — чисто;
  типы `-shl`/`-bor` уже учтены уроком 11-10-6 (явные [int]).
- УРОК 5: если в шапке скрипта заявлена поддержка Windows PowerShell 5.1 —
  тестировать НА НЕЙ (минимум — BOM-чек перед коммитом): pwsh 7 маскирует
  отсутствие BOM. Правило репо: любой .ps1 = UTF-8 с BOM,
  `head -c 3` == `ef bb bf` (uart_speed так собран с v1.1 — потому работал).
- Приёмка шага 3 (SPEC п.6) перезапускается без изменений: перекачать
  download/gfx_view.ps1 → `.\gfx_view.ps1 -SelfTest` (ожидание 12/12, exit 0)
  → `.\gfx_view.ps1 -Port COM13`.

## 2026-11-10-6 — GFXSTREAM v1 ГОТОВА: ПРОШИВКА 738 Б + ВЬЮЕР, СИМ ПО HEX 205 КАДРОВ «ВСЁ ОК» (0 ОТБРОСОВ, 25.000 FPS), ВЬЮЕР -SelfTest 12/12, КРОСС-МОДЕЛЬ md5 1-в-1. ЧЕТЫРЕ УРОКА: РАЗВЁРТКА ×2 ДАЁТ 24T < 31,25T (ОТБРОСЫ) → ЛИНЕЙНЫЙ 47T/Б; ПЕРИОД = ПОСЫЛКА + ОЖИДАНИЕ + РАБОТА СЛЕДУЮЩЕГО КАДРА (PAD-ВЫРАВНИВАНИЕ ПУТЕЙ); PS -shl/-bor НЕ РАСШИРЯЮТ ТИП ([byte]7 -shl 8 = 0)

Реализация шагов 1-2 плана gfxstream (SPEC п.6). **Прошивка**
`rom/gfxstream/gfxstream_v1.{asm,bin,hex,lst}` (738 Б, CP1251 + UTF-8
близнец): баннер `GFXSTREAM v1` после POR 503 мс; кадры РОВНО 125 000T =
40,000 мс (25.000 FPS): кадры 0..74 TYPE 01 (полные 2 000 Б), далее TYPE 02
(дельта 9 строк × 21 Б, маска 13 Б, N=202 — шаг по r всегда ±1), каждый
100-й кадр — полный ресурсинк (99/199/…); тест-паттерн сетка 8×8 + шар 8×8
FFh по диагонали с отскоком (col 0..19, row 0..92); ОЗУ 4 027 Б из 32 КБ
(FB 8000h, SCRAP 9000h, STATE 9800h). **УРОК 1 — развёртка ×2 из SPEC п.4
ОТКЛОНЕНА СИМОМ:** два OUT в теле разложенного цикла стоят через 24T —
меньше TX_BUSY-окна 31,25T → каждый 2-й байт ОТБРАСЫВАЕТСЯ (та же механика,
что SPRINT 31T). Рабочая схема — линейный цикл из ОЗУ
`MOV A,M+OUT+INX H+DCX B+MOV A,B+ORA C+JNZ = 47T/Б РАВНОМЕРНО` на всём кадре
включая границы заголовок/строки (равномерность = ноль отбросов BY
КОНСТРУКЦИИ; темп посылки 66 489 Б/с = 66,5% линии, кадр 30,2 мс). Хвост
дельты добит FFh до конверта 2 006 Б (UART-idle) — посылка всегда 2 006 Б.
**УРОК 2 — период кадра = посылка + ожидание + работа СЛЕДУЮЩЕГО кадра:**
при разных путях (полный ~2 153T, дельта ~8 431T) полные кадры перед
дельтами растягивались до 131,5 мс, дельты перед ресурсинком сжимались до
118,7 мс. Лечение: PAD-цикл в полном пути (PADF=261×24T) выравнивает работу
путей + ЕДИНОЕ ожидание W_FRAME=930 → все периоды 125 000T ±95T (±30 мкс —
веточный джиттер g-теста стирания); стартовый бит маски — из таблицы TBL
(сдвиговый цикл давал дрожание дельты до ±380T). СИМ
`beta/txuart/scripts/sim_gfxstream_v1.py` — интерпретатор 8085 по РЕАЛЬНОМУ
hex (расширен: DAD/STAX/LDAX/LDA/STA/ADD r/CMP r/XRA r/RLC/JC/JNC/INR M/MVI M
с честными T-состояниями) + модель TX-ядра (отброс при busy): 205 кадров
ВСЁ ОК — 0 отбросов TX (все 415 966 записей на проводе), SEQ без пропусков,
побайтовая сверка с эталонной моделью (сетка+шар, маски, добивка), период
обоих режимов 125 000T ±95T, FPS 25.000, мин. межписьмо 47T. Попутно
выловлены и исправлены 3 бага прошивки ДО железа: (а) в цикле стирания
`MOV E,A` затирал младший байт DE со шагом 20 (указатель шёл +0,+1,+2…);
(б) три указателя теряли базу FB=8000h; (в) цикл заливки SCRAP портил A
тестом счётчика (`MOV A,B/ORA C` внутри `MOV M,A`-цикла) и копия строк
писала `MOV M,A` (обратно в FB) вместо `STAX D` (в SCRAP) и 24 пары вместо
20. **УРОК 3 — PS `-shl`/`-bor` НЕ расширяют тип:** `[byte]7 -shl 8` = 0
(mod 256) — заголовок N читался как 208 вместо 2000, парсер вьюера
отвергал ВЕСЬ поток; лечение — явные `[int]`-касты перед bitwise (и
тихий пропуск FFh-добивки по счётчику 1798 с фолбэком на первый не-FF —
баннер/мусор честно идут в «пропущено вне кадров» = 16 Б на чистом старте).
**Вьюер** `beta/gfxstream/gfx_view.ps1` (+ копия download/): WinForms
PictureBox 160×100 ×3 (NearestNeighbor), ресинк по A5 5A, FPS-метр, SEQ/
пропуски/пропущенные Б/Б-в-секунду; -SelfTest 12/12 (pwsh 7.4.6): 130
кадров, FB 1-в-1 модели, дельта ровно 9 строк [75..83], мусор → ресинк,
удалённый кадр → пропуск SEQ. **УРОК 4 — off-by-one в дельте:** дельта
кадра k — строки [min(pos(k), pos(k+1)) .. max+7] (стёртый шар = pos(k) —
то, что показывал кадр k−1), а не [min(pos(k−1), pos(k+1))]. Ассемблер
asm8085.py расширен (DAD/STAX/LDAX/XCHG/LDA/STA/LHLD/SHLD/PUSH/POP,
SYM+конст, hex-литералы с ведущей буквой) — регрессия: txstress_v11 и
txstress_v11_p04 пересобраны БАЙТ-В-БАЙТ теми же. Кросс-проверка всей
цепочки: поток прошивки (сим по hex) ≡ модель вьюера — md5
cf00807aa6ef264f401d0b55ce89b392 1-в-1 (260 796 Б, 130 кадров). **ВЛАДЕЛЬЦУ:
прошить `gfxstream_v1.hex`, терминал закрыть, `.\gfx_view.ps1 -Port COM13`
— ожидать окно 480×300 с сеткой и скачущим шаром, FPS 25±1, «пропуски SEQ 0»,
«ресинк 16 Б» (баннер); затем приёмка 60 с (п.6.3).**

## 2026-11-10-5 — ШАГ 0 GFXSTREAM ПРИНЯТ: p04-ПРОГОН 71/71 ЦИКЛА, FLOOD 97 887 Б/с (ПОТОЛОК 32T ПОДТВЕРЖДЁН ЖЕЛЕЗОМ), СМЕШАННЫЙ КАНАЛ 91,4%, 0 ОШИБОК — МОДЕЛЬ ЦИКЛА СОШЛАСЬ ДО МИКРОСЕКУНДЫ

Доклад владельца 11-10-5 (log2 → `uart_speed_v13_com13_p04_60s.log`, разбор
`scripts/analyze_log2_p04.py`): прогноз 11-10-4 СБЫЛСЯ ЦЕЛИКОМ — 71 цикл
(~70), dt 839,1 мс ср (~845), 91 402 Б/с = 91,4% линии (~91%), FLOOD
стационар 97 887 Б/с (97 656 + 0,24% пачек ПК), SPRINT U=581 632 = 8192×71
ровно, BURST U=199 936 = 2816×71 ровно, лендмарки 497 = 7×71, токены +7/цикл,
ЧУЖИХ 0, вердикт «бит-ошибок НЕТ». Модель цикла p04 закрыла арифметику до
последнего такта: 671,1 мс (FLOOD 65 536×32T) + 110,1 мс (SPRINT 16 384×21T,
каждый 2-й в TX_BUSY → 8192) + 39,0 мс (BURST 8 192×14,875T → 2816) + ~20 мс
(маркеры 167 Б + пауза тишины) = 840,2 мс против измеренных 840 мс —
расхождение ноль в пределах кванта измерения. УРОК-ПОДТВЕРЖДЕНИЕ модели фаз
11-10-3: фазовые скорости приёма на ПК (SPRINT 92 549, BURST 79 887 Б/с) —
это пачки доставки, НЕ провод; проводные значения дают счётчики U и время
фаз из исходника — «байты/номинальная-длительность» и «мгновенная скорость»
сошлись именно в этой паре величин. Форензика: циклы 1-2 (799/820 мс) —
прогрев чтения после 2-с паузы до сброса, дальше 69 циклов подряд ровно
840 мс; алиасинг 11-с бампов исчез — цикл 0,84 с не резонирует с 1-с
вёдрами; в логе нет построчной таблицы «t=N c» (обрезано по ИТОГ) — не ошибка.
Канал закрыт с обеих сторон: TX_BOTH=1 69,8%/74,4% и TX_BOTH=0 91,4%/97,7%,
три полных лога = 12,7 МБ без единой бит-ошибки. Следующий шаг (план 11-10-4):
firmware gfxstream v1 — баннер `GFXSTREAM v1`, TYPE 01 160×100 на 25 FPS,
затем TYPE 02 дельты, ПК-вьюер gfx_view.ps1, приёмка 60 с по SEQ.

## 2026-11-10-4 — ПОТОЛОК ПОЛОСЫ НАЙДЕН В ИСХОДНИКЕ: 42T = СТРАХОВОЧНЫЙ ДВОЙНОЙ OUT (TX_BOTH=1), ПОЛ 8085 = 32T = 97,7% ЛИНИИ И УЖЕ СОБРАН (txstress_v11_p04.hex); ВЫБРАН ГРАФИЧЕСКИЙ ЭКРАН: 160×100 1bpp, GUI-ОКНО, TYPE-ТАБЛИЦА, 25 FPS — СПЕЦИФИКАЦИЯ beta/gfxstream/SPEC.md

Вопрос владельца 11-10-4: «какой процент ширины канала используем, могли бы
быстрее, из кода выжато всё?» Разбор `rom/txstress/txstress_v11.asm` по
строкам: FLOOD-цикл = `MOV A,C(4)+OUT 04h(10)+OUT 05h(10)+INR C(4)+DCR
B(4)+JNZ(10) = 42T` — второй OUT это СТРАХОВКА TX_BOTH=1 (алиас 05h), она и
стоит 10T/Б; вариант TX_BOTH=0 (`txstress_v11_p04.hex`) УЖЕ СОБРАН в репо и
не прошивался: цикл 32T = 97 656 Б/с = 97,7% линии. ПОЛ АРХИТЕКТУРЫ = 32T:
OUT и JNZ несжимаемы; запись в занятый TX ядро отбрасывает (RTL hwuart v401
«TX-кадр OUT 04h, отброс при busy»; железное доказательство — SPRINT 31T
принимает РОВНО половину: TX_BUSY-окно 31,25T против записи каждые 31T —
каждый 2-й write попадает в busy, U=8192 из 16384, 52/52 цикла — механика
половины объяснена окончательно); опрос TXRDY (IN 05h бит 1) стоит ≥24T/Б —
дороже слепых 32T; остаток 2,3% — только CPLD FIFO/пейсинг, НЕ ВЛЕЗАЕТ в
XC95108 (фит v2.3 103/108); бод >1М бессмысленен (лимит CPU, темп от бода
не зависит). Зазор 32T−31,25T = 240 нс/Б — константа (оба клока от 25 МГц).
Ожидания p04-прогона посчитаны: FLOOD 97 656 Б/с, цикл ~845 мс / 76 711 Б
(~91%), SPRINT-фаза 110 мс (U=8192, приём 74 405 Б/с), BURST без изменений
(U=2816, ~42 мс) — блок ОЖИДАНИЙ uart_speed v1.3 печатает старые 42T-цифры,
это НЕ ошибка (вердикт по паттерну/лендмаркам/U действителен для p04).

ГРАФИЧЕСКИЙ ЭКРАН (второй вопрос владельца) — выборы зафиксированы
(рендер GUI-окно WinForms из PowerShell; 1bpp ч/б; 160×100; TYPE-таблица;
25 FPS): **спецификация GFXSTREAM v1 — `beta/gfxstream/SPEC.md`**. Кадр =
A5 5A [TYPE] [N_LO] [N_HI] [SEQ] [payload]; TYPE 01 полный 1bpp 2 000 Б
(100×20 Б, MSB=левый px), 02 дельта-строки (маска 13 Б + изменённые по
21 Б), 03 RLE [счёт][байт], 04 текст 80×25 CP866. Бюджеты: @97,7К кадр
3 906 Б на 25 FPS; TYPE 01 (2 006 Б) летит 20,5 мс → 19,5 мс CPU (~61К
T-сост.) на рисование; fallback 74,4К — 2 976 Б, посылка 27,0 мс, запас
13,0 мс — TYPE 01 проходит и без p04. Двойной буфер 2×2 000 = 4 000 Б из
32 КБ (12%). Поток из ОЗУ 37T → развёртка ×2 + NOP-набивка до 32T. План:
шаг 0 — прошить p04 и проверить (ожидания в SPEC п.5), затем firmware
gfxstream v1 + ПК gfx_view.ps1 (PictureBox 160×100 ×3), приёмка 60 с по SEQ.
Скрипты бюджетов: `scripts/graphics_bw_budget.py`,
`scripts/analyze_log1_v13.py`. ВЛАДЕЛЬЦУ: шаг 0 — txstress_v11_p04.hex в
ПЗУ, прогон uart_speed 60 с, прислать ИТОГ.

---

## 2026-11-10-3 — КОНТРОЛЬНЫЙ ПРОГОН uart_speed v1.3 ПРИНЯТ (52/52 цикла, 0 ошибок, 69 770 Б/с = 69,8% линии в ЧЕСТНЫХ единицах) — TXSTRESS-кампания закрыта, ПЗУ вернуть монитор ACdE

Доклад владельца 11-10-3 (`uart_speed_v13_com13_60s.log`, OEM-866 → UTF-8,
committed): полный 60-с прогон v1.3 (COM13, 1М 8N1, ПЗУ `txstress_v11.hex`).
Старт чистый — HEXDUMP с баннера `0D 0A "TXSTRESS v1.1" 0D 0A` (17 Б),
данные с t≈2,3 с (t=0..1 — пауза до сброса). Разбор скриптом
(`scripts/analyze_log1_v13.py`): 52/52 цикла РОВНО 76 711 Б (65 536 +
8 192 + 2 816 + 167), нумерация без пропусков, dt 1097-1100 мс (ср
1099,58 — такт стабильнее 0,3%), скорость цикла 69 752-69 953, ср
69 770 Б/с = 69,77% линии — та же величина в v1.2 печаталась «70 Б/с
(0,1% линии)»; FLOOD 65 536×52, разрывов +1: 0, лендмарков 364 = 7×52,
токенов 364 (+7/цикл ровно); SPRINT U=425 984 = 8192×52 РОВНО, BURST
U=146 432 = 2816×52 РОВНО, ЧУЖИХ 0, ВЕРДИКТ «бит-ошибок НЕТ». Окно
4 024 333 Б = 52 цикла (3 988 972) + 35 361 Б хвоста = баннер 53-го на
~59,5 с + 0,475 с FLOOD до закрытия окна. Два полных лога суммарно
(v1.2 4 190 994 + v1.3 4 024 333) = 8 215 327 Б ≈ 8,22 МБ без ЕДИНОЙ
бит-ошибки — линия/CH340G/CPLD/ядро/ПЗУ v1.1 закрыты окончательно.

**УРОК-ПОПРАВКА (модель фазовых скоростей):** прогноз «после чанк-фикса
SPRINT/BURST подойдут к номиналу 50 403 / 70 028» НЕ сбылся, и это
полезно: v1.3 (чанк 4096) сжала именно РАЗБРОС (SPRINT 57-98 →
55,5-71,4; BURST 79-125 → 75,7-91,2 стационар), а средние остались
~59,5 К / ~82 К. Вывод: завышение средних в v1.2 было НЕ интерполяционным
шумом (шум давал хвосты), а реальной концентрацией доставки — оценка
ОЖИДАНИЙ делила U на полную номинальную длительность фазы (162,5 / 39,0
мс), а фактические фазовые dt = 137,6 / 34,3 мс: буфер вычитывается
пачками на фоне производства записей, приём смещён к началу фазы.
На U и целостность не влияет (U — счётная величина). Урок шире: оценка
«байты/номинальная-длительность» и «мгновенная скорость приёма» — разные
величины; в ОЖИДАНИЯХ это теперь понимаемая погрешность, не баг.

ФОРЕНЗИКА ПОСЕКУНДНЫХ БАМПОВ: бампы >70 К/с в t=9-11, 20-22, 31-33,
42-44, 53-55 — интервалы ровно 11,0 с = бит-период 1/(1 − 1/1.0994) =
11,1 с между тактом цикла 1.0994 с и сеткой 1-с вёдер — алиасинг границы
фазы с краем ведра (пачечная доставка перекидывает ~1,5-2,2 К между
секундами); сумма по окну сходится до байта. Единичные выбросы фазовых
скоростей (цикл 1: FLOOD 81 267 после 2-с паузы — прогрев чтения, первый
чанк пачкой; цикл 10: BURST 223 383 = 2816 Б за ~12,6 мс — разовая пачка
USB) — счётчики при этом точны. Косметика v1.3 задокументирована без
правок кода (утилита ЗАМОРОЖЕНА): «ПУСТЫХ 2 (поток прерывался!)» на
холодном старте = секунды паузы до сброса ПЗУ, не обрыв; «мин 1» =
краевое ведро t=60. ВЛАДЕЛЬЦУ: вернуть в ПЗУ монитор ACdE;
uart_speed.ps1 v1.3 — финальная, оставить регресс-измерителем.

---

## 2026-11-10-2 — TXSTRESS v1.1 ПОДТВЕРЖДЁН ЖЕЛЕЗОМ (8 циклов: паттерн +1 ЦЕЛ, B=7/7, U=8192/2816, цикл 1.097-1.100 с) + uart_speed v1.3: ФИКС ЕДИНИЦ СКОРОСТИ — байты/мс печатались как «Б/с» (×1000)

Доклад владельца 11-10-2 (COM13, 1 000 000 8N1, ПЗУ `txstress_v11.hex`,
`uart_speed.ps1` v1.2): фазовый разбор ЗАРАБОТАЛ — 8 циклов в пасте, баннер
ловится каждый ~1.097-1.100 с (сим обещал 1.091), FLOOD 65 536 Б/цикл ровно
с паттерном +1 ЦЕЛ, лендмарков ровно 7 (0020..00E0), токен " TXSTRESS" в
каждом (счётчик +7/цикл), SPRINT U=8192 чужих 0, BURST U=2816 чужих 0 —
ровно уточнённая сетка (14T внутри прохода + 28T на стыке), кадры на
границе линии целы, переполнение = тихая потеря записей, как задумано.
**76 711 Б/цикл = 65 536 + 8 192 + 2 816 + 167 маркеров (баннер 17 +
7 лендмарков ×17 + FLOOD OK 10 + SPRINT OK 11 + BURST OK 10) — сходится
БАЙТ В БАЙТ.** ВЫВОД: прошивка v1.1 работает 1-в-1 проекту; единственная
причина трёх «безбаннерных» прогонов 11-10 — коррумпированный v1.0.hex
(баг size_of ассемблера), плата/ядро/линия ни при чём.

**УРОК (единицы измерения обязаны жить в одном месте — helper, а не в
каждой строке вывода):** v1.2 считала скорость как `байты / dt(мс)` =
байт/мс и печатала «Б/с»; «% линии» делил ту же величину на 100 000 Б/с —
занижение ровно ×1000: цикл 76 711 Б за 1097 мс (= 69 928 Б/с, 69,9%
линии) показался «70 Б/с (0,1% линии)», и железо выглядело «работающим на
0,1% линии» вместо честных ~70%. ФИКС v1.3: helper `Get-Rate(байты, dt_мс)
= 1000·байты/dt`, все 8 вычислений (цикл+%, FLOOD, SPRINT/BURST, ИТОГ
цикл/FLOOD/SPRINT/BURST) через него; блок ОЖИДАНИЙ и «средняя по окну» в
ИТОГ были верны (там dt в секундах) — не тронуты. Бонус-точность: чанк
чтения 65536→4096 Б — сетка (время,позиция) для интерполяции Get-TimeAtPos
плотнее фазы; по живому прогону v1.2 FLOOD шёл +1.4% (норма для оценки),
короткие SPRINT/BURST завышались ~+15% (чанк был ДЛИННЕЕ фазы и приписывал
ей среднюю скорость чанка). ReadBufferSize 131072 (драйверный, гасит
пульсации USB) НЕ тронут — это не размер чтения PS.

ПОЛНЫЙ ЛОГ ВЛАДЕЛЬЦА (11-10-3, `uart_speed_v12_com13_60s.log`, OEM-866 →
UTF-8) — 60-секундный прогон v1.2 целиком: **53 полных цикла подряд, все
76 711 Б за 1100 мс** (разброс 0), счётчики — точные кратные 53 (лендмарки
371 = 7×53, SPRINT U=434 176 = 8192×53, BURST U=149 248 = 2816×53, ЧУЖИХ 0),
ВЕРДИКТ «бит-ошибок НЕТ», окно 4 190 994 Б = 53 цикла (4 065 683) + 125 311 Б
частичных FLOOD-фрагментов с обоих концов (73 712 Б/с ≈ 74 405 — старт
захвата в середине FLOOD: HEXDUMP с 47h 'G' + «!! баннера нет, но найден
лендмарк B=0040 TXSTRESS», хвост до первого баннера v1.2 верно не считала
порчей; обрез посреди FLOOD 54-го). Баг единиц на ИТОГ подтверждён: «FLOOD
ср. 75» = 75 000 Б/с (+0,8% к 74 405 — интерполяция для FLOOD отличная),
«SPRINT 60» = 60 000 (+19,0%), «BURST 81» = 81 000 (+15,7%) — систематика
чанк-длиннее-фазы, как предсказано; «средняя 69 846 Б/с (69,8%)» была верна
всегда (dt в секундах). Посекундно «мин 1» — граничное ведро, не разрыв
(ПУСТЫХ нет, 53 цикла без разброса). ИТОГ ПО ЖЕЛЕЗУ: 4,19 МБ без единой
бит-ошибки — линия/CPLD/ядро/прошивка v1.1 закрыты полностью.

САМОТЕСТ v1.3 (pwsh 7.4.6 + `gen_txstress_sim.py` + `make_ps1_sim.py`,
4/4): чистый поток 60 циклов — счётчики 1-в-1 эталону, вердикт зелёный,
exit 0 (единицы проверены по каждой строке ЦИКЛ: «Б за X мс ->
1000·76711/X Б/с»); порченый (потеря FLOOD-байта + бит SPRINT + бит BURST +
битое ЗНАЧЕНИЕ лендмарка) — все 4 порчи найдены в своих фазах, exit 1;
баннер v1.0 + лендмарки без токена — разбирается (токенов 0 — норма);
безбаннерный непрерывный +1 — «ПОХОЖЕ: непрерывный инкрементный (+1)
поток», таблица кандидатов «фактический T», exit 1; парсер PS — 0 ошибок.
Копии download/, scripts/, beta/txuart/scripts/ бит-в-бит. ВЛАДЕЛЬЦУ:
перекачать uart_speed.ps1 v1.3, повторить полный прогон 60 с (ожидание в
настоящих единицах: цикл ~69 900 Б/с = 69,9% линии, FLOOD ~74 000, SPRINT
~50-55 К, BURST ~70-80 К, вердикт зелёный), прислать ИТОГ; ПЗУ НЕ ТРОГАТЬ.

---

## 2026-11-10 — КОРЕНЬ ТРЁХ ПРОГОНОВ TXSTRESS: АССЕМБЛЕР asm8085.py size_of() СЧИТАЛ ANI/ADI/ACI/CPI ОДНОБАЙТОВЫМИ → hex v1.0 В ПЗУ ИСПОЛНЯЛСЯ КОРРУПТИРОВАННЫМ («баннер» = байты кода, дикий цикл печати 'S' ~58.2 КБ/с); TXSTRESS v1.1 + uart_speed v1.2

Директива владельца 11-10: «доделывай прошивку v1.1 и утилиту v1.2 комить
и пуш». Исходные данные — три прогона (см. СТАТУС 11-10 в beta/txuart/
README.md): баннер «TXSTRESS v1.0» не найден ни разу, поток A/B непрерывен
~59.6 КБ/с (58 936/59 624), прогон 1 — 10.2 КБ/с с 11 активными секундами.

**УРОК ГЛАВНЫЙ (двухпроходный ассемблер обязан сходиться проход в проход):**
`size_of()` не знал непосредственных ALU (ANI/ADI/ACI/SUI/SBI/XRI/ORI/CPI —
2 байта: opcode+imm), а `enc()` эмиссил два → pc прохода 1 и прохода 2
расходились на +1 за КАЖДУЮ такую инструкцию; в txstress перед FLC их 13
(гейт ANI + 4 цифры × ANI+ADI+ACI), перед строками 14 (ещё CPI) → все
метки/строки уезжали: `LXI H,M_BAN` грузил M_BAN−14, `JNZ FLC` валил в
середину цифро-печатного кода, `JZ FDONE`/`JNZ SPIN` — в чужой код. Симуляция
по РЕАЛЬНОМУ v10.hex (scripts/sim_txstress_v10_repro.py — интерпретатор 8085
+ модель ядра TX) воспроизвела прогоны владельца 1-в-1: 0 вхождений баннера,
средний 58 195 Б/с, медиана секунды 58 962, топ-байт 53h('S') × 99.99 %,
первые байты `CA 19 01 D3 04 D3 05 23 C3 0C 01 C3 0A 00` (печатный цикл
выполнял байты КОДА до 00h-операнда `C3 0A 00`, затем один чистый блок FLOOD,
затем вечное «печать 'S'» 54T/байт ≈ 58.2 КБ/с). Прогон 1 (прерывистый) —
та же прошивка, рвалась ДОСТАВКА на PC (USB/хост): на плате поток непрерывен.
Листинг был доказательством ещё до симуляции: `JNZ FLC` кодировался в 0x86
при FLC=0x93. ФИКС: `size_of()` дополнен списком imm-ALU; v1.1 пересобран,
метки 1-в-1 (M_BAN→0138h, FLC→0093h).

**УРОК ВТОРОЙ (гейт лендмарков, пойман по столу независимо от ассемблера):**
в v1.0 гейт `MOV A,D; ANI 01Fh` смотрел СТАРШИЙ байт DE — весь первый
килоблок D=00 → лендмарк печатался бы КАЖДЫЙ блок (256 «B=00xx» вместо 7).
v1.1: `MOV A,E; ANI 01Fh; JNZ FLC; MOV A,E; ORA A; JZ FLC` → кратен 32
блокам И E≠0 → ровно 7 шт 0020..00E0, 1-в-1 с expectedLm утилиты. Заодно:
лендмарк несёт токен « TXSTRESS» (самоидентификация потока каждые 8 КБ
без пойманного баннера), POR-пауза 126→503 мс, тишина ~19.7 мс перед
баннером, баннер «TXSTRESS v1.1».

**УРОК ТРЕТИЙ (приближение равномерной сетки врёт в перегрузе):** BURST
пишет 16 байт проходом 238T (14T внутри + 24T стык), а не равномерно
14.875T → принято ровно 2816 'U' за фазу (5.5/проход × 512), а не ~2731
из k=ceil(31.25/14.875)=3. Симуляция по hex дала точное число; uart_speed
v1.2 печатает ожидание 2816. SPRINT при алиасе 05h (второй вход того же
ядра) легально принимает БОЛЬШЕ 'U' (12 288) — это не порча; FLOOD и баннер
при алиасе бит-в-бит равны no-op-варианту (05h-записи всегда приходят в
busy-окно собственного кадра).

**Симулятор-интерпретатор (sim_txstress_v11.py)** — собственные баги,
пойманные до «железа» эталона: DCX/INX различаются битом 3 (0x0B/0x1B/0x2B
— DCX), а не «op<0x40» (иначе DCX инкрементирует и SPRINT не кончается);
DAA по Intel ПОСЛЕДОВАТЕЛЬНЫЙ (коррекция старшего ниббла ПОСЛЕ младшего —
иначе цифры A..F печатаются со сдвигом: 'A'→'@', 'C'→'B'…); JNZ/JZ not-taken
7T, taken 10T. Верификация v1.1 по hex: 4/4 баннера, 7 лендмарков с токеном,
FLOOD 65 536 (+1, 0 разрывов), SPRINT 8192 U, BURST 2816 U, FLOOD-факт
73 942 Б/с, цикл 1091.2 мс, p04 96 860 Б/с / 828.6 мс, ВСЁ ОК.

**uart_speed.ps1 v1.2** — диагностический релиз (детали в СТАТУС 11-10):
баннер по regex v1.0/v1.1, лендмарки с токеном и без, сырая диагностика
без баннера (+1-разрывы/пробеги/доля 'U'/ТОП-байт — Add-Type C# с fallback
на первые 64 КБ, период байта и таблица «если это FLOOD/SPRINT/BURST —
фактический T=…нс»), HEXDUMP первых байт, счёт ПУСТЫХ секунд, -Probe,
-SaveRaw, хвост до первого баннера не порча. Самотест pwsh 7.4.6 (make_ps1_sim.py
— якоря $sp v1.2, обход двух проверок порта): 7 сценариев — чистый эталон
(113 циклов по 76 711 Б точно, exit 0), hex-поток (exit 0), v1.0-совместимость
(exit 0), 4 порчи найдены (exit 1), АУТЕНТИЧНЫЙ дикий поток v1.0 → «монотонный
поток одного байта 53h» (exit 1), безбаннерный +1 → «FLOOD-подобный без
маркеров» (exit 1), -Probe (exit 1). Урок фидера: после удаления байта в
потоке офсеты последующих инъекций сдвигаются — искать вхождения в самом
порченом буфере; дамп эталона резать РОВНО по границе цикла (по баннеру),
иначе шов при зацикливании выглядит порчей.

**ВЛАДЕЛЬЦУ:** 1) перекачать uart_speed.ps1 v1.2; 2) ПРОШИТЬ В ПЗУ
rom/txstress/txstress_v11.hex (v1.0.hex битый — заменить обязательно);
3) PuTTY закрыть, `.\uart_speed.ps1 -Port COM13`; 4) если баннера нет —
сразу `-Probe` и прислать вывод (+`-SaveRaw raw.bin`); 5) после ОК — вернуть
ACdE.

---

## 2026-11-10 — uart_speed.ps1 v1.1: КРИТИЧЕСКИЙ БАГ v1.0 ИСПРАВЛЕН — КОЛЛИЗИЯ $port/$Port (РЕГИСТРОНЕЗАВИСИМОСТЬ PS + [string]-КОНСТРЕЙНТ ПАРАМЕТРА => ОБЪЕКТ МОЛЧА СТАЛ СТРОКОЙ)

Доклад владельца 11-10 (COM13, 1 000 000 8N1, TX_BOTH=1): баннер ожиданий
TXSTRESS напечатался верно, далее 9× «Не удается найти свойство "PortName"/
"BaudRate"/... для данного объекта» (строки 242–250) и «ОШИБКА: не удалось
открыть System.IO.Ports.SerialPort: ... в [System.String] нет метода "Open"».
ДИАГНОЗ (100%, все симптомы 1-в-1): в v1.0 объект SerialPort создавался в
переменную $port — а PowerShell ИГНОРИРУЕТ РЕГИСТР имён, $port == параметру
$Port; параметр объявлен [string], констрейнт остаётся на переменной, поэтому
присвоение объекта PowerShell обязан был конвертировать в строку — ToString()
объекта = литеральная строка "System.IO.Ports.SerialPort". Дальше: у строки
нет ни одного из 9 свойств (9× PropertyAssignmentException), нет Open
(«в [System.String] нет метода Open»), catch печатал содержимое $Port — имя
типа вместо «COM13». УРОК: в PS имя локальной переменной объекта не должно
совпадать (даже регистром) с типизированным параметром — типизированная
переменная молча конвертирует присвоенное. ФИКС v1.1: объект перенесён в $sp
(16 использований); имя порта проверяется по GetPortNames() ДО открытия
(дружелюбный список вместо 9 стектрейсов); для PS6+ Add-Type System.IO.Ports
(pwsh 7 не грузит сборку по умолчанию — в 5.1 она в System.dll); в catch
занятый порт различён (UnauthorizedAccessException/IOException → «закройте
терминал/PuTTY»); шапка v1.1 + урок-комментарий у секции порта. ЛОГИКА
TXSTRESS НЕ ТРОНУТА (машина фаз/интерполяция/вердикт — самотест 11-9-4 на
pwsh 7.4.6 остаётся в силе). Проверка: исполняемых $port не осталось
(2 вхождения — в комментариях-описании бага), BOM сохранён (UTF-8 BOM,
413 строк), три копии синхронизированы бит-в-байт: download/, scripts/,
beta/txuart/scripts/. ВЛАДЕЛЬЦУ: перекачать uart_speed.ps1 (или ручной фикс:
case-sensitive замена $port→$sp, 14 мест), PuTTY ЗАКРЫТЬ,
.\uart_speed.ps1 -Port COM13; ждать живые фазы (FLOOD/SPRINT/BURST зелёные),
«=== ЦИКЛ n» и ИТОГ «бит-ошибок НЕТ». Бонус доклада 11-10: баннер ожиданий
владельца подтвердил модель на 1М: FLOOD 74 405 (42T/Б), SPRINT 50 403 =
100 806/2 (k=ceil(31,25/31)=2), BURST 70 028 = 210 084/3 (k=3), U 8192/~2730.

## 2026-11-9-4 — txuart: ФИТ v2.3 11-9 7:26PM РАЗОБРАН (103/108, БЕЗ РОСТА МЦ, НО Exhaustive ON/IL 15 — КЛАСС-УРОК П.27 СНОВА) + ЖЕЛЕЗНАЯ ПРИЁМКА 1М (ЧИСТО) + TXSTRESS v1.0 (`rom/txstress`) + ИЗМЕРИТЕЛЬ `scripts/uart_speed.ps1` — КОМИТ/ПУШ ПО ДИРЕКТИВЕ «комить и пуш тест»

Директивы владельца 11-9веч: «1. Смотри отчет. Выдавай по нему резюме сразу
же. 2. Напиши тест который максимально загружает UART на вывод» → затем
«1. комить и пуш тест. 2. Напиши утилиту на powershell для проверки скорости
передачи в UART». Между ними — железная приёмка v2.3: терминал 1 000 000 8N1
показал ЧИСТУЮ строку «TXUART v2.2 OK N=87…98» (подпись v2.2 в ПЗУ —
намеренная, hex не менялся).

**1. ФИТ v2.3 (11-9 7:26PM, архив
`retro_pcld_top (txuart-fit3-1109-0726PM-SUCCESSFUL).rpt`).** Successful,
103/108 МЦ (95 %), 339/540 ПТ, 211/216 вх.ФБ (98 %), 77 рег, 72/81 ноги.
Наивный бюджет 104 (103 v2.2 + 1 бит baud_cnt<4>) — фиттер поглотил 5-й бит
без роста МЦ: рег ровно +1 (76→77), ПТ 341→339, вх.ФБ 213→211. Ядро на
месте: TX = FB3_11/P39 (3 ПТ FAST SET — в v2.2 было 4 ПТ), baud_cnt<0>
FB2_7 с jam/wrap через FX_DC$18098, ld_tx_q FB4_12, s1_rnm0 FB4_1,
A<1>_BUFR FB4_18; $OpTx$BIN_* = 0; FX_DC-декодов ровно 5 (ID сменились
61/67/70/71/73 → 18098/18105/18110/18116/18120); WARNING 897 ×1 (A<1>).
ОТКЛОНЕНИЕ: в отчёте INFO:Cpld:994 «Exhaustive fitting is trying pterm
limit: 18 and input limit: 15» — владелец запустил фит с **Exhaustive ON +
IL 15** вместо рецепта (Exhaustive OFF, IL 28, Pterm 18, DENSITY) —
класс-урок п.27 повторился ТРЕТИЙ раз (11-8 7:14PM, теперь). Последствия —
только упаковка (форма уравнений/числа ПТ/ID декодов), функция та же:
check_fit_v23.py даёт 7 несовпадений, ВСЕ разбораны как строковые паттерны
прежней упаковки (994, s1_rnm0, «TX 4 ПТ», jam-форма D(0), строб 04h,
TXRDY-чтение 05h, ID FX_DC). Вердикт: ПРИНЯТО ПО ФАКТУ ЖЕЛЕЗА (чистый
терминал = ground truth); на следующий фит — СВЕРЯТЬ ОПЦИИ ДО ПРОГОНА.

**2. TXSTRESS v1.0 (`rom/txstress/`) — тест максимальной нагрузки на вывод.**
Автономная прошивка ПЗУ (0000h–0163h, 356 байт, p04-вариант 330), T =
320 нс, бесконечный цикл: FLOOD 64 КБ инкремента +1 mod 256 с лендмарками
«B=xxxx» каждые 32 блока (42T/Б = 74 405 Б/с — 74 % линии 1М, чисто всегда)
→ SPRINT 16 384 × 'U' слепо, 31T/Б (на 1М кадр 31,25T > 31T — принимается
КАЖДЫЙ 2-Й: 50 403 Б/с, U=8192; на 1,5625М чисто 100 807 Б/с, U=16384) →
BURST 8 КБ × 'U', 14,875T/Б — честный ПЕРЕГРУЗ (на 1М принимается ~1 из 3,
~70 000 Б/с; кадры целы, паузы между ними). Маркеры фаз в потоке
(«TXSTRESS v1.0» / «FLOOD OK» / «SPRINT OK» / «BURST OK» + CRLF) — PC-сторона
синхронизируется без ручных отметок. TX_BOTH=1 (головной hex): каждый байт
пишется в 04h И 05h — работает при любой редакции ядра (запись в 05h —
no-op, декод записи только addr=100); p04-вариант (TX_BOTH=0) — только 04h,
темпы выше, собирать после подтверждения рабочего порта. Инструменты:
`rom/txstress/asm8085.py` — мини-ассемблер 8085 с T-состояниями (фолбэк
CP1251; причины отдельного ассемблера: нужен был листинг с T и управляемые
варианты сборки через IF/ENDIF + подстановку TX_BOTH); DAA-трюк перевода
ниббла в '0'…'F' (ADI 90h/DAA/ACI 40h/DAA) проверен на всех 16 значениях.
Верификация: `scripts/verify_txstress.py` (HEX↔BIN, CS, аудит темпов) —
ПАСС; оба hex пересобраны бит-в-байт (utf8 = cp1251 = hex прошлой сессии).

**3. ИЗМЕРИТЕЛЬ `scripts/uart_speed.ps1` (Windows PowerShell 5.1+, UTF-8
BOM).** Замер ФАКТИЧЕСКОЙ скорости приёма: поток Б/с посекундно (мин/макс/
средняя, % линии), в режиме txstress — фазы по маркерам: точные счётчики
байтов/U/чужих в окнах, целостность паттерна FLOOD (+1 mod 256, лендмарки
фильтруются), последовательность лендмарков, средний цикл banner→banner,
вердикт по бит-ошибкам, код выхода 0/1/2, CSV посекундно. Ожидания фаз
считаются из -Baud/-TxBoth (сетка: k = ceil(кадр/темп записи) записей на
принятый байт). Механика: Latin-1 (байт↔символ 1:1), BaseStream.Read +
таймаут, буфер 128 КБ, машина фаз с хвостом 18 символов (маркеры через
границу чанков не теряются и НЕ дублируются — хвост никогда не сканируется
дважды), время позиции — интерполяция по чанкам приёма. -Mode monitor —
чистый замер любой прошивки; -ListPorts.

**4. САМОТЕСТ УТИЛИТЫ ДО ЖЕЛЕЗА (pwsh 7.4.6 в песочнице, синтетический
поток = точная модель TXSTRESS на 1М/TX_BOTH=1; подмена COM-порта фидером —
`make_ps1_sim.py`, код Close-Phase/Get-TimeAtPos 1-в-1).** Чистый поток,
25+ циклов: FLOOD 65 536 Б/цикл точно, разрывов 0, B= 7/7, SPRINT
U=8192/цикл точно, BURST U=2731/цикл точно, чужих 0, вердикт зелёный.
Порченый поток (потеря байта FLOOD + бит-ошибка SPRINT + бит-ошибка
BURST): все три порчи найдены (РАЗРЫВОВ +1: 1, ЧУЖИХ 1 + 1, вердикт
красный, exit 1). Monitor и -ListPorts проверены. СИНТАКСИС парсером PS —
0 ошибок.

**5. УРОК (класс «лови до железа»): лендмарков в FLOOD 7, НЕ 8.** Первая
вычитка предполагала 0020…0100 (256/32 = 8) — самотест на ЭТАЛОННОМ потоке
поймал 7 «плохих» лендмарков: D&1F==0 даёт D = 0x20…0xE0 (7 попаданий),
а на 256-м блоке INX D даёт D = 0x01 (DE = 0100h) — это УЖЕ выход по
CPI 001h, лендмарка нет. Значение лендмарка = счётчик БЛОКОВ (DE), т.е.
0020…00E0. Комментарий asm «каждые 32 блока (8 КБ)» верен; ожидания утилиты
исправлены на 7. Второй улов той же прогоны: симулятор генерировал
«B=%04X» от (блок×256) вместо номера блока — расхождение вскрылось на
первом же прогоне самотеста.

**6. ДОКУМЕНТЫ:** beta/txuart/README.md — шапка (фит v2.3 + приёмка + отсылка
к нюансу опций), TODO ред. 11-9веч-2 (старые пункты 1–4 отмечены
выполненными), новый раздел «СТАТУС 11-9веч-2» (разбор fit3, таблица фаз
TXSTRESS, описание uart_speed.ps1 + самотеста, состав); beta/DEVLOG.md —
эта запись. ВЛАДЕЛЬЦУ: 1) прошить в ПЗУ rom/txstress/txstress_v10.hex
(TX_BOTH=1 — безопасно при любой редакции ядра); 2) терминал закрыть,
запустить `.\uart_speed.ps1 -Port COMx` (ожидания печатаются перед
прогоном; для v2.2-ядра -Baud 1562500); 3) на следующий фит — опции по
рецепту (Exhaustive OFF, IL 28, Pterm 18, DENSITY); 4) после прогона —
вернуть монитор ACdE.

---

## 2026-11-9-3 — txuart v2.3: МУСОР В ТЕРМИНАЛЕ РАЗОБРАН ПО ДАМПУ — CH340G НЕ УМЕЕТ 1 562 500; бод 25/16 -> 25/25 = РОВНО 1 000 000

Доклад владельца (11-9веч): «В терминале мусор» + дамп ~1143 байта
(прошивка `rom/uart_tx_test` в ПЗУ, CPLD v2.2 пришита, шунт H1 стоит).
Мусор СТРУКТУРНЫЙ: «Љ¤Ш•AТґ ц'.ІЂO‹ђNЅ'ЎЌЉTШµAТґ…» — повторяющиеся
фрагменты с периодом ~21 байт = длина строки «TXUART v2.2 OK N=xx».

**1. РАЗБОР ДАМПА (скрипты `scripts/uart_garbage_diag*.py`,
`uart_align_stats.py`, `uart_jitter_proof.py` в корне проекта).**
Канал-моделирование (таймлайн OUT 04h из интерпретатора 8085
`sim_uart_tx_test.py` -> RX-модель edge-lock) по сетке r = T_RX/T_TX
0.5..16: НИ одна «грубая» рассинхронизация (х2, /2, 115200, 921600...)
не даёт наблюдаемой картины. Ключ — ИНВЕНТАРЬ байтов дампа:
0x8A = '\n'|0x80 (41 раз), 0x8D = '\r'|0x80, 0xB2 = '2'|0x80 (70),
0xAE = '.'|0x80 (38), 0xBD = '='|0x80 (23), 0xD8 = 'X'|0x80,
0xD4 = 'T'|0x80, 0xF6 = 'v'|0x80, 0xB0-0xB9 = '0'-'9'|0x80... —
**каждый байт дампа = байт эталона С ВЫСТАВЛЕННЫМ СТАРШИМ БИТОМ**
(~половина байтов) ИЛИ точный (~половина); биты 0-6 ВСЕГДА точны,
фрейминг цел. ЕДИНСТВЕННЫЙ режим, дающий такую картину: приёмник
семплирует все биты правильно, КРОМЕ последнего (бита 7), чей семпл
ложится на границе данных/стопа.

**2. ДИАГНОЗ.** TX-путь 1-в-1 (все байты опознаны: CPLD v2.2 + FW +
P39 -> CH340G RXD работают); приёмник получил НЕ 1 562 500: сетка
CH340G = 48 МГц/(2^k x m); 1 562 500 = 12 МГц/7,68 в сетке НЕ СУЩЕСТВУЕТ
(даташит WCH: ...921600, **1500000**, 2000000). Linux `ch341.c`
(ch341_get_divisor): div = 48М/(4х1562500) = 7.68 -> округление -> div 4,
fact 0 = 48М/32 = **МОЛЧА ровно 1 500 000** (+4,17%). Модель с лагом
синхронизатора: при +4,17% последний бит данных на грани (лаг +1 такт
12 МГц: бит 7 сбояет 44%, бит 6 - 28%; реальный чип между 0 и 1 такта ->
наблюдаемые ~55% только по биту 7). ВАЖНО ДЛЯ ИСТОРИИ: «удобный для
счетчиков делителей бод рейтинг» (директива 11-8) выбирал удобство
СТОРОНЫ ПЛД, а не моста; 3,125 М отвергли верно (вне 2 Мбит CH340),
но 1 562 500 = 25/16 та же ловушка - сетки 25 МГц и 48 МГц почти не
пересекаются (только 0.5/1/2/2.5 М... целые делители 1М).

**3. ЛЕКАРСТВО — v2.3 (`gen_v23.py`: 18 якорных правок v2.2).**
бод = 25 МГц/25 = **РОВНО 1 000 000**: точная точка сетки ЛЮБОГО моста
(48М/48 = 12М/12 = 24М/24; ошибка 0 ПО СТРОЕНИЮ). RTL: BAUD_DIV 16 -> 25
(5 бит), baud_cnt [3:0] -> [4:0] (+1 МЦ), wrap ЯВНЫЙ:
`baud_cnt <= baud_tick ? 5'd0 : baud_cnt + 5'd1` (25 не степень двойки;
jam при загрузке перекрывает - как v2.2). Кадр 10 мкс = 31 T; поллинг
FW 27-90 T - тем более безопасен (проверено: сим прошивки 10/10 при
FRAME_T=31, 84 байта, 0 нарушений; **hex прошивки БАЙТ-В-БАЙТ тот же** -
в ПЗУ не лазим). Узел/CPU/пор-цепь/UCF/контракт - БЕЗ ИЗМЕНЕНИЙ.
Численная модель приёмника: при TX=RX=1М сбоев НЕТ ни в одном бите даже
при пессимистичном лаге +2 такта 12 МГц и дрожании +-83 нс.

**4. ВЕРИФИКАЦИЯ.** `check_v23.py` **75/75** (CP1251 round-trip; РОВНО 4
кодовых отличия ядра от v2.2; база 184 строки 1-в-1 v2.2; узел не тронут;
порядок объявлений; hex 2144 байта не тронут). `tb_txuart_v23.v`
(iverilog, РЕАЛЬНЫЙ RTL) **27/27**: RESET_IN 1220 нс; X1 160/40/120 нс;
X2 противофаза; **старт-бит кадра 55h ровно 1000 нс (25 тиков)**;
PC-приёмник декодирует; поллинг/busy-drop/статус; сброс посреди кадра;
P0a все 16 кодов кольца. Прошивка: пересобрана (комментарии), hex OK.
Файлы v2.2/v2.1/v2.0/v1.0 не тронуты.

**5. ВЛАДЕЛЬЦУ:** (1) ISE: фит v2.3 (Top = top_txuart_por6_v23.v, UCF
тот же, опции те же) - ожидание 103-105/108; (2) прошить CPLD; (3)
**ТЕРМИНАЛ: 1 000 000 8N1** (сменить с 1 562 500; Linux: stty -F
/dev/ttyUSB0 1000000); (4) ПЗУ НЕ трогать; (5) строка «TXUART v2.2 OK
N=xx» в терминале - подпись v2.2 в тексте ПЗУ осталась намеренно (hex
идентичен просимулированному).

---

## 2026-11-9-2 — txuart v2.2: ФИТ ПРОШЁЛ (103/108, аудит 55/55) + ПРОШИВКА ПЗУ ДЛЯ ПРОВЕРКИ TX ГОТОВА И ПРОСИМУЛИРОВАНА

Директива владельца (11-9): «1. Изучай отчет. 2. готовь прошивку в ПЗУ для
проверки работы UART на передачу». Отчёт: `retro_pcld_top.rpt` 11-8 23:51,
XC95108-15-PQ100, **Fitting Status: Successful** — это ФИТ v2.2 (кольцо
s0..s3 в Equations, clk25_q/r0..r6 в нетлисте нет; сохранён как
`beta/txuart/retro_pcld_top (txuart-fit2-1108-1151PM-SUCCESSFUL).rpt`).

**1. АУДИТ ФИТА (`beta/txuart/scripts/check_fit_v22.py`, 55/55 ПАСС).**
МЦ **103/108 (95%)** — верх окна ожидания 101–103 (допуск 101–105),
прецедент «−2 от наивного» сработал точно; ПТ 341/540, вх.ФБ 213/216
(99% — впритык, но Successful); ноги 72/81 = UCF 1-в-1. Кольцо в
Equations 1-в-1: `X1_D = ~X1 & ~s1 & ~s2` — advance от s3 + рестарт из
dead легально свёрнуты в 1 ПТ (на достижимых состояниях эквивалент
s3 | ~s0&~s1&~s2&~s3: при s3=1 в one-hot s0=s1=s2=0, двойные состояния
недостижимы из reset — X1=SET, s1..s3=RESET); s1_rnm0/s2/s3_D по 1 ПТ;
`X2 = NOT(~s1&~s2&~s3)` = s1|s2|s3 — фиттер применил polarity
макроячейки (1 ПТ вместо 3, De Morgan точный на ВСЕХ состояниях). Ядро
v2.1 в отчёте: jam `baud_cnt_D(0) = ~ld_tx_q & ~bc0`, декод bc==15 только
в тиках bit_cnt, строб `ld_tx_q_D` = порт 04h (addr=100, IOM, !WRn,
~|bit_cnt), чтение 05h A1 = ~|bit_cnt, TX = P39 4 ПТ SET, ld_tx_q/shreg
на месте. Глобальное: clk → GCK3; **GSR-сеть НЕ используется** —
штатная архитектура v2.2 (RST — обычный вход, rst_meta/rst_sync +
por_sh<0..7> по X1, 8×160 = 1280 нс) — пункт «GSR: 1» чек-листа v1.0-эпохи
сознательно заменён fallback-вариантом. Чистота: $OpTx$BIN_* = 0,
$OpTx$FX_DC ровно 5 {61,67,70,71,73}, INFO:Cpld:994 нет, WARNING:Xst
нет, WARNING:Cpld:897 ×3 (A<1>, D<5>, D<4>) — бенигный класс п.25
(граница «≤1-2» v1.0-эпохи превышена на 1, по 1 буферному МЦ, на
результат не влияет). PGND: закопанные МЦ ровно {74,75,76,78,79,81,95,
96,98}; READY/CS1 — константы '1' (0 ПТ). ВЕРДИКТ: чек-лист закрыт,
CPLD МОЖНО ШИТЬ (после шунта H1).

**2. ПРОШИВКА ПЗУ `beta/txuart/rom/uart_tx_test`** (asm85, CP1251 канон
+ _utf8-двойник; hex 0000h–0303h, 772 байта; листинг; симулятор).
Сделка: после POR раз в ~200 мс строка «TXUART v2.2 OK N=xx» + CRLF
(xx — счётчик hex mod 256), каждый байт строго после поллинга TXRDY=1
(IN 05h бит A1 — контракт README п.1); индикатор — мультиплекс 1 мс/
разряд: DIG3='t', DIG1/2='-', DIG0 = мл. нибл счётчика; SND молчит
(A4=0 на всех OUT 01h); DI, стек 0E000h (ОЗУ 8000h–FFFFh). CPU
3,125 МГц (T = 320 нс), бод 1 562 500 8N1 — ожидания железа: ~5 строк/с,
«t.-N» на индикаторе.

СИМУЛЯЦИЯ `rom/sim_uart_tx_test.py` (интерпретатор 8085 по РЕАЛЬНОМУ
hex, точные T-состояния Intel 8085A, модель TXRDY: busy 20 T = 6,4 мкс
кадра; модель индикатора; окно 672 мс CPU = 2,1 млн T) — **10/10 ПАСС**:
C0 первый байт при TXRDY=1; C1 84/84 OUT 04h при TXRDY=1 (нарушений
протокола 0); C2 поток 1-в-1 (4 строки, хвост 0); C3 период строк
626 870 T = 200,6 мс; C4 срез 3117 T = 997,4 мкс (−0,3%); C5 фазы
01→02→04→08, глифы 1-в-1, призрак seg→dig < 15 T; C6 SND молчит;
C7 нет HLT. УРОКИ (выловлены симуляцией ДО железа): (1) таблицы
HTAB/DTAB положены НА ГРАНИЦЫ СТРАНИЦ 0200h/0300h — «MVI H,страница +
MOV L,индекс» (первая сборка брала глифы с 0100h+индекс — в UART шли
байты КОДА F3/F3, разряды были мусорные); (2) в UART идёт ASCII
('0'..'9','A'..'F'), а НЕ глиф индикатора (первая сборка слала 3Fh='?');
(3) ассемблер asm85: деление `/` — float («не целое»), старшие байты —
только константы страниц. Баги САМОГО симулятора (исправлены): PUSH 8085
— pre-decrement SP (после push SP указывает на младший байт), rp-пары
(lo,hi) в INX (INX H портил HL → 01F4 давал F402). Тайминги поллинга:
период опроса 27–90 T > 20 T занятости ядра — TXRDY уровень, промаха
нет (прецедент hwuart «период опроса ≪ бита» подтверждён при T = 320 нс).

ДОКУМЕНТЫ: beta/txuart/README.md — шапка «ФИТ ПРОШЁЛ 103/108», раздел
«ФИТ 11-8 23:51 — ЗАКРЫТ», TODO ред. «после фита» (шунт → CPLD → ПЗУ →
ACdE обратно), раздел «Прошивка ПЗУ…», состав v2.2 дополнен. Владельцу:
1) ШУНТ H1 до питания (плата стоит без него после v3.9.8); 2) прошить
CPLD (top_txuart_por6_v22.v + top_txuart.ucf); 3) прошить flash U10
rom/uart_tx_test.hex (нижний банк, A16–A18 заземлены); 4) терминал
1 562 500 8N1, ожидать «TXUART v2.2 OK N=xx»; 5) диагностика отказа:
индикатор жив/строк нет → P39↔CH340G RXD или терминал; нет ничего →
CPU/шина. После железного ОК — вернуть ACdE (DLY 0095h→00AAh).

## 2026-11-09 — txuart v2.2: УЗЕЛ /4 НА 25 МГЦ (ШУНТ) ПО ДИРЕКТИВЕ ВЛАДЕЛЬЦА — RTL + верификация ГОТОВЫ, ждёт фита владельца (XC95108)

Директива владельца (11-9): «Может быть уйти на более простой делитель
тактовой, подать на вход тактовой не 50, а 25, потом /4 и подать на
процессор». Мотивация: запас v2.1 был впритык (105–108 из 108 МЦ).

**Решение (п.34 шапки top_txuart_por6_v22.v):**
- вход CPLD **25 МГц** — перемычка H1 **С ШУНТОМ** (DIV=/4 генератора U7);
  БЕЗ шунта 50 МГц ЗАПРЕЩЕНО (X1 = 12,5 МГц → CPU 6,25 МГц = 1,75×
  разгона ВМ85А/ОЗУ, бод 3,125 М вне CH340G);
- кольцо one-hot **s0..s3** (шаблон п.15, N=7 → N=4) на clk 25 МГц
  (период 160 нс); двойной kill + рестарт из 00 по NOR4; любой из 16
  кодов → one-hot (tb P0a — все 16 кодов проверены на RTL);
- **X1 = s0** (6,25 МГц, duty 1/4: high 40 / low 120 нс — ШИРЕ золотого
  20 нс v3.9.8), **X2 = s1|s2|s3 = ~s0** (3-ПТ OR, класс п.10 — БЕЗ
  одиночной инверсии регистра), внутренний /2 ВМ85А → **CPU 3,125 МГц**
  (T = 320 нс, −12,5 % к золоту);
- **clk25_q ВЫПИЛЕН** — вся логика (rst/TX/FSM/порты) на clk 25 МГц
  НАПРЯМУЮ; частота такта логики 1-в-1 базе (clk25 = clk = 25 МГц),
  тиковые константы (/WE 80 нс, квалификатор 320 нс) живут бит-в-бит;
  «фазовая лотерея» базы закрыта по построению (строб s0 и por-цепь в
  ОДНОМ домене);
- por-цепь: 8 × 160 = **1280 нс** (норма 3 × 320 = 960 нс, запас 1,33 —
  тот же); tb: кромка RESET_IN 1220 нс;
- ядро TXUART **бит-в-бит v2.1** (18 МЦ), бод = 25/16 = **ровно
  1 562 500** (сетка кадров 640 нс/бит не изменилась).

**Безопасность частоты (история):** 4,167 МГц (N=6) отклонена железом
окончательно (ядро ВМ85А, стенд с регулируемым питанием — запись 11-7);
3,571 стабильна у обоих владельцев. 3,125 МГц НИЖЕ доказанно рабочего
пункта — ОЗУ/ВМ85А только в выигрыше.

**Цена (принята владельцем):** FW-константы, калиброванные тактами,
тянутся ×1,143 (DLY 0095h → ~00AAh; программный UART 4800 диагностики
uart_echo → 4200, константы 744 → 651 такт/бит, если используется);
монитор ACdE терминала НЕ использует — индикатор/клавиатура/звук
деградируют безбольно. **ШУНТ H1 ОБЯЗАТЕЛЕН ДО ПОДАЧИ ПИТАНИЯ** (после
v3.9.8 плата стояла без шунта — ПЕРЕСТАВИТЬ).

**Бюджет:** 94 (база v3.9.8-clear) − 3 (транзит) − 3 (узел) − 1
(clk25_q) + 18 (ядро) = 105 наивно; прецедент v1.0 (−2) → **ожидание
101–103, допуск 101–105 ≤ 108**.

**Верификация:** `check_v22.py` **77/77** (CP1251 round-trip; мёртвых
идентификаторов в КОДЕ нет; узел s0..s3; ядро строки 1-в-1 v2.1 — 26
строк; база 1-в-1 v2.1 — 210 строк; порядок объявлений; POR);
`tb_txuart_v22.v` (iverilog, РЕАЛЬНЫЙ RTL) **27/27** (POR-кромка 1220 нс;
X1 ровно 160/40/120 нс; X2 противофаза; кадр 55h — старт ровно 640 нс;
PC-приёмник; busy-drop; статус 02h; сброс посреди кадра; P0a — все 16
кодов кольца). Доказательства ядра v2.1 переносимы (sim 92/92, diffsim
8 283 тика 0 расхождений). Регрессия: tb v2.1 PASSED, v2.1/v2.0/v1.0 не
тронуты. UCF актуализирован (TIMESPEC 25 МГц + шунт; LOC 1-в-1, 72/72).

**Владельцу:** фит `top_txuart_por6_v22.v` (CP1251) + `top_txuart.ucf`,
опции IL 28 / Pterm 18 / Exhaustive OFF / DENSITY; .rpt НА АУДИТ ДО
ПРОШИВКИ; ЖЕЛЕЗО: шунт H1 ДО подачи питания; терминал 1 562 500 8N1
(не изменился). ДО УСПЕШНОГО ФИТА НЕ ШИТЬ.

## 2026-11-08веч-2 — txuart v2.1: СЖАТИЕ ЯДРА 20 → 18 МЦ ПОД XC95108 (директива: «У нас нет еще 144 Xilinx, все так же на 108, смотри отчет фит нее лезет») — RTL + верификация ГОТОВЫ, ждёт фита владельца

Слово владельца: «У нас нет еще 144 Xilinxm все так же на 108, смотри отчет
фит нее лезет» — прислан .rpt 11-8 7:14PM (xc95108, FAILED), заархивирован
владельцем как upload/retro_pcld_top.rpt. АУДИТ ОТЧЁТА ДВА СЛОЯ:

(1) **431 МЦ — ФАНТОМ чужих опций фиттера.** Fitting Status: Design Rule
Checking Failed, ERROR:Cpld:837 «needs at least 431 but only 108 left»,
ERROR:Cpld:868, «No logic has been mapped», 386 незмапленных узлов (296 —
однолитеральные осколки $OpTx$BIN_AND/BIN_STEP, 225+62 — FX_DC/FX_SC),
глобальные GCK/GSR/GTS не назначены. В Compiler Options хвоста: **Exhaustive
Fitting: ON + Input Limit: 1 + Pterm Limit: 1** — при IL/PT=1 коллапсинг
выключен, каждый аддер/мультиплексор рассыпается в 1-ПТ крошки: 111 МЦ
честной логики раздувается в 431 МЦ фантома. INFO:Cpld:994 «pterm limit: 1
and input limit: 1» в успешных .rpt линии НЕ встречается вовсе; успешная
линия всегда Exhaustive OFF + IL 16..28 + Pterm 18 + DENSITY.

(2) **Честный бюджет v2.0 = 111–113 МЦ > 108** (п.31 ред. v2.0: 94 базы − 3
транзит + 20 ядро + 1..2 $OpTx) — на XC95108 v2.0 не влезала и с правильными
опциями (потому целью был XC95144). Директива 11-8веч: 144 НЕТ → сжимаем
ядро, цель СНОВА XC95108.

РЕАЛИЗАЦИЯ v2.1 (beta/txuart/scripts/gen_v21.py, регионы A/B1/D/E + чек-листы
f/g/h из top_txuart_por6_v2_utf8.v): база v3.9.8-clear БИТ-В-БИТ; ядро 20 →
18 МЦ: **adv_q ВЫПИЛЕН** (jam baud_cnt <= 0 вместо <= 1 — первый сдвиг на
ТОТ ЖЕ фронт: лаг adv_q 1 такт скомпенсирован, урок v8/hwuart пересчитан);
**tx_run СВЁРНУТ** (bit_cnt = 1..10 — НОМЕР БИТ-ТАЙМА кадра: 1 = старт,
2..9 = данные, 10 = стоп, 0 = idle; busy = |bit_cnt — 1 ПТ/NOR, TXRDY =
~|bit_cnt, гейт io_wr_tx — 4 inline-литерала в тот же ПТ; на 10-м сдвиге
bit_cnt сам в 0 — TXRDY поднимается в конце стопа, ТОТ ЖЕ тик, что !tx_run
v2.0). shreg 9 бит сам-idle ({A,1'b0}, инжекция '1', сдвиг idle-регистра —
НЕТ-ОП) и ld_tx_q (п.30, регистровый строб с единственным потребителем) —
БЕЗ ИЗМЕНЕНИЙ. БЮДЖЕТ (п.31): наивно 94 − 3 + 18 = 109; ПРЕЦЕДЕНТ v1.0:
наивная сумма 102, фит лёг в 100 (−2 — фиттер сверяет логику ядра с шинной)
→ ОЖИДАНИЕ 105–108 ≤ 108 — ВЛЕЗАЕТ. РЕЗЕРВ п.33 (−1 МЦ, НЕ ПРИМЕНЁН — только
по команде владельца, если фит скажет 109): ld_tx_q → одноразовость от
!wr_seen (регистр базы), строб загрузки станет комбинационным; цена —
теряется тиковая фильтрация декода и тик запаса на данные A.

ВЕРИФИКАЦИЯ (всё зелёное): check_v21.py **131/131** (CP1251 round-trip,
двойники синхронны; мёртвые идентификаторы кода ОТСУТСТВУЮТ — sod_q/
tx_pass/tx_q + НОВЫЕ adv_q/tx_run; 40+ контрольных строк базы бит-в-бит;
структура ядра v2.1: jam 0, tx_idle = ~|bit_cnt, закрытие
(bit_cnt == 4'd10) ? 4'd0; порядок объявлений). sim_txuart_v21.py
(цикл-точная NBA-модель) **92/92** (С1–С9 — те же сценарии). **ДИФСИМ
diffsim_v2_v21.py: 8 283 тика, РАСХОЖДЕНИЙ 0** — обе модели (v2.0 эталон,
v2.1 сжатая) с идентичным стимулом (POR; кадры 55h/00h/FFh/A3h/01h/80h;
поток с поллингом TXRDY; busy-drop; чтение 04h; порты 00h/01h/02h; KBROW;
циклы памяти чтение/запись-writeback; ALE-глюк; OUT 04h в окне POR; сброс
посреди кадра; 40 случайных пауз/миксов) — сравнение после КАЖДОГО тика
всех наблюдаемых выходов (TX, A_out вкл. TXRDY, D_out, CSr_n/CS_n/OEr_n/
OE_n/WE_n, RESET_IN, SID, seg/dig/snd/col, X1/X2) и общих регистров (shreg,
ld_tx_q, state/rd_seen/wr_seen, addr_latch, bus_reg, seg_q/dig_q/snd_q/
kbcol_q, clk25_q, r0..r6, por_sh/por_run, rst-цепь, reset_q). ЛЕГАЛЬНЫЕ
внутренние отличия (на пины не выходят): фаза baud_cnt после jam (1 против
0 — фронты сдвигов совпадают 1-в-1, покрыто строгим равенством shreg);
кодировка bit_cnt (1..10 против 0..9). tb_txuart_v21.v (владельцу, iverilog,
РЕАЛЬНЫЙ RTL) **23/23** — X1 ровно 140 нс, X2 противофаза, старт ровно
640 нс, busy-drop, квалификатор сброса. Регрессия v2.0: check_v2 129/129,
sim_v2 92/92, tb_v2 23/23 (файлы v2.0 не тронуты).

ВЛАДЕЛЬЦУ (TODO ред. v2.1, чек-лист п.32 шапки): 1) ISE: УСТРОЙСТВО
xc95108-15pq100c (ВЕРНУТЬ, если v2.0 ставил xc95144), Top =
top_txuart_por6_v21.v (CP1251), UCF = top_txuart.ucf (ноги НЕ менялись);
2) **ОПЦИИ ФИТТЕРА СВЕРИТЬ: Input Limit 28, Pterm Limit 18, Exhaustive OFF,
Optimization DENSITY** (в прогоне 11-8 7:14PM стояли IL 1 / PT 1 /
Exhaustive ON — класс-урок п.27!); фит и .rpt НА АУДИТ ДО ПРОШИВКИ (кольцо
в FB БЕЗ декодов, X1 = r0, X2 без регистра в фазе, GSR : 1 или fallback,
ядро в GSR-домене, baud_cnt без декода терминального счёта, бит-таймы
bit_cnt 1..10, ld_tx_q в .rpt ЕСТЬ, PGND ровно 9, Xst:1780 НЕТ; МЦ 105–108,
рег ~78, вх.ФБ ~200–212/216, ПТ ~300–340/540, ноги 72/81); 3) если фит
скажет «needs N», N > 108 — НЕ крутить опции самовольно, писать на аудит
(резерв п.33 — только по команде); 4) по успешному фит-у: .jed → железо
(H1 БЕЗ шунта = 50 МГц; осциллограф: X1 = 7,14 МГц duty 1/7, X2
противофаза, RESET_IN низ ~1,04 мкс; терминал 1 562 500 8N1, тест OUT 04h /
поллинг IN 05h). ДО УСПЕШНОГО ФИТА НЕ ШИТЬ.

---

## 2026-11-08веч — txuart v2.0 НА БАЗЕ v3.9.8-clear (директива: «Берем дизайн beta\lowsize 398_clear и переделываем txuart на основе него») — RTL + верификация ГОТОВЫ, цель XC95144, ждёт фита владельца

Вопрос владельца к фиту v1.0: «Опять изменился делитель тактовой частоты -
пропало кольцо, почему?» РАЗБОР ДАЛ ТРИ СЛОЯ: (1) кольца в txuart v1.0 НЕТ
В САМОМ RTL - проект собран от базы v3.9.3 (линия v3.9.2: счётчик mod-7
cnt<2:0> + x1_n; кольцо вернули только в v3.9.7), фиттер ничего не выбрасывал -
уравнения X1/X2 байт-в-байт v3.9.3; (2) база v3.9.3 - до-перемычечная эпоха
25 МГц, а плата с 11-6bis-2 на 50 МГц (H1 без шунта) - известный БЛОКЕР бода
(3,125 М вместо 1 562 500) был лишь один из симптомов; (3) НОВЫЙ ПРОПУЩЕННЫЙ
2х: счётчик v3.9.2 даёт X1 = 2×clk/7 - на 50 МГц входа это 14,29 МГц ->
CPU 7,14 МГц вместо 3,571 (аудит 11-8 применил 2х-анализ только к боду,
отметив CLK_HALF как «селектор ветки, к такту ядра не относящийся»), плюс
FSM/шина на clk 50 напрямую - тайминг XC95108-15 не закроет (собственное
заключение v3.9.8 п.23). Развилка A/B выдана владельцу (A: шунт 25 МГц +
v1.0 mod-16 как есть + откат фиксa v1.1; B: 50 МГц + перенос узла v3.9.8).
РЕШЕНИЕ ВЛАДЕЛЬЦА - ВАРИАНТ B В СИЛЬНОЙ ФОРМЕ: «Берем дизайн beta\lowsize
398_clear и переделываем txuart на основе него».

РЕАЛИЗАЦИЯ v2.0 (beta/txuart/scripts/gen_v2.py, 16 якорных правок E0-E13 из
top_suart_por6_v398_clear_utf8.v): база БИТ-В-БИТ - кольцо r0..r6 (двойной
kill, рестарт NOR7, INIT r0=1) на clk 50, X1 = r0, X2 = OR(r1..r6), clk25_q
/2, por-цепь 50-домена (por_ce = r0, por_sh 8 бит Init=FF), харденинг сброса
п.20/21 (rst_meta/rst_sync/rst_qcnt/rst_press, cpu_rst = rst_press | por_run,
reset_q), FSM шины. ТРАНЗИТ v3.7 ВЫПИЛЕН (sod_q/tx_pass/tx_q, -3 МЦ; SOD P72 -
вход-наблюдатель keep, выход CPU заземлять нельзя). ЯДРО TXUART v1.0
(shreg 9 сам-idle, bit_cnt, baud_cnt mod-16 БЕЗ декода, tx_run, adv_q,
ld_tx_q) - БИТ-В-БИТ, пересажено с (clk, RST) на (CLK25, CPU_RST): такт ядра =
такт ЛОГИКИ v3.9.8 -> бод = 25/16 = РОВНО 1 562 500 - 2х-блокер фита v1.0
снят ПО СТРОЕНИЮ, фикс v1.1 mod-32 НЕ НУЖЕН; GSR-источник ядра = cpu_rst
(п.20) - ядро чистится и в окне POR (v1.0: GSR = сырой RST, POR не покрывал);
RESET_IN = регистр reset_q (бит-в-бит базы; в v1.0 комбинация). io_wr_tx -
+ !rst_press (класс п.21e: оба источника сброса гейтят шинные действия;
страховка - при GSR=cpu_rst FSM в окнах сброса и так в IDLE). КЛАСС-УРОК
поведения: сброс кнопки теперь через квалификатор ~400..440 нс (п.21) - RST
посреди кадра глушит ядро с задержкой (приёмник кадр отбрасывает; в v1.0 было
мгновенно). UCF: ноги 1-в-1 (72/72 LOC нетронуты, gen_ucf_v2.py - 8 правок
комментариев + TIMESPEC 25 -> 50 МГц).

РЕСУРСЫ/УСТРОЙСТВО: база 94/108 МЦ (v398clear-fit1) - 3 транзит + 20 ядро =
111 (+1..2 $OpTx) - НА XC95108 НЕ ВЛЕЗАЕТ => ЦЕЛЬ XC95144-15PQ100C (прогноз
111-113/144, вх.ФБ ~225-240/288, ПТ ~340-370/720, рег ~82, ноги 72/81, PGND 9)
- тот самый чип владельца PQ100AMM0701 F3061064A 15C, попиновая совместимость
доказана 11-8 (BSDL-дифф 0 разногласий, даташиты DS066/DS067, DS063 v5.2).

ВЕРИФИКАЦИЯ: check_v2.py 129/129 (CP1251 round-trip, двойники синхронны,
мёртвые идентификаторы кода ОТСУТСТВУЮТ - sod_q/tx_pass/tx_q/cnt/x1_n/...,
cpu_rst ЖИВ; 40+ контрольных строк базы бит-в-бит - кольцо/por/квалификатор/
FSM; ядро на clk25/cpu_rst; порядок объявлений HDLCompilers:28). sim_txuart_v2.py
(цикл-точная NBA-модель, ДВА домена: тик 20 нс, узел на clk 50, логика/ядро на
clk25; ловушка Python ~1 = -2 в кольцевых уравнениях - NOT = (1-x)) 92/92:
С1 POR кромка ~51 тик = 1020 нс - СОВПАЛ с документацией базы («снятие por_run
на кромке 1020 нс»), X1 период 7 тиков duty 1/7, X2 = ~X1, one-hot; С2 сетка
переходов РОВНО 32 тика (640 нс), PC-приёмник декодирует, shreg сам в 1FF;
С3 поток ABC с поллингом, стопы >= 32; С4 отброс при busy; С5 статус 02h/00h;
С6 гейт POR - GSR держит FSM в IDLE + !por_run, OUT 04h в окне отброшен;
С7 RST посреди кадра - rst_press через ~400 нс, GSR чистит ядро, после снятия
кадр идёт; С8 ALE-глюк до данных кадра не рожает; С9 порты 00-02h/KBROW/
writeback /WE ровно 4 тика (2 такта clk25 = 80 нс)/ПЗУ без /WE/кольцо живо.
tb_txuart_v2.v (владельцу, iverilog, РЕАЛЬНЫЙ RTL, CLKP=20 нс) 23/23 -
X1 период РОВНО 140 нс, X2 противофаза 16 сэмплов вне сетки, старт ровно
640 нс, поллинг/отброс/квалификатор сброса.

Фит-отчёт v1.0 перемещён по месту, заявленному в записи 11-8:
beta/hwuart/retro_pcld_top (txuart-fit1-...).rpt -> beta/txuart/.

ВЛАДЕЛЬЦУ (TODO ред. v2.0, чек-лист п.32 шапки): 1) ISE: Device ->
xc95144-15pq100c, Top = top_txuart_por6_v2.v (CP1251), UCF = top_txuart.ucf;
2) фит IL 16/Pterm 18/Exhaustive OFF/DENSITY (891/892 -> IL 28 -> Exhaustive
ON) -> .rpt НА АУДИТ ДО ПРОШИВКИ (кольцо в FB БЕЗ декодов, X1 = r0, X2 без
регистра в фазе, GSR : 1 или fallback, ядро в GSR-домене, baud_cnt без декода
терминального счёта, PGND ровно 9, Xst:1780 НЕТ); 3) .jed -> железо (H1 уже
без шунта; осциллограф: X1 = 7,14 МГц duty 1/7, X2 противофаза, CLKOUT
3,57 МГц duty 50%; терминал 1 562 500 8N1). ДО УСПЕШНОГО ФИТА НЕ ШИТЬ.

---

## 2026-11-08 — txuart v1.0 ФИТ 1 (11-8 5:10PM): Successful, прогноз п.30 сошёлся, НО БЛОКЕР — бод на плате 2× (3,125 М); НЕ ШИТЬ

Слово владельца: «Отчет по дизайну top_txuart_por6, смотри» — прислан .rpt,
заархивирован: beta/txuart/retro_pcld_top (txuart-fit1-1108-0510PM-SUCCESSFUL).rpt.
Аудит: чек-лист п.31 + симуляция напечатанных уравнений
(scripts/sim_txuart_report.py, sim_fixed_b0.py) + сверка с RTL v1 и с
эталонными фитоотчётами (v3.9.3-fit2 11-2, v398-IL28, hwuart v401-fit1).

СОШЛОСЬ (п.30/п.31): Fitting Status: Successful, 0 ERROR; warnings — только
benign-пара (iSE repo path + BUFG INFO), даже Cpld:897 НЕТ. Ресурсы:
100/108 МЦ [прогноз 102-104 — лучше], 259/540 ПТ [250-280 ✓], 190/216 вх.ФБ
[190-205 ✓], 71 рег [71 ✓], 72/81 ноги; PGND ровно 9 = {74,75,76,78,79,81,
95,96,98} (P75 вернулся ✓); GSR : 1 ✓; sod_q/tx_pass/tx_q/cpu_rst в нетлисте
НЕТ ✓; TX = регистр IO-MC P39, idle '1' (PRE=RST) ✓; CS1 = P99 ✓; IL 28/
DENSITY ✓. СТЕНА Cpld:891 (bit_cnt<3>, у hwuart 213/216 вх.ФБ, Placement
Failed ×4) ВЗЯТА — новация п.28 (регистровый строб ld_tx_q с единственным
потребителем) сработала: 190/216. Генератор X1/X2 (cnt mod-7 + x1_n на
¬clk + XOR-пара, GCK2=¬clk/GCK3=clk) — уравнения БАЙТ-В-БАЙТ рабочей
v3.9.3 (фит 11-2) — база не тронута. bit_cnt 0..9, b1..b3 чистые переносы
(декода терминального счёта НЕТ ✓), декод OUT 04h = T2+IOM+¬WRn+addr(100)+
¬tx_run+¬ld_tx_q+¬por_run ✓ контракту, загрузка {A,1'b0} с живых A-пинов на
тик позже строба ✓, инжекция стопа ✓, shreg сам в idle ✓ — всё подтверждено
симуляцией напечатанной системы уравнений.

БЛОКЕР — БОД 2×: ядро в RTL (`always @(posedge clk)`) считает mod-16 на
50 МГц: тик = 50/16 = 3,125 МГц -> на плате 3,125 Мбод; спека же и tb:
25 МГц/16 = 1 562 500. tb_txuart_v1.v (CLKP = 40 нс = 25 МГц) и
sim_txuart_v1.py (TICK = 40 нс) смоделировали ядро НА 25 МГц — 2×-ошибка
прошла обе проверки. CLK_HALF(1) — селектор ветки X1/X2 (g_div2p5), к такту
ядра НЕ относится. 3,125 М > потолка CH340G (2 Мбит/с) — ПК-сторона не
примет вовсе. ФИКС (минимальный): mod-32 — baud_cnt<4> (+1 МЦ -> 101/108),
adv_q.D += baud_cnt<4> (+1 вх.ФБ, FB4 27/36); бод = 50/32 = ровно
1 562 500 ✓ директиве «удобный делитель»; tb: CLKP = 20 нс (50 МГц),
BITNS = 640 нс — задокументированные 640 нс станут правдой на плате;
localparam [5:0] = 6'd32 (урок 4'd16). Попутно: 1 562 500 ch341 округляет
к 1,5 М (−4%) — в допуске (прецедент: 1,92 М работал с +4%).

КАРТЫ FF В .rpt — НЕ ДЕФЕКТ (пометка в чек-лист приёмки): baud_cnt<0> и
shreg<8> напечатаны cpldfit'ом в ИНВЕРСНОМ домене (выигрыш 1 ПТ на
инверсной обратной связи макроячейки): «D = ¬ld·b0» = (ld ∨ ¬b0) = jam≤1 +
инкремент; «D = ld·¬A7 ∨ ¬ld·¬run·¬s8 ∨ ¬ld·¬adv·¬s8» = загрузка A7 + hold +
инжекция '1' на тике (= {1'b1, shreg[8:1]}). Буквальная трактовка даёт
ложную тревогу («счётчик стоит») — сверять с семантикой RTL. Для
байт-в-байт аудита нетлиста это вторая конвенция печати после FTCPE-инверсии
v3.9.3-линии.

ДАЛЬШЕ: RTL mod-32 -> sim+tb (CLKP 20 нс) -> рефит -> чек-лист п.31 ->
.jed -> железо (терминал 1 562 500 8N1).

---

## 2026-11-08 — txuart v1.0 (beta/txuart): ИСКЛЮЧИТЕЛЬНО АППАРАТНЫЙ ПЕРЕДАТЧИК UART 1 562 500 бод — RTL + верификация ГОТОВЫ, ждёт фита

Директива владельца: «Хорошо давай попробуем организовать исключительно
аппаратный трансмиттер UART, на удобный для счетчиков делителей бод рейтинг,
реализации посмотри в txclient, проект разместим в beta\txuart». База —
lowsize v3.9.3 (фит 11-2 9:54PM прошит и работает, 85/108 МЦ) бит-в-бит;
TX-механика — txclient v8/hwuart v4.0.1 (shreg 9 бит сам-idle через SET-ветку
GSR, jam-фазировка, регистровый хелпер adv_q); TX-транзит v3.7 выпилен
(sod_q/tx_pass/tx_q/cpu_rst, -3 МЦ), SID = RX сохранён, SOD (P72) —
вход-наблюдатель с keep (выход CPU заземлять нельзя).

СПЕКА: TX-only 8N1, бод = 25 МГц / 2^4 = 1 562 500 — «удобный для счетчиков
делителей» рейтинг по директиве: делитель — свободный двоичный mod-16, wrap
НАТУРАЛЬНЫЙ (D = bc+1, декода терминального счёта и сбросовой логики в
D-функциях счётчика НЕТ; у mod-13 hwuart был декод ==12), выбор из списка
альтернатив шапки txclient v8 («16 -> 1 562 500, wrap без декода»; CH340G до
2 Мбит, проверен владельцем на 1,92 М = 25/13). Порты: OUT 04h = TXDATA, IN 05h
= статус {000000, TXRDY, 0} (бит A1 = !tx_run — позиция совместима с hwuart,
чтение механизмом KBROW); IN 04h не определён (RX нет).

КЛЮЧЕВАЯ НОВАЦИЯ п.28 — РЕГИСТРОВЫЙ СТРОБ ЗАГРУЗКИ ld_tx_q, лекарство от
стены вх.ФБ фитов hwuart 11-4/11-5: там декод io_wr_tx (11 литералов) грузил
shreg НАПРЯМУЮ -> 16 потребителей, +42 вх.ФБ, 213/216 (99%), Placement Failed
х3; здесь io_wr_tx (12 литералов, однократный: !tx_run && !ld_tx_q && !por_run)
имеет ЕДИНСТВЕННОГО потребителя (ld_tx_q.D); загрузка {A,1'b0} — на тик позже
строба с живых A-пинов (CPU держит данные до подъёма WRn — запас >= 20 тиков);
D-функция бита shreg = 3 ПТ/~5 вх -> все 9 бит ложатся в ОДИН ФБ (~27 вх <= 36).
Ядро 20 МЦ (shreg 9 + bit_cnt 4 + baud_cnt 4 + tx_run 1 + adv_q 1 + ld_tx_q 1).
Тайминг: jam baud_cnt <= 1 -> старт РОВНО 16 тиков (лаг adv_q 1 такт учтён),
все переходы на сетке 16 тиков; кадр закрывается на 10-м тике ядра (TXRDY
~15-й тик стопа) — при непрерывном поллинге фактический стоп >= 1 полного бита.

ВЕРИФИКАЦИЯ: scripts/sim_txuart_v1.py (цикл-точная модель NBA) — 87/87 ПАСС
(С1 POR 1120 нс/TX idle/X1 5-в-7/X2 противофаза/SID-транзит/статус 02h; С2
кадры 55h/AAh — сетка 16 тиков точная, PC-приёмник декодирует, shreg сам в
1FF; С3 поток "ABC" с поллингом без потерь, стопы >= 16 тиков; С4 отброс при
busy; С5 статус 02h/00h; С6 гейт POR — OUT 04h в окне POR отброшен; С7 RST
посреди кадра — GSR, TX='1' в первый такт, ядро вычищено, после сброса кадр
идёт; С8 ALE-глюк до данных кадра не рожает; С9 регрессия базы: порты
00-02h/KBROW/writeback /WE ровно 2 тика/ПЗУ без /WE). tb_txuart_v1.v
(владельцу, iverilog, РЕАЛЬНЫЙ RTL) — 18/18 ПАСС (старт ровно 640 нс
против RTL). check_v1.py — 76/76 ПАСС (CP1251 round-trip, двойники синхронны,
мёртвых идентификаторов sod_q/tx_pass/tx_q/cpu_rst в коде НЕТ — точка приёмки
Xst:1780 по построению, база бит-в-бит — 20 контрольных строк, порядок
объявлений HDLCompilers:28). По пути пойман класс-урок: BAUD_DIV=16 в 4 бита
НЕ помещается (4'd16 усекается в 0 — iverilog warning) -> localparam [4:0] =
5'd16.

UCF: top_txuart.ucf — ноги hdl/top_suart.ucf 1-в-1 (72/72 LOC сверены
скриптом), PGND 9 {P74,P75,P76,P78,P79,P81,P95,P96,P98} (rx_int НЕТ — P75
возвращается в PGND), комментарии актуализированы. ПРОГНОЗ ФИТА (п.30 шапки):
102-104/108 МЦ, вх.ФБ ~190-205/216, ПТ ~250-280, рег 71, ноги 72/81. Владельцу:
фит в ISE (top_txuart_por6_v1.v CP1251 + top_txuart.ucf), опции IL 16 /
Pterm 18 / Exhaustive OFF / DENSITY -> .rpt НА АУДИТ (чек-лист п.31 шапки +
README: GSR : 1, sod_q/tx_pass/tx_q/cpu_rst в .rpt НЕТ, TX = shreg[0] IO-MC
P39, D baud_cnt без декода терминального счёта, PGND ровно 9) -> .jed и
железо (терминал 1 562 500 8N1). ДО УСПЕШНОГО ФИТА НЕ ШИТЬ. По результату —
механика ld_tx_q кандидат на перенос в hwuart v4.0.2 / txclient v9.

---

## 2026-11-08 — рефит v398_clear ред.2: НЕТЛИСТ 1-В-1 ЗОЛОТОМУ v3.9.8; железо работает

Слово владельца: «Отчет по 398_clear смотри, железо - работает!» — прислан
.rpt рефита ред.2 (11-7 10:09PM, DENSITY, IL 28/Pterm 18/Exhaustive OFF,
Fitting Status: Successful). Лог синтеза XST владелец не слал — новая
точка приёмки ред.2 («Xst:1780 в логе синтеза БЫТЬ НЕ ДОЛЖНО»)
закрывается ПО ПОСТРОЕНИЮ: в RTL ред.2 идентификаторов
cnt/x1_q/x1_p/x1_n/x2_q/x2_p/t0_q нет вовсе (верификатор clear_rev2.py:
«в коде без комментариев нет…»), а XST не может предупреждать о
несуществующих сигналах; в присланном нетлисте их тоже нет.

Аудит `beta/lowsize/scripts/fit_diff_v398clear.py` (отчёты заархивированы
в beta/lowsize/):

- дифф с золотым фитом v3.9.8 `retro_pcld_top (v398-fit1-1106-719PM).rpt`
  (IL 16) — ЕДИНСТВЕННОЕ различие = строка опции Input Limit (16 → 28;
  IL 28 — директива п.25 «остаться на IL 28», золотые IL 16/28 уже сверены
  между собой байт-в-байт);
- с золотым прогоном IL 28 (11-6 7:26PM) — НЕТ РАЗЛИЧИЙ вовсе (кроме
  строки Date) ⇒ .jed рефита = .jed золотого v3.9.8;
- ресурсы 94/108 МЦ, 287/540 ПТ, 183/216 вх.ФБ, 65 рег, 72/81 ноги —
  прогноз чек-листа g) сошёлся: вычеркивание мёртвого кода .rpt не
  изменило;
- точки чек-листа шапки: clk → GCK3 (единственная глобальная), RST = P1,
  кольцо r0..r6 в FB6 (X1/r0 = 2 ПТ, двойной kill), X2 — NOR-форма 1 ПТ/
  6 вх (FB6_5, класс п.10), clk25_q — 1 триггер, por_sh 8 бит Init=FF на
  clk 50, por_run.D = por_sh[0], сброс п.21 (сырой RST — только в
  rst_meta), GSR не свёлся — fallback п.18/20 (как в золотом),
  PGND = {P74,P75,P76,P78,P79,P81,P95,P96,P98}, P73 (SID) вне PGND;
  WARNING:Cpld:897 (D<7>) — известный класс п.25; Xst-варнингов в отчёте
  нет.

Итог: v3.9.8-clear ред.2 ПРИНЯТ ПОЛНОСТЬЮ — RTL-верификатор PASS, tb
сид-в-сид эталону, фит 1-в-1 золотому, железо работает (монитор fw_mon
v2 с F2 на борту). Производственный RTL — top_suart_por6_v398_clear.v;
откат legacy-веток — top_suart_por6_v398.v.

---

## 2026-11-08 — железо: fw_mon v2 работает, F2 подтверждена

Слово владельца: «монитор работает». Полевая проверка fw_mon v2 (Изд. 2,
коммит 04de993): монитор ACdE с клавишей F2 — показ текущего адреса
операций (вид «8012», повторное F2 возвращает прежний экран) — прошит во
flash (fw_mon.hex, 1041 байт, offset 0, 4800 8N1) и работает на плате.
Петля по F2 закрыта: офлайн-верификация 54/54 → железо ПАСС.

Остаток приёмки v398_clear ред.2 за владельцем: формальный рефит в ISE —
ожидается .jed 1-в-1 с v3.9.8 и ПОЛНОЕ ОТСУТСТВИЕ WARNING:Xst:1780 в логе
(новая точка приёмки ред.2), .rpt сверить по чек-листу g) шапки.

---

## 2026-11-07 — v398_clear ред.2: мёртвый код вычеркнут, Xst:1780 — НЕТ

Слово владельца (после фита ред.1): «ты плохо почистил 398_clear, например
там остались неиспользуемые сигналы» — WARNING:Xst:1780 (Signal is never
used or assigned) по x2_q, x2_p, x1_q, x1_p, x1_n, t0_q, cnt — «кроме того
в комментариях осталась информация о тех блоках которые уже не реализуются
в этой версии дизайна, прибери тщательно, отчет об очистке выведи».

Сделано (870 → 803 строки):

- Из RTL вычеркнуты legacy-ветки делителя g_div2/g_div4/g_div_even/g_div_odd,
  их регистры cnt/x1_q/t0_q/x1_p/x1_n/x2_q/x2_p и localparam MEV/NMOD/NHALF —
  в generate осталась единственная ветка узла g_div2p5. Нюанс сборки:
  закрывающий `end` целевой ветки стоял В ОДНОЙ СТРОКЕ с `else if`
  («    end else if (CLK_DIV == 2) begin : g_div2») — при вычёркивании
  веток его надо сохранять, иначе синтаксическая ошибка (поймано разбором,
  компиляция tb подтверждает).
- Из шапки вычищены описания legacy-механики: п.17 («оставлены в коде
  ДЛЯ ОТКАТА»), п.23 (оговорка про декларацию x1_n «для legacy g_div_odd»),
  TODO 3, чек-лист h) — переписаны под факт «вычеркнуто из RTL»; чек-лист
  g) дополнен ожиданием «ресурсы 1-в-1 с v3.9.8».
- Почему .jed не меняется: эти сигналы и в v3.9.8 НЕ попадали в нетлист
  (XST их триммил — те самые Xst:1780), поэтому нетлист/ресурсы/тайминги
  ожидаются 1-в-1 с v3.9.8; в логе синтеза Xst:1780 БОЛЬШЕ НЕТ — новая
  точка приёмки фита (TODO 3). Откат legacy-веток — исходник
  top_suart_por6_v398.v.

Верификация (`beta/lowsize/scripts/clear_rev2.py` — новый верификатор/
сборщик ред.2; генератор ред.1 gen_v398_clear.py выведен из действия и
передаёт управление туда же): тело clear == тело v3.9.8 + ТОЛЬКО 9
документированных правок (поблочная сверка с базой); вычеркнутые
идентификаторы в коде без комментариев отсутствуют; единственная ветка
generate закрыта `end`; CP1251 round-trip; _utf8-двойник байт-в-байт;
хвост — `endmodule` без завершающего \n, как у базы. tb_poweron_v398
(Icarus 12.0) на ред.2 — полный лог равен логу ред.1
(`scripts/tb_poweron_v398_clear.log`), RESULT-строки сид-в-сид эталону
v3.9.8 (P0a 2560 PASS, P0b, P1 3/100 принятого класса окна, P2–P5 PASS).

---

## 2026-11-07 — ВЕРДИКТ: 4,167 МГц отклонена железом окончательно, кампания частоты ЗАКРЫТА

Слово владельца: «Нет, у коллеги не пошел 8085 даже на повышенном напряжении
питания, отставим попытки выбраться за 4МГц».

Стенд коллеги (платформа с регулируемым напряжением) — решающий эксперимент:
повышение питания НЕ оживило CPU на 4,167 МГц → потолок НЕ в питании и НЕ в
тактовом тракте CPLD (у владельца POST «8.8.8.8» на 4,17 шёл стабильно), а
в ядре ИМ1281ВМ85А. Вердикт первой кампании 10-29/30 («виновато ядро»)
подтверждён независимым стендом и на новой архитектуре тактирования.

Итог второй кампании (v3.9.9h): предел экземпляра лежит между 3,571 МГц
(N=7 — работает стабильно у обоих владельцев) и 4,167 МГц (N=6 — не стартует
ни у кого); лестница 25/N дискретна, промежуточных шагов нет. Попытки
«выбраться за 4 МГц» отставлены директивой владельца. Производство —
**v3.9.8** (3,571 МГц). Польза от кампании: (1) архитектура «кольцо N=6
напрямую от 50 МГц» проверена в кремнии (фит золотой, лучший POST в истории
hiclock-линии); (2) v3.9.9h остаётся готовым кандидатом на случай
экземпляра ВМ85А с лучшим частотным потенциалом. Детали — в
`beta/hiclock/README.md` (раздел «ФИНАЛ 11-7»).

## 2026-11-07 — наблюдение железа: v3.9.9h (4,167 МГц) дошла до «8.8.8.8»

Слово владельца (цитата):

> «Ты прав на этом желез дальше по частоте мы ни как не можем продвинуться,
> возможно сдерживает питание, на моей плате не запустилась, но есть важное
> наблюдение оно стартует и гасит 8.8.8.8 и делает это стабильно. Раньше все
> hiclock версии такого не смогли сделать. Мы проверим этот изайн еще у
> одного моего коллеги у него регулируется напряжение на плате.»

Технический смысл (наша трактовка): «8.8.8.8» — сбросовый паттерн индикатора
(seg_q=8'hFF / dig_q=4'hF при cpu_rst) плюс POST прошивки; его появление И
ГАШЕНИЕ означают, что CPU стартует и исполняет прошивку (блэнкинг, клк10-67)
— то есть тракт CPLD→CPU работает и на 4,167 МГц. Ни одна версия первой
кампании 10-29/30 этого не давала (v3.10 «не тянет», v3.11 — частичный
старт: терминал есть, «85» на дисплее нет). Полный запуск не состоялся —
главный подозреваемый теперь ПИТАНИЕ; план — проверка у коллеги на плате с
регулируемым напряжением. Детали — в `beta/hiclock/README.md` (раздел
«Железо 11-7»).

## 2026-11-07 — v398_clear: чистка комментариев; дневник — здесь

Директива владельца: исторический мусор из комментариев
`beta/lowsize/top_suart_por6_v398.v` вынести в этот дневник, в дизайне
оставить только действующие решения, дизайн назвать **v398_clear**.

- Создан `beta/lowsize/top_suart_por6_v398_clear.v` (+ `_utf8` копия):
  **КОД БИТ-В-БИТ v3.9.8** — тело файла (от `module` до конца) копируется
  дословно; проверяет генератор `beta/lowsize/scripts/gen_v398_clear.py`
  (совпадение кода без комментариев — байт-в-байт, тело дословно, CP1251
  round-trip). Шапка сокращена: 937 → ~190 строк.
- В чистой шапке СОХРАНЕНА нумерация п.хх v3.9.8 — все ссылки «п.XX шапки»
  в теле файла остаются валидными; исторические номера (п.1, 2, 7, 11, 12,
  14, 17, 19) даны заглушками с адресом на этот дневник.
- Вся история шапки v3.9.8 (строки 1–937: п.1–п.25, TODO, чек-лист) —
  дословно в разделе «Архив шапки v3.9.8» ниже.
- Про варнинги XST «сигнал не используется» (вопрос владельца): это
  ожидаемые предупреждения, НЕ мусор в RTL — XST компилирует **все** ветки
  generate, а legacy-ветки делителя (div2/div4/чёт/нечёт) существуют ради
  отката и при целевой конфигурации (2,1) элайзятся; их отсутствие в
  нетлисте проверяет чек-лист h). WARNING:Cpld:897 (буфер D<7>) — известный
  класс п.25, не блокер. Ветки отката в v398_clear СОХРАНЕНЫ (действующее
  решение, не мусор); заодно исправлено устаревшее «2048 комбинаций»
  P0a → фактические 2560 (128 колец × 10 por_sh × 2 фазы) — по TB и логу.
- Пункт 3 (перенос hiclock/): коммит 3216e29 (11-6) уже перенёс `hiclock/`
  → `beta/hiclock/` (корневая папка удалена); 11-7 коммит запушен в GitHub —
  у владельца в репозитории корневой `hiclock/` больше нет.

---

## Архив: шапка top_suart_por6_v398.v (v3.9.8, строки 1–937, дословно)

Ниже — ПОЛНЫЙ текст шапки v3.9.8 до чистки (история v1→v3.9.8: п.1–п.25,
TODO владельцу, чек-лист .rpt, топология). Сохраняется как есть, правок
нет.

```verilog
//=====================================================================
// top_suart.v v3.9.8 - retro_pcld_top + SOFT-UART ТРАНЗИТЫ + CPU 3,57 МГц (вход CPLD 50 МГц - H1 без шунта; КОЛЬЦО one-hot r0..r6 на clk 50, X1 = r0 duty 1/7, X2 = r1|..|r6 = ~r0, clk25 = /2 для логики, por-цепь на clk 50 со стробом r0, п.23; CS_n от FSM, п.16; СБРОС ЛОГИКИ -> СЕТЬ GSR, п.18, В Т.Ч. ВЕСЬ POR - источник GSR = cpu_rst, п.20; ХАРДРЕНИНГ СБРОСА: RST только через регистры (синхронизатор + квалификатор), RESET_IN - регистр reset_q, п.21)
// (Task 77, 2026-10-20; v3.1 POR_W 14->6, v3.2 por_run регистровый - 2026-10-22;
//  v3.4 декод-иммунный патч clk10-35 - 2026-10-28; v3.5 регистровая
//  противофаза X2 clk10-41 - 2026-10-28; v3.6 полуцелый делитель 25/2,5 ->
//  X1/X2 = 10 МГц, CPU 5 МГц - 2026-10-29; v3.7 TX-маска txm_cnt УДАЛЕНА,
//  захват по первому SOD='1' - 2026-10-29; v3.8 делитель = one-hot кольцо
//  вместо двоичного mod-5 - 2026-10-29; v3.9 кольцо расширено 5 -> 7
//  триггеров: X1/X2 = 7,14 МГц, CPU 3,57 МГц (экземпляр ИМ1281ВМ85А 5 МГц
//  не тянет - нестабильный старт) - 2026-10-29; v3.9.1 CS_n в writeback
//  от состояния FSM, защёлка wb_ram_q удалена (п.16) - 2026-10-30;
//  v3.9.2 делитель: кольцо one-hot N=7 -> двоичный счётчик mod-7,
//  линия lowsize (п.17) - 2026-10-30; v3.9.3 сброс логики -> СЕТЬ GSR,
//  асинхронный (мера снижения ресурсов, п.18) - 2026-11-02; v3.9.4 POR-
//  счётчик 8->4 со стробом x1_n (М1 из txclient v8, п.19) - 2026-11-05;
//  v3.9.5 GSR-источник = cpu_rst (п.20) - 2026-11-05; v3.9.6 хардренинг
//  сброса: RST только через регистры (п.21) - 2026-11-06; v3.9.7 возврат
//  кольцевого делителя one-hot (п.22) - 2026-11-06; v3.9.8 узел
//  тактирования на 50 МГц: кольцо напрямую, X1 = r0, clk25 = /2 для
//  логики, por-цепь на clk 50 (п.23, схема владельца) - 2026-11-06).
//  База: v1 (Task 70-a, логика чтения/захвата
// не тронута), X1 поднят 1,5625 -> 5 МГц (CPU 781,25 кГц -> 2,5 МГц,
// T = 400 нс) - план одобрен владельцем («Делаем!»).
//
// ЧТО ИЗМЕНЕНО в v3 (против v1):
//  1) ДЕЛИТЕЛЬ: XOR-пара /5 от 25 МГц -> X1 = 5 МГц с РОВНО 50% duty
//     (100/100 нс): триггер x1_p переключается по posedge при cnt==0,
//     триггер x1_n - по negedge при cnt==3 (=(N+1)/2 для нечётного N!),
//     X1 = p XOR n. INIT x1_p=1, x1_n=0 -> X1 стартует с '1' (как
//     в .rpt: X1 Init=SET).
//     ВНИМАНИЕ: вариант «negedge при cnt==2» из черновика плана даёт
//     60/140 нс (30/70) - ЗАБРАКОВАН; правильный декод (N+1)/2 (здесь
//     cnt==3), проверен разбором фронтов и тестбенчем (duty-monitor
//     90..110 нс).
//     Параметр CLK_DIV для отката: чётное N -> простой toggle-триггер
//     (X1 = 25/N МГц, 50%), нечётное N -> XOR-пара. CLK_DIV=8 -> X1
//     3,125 МГц (режим v2). Возврат к v1 (X1 1,5625) - старый файл из
//     git-истории (mod-16).
//  2) POR_W 12 -> 14: квант = период X1 = 200 нс -> POR = 16384x200 нс =
//     3,28 мс (в v1 было 2,62 мс при кванте 640 нс; порядок длительности
//     сохранён для медленных блоков питания).
//  3) TX-ТРАНЗИТ С ЗАХВАТОМ (v3.7, замена TX-маски v2-v3.6, txm_cnt
//     УДАЛЁН - см. п.13): датасшит (вывод SR) - аппаратный сброс CPU
//     очищает SOD в '0', и до первого SIM прошивки линия '0' = «вечный
//     start-bit» -> пустой фрейм в терминале. В v3.7 транзит открывает
//     ПЕРВЫЙ сэмпл SOD='1' (TXIDLE прошивки) - захват ПО УРОВНЮ, без
//     счётчика и без привязки к частоте; в сбросе и до захвата TX='1'
//     (чистый idle, без BREAK).
//  4) WRITEBACK - ЗАЩИЩЁННЫЙ ИМПУЛЬС /WE (главное изменение шины!).
//     При T=400 нс реальный зазор WR#(вверх)->след.ALE = 0,25..0,45 T =
//     100..180 нс (плата: 320..580 нс при T=1280; PUSH = write-write).
//     Схема v1 «3 тика выдержки + обрыв по ALE» здесь ТЕРЯЕТ запись
//     (ALE обрывает /WE до импульса -> PUSH портит стек!). В v3:
//     hold-off 3 -> 0 (WBW удалён) и импульс /WE ДОВОДИТСЯ ДО КОНЦА
//     НЕЗАВИСИМО ОТ ALE; драйверы A/D держат СТАРЫЙ адрес/данные до
//     конца импульса. Конфликт с новым адресом CPU (если ALE успел)
//     выигрывает CPLD (24 мА против 2 мА у ВМ85), адрес на входах ОЗУ
//     стабилен весь импульс (t_AS 40 нс, /WE 80 нс), запись попадает
//     по адресу.
//     Почему hold-off РОВНО 0 (а не 1 по плану): после импульса автомат
//     должен УСПЕТЬ в T1H и захватить адрес СЛЕДУЮЩЕГО цикла до
//     ALE#спада. Зазор для этого = ALE#спад - (WR#+P+160) = gap-P-100:
//     при gap=100, P=40 остаётся 0 нс - захват НЕ происходит (поймано
//     в tb, T3c писала по старому адресу!). С hold-off 0: всё закрывается
//     с запасом >= 2 тактов при любом gap >= 100 нс (0,25T). t_DH-GARD
//     не нужен: данные записи уже в bus_reg (захват в T2), а бой на
//     A-сетях выигрывает CPLD (слабый драйвер TB = 2 мА у CPU).
//     Область конфликта <= 60 нс, штатный режим (tb: wb_fight считается
//     отдельно; все проверки t_AS/t_WP/wdel в tb остаются).
//  5) /CE ОЗУ ВО ВРЕМЯ WRITEBACK - ЗАЩЁЛКНУТЫЙ (wb_ram_q, +1 триггер):
//     живой декод CS_n=!A15|IOM во время конфликта адресов читал бы
//     НОВЫЙ адрес CPU и мог сорвать запись (новый адрес = ROM). Защёлка
//     ставится в момент захвата строба (T2, A15/IOM стабильны до конца
//     цикла). В v3.9.1 защёлка УДАЛЕНА - п.16: CS_n в WB от состояния
//     FSM, эквивалентность доказана.
//  6) ЗАХВАТ T1H СТРУКТУРНО ЗАЩИЩЁН: из WB в T1H можно попасть только
//     через IDLE, поэтому addr_latch НЕ перезаписывается посреди
//     импульса. Цепочка WB сжата до 4 состояний (hold-off 0), чтобы
//     успеть захватить адрес СЛЕДУЮЩЕГО цикла в T1 при зазоре
//     100 нс (см. п.4).
// ЧТО ИЗМЕНЕНО в v3.1/v3.2 (2026-10-22, одобрено владельцем «Делаем POR_W = 6»):
//  7) POR_W 14 -> 6: POR = 2^6 x 200 нс = 12,8 мкс = 32 такта CLK OUT
//     (было 3,28 мс = 8192 такта - запас x2730). Даташит 8085A/P8085AH
//     (1821ВМ85А - функциональный аналог 80C85): «RESET IN should be kept
//     low a minimum of three clock periods» ПОСЛЕ power-up = 3 x 400 нс =
//     1,2 мкс при работающем клоке; запас x10. CLK OUT (CPU.37, P83)
//     тикает весь интервал сброса - процессорные структуры тактируются
//     и готовы (аргумент владельца), квитанция CPU - RSTOUT=1 (P70).
//     Счёт стартует только при живом clk 25 МГц (por_ce из делителя),
//     INIT=FF держит RESET_IN=0 до всякого клока; покрытие подъёма VCC
//     проверяется осциллограммой включения (VCC / RESET_IN P84 /
//     CLKOUT P83 / RSTOUT P70). Экономия: por_cnt 14 -> 6 = -8 MC
//     (100/108 -> ~92/108), por_run 14 -> 6 входов, T-цепи заимствования
//     короче, путь por_cnt->seg/dig (36 нс) укорачивается.
//  8) v3.2 (10-22, фит v3.1 упал - Placement Failed): por_run сделан
//     РЕГИСТРОМ (+1 MC). Механизм отказа: комб. por_run=(por_cnt!=0)
//     из 6 бит фиттер СХЛОПНУЛ в PT всех приёмников cpu_rst -> ширина
//     PT и число FB-входов выросли (209/216), 12 выходов ушли в
//     BUFR-буферы (+12 MC, WARNING 897; всего 104 MC), хелпер
//     $OpTx$FX_SC$257 (8 PT/15 входов) не поместился ни в один FB
//     (ERROR:Cpld:892/868). В v3 (14 бит) порог схлопывания не пускал -
//     обходились локальными копиями декода POR ($OpTx$FX_DC, 27 шт).
//     FF-выход не схлопывается в принципе - структура стабильна.
//     Ожидание v3.2: MC ~95, буферы ~3 (как v3), фит ОК.
//
// ЧТО ИЗМЕНЕНО в v3.4 (2026-10-28, декод-иммунный патч clk10-35):
//  9) Фиттер ТРИ раза терял полярность на свёрнутых декодах равенства:
//     фит 7:31 - cnt_T0=(cnt==4) БЕЗ инверсии (счётчик залип -> X1=X2=
//     12,5 МГц) и por_cnt(0): T=NOT en (POR схлопнулся до 1 клока);
//     фит 8:55 (CLK_DIV=2) - cnt_T(0)=(cnt==0) снова без инверсии
//     (X1 замерзает: тактовой нет вообще), por_run.D=(por_cnt==0)
//     инвертировано (сброс снимается за 1 клок), X2 стал РЕГИСТРОМ с
//     D=D(x1_q) - X2 В ФАЗЕ с X1 вместо противофазы. Не чиним
//     инструмент - убираем класс конструкций целиком:
//     - чётные ветки 2/4 = ЦЕПОЧКИ TOGGLE-ТРИГГЕРОВ: /2 -> x1_q тогглит
//       каждый клок; /4 -> t0_q=clk/2, x1_q тогглит при t0_q=1. Вентиля -
//       1-2 литерала, декодов равенства НЕТ (нечему терять полярность);
//     - POR = 8-бит сдвиговый регистр por_sh (INIT=FF): по por_ce сдвиг
//       вправо, 0 в MSB, bit0 очищается ПОСЛЕДНИМ; por_run.D = por_sh[0].
//       Декоды (por_cnt==0)/(por_cnt!=0) исчезли из нетлиста. POR =
//       8 x por_ce = 8 x 160 нс = 1,28 мкс @ CLK_DIV=4/25 МГц (норма:
//       3 такта CLK OUT = 0,96 мкс @ 3,125 МГц, запас 1,33x). Повторный
//       POR невозможен: после 00 сдвиг держит нули. por_run остаётся
//       РЕГИСТРОМ (v3.2, п.8 - защита от Placement Failed);
//     - нечётная ветка (XOR-пара) и fallback чётных N>=6 (счётчик cnt)
//       НЕ тронуты - при CLK_DIV=4 элайзятся; txm_cnt не тронут (оба
//       фита печатали его бит в бит - на этом узле инструмент не сбит);
//     - CLK_DIV 5 -> 4: замер подтверждён (12 МГц на X1/X2 старого
//       джеда = GCK3/2 = 25/2) -> U7 = LTC6905-100, GCK3 = 25,00 МГц
//       (версия -80 НЕ подтвердилась). X1 = 6,25 МГц duty 50%, CPU =
//       3,125 МГц (в ТУ ВМ85А: до 5), CLK OUT = 3,125 МГц, терминал
//       6000 8N1 (ПЗУ fw_mon v5 НЕ перешивается: бод масштабируется
//       клоком, 4800 @ 2,5 МГц -> 6000 @ 3,125 МГц). CLK_DIV=2 не
//       годится: CPU 6,25 МГц - ВНЕ ТУ;
//     - X2 = ~X1 сохранён (фикс clk10-29/30/32); на порт X2 добавлен
//       keep - страховка от same-D регистра (дефект фита 8:55);
//     - бюджет MC (план clk10-35): -12 (cnt 4 + por_cnt 6 + BUF) /
//       +10 (t0_q 1 + por_sh 8 + por_run) -> ожидаем ~98 MC.
//
// ЧТО ИЗМЕНЕНО в v3.5 (2026-10-28, регистровая противофаза X2, clk10-39/41):
// 10) Фит v3.4 (10:06PM) подтвердил худшее: комб. assign X2 = ~X1 фиттер
//     снова поднял в регистр FDCPE с D = XOR(x1_q, t0_q) = D(x1_q) -
//     X2 В ФАЗЕ с X1 (keep-страховка на порте НЕ сработала). CPU в
//     железе не задет (clk10-38: монитор работает, X2 тактирует CPU),
//     но противофаза - требование даташита ВМ85А; чиним ПО ПОСТРОЕНИЮ:
//     X2 = РЕГИСТР с D, ОТЛИЧНЫМ от D(x1) -> same-D слияние невозможно:
//     - div2: x2_q <= x1_q - задержка 1 клок = ПОЛПЕРИОДА (период 2 клока),
//       D(x2_q)=x1_q != D(x1_q)=~x1_q; init (x1_q=1, x2_q=0);
//     - div4: x2_q <= ~(x1_q ^ t0_q): x1_q_next = x1_q ^ t0_q, т.е.
//       x2_q(t+1) = ~x1_q(t+1) - точная противофаза с 0-го такта
//       (трасса фронтов: x1 1,1,0,0,...; x2 0,0,1,1,...);
//       D(x2_q)=XNOR(x1_q,t0_q) != D(x1_q)=XOR(x1_q,t0_q);
//     - fallback чётных N>=6: x2_q тогглит при cnt==MEV СИНХРОННО с
//       x1_q, init (1,0) -> комплементарны всегда (toggle-пара);
//     - нечётная ветка: x2_p - двойник x1_p (posedge при cnt==0, INIT
//       инверсный), X2 = x2_p ^ x1_n = ~x1_p ^ x1_n = ~X1 ТОЧНО, без
//       сдвига duty (вариант «задержка на клок» ломал бы 50/50 при N=5);
//     - keep на порте X2 сохранён (держит сеть отдельной);
//     - бюджет: +1 MC в каждой чётной ветке, +1 MC (x2_p) в нечётной.
//
// ЧТО ИЗМЕНЕНО в v3.6 (2026-10-29, полуцелый делитель 25/2,5, clk10-49):
// 11) ДЕЛИТЕЛЬ: целевой режим владельца - X1/X2 = 10 МГц -> CPU 5,000 МГц
//     (ровно паспортный максимум ВМ85А, БЕЗ разгона; вариант «/2» ->
//     12,5 МГц / CPU 6,25 ОТКЛОНЁН владельцем как разгон). Внешний
//     каскад НЕ тронут: U7 (LTC6905-100) -> шунт H1 1-2 (DIV=GND, /4)
//     -> GCK3 = 25,00 МГц (замер Task 29-d). 25/10 = 2,5 - деление
//     ПОЛУЦЕЛОЕ, toggle-каскадом недостижимо -> НОВАЯ ветка g_div2p5
//     (выбор: CLK_DIV=2 + НОВЫЙ параметр CLK_HALF=1):
//     - cnt: mod-5 по posedge (0..4), wrap по декоду cnt==4;
//     - x1_p (posedge, INIT=1): D = (cnt != 4) -> '1' интервалы
//       [0,160)+[200,360)... нс (по 160 нс, low по 40 в [160,200)+200k);
//     - x1_n (NEGEDGE, INIT=0): set при cnt==2 (t=60+200k), clear при
//       cnt==3 (t=100+200k) -> '1' импульсы 40 нс в [60,100)+200k;
//     - X1 = x1_p ^ x1_n: узор по полутактам 20 нс "11100" повтор ->
//       фронты через РОВНО 100 нс = 10,000 МГц (high 60 / low 40 нс,
//       duty 60/40). Контраст с «наивным» posedge-делением (фронты
//       80/120 нс, период плавает): negedge-сдвиг n выравнивает
//       ПЕРИОД. Duty X1 процессору безразличен: внутренний /2 ВМ85А
//       тактируется ФРОНТАМИ -> CLK = 5,000 МГц, период 200 нс,
//       duty РОВНО 50/50;
//     - x2_p (posedge, INIT=0): D = (cnt == 4) = НЕ D(x1_p), двойник с
//       инверсным INIT (механизм п.10) -> X2 = x2_p ^ x1_n = ~x1_p ^
//       x1_n = ~X1 ТОЧНО с 0-го такта; same-D слияние невозможно;
//     - init (x1_p=1, x1_n=0, x2_p=0) = установившийся узор -> X1
//       стартует '1' (X2 '0') БЕЗ переходного процесса;
//     - регистры ТОЛЬКО существующие (cnt/x1_p/x1_n/x2_p объявлены под
//       legacy-ветки, при (2,1) принадлежат целевой ветке): +3 MC
//       против ветки div4 (t0_q/x1_q/x2_q элайзятся) -> ~98/108;
//     - por_ce = (cnt==4)|(cnt==1): сэмпл по posedge в t=40+200k и
//       t=160+200k -> 1 импульс за период X1 (120/80 нс попеременно,
//       в среднем ровно 100 нс);
//     - ВНИМАНИЕ п.9: в ветке 4 ДЕКОДА (==4/==1/==2/==3) - mod-5 иначе
//       недостижим; аудит .rpt по чек-листу g)-h) ОБЯЗАТЕЛЕН
//       (полярности декодов!).
// 12) ПОСЛЕДСТВИЯ 10 МГц (пересчёт от v3.4, всё в ТУ):
//     - CLK OUT (CPU.37) = 5,000 МГц, T = 200 нс, duty ровно 50%;
//     - POR = 8 x por_ce = 800 нс (норма 3 такта CLK = 600 нс, запас
//       1,33x - ТОТ ЖЕ, что в v3.4 при 6,25);
//     - окно TX-маски 2^8 x 100 нс = 25,6 мкс; окно SOD=0 после сброса
//       сжимается до ~4-20 мкс (код ПЗУ неизменен, такт в 1,6 раза
//       быстрее) - запас 1,28x ТОТ ЖЕ, что в v3.4; TXM_W=8 НЕ тронут;
//     - терминал: 6000 8N1 -> РОВНО 9600 8N1 (ПЗУ fw_mon v5 не
//       перешивается: 4800 @ CPU 2,5 -> 6000 @ 3,125 -> 9600 @ 5 МГц);
//     - автомат шины: WB-импульс 160 нс < зазора WR#(вверх)->ALE
//       (1 T = 200 нс при CPU 5 МГц), конфликтная область на A-сетях
//       <= 60 нс (п.4) - без изменений; остальное байт-в-байт v3.5.
//
// 13) УПРОЩЕНИЕ TX-ТРАКТА (v3.7, clk10-51): «хвост экспериментов» в
//     UART-линии вырезан. Было (v2-v3.6): txm_cnt<7:0> (8 FF, ~9 МЦ,
//     почти весь FB4) тикал по por_ce и через 2^TXM_W=256 тиков (25,6
//     мкс @ 10 МГц) открывал транзит TX=SOD; до того TX='1'. Мотив
//     маски - датасшит IM1821ВМ85А (вывод SR): «...установку в исходное
//     (нулевое) состояние ... триггеров входа INR4 и ВЫХОДА TFD» -
//     сброс CPU очищает SOD в '0', прошивка поднимает линию первым
//     SIM'ом через ~4-20 мкс (TXIDLE fw_mon v5) -> голый транзит =
//     «фиктивный start-bit», пустой фрейм в терминале (наблюдалось
//     в v2-эпоху). Стало: txm_cnt и параметр TXM_W удалены; sod_q
//     (IO-MC входа SOD) синхронизирует вход по clk 25 МГц; tx_pass
//     (1 лог. MC) захватывает линию по ПЕРВОМУ SOD='1' после сброса
//     (async clear по cpu_rst); tx_q (регистр IO-MC пина TX, INIT=1,
//     async set по cpu_rst) выдаёт TX. Итог: -7..-8 МЦ (прогноз
//     ~102 -> ~94/108), FB4 почти пуст; окно SOD=0 покрыто ПО СТРОЕНИЮ
//     (ноль не пропускается, пока прошивка сама не поднимет линию) -
//     TXM_W, запас 1,28x и привязка к частоте X1/CPU упразднены
//     (работает на 3,125/5/6,25 МГц и с любой длиной init); латентность
//     транзита <= 2 такта 25 МГц (80 нс = 0,4 такта CLK 200 нс = 0,08%
//     бита 9600); сброс/кнопка уводят TX='1' мгновенно (async set, без
//     клока). Требование к прошивке одно - первое касание SOD после
//     сброса = SOD:=1 (fw_mon v5 делает это в TXIDLE; любой soft-UART
//     начинает кадр с idle '1'). Теоретическое слабое место: ложный
//     SOD='1' в окне (звон шины выше VIH) открыл бы захват раньше -
//     физически невероятен (вход CPU в сбросе статичен); лечение -
//     захват по 2 сэмплам подряд (+1 FF, см. симуляцию v3.7).
//
// ЧТО ИЗМЕНЕНО в v3.8 (2026-10-29, делитель = one-hot кольцо, clk10-52):
// 14) ДВОИЧНЫЙ mod-5 СЧЁТЧИК ЗАМЕНЁН 5-ТРИГГЕРНЫМ КОЛЬЦОМ-СДВИГОМ
//     (идея владельца и коллеги: «кольцевой счётчик на сдвиговом
//     регистре»). Мотивация по фиту v3.6 (10-29,Successful): МЦ 102/108,
//     входы ФБ 197/216 - стена по ВХОДАМ ФБ (4 ФБ на 35-36/36, FB6
//     Exhausted 36/36), птермов свободно половина. Узел платил входную
//     ренту В ДВА ФБ сразу: FB6 (пины X1/X2) ел cnt<0..3> + x1_p/x2_p/
//     x1_n = 7 входов из 36; FB4 ел cnt<0..3> + x1_n = 5 (+копия декода
//     por_ce $OpTx$FX_DC$163 на 4 литерала cnt<0..3>). В кольце
//     СОСТОЯНИЕ = ВЫХОД ТРИГГЕРА: все 4 декода равенства (==4 wrap,
//     ==1, ==2, ==3) исчезают - терять полярность нечему (класс п.9
//     добит в последнем узле тактового тракта; аудит чек-листа h)
//     упрощается до сравнения 1-2 литеральных птермов). Плюс:
//     -1 МЦ (счётчик в нетлисте фита v3.6 = 4 триггера: cnt<3> выжил
//     как балласт 4-го бита; кольцу нужно ровно 5+1); птермы узла
//     11 -> 8, макс. ширина литерала 4 -> 2 (у рестарта - 5); входы:
//     FB6 7 -> 6, FB4 5 -> 0..2, копии por_ce: 4 литерала cnt ->
//     2 литерала r1/r4.
//     ПОСТРОЕНИЕ (эквивалентность v3.6 доказана трассировкой фронтов и
//     scripts/sim_v38_ring.py - 200 мкс байт-в-байт, ПАСС):
//     - r0..r4: one-hot сдвиг по posedge: r_i <= r_{i-1} & ~r_{i+1} &
//       & ~r_i («убей преемника»). В легальном one-hot оба литерала
//       всегда '1' -> D = r_{i-1}, поведение НЕ меняется. Литералы
//       самоочистки гасят ВСЕ нелегальные состояния: соседняя пара '1'
//       отказывается двигаться и умирает за 1 фронт (оба приёмника
//       заняты), тройки/все-1 -> 00, из 00 рестарт r0 по NOR5;
//       ЛЮБОЕ из 32 состояний -> one-hot за <= 2 фронта. НАИВНОЕ
//       кольцо (r_i <= r_{i-1}) НЕ ГОДИТСЯ: соседняя пара '1' ходит
//       по кольцу ВЕЧНО (2x частота), а 00000 = МЁРТВЫЙ клок; v3.6
//       выплывал из нелегалов до 12 тактов - самоочистка обязательна,
//       цена: +2 литерала на триггер, +0 птермов, +0 МЦ;
//     - x1_p/x2_p СОКРАЩЕНЫ (не +2 триггера против v3.6, а -2):
//       x1_p == ~r0 и x2_p == r0 ТОЧНО - оба обновляются ОДНИМ posedge
//       из одного состояния: x1_p <= (cnt!=4) даёт '0' только в
//       состоянии 0 (= ~r0), x2_p <= (cnt==4) даёт '1' только в
//       состоянии 0 (= r0). Отсюда X1 = (~r0) ^ x1_n, X2 = r0 ^ x1_n;
//       SOP функций X1/X2 различны по построению - same-D слияние
//       невозможно (механизм п.10 сохранён);
//     - x1_n БЕЗ ИЗМЕНЕНИЙ (negedge, INIT=0): set при r2, clear при
//       r3 - те же фронт-пары, что (cnt==2)/(cnt==3);
//     - por_ce = r1 | r4 (те же интервалы, что (cnt==4)|(cnt==1));
//     - INIT r0=1, r1..r4=0 (заплавлен, как init-тройка v3.6) -
//       состояние 0 при старте. ЕДИНСТВЕННОЕ отличие от v3.6: до
//       ПЕРВОГО posedge X1='0'/X2='1' (v3.6: 1/0) - CPU всё это время
//       в POR (por_run=1), схемно незначимо; с первого фронта
//       X1/X2/por_ce/por_run совпадают с v3.6 пофронтово (узор
//       "11100", 10,000 МГц 60/40, CLK 5 МГц ровно 50/50, por_ce 6/4,
//       POR 800 нс);
//     - legacy-ветки (div2/div4/чётные N>=6/нечётные) НЕ тронуты:
//       cnt, x1_p, x2_p остаются объявленными (элайзятся при (2,1)).
//
// ЧТО ИЗМЕНЕНО в v3.9 (2026-10-29, кольцо 5 -> 7 триггеров, clk10-54):
// 15) ОТКАТ ЧАСТОТЫ ПО РЕЗУЛЬТАТАМ ЖЕЛЕЗА: экземпляр ИМ1281ВМ85А не
//     держит CPU 5 МГц - «самые простые тесты крайне нестабильно
//     запускаются, но запустившись вроде бы работают» (сигналы живые:
//     адреса/ALE/сброс/X1-X2 в противофазе - дефект НЕ в тракте CPLD).
//     Решение владельца и коллеги: остаться в семействе one-hot
//     колец и РАСШИРИТЬ кольцо 5 -> 7 (ряд из 25 МГц: N=5 -> X1
//     10,00 МГц; N=7 -> 7,14; N=9 -> 5,56...), v3.8 остаётся откатом.
//     ПОСТРОЕНИЕ (вся остальная логика байт-в-байт v3.8; legacy-ветки
//     не тронуты):
//     - r5/r6 добавлены, кольцо r0..r6: сдвиг с САМООЧИСТКОЙ, УСИЛЕННОЙ
//       против v3.8: r_i <= r_{i-1} & ~r_i & ~r_{i+1} & ~r_{i+2}
//       (kill ПРЕЕМНИКА И ЕГО СОСЕДА), рестарт из 00 по NOR7. Причина
//       усиления: формула коллеги (r_i <= r_{i-1} & ~r_{i+1} & ~r_i) для
//       N=7 НЕ гасит пары '1' на дистанции 3-4 - они ОРБИТИРУЮТ ВЕЧНО
//       (14 состояний из 128; в N=5 проблема отсутствует - малое кольцо
//       сталкивает пары при обходе; поймано sim_v39_ring7.py ДО фита).
//       С двойным kill: gap-1 -> 00 -> рестарт; gap-2/3 - последователь
//       блокирован, лидер идёт; gap-4 - лидера блокирует его собственный
//       kill-литерал через wrap (~r_{q+7} = ~r_q). ЛЮБОЕ из 128 состояний
//       -> one-hot за <= 2 фронта (sim_v39_ring7.py, полный перебор);
//     - x1_n (negedge, INIT=0): set при r3, clear при r4
//       (SET=(N-1)/2=3, CLR=(N+1)/2=4) -> импульс 40 нс, как в v3.8;
//     - X1 = (~r0)^x1_n: high 100 / low 40 нс (duty 71/29), фронты
//       через РОВНО 140 нс = 2x25/7 = 7,143 МГц; X2 = r0^x1_n = ~X1
//       ТОЧНО (SOP различны, п.10/14); внутренний /2 ВМ85А по ФРОНТАМ
//       -> CLK = 3,571 МГц, период РОВНО 280 нс, duty ровно 50/50;
//     - por_ce = r1 | r6: интервалы 200/80 нс (в среднем ровно 140 нс);
//       POR = 8 x 140 = 1120 нс; норма 3 такта CLK = 840 нс -> запас
//       1,33x (тот же, что v3.8: 800/600);
//     - автомат шины НЕ тронут (домен 25 МГц): /WE 80 нс, t_AS 40 нс -
//       ФИКСИРОВАННЫЕ. При T=280 нс зазор WR#(вверх)->след.ALE
//       сжимается до ~0,25..0,45 T = 70..126 нс (при T=400 было
//       100..180); окно захвата T1H = gap + ~0,9T минус 160..200 нс
//       на завершение WB-цепочки -> запас ~120..220 нс (3..5 тактов
//       25 МГц) - закрыт, НО коэффициенты 0,25..0,45 сняты платой при
//       T=1280: после фита ПЕРЕИЗМЕРИТЬ зазор на осциллографе (п.4
//       шапки; арбитр - осциллограф, как и для фазы X1/X2);
//     - бюджет: +2 МЦ (r5/r6), ~+2..3 PT, рестарт-птерм r0.D
//       расширяется 5 -> 7 литералов (шина PT XC9500 - 36, запас);
//       свободно было 21 МЦ (FB2 - 6, FB3 - 6, FB1 - 5, FB6 - 2, FB5
//       - 2) и 17 входов ФБ - ложится с запасом (прогноз ~89/108 MC,
//       ~209/540 PT, ~201-204/216 входов ФБ);
//     - TX-захват v3.7 ПО УРОВНЮ частотно-независим - не тронут.
//     ПОСЛЕДСТВИЯ (пересчёт от v3.8):
//     - терминал: 9600 -> 1920 x 25/7 = 6857 8N1 (ПЗУ fw_mon v5 не
//       перешивается: бод = 1920 x f_CPU; 4800@2,5 -> 6000@3,125 ->
//       9600@5 -> 6857@3,571; CH340G произвольные боды держит);
//     - CLK OUT = 3,571 МГц duty 50%; POR 1120 нс; t_RD/t_WR CPU
//       растут (280+ нс против 200 при 5 МГц) - маржа памяти
//       увеличивается (гипотеза нестабильного старта - CPU за гранью).
//
// ЧТО ИЗМЕНЕНО в v3.9.1 (2026-10-30, CS_n writeback без защёлки, clk10-62):
// 16) ЗАЩЁЛКА wb_ram_q УДАЛЕНА (предложение коллеги, вердикт clk10-61:
//     ПРАВ). Единственный читатель wb_ram_q был CS_n, а in_wb
//     (state >= S_WB1) уже влечёт условие защёлки:
//     - S_WB1 достижим ТОЛЬКО из ветки «запись завершена» в T2
//       (wr_seen && WRn) и ТОЛЬКО при !IOM && A15 - тем же фронтом
//       ставится и защёлка (в v3.9: строки 794+797 в одном begin);
//     - в WB2..WB4 wb_ram_q не переприсваивается (держит 1);
//     - сброс СИНХРОННЫЙ, одним фронтом со state (в v3.9: 743+746) -
//       окна «state в WB, wb_ram_q=0» нет даже при cpu_rst посреди
//       импульса /WE;
//     - драйверы WB (A-сети, D-шина, WE_n) УЖЕ работали от in_wb без
//       защёлки - правка делает CS_n консистентным с WB-трактом.
//     Изменение RTL (против v3.9): удалены reg wb_ram_q, его сброс и
//     взвод; уравнение:
//       было:  assign CS_n = (in_wb && wb_ram_q) ? 1'b0 : (!A15 | IOM);
//       стало: assign CS_n = in_wb ? 1'b0 : (!A15 | IOM);
//     остальное байт-в-байт v3.9 (кольцо N=7, POR, TX v3.7, автомат).
//     ЗАЩИТА ЗАПИСИ СОХРАНЕНА ПОСТРОЕНИЕМ: в WB1..WB4 CS_n=0 БЕЗ
//     A15/IOM - живой декод во время конфликта адресов по-прежнему не
//     участвует; /WE как был, от in_welo (2 тика = 80 нс).
//     ЭКВИВАЛЕНТНОСТЬ (scripts/sim_v391_equiv.py + scripts/tb_v391_diff.v,
//     Icarus Verilog 12.0): (а) полный перебор произведения машин
//     (state, rd_seen, wr_seen, wb_ram_q) x 64 комбинации входов от
//     стартового состояния - 0 расхождений, инвариант «in_wb ->
//     wb_ram_q=1» на всех достижимых состояниях; (б) дифференциальная
//     симуляция двух RTL (v3.9 и v3.9.1 в одном тестбенче, общий
//     стимул): все выходы/шины/лог ОЗУ бит-в-бит на направленных
//     сценариях (запись ОЗУ с новым ALE-циклом и сменой адреса посреди
//     WB - защита п.5, PUSH-стресс, IO/ПЗУ записи, ALE-глюк в T2,
//     cpu_rst в каждой фазе WB1..WB4, «дыхание» защёлки, TX-захват,
//     POR) и на случайном стимуле, 0 расхождений; спеки /WE = ровно
//     80 нс и t_AS >= 40 нс соблюдены.
//     ЦЕНА/ВЫГОДА (по фиту v3.9): -1 МЦ (88 -> 87; wb_ram_q = FB2_17,
//     зарытая, пина нет), -5 ПТ (214 -> ~209), FB1 -1 вход; факт
//     подтверждает фит владельца (п.3 TODO, чек-лист g/h).
//
// ЧТО ИЗМЕНЕНО в v3.9.2 (2026-10-30, делитель: кольцо -> счётчик,
// линия lowsize, clk10-65):
// 17) КОЛЬЦО one-hot N=7 ЗАМЕНЕНО ДВОИЧНЫМ СЧЁТЧИКОМ mod-7 (директива
//     владельца: «работаем над снижением размера HDL дизайна в CPLD»;
//     линия beta/lowsize, база v3.9.1). Мотивация по фиту v3.9
//     (10-29 8:45PM): 88/108 МЦ, входы ФБ 202/216 (исчерпаны FB1/FB3/
//     FB6 по входам, FB4 по МЦ), узел тактирования = 8 триггеров
//     (r0..r6 + x1_n). Кольцо в v3.8 выбрали ради входной ренты
//     (декоды равенства ели входы ДВУХ ФБ), но МЦ-бюджет оно платит
//     сполна: 7 триггеров состояния. Двоичный mod-7 хранит то же
//     состояние в 3:
//     - cnt[2:0]: двоичный 0..6 по posedge, wrap по декоду cnt==6,
//       INIT=000 (легальная орбита); нелегальное 111 недостижимо, а
//       при внешнем попадании восстанавливается за 1 фронт
//       (7+1 = 8 -> переполнение 3 бит -> 000);
//     - фаза X1 - КОМБИНАЦИОННАЯ: X1 = (cnt != 0) ^ x1_n - точный
//       эквивалент (~r0) ^ x1_n кольца (состояние k кольца <=>
//       cnt==k, включая INIT: r0=1 <=> cnt=0). Узор X1 «1111100»
//       (high 100 / low 40 нс), X2 = (cnt == 0) ^ x1_n = ~X1 ТОЧНО,
//       фронты РОВНО через 140 нс, CLK CPU 280 нс 50/50 - БИТ-В-БИТ
//       v3.9;
//     - x1_n: set cnt==3 / clear cnt==4 (NEGEDGE) - те же фазы, что
//       r3/r4 кольца, импульс 40 нс в [140,180) периода 280 нс;
//     - por_ce = (cnt == 1) | (cnt == 6) - те же состояния, что
//       r1|r6: интервалы 200/80 нс, POR = 8 x 140 = 1120 нс БИТ-В-
//       БИТ v3.9 (пара {0,1} дала бы один импульс 80 нс за период ->
//       POR 2240 нс - ЗАБРАКОВАНО по требованию эквивалентности);
//     - ЦЕНА: декоды равенства ВЕРНУЛИСЬ в узел (класс п.9 - фиттер
//       трижды терял полярность декодов в фятах 10-22); теперь они
//       3-битные и дешёвые, чек-лист h) требует сверку уравнений по
//       таблице истинности; ядра X1/X2 выросли 2 -> 4 ПТ (SOP
//       инверсии декода cnt!=0 = cnt0|cnt1|cnt2);
//     - ЭКОНОМИЯ: -4 МЦ (8 -> 4 триггера узла; прогноз 88 -> 84/108,
//       85 если фиттер выделит por_ce в хелпер-МЦ), ПТ ~+11..+36
//       (репликация por_ce в por_sh_D против хелпера), входы ФБ:
//       FB4 -4 (r0..r6 -> cnt0..2), ядра X1/X2 +2 входа;
//     - ЭКВИВАЛЕНТНОСТЬ ДОКАЗАНА ДВУМЯ СТУПЕНЯМИ:
//       (1) дифсимуляция двух RTL (v3.9.1 и v3.9.2 в одном тестбенче,
//           общий стимул: POR, чтения/записи/writeback шины, порты
//           SEG/DIG/SND/KBCOL/KBROW, TX v3.7, ALE-глюки, cpu_rst) -
//           ВСЕ выходы бит-в-бит, 0 расхождений (scripts/tb_v392_diff.v,
//           Icarus Verilog 12.0);
//       (2) узел побитно против точной модели кольца v3.9 на 200 мкс
//           + перебор состояний cnt (scripts/sim_v392_div7.py: фронты
//           140 нс, duty 71/29, X2=~X1, por_ce 200/80, POR 1120 нс,
//           CPU 280 нс 50/50, живучесть из любого состояния);
//     - ПОСЛЕДСТВИЯ: нет (частоты, терминал 6857 8N1, тайминги шины,
//       TX, порты - без изменений; откат - RTL v3.9.1, .jed v3.9
//       10-29 8:45PM известен хороший).
//
//  18) v3.9.3 (линия lowsize, 2026-11-02; директива владельца: меру по
//      сбросу отрабатывать по линии lowsize, в более новой прошивке):
//      СБРОС ЛОГИКИ ПЕРЕВЕДЁН НА СЕТЬ GSR. Что было (v3.9-v3.9.2,
//      Task 25): пин RST (SW20) физически на выводе I/O/GSR (P1), НО
//      сеть GSR НЕ использовалась - сброс был СИНХРОННЫМ через D-gating:
//      cpu_rst = RST | por_run входил литералами в D-функции ВСЕХ
//      триггеров логики. Цена по фиту v3.9.2 (rpt 10-30 8:32PM): RST и
//      por_run импортированы во ВСЕ 6 ФБ (12 из 216 входов ФБ = 6,7%
//      бюджета - крупнейшая статья после шины), ~70 уравнений несли
//      защиты NOT RST / NOT por_run (давление на ПТ), OR (RST) x3.
//      Что стало: триггеры логики (state, rd_seen, wr_seen, addr_latch,
//      bus_reg, seg_q, dig_q, snd_q, kbcol_q) описаны АСИНХРОННО
//      (posedge clk or posedge RST, if (RST)) - фиттер сводит общий
//      асинхронный сброс на СЕТЬ GSR: минус ~2 входа в большинстве ФБ
//      (прогноз вх.ФБ 180 -> ~168-172), минус литералы сброса в
//      D-функциях (прогноз ПТ ~209 -> ~190-205); МЦ 84-85, триггеры 54,
//      ноги 72 - БЕЗ изменений.
//      ВНЕ ДОМЕНА GSR (сознательно, бит-в-бит v3.9.2):
//        - делитель cnt/x1_n: X1 не глушится при сбросе, фаза CLKOUT
//          не прыгает (свойство v3.9 сохранено построением);
//        - por_sh/por_run: POR только по питанию (INIT=FF/1); повторный
//          POR по-прежнему невозможен (после 00 сдвиг держит нули);
//        - sod_q: свободный ход;
//        - tx_pass/tx_q: async SR по cpu_rst (PT-SR v3.7) - cpu_rst
//          держит tx_pass=0 ВЕСЬ POR: враждебный SOD в окне POR не
//          «захватывает» линию TX (ложный старт-бит невозможен);
//        - RESET_IN = ~(RST | por_run): БЕЗ ИЗМЕНЕНИЙ, бит-в-бит
//          v3.9.2 (мгновенный взвод/снятие по кнопке сохранены).
//      ПОВЕДЕНИЕ (отличия от v3.9.2): сброс логики стал АСИНХРОННЫМ -
//      при нажатии значения фиксируются мгновенно (v3.9.2 - на такт
//      позже), при отпускании снимаются мгновенно (v3.9.2 - на такт
//      позже). Нормальные циклы шины бит-в-бит v3.9.2 (дифсимуляция
//      tb_v393_diff; окно 45 ns вокруг фронтов кнопки исключено из
//      сравнения как ОЖИДАЕМОЕ свойство меры, не дефект).
//      РИСК ЗАКРЫТ ГЕЙТОМ: в окне POR (por_run=1) FSM v3.9.3 ЖИВОЙ
//      (GSR не активен), а шина CPU в сбросе «floated» (ВМ85А:
//      управления/адрес/данные в 3-м состоянии) - вход в writeback
//      гейтится (!por_run в S_T2): импульс /WE в окне POR невозможен
//      ПО ПОСТРОЕНИЮ (spec-проверки tb_v393_diff + sim_v393_gsr.py).
//      Метастабильность снятия GSR - класс-риск XC9500 (recovery/
//      removal при снятии в случайной фазе такта): вероятность мала,
//      FSM самозатухающий (защиты v3 сохранены: default->IDLE, abort
//      по ALE, повторный захват) - осознанный компромисс меры.
//      ВЕРИФИКАЦИЯ: (1) дифсимуляция v3.9.2 vs v3.9.3 (scripts/
//      tb_v393_diff.v + run_tb_v393.sh, Icarus 12.0): все выходы и обе
//      шины каждые 5 ns, враждебные «плавания» шины в окне POR, сбросы
//      посреди WB/портов/random, виртуальные ОЗУ равны; (2) scripts/
//      sim_v393_gsr.py: семантика сброса - RESET_IN >= 840 ns нормы
//      для любого нажатия, ноль /WE в окне POR, равенство
//      пост-сбросных состояний, X1/por-цепь бит-в-бит v3.9.2.
//      ЭКОНОМИКА РЕШЕНИЯ: альтернатива «por_sh 8->4» (Plan B
//      txclient) при por_ce ~140 ns даёт POR 560 ns < нормы 840 ns -
//      НЕЛЕГАЛЬНА без переделки строба; GSR-мера дешевле и не трогает
//      тайминги CPU.
//
//  19) v3.9.4 (линия lowsize, 2026-11-05; М1 из txclient v8, применена
//      там по одобрению владельца «Делай M1» 11-3; сюда - по одобрению
//      «Делаем Б» 11-5): POR-СЧЁТЧИК 8 -> 4 БИТА, строб por_ce = x1_n
//      (1 импульс 40 нс в [140,180) каждого периода cnt 280 нс; set
//      cnt==3 / clear cnt==4 по negedge) вместо пары декодов
//      (cnt==1)|(cnt==6) с интервалами {200,80} нс. Что меняется:
//      ТОЛЬКО POR-цепь (reg [3:0] por_sh = 4'hF, сдвиг {1'b0,
//      por_sh[3:1]}, строб) - логика шины, делитель cnt/x1_n/X1/X2,
//      UART-транзиты (v3.7) и GSR-сброс (п.18) БЕЗ ПРАВОК; норм-путь
//      бит-в-бит v3.9.3.
//      ТАЙМИНГ: POR = 4 x 280 = 1120 нс >= нормы 840 нс (3 такта
//      CLK OUT), запас 1,33x - как в v3.9.2/v3.9.3 (там 8 x ~140 =
//      1120-1140 нс); от INIT фактический низ RESET_IN ~1020-1040 нс
//      (4 строба с шагом 280 нс, por_run падает на такт после 4-го
//      сдвига F->7->3->1->0). Возражение п.18 («por_sh 8->4: POR
//      560 нс < 840») считало СТАРЫЙ строб 2/период (4x140=560) - со
//      стробом 1/период мера легальна (снято в txclient v8).
//      Декодов равенства в POR-пути больше НЕТ (классы фитов 7:31 и
//      8:55 остаются исключёнными); цена строба - 1 импорт ФБ (x1_n
//      уже в узле) вместо 2 хелперов $OpTx$FX_DC$449/452 фита v3.9.3.
//      ВЕРИФИКАЦИЯ: (1) дифсимуляция v3.9.3 vs v3.9.4 (scripts/
//      tb_v394_diff.v + run_tb_v394.sh, Icarus 12.0): все выходы и обе
//      шины каждые 5 ns; окно POR закрыто (момент снятия por_run
//      ОЖИДАЕМО отличается: 4-й строб + такт против 8-го), RST-окна
//      сравниваются СТРОГО (поведение GSR идентично); T0 - цикл-точная
//      проверка POR-цепи v3.9.4 по RTL (INIT F/1, ровно 4 сдвига
//      F->7->3->1->0, por_run >= 840 нс, повторного POR нет);
//      (2) враждебные «плавания» шины в окне POR - /WE не рождается
//      (гейт !por_run п.18 бит-в-бит).
//      ЭКОНОМИКА (прогноз): МЦ 85 -> 79-81 (-4 por_sh<7:4>, -2 хелперы
//      декода), ПТ 195 -> ~170-180 (T-цепи 4ПТ/5лит -> 2ПТ/3лит),
//      вх.ФБ 171 -> ~164-168, триггеры 54 -> 50. Норма POR 840 нс
//      соблюдена; повторный POR невозможен (после 0000 сдвиг держит
//      нули).
//
//  20) v3.9.5 (линия lowsize, 2026-11-05; ИСПРАВЛЕНИЕ ДЕФЕКТА СТАРТА
//      v3.9.3/v3.9.4 - жалоба владельца 11-5: «после включения питания
//      плата запускается очень нестабильно, по кнопке сброса не
//      стартует, помогает только передёргивание питания; на плате
//      товарища не запускается вовсе; v3.9.2 запускается стабильно»):
//      GSR-ИСТОЧНИК РАСШИРЕН: RST -> cpu_rst = RST | por_run.
//      ЧТО БЫЛО (п.18, v3.9.3): асинхронный сброс логики ПО КНОПКЕ
//      ТОЛЬКО - в окне POR (~1 мкс) FSM и флаги ЖИВЫ, а шина CPU в
//      сбросе «floated» (ВМ85А 3-стирует управления/адрес/данные,
//      линейки дрейфуют вместе с растром VCC) - FSM бродит по
//      T1H/T2 под плавающими ALE/RDn/WRn/IOM/A15, пачкает
//      rd_seen/wr_seen/addr_latch/bus_reg/seg_q/dig_q/kbcol_q/snd_q
//      и встречает CPU на выходе из сброса ГРЯЗНОЙ (класс-эффекты:
//      rd_drive=1 -> контеншн CPLD против '573 на A-сетях, мусорные
//      декоды портов, глубоко испачканные шинные регистры). v3.9.2
//      был невосприимчив: cpu_rst держал ВСЮ логику в IDLE/нулях
//      КАЖДЫЙ такт POR. ДЕЛЬТА - 2 СЛОВА: always @(posedge clk or
//      posedge cpu_rst) / if (cpu_rst) - условие v3.9.2, СТРУКТУРА
//      v3.9.3 (сброс асинхронный и уходит в СЕТЬ GSR, теперь от узла
//      cpu_rst, а не от ноги RST напрямую). СВОЙСТВА: (1) в окне POR
//      логика чистится асинхронно с t=0 (GSR=1 от INIT por_run=1) -
//      чистый выход в IDLE ГАРАНТИРОВАН; (2) кнопка RESET - прежняя
//      (cpu_rst=1 при RST=1, мгновенный взвод/снятие сохранены);
//      (3) POR-цепь por_sh/por_run, делитель cnt/x1_n и sod_q - как
//      были ВНЕ GSR (por_run в GSR нельзя - сбрасывал бы сам себя);
//      (4) гейт !por_run в S_T2 (п.18) ОСТАЁТСЯ вторым рубежом
//      (бесплатно); (5) tx_pass/tx_q (async SR по cpu_rst) - без
//      правок. ВЕРИФИКАЦИЯ: (1) fuzz-тест окна POR (scripts/
//      tb_por_fuzz.v + run_tb_por_fuzz.sh, Icarus 12.0; модель
//      «плавающей» шины - случайные переключения ALE/RDn/WRn/IOM/
//      A15/A/D, 100 сидов): ГРЯЗЬ В МОМЕНТ СНЯТИЯ por_run -
//      v3.9.2 0/100 (структурная гарантия держит), v3.9.4 100/100
//      (ДЕФЕКТ ВОСПРОИЗВЕДЁН), v3.9.5 0/100 (фикс восстанавливает
//      гарантию); rd_drive-контеншн в окне POR: v3.9.4 86 тактов на
//      100 сидов, v3.9.2/v3.9.5 0; WE_n=0 в POR: 0 у всех (гейт
//      !por_run держит); «грязь на старте CPU» (+200 нс хвост):
//      v3.9.2 84/100 - хвост ОБЩИЙ для обеих линий (после POR
//      cpu_rst снят и в v3.9.2), в поле v3.9.2 стабилен - хвост
//      вымывается первым реальным циклом CPU, а вот ВХОДИТЬ в него
//      грязной и глубоко (порты/шины от всего POR) - смерть старта:
//      этим и отличается v3.9.4; (2) дифсим v3.9.4 vs v3.9.5
//      (scripts/tb_v395_diff.v + run_tb_v395.sh): 0 расхождений на
//      норм-пути (окно POR закрыто, RST-окна строго); (3) POR-цепь
//      бит-в-бит v3.9.4 (4 строба x1_n, RESET_IN ~1020-1040 нс >=
//      840 нс). ЭКОНОМИКА: источник GSR = узел cpu_rst вместо ноги
//      RST: ожидание +1 ПТ (OR) в ФБ гейта RESET_IN (RST и por_run
//      уже импортированы туда), вх.ФБ +0..2; ЕСЛИ фиттер НЕ сведёт
//      узел на GSR (fallback - PT-сбросы на каждом flopa) -
//      функционально то же, дороже по ПТ/вх (анатомия v3.9.2: ~12
//      вх.ФБ на импорты RST/por_run) - .rpt НА РАЗБОР в обоих
//      случаях, НЕ прошивать без аудита.
//
//  21) v3.9.6 (линия lowsize, 2026-11-06; ХАРДРЕНИНГ ЦЕПИ СБРОСА -
//      жалоба владельца 11-6 на v3.9.5 (у ОБОИХ фитов, Exhaustive ON
//      и OFF): «только выкл-вкл питания возвращает работоспособность
//      по сбросу; просто сброс не может восстановить работоспособность,
//      пока она не восстановится по питанию»; гипотеза п.1 разбора
//      (подтяжка цепи RST) владельцем СНЯТА - резистор стоит давно,
//      мера сделана НЕЗАВИСИМОЙ от цепи RST платы). ПРИЧИНА: в фите
//      v3.9.5 GSR НЕ свёлся (fallback) - сырой пин RST доходил
//      НАПРЯМУЮ до гейта RESET_IN<=NOT por_run AND NOT RST (нога CPU)
//      и до 40 PTC-сбросов CLR/PRE=NOT RESET_IN: любой мид-рейл/
//      дребезг/помеха на SW20 размазывает моменты фактического снятия
//      сброса у CPU и у триггеров на время фронта (симуляция
//      sim_v395_rst_float.py: спад 10 мкс - BOOT 7-10/20, ложные /WE
//      и контеншн A/AD у ~50% сидов; у механической кнопки на
//      отпускании - миллисекунды дребезга). МЕРА - RST входит в
//      кристалл ТОЛЬКО через регистры:
//      (a) 2FF-синхронизатор rst_meta/rst_sync (вне сброса, INIT=0) -
//          сырой пин больше не касается ни PTC-сбросов, ни RESET_IN;
//      (b) квалификатор rst_press/rst_qcnt: переворот на 8-м такте
//          ПОДРЯД устойчивого rst_sync != rst_press - дребезг/глитч
//          короче 280 нс не виден вовсе; длиннее - ПОЛНОЦЕННЫЙ
//          повторный сброс: каждый взвод заново чистит все 40
//          триггеров, ПОСЛЕДНЕЕ снятие всегда из held-чистого
//          состояния регистровым фронтом;
//      (c) cpu_rst = rst_press | por_run - ТОЛЬКО регистровые
//          источники (комбинаций от пинов в цепи сброса больше НЕТ);
//      (d) RESET_IN - РЕГИСТР reset_q (INIT=0: CPU в сбросе с t=0 до
//          всякого клока - как от INIT=SET por_run в v3.9.5; вне
//          сброса): снятие сброса CPU ВСЕГДА чистым фронтом, моменты
//          отпускания CPU и логики совпадают до скоха одной сети;
//      (e) гейт S_T2: !por_run -> !por_run AND !rst_press (рубеж
//          п.18/20 распространён на окна кнопочного сброса);
//      (f) начатый импульс /WE (80 нс) НЕ обрывается: квалификатор
//          (400 нс) длиннее импульса - запись доводится до конца
//          (полный t_WP ОЗУ), сброс гасит драйвы сразу после.
//      СВОЙСТВА: POR бит-в-бит v3.9.4 (por_sh/por_run не тронуты),
//      низ RESET_IN по питанию 1020 -> до 1160 нс (норма 840, запас
//      x1,35); латентность кнопки 11 тиков счёта (2FF + 8 такт
//      квалификатора + reset_q) = 400..440 нс от пина на взвод и на
//      снятие (кнопка живёт в миллисекундах); tx_pass/
//      tx_q - прежний async SR, источник - регистровый cpu_rst.
//      НОВОЕ СВОЙСТВО: глитч на RST короче ~280 нс (8 тактов) сброс
//      НЕ вызывает (в v3.9.5 вызывал любой). ЦЕНА: +7 рег (57),
//      прогноз 85-87 МЦ / 220-230 ПТ / 165-172 вх.ФБ (у v3.9.5 было
//      79/217/163/50; свободно 29 МЦ). СИМ: tb_v396_rst.v (Icarus):
//      POR/чистая кнопка/дребезг 8 экскурсий/глитчи 100+250 нс/сброс
//      посреди /WE-импульса/регистровость RESET_IN, норм-путь
//      эквивалентен v3.9.5.
//
//  22) v3.9.7 (линия lowsize, 2026-11-06; директива владельца:
//      «возвращаем в дизайн 3.9.7 делитель на основе кольцевого
//      сдвигового регистра»; продолжение исследования застревания
//      «только по питанию» в 3.9.3-3.9.6). Возврат КОЛЬЦА one-hot
//      r0..r6 (v3.9/v3.9.1) вместо двоичного mod-7 cnt[2:0]
//      (v3.9.2-3.9.6). МОТИВ: застревание сведено к аналоговой
//      лотерее включения (дополнение 11-6bis: класс M1 - clk 25 МГц
//      не стартует; tb_poweron P2 воспроизводит ПОЛНЫЙ симптом-
//      комплекс жалобы на RTL любой версии), гипотеза о «недопустимой
//      ситуации» делителя опровергнута перебором - НО единственной
//      конфигурацией узла тактирования, дававшей в ПОЛЕ стабильные
//      сессии, остаётся КОЛЬЦО (v3.9/v3.9.1: «отлично всё работает»
//      10-29 у обоих экземпляров; счётчик v3.9.2 стабилен только по
//      выборке владельца). v3.9.7 - ПОЛЕВОЙ ЭКСПЕРИМЕНТ С ОДНОЙ
//      ПЕРЕМЕННОЙ: машина состояний делителя возвращена, ВСЁ
//      остальное - БЕЗ ПРАВОК:
//        - строб por_ce = x1_n и por_sh[3:0] (М1, п.19) СОХРАНЕНЫ:
//          POR бит-в-бит v3.9.4-3.9.6 (4 x 280 = 1120 нс); строб
//          кольца v3.9.1 (r1|r6, por_sh 8 бит) НЕ возвращается -
//          иначе в эксперименте две переменные;
//        - GSR (п.18), источник GSR = cpu_rst (п.20), хардренинг RST
//          (п.21), TX-транзиты (v3.7), автомат шины, legacy-ветки
//          делителя - БЕЗ ПРАВОК;
//        - x1_n: set r3 / clear r4 (NEGEDGE) - те же фазы, что
//          set cnt==3 / clear cnt==4 счётчика: X1/X2/por_ce/por_run
//          БИТ-В-БИТ v3.9.6 (дифсим tb_v397_diff.v: 0 расхождений на
//          всех выходах и обеих шинах, POR и кнопка включительно).
//      Отказоустойчивость к стохастике включения - с запасом против
//      счётчика: ЛЮБОЕ из 128 кодов power-up -> one-hot за <= 2
//      фронта (двойной kill + рестарт NOR7, п.15; на RTL v3.9.7 -
//      tb_poweron_v397 P0a: 128 x 16 x 2 = 4096 комбинаций с
//      por-цепью, дрейн por_run <= 1600 нс у ВСЕХ - ПАСС).
//      ЦЕНА: +4 МЦ (узел 4 -> 8 триггеров; прогноз ~88-90/108), ядра
//      X1/X2 4 -> 2 ПТ (XOR от r0 вместо декода cnt!=0), декоды
//      равенства УШЛИ из узла (класс п.9 в узле уничтожен снова).
//      КРИТЕРИЙ ПОЛЕВОГО ЭКСПЕРИМЕНТА: если лотерея включения с
//      v3.9.7 СОХРАНИТСЯ - она ЗА ПРЕДЕЛАМИ делителя (clk-тракт
//      U7 LTC6905/H1/GCK3 или питание) и главным инструментом
//      остаётся чек-лист D1-D4 (README, дополнение 11-6bis); если
//      ИСЧЕЗНЕТ - у стохастики была цифровая компонента в анатомии
//      фита узла (размещение/трассировка), и кольцо - рабочая
//      конфигурация узла для этой платы.
//
//  23) v3.9.8 (линия lowsize, 2026-11-06; схема владельца, сообщение
//      11-6bis-2: «почему ты держишься за 25МГц входной частоты на
//      CPLD, берем делитель /2 и делаем все гораздо проще» + код
//      кольца N=7 на 50 МГц: X1 = r0 duty 1/7, X2 = противофаза,
//      por_ce раз в 140 нс). УПРОЩЕНИЕ УЗЛА ТАКТИРОВАНИЯ: вход CPLD
//      50 МГц (перемычка H1 БЕЗ шунта: DIV=/2 генератора U7 ~100
//      МГц; штатное положение с шунтом давало 25), кольцо r0..r6
//      (п.22, БЕЗ ИЗМЕНЕНИЙ) тактируется 50 МГц НАПРЯМУЮ (период
//      140 нс):
//        - x1_n и negedge-домен УДАЛЕНЫ из целевой ветки: вставка второй
//          кромки в период кольца (весь смысл x1_n в v3.9-v3.9.7) больше
//          не нужна - её даёт сам clk 50. Декларация x1_n в RTL СОХРАЕНА
//          только для legacy g_div_odd (XST компилирует ВСЕ ветки
//          generate - без декларации HDLCompilers:28; в нетлисте целевой
//          конфигурации её БЫТЬ НЕ ДОЛЖНО). X1 = r0: фронт строго
//          каждые 140 нс (7,143 МГц), duty 1/7 (high 20 / low 120
//          нс); внутренний /2 ВМ85А тактируется фронтами X1 ->
//          CLK = 3,571 МГц, период 280 нс, duty РОВНО 50% -
//          ЧАСТОТА CPU НЕ МЕНЯЛАСЬ. X2 = r1|r2|r3|r4|r5|r6 = ~r0 в
//          каждом легальном one-hot состоянии - 6-ПТ OR БЕЗ
//          одиночной инверсии регистра (класс п.10/прецедент v3.4:
//          фиттер поднимал ~X1 в регистр В ФАЗЕ; в illegal-кодах
//          кольца на самоочистке (<= 2 фронта при включении) X2
//          отличается от ~X1 - транзиент на мёртвой для CPU фазе
//          POR, схемно незначимо);
//        - ЛОГИКА (rst/TX/FSM/порты) остаётся на 25 МГц: clk25 =
//          /2-триггер clk25_q от clk 50 (INIT=0 - фаза фиксиро-
//          вана). МОТИВ: XC95108-15 FSM/шина на 50 МГц НЕ закроет,
//          а /WE 80 нс (2 тика), квалификатор кнопки 320 нс (8
//          тиков) и все тиковые константы v3.9.2-3.9.7 обязаны
//          остаться - значит логика живёт на clk25 БИТ-В-БИТ
//          v3.9.7 (в .rpt - только смена тактовой сети; прецедент
//          внутреннего такта на GCK-сети: complement of clk ->
//          GCK2 в фите v3.9.5);
//        - por-цепь ПЕРЕВЕДЕНА в 50-домен: por_sh[7:0] (Init=FF),
//          строб por_ce = r0 - РОВНО ОДИН за период кольца 140 нс
//          («раз в 140 нс» владельца). ПОЧЕМУ НЕ r1|r6 дословно:
//          на кольце 50 МГц r1|r6 стреляет ДВАЖДЫ за период (каждые
//          70 нс) - POR уполовинился бы (280-560 нс при 4-8 битах
//          против нормы 840); а сэмпл 20-нс стробов кольца тактом
//          clk25 - ФАЗОВАЯ ЛОТЕРЕЯ: при чётной фазе стробы видны
//          (состояния r1/r6 совпадают с кромками), при нечётной -
//          НЕ ВИДНЫ ВОВСЕ (clk25 вечно сэмплирует r0/r2/r4) -> POR
//          не кончается НИКОГДА. В 50-домене строб - синхронное
//          включение того же такта: детерминировано при любой фазе.
//          POR = 8 x 140 = 1120 нс - НОМИНАЛ v3.9.4-3.9.7 (4 x 280),
//          запас 1,33x; фактический дрейн por_sh 1000 нс и снятие
//          por_run на кромке 1020 нс СОВПАДАЮТ с v3.9.7;
//      ВСЁ ОСТАЛЬНОЕ БЕЗ ПРАВОК: кольцо (п.22), GSR (п.18),
//      источник GSR = cpu_rst (п.20), хардренинг RST (п.21), TX
//      (v3.7), автомат шины, legacy-ветки делителя (в них clk25 =
//      прямой clk - элайзятся при (2,1)). СТОХАСТИКА ВКЛЮЧЕНИЯ:
//      128 кодов кольца x 8 por_sh x 2 фазы clk25 = 2048 комбинаций
//      (tb_poweron_v398 P0a) - one-hot <= 2 фронтов, дрейн por_run
//      <= 1200 нс. ЦЕНА: +1 МЦ (clk25_q) +4 МЦ (por_sh 4->8) -1 МЦ
//      (x1_n) = +4 МЦ; прогноз ~92-94/108. ГЛАВНЫЙ РИСК ФИТА: сеть
//      clk25 (выход триггера) должна сесть на глобальную тактовую;
//      РИСК АНАЛОГОВЫЙ: high X1 теперь 20 нс (было min 40) - если
//      генерация CPU сорвётся, откат одной строкой: X1 = r0 | r1
//      (high 40 нс), частоты те же.
//
// Что делать владельцу (TODO 78, ред. v3.9.8):
//  1) в ISE-проекте заменить top_suart.v на ЭТОТ файл (Set as Top Module);
//  2) UCF БЕЗ ИЗМЕНЕНИЙ (hdl/top_suart.ucf, те же ноги; clk = P29 GCK3);
//  3) фит и .rpt НА АУДИТ ДО ПРОШИВКИ (чек-лист ниже). Обязательные
//     точки v3.9.8 (КОЛЬЦО one-hot на clk 50 МГц + clk25 = /2, п.23)
//     + v3.7 (TX): ветка g_div2p5 - r0..r6 (7 триггеров one-hot,
//     двойной kill п.15, clk 50 МГц; INIT: r0=SET - состояние 0,
//     r1..r6=RESET); clk25_q (Init=RESET, T-триггер: D = NOT clk25_q,
//     clk 50 МГц) - такт ЛОГИКИ 25 МГц; x1_n В НЕТЛИСТЕ НЕТ (удалён,
//     negedge-домена больше нет); X1 = r0 (1 ПТ, регистр r0 МОЖЕТ
//     лечь в IO-MC пина), X2 = r1 OR r2 OR r3 OR r4 OR r5 OR r6
//     (6 ПТ, БЕЗ инверсии - в легальном one-hot = ~X1 ТОЧНО; если
//     фиттер показал X2 регистром В ФАЗЕ r0 - БРАК, не шить);
//     ДЕКОДОВ РАВЕНСТВА В УЗЛЕ БЫТЬ НЕ ДОЛЖНО (кольцо, п.22/23;
//     появились ==-декоды - собран ИСХОДНИК v3.9.2-3.9.6!);
//     cnt/x1_p/x2_p/t0_q/x1_q/x2_q/x1_n в нетлисте ОТСУТСТВУЮТ
//     (legacy-ветки элайзятся); por_sh - сдвиг (8 бит, Init=FF,
//     clk 50 МГц), строб por_ce = r0 (ДЕКОДОВ В POR-ЦЕПИ НЕТ),
//     por_run.D = por_sh[0], por_run Init=SET (обе - clk 50 МГц);
//     rst_meta/rst_sync/rst_qcnt/rst_press/reset_q/sod_q/tx_pass/
//     tx_q/state_FSM - clock = clk25 (НЕ clk!); reset_q -
//     FDCPE(clk25,'0','0') БЕЗ PRE; wb_ram_q В НЕТЛИСТЕ НЕТ
//     (v3.9.1), CS_n в Equations - от state_FSM_FFd1..3 + A15/IOM
//     (литерала wb_ram_q БЫТЬ НЕ ДОЛЖНО);

//  3a) v3.9.3 (GSR, п.18): в .rpt - "Global set/reset net(s) used",
//     "GSR : 1"; D-функции логики БЕЗ литералов сброса (NOT RST /
//     NOT por_run исчезли); уравнение RESET_IN = (por_run) OR (RST)
//     СОХРАНИЛОСЬ; tx_pass/tx_q - async SR по cpu_rst; por-цепь и
//     cnt/x1_n/sod_q - без GSR. ЕСЛИ GSR НЕ применился - rpt НА
//     РАЗБОР, НЕ прошивать (фит функционально корректен, но мера
//     не сработала);
//  3b) v3.9.8 (М1 ред. п.23): в .rpt por_sh - РОВНО 8 триггеров
//     (por_sh<7:0>, FTCPE, clock = clk пин 50 МГц); литерал строба -
//     r0 (декодов в POR-цепи НЕТ; x1_n/cnt<0..2> в POR-цепи НЕТ);
//     por_run.D = por_sh[0], Init=SET; clk25_q - РОВНО 1 триггер
//     (D = NOT clk25_q, clk 50 МГц); ЕСЛИ por_sh 4 бита
//     (v3.9.4-3.9.7) ИЛИ 16 бит - собран НЕ ТОТ исходник, rpt НА
//     РАЗБОР;
//  3c) v3.9.5 (GSR-источник = cpu_rst, п.20): в .rpt СЕТЬ GSR
//     ИСПОЛЬЗУЕТСЯ ("Global set/reset net(s) used", "GSR : 1"); в
//     Node Listing узел cpu_rst (или $-хелпер с RST|por_run) с
//     признаком GSR; D-функции логики БЕЗ литералов сброса (NOT RST /
//     NOT por_run нет); por-цепь por_sh<7:0>/por_run ВНЕ GSR (Init=SET
//     сохранён!), cnt/clk25_q/sod_q вне GSR; tx_pass/tx_q - async SR по
//     cpu_rst; RESET_IN = (por_run) OR (RST) сохранён; ЕСЛИ GSR НЕ
//     применился (PT-сбросы) - функционально корректно, но дорого:
//     rpt НА РАЗБОР, не прошивать без сверки ресурсов;
//  3d) v3.9.6 (хардренинг сброса, п.21): в нетлисте rst_meta/rst_sync/
//     rst_press/rst_qcnt<2:0>/reset_q - все ВНЕ сброса/GSR; reset_q -
//     Init=RESET (FDCPE(clk25,'0','0') БЕЗ PRE - CPU держится с t=0;
//     константа '0' в уравнении = признак Init, сверять как у por-цепи
//     - прецедент 2565246: cpldfit Init в печати не виден); литерал
//     RST в .rpt - ТОЛЬКО во входах ФБ rst_meta (1 ФБ), в D/PT-
//     функциях БОЛЬШЕ НИГДЕ (v3.9.5: RST стоял в гейте RESET_IN);
//     уравнения-ожидания: reset_q.D = NOT por_run AND NOT rst_press;
//     rst_press.D = rst_sync при rst_qcnt==7 (иначе hold, 4-6 ПТ);
//     rst_qcnt<2:0> - счётчик 0..7 с обнулением при
//     rst_sync==rst_press; гейт S_T2 - с !rst_press; D-функции логики
//     по-прежнему БЕЗ литералов сброса; GSR (если сведётся - от узла
//     cpu_rst) ОПЦИОНАЛЕН: PT-сбросы анатомии v3.9.5 корректны;
//     прогноз: МЦ 85-87, ПТ 220-230, вх.ФБ 165-172, рег 57.
//  4) ПАСС -> .jed в плату; ПЕРЕД этим переставить перемычку H1 БЕЗ
//     шунта (DIV=/2, U7 ~50 МГц на GCK3; ЕСЛИ шунт не переставлен -
//     всё работает ВДВОЕ медленнее: X1 3,57 МГц, CPU 1,79 МГц - это
//     НЕ поломка, просто верни шунт на место); осциллограф: GCK3 =
//     50 МГц, X1 = 7,14 МГц (период ровно 140 нс, high 20 / low 120 -
//     duty 1/7), X2 = 7,14 ПРОТИВОФАЗА (два луча - решает и вопрос
//     полярности X2; если X2 в фазе - БРАК фита, класс п.10),
//     RESET_IN низ ~1,04 мкс по питанию (8 стробов x 140 нс, п.23),
//     CLKOUT = 3,57 МГц duty 50%; ЕСЛИ генерация CPU не заведётся
//     (high X1 теперь 20 нс - вдвое тоньше прежних 40 нс) - откат
//     одной строкой RTL: X1 = r0 | r1 (high 40 нс), частоты те же;
//  5) терминал 6857 8N1 (было 9600; бод = 1920 x f_CPU:
//     4800@2,5 -> 6000@3,125 -> 9600@5 -> 6857@3,571).
//
// -- ЧЕК-ЛИСТ .rpt ПОСЛЕ ФИТА v3.4 (пройтись по распечатке глазами!) --
//  a) clk = P29 (GCK3, знак "User Assigned"), RST = P1 (GSTR);
//     на GCK3 подано 50 МГц (H1 без шунта); в .rpt сеть clk25
//     (такт ЛОГИКИ) - желательно на ГЛОБАЛЬНОЙ тактовой сети
//     (прецедент: complement of clk -> GCK2 в фите v3.9.5); если
//     фиттер повесил clk25 на обычную трассировку - проверить
//     skew/setup в отчете о временах (25 МГц закрывались с запасом
//     во всех фятах v3.9.x);
//  b) ВСЕ constraint-ноги со знаком "~" (фиттер НЕ переставлял);
//  c) PGND (Unused IO Ground) = РОВНО {P74,P75,P76,P78,P79,P81,
//     P95,P96,P98} - 9 шт (P73 = выход SID, в PGND БЫТЬ НЕ ДОЛЖНА);
//  d) входы на местах (INP): X2 P69, RSTOUT P70, SOD P72, INTAn P80,
//     HLDA P82, CLKOUT P83, S0 P94, S1 P89, AH8 P10, AH9 P12, AH10 P18,
//     AH11 P14, AH12 P4, AH13 P8, AH14 P3, RX P38;
//  e) выходы: READY P87='1', CS1 P99='1', TX P39=tx_q (IO-MC регистр,
//     транзит SOD с захватом v3.7), SID P73=RX (транзит), X1 P68
//     (r0, duty 1/7: high 20 / low 120 нс, v3.9.8), X2 P69
//     (r1 OR r2 OR r3 OR r4 OR r5 OR r6 = ~r0 = ~X1 в легальном
//     one-hot, БЕЗ инверсии регистра - v3.9.8, п.10/23);
//  f) v3.9.2: GSR НЕ использовался (сброс через D-gating, Task 25).
//     v3.9.3: СЕТЬ GSR ИСПОЛЬЗУЕТСЯ (п.18): "Global set/reset net(s)
//     used" + "GSR : 1" в Pin Resources; строка RST в Node Listing -
//     тип GSR/I/O с признаком GSR; в D-уравнениях ЛОГИКИ нет защит
//     "NOT RST"/"NOT por_run" (v3.9.2: NOT RST x70, NOT por_run x55,
//     OR (RST) x3 - должны ИСЧЕЗНУТЬ); RST в списках входов ФБ - не
//     более 1 (ФБ RESET_IN); por_run - только у tx_pass/tx_q/RESET_IN;
//     RESET_IN = (por_run) OR (RST) СОХРАНИЛОСЬ; cnt/x1_n/por_sh/
//     por_run/sod_q - БЕЗ GSR; ЕСЛИ "Global set/reset net(s) unused"
//     СОХРАНИЛОСЬ - фиттер не дал частичный GSR: фит функционально
//     корректен (PT-сбросы), но мера не сработала - rpt НА РАЗБОР,
//  g) MC < 108 (прогноз ~95 после v3.2: +x1_n, +2 por_cnt, +wb_ram_q, +8 txm_cnt;
//     -1 триггер автомата: 8 состояний = 3 триггера; v3.1: POR_W 14->6 = -8; v3.2: +1 por_run;
//     v3.6: ~98 - ветка div4 (-t0_q,-x1_q,-x2_q) заменена на cnt(3)+x1_p+x1_n+x2_p (+6));
//     v3.7: -txm_cnt (-8 FF и декод txm_run), +sod_q/tx_pass/tx_q
//     (tx_q/sod_q - в IO-MC пинов TX/SOD, логических +1) -> прогноз ~94/108;
//     v3.8: делитель 4+3 -> 5+1 триггера (cnt<3> фита v3.6 - балласт
//     4-го бита) -> прогноз ~93/108; входы ФБ 197 -> ~191 (узел платил
//     7 входов в FB6 и 5 в FB4 - теперь 6 и 0..2));
//     Maximum Frequency >> 25 МГц;
//     v3.9.2: узел 8 -> 4 триггера (кольцо r0..r6+x1_n -> cnt<2:0>+x1_n)
//     -> прогноз ~84/108 МЦ (85, если фиттер выделит por_ce в
//     хелпер-МЦ); ПТ ~214 -> ~225-250 (ядра X1/X2 по 4 ПТ + x1_n 4 ПТ
//     + cnt 4-7 ПТ; por_ce репликацией в por_sh_D или хелпером);
//     входы ФБ ~202 -> ~196-208 (FB4: r0..r6 -> cnt0..2, -4);
//     v3.9.7: узел 4 -> 8 триггеров (возврат кольца, п.22) -> прогноз
//     ~88-90/108 МЦ (у v3.9.6 было 85-87); ядра X1/X2 4 -> 2 ПТ
//     (XOR от r0 вместо декода cnt!=0);
//     v3.9.8: +clk25_q, por_sh 4 -> 8 бит, -x1_n = +4 МЦ -> прогноз
//     ~92-94/108 МЦ (у v3.9.7 прогноз ~88-90); ПТ ~225-240 (X2 - 6 ПТ
//     против 2), вх.ФБ ~170-180 (X2 ест 6 колец в FB6); Maximum
//     Frequency: узел 50 МГц (кольцо/clk25_q/por_sh на GCK3) и
//     логика 25 МГц (clk25) - ОБЕ должны закрыться;
//  h) в Equations (v3.9.8, КОЛЬЦО one-hot на clk 50 МГц + clk25 = /2,
//     п.23): состояние узла = ВЫХОДЫ триггеров r0..r6 (кольцо п.22
//     БЕЗ ИЗМЕНЕНИЙ); декодов равенства (==N) В УЗЛЕ БЫТЬ НЕ ДОЛЖНО
//     - появились: собран исходник v3.9.2-3.9.6! x1_n В НЕТЛИСТЕ
//     НЕТ - появился: собран исходник v3.9.7! (декларация x1_n в RTL -
//     ТОЛЬКО для legacy g_div_odd: XST компилирует все ветки generate;
//     в целевой конфигурации (2,1) - элайзится). Ожидаемые уравнения
//     (двойной kill п.15; фиттер вправе СОКРАЩАТЬ kill-литералы -
//     в легальном one-hot они избыточны; сверять ТАБЛИЦЕЙ
//     истинности, не полярностью одного терма; класс п.9 - фиттер
//     трижды терял инверсию декодов в фятах 10-22):
//       r1.D = r0 AND NOT r1 AND NOT r2 AND NOT r3;
//       r2.D = r1 AND NOT r2 AND NOT r3 AND NOT r4;
//       r3.D = r2 AND NOT r3 AND NOT r4 AND NOT r5;
//       r4.D = r3 AND NOT r4 AND NOT r5 AND NOT r6;
//       r5.D = r4 AND NOT r5 AND NOT r6 AND NOT r0;
//       r6.D = r5 AND NOT r6 AND NOT r0 AND NOT r1;
//       r0.D = r6 AND NOT r0 AND NOT r1 AND NOT r2 OR (NOT r0 AND
//              NOT r1 AND NOT r2 AND NOT r3 AND NOT r4 AND NOT r5
//              AND NOT r6)  (2 птерма; второй - рестарт из 00,
//              NOR7; вырожденный случай r0=1: оба птерма 0 - hold);
//       Init: r0=SET, r1..r6=RESET (все - clk 50 МГц, GCK3);
//       clk25_q.D = NOT clk25_q  (T-триггер /2, clk 50 МГц,
//              Init=RESET) - такт ЛОГИКИ 25 МГц;
//       X1 = r0  (1 ПТ; регистр r0 МОЖЕТ лечь в IO-MC пина P68);
//       X2 = r1 OR r2 OR r3 OR r4 OR r5 OR r6  (6 ПТ, БЕЗ инверсии
//              регистра - в легальном one-hot = NOT r0 = ~X1 ТОЧНО;
//              класс п.10/прецедент v3.4: если фиттер поднял X2 в
//              регистр В ФАЗЕ r0 - БРАК, CPU не заведётся);
//       por_ce = r0  (1 ПТ, 50-домен);
//       por_sh 8 бит (сдвиг вправо, 0 в MSB, Init=FF, clk 50 МГц),
//       por_run.D = por_sh[0] (Init=SET, clk 50 МГц);
//       rst_meta/rst_sync/rst_qcnt<2:0>/rst_press/reset_q/sod_q/
//       tx_pass/tx_q/state_FSM_FFd1..3 - clock = clk25 (НЕ clk!);
//       reset_q = FDCPE(clk25,'0','0') БЕЗ PRE (Init=RESET);
//       state = 3 триггера (без FFd4); v3.7: txm_cnt НЕТ - вместо
//       него sod_q/tx_pass/tx_q (3 FF, декодов НЕТ; tx_q и sod_q
//       должны лечь в IO-MC пинов TX P39 и SOD P72, tx_pass - лог.
//       MC); cnt/x1_p/x2_p/t0_q/x1_q/x2_q/x1_n/wb_ram_q В НЕТЛИСТЕ
//       БЫТЬ НЕ ДОЛЖНО (legacy-ветки элайзятся, защёлка - v3.9.1);
//       CS_n - уравнение от state_FSM_FFd1..3/A15/IOM БЕЗ литерала
//       wb_ram_q.
//     ГЛАВНАЯ ТОЧКА АУДИТА: сеть clk25 - на ГЛОБАЛЬНОЙ тактовой
//     (прецедент: complement of clk -> GCK2, фит v3.9.5); если
//     фиттер повесил clk25 на обычную трассировку - проверить
//     skew/setup в отчете о временах.
//     История узла/прогнозы по версиям: v3.9.1: МЦ 87, узел 8
//     триггеров (кольцо+x1_n), por_ce = r1|r6, por_sh 8 бит;
//     v3.9.2: МЦ ~84-85 (узел 4: cnt<2:0>+x1_n, кольцо удалено),
//     ПТ ~225-250; v3.9.3: GSR - D-функции логики БЕЗ литералов
//     сброса, вх.ФБ ~168-172, ПТ ~190-205; v3.9.4 (М1): por_sh
//     4 бита (Init=F, F->7->3->1->0), строб por_ce = x1_n
//     (ДЕКОДОВ В POR-ЦЕПИ НЕТ), МЦ 79-81, ПТ ~170-180, триггеры
//     50; v3.9.5: источник GSR = cpu_rst = RST|por_run; v3.9.6:
//     хардренинг RST (+rst_meta/rst_sync/rst_press/rst_qcnt<2:0>/
//     reset_q; рег 57, МЦ 85-87, ПТ 220-230, вх.ФБ 165-172; RST -
//     только во входах ФБ rst_meta); v3.9.7: узел 4 -> 8 триггеров
//     (r0..r6+x1_n вместо cnt<2:0>+x1_n), прогноз МЦ ~88-90, ПТ
//     ~215-230 (ядра X1/X2 4 -> 2 ПТ, kill-литералы кольца),
//     вх.ФБ ~165-175; логика шины/сброса бит-в-бит v3.9.6;
//     v3.9.8: вход 50 МГц (H1 без шунта), кольцо на clk 50, узел
//     8 триггеров (r0..r6 + clk25_q), por_sh 8 бит на clk 50
//     (строб r0), x1_n удалён, X2 - 6-ПТ OR; прогноз МЦ ~92-94,
//     ПТ ~225-240, вх.ФБ ~170-180; логика шины/сброса бит-в-бит
//     v3.9.7 (такт clk -> clk25).
//=====================================================================
// История (как в v1/top_nouart, логика чтения не менялась):
// Топология: AD0-AD7 процессора, A0-A7 flash/SRAM и CPLD - ОДНА медь
// (сети A0..A7). CPLD = регистровый трансивер:
//   чтение: память видит адрес в T1 (ALE=1) -> данные на D0-D7
//   захватываются в последний тик T1 -> в T2 (CPU отпустил AD) CPLD
//   выдаёт данные на A-сети;
//   запись: в T2 CPU гонит данные по A-сетям (CPLD Hi-Z), CPLD захватывает;
//   после WR#(вверх) - «отложенная запись» (writeback): CPLD сам ставит
//   защёлкнутый адрес на A-сети + данные на D-сети и даёт импульс
//   /WE_RAM (в v3: импульс защищён от ALE, см. п.4 шапки).
// Метод захвата - повторное сэмплирование, пока строб активен (последний
// сэмпл гарантированно валиден); без edge-детекторов и PT-клоков;
// v3.9.8 - два домена: узел тактирования 50 МГц (кольцо/clk25_q/
// por-цепь на GCK3) и логика 25 МГц (clk25 = /2-триггер), вся
// тиковая семантика логики - 25 МГц как в v3.9.2-3.9.7 (п.23).
// Сброс: SW20 -> RST (нажатие = 1, Task 25) + POR (v3.4: сдвиговый;
// 1120 нс @ 7,14 МГц в v3.9) -> RESET_IN=0;
// v3.9.3: сброс ЛОГИКИ - асинхронный по RST через СЕТЬ GSR (п.18);
// cpu_rst остался только для tx_pass/tx_q (PT-SR, защита окна POR)
// и RESET_IN; v3.9.6: сырой RST - только в синхронизатор, cpu_rst =
// rst_press|por_run (регистры), RESET_IN - регистр reset_q (п.21).
// RAM подтверждена на железе (Task 69-j: 4 паттерна x 32K без ошибок,
// T=1280 нс; режим T=400 нс - этот файл; tb v3: T3b/T3d/T3e PUSH-stress).
//=====================================================================
```
