digitalinvitro/CPLD-plus-8085/beta/txuart/history.md

# beta/txuart — история линии TXUART (кратко)

Действующий дизайн: **`top_txuart_por6_v25.v`** (v2.5, 11-14-2026) — единственная RTL-версия в папке.
Полные спецификации — в шапке RTL (п.27–п.34 + блоки v2.4/v2.5); полная история версий — в git (`git log --follow beta/txuart/`)
и в beta/DEVLOG.md. Эта страница — конспект экспериментов удалённых версий и их результатов.

## Линия версий

- **v2.5** (11-14): урок **аудита фита v2.4**. Фит был Successful, 101/108 (ровно прогноз), но печатное
  уравнение **X2_D = t0_q XOR X1 БЕЗ NOT** (RTL был XNOR `~(x1_q^t0_q)`) — таблица истинности печати:
  X2 **в фазе** с X1 с первого фронта, двухфазный такт разрушен → **БРАК, не шить**. Класс — «потеря
  инверсии», не новый (фит 7:31 `por_cnt(0): T=NOT en`, фит 8:55 `por_run.D=(por_cnt==0)`); гейт п.9
  («сверять ТАБЛИЦЕЙ, не полярностью одного терма») сработал. Аудитор `scripts/audit_fit_node.py`
  (таблица истинности печати узла + статика, вердикт ШИТЬ/НЕ ШИТЬ): fit4 = 20 PASS / 1 FAIL.
  Лечение: **D(x2_q) = (x1_q & t0_q) | (~x1_q & ~t0_q)** — та же функция (XNOR, 2 ПТ), но И-ИЛИ печать
  идёт в калиброванном формате с явными NOT (проверено на por_sh_T отчёта fit4); XOR-печать без NOT
  = НЕ ШИТЬ (в чек-листе h). T-форма (x2_q как FTCPE T=t0_q) отклонена: держится на инварианте, а не
  на D-функции. Диф кода vs v2.4 = ровно 1 строка (check_v25.py 38/38). Резерв после фита v2.4:
  **7 МЦ, 7 вх.ФБ, ~200 ПТ** — тик (TRAP) влезает: вариант C (+6 МЦ) с запасом, A (+7) впритык.
- **v2.4** (11-14): директива владельца — узел тактирования: кольцо one-hot s0..s3 (5 МЦ) →
  **делитель /4 на toggle-триггерах 3 FF** (`t0_q/x1_q/x2_q`, RTL владельца). Частота **не изменена**
  (период X1 = 160 нс, CPU 3,125 МГц; «потеря 0,5 МГц» — цена v2.2, уже в бюджете), duty X1 1/4 → 1/2.
  X2 — **регистровая точная противофаза**: D(x2) = XNOR(x1,t0) = будущий ~x1 — противофаза без лага,
  same-D слияние невозможно по построению; keep + equivalent_register_removal="no" + dont_touch.
  por_ce = ~t0&~x1 (POR 1280 нс без изменений). Самовыравнивание из любого кода за 1 такт.
  Ресурсы: узел 5 → 3 МЦ (−2), ПТ 6 → 5 (−1), вх.ФБ ~7 → ~3. Прогноз 103 − 2 = 101 наивно.
  Диф-сим узла `scripts/sim_div4_vs_ring.py`; верификатор `check_v24.py` 47/47; генератор `gen_v24.py`.
  **ФИТ v2.4** (11-14 1:51PM): Successful, **101/108** — ровно прогноз; узел чист по статике
  (3 FF, INIT (0,1,0): X1=SET/X2=RESET/t0=RESET, P68/P69 IO-MC FAST, строб ~X1&~t0_q в D всех 8 бит
  por_sh, por_run.D=por_sh(0) SET, s0..s3/clk25_q/x1_n в нетлисте НЕТ, декодов равенства нет) —
  но пойман брак D(X2) (см. v2.5): **НЕ ШИТЬ**.
- **v1** (11-7): первый аппаратный передатчик UART на базе топа por6 (механика txclient v8 / hwuart v4.0.1:
  shreg сам-idle, jam-фазировка, регистровый строб ld_tx_q). Прецедент фита: наивная сумма 102 МЦ,
  фит лёг в 100 (фиттер сверяет логику ядра с шинной).
- **v2.0** (11-8): перенос на базу v3.9.8-clear; цель была XC95144. Фит владельца 11-8 7:14PM на xc95108
  упал с ERROR:Cpld:837 «needs at least 431». Разбор: (1) чужие опции фиттера (Exhaustive ON + Input Limit 1 +
  Pterm Limit 1) режут логику в 296 однолитеральных осколков $OpTx$BIN_* — «431» фантом; (2) честный бюджет
  v2.0 = 111–113 МЦ > 108. Урок: рабочая линия опций — Exhaustive OFF, IL 16..28, Pterm 18. Ядро сжато 20 → 18 МЦ.
- **v2.1** (11-8): ядро 18 МЦ: adv_q и tx_run свернуты (bit_cnt 1..10, idle = 0, busy = |bit_cnt — 1 ПТ),
  shreg 9 бит сам-idle + ld_tx_q; провод TX/TXRDY 1-в-1 v2.0 (дифсим diffsim_v2_v21, 92/92, 8283 тиков,
  0 расхождений). Фит (fit1, 11-8 5:10PM) 105/108 — впритык, толчок к упрощению узла.
- **v2.2** (11-8 веч): директива владельца «уйти на простой делитель: вход 25 МГц, потом /4 на процессор».
  Узел: кольцо one-hot s0..s3 на clk 25 МГц (перемычка H1 С ШУНТОМ = DIV /4 генератора U7), X1 = s0
  (6,25 МГц, duty 1/4), X2 = s1|s2|s3 = ~s0, clk25_q удалён, ОДИН домен 25 МГц, por_ce = s0.
  Цена (принята): CPU 3,571 → 3,125 МГц (−12,5%), FW-константы тянутся ×1,143. Фит (fit2, 11-8 11:51PM)
  103/108, чек-лист закрыт. Бод = 25 МГц/16 = 1 562 500.
- **Железный урок v2.2**: терминал — мусор: биты 0–6 всегда точны, старший бит = '1' в ~половине байтов
  ('2'→0xB2, CR→0x8D…). Диагноз по дампу 1143 байт: TX-путь 1-в-1 (CPLD/прошивка ОК), приёмник CH340G
  получил НЕ 1 562 500 — этой частоты в сетке CH340G (48 МГц / 2^k·m) не существует; драйвер МОЛЧА ставит
  1 500 000 (+4,17%) → бит 7 попадает на границу данных/стоп и читается как стоп.
- **v2.3** (11-9): бод = 25 МГц / 25 = **ровно 1 000 000 8N1** (точная нижняя сетка CH340G, ошибка 0%);
  baud_cnt 4 → 5 бит (+1 МЦ, wrap явный по ==24). Фит (fit3, 11-9 7:26PM) **103/108** — ниже наивного
  прогноза 104 (слияния фиттера), чек-лист a)–i) закрыт. **ПРИНЯТО ЖЕЛЕЗОМ: 1М — чисто.**
  Контрольный ре-фит владельца 11-14 11:24AM — байт-в-байт fit3 (кроме даты): результат воспроизводим.

## Прошивка и измерения (rom/, scripts/)

- **rom/uart_tx_test**: первая железная проверка TX-ядра (эпоха v2.0/v2.1); симулятор scripts/…/sim_uart_tx_test.py.
- **TXSTRESS v1.0** (11-10): первый прогон дал мусор; диагноз — **баг ассемблера** (size_of корруптировал hex),
  плата невиновна. Фикс ассемблера + пересборка = **TXSTRESS v1.1** (+лендмарки); верификация по реальному hex.
- **TXSTRESS v1.1 на железе**: 8 циклов, паттерн +1 ЦЕЛ, B=7/7, U=8192/2816 — подтверждён. Прогон p04
  (TX_BOTH=0): потолок 32T/байт подтверждён железом — «шаг 0» GFXSTREAM закрыт.
- **uart_speed.ps1 v1.2 → v1.3**: в v1.2 скорость печаталась в Б/мс под подписью «Б/с» (×1000); v1.3 — фикс
  единиц + самотест на эталоне gen_txstress_sim.py. Контрольный 60-с прогон COM13 (TX_BOTH=1): **52/52 цикла,
  0 ошибок — кампания TXSTRESS закрыта**; устойчивые ~69,3 КБ/с (кадр 31,25T при T=320 нс). Прогон p04:
  88 237–92 956 Б/с (88–93 % провода при 100 КБ/с теоретических). Посекундные бампы min/max — алиасинг такта
  цикла с 1-секундными «вёдрами», шум, не дефект.
- **gfxstream** (v1 → v2.2): прошивки в rom/gfxstream, анализатор логов scripts/gfx_log_analyze.py; вьюер,
  логи и DEVLOG линии — beta/gfxstream.

## Итоговое состояние (фит 11-14, XC95108-15-PQ100, Successful)

103/108 МЦ (95%), 339/540 ПТ (63%), 211/216 вх.ФБ (98%), 77/108 регистров, 72/81 ног (9 «свободных» = PGND-девятка
P74/P75/P76/P78/P79/P81 — TRAP/RST7.5/RST6.5/RST5.5/INTR/HOLD — и P95/P96/P98 — A16–A18 flash). Свободно:
5 МЦ (FB1 ×2, FB3 ×3 — оба блока исчерпаны по входам), 201 ПТ, внешних ног 0. GSR не свёлся (известный
fallback-класс п.25/п.32-f), WARNING Cpld:897 — буферизация A<1> (переполнение входов FB1). Ядро TXUART в фите:
shreg 9 + bit_cnt 4 + baud_cnt 5 + ld_tx_q; кольцо s0..s3 (X1 = s0 в IO-MC P68, SET), декодов в узле нет.

## Чистка 11-14 (директива владельца: «оставь только v23, остальное убери, эксперименты — в history.md»)

**Оставлено:** `top_txuart_por6_v23.v` (действующий дизайн), `top_txuart.ucf` (цоколёвка/тайминг — обязательны
для фита), `rom/` (прошивки целиком: txstress, gfxstream, uart_tx_test, ассемблер asm85.py),
`scripts/` — только активные: `check_v23.py`, `check_fit_v23.py`, `gen_v23.py` (происхождение действующего RTL),
`gen_txstress_sim.py` (эталон самотеста v1.3), `sim_txstress_v11.py`, `verify_txstress.py`, `uart_speed.ps1`,
`make_ps1_sim.py`, `sim_gfxstream_v2.py`, `gfx_log_analyze.py`, и этот `history.md`.

**Удалено** (безвозвратно для папки; всё доступно в git-истории: `git log --diff-filter=D -- beta/txuart`):
- RTL v1/v2/v21/v22 и их _utf8-копии, включая top_txuart_por6_v23_utf8.v (дубль действующего v23);
- тестбенчи tb_txuart_v1/v2/v21/v22/v23 (Icarus);
- fit-отчёты txuart-fit1-1108-0510PM / fit2-1108-1151PM / fit3-1109-0726PM (fit3 = эталон действующего фита v2.3);
- логи uart_speed_v12_com13_60s / v13_com13_60s / v13_com13_p04_60s (результаты законспектированы выше);
- README.md кампании (содержание — в шапке v23, в этом файле и в beta/DEVLOG.md);
- скрипты удалённых версий: check_v1/v2/v21/v22, check_fit_v22, gen_v1/v2/v21/v22, gen_ucf_v1/v2/v22,
  diffsim_v2_v21, sim_txuart_v1/v2/v21, run_tb_v1/v2/v21/v22/v23 (сами тестбенчи удалены), sim_gfxstream_v1
  (заменён v2), sim_txstress_v10_repro (форензика бага ассемблера — законспектирована выше).
