digitalinvitro/CPLD-plus-8085/Schematic_CPLD_108_for_retro-V2_2026-10-05.pdf

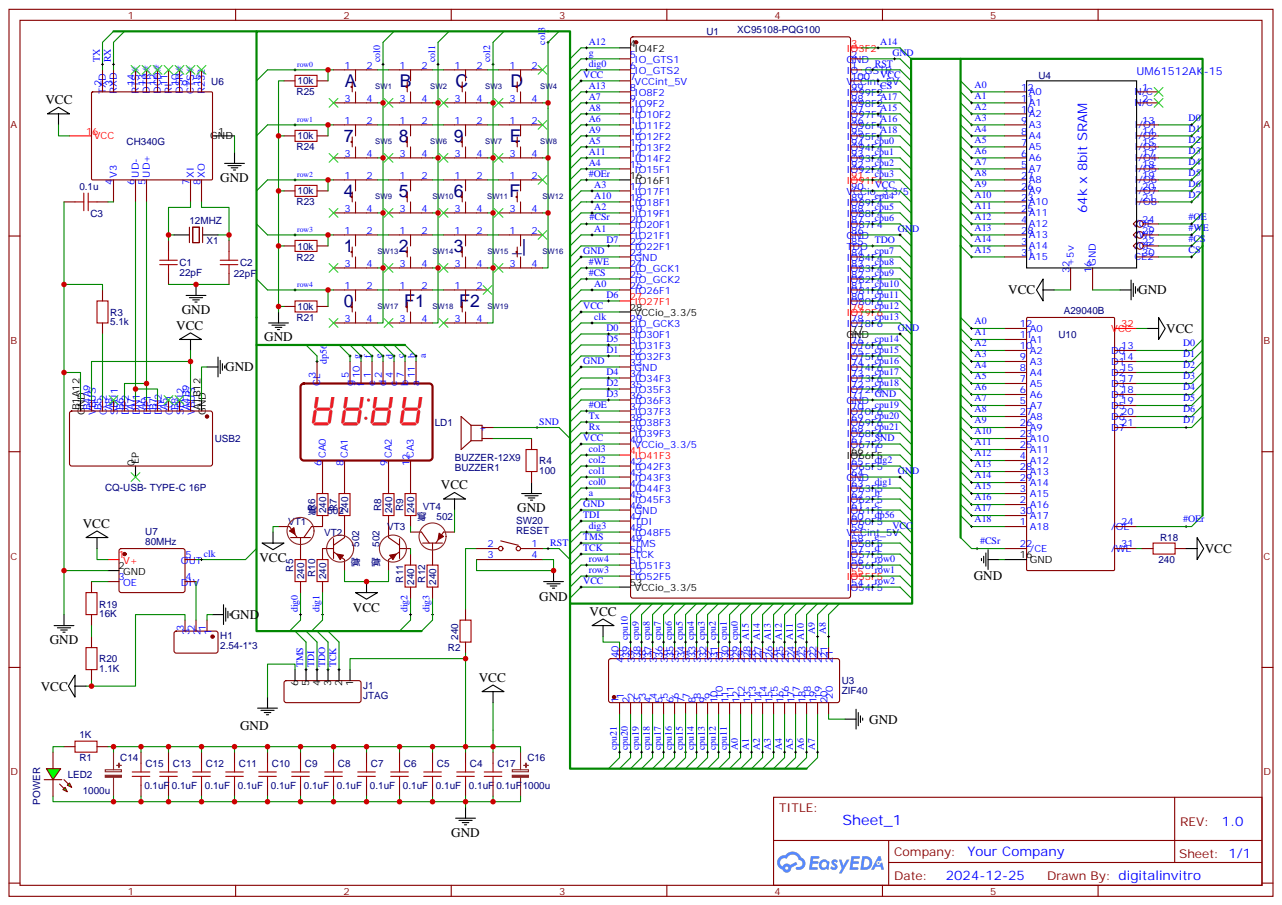
[picture p16: page 1]
