digitalinvitro/CPLD-plus-8085/PCB_retro_CPLD_PCB-V2_2026-10-05.pdf

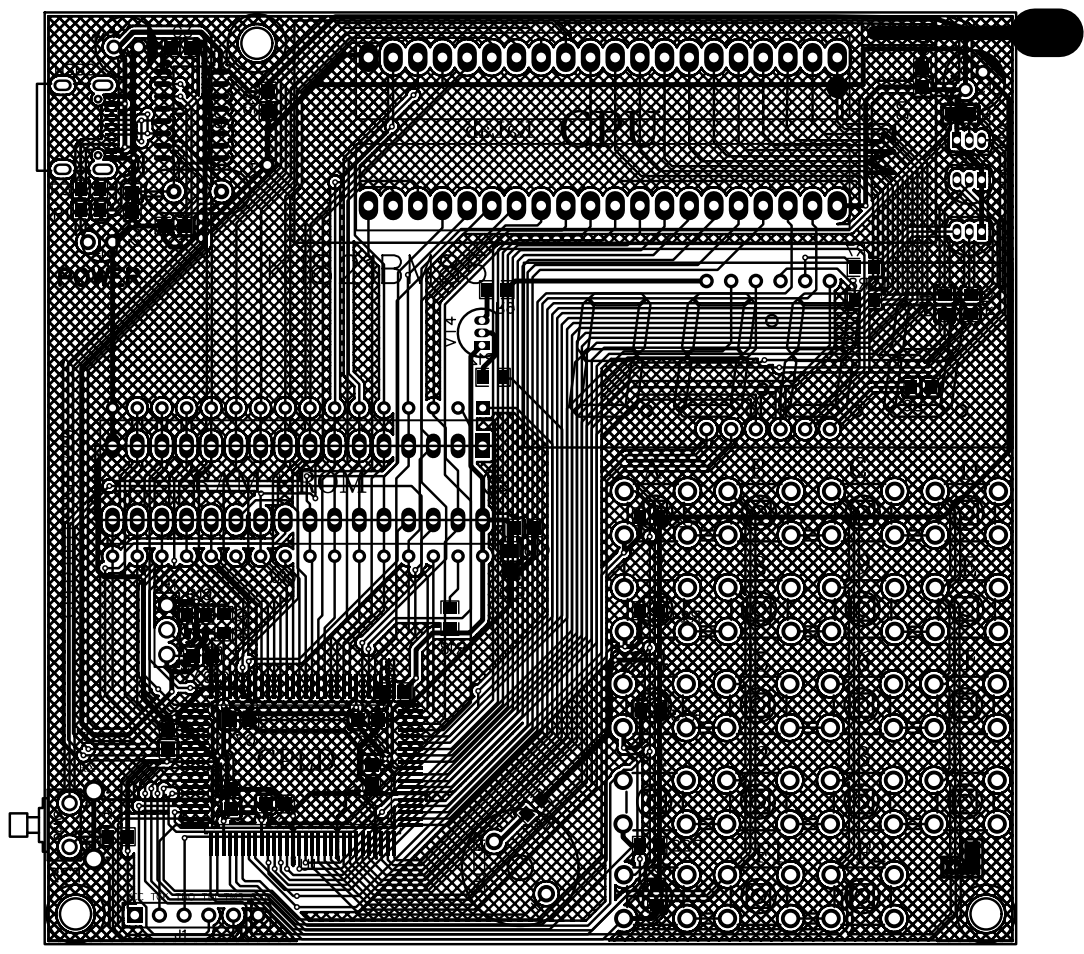
[picture p17: page 1]
