digitalinvitro/CPLD-plus-8085/(list of files, drawings)

Other design files:
retro_PCLD_board-V2_2026-10-05.schdoc
