digitalinvitro/CPLD-plus-8085/beta/txuart/top_txuart_por6_v25.v

//=====================================================================
// top_txuart.v v2.5 - retro_pcld_top + TXUART: ИСКЛЮЧИТЕЛЬНО АППАРАТНЫЙ
// ПЕРЕДАТЧИК UART 8N1 1 000 000 бод (такт ядра clk = 25 МГц / 25,
// BAUD_DIV=25 - явный wrap счётчика-делителя по (== 24), п.27)
// v2.5: D(x2_q) - ЯВНАЯ И-ИЛИ форма (урок аудита фита v2.4: печатная
// XOR без NOT = X2 в фазе = БРАК, класс потери инверсии 7:31/8:55).
// Узел - делитель владельца 3 FF (t0_q/x1_q/x2_q), частота CPU 3,125 МГц
// на БАЗЕ v3.9.8-clear ред.2: вход CPLD 25 МГц - H1 С ШУНТОМ (ОБЯЗАТЕЛЕН);
// ДЕЛИТЕЛЬ /4 3 FF (t0_q/x1_q/x2_q) на clk 25, X1 = x1_q duty 1/2
// (6,25 МГц -> CPU 3,125 МГц - та же частота, что у кольца v2.2-2.3),
// X2 = x2_q (регистровая ~X1); clk25_q УДАЛЁН - вся логика на
// clk 25 МГц, por-цепь в том же домене со стробом por_ce (п.23/п.34,
// v2.4);
// CS_n от FSM, п.16; СБРОС ЛОГИКИ -> СЕТЬ GSR от узла cpu_rst, п.18/20;
// RST только через регистры, п.21
//
// v2.3 (11-9, УРОК ПЕРВОГО ЖЕЛЕЗНОГО ПРОГОНА v2.2): терминал - МУСОР.
// Байтовая статистика дампа (1143 байта против эталона
// «TXUART v2.2 OK N=xx»): биты 0-6 ВСЕГДА точны, старший бит = '1'
// в ~половине байтов ('2'=0x32 -> 0xB2, '.'=0x2E -> 0xAE, '='=0x3D ->
// 0xBD, CR 0x0D -> 0x8D, LF 0x0A -> 0x8A), прочие байты точны.
// ДИАГНОЗ: TX-путь 1-в-1 (все байты опознаны - CPLD/прошивка ОК!),
// приёмник CH340G получил НЕ 1 562 500: сетка CH340G = 48 МГц/(2^k x m);
// 1 562 500 = 12 МГц/7,68 в сетке НЕ СУЩЕСТВУЕТ (даташит WCH:
// ...921600, 1500000, 2000000); драйвер МОЛЧА ставит 1 500 000
// (Linux ch341.c: div = 48М/(4х1562500) = 7.68 -> div 4, fact 0 =
// 48М/32 = ровно 1 500 000). Систематика +4,17%: семпл бита 7 в 93 нс
// от границы данных/стоп при дрожании квантования внутреннего 12 МГц
// (+-83 нс) - монетка: бит 7 = стоп '1' в ~половине кадров.
// ЛЕКАРСТВО: бод = 25 МГц/25 = РОВНО 1 000 000 - точная сетка ЛЮБОГО
// моста (12/24/30/48 МГц делятся на 1М нацело). Терминал 1 000 000 8N1.
// Цена: baud_cnt 4 -> 5 бит (+1 МЦ; ожидание фита 104/108); FW, узел,
// CPU, пор-цепь, контракт - БЕЗ ИЗМЕНЕНИЙ (кадр 10 мкс = 31 T, поллинг
// 27-90 T - тем более безопасен).
//
// v2.5 (урок АУДИТА ФИТА v2.4, 11-14 1:51PM): фит Successful, 101/108 -
// ровно прогноз (-2 МЦ); узел чист по всем статическим пунктам (3 FF,
// INIT (0,1,0): X1=SET/X2=RESET/t0=RESET, P68/P69 IO-MC FAST, строб
// ~X1&~t0_q свёрнут в D всех 8 бит por_sh, por_run.D=por_sh(0), SET;
// s0..s3/clk25_q/x1_n в нетлисте НЕТ; декодов равенства в узле НЕТ) -
// НО: печатное уравнение X2_D = t0_q XOR X1 БЕЗ NOT (RTL был XNOR
// ~(x1_q^t0_q)!). Таблица истинности ПЕЧАТИ: X2 В ФАЗЕ с X1 с первого
// фронта (INIT (0,1,0): e1 - t0:0->1, X1 hold 1 (T=t0_old=0), X2 <-
// 0^1 = 1 = X1) - двухфазный такт разрушен. КЛАСС: «потеря инверсии»,
// НЕ НОВЫЙ: фит 7:31 (por_cnt(0): T=NOT en -> POR=1 клок) и фит 8:55
// (por_run.D=(por_cnt==0)) - тот же класс; гейт п.9 («сверять
// ТАБЛИЦЕЙ, не полярностью одного терма») сработал как задуман.
// ЛЕКАРСТВО v2.5: D(x2_q) - ЯВНАЯ И-ИЛИ форма (x1_q & t0_q) |
// (~x1_q & ~t0_q): та же функция (XNOR, 2 ПТ), но печать попадает в
// КАЛИБРОВАННЫЙ И-ИЛИ формат (NOT печатаются явно - проверено на
// por_sh_T того же отчёта) -> следующий фит либо чисто печатается,
// либо аудит опять ловит. Аудитор: scripts/audit_fit_node.py -
// таблицей истинности печати, вердикт ШИТЬ/НЕ ШИТЬ (в fit4: 20 PASS /
// 1 FAIL - единственный FAIL = X2-D). BONUS: И-ИЛИ форма
// самовыравнивается из ЛЮБОГО кода (D не зависит от x2_q); T-форма
// (x2_q как FTCPE с T=t0_q) рассматривалась и ОТКЛОНЕНА: держится на
// инварианте, а не на D-функции. РЕЗЕРВ ПОСЛЕ ФИТА v2.4: 108-101 = 7
// МЦ, вх.ФБ 216-209 = 7, ПТ ~200 - тик (TRAP) влезает: вариант C
// (5 бит + CE-МЦ = +6 МЦ) с запасом, вариант A (7 МЦ) ровно впритык;
// решение - после ЧИСТОГО фита v2.5.
//
// v2.4 (директива владельца 11-14, УЗЕЛ ТАКТИРОВАНИЯ): кольцо one-hot
// s0..s3 (5 МЦ: 4 FF + X2-МЦ) -> ДЕЛИТЕЛЬ /4 на toggle-триггерах 3 FF
// (t0_q/x1_q/x2_q). ЦЕЛЬ - высвободить МЦ под узел периодического
// прерывания (тик на TRAP: 6 бит/256 мкс или 5 бит/128 мкс - следующий
// шаг ПОСЛЕ фита v2.4; в v2.4 ТИКА НЕТ - только делитель).
// ЧАСТОТА НЕ МЕНЯЕТСЯ: период X1 = 160 нс (25/4) в обоих узлах, CPU =
// 3,125 МГц как был («потеря 0,5 МГц» - цена v2.2, уже в бюджете;
// ВМ85А тактируется ФРОНТАМИ X1). Меняется только duty X1: 1/4
// (40/120) -> 1/2 (80/80) - прецеденты duty 1/7 (v3.9.8) и 1/4
// (v2.2-2.3) работали, 1/2 ШИРЕ обоих по high-фазе.
// ЗАЩИТЫ ПО КЛАССАМ:
//   п.9 (потеря полярности декодов): в D-пути узла декодов равенства
//     НЕТ - t0_q <= ~t0_q; x1_q <= x1_q ^ t0_q; x2_q <= ~(x1_q ^ t0_q);
//     единственный «декод» - литерал t0_q;
//   п.10 (X2 «регистр в фазе» - ПЕРЕФОРМУЛИРОВАН в v2.4): браком был
//     РЕГИСТР С ЛАГОМ (D = ~x1_q, сэмплирующий ТЕКУЩИЙ комплемент -
//     v3.4, CPU не стартует). В v2.4 X2 - явный регистр, чей D =
//     ~(x1_q ^ t0_q) = БУДУЩИЙ комплемент x1_q -> противофаза БЕЗ
//     лага в каждый такт (диф-сим: цикл 4 состояний + INIT + все 8
//     кодов, scripts/sim_div4_vs_ring.py). Подъёму нечего поднимать
//     (регистр уже в RTL); same-D слиянию нечего сливать (D(x2)
//     комплементарен D(x1), НЕ равен); equivalent_register_removal=
//     "no" + dont_touch - страховки от reachability-упрощения D(x2)
//     до ~x1_q. ГЕЙТ ФИТА: в .rpt D(x2_q) = 2 ПТ с литералами
//     {x1_q, t0_q}; ОДНОЛИТЕРАЛЬНАЯ = БРАК;
//   самовыравнивание: D(x2_q) не зависит от x2_q - ЛЮБОЙ код -> точная
//     противофаза за 1 такт (кольцу требовалось 2-3 фронта).
// РЕСУРСЫ: узел 5 -> 3 МЦ (-2), ПТ 6 -> 5 (-1), вх.ФБ ~7 -> ~3.
// Прогноз фита v2.4: 103 (факт fit3) - 2 = 101 наивно, ожидание
// 100-102/108 (прецедент v1.0/v2.3 -1..-2). por_ce = ~t0_q & ~x1_q:
// РОВНО ОДИН такт 40 нс за период - POR 1280 нс БЕЗ ИЗМЕНЕНИЙ.
// INIT (0,1,0) - легальное состояние цикла; ноги X1 P68 / X2 P69
// и UCF - БЕЗ ИЗМЕНЕНИЙ.
//
// ЛИНИЯ beta/txuart, ВЕРСИЯ 2.3 (история: v2.2 - директива владельца 11-9: (директива владельца 11-9: «Может
// быть уйти на более простой делитель тактовой, подать на вход
// тактовой не 50, а 25, потом /4 и подать на процессор» - упрощение
// узла ради гарантированного запаса МЦ на XC95108; XC95144 по-прежнему
// недоступна). История: v2.0 (база v3.9.8-clear, XC95144; фит 11-8
// 7:14PM - фантом опций + честные 111-113 МЦ), v2.1 (ядро 20 -> 18
// МЦ, ждала 105-108 из 108 - впритык).
// БАЗА = lowsize v3.9.8-clear ред.2 (фит 11-7 10:09PM 1-в-1 ЗОЛОТОМУ
// v3.9.8, ПРОШИТ И РАБОТАЕТ: 94/108 МЦ) - узел тактирования (кольцо),
// POR-цепь, харденинг сброса п.20/21 и FSM шины - БИТ-В-БИТ. ИСТОРИЯ
// v2.0 (цель была XC95144): фит владельца 11-8 7:14PM на xc95108 упал
// с ERROR:Cpld:837 «needs at least 431» - ФАНТОМ фрагментации (в
// прогоне стояли Exhaustive ON + Input Limit 1 + Pterm Limit 1 - при
// IL/PT=1 фиттер режет логику на однолитеральные осколки $OpTx$BIN_*
// (296 шт); успешная линия всегда: Exhaustive OFF, IL 16..28, Pterm
// 18 - разбор п.27). ЧЕСТНЫЙ бюджет v2.0 (п.31 ред. v2.0) 111-113 МЦ
// и вправду > 108 - v2.1 СЖИМАЕТ ЯДРО 20 -> 18 МЦ (п.31): adv_q и
// tx_run свернуты (jam 0; bit_cnt 1..10, idle = 0, busy = |bit_cnt -
// 1 ПТ), shreg 9 бит сам-idle и ld_tx_q (п.29) - БЕЗ ИЗМЕНЕНИЙ; провод
// TX и TXRDY - 1-в-1 v2.0 (доказано дифсимом, п.31). Ядро TXUART
// (механика v1.0 = txclient v8/hwuart v4.0.1: shreg сам-idle,
// jam-фазировка, регистровый строб ld_tx_q) - бит-в-бит v2.1, такт
// (clk, cpu_rst): clk25_q УДАЛЁН, частота такта 25 МГц та же (п.34).
// ЦЕЛЬ - XC95108-15PQ100C: наивно 94 - 3 транзит - 3 узел (кольцо
// 7+X1+X2 = 9 -> s0..s3+X1+X2 = 6) - 1 clk25_q + 18 = 105, по
// прецеденту v1.0 (фит лёг на 2 МЦ ниже наивной суммы) ожидание
// 101-103 (допуск 101-105 <= 108 - ВЛЕЗАЕТ С ЗАПАСОМ; v2.1 ждала
// 105-108 - впритык); резерв п.33 (-1 МЦ) - только по команде владельца.
// Спека/бюджет/контракт/чек-лист фита - блок «TXUART v2.1» в конце
// шапки и README линии.
//
//
// v3.9.8-clear ред.2 (2026-11-07): КОД top_suart_por6_v398.v МИНИМУС
// МЁРТВЫЙ legacy-КОД. Вычеркнуты: ветки делителя g_div2/g_div4/
// g_div_even/g_div_odd, их регистры cnt/x1_q/t0_q/x1_p/x1_n/x2_q/x2_p
// и localparam MEV/NMOD/NHALF. В нетлист v3.9.8 они НЕ попадали вовсе
// (XST триммил их - WARNING:Xst:1780), поэтому нетлист/ресурсы/
// тайминги ожидаются 1-в-1 с v3.9.8; Xst:1780 в логе синтеза БОЛЬШЕ
// НЕТ. Откат legacy-веток - исходник top_suart_por6_v398.v. Вся
// история версий v1->v3.9.8 (п.1-п.25: даты, фиты, нестарты,
// переговоры, прогнозы по версиям) перенесена ДОСЛОВНО в
// beta/DEVLOG.md. Здесь - только действующие решения и правила
// приёмки фита. Нумерация п.хх СОХРАНЕНА из v3.9.8, чтобы все ссылки
// «п.XX шапки» в теле файла остались валидными; номера с пометкой
// (истор.) описывают заменённые конструкции - их полный текст в
// beta/DEVLOG.md.
//
// ДЕЙСТВУЮЩИЕ РЕШЕНИЯ:
//  п.3  (= п.13) (истор. v2.0: TX-транзит ВЫПИЛЕН - заменён ядром
//       TXUART, п.27) TX-ТРАНЗИТ С ЗАХВАТОМ - см. п.13.
//  п.4  WRITEBACK - ЗАЩИЩЁННЫЙ ИМПУЛЬС /WE (главное решение шины!):
//       импульс /WE ДОВОДИТСЯ ДО КОНЦА НЕЗАВИСИМО ОТ ALE (hold-off 0,
//       цепочка WB сжата до 4 состояний): ALE обрывает только T2, в
//       WB1..WB4 НЕ вмешивается. Драйверы A/D держат СТАРЫЙ
//       адрес/данные до конца импульса (wb_out = in_wb БЕЗ !ALE);
//       конфликт с новым адресом CPU выигрывает CPLD (24 мА против
//       2 мА у ВМ85), адрес на входах ОЗУ стабилен весь импульс
//       (t_AS 40 нс, /WE 80 нс), запись попадает по адресу; захват
//       следующего цикла успевает в T1 (из WB в T1H попадаешь только
//       через IDLE - см. п.6).
//  п.5  (истор.) защёлка wb_ram_q УДАЛЕНА в v3.9.1 - см. п.16; защита
//       записи живёт построением п.4/п.16.
//  п.6  ЗАХВАТ T1H СТРУКТУРНО ЗАЩИЩЁН: из WB в T1H можно попасть
//       только через IDLE, поэтому addr_latch НЕ перезаписывается
//       посреди импульса.
//  п.8  por_run - РЕГИСТР, не комбинация: комбинационный декод
//       (por_cnt!=0) фиттер схлопывал в PT всех приёмников cpu_rst ->
//       ширина PT и входы ФБ росли, Placement Failed (фит v3.1); FF-
//       выход схлопыванию не подлежит. Правило живо: por_run.D =
//       por_sh[0].
//  п.9  (ПРАВИЛО ФИТТЕРА) декоды равенства в узле тактирования и
//       POR-цепи ЗАПРЕЩЕНЫ: фиттер трижды терял полярность свёрнутых
//       декодов (фиты 10-22 7:31/8:55 - счётчик залипал, POR
//       схлопывался до 1 клока, X2 вставал регистром в фазу). Поэтому:
//       POR - сдвиговый регистр por_sh БЕЗ декодов; в узле - кольцо
//       (декодов нет вовсе). Появился ==N в уравнениях узла - собран
//       НЕ ТОТ исходник.
//  п.10 (ПРАВИЛО ФИТТЕРА) X2 строится БЕЗ одиночной инверсии регистра:
//       комбинационная ~X1 фиттер поднимал в регистр В ФАЗЕ (keep на
//       порте НЕ спас, фит v3.4 - CPU не заведётся). Здесь X2 = 6-ПТ OR
//       r1..r6 = ~r0 в каждом легальном one-hot - комбинационный, same-D
//       слияние невозможно по построению. X2 в .rpt - регистр в фазе
//       r0: БРАК, не шить.
//  п.13 (истор. v2.0: транзит ВЫПИЛЕН, заменён ядром TXUART - п.27/
//       п.29) TX-ТРАНЗИТ С ЗАХВАТОМ ПО УРОВНЮ (замена TX-маски v2-v3.6,
//       txm_cnt и параметр TXM_W удалены): датасшит ВМ85А - аппаратный
//       сброс очищает SOD в '0', до первого SIM линия '0' = «вечный
//       start-bit» -> пустой фрейм в терминале. Вместо таймера - схемный
//       захват ПО УРОВНЮ (частота и длина init прошивки не важны):
//       sod_q - синхронизатор входа SOD по clk25 (метастабильность
//       гасится до использования, статический путь пин->пин разорван);
//       tx_pass - «линия захвачена»: async clear по cpu_rst (cpu_rst
//       держит tx_pass=0 ВЕСЬ POR - враждебный SOD в окне POR линию не
//       захватывает), взвод первым сэмплом SOD='1'; tx_q - регистр TX
//       (IO-MC пина P39, INIT=1, async set по cpu_rst): в сбросе TX='1'
//       мгновенно и БЕЗ клока, до захвата - чистый idle, после - транзит
//       sod_q (латентность <= 2 такта 25 МГц). Требование к прошивке
//       одно: первое касание SOD после сброса = SOD:=1 (TXIDLE fw_mon).
//       Теоретический ложный SOD='1' - лечение: захват по 2 сэмплам
//       подряд (+1 FF).
//  п.15 КОЛЬЦО С ДВОЙНЫМ KILL (самоочистка): r_i <= r_{i-1} & ~r_i &
//       ~r_{i+1} & ~r_{i+2}, рестарт из 00 по NOR7. ОДИНАРНЫЙ kill
//       («убей преемника», v3.8) на N=7 НЕ гасит пары '1' на дистанции
//       3-4 - они ОРБИТЯТ ВЕЧНО (14 из 128 состояний; поймано перебором
//       sim_v39_ring7.py ДО фита). Двойной kill: ЛЮБОЕ из 128 состояний
//       -> one-hot за <= 2 фронта (полный перебор sim_v39_ring7.py; на
//       RTL v3.9.8 - tb_poweron_v398 P0a: 2560 комбинаций с por-цепью).
//  п.16 CS_n В WRITEBACK - ОТ СОСТОЯНИЯ FSM: assign CS_n = in_wb ?
//       1'b0 : (!A15 | IOM); защёлка wb_ram_q удалена - единственный
//       читатель wb_ram_q был CS_n, а in_wb (state >= S_WB1) влечёт её
//       условие; сброс синхронный, одним фронтом со state. Эквивалент-
//       ность v3.9 доказана (полный перебор произведения машин + дифсим
//       двух RTL, 0 расхождений). В WB1..WB4 CS_n = 0 БЕЗ A15/IOM -
//       живой декод во время конфликта адресов по-прежнему не участвует,
//       запись ОЗУ защищена построением.
//  п.17 (истор.) линия счётчика mod-7 (v3.9.2-3.9.6) заменена кольцом
//       (возврат п.22) - полный текст в DEVLOG. v3.9.8-clear: legacy-
//       ветки делителя и их регистры (cnt/x1_q/t0_q/x1_p/x1_n/x2_q/
//       x2_p) УДАЛЕНЫ из RTL - v2.2: единственная ветка узла g_div4
//       (кольцо s0..s3, п.34); откат узла N=7 - top_txuart_por6_v21.v.
//       Отсутствие в нетлисте
//       проверяет чек-лист h), Xst:1780 более не выдаются.
//  п.18 СБРОС ЛОГИКИ -> СЕТЬ GSR (асинхронный): always @(posedge clk
//       or posedge cpu_rst) / if (cpu_rst) - условие v3.9.2 (чистка
//       КАЖДЫЙ такт сброса), структура уводит сброс в СЕТЬ GSR. ВНЕ GSR
//       сознательно (бит-в-бит v3.9.2): делитель (X1 не глушится при
//       сбросе, фаза CLKOUT не прыгает), por-цепь (por_run в GSR нельзя
//       - сбрасывал бы сам себя; POR только по питанию), sod_q,
//       tx_pass/tx_q (async SR по cpu_rst - держит tx_pass=0 весь POR).
//       Риск метастабильности снятия GSR - осознанный компромисс: FSM
//       самозатухающий (default->IDLE, abort по ALE, повторный захват).
//       ГЕЙТ ОКНА POR: FSM в окне POR ЖИВОЙ (GSR не активен), а шина
//       CPU в сбросе «floated» (ВМ85А 3-стирует управления/адрес/данные)
//       - вход в writeback ЗАПРЕЩЁН (!por_run в S_T2): импульс /WE в
//       окне POR невозможен ПО ПОСТРОЕНИЮ.
//  п.20 GSR-ИСТОЧНИК = cpu_rst = rst_press | por_run (НЕ сырой RST):
//       в окне POR логика чистится асинхронно с t=0 (por_run=1 с INIT)
//       - чистый выход в IDLE ГАРАНТИРОВАН; дефект v3.9.4 «грязный
//       выход CPU из POR» закрыт (fuzz tb_por_fuzz: грязь на снятии
//       por_run - v3.9.4 100/100, v3.9.5 0/100); кнопка RESET - прежняя
//       семантика (см. п.21).
//  п.21 ХАРДРЕНИНГ RST: пин входит в кристалл ТОЛЬКО через регистры
//       (мид-рейл/дребезг/помеха на SW20 физически не доходят ни до 40
//       сбросовых входов триггеров, ни до ноги RESET_IN; в v3.9.5 RST
//       шёл напрямую в гейт RESET_IN и PTC-сбросы - дефект старта):
//       (a) 2FF-синхронизатор rst_meta/rst_sync (вне сброса, INIT=0);
//       (b) квалификатор rst_press/rst_qcnt - переворот на 8-м такте
//           ПОДРЯД устойчивого rst_sync != rst_press (двусторонний:
//           и взвод, и снятие квалифицированы); дребезг короче 280 нс
//           не виден вовсе, длиннее - ПОЛНОЦЕННЫЙ повторный сброс;
//           ПОСЛЕДНЕЕ снятие всегда из held-чистого состояния;
//       (c) cpu_rst = rst_press | por_run - ТОЛЬКО регистровые
//           источники (комбинаций от пинов в цепи сброса нет);
//       (d) RESET_IN - РЕГИСТР reset_q (INIT=0 - CPU в сбросе с t=0
//           до всякого клока; снятие - чистым фронтом);
//       (e) гейт S_T2: !por_run AND !rst_press (рубеж распространён
//           на окна кнопочного сброса);
//       (f) начатый импульс /WE (80 нс) НЕ обрывается: квалификатор
//           (400 нс) длиннее импульса - запись доводится до конца.
//       Латентность кнопки 400..440 нс (2FF + 8 такт квалификатора +
//       reset_q); НОВОЕ свойство: глитч на RST короче ~280 нс сброс НЕ
//       вызывает. POR НЕ ТРОНУТ (вне GSR, повторный POR невозможен).
//  п.22 КОЛЬЦО one-hot s0..s3 - БАЗОВЫЙ узел v2.2 (шаблон кольца
//       r0..r6 v3.9.8 п.15, сжатый N=7 -> N=4 по директиве владельца
//       11-9; классы те же: one-hot, двойной kill, рестарт из 00,
//       декодов равенства НЕТ). Исходный N=7 (истор.) - единственная
//       конфигурация узла, дававшая в ПОЛЕ стабильные сессии у обоих
//       экземпляров; лотерея включения сведена к аналоговой за
//       пределами делителя - детали и чек-лист D1-D4 в DEVLOG).
//       Построение - п.15 (истор. N=7) и п.34, домен - п.23/п.34.
//  п.23 УЗЕЛ ТАКТИРОВАНИЯ НА 25 МГц (v2.2, директива владельца 11-9:
//       «Может быть уйти на более простой делитель тактовой, подать
//       на вход тактовой не 50, а 25, потом /4 и подать на
//       процессор»): вход CPLD 25 МГц - перемычка H1 С ШУНТОМ
//       (DIV=/4 генератора U7; БЕЗ шунта 50 МГц ЗАПРЕЩЕНО - CPU
//       6,25 МГц = 1,75x разгона, бод 3,125 М вне CH340G, п.34).
//       Кольцо s0..s3 (п.22) тактируется clk 25 МГц НАПРЯМУЮ (период
//       160 нс). X1 = s0: фронт строго каждые 160 нс = 6,25 МГц,
//       duty 1/4 (high 40 / low 120 нс) - high ШИРЕ золотого 20-нс
//       v3.9.8, генерация CPU заведётся тем более; внутренний /2
//       ВМ85А тактируется ФРОНТАМИ X1 -> CLK = 3,125 МГц, период
//       320 нс, duty РОВНО 50%. CPU МЕДЛЕННЕЕ золотого 3,571 МГц на
//       12,5% - ОЗУ/ВМ85А только в выигрыше; ЦЕНА ПРОШИВКИ: все
//       цикло-калиброванные константы FW (DLY ~1 мс = 0095h и пр.)
//       тянутся в 1,143x (744 -> 651 такт/бит программного UART
//       4800, если используется; монитор ACdE терминала НЕ
//       использует - индикатор/клавиатура/звук деградируют
//       безбольно, п.34). X2 = s1|s2|s3 = ~s0 в легальном one-hot
//       (п.10); в illegal-кодах самоочистки X2 != ~X1 - транзиент
//       во время POR на мёртвой для CPU фазе, схемно незначимо
//       (класс базы). ЛОГИКА (rst/TX/FSM/порты) - на clk 25 МГц
//       НАПРЯМУЮ: clk25_q УДАЛЁН (v2.2) - частота такта логики НЕ
//       ИЗМЕНИЛАСЬ (clk25 базы = 25 МГц = clk v2.2), /WE 80 нс
//       (2 тика), квалификатор 320 нс (8 тиков) и все тиковые
//       константы живут бит-в-бит; тайминг FSM 1-в-1 базе (доказан
//       фитами v3.9.8). por-цепь - В ДОМЕНЕ clk 25: por_sh[7:0]
//       (Init=FF), строб por_ce = s0 - РОВНО ОДИН такт 40 нс за
//       период кольца 160 нс; строб и por-цепь в ОДНОМ домене -
//       синхронное включение того же такта, детерминировано
//       (класс-урок «фазовой лотереи» базы закрыт по построению).
//       POR = 8 x 160 = 1280 нс (норма 3 такта CLK OUT = 960 нс,
//       запас 1,33x - ТОТ ЖЕ, что у базы); повторный POR
//       невозможен (после 00 сдвиг держит нули навсегда).
//  п.24 (истор. узла N=7) ВЕРИФИКАЦИЯ v3.9.8: дифсимуляция tb_v398_diff.v (Icarus 12.0) -
//       69 044 выборки 5 нс, 0 расхождений с v3.9.7 на всех выходах
//       логики (por_run, RESET_IN, кромки кнопки - на тех же кромках);
//       XP: X1 ровно 140 нс, duty 20/120 у обоих; tb_poweron_v398:
//       P0a 2560 комбинаций (128 кодов кольца x 10 por_sh x 2 фазы
//       clk25) - one-hot <= 2 фронтов, дрейн <= 1600 нс у ВСЕХ;
//       P0b PASS (монотонный дрейн без возврата); P1 - сид-в-сид
//       эталону v3.9.7 (3/100 хвостовых /WE - принятый класс окна);
//       P2-P5 PASS (мёртвый clk, поздний clk, RST=1, лотерея
//       передёргиваний). ЖЕЛЕЗО: подтверждено владельцем - v3.9.8
//       стабильно, зависаний нет (базовый кандидат линии).
//  п.25 (истор. узла N=7) АУДИТ ФИТА v3.9.8 (фит владельца) -
//       ВЕРДИКТ «ФИТ ЗОЛОТОЙ»:
//       94/108 МЦ (87%), 287/540 ПТ (53%), 183-185/216 вх.ФБ, 65 рег,
//       72/81 ноги; сравнение IL 16 vs IL 28 - байт-в-байт (остаться
//       на IL 28). Кольцо = RTL байт-в-байт: r0 - FB6_3 (P68, INIT
//       SET, 2 ПТ), r1..r6 - INIT RESET (FB6); двойной kill + рестарт
//       из 00 по NOR7 на месте, декодов равенства НЕТ. X2 - своя МЦ
//       FB6_5 (P69), 1 ПТ: фиттер свернул 6-ПТ OR в NOR-форму с
//       инверсией выхода (класс п.10, эквивалент точный),
//       комбинационный (регистра нет - «в фазе r0» исключено).
//       clk25_q - 1 триггер; por_sh[7:0] на clk 50 (Init=FF), строб
//       r0, por_run.D = por_sh[0]; сброс - п.21. WARNING:Cpld:897 -
//       буфер D<7> (FB5_7) - известный класс, НЕ блокер (первый
//       подозреваемый при сбоях бита D7); сеть clk25 - на глобальной
//       тактовой (прецедент: complement of clk -> GCK2, фит v3.9.5);
//       clk -> GCK3 - единственная глобальная.
//  п.26 (истор. узла N=7) АУДИТ РЕФИТА v3.9.8-clear ред.2 (фит
//       владельца 11-7 10:09PM,
//       IL 28, Pterm 18, Exhaustive OFF, DENSITY) - ВЕРДИКТ «1-В-1
//       ЗОЛОТОМУ v3.9.8»: дифф .rpt с эталоном
//       retro_pcld_top (v398-fit1-1106-719PM).rpt (IL 16) - ЕДИНСТВЕННОЕ
//       отличие = строка опции Input Limit (16 -> 28); с золотым
//       прогоном IL 28 (11-6 7:26PM) - НЕТ различий вовсе (кроме строки
//       Date). Ресурсы 94/108 МЦ, 287/540 ПТ, 183/216 вх.ФБ, 65 рег,
//       72/81 ноги; размещение и Equations байт-в-байт: кольцо r0..r6
//       (FB6, двойной kill, X1/r0 = 2 ПТ), X2 - NOR-форма 1 ПТ/6 вх
//       (FB6_5, класс п.10), clk25_q 1 триггер, por_sh 8 бит Init=FF,
//       por_run.D = por_sh[0], сброс п.21; мёртвых сигналов
//       cnt/x1_q/x1_p/x1_n/x2_q/x2_p/t0_q в нетлисте НЕТ - Xst:1780
//       негде взяться. PGND = {P74,P75,P76,P78,P79,P81,P95,P96,P98};
//       WARNING:Cpld:897 (D<7>) - известный класс п.25; GSR не свёлся -
//       fallback п.18/20 (как в золотом). .jed = золотому v3.9.8.
//       Слово владельца: «Отчет по 398_clear смотри, железо - работает!»
//       - петля ред.2 ЗАКРЫТА (аудит скриптом scripts/fit_diff_v398clear.py,
//       отчёты заархивированы в beta/lowsize/).
//
// TXUART v2.2 (п.27-п.34) - ИСКЛЮЧИТЕЛЬНО АППАРАТНЫЙ ПЕРЕДАТЧИК UART
// НА БАЗЕ v3.9.8-clear ред.2. Директива владельца 11-9: «Может быть
// уйти на более простой делитель тактовой, подать на вход тактовой
// не 50, а 25, потом /4 и подать на процессор» - узел сжат: кольцо
// N=4 на clk 25 МГц (H1 С ШУНТОМ), clk25_q удалён, вся логика на
// clk 25 МГц (п.34). База бит-в-бит (POR, харденинг сброса п.20/21,
// FSM шины); TX-транзит v3.7 выпилен (п.3/п.13 - истор.); SOD (P72) -
// вход-наблюдатель keep; SID = RX сохранён; ядро v2.1 (18 МЦ) -
// бит-в-бит, такт (clk, cpu_rst).
//
// п.27 РАЗБОР ФИТА v2.0 (11-8 7:14PM, xc95108, FAILED - архив:
//   «retro_pcld_top (v2-fit1-1108-0714PM-FAILED).rpt»): статус Design
//   Rule Checking Failed, ERROR:Cpld:837 «needs at least 431», 868,
//   «No logic has been mapped», 386 незмапленных узлов (296 из них -
//   однолитеральные осколки $OpTx$BIN_STEP), глобальные GCK/GSR/GTS
//   не назначены. ПРИЧИНА №1 - ЧУЖИЕ ОПЦИИ ФИТТЕРА: в Compiler Options
//   отчёта Exhaustive Fitting: ON + Input Limit: 1 + Pterm Limit: 1;
//   успешная линия всегда: Exhaustive OFF + IL 16..28 + Pterm 18
//   (п.25/п.26; INFO:Cpld:994 «pterm limit: 1 and input limit: 1» в
//   успешных .rpt линии НЕ встречается вовсе). При IL/PT=1 коллапсинг
//   выключен - каждый аддер/мультиплексор рассыпается на 1-ПТ крошки,
//   111 МЦ честной логики раздувается в 431 МЦ фантома. ВЫВОД: 431 -
//   НЕ размер дизайна. ПРИЧИНА №2 - ЧЕСТНЫЙ ПЕРЕБОР: бюджет v2.0
//   (п.31 ред. v2.0) 111-113 МЦ > 108 - на XC95108 v2.0 не влезала и
//   с правильными опциями (потому цель была XC95144). Директива
//   11-8веч: 144 НЕТ -> ядро сжато до 18 МЦ (п.31), цель XC95108.
// п.28 СПЕКА (= v2.0 п.27; v2.2: такт clk; v2.3: бод 1М): TX-only 8N1,
//   бод = clk (25 МГц) / 25 =
//   1 000 000 (BAUD_DIV=25: счётчик-делитель - свободный двоичный
//   mod-25, wrap ЯВНЫЙ по (== 24): один компаратор 1 ПТ/5 вх в
//   D-функциях счётчика. 1М = ТОЧНАЯ сетка CH340G: 48 МГц/48 = 12 МГц/12,
//   ОШИБКА 0%; старый 25/16 = 1 562 500 в сетке НЕ ЛЕЖАЛ - драйвер
//   молча ставил 1,5 М (+4,17% = мусор, урок железа 11-9, шапка v2.3)).
//   Доступ CPU: OUT 04h = TXDATA
//   (старт кадра), IN 05h = статус {000000, TXRDY, 0} (бит A1 =
//   tx_idle = ~|bit_cnt - позиция совместима с hwuart v4.0.x). RX
//   НЕТ: приём - программный (SID = RX, RIM 20h - как в lowsize).
//   Такт ядра - clk (25 МГц, такт ЛОГИКИ п.23/34): бод на плате = РОВНО
//   1 000 000 - и СТОЛЬКО ЖЕ у моста (кварц моста 12/24/30/48 МГц -
//   все делятся на 1М нацело, рассогласование 0 ПО СТРОЕНИЮ).
// п.29 СБРОС/ДОМЕНЫ (v2.4 - ОДИН домен 25 МГц): узел (делитель
//   t0_q/x1_q/x2_q, por_sh/por_run) - clk 25 МГц, ВНЕ GSR (структура
//   базы; INIT (0,1,0) - конфигурационный, бинарный цикл не залипает);
//   логика (FSM, rst-цепь, ядро) - на ТОМ ЖЕ clk 25 (clk25_q удалён);
//   СЕТЬ GSR - от cpu_rst =
//   rst_press | por_run (п.20/21): ядро в GSR-домене (shreg SET-ветка
//   INIT=1FF - TX='1' до всякого клока; bit_cnt/baud_cnt/ld_tx_q -
//   CLR), чистится и в окне POR, и при кнопке. RESET_IN = reset_q -
//   РЕГИСТР (п.21d, бит-в-бит базы). ЛАТЕНТНОСТЬ кнопки 400..440 нс
//   (п.21): RST посреди кадра глушит ядро через ~10 тиков clk -
//   класс «сброс во время передачи = линия в idle», приёмник кадр
//   отбрасывает.
// п.30 РЕГИСТРОВЫЙ СТРОБ ЗАГРУЗКИ ld_tx_q (= v2.0 п.29, БЕЗ ИЗМЕНЕНИЙ):
//   io_wr_tx имеет ЕДИНСТВЕННОГО потребителя (ld_tx_q.D); загрузка
//   shreg - на тик ПОЗЖЕ строба с живых A-пинов: CPU держит данные до
//   подъёма WRn (>= 20 тиков clk) - запас x10; !ld_tx_q в декоде =
//   ОДНОКРАТНОСТЬ (первый тик !WRn); !rst_press - класс п.21e (оба
//   источника сброса гейтят шинные действия). НОВАЦИЯ v2.1: гейт
//   занятости в декоде - ЛИТЕРАЛЫ tx_idle (4 inline-литерала ~|bit_cnt
//   в тот же 1 ПТ - узел tx_run v2.0 не нужен): OUT 04h при busy тихо
//   отбрасывается, кадр не портится (контракт v1.0/v2.0).
// п.31 ТАЙМИНГ КАДРА И БЮДЖЕТ: загрузка (ld_tx_q) -> старт-бит '0' с
//   этого такта, jam baud_cnt <= 0 -> первый сдвиг ровно через 16
//   тиков clk - старт РОВНО 16 тиков = 640 нс, ВСЕ переходы на
//   сетке 16 тиков (v2.0 достигал того же парой «jam 1 + лаг adv_q» -
//   фронт первого сдвига СОВПАДАЕТ, дифсим v2.0 vs v2.1: сетка 1-в-1);
//   bit_cnt = 1..10 - НОМЕР БИТ-ТАЙМА кадра (1 = старт, 2..9 = данные,
//   10 = стоп): на 10-м сдвиге bit_cnt сам в 0 (idle) - кадр закрыт
//   РОВНО на 10-м бит-тайме, TXRDY = ~|bit_cnt поднимается в конце
//   стопа (ТОТ ЖЕ тик, что !tx_run v2.0 - дифсим); сдвиг idle-регистра
//   (все '1') - НЕТ-ОП, гейт сдвига shreg НЕ НУЖЕН (bit_cnt
//   инкрементируется только при busy - иначе бы бежал в idle);
//   инжекция '1' в MSB: после кадра shreg сам в 1FF (idle по
//   построению, как txclient); при непрерывном поллинге фактический
//   стоп у ПК >= 1 полного бита (приёмник терпит длинный стоп -
//   контракт hwuart). сброс cpu_rst: GSR, TX='1' (SET-ветка shreg),
//   ядро вычищено (CLR-ветка bit_cnt/baud_cnt/ld_tx_q - как v2.0).
//   БЮДЖЕТ/ПРОГНОЗ ФИТА (v2.2): база 94 МЦ - 3 (транзит sod_q/tx_pass/
//   tx_q) + 18 (ядро: shreg 9 + bit_cnt 4 + baud_cnt 4 + ld_tx_q 1;
//   ВЫПИЛЕНЫ adv_q 1 и tx_run 1 против v2.0) - 3 (узел: кольцо 7 ->
//   s0..s3, X1/X2 те же классы) - 1 (clk25_q УДАЛЁН) = 105 МЦ наивно;
//   ПРЕЦЕДЕНТ v1.0: наивная сумма 102, фит лёг в 100 (-2: фиттер
//   сверяет логику ядра с шинной) -> ожидание 101-103 <= 108 - ВЛЕЗАЕТ
//   С ЗАПАСОМ (v2.1 ждала 105-108 - впритык; узел v2.2 дал +5 МЦ
//   резерва). Если фит скажет «needs N», N > 108 - НЕ крутить опции
//   (класс-урок п.27!), писать на аудит; следующий рычаг - резерв
//   п.33. Допуск чек-листа g): МЦ 101-105, рег ~72-78, вх.ФБ
//   ~190-210/216, ПТ ~290-330/540, ноги 72/81.
// п.32 ЧЕК-ЛИСТ ФИТА (владельцу, после прогона ISE): УСТРОЙСТВО в
//   проекте - xc95108-15pq100c (v2.0 просил xc95144 - ВЕРНУТЬ, если
//   менялся); опции КАК У УСПЕШНОЙ ЛИНИИ (v3.9.8-clear ред.2, п.26):
//   Input Limit 28, Pterm Limit 18, Exhaustive OFF, DENSITY - НЕ IL 1/
//   PT 1/Exhaustive ON (класс-урок п.27!); если ERROR 891/892 - писать
//   на аудит (НЕ включать Exhaustive самовольно):
//   a) Successful, 0 ERROR; WARNING Cpld:897 <= 1-2 (класс D<7>);
//      WARNING:Xst:1780 БЫТЬ НЕ ДОЛЖНО (в RTL нет мёртвых
//      идентификаторов: sod_q/tx_pass/tx_q/cnt/x1_n/adv_q/tx_run
//      вычеркнуты);
//   b) adv_q/tx_run/sod_q/tx_pass/tx_q в .rpt НЕТ; TX = shreg[0]
//      (IO-MC P39, FDCPE с PRE по GSR-классу - SET-ветка, idle '1');
//      shreg - РОВНО 9 триггеров; bit_cnt - РОВНО 4 (idle = 0000);
//   c) GSR: «GSR : 1» (или fallback PT-сбросов от cpu_rst - класс
//      п.25, на разбор); D-функции логики БЕЗ литералов сырого RST
//      (п.21: RST - только во входах rst_meta); por_sh/por_run/
//      rst-цепь (rst_meta/rst_sync/rst_qcnt/rst_press/reset_q) -
//      ВНЕ GSR; ядро + FSM/шина - CLR/SET=cpu_rst;
//   d) ДЕЛИТЕЛЬ на месте (v2.4): РОВНО 3 регистра t0_q/x1_q/x2_q,
//      D = ~t0_q / x1_q^t0_q / ~(x1_q^t0_q), ДЕКОДОВ РАВЕНСТВА В УЗЛЕ
//      НЕТ, kill/рестарт-логики НЕТ; INIT (0,1,0);
//      X1 = x1_q (IO-MC P68), X2 = x2_q (IO-MC P69); D(x2_q) = 2 ПТ
//      с литералами {x1_q,t0_q} - ОДНОЛИТЕРАЛЬНАЯ ~x1_q = БРАК (класс
//      п.10/v2.4); s0..s3 в нетлисте НЕТ (появился любой - собран не
//      тот исходник!); clk25_q и x1_n в нетлисте НЕТ; por_sh 8 бит
//      Init=FF, por_run.D = por_sh[0];
//   e) baud_cnt: D-функции БЕЗ декода терминального счёта (свободный
//      инкремент, wrap натуральный); строб загрузки - через регистр
//      ld_tx_q (1 МЦ, в .rpt есть); декод io_wr_tx свернут в ld_tx_q.D
//      (1 ПТ ~14 литералов); бит-таймы - bit_cnt 1..10 (декод ==10 -
//      в D bit_cnt, класс ядра - НЕ узел);
//   f) пины: TX P39 вых, SOD P72 вх (INP, наблюдатель), SID P73 вых,
//      RX P38 вх; PGND ровно 9 ({P74,P75,P76,P78,P79,P81,P95,P96,
//      P98}); clk -> GCK3, RST = P1;
//   g) ресурсы сверить с прогнозом п.31 (допуск +-2 МЦ / +-10 вх.ФБ);
//      Maximum Frequency: логика 25 МГц - должна закрыться (один
//      домен v2.2, узел = тот же clk 25);
//   h) литералы сброса в термах: rst_press/por_run как RESET (GSR-
//      класс); сырого RST в термах НЕТ (п.21);
//   i) КОНФИГУРАЦИЯ ПЛАТЫ (v2.2): H1 С ШУНТОМ = 25 МГц (DIV=/4
//      генератора U7) - ОБЯЗАТЕЛЬНО ДО ПОДАЧИ ПИТАНИЯ; БЕЗ шунта
//      50 МГц -> CPU 6,25 МГц (1,75x разгона ВМ85А/ОЗУ), бод
//      3,125 М вне CH340G - НЕ ВКЛЮЧАТЬ; осциллограф: GCK3 = 25 МГц,
//      X1 = 6,25 МГц (период ровно 160 нс, high 80 / low 80 - duty
//      1/2, v2.4; было 40/120 duty 1/4), X2 = 6,25 ТОЧНАЯ ПРОТИВОФАЗА
//      (регистровая; окна X1=X2='1' НЕТ; если X2 с лагом/в фазе -
//      БРАК фита, класс п.10/v2.4), CLKOUT = 3,125 МГц duty 50%;
// п.33 РЕЗЕРВ (-1 МЦ, НЕ ПРИМЕНЁН - только по команде владельца):
//   ld_tx_q -> одноразовость от !wr_seen (регистр базы: взводится
//   первым тиком !WRn в T2, снимается на WRn(вверх)) - строб загрузки
//   станет комбинационным (io_wr_tx свернётся в D-функции shreg, -1
//   МЦ); ЦЕНА: теряется тиковая фильтрация декода (класс bus_reg -
//   повторный сэмплинг базы и так живёт с сырым !WRn) и тик запаса на
//   прогретые данные A; применить, если фит скажет >108.
// п.34 УЗЕЛ v2.2 - ДЕЛИТЕЛЬ /4 НА 25 МГЦ (директива владельца 11-9).
//   ЧТО: вход CPLD 25 МГц (H1 С ШУНТОМ, DIV=/4 U7), делитель /4 на
//   3 toggle-FF (t0_q/x1_q/x2_q) на clk 25 (период 160 нс), X1 =
//   x1_q (6,25 МГц, duty 1/2), X2 = x2_q (регистровая ~X1),
//   por_ce = ~t0_q&~x1_q (POR 1280 нс), clk25_q УДАЛЁН - вся
//   логика на clk 25 МГц (такт логики 1-в-1 базе), ядро v2.1 (18 МЦ),
//   v2.3: бод 25/16 -> 25/25 = 1 000 000 (урок CH340G, шапка).
//   ПОЧЕМУ: запас МЦ v2.1 был впритык (105-108 из 108); кольцо 7 ->
//   4 (X1/X2 те же классы) и clk25_q дают -4..-5 МЦ -> ожидание
//   101-103 - влезание с запасом; ОДИН домен вместо двух (проще
//   тайминг/аудит, строб por_ce и por-цепь синхронны по построению).
//   ЦЕНА (ПРИНЯТО ВЛАДЕЛЬЦЕМ): CPU 3,571 -> 3,125 МГц (-12,5%):
//   1) FW-константы, калиброванные тактами (DLY ~1 мс = 0095h и
//      пр.), тянутся x1,143; программный UART 4800 (диагностики
//      uart_echo) становится 4200 - константы пересчитать
//      (744 -> 651 такт/бит), если используется; монитор ACdE
//      терминала НЕ использует - индикатор/клавиатура/звук
//      деградируют безбольно;
//   2) ШУНТ H1 ОБЯЗАТЕЛЕН (п.23/п.32-i): БЕЗ него CPU 6,25 МГц -
//      1,75x разгона ВМ85А/ОЗУ, бод 3,125 М - НЕ ВКЛЮЧАТЬ;
//   3) бод TX В v2.3 ИЗМЕНЁН: 1 562 500 (25/16) -> 1 000 000 (25/25) -
//      терминал теперь 1 000 000 8N1 (сетка CH340G, 0% ошибки);
//   4) пор-цепь: 8 x 160 = 1280 нс (норма 960, запас 1,33x - тот
//      же); RESET_IN низ ~1,2 мкс;
//   5) X1 duty 1/4 (40/120 нс) ШИРЕ золотого 1/7 (20/120) -
//      безопаснее; illegal-транзиенты X2 во время POR - класс базы.
//   ВЕРИФИКАЦИЯ v2.2: check_v22.py (структура/двойники/база),
//   tb_txuart_v22.v (iverilog, РЕАЛЬНЫЙ RTL): P0a все 16 кодов
//   кольца -> one-hot, X1 ровно 160 нс duty 1/4 (40/120), X2
//   противофаза, POR-кромка ~1240 нс, кадры на сетке 640 нс, PC-
//   приёмник декодирует, busy-drop, сброс посреди кадра, регрессия
//   базы (SID-транзит, статус 02h). Ядро бит-в-бит v2.1 - доказано
//   sim_txuart_v21/diffsim (92/92, 8283 тика, 0 расхождений) и
//   check_v22 (построчное сравнение ядра).
//
// Что делать владельцу (TODO, ред. v2.2):
//  1) в ISE-проекте УСТРОЙСТВО xc95108-15pq100c (как было); Set as Top
//     Module = ЭТОТ файл (top_txuart_por6_v24.v, CP1251); UCF -
//     top_txuart.ucf (ноги НЕ менялись; TIMESPEC/комментарии - 25 МГц);
//  2) ОПЦИИ ФИТТЕРА СВЕРИТЬ С КОМПИЛЯТОРОМ: Input Limit 28, Pterm
//     Limit 18, Exhaustive OFF, Optimization DENSITY (в прогоне 11-8
//     7:14PM стояли IL 1 / PT 1 / Exhaustive ON - класс-урок п.27);
//     фит и .rpt НА АУДИТ ДО ПРОШИВКИ (чек-лист п.32). Обязательные
//     точки узла (v2.4): ветка g_div4 - t0_q/x1_q/x2_q (3 toggle-FF,
//     ДЕКОДОВ РАВЕНСТВА НЕТ, clk 25 МГц; INIT: t0=0, x1=SET, x2=0);
//     clk25_q и x1_n в RTL НЕТ; X1 = x1_q (IO-MC P68), X2 = x2_q
//     (РЕГИСТР противофазы, D = ~(x1_q^t0_q) = будущий ~x1_q, БЕЗ
//     лага; однолитеральная D(x2_q)=~x1_q = БРАК, класс v3.4);
//     ДЕКОДОВ РАВЕНСТВА В УЗЛЕ БЫТЬ НЕ ДОЛЖНО; wb_ram_q в нетлисте
//     ОТСУТСТВУЕТ; por_sh - РОВНО 8 триггеров (FTCPE, clk 25 МГц,
//     Init=FF), строб por_ce,
//     por_run.D = por_sh[0], Init=SET; reset_q - FDCPE(clk,'0','0')
//     БЕЗ PRE; sod_q/tx_pass/tx_q/adv_q/tx_run в нетлисте НЕТ;
//     WARNING:Xst:1780 в логе синтеза БЫТЬ НЕ ДОЛЖНО;
//  3) железо: H1 С ШУНТОМ (25 МГц на GCK3 - ПЕРЕСТАВИТЬ ПЕРЕМЫЧКУ,
//     после v3.9.8 стояла БЕЗ шунта!); осциллограф: GCK3 = 25 МГц,
//     X1 = 6,25 МГц (период ровно 160 нс, high 80 / low 80 - duty
//     1/2, v2.4), X2 = 6,25 ТОЧНАЯ ПРОТИВОФАЗА (если X2 с лагом или
//     в фазе - БРАК фита, класс п.10/v2.4), RESET_IN низ ~1,2 мкс по
//     питанию (8 стробов x 160 нс, п.23), CLKOUT = 3,125 МГц duty 50%;
//  4) терминал 1 000 000 8N1 (такт ядра clk 25 МГц / 25), тест
//     OUT 04h / поллинг IN 05h; по результату - решение о переносе
//     механики в hwuart (v4.0.2) и/или в txclient (v9).
//
//
// -- ЧЕК-ЛИСТ .rpt ПОСЛЕ ФИТА (пройтись по распечатке глазами!) --
//  a) clk = P29 (GCK3, знак "User Assigned"), RST = P1; на GCK3 подано
//     25 МГц (H1 С ШУНТОМ - v2.2); сеть clk - ЕДИНСТВЕННЫЙ такт
//     (v2.2, один домен) - на ГЛОБАЛЬНОЙ тактовой сети; если фиттер
//     повесил clk на обычную трассировку - проверить skew/setup в
//     отчёте о временах (25 МГц закрывались с запасом во всех
//     фятах v3.9.x);
//  b) ВСЕ constraint-ноги со знаком "~" (фиттер НЕ переставлял);
//  c) PGND (Unused IO Ground) = РОВНО {P74,P75,P76,P78,P79,P81,P95,
//     P96,P98} - 9 шт (P73 = выход SID, в PGND БЫТЬ НЕ ДОЛЖНА);
//  d) входы на местах (INP): X2 P69, RSTOUT P70, SOD P72, INTAn P80,
//     HLDA P82, CLKOUT P83, S0 P94, S1 P89, AH8 P10, AH9 P12, AH10
//     P18, AH11 P14, AH12 P4, AH13 P8, AH14 P3, RX P38;
//  e) выходы: READY P87='1', CS1 P99='1', TX P39=shreg[0] (IO-MC
//     регистр, TXUART п.27: idle '1', SET-ветка GSR), SID P73=RX
//     (транзит), X1 P68 (x1_q, duty 1/2: high 80 / low 80 нс, v2.4),
//     X2 P69 (регистр x2_q: точная противофаза ~X1 БЕЗ лага,
//     D = ~(x1_q^t0_q) - блок v2.4 шапки);
//  f) СЕТЬ GSR (п.18/20; v2.0: ядро TXUART в GSR-домене - п.28):
//     желательно "Global set/reset net(s) used" + "GSR : 1" в Pin
//     Resources; в фите v3.9.8 GSR НЕ свёлся (fallback: асинхронные
//     PT-сбросы от узла cpu_rst) - функционально корректно, аудитом
//     принят (п.25). Анатомия обязательна в ОБОИХ случаях: D-функции
//     логики БЕЗ литералов "NOT RST"/"NOT por_run"; сырой RST -
//     ТОЛЬКО во входах ФБ rst_meta (1 ФБ); por-цепь por_sh/por_run
//     - ВНЕ GSR; ЯДРО TXUART (shreg/bit_cnt/baud_cnt/ld_tx_q)
//     + FSM/шина - CLR/SET=cpu_rst (SET-ветка shreg =
//     1FF); rst-цепь (rst_meta/rst_sync/rst_qcnt/rst_press/reset_q) -
//     ВНЕ GSR; reset_q - FDCPE(clk,'0','0') БЕЗ PRE (Init=RESET -
//     CPU держится с t=0);
//  g) v2.2: УСТРОЙСТВО XC95108 - прогноз 101-103/108 МЦ (п.31:
//     наивно 94 - 3 транзит - 3 узел - 1 clk25_q + 18; прецедент
//     v1.0: фит лёг на 2 МЦ ниже наивной суммы; допуск чек-листа
//     101-105); если фит сказал «needs N», N > 108 - НЕ крутить
//     опции (класс-урок п.27!), писать на аудит (резерв п.33);
//     Maximum Frequency: логика 25 МГц (clk 25 МГц - ЕДИНСТВЕННЫЙ
//     такт v2.2, включая ядро TXUART) - должна закрыться;
//  h) в Equations (делитель на clk 25 МГц, ОДИН домен v2.4):
//     состояние узла = ВЫХОДЫ триггеров t0_q/x1_q/x2_q; декодов
//     равенства (==N) В УЗЛЕ БЫТЬ НЕ ДОЛЖНО; x1_n и clk25_q В
//     НЕТЛИСТЕ НЕТ - появились: собран не тот исходник! Ожидаемые
//     уравнения (класс п.9: сверять ТАБЛИЦЕЙ истинности, не
//     полярностью одного терма):
//       t0_q.D = NOT t0_q  (1 птерм);
//       x1_q.D = t0_q AND NOT x1_q OR NOT t0_q AND x1_q  (2 птерма,
//              XOR: toggle при t0_q=1, hold при t0_q=0);
//       x2_q.D = t0_q AND x1_q OR NOT t0_q AND NOT x1_q  (2 птерма,
//              XNOR = БУДУЩИЙ ~x1_q; ФОРМА И-ИЛИ ОБЯЗАТЕЛЬНА: урок
//              фита v2.4 - RTL XNOR напечатан XOR БЕЗ NOT = X2 в фазе
//              = БРАК (класс потери инверсии 7:31/8:55); печатная
//              XOR-форма без NOT = НЕ ШИТЬ; однолитеральная NOT x1_q
//              = БРАК - лаг 40 нс, класс v3.4);
//       Init: t0=RESET, x1=SET, x2=RESET (все - clk 25 МГц, GCK3);
//       X1 = x1_q  (регистр МОЖЕТ лечь в IO-MC пина P68);
//       X2 = x2_q  (регистр IO-MC пина P69, точная противофаза);
//       por_ce = NOT t0_q AND NOT x1_q  (1 ПТ, домен clk 25);
//       por_sh 8 бит (сдвиг вправо, 0 в MSB, Init=FF, clk 25 МГц),
//       por_run.D = por_sh[0] (Init=SET, clk 25 МГц);
//       rst_meta/rst_sync/rst_qcnt<2:0>/rst_press/reset_q/state_FSM_
//              FFd1..3 - clock = clk (25 МГц - ЕДИНСТВЕННЫЙ такт
//              v2.2);
//       reset_q = FDCPE(clk,'0','0') БЕЗ PRE (Init=RESET);
//       state = 3 триггера (без FFd4); txm_cnt/sod_q/tx_pass/tx_q/
//              tx_run/adv_q/clk25_q в нетлисте НЕТ (v2.1: свернуты/
//              выпилены; v2.2: clk25_q удалён);
//       bit_cnt - 4 триггера (idle = 0000, кадр = 1..10; TXRDY =
//              NOR bit_cnt); shreg - 9 триггеров ([0] -> TX IO-MC P39,
//              1FF = idle);
//       wb_ram_q В НЕТЛИСТЕ БЫТЬ НЕ ДОЛЖНО (защёлка удалена п.16);
//       cnt/x1_p/x2_p/t0_q/x1_q/x2_q/x1_n в RTL ВЫЧЕРКНУТЫ
//              (v3.9.8-clear) - в Equations их быть не может вовсе;
//       CS_n - уравнение от state_FSM_FFd1..3/A15/IOM БЕЗ литерала
//              wb_ram_q.
//     ГЛАВНАЯ ТОЧКА АУДИТА: сеть clk (25 МГц) - на ГЛОБАЛЬНОЙ тактовой;
//     если фиттер повесил clk на обычную трассировку - проверить
//     skew/setup в отчёте о временах.
//=====================================================================
// Топология шины: AD0-AD7 процессора, A0-A7 flash/SRAM и CPLD - ОДНА
// медь (сети A0..A7). CPLD = регистровый трансивер:
//   чтение: память видит адрес в T1 (ALE=1) -> данные на D0-D7
//   захватываются в последний тик T1 -> в T2 (CPU отпустил AD) CPLD
//   выдаёт данные на A-сети;
//   запись: в T2 CPU гонит данные по A-сетям (CPLD Hi-Z), CPLD
//   захватывает; после WR#(вверх) - «отложенная запись» (writeback):
//   CPLD сам ставит защёлкнутый адрес на A-сети + данные на D-сети и
//   даёт импульс /WE_RAM (импульс защищён от ALE - п.4).
// Метод захвата - повторное сэмплирование, пока строб активен
// (последний сэмпл гарантированно валиден); без edge-детекторов и
// PT-клоков. v2.2 - ОДИН домен: clk 25 МГц (H1 С ШУНТОМ) - кольцо/
// por-цепь/логика на одном такте (GCK3), вся тиковая семантика
// логики - 25 МГц (п.23/п.34).
// Сброс: SW20 -> RST (нажатие = 1, Task 25) + POR (п.23: сдвиговый,
// 1280 нс) -> RESET_IN=0; сброс ЛОГИКИ - асинхронный по cpu_rst через
// СЕТЬ GSR (п.18/20); сырой RST - только в синхронизатор (п.21);
// RESET_IN - регистр reset_q. RAM подтверждена на железе (Task 69-j:
// 4 паттерна x 32K без ошибок, T=1280 нс; режим T=320 нс - этот файл (v2.2; T=280 нс был режимом v3.9.8);
// tb: T3b/T3d/T3e PUSH-stress).
//=====================================================================

module retro_pcld_top #(parameter POR_W = 6,    // v3.4: НЕ используется (POR - сдвиговый 8 бит, п.9 шапки); оставлен для совместимости тестбенча
                        parameter CLK_DIV = 4,  // v2.4: ОБЯЗАН быть 4 - единственная ветка узла g_div4 (делитель t0_q/x1_q/x2_q на clk 25 МГц, блок v2.4 шапки); кольцо s0..s3 заменено (v2.2-2.3 - история)
                        parameter CLK_HALF = 1) ( // v2.2: ОБЯЗАН быть 1 (условие ветки g_div4); v3.7: параметр TXM_W УДАЛЕН вместе с TX-маской (п.13)
    // ---- такт и глобальный сброс ----
    input  wire       clk,          // 25 МГц (v2.2: перемычка H1 С ШУНТОМ - DIV=/4 генератора U7; ОБЯЗАТЕЛЕН, БЕЗ шунта 50 МГц ЗАПРЕЩЕНО - п.23/34), U1.29 (P29, GCK3)
    input  wire       RST,          // SW20, U1.1 (P1, GSR): покой = 0, нажатие = 1 (актив.1 - доказано платой, Task 25); v3.9.6: пин входит ТОЛЬКО в синхронизатор rst_meta (п.21), GSR-ресурс ноги не задействован
    // ---- шина i8085 (входы автомата) ----
    input  wire       ALE,          // cpu1 U1.93 (P93), нога 30
    input  wire       WRn,          // cpu2 U1.92 (P92), нога 31 (активный 0)
    input  wire       RDn,          // cpu3 U1.91 (P91), нога 32 (активный 0)
    input  wire       IOM,          // cpu5 U1.88 (P88), нога 34: 1=IO, 0=память
    input  wire       A15,          // U1.97 (P97) - декод памяти
    // ---- мультиплексированная шина AD0-AD7 = сети A0..A7 (bidir) ----
    inout  wire [7:0] A,            // A0=P26 A1=P21 A2=P19 A3=P17 A4=P15 A5=P13 A6=P11 A7=P9
    // ---- шина данных памяти (bidir) ----
    inout  wire [7:0] D,            // D0=P30 D1=P32 D2=P35 D3=P36 D4=P34 D5=P31 D6=P27 D7=P22
    // ---- управление памятью (активный 0) ----
    output wire       CSr_n,        // P20 /CE_ROM -> U10.22 (flash /CE)
    output wire       OEr_n,        // P16 /OE_ROM -> U10.24
    output wire       CS_n,         // P25 /CE_RAM -> U4.22  (RAM /CE)
    output wire       OE_n,         // P37 /OE_RAM -> U4.24
    output wire       WE_n,         // P24 /WE_RAM -> U4.29 (только writeback!)
    output wire       CS1,          // P99 CS(CE2) -> U4.30, константа '1'
    // ---- поддержка процессора ----
    output wire       X1,           // P68 cpu21, нога 1: 6,25 МГц (x1_q, duty 1/2: high 80 / low 80 нс, период ровно 160 нс) -> CPU 3,125 МГц (v2.4, внутренний /2 ВМ85А; фронты те же, что у кольца)
    output wire       READY,        // P87 cpu6, нога 35: константа '1' (без wait)
    output wire       RESET_IN,     // P84 cpu7, нога 36: активный 0 = сброс CPU; v3.9.6: регистр reset_q (п.21)
    // ---- soft-UART транзиты (Task 70-a) ----
    output wire       SID,          // P73 cpu17, нога 5 (CPU.SID): транзит RX -> приём (RIM 20h)
    output wire       TX,           // P39: цепь платы «RX» -> CH340G.RXD; TX = shreg[0] - аппаратный передатчик TXUART (п.27, IO-MC регистр - качество вывода v3.7)
    // ---- индикация и звук (выходы активным 0, §6) ----
    output wire [7:0] seg,          // {dp56,g,f,e,d,c,b,a} = P60/5/66/58/57/61/62/45
    output wire [3:0] dig,          // dig0..3 = P6/63/65/48 -> R -> VT1..VT4
    output wire       SND,          // P67 -> BUZZER1.1 (пассивный, прямой бит; A4 порта 01h)
    // ---- наблюдатели: «мёртвые» пины как Hi-Z входы (* keep *) ----
    // (* keep *) обязателен для ног БЕЗ нагрузки: без него XST выкидывает
    // входы (Xst:3005), а выкиннутый пин опция "Ground on Unused IOs"
    // ЗАЗЕМЛИТ - там выходы CPU и X2 (GND запрещён даташитом). ЭТО И ЕСТЬ
    // «ОШИБКА С НОГАМИ» ИЗ ФИТА владельца (Task 68-f).
    // v2.0 TXUART (п.27): RX (P38) используется (транзит SID); SOD (P72) -
    // вход-НАБЛЮДАТЕЛЬ БЕЗ нагрузки - keep ОБЯЗАТЕЛЕН (иначе Xst:3005 ->
    // "Ground on Unused IOs" заземлит выход CPU.SOD - класс Task 68-f).
    (* keep = "TRUE" *) output wire X2,  // P69 cpu20, нога 2: ТОЧНАЯ противофаза X1 (v2.4: регистр x2_q, D = ~(x1_q^t0_q) = будущий ~x1_q, БЕЗ лага - блок v2.4 шапки); keep - страховка от reachability-упрощения
    (* keep = "TRUE" *) input wire RSTOUT,    // P70 cpu19, нога 3
    (* keep = "TRUE" *) input wire SOD,       // P72 cpu18, нога 4 (CPU.SOD): транзит УДАЛЁН (п.27) - наблюдатель без нагрузки (keep: выход CPU)
    (* keep = "TRUE" *) input wire INTAn,     // P80 cpu11, нога 11
    (* keep = "TRUE" *) input wire HLDA,      // P82 cpu9,  нога 38
    (* keep = "TRUE" *) input wire CLKOUT,    // P83 cpu8,  нога 37
    (* keep = "TRUE" *) input wire S0,        // P94 cpu0,  нога 29
    (* keep = "TRUE" *) input wire S1,        // P89 cpu4,  нога 33
    (* keep = "TRUE" *) input wire AH8,       // P10 цепь A8,  нога 21 - адрес памяти
    (* keep = "TRUE" *) input wire AH9,       // P12 цепь A9,  нога 22
    (* keep = "TRUE" *) input wire AH10,      // P18 цепь A10, нога 23
    (* keep = "TRUE" *) input wire AH11,      // P14 цепь A11, нога 24
    (* keep = "TRUE" *) input wire AH12,      // P4  цепь A12, нога 25
    (* keep = "TRUE" *) input wire AH13,      // P8  цепь A13, нога 26
    (* keep = "TRUE" *) input wire AH14,      // P3  цепь A14, нога 27
    input  wire       RX,           // P38 цепь платы «TX» (CH340G.TXD) - теперь транзит в SID; заземлять НЕЛЬЗЯ (выход CH340G)
    // ---- клавиатура (Task 34) ----
    output wire       col0,         // P44 SW1/SW5/SW9/SW13/SW17 (KBCOL.0)
    output wire       col1,         // P43 SW2/SW6/SW10/SW14/SW18 (KBCOL.1)
    output wire       col2,         // P42 SW3/SW7/SW11/SW15/SW19 (KBCOL.2)
    output wire       col3,         // P41 SW4/SW8/SW12/SW16 (KBCOL.3; SW20 вне матрицы)
    input  wire       row0,         // P56 R25 подтяжка, SW1
    input  wire       row1,         // P55 R24, SW5
    input  wire       row2,         // P54 R23, SW9
    input  wire       row3,         // P52 R22, SW13
    input  wire       row4          // P51 R21, SW17
);

  //=============================================================
  // Узел тактирования v2.4 (директива владельца 11-14; v2.2 был:
  // «Может быть уйти на более простой делитель тактовой, подать на
  // вход тактовой не 50, а 25, потом /4 и подать на процессор»):
  // вход 25 МГц (H1 С ШУНТОМ - DIV=/4 U7; БЕЗ шунта 50 МГц ЗАПРЕЩЕНО -
  // CPU 6,25 МГц, бод 3,125 М). ДЕЛИТЕЛЬ /4 на toggle-FF t0_q/x1_q/x2_q
  // на clk 25 МГц (период 160 нс); X1 = x1_q (6,25 МГц, duty 1/2),
  // X2 = x2_q (регистровая ~X1), внутренний /2 ВМ85А -> CPU 3,125 МГц.
  // clk25_q УДАЛЁН - ВСЯ логика (rst/TX/FSM/порты) на clk 25 МГц
  // (частота такта логики НЕ изменилась: clk25 базы = 25 МГц = clk
  // v2.2; /WE 80 нс, квалификатор 320 нс - тиковые константы живут
  // бит-в-бит). por-цепь - в домене clk 25 со стробом por_ce
  // (POR = 8 x 160 = 1280 нс, норма 3 x 320 = 960 нс, запас 1,33x).
  // История: узел v3.9.8 (кольцо r0..r6 N=7 на clk 50, X1 = r0 duty
  // 1/7, clk25_q = /2) - откат top_txuart_por6_v21.v.
  // ВНИМАНИЕ: старый HDLCompiler (ISE) НЕ принимает reg-инициализаторы
  // ВНУТРИ generate-блока -> reg объявляем на scope модуля.
  //=============================================================
  wire por_ce;

  // v2.4 (директива владельца 11-14, блок v2.4 шапки): состояние узла =
  // ДЕЛИТЕЛЬ /4 на toggle-триггерах t0_q/x1_q/x2_q («дедовский» /4,
  // 3 МЦ вместо кольца 5 МЦ). Период X1 = 160 нс - КАК у кольца,
  // фронты те же; меняется только duty X1: 1/4 -> 1/2. Строб
  // por_ce = ~t0_q & ~x1_q (домен clk 25). X1 = x1_q (IO-MC P68),
  // X2 = x2_q - РЕГИСТРОВАЯ точная противофаза (IO-MC P69).
  // ВНИМАНИЕ (как v2.2): reg-инициализаторы ВНЕ generate - ISE не
  // принимает их внутри generate-блока.
  (* keep = "true", equivalent_register_removal = "no" *)
  reg t0_q = 1'b0;   // clk/2 = 12,5 МГц 50%: D = ~t0_q (1 ПТ, 1 лит)
  (* keep = "true", equivalent_register_removal = "no" *)
  reg x1_q = 1'b1;   // clk/4 = 6,25 МГц 50%: D = x1_q ^ t0_q (2 ПТ);
                     // INIT=1 - X1 стартует с '1' (как кольцо s0=1)
  (* keep = "true", equivalent_register_removal = "no", dont_touch = "true" *)
  reg x2_q = 1'b0;   // ПРОТИВОФАЗА-РЕГИСТР (п.10 в ред. v2.4/2.5):
                     // D = (x1_q & t0_q) | (~x1_q & ~t0_q) = XNOR =
                     // БУДУЩИЙ комплемент x1_q (x1_q(t+1) = x1_q(t)^t0_q(t))
                     // -> x2_q(t) = ~x1_q(t) В КАЖДЫЙ такт БЕЗ лага.
                     // ФОРМА И-ИЛИ ОБЯЗАТЕЛЬНА (урок фита v2.4: запись
                     // ~(x1^t0) фиттер напечатал XOR БЕЗ NOT = X2 в фазе
                     // = БРАК; И-ИЛИ печать - с явными NOT, калибровано).
                     // D структурно комплементарен D(x1_q) - same-D
                     // слияние невозможно; однолитеральная ~x1_q = БРАК.
  // Самовыравнивание: D(x2_q) не зависит от x2_q - ЛЮБОЙ код -> точная
  // противофаза за 1 такт (кольцу требовалось 2-3 фронта). Состояний
  // залипания НЕТ: бинарный цикл 4 состояний, GSR кладёт INIT (0,1,0)
  // прямо в цикл - kill/рестарт-логика не нужна.

  generate
    if (CLK_DIV == 4 && CLK_HALF == 1) begin : g_div4
      // v2.4 ЕДИНСТВЕННАЯ ветка (директива владельца 11-14): делитель
      // /4 на toggle-FF, clk 25 МГц - период 160 нс (как у кольца):
      //   t0_q <= ~t0_q;            clk/2, 12,5 МГц, 50%;
      //   x1_q <= x1_q ^ t0_q;      clk/4, 6,25 МГц, 50% - duty 1/2
      //     (high 80 / low 80 нс; v2.2-2.3 кольцо давало 1/4 = 40/120;
      //     ВМ85А тактируется ФРОНТАМИ X1 -> CLK = 3,125 МГц, период
      //     320 нс, duty ровно 50% - ЧАСТОТА CPU НЕ ИЗМЕНИЛАСЬ;
      //     прецеденты duty 1/7 (v3.9.8) и 1/4 (v2.2-2.3) работали,
      //     1/2 ШИРЕ обоих по high-фазе);
      //   x2_q <= (x1_q & t0_q) | (~x1_q & ~t0_q);
      //                             регистровая точная противофаза:
      //     D = XNOR в ЯВНОЙ И-ИЛИ форме = БУДУЩИЙ комплемент x1_q -
      //     противофаза БЕЗ лага; форма И-ИЛИ обязательна (урок фита
      //     v2.4: ~(x1^t0) напечатана XOR без NOT = в фазе = БРАК,
      //     класс потери инверсии 7:31/8:55); БРАК п.10 = D(x2_q)
      //     однолитеральная ~x1_q (лаг) ИЛИ печатный XOR без NOT (в
      //     фазе);
      //   декодов равенства в узле НЕТ (класс п.9: единственный
      //     «декод» - литерал t0_q в D(x1_q)/D(x2_q)); kill/рестарт
      //     не нужны - бинарный счётчик не залипает.
      // por_ce = ~t0_q & ~x1_q: РОВНО ОДИН такт 40 нс за период 160 нс
      //   (фаза (t0,x1) = (0,0)); строб и por-цепь в ОДНОМ домене
      //   clk 25 - детерминировано, как v2.2; POR 8 x 160 = 1280 нс -
      //   БЕЗ ИЗМЕНЕНИЙ (калибровка не тронута).
      always @(posedge clk) begin
        t0_q <= ~t0_q;             // clk/2
        if (t0_q) x1_q <= ~x1_q;   // clk/4, 50%
        x2_q <= (x1_q & t0_q) | (~x1_q & ~t0_q); // XNOR И-ИЛИ (v2.5, урок
                          // fit4: ~(x1^t0) печаталась XOR без NOT = в фазе
                          // = БРАК; И-ИЛИ печать - с явными NOT, аудит п.9)
      end
      assign X1 = x1_q;   // 6,25 МГц, период ровно 160 нс, duty 1/2 (80/80)
      assign X2 = x2_q;   // регистровая точная противофаза (D = ~(x1_q^t0_q))
      assign por_ce = ~t0_q & ~x1_q;  // v2.4: 1 такт 40 нс за период 160 нс -
                           // ровно ОДИН posedge за период по построению;
                           // строб и por-цепь в одном домене - детерминировано
    end
  endgenerate
  
  //=============================================================
  // POR (v2.2, п.23/п.34: 8-битный СДВИГОВЫЙ регистр por_sh в домене
  // clk 25 МГц): 0 в MSB сдвигается вправо, bit0 очищается
  // ПОСЛЕДНИМ -> por_run снимается ровно через 8 тиков por_ce.
  // ДЕКОДОВ НЕТ (ни ==0, ни !=0, НИ В СТРОБЕ): фиттер дважды печатал
  // por-декоды с потерянной инверсией (фит 7:31: por_cnt(0): T=NOT en
  // -> POR=1 клок; фит 8:55: por_run.D=(por_cnt==0)) - класс
  // конструкций убран; строб por_ce декодов не содержит вовсе.
  // ДОМЕН clk 25 (v2.4): строб por_ce - такт 40 нс в ТОМ ЖЕ домене, что
  // и por-цепь - синхронное включение того же такта,
  // детерминировано при любой фазе (в базе v3.9.8 строб был 20 нс в
  // 50-домене, и por-цепь обязана была жить там же - класс-урок
  // «фазовой лотереи»; в v2.2 оба в одном домене - лотерея
  // невозможна по построению).
  // INIT=FF/1 -> RESET_IN=0 до всякого клока (счёт только при живом
  // clk через por_ce из делителя); por_run остаётся РЕГИСТРОМ (v3.2,
  // п.8 шапки - защита от схлопывания PT / Placement Failed).
  // Длительность: POR = 8 x 160 нс = 1280 нс (строб por_ce - 1 раз за
  // период кольца 160 нс); норма 3 такта CLK OUT = 960 нс @ 3,125 МГц
  // (запас 1,33x - ТОТ ЖЕ, что в v3.9.2-3.9.7); фактический низ
  // RESET_IN от INIT ~1200 нс (дрейн 1000 нс + кромки).
  // Повторный POR невозможен: после 00 сдвиг держит нули навсегда.
  //=============================================================
  reg [7:0] por_sh = 8'hFF;      // v2.2 (п.23/34): сдвиг вправо, clk 25 МГц,
                                 // строб por_ce: FF -> 7F -> ... -> 01 -> 00 (8 стробов)
  reg  por_run = 1'b1;           // FF-копия для cpu_rst (v3.2; INIT=SET)
  always @(posedge clk) begin
    por_run <= por_sh[0];        // снятие, когда '0' дойдёт до bit0 (8-й тик)
    if (por_ce) por_sh <= {1'b0, por_sh[7:1]};
  end

  //=============================================================
  // v3.9.6 (п.21): ХАРДРЕНИНГ ЦЕПИ СБРОСА. Сырой пин RST входит в
  // кристалл ТОЛЬКО через 2FF-синхронизатор + квалификатор; решения
  // о сбросе принимают ТОЛЬКО регистры: мид-рейл/дребезг/помеха на
  // SW20 физически не доходят ни до 40 сбросовых входов триггеров,
  // ни до ноги RESET_IN (в v3.9.5 RST шёл НАПРЯМУЮ в гейт RESET_IN
  // и в PTC-сбросы NOT RESET_IN - fallback фита 11-5).
  //   rst_meta/rst_sync - синхронизатор (вне сброса, INIT=0);
  //   rst_qcnt/rst_press - квалификатор: переворот rst_press на 8-м
  //     такте ПОДРЯД устойчивого rst_sync != rst_press (двусторонний:
  //     и взвод, и снятие квалифицированы); дребезг короче 280 нс не
  //     виден вовсе, длиннее - полноценный повторный сброс (каждый
  //     взвод заново чистит все 40 триггеров - ПОСЛЕДНЕЕ снятие
  //     всегда из held-чистого состояния, регистровым фронтом);
  //   cpu_rst = rst_press | por_run - ТОЛЬКО регистровые источники;
  //   reset_q - РЕГИСТР выхода RESET_IN (INIT=0: CPU в сбросе с t=0
  //     до всякого клока; снятие - чистым фронтом, как по питанию).
  // Латентность кнопки: 11 тиков счёта (2FF + 8 такт квалификатора +
  // reset_q) = 400..440 нс от пина на взвод и снятие (кнопка живёт в
  // миллисекундах). POR НЕ ТРОНУТ: por_sh/
  // por_run бит-в-бит v3.9.4, низ RESET_IN по питанию до 1160 нс
  // (норма 840 нс, запас x1,35).
  //=============================================================
  reg  rst_meta  = 1'b0;         // ловец метастабильности (вне сброса, INIT=0)
  reg  rst_sync  = 1'b0;         // синхронизованный RST (вне сброса, INIT=0)
  reg  rst_press = 1'b0;         // квалифицированный сброс кнопки (INIT=0)
  reg [2:0] rst_qcnt = 3'b000;   // счётчик квалификации 0..7 (INIT=0)
  wire cpu_rst = rst_press | por_run; // v3.9.6: сброс ТОЛЬКО от регистров
  reg  reset_q = 1'b0;           // РЕГИСТР RESET_IN (INIT=0 - CPU держится с t=0)
  always @(posedge clk) begin   // v2.2: логика на clk 25 МГц (п.23/34)
    rst_meta <= RST;
    rst_sync <= rst_meta;
  end
  always @(posedge clk) begin   // v2.2: логика на clk 25 МГц (п.23/34)
    if (rst_sync != rst_press) begin
      if (&rst_qcnt) begin
        rst_press <= rst_sync;   // 8-й такт подряд - переворот состояния
        rst_qcnt  <= 3'b000;
      end else
        rst_qcnt  <= rst_qcnt + 3'b001;
    end else
      rst_qcnt  <= 3'b000;       // линия вернулась к состоянию - счёт с нуля
  end
  always @(posedge clk)       // v2.2: логика на clk 25 МГц (п.23/34)
    reset_q <= ~cpu_rst;         // снятие сброса CPU - всегда чистым фронтом

  //=============================================================
  // TX-транзит v3.7 (sod_q/tx_pass/tx_q) ВЫПИЛЕН (п.27, v2.0): передача
  // - аппаратный сериализатор TXUART (блок НИЖЕ, после объявлений
  // автомата шины: ядро декодирует state/S_T2/addr_latch - Verilog
  // требует объявления раньше использования, HDLCompilers:28 - класс
  // hwuart 11-4). Требование v3.7 «в сбросе TX='1' мгновенно и БЕЗ
  // клока» покрывает SET-ветка GSR ядра (INIT shreg=1FF, п.28);
  // «фиктивный start-bit» (SOD='0' после сброса) невозможен по
  // построению - линия TX не зависит от SOD вовсе (SOD - вход-
  // наблюдатель, п.27). GSR-источник v2.0 - cpu_rst (п.28): ядро
  // чистится и в окне POR (v1.0: GSR = сырой RST - POR не покрывал).
  //=============================================================

  //=============================================================
  // Автомат шины: 7 состояний = 3 триггера (v3; в v1 было 10/4 триггера -
  // WBW/WBS/WBS2 удалены: hold-off 0, см. п.4 шапки; WB1..WB4 ЗАЩИЩЕНЫ
  // от ALE)
  //=============================================================
  localparam S_IDLE = 3'd0,   // ожидание ALE; A/D в Hi-Z; /OE включён (декод)
             S_T1H  = 3'd1,   // T1: CPU держит адрес на A-сетях; идёт захват
             S_T2   = 3'd2,   // строб: чтение - выдача данных на A; запись - захват
             S_WB1  = 3'd3,   // WB: адрес на A + данные на D (t_AS 40 нс до /WE)
             S_WB2  = 3'd4,   // /WE=0 - импульс НАЧАЛСЯ: защищён от ALE
             S_WB3  = 3'd5,   // /WE=0 (импульс = 2 тика = 80 нс >= t_WP ОЗУ)
             S_WB4  = 3'd6;   // /WE=1: удержание адреса/данных (t_AH/t_DH памяти)

  // Task 46: прагма против ONE-HOT перекодировки автомата XST
  // (контроль у владельца: в .rpt НЕ должно быть state_FSM_FFd4..10;
  // v3: автомат = РОВНО 3 триггера state_FSM_FFd1..3; 7 состояний (без WBW).
  // synthesis attribute fsm_encoding of state is "compact"
  reg  [2:0] state  = S_IDLE;
  reg        rd_seen = 1'b0;    // строб чтения замечен в T2
  reg        wr_seen = 1'b0;    // строб записи замечен в T2

  // Захваченные шинные регистры
  reg [7:0] addr_latch = 8'h00;  // адрес с A-сетей (T1) - нужен writeback и декоду порта
  reg [7:0] bus_reg    = 8'h00;  // данные: чтение (с D-сети в T1) ИЛИ запись (с A-сети в T2)

  // Порты индикации/звука (§5): захват по записи в порт при IO/M#=1
  reg [7:0] seg_q = 8'hFF;       // 1 в регистре = сегмент горит; выход инвертируется
  reg [3:0] dig_q = 4'hF;        // 1 = цифра выбрана; выход инвертируется
  reg       snd_q = 1'b0;
  reg [3:0] kbcol_q = 4'h0;      // колонки (порт 02h), INIT 0000 = все выкл
  wire io_rd_kb = IOM & ~addr_latch[2] & addr_latch[1] & addr_latch[0]; // чтение 03h (KBROW)

  // Комбинационные группы (v3):
  //   wb_out = in_wb БЕЗ !ALE: драйверы A/D держат адреса/данные до конца
  //     защищённого импульса (п.4 шапки); снятие - при выходе в IDLE.
  //   rd_drive с !ALE - чтение как в v1 (мгновенный обрыв при новом цикле).
  wire in_wb   = (state >= S_WB1);                       // WB1..WB4: A/D драйвятся
  wire in_welo = (state == S_WB2) || (state == S_WB3);   // /WE низ
  wire wr_phase = (state >= S_T2);                       // T2..WB4: /OE памяти off
  wire wb_out   = in_wb;                                 // защищённый writeback-драйв
  wire rd_drive = (state == S_T2) && rd_seen && !RDn && !ALE; // A-пины отдают данные

  //=============================================================
  // TXUART v2.1 (п.27): ИСКЛЮЧИТЕЛЬНО АППАРАТНЫЙ ПЕРЕДАТЧИК UART
  // (директива владельца 11-8веч: 144 нет - остаёмся на XC95108;
  // механика v1.0 (txclient v8/hwuart v4.0.1) СЖАТА 20 -> 18 МЦ:
  // shreg 9 бит сам-idle + bit_cnt 4 (1..10, idle=0) + baud_cnt 4 +
  // ld_tx_q; adv_q и tx_run свернуты - п.31).
  // OUT 04h = TXDATA: старт кадра 8N1 1 000 000 бод (clk 25 МГц / 25, v2.3).
  // IN 05h = статус: бит A1 = TXRDY (tx_idle = ~|bit_cnt), остальные
  // биты 0 (позиция бита - совместимость с hwuart v4.0.x).
  //   shreg[8:0]    9 МЦ - {данные, выход}: [0] -> TX (IO-MC, INIT=1 -
  //                 idle '1' до всякого клока, SET-ветка GSR);
  //                 загрузка по ld_tx_q: {A[7:0], 1'b0} с живых A-пинов
  //                 (CPU держит данные до подъёма WRn - запас >= 20
  //                 тиков); сдвиги вправо с инжекцией '1' - после кадра
  //                 shreg САМ приходит в все-'1' (idle по построению,
  //                 как shreg 9'h1FF txclient; ПАРАЛЛЕЛЬНЫХ ЗАГРУЗОК
  //                 IDLE НЕТ; сдвиг idle-регистра - НЕТ-ОП);
  //   bit_cnt[3:0]  4 МЦ - 1..10 = НОМЕР БИТ-ТАЙМА кадра (1 = старт,
  //                 2..9 = данные, 10 = стоп), 0 = idle; busy =
  //                 |bit_cnt - 1 ПТ/NOR; на 10-м сдвиге сам в 0 -
  //                 tx_run v2.0 свернут (TXRDY = ~|bit_cnt, 1 ПТ;
  //                 гейт io_wr_tx - 4 inline-литерала в тот же ПТ);
  //   baud_cnt[4:0] 5 МЦ - mod-25 СВОБОДНЫМ ХОДОМ: D = tick ? 0 : bc+1,
  //                 wrap ЯВНЫЙ (25 не степень двойки: компаратор == 24,
  //                 1 ПТ/5 вх, литерал ~tick входит в D всех 5 бит);
  //                 v2.2 был mod-16 (25/16 = 1 562 500 - вне сетки
  //                 CH340G -> мусор, урок железа 11-9);
  //                 baud_tick = (bc==24) - 1 ПТ/5 вх - тик сдвига;
  //   ld_tx_q       1 МЦ - РЕГИСТРОВЫЙ СТРОБ загрузки (п.30 = п.29
  //                 v2.0, БЕЗ ИЗМЕНЕНИЙ): декод io_wr_tx имеет
  //                 ЕДИНСТВЕННОГО потребителя; D-функция бита shreg =
  //                 3 ПТ/~6 вх {ld_tx_q, A[k], baud_tick, shreg[k+1],
  //                 shreg[k]} - все 9 бит в ОДНОМ ФБ (~25 вх <= 36).
  // ВЫПИЛЕНО против v2.0 (-2 МЦ): adv_q (хелпер тика: jam baud_cnt <= 0
  //                 вместо <= 1 даёт первый сдвиг на ТОТ ЖЕ фронт - лаг
  //                 adv_q 1 такт скомпенсирован, урок v8/hwuart
  //                 пересчитан; дифсим: сетка кадров 1-в-1) и tx_run
  //                 (кодировка bit_cnt 1..10 с idle=0: busy = |bit_cnt
  //                 - 1 ПТ; GSR-ветка bit_cnt - CLR, как v2.0).
  // Итого ядро: 19 МЦ (фит v2.3 = fit3: 103/108, контрольный ре-фит
  // 11-14 - байт-в-байт); узел v2.4: 5 -> 3 МЦ (-2); ФИТ v2.4 (11-14
  // 1:51PM): Successful, 101/108 - РОВНО прогноз (-2 МЦ), но брак
  // X2-D (печать XOR без NOT, шапка v2.5) => v2.5: логика та же,
  // D(x2_q) в И-ИЛИ форме; ожидание фита v2.5: те же 100-102/108
  // (резерв под тик: 7 МЦ, 7 вх.ФБ - блок v2.5 шапки).
  // ТАКТ ЯДРА - clk (25 МГц на входе, п.23/34), ЧАСТОТА такта 1-в-1
  // базе (clk25 базы = clk v2.2 = 25 МГц): бод = 25/25 = ровно 1 000 000 -
  // ТОЧНАЯ нижняя сетка CH340G (48М/48; 1 562 500 в сетке НЕТ - драйвер
  // молча 1,5 М, +4,17% = мусор, урок железа 11-9, шапка v2.3).
  //=============================================================
  localparam [4:0] BAUD_DIV = 5'd25;  // clk 25 МГц/25 = 1 000 000 бод 8N1 (сетка CH340G: 48М/48, ОШИБКА 0%);
                                      // 25 = 11001b - 5 бит; wrap ЯВНЫЙ (25 не степень двойки):
                                      // (== 24) ? 0 : +1 - компаратор 1 ПТ/5 вх; альтернативы:
                                      // 16 -> 1 562 500 (вне сетки CH340G - МУСОР, урок v2.2),
                                      // 27 -> 925 926 (к терминалу 921600 ошибка пары 0,47%),
                                      // 50 -> 500 000 (вдвое медленнее на том же счётчике)
  reg [8:0]  shreg    = 9'h1FF;  // [8:1] данные, [0] -> TX (IO-MC P39; INIT=1: idle до всякого клока)
  reg [3:0]  bit_cnt  = 4'd0;    // 1..10 = бит-тайм кадра (1=старт..10=стоп), 0 = idle; busy = |bit_cnt
  reg [4:0]  baud_cnt = 5'd0;    // mod-25 свободным ходом, wrap ЯВНЫЙ на тике; jam при загрузке
  reg        ld_tx_q = 1'b0;     // регистровый строб загрузки (п.30)
  wire baud_tick = (baud_cnt == (BAUD_DIV - 5'd1));            // == 24: тик каждые 25 тактов clk 25 МГц
  wire tx_idle   = ~|bit_cnt;                                  // idle/TXRDY: 1 ПТ/4 вх (NOR) - inline в строб и статус
  // Старт кадра - ОДНОКРАТНЫЙ строб: первый тик !WRn в T2 записи порта 04h
  // (адрес защёлкнут в T1 - addr_latch стабилен, класс hwuart п.26).
  // Гейты: tx_idle && !ld_tx_q - повторные такты строба !WRn и запись при
  // busy БЛОКИРОВАНЫ (байт тихо отбрасывается, кадр не портится - контракт);
  // !por_run && !rst_press - шинные действия гейтятся ОБОИМИ источниками
  // сброса (класс п.21e; при GSR=cpu_rst FSM в окнах сброса и так в IDLE
  // - двойная страховка: floated-шина в окне POR/кнопки кадр не стартует)
  wire io_wr_tx = (state == S_T2) && !WRn && IOM
                  && addr_latch[2] && !addr_latch[1] && !addr_latch[0]  // порт 04h
                  && tx_idle && !ld_tx_q && !por_run && !rst_press;
  // Декод чтения статуса 05h - ЧИСТЫЙ (без state/!RDn - экономия литералов,
  // класс hwuart): статус живёт в A-драйве ниже (механизм KBROW, rd_drive)
  wire io_rd_st = IOM & addr_latch[2] & ~addr_latch[1] & addr_latch[0]; // чтение 05h
  always @(posedge clk or posedge cpu_rst) begin // п.27/п.34: асинхронный сброс ядра -> СЕТЬ GSR (cpu_rst = rst_press | por_run, п.20/21); такт clk 25 МГц
    if (cpu_rst) begin
      shreg    <= 9'h1FF;   // idle '1' (SET-ветка GSR)
      bit_cnt  <= 4'd0;     // idle (CLR-ветка - как v2.0)
      baud_cnt <= 5'd0;
      ld_tx_q  <= 1'b0;
    end else begin
      ld_tx_q  <= io_wr_tx;                    // строб загрузки - через регистр (п.30)
      baud_cnt <= baud_tick ? 5'd0 : baud_cnt + 5'd1; // mod-25: wrap ЯВНЫЙ на тике
                                               // (25 не степень двойки; jam при загрузке ниже перекрывает)
      if (ld_tx_q) begin
        // ЗАГРУЗКА (на тик позже строба io_wr_tx - п.30): байт с живых
        // A-пинов, старт-бит '0' на шине с этого такта; jam baud_cnt <= 0:
        // первый сдвиг ровно через 25 тиков - старт-бит РОВНО 25 тиков
        // (v2.0: jam 1 + лаг adv_q 1 такт = ТОТ ЖЕ фронт; дифсим v2.0
        // vs v2.1: сетка кадров 1-в-1); bit_cnt <= 1 (бит-тайм старта)
        shreg    <= {A, 1'b0};                 // [8:1] = данные (d7..d0), [0] = старт '0'
        bit_cnt  <= 4'd1;
        baud_cnt <= 5'd0;
      end else if (baud_tick) begin
        // ТИК СДВИГА (каждые 25 тактов clk 25 МГц; в idle сдвиг - НЕТ-ОП,
        // регистр уже весь '1'): инжекция '1' в MSB - на 9-м сдвиге
        // стоп сам встанет в [0] (бит-тайм 10), после кадра shreg ==
        // все-'1' (idle) без отдельных загрузок
        shreg <= {1'b1, shreg[8:1]};
      end
      if (|bit_cnt && baud_tick) begin
        // бит-тайм кадра кончился (сдвиг был): 1..9 -> ++, 10 (стоп
        // отработал) -> 0 = idle, TXRDY поднимается в конце стопа (тот
        // же тик, что !tx_run v2.0). НА ГРУЗКЕ НЕ РАБОТАЕТ: bit_cnt
        // (старое значение) = 0 - строб io_wr_tx возможен только в idle
        bit_cnt <= (bit_cnt == 4'd10) ? 4'd0 : bit_cnt + 4'd1;
      end
    end
  end

  //=============================================================
  // Шинный движок
  //=============================================================
  always @(posedge clk or posedge cpu_rst) begin // v3.9.6: сброс логики по cpu_rst = rst_press|por_run (регистры, п.21; асинхронная структура GSR п.18/20 сохранена); v2.2: такт логики clk 25 МГц (п.23/34)
    if (cpu_rst) begin
      state      <= S_IDLE;
      rd_seen    <= 1'b0;
      wr_seen    <= 1'b0;
      addr_latch <= 8'h00;
      bus_reg    <= 8'h00;
      seg_q      <= 8'hFF;   // INIT «8888.» на индикаторе
      dig_q      <= 4'hF;
      snd_q      <= 1'b0;
      kbcol_q    <= 4'h0;
    end else begin
      // --- захват повторным сэмплированием: последний сэмпл валиден ---
      // v3: захват возможен только в T1H, т.е. ПОСЛЕ завершения WB
      // (структурно: из WB в T1H попадаешь только через IDLE) - adm.
      // addr_latch НЕ может перезаписаться посреди импульса (п.6 шапки).
      if (state == S_T1H && ALE) begin
        addr_latch <= A;                 // адрес стабилен весь T1
        if (!IOM) bus_reg <= D;          // данные памяти (доступ начался в начале T1)
      end
      if (state == S_T2 && !WRn) begin
        bus_reg <= A;                    // данные записи (CPU держит до WR#(вверх))
        if (IOM) begin                   // запись в порт: декод по тройке A2,A1,A0 (Task 34)
          case (addr_latch[2:0])
            3'b000: seg_q <= A;          // 00h: сегменты
            3'b001: begin                // 01h: разряды + SND
              dig_q <= A[3:0];
              snd_q <= A[4];
            end
            3'b010: kbcol_q <= A[3:0];   // 02h: колонки клавиатуры
            default: ;                   // 03h чтение; 04h - старт TX (ОДНОКРАТНЫЙ строб io_wr_tx
                                         // в ядре TXUART п.27, не здесь); 05h чтение статуса (io_rd_st); 06h-07h резерв
          endcase
        end
      end
      // --- трекинг стробов ---
      if (state == S_T2 && !RDn) rd_seen <= 1'b1;
      if (state == S_T2 && !WRn) wr_seen <= 1'b1;
      // --- переходы ---
      // v3: ALE ОБРЫВАЕТ только T2 (защита от глюка); в WB1..WB4 НЕ
      // вмешивается - импульс /WE защищён (п.4 шапки).
      if (ALE && state == S_T2 && !((wr_seen && WRn) || (rd_seen && RDn))) begin
        state   <= S_IDLE;
        rd_seen <= 1'b0;
        wr_seen <= 1'b0;
      end else begin
        case (state)
          S_IDLE: if (ALE) state <= S_T1H;
          S_T1H:  if (!ALE) state <= S_T2;
          S_T2: begin
            // приоритет записи: RDn-глюк во время записи не должен прерывать её
            if (wr_seen && WRn) begin
              wr_seen  <= 1'b0;
              // writeback только для записи в ОЗУ (8000-FFFF); запись в ПЗУ
              // отбрасывается (по железу /WE flash не подключён), порт пропускается
              // v3.9.3 (п.18): гейт POR - FSM в окне POR живой (GSR не
              // активен), шина CPU в сбросе «floated» (ВМ85А: управле-
              // ния/адрес/данные в 3-м состоянии) - вход в writeback
              // ЗАПРЕЩЁН, иначе плавающие ALE/WRn могли бы родить /WE
              state <= (!IOM && A15 && !por_run && !rst_press) ? S_WB1 : S_IDLE; // v3.9.6: гейт и на кнопку (п.21)
            end else if (rd_seen && RDn) begin
              rd_seen <= 1'b0;
              state <= S_IDLE;         // отпускание A-пинов через 1 тик после RD#(вверх)
            end
          end
          S_WB1: state <= S_WB2;       // t_AS 40 нс; hold-off 0 (см. п.4 шапки)
          S_WB2: state <= S_WB3;       // /WE низ - защищён, идёт до конца
          S_WB3: state <= S_WB4;
          S_WB4: state <= S_IDLE;      // импульс закончен, всё снято в IDLE
          default: state <= S_IDLE;
        endcase
      end
    end
  end

  //=============================================================
  // Тристейт-драйверы шины
  //=============================================================
  // Task 34: при чтении порта 03h A_I(0..4) = row0-4 (mux KBROW),
  // AD7-5 = 000. п.27 (TXUART): чтение 05h - статус {000000, TXRDY, 0}
  // (тот же механизм rd_drive/A-пины, класс hwuart); IN 04h НЕ определён
  // (RX нет - уходит в bus_reg, прошивкой не использовать).
  assign A = rd_drive ? (io_rd_kb ? {3'b000, row4, row3, row2, row1, row0}
                       : io_rd_st ? {6'b000000, tx_idle, 1'b0}
                                  : bus_reg)
            : wb_out   ? addr_latch : 8'bZZZZZZZZ;
  assign D = wb_out ? bus_reg : 8'bZZZZZZZZ;

  //=============================================================
  // Декод памяти минимальной ширины (§5): 1 терм на кристалл
  // v3.9.1 (п.16 шапки): /CE ОЗУ в writeback - ОТ СОСТОЯНИЯ FSM
  // (in_wb); защёлка wb_ram_q удалена - in_wb достижим только через
  // T2-запись в ОЗУ и уже влечёт её условие (эквивалентность v3.9
  // доказана: полный перебор состояний + дифсимуляция двух RTL).
  // Живой декод A15 во время конфликта адресов по-прежнему НЕ
  // участвует: в WB1..WB4 CS_n = 0 без A15/IOM - запись ОЗУ
  // защищена как в v3 (защита п.5 шапки сохранена построением).
  //=============================================================
  assign CSr_n = A15 | IOM;             // /CE_ROM = !( !A15 & !IOM )
  assign CS_n  = in_wb ? 1'b0 : (!A15 | IOM);   // v3.9.1: было (in_wb && wb_ram_q) ? ... (п.16)
  assign OEr_n = CSr_n | wr_phase;      // /OE гасится с T2 - данные уже захвачены,
  assign OE_n  = CS_n  | wr_phase;      // иначе SRAM воевала бы с CPLD на D в writeback
  // v3: /WE НЕ обрывается ALE - импульс доводится до конца (п.4 шапки);
  // безопасно: автомат доходит до WB4/IDLE за 5 тиков; сброс гасит импульс:
  // v3.9.2 - cpu_rst за такт (sync), v3.9.3 - GSR мгновенно (п.18);
  // v3.9.6 - импульс 80 нс квалификатор (400 нс) НЕ успевает оборвать:
  // начатая запись доводится до конца (полный t_WP ОЗУ), сброс гасит
  // драйвы сразу после её завершения (п.21f).
  assign WE_n  = !in_welo;
  assign CS1   = 1'b1;

  //=============================================================
  // Поддержка CPU (§3, ред. Task 19) + TXUART (п.27): передача - аппаратный
  // сериализатор (OUT 04h, ядро выше); приём - программный (SID = RX, RIM 20h).
  // Держатели '0' (TRAP, RST7.5/6.5/5.5, INTR, HOLD, A16-A18) удалены
  // из HDL - их пины (9 шт) заземлит фиттер (Ground on Unused IOs).
  // SID (P73) с Task 70-a - ВЫХОД CPLD (транзит RX), в держатели
  // больше не входит (PGND 10 -> 9).
  //=============================================================
  assign RESET_IN = reset_q;          // v3.9.6 (п.21): РЕГИСТР; активный 0 по даташиту: 0 = сброс CPU (кнопка после квалификатора или POR); INIT=0 - CPU держится с t=0; снятие - чистым регистровым фронтом
  assign READY = 1'b1;          // без wait-state - иначе вечные TW
  // Транзит RX -> SID (Task 70-a) сохранён; TX - ядро TXUART (п.27):
  assign SID = RX;              // приём:  CH340G.TXD (P38) -> CPU.SID (P73), RIM 20h
  assign TX  = shreg[0];        // передача: OUT 04h -> аппаратный передатчик TXUART (п.27);
                                // idle/стоп = '1' (INIT shreg=1FF, SET-ветка GSR):
                                // TX='1' до всякого клока и в сбросе (cpu_rst)

  //=============================================================
  // Индикация и звук: выходы инвертированы (общий анод, активный 0)
  //=============================================================
  assign seg = ~seg_q;
  assign dig = ~dig_q;
  assign SND = snd_q;
  // Task 34: колонки клавиатуры - зарегистрированные выходы, прямые уровни
  // (активная колонка = 1, остальные 0; после сброса 0000 - безопасно)
  assign col0 = kbcol_q[0];
  assign col1 = kbcol_q[1];
  assign col2 = kbcol_q[2];
  assign col3 = kbcol_q[3];

endmodule
