digitalinvitro/CPLD-plus-8085/beta/hiclock/top_suart_hiclock_v399.v

//=====================================================================
// top_suart.v v3.9.9h - ЛИНИЯ HICLOCK: retro_pcld_top + SOFT-UART ТРАНЗИТЫ + CPU 4,17 МГц (база v3.9.8, ЕДИНСТВЕННАЯ переменная - длина кольца N=7 -> N=6; вход CPLD 50 МГц - H1 без шунта; КОЛЬЦО one-hot r0..r5 на clk 50, X1 = r0 duty 1/6 = 8,333 МГц, X2 = r1|..|r5 = ~r0, clk25 = /2 для логики, por-цепь на clk 50 со стробом r0, POR 960 нс, п.24; CS_n от FSM, п.16; СБРОС ЛОГИКИ -> СЕТЬ GSR, п.18, В Т.Ч. ВЕСЬ POR - источник GSR = cpu_rst, п.20; ХАРДРЕНИНГ СБРОСА: RST только через регистры (синхронизатор + квалификатор), RESET_IN - регистр reset_q, п.21)
// (Task 77, 2026-10-20; v3.1 POR_W 14->6, v3.2 por_run регистровый - 2026-10-22;
//  v3.4 декод-иммунный патч clk10-35 - 2026-10-28; v3.5 регистровая
//  противофаза X2 clk10-41 - 2026-10-28; v3.6 полуцелый делитель 25/2,5 ->
//  X1/X2 = 10 МГц, CPU 5 МГц - 2026-10-29; v3.7 TX-маска txm_cnt УДАЛЕНА,
//  захват по первому SOD='1' - 2026-10-29; v3.8 делитель = one-hot кольцо
//  вместо двоичного mod-5 - 2026-10-29; v3.9 кольцо расширено 5 -> 7
//  триггеров: X1/X2 = 7,14 МГц, CPU 3,57 МГц (экземпляр ИМ1281ВМ85А 5 МГц
//  не тянет - нестабильный старт) - 2026-10-29; v3.9.1 CS_n в writeback
//  от состояния FSM, защёлка wb_ram_q удалена (п.16) - 2026-10-30;
//  v3.9.2 делитель: кольцо one-hot N=7 -> двоичный счётчик mod-7,
//  линия lowsize (п.17) - 2026-10-30; v3.9.3 сброс логики -> СЕТЬ GSR,
//  асинхронный (мера снижения ресурсов, п.18) - 2026-11-02; v3.9.4 POR-
//  счётчик 8->4 со стробом x1_n (М1 из txclient v8, п.19) - 2026-11-05;
//  v3.9.5 GSR-источник = cpu_rst (п.20) - 2026-11-05; v3.9.6 хардренинг
//  сброса: RST только через регистры (п.21) - 2026-11-06; v3.9.7 возврат
//  кольцевого делителя one-hot (п.22) - 2026-11-06; v3.9.8 узел
//  тактирования на 50 МГц: кольцо напрямую, X1 = r0, clk25 = /2 для
//  логики, por-цепь на clk 50 (п.23, схема владельца) - 2026-11-06;
//  v3.9.9h линия hiclock: кольцо 7 -> 6 (N=6), CPU 3,571 -> 4,167 МГц
//  (п.24, директива владельца) - 2026-11-07).
//  База: v1 (Task 70-a, логика чтения/захвата
// не тронута), X1 поднят 1,5625 -> 5 МГц (CPU 781,25 кГц -> 2,5 МГц,
// T = 400 нс) - план одобрен владельцем («Делаем!»).
//
// ЧТО ИЗМЕНЕНО в v3 (против v1):
//  1) ДЕЛИТЕЛЬ: XOR-пара /5 от 25 МГц -> X1 = 5 МГц с РОВНО 50% duty
//     (100/100 нс): триггер x1_p переключается по posedge при cnt==0,
//     триггер x1_n - по negedge при cnt==3 (=(N+1)/2 для нечётного N!),
//     X1 = p XOR n. INIT x1_p=1, x1_n=0 -> X1 стартует с '1' (как
//     в .rpt: X1 Init=SET).
//     ВНИМАНИЕ: вариант «negedge при cnt==2» из черновика плана даёт
//     60/140 нс (30/70) - ЗАБРАКОВАН; правильный декод (N+1)/2 (здесь
//     cnt==3), проверен разбором фронтов и тестбенчем (duty-monitor
//     90..110 нс).
//     Параметр CLK_DIV для отката: чётное N -> простой toggle-триггер
//     (X1 = 25/N МГц, 50%), нечётное N -> XOR-пара. CLK_DIV=8 -> X1
//     3,125 МГц (режим v2). Возврат к v1 (X1 1,5625) - старый файл из
//     git-истории (mod-16).
//  2) POR_W 12 -> 14: квант = период X1 = 200 нс -> POR = 16384x200 нс =
//     3,28 мс (в v1 было 2,62 мс при кванте 640 нс; порядок длительности
//     сохранён для медленных блоков питания).
//  3) TX-ТРАНЗИТ С ЗАХВАТОМ (v3.7, замена TX-маски v2-v3.6, txm_cnt
//     УДАЛЁН - см. п.13): датасшит (вывод SR) - аппаратный сброс CPU
//     очищает SOD в '0', и до первого SIM прошивки линия '0' = «вечный
//     start-bit» -> пустой фрейм в терминале. В v3.7 транзит открывает
//     ПЕРВЫЙ сэмпл SOD='1' (TXIDLE прошивки) - захват ПО УРОВНЮ, без
//     счётчика и без привязки к частоте; в сбросе и до захвата TX='1'
//     (чистый idle, без BREAK).
//  4) WRITEBACK - ЗАЩИЩЁННЫЙ ИМПУЛЬС /WE (главное изменение шины!).
//     При T=400 нс реальный зазор WR#(вверх)->след.ALE = 0,25..0,45 T =
//     100..180 нс (плата: 320..580 нс при T=1280; PUSH = write-write).
//     Схема v1 «3 тика выдержки + обрыв по ALE» здесь ТЕРЯЕТ запись
//     (ALE обрывает /WE до импульса -> PUSH портит стек!). В v3:
//     hold-off 3 -> 0 (WBW удалён) и импульс /WE ДОВОДИТСЯ ДО КОНЦА
//     НЕЗАВИСИМО ОТ ALE; драйверы A/D держат СТАРЫЙ адрес/данные до
//     конца импульса. Конфликт с новым адресом CPU (если ALE успел)
//     выигрывает CPLD (24 мА против 2 мА у ВМ85), адрес на входах ОЗУ
//     стабилен весь импульс (t_AS 40 нс, /WE 80 нс), запись попадает
//     по адресу.
//     Почему hold-off РОВНО 0 (а не 1 по плану): после импульса автомат
//     должен УСПЕТЬ в T1H и захватить адрес СЛЕДУЮЩЕГО цикла до
//     ALE#спада. Зазор для этого = ALE#спад - (WR#+P+160) = gap-P-100:
//     при gap=100, P=40 остаётся 0 нс - захват НЕ происходит (поймано
//     в tb, T3c писала по старому адресу!). С hold-off 0: всё закрывается
//     с запасом >= 2 тактов при любом gap >= 100 нс (0,25T). t_DH-GARD
//     не нужен: данные записи уже в bus_reg (захват в T2), а бой на
//     A-сетях выигрывает CPLD (слабый драйвер TB = 2 мА у CPU).
//     Область конфликта <= 60 нс, штатный режим (tb: wb_fight считается
//     отдельно; все проверки t_AS/t_WP/wdel в tb остаются).
//  5) /CE ОЗУ ВО ВРЕМЯ WRITEBACK - ЗАЩЁЛКНУТЫЙ (wb_ram_q, +1 триггер):
//     живой декод CS_n=!A15|IOM во время конфликта адресов читал бы
//     НОВЫЙ адрес CPU и мог сорвать запись (новый адрес = ROM). Защёлка
//     ставится в момент захвата строба (T2, A15/IOM стабильны до конца
//     цикла). В v3.9.1 защёлка УДАЛЕНА - п.16: CS_n в WB от состояния
//     FSM, эквивалентность доказана.
//  6) ЗАХВАТ T1H СТРУКТУРНО ЗАЩИЩЁН: из WB в T1H можно попасть только
//     через IDLE, поэтому addr_latch НЕ перезаписывается посреди
//     импульса. Цепочка WB сжата до 4 состояний (hold-off 0), чтобы
//     успеть захватить адрес СЛЕДУЮЩЕГО цикла в T1 при зазоре
//     100 нс (см. п.4).
// ЧТО ИЗМЕНЕНО в v3.1/v3.2 (2026-10-22, одобрено владельцем «Делаем POR_W = 6»):
//  7) POR_W 14 -> 6: POR = 2^6 x 200 нс = 12,8 мкс = 32 такта CLK OUT
//     (было 3,28 мс = 8192 такта - запас x2730). Даташит 8085A/P8085AH
//     (1821ВМ85А - функциональный аналог 80C85): «RESET IN should be kept
//     low a minimum of three clock periods» ПОСЛЕ power-up = 3 x 400 нс =
//     1,2 мкс при работающем клоке; запас x10. CLK OUT (CPU.37, P83)
//     тикает весь интервал сброса - процессорные структуры тактируются
//     и готовы (аргумент владельца), квитанция CPU - RSTOUT=1 (P70).
//     Счёт стартует только при живом clk 25 МГц (por_ce из делителя),
//     INIT=FF держит RESET_IN=0 до всякого клока; покрытие подъёма VCC
//     проверяется осциллограммой включения (VCC / RESET_IN P84 /
//     CLKOUT P83 / RSTOUT P70). Экономия: por_cnt 14 -> 6 = -8 MC
//     (100/108 -> ~92/108), por_run 14 -> 6 входов, T-цепи заимствования
//     короче, путь por_cnt->seg/dig (36 нс) укорачивается.
//  8) v3.2 (10-22, фит v3.1 упал - Placement Failed): por_run сделан
//     РЕГИСТРОМ (+1 MC). Механизм отказа: комб. por_run=(por_cnt!=0)
//     из 6 бит фиттер СХЛОПНУЛ в PT всех приёмников cpu_rst -> ширина
//     PT и число FB-входов выросли (209/216), 12 выходов ушли в
//     BUFR-буферы (+12 MC, WARNING 897; всего 104 MC), хелпер
//     $OpTx$FX_SC$257 (8 PT/15 входов) не поместился ни в один FB
//     (ERROR:Cpld:892/868). В v3 (14 бит) порог схлопывания не пускал -
//     обходились локальными копиями декода POR ($OpTx$FX_DC, 27 шт).
//     FF-выход не схлопывается в принципе - структура стабильна.
//     Ожидание v3.2: MC ~95, буферы ~3 (как v3), фит ОК.
//
// ЧТО ИЗМЕНЕНО в v3.4 (2026-10-28, декод-иммунный патч clk10-35):
//  9) Фиттер ТРИ раза терял полярность на свёрнутых декодах равенства:
//     фит 7:31 - cnt_T0=(cnt==4) БЕЗ инверсии (счётчик залип -> X1=X2=
//     12,5 МГц) и por_cnt(0): T=NOT en (POR схлопнулся до 1 клока);
//     фит 8:55 (CLK_DIV=2) - cnt_T(0)=(cnt==0) снова без инверсии
//     (X1 замерзает: тактовой нет вообще), por_run.D=(por_cnt==0)
//     инвертировано (сброс снимается за 1 клок), X2 стал РЕГИСТРОМ с
//     D=D(x1_q) - X2 В ФАЗЕ с X1 вместо противофазы. Не чиним
//     инструмент - убираем класс конструкций целиком:
//     - чётные ветки 2/4 = ЦЕПОЧКИ TOGGLE-ТРИГГЕРОВ: /2 -> x1_q тогглит
//       каждый клок; /4 -> t0_q=clk/2, x1_q тогглит при t0_q=1. Вентиля -
//       1-2 литерала, декодов равенства НЕТ (нечему терять полярность);
//     - POR = 8-бит сдвиговый регистр por_sh (INIT=FF): по por_ce сдвиг
//       вправо, 0 в MSB, bit0 очищается ПОСЛЕДНИМ; por_run.D = por_sh[0].
//       Декоды (por_cnt==0)/(por_cnt!=0) исчезли из нетлиста. POR =
//       8 x por_ce = 8 x 160 нс = 1,28 мкс @ CLK_DIV=4/25 МГц (норма:
//       3 такта CLK OUT = 0,96 мкс @ 3,125 МГц, запас 1,33x). Повторный
//       POR невозможен: после 00 сдвиг держит нули. por_run остаётся
//       РЕГИСТРОМ (v3.2, п.8 - защита от Placement Failed);
//     - нечётная ветка (XOR-пара) и fallback чётных N>=6 (счётчик cnt)
//       НЕ тронуты - при CLK_DIV=4 элайзятся; txm_cnt не тронут (оба
//       фита печатали его бит в бит - на этом узле инструмент не сбит);
//     - CLK_DIV 5 -> 4: замер подтверждён (12 МГц на X1/X2 старого
//       джеда = GCK3/2 = 25/2) -> U7 = LTC6905-100, GCK3 = 25,00 МГц
//       (версия -80 НЕ подтвердилась). X1 = 6,25 МГц duty 50%, CPU =
//       3,125 МГц (в ТУ ВМ85А: до 5), CLK OUT = 3,125 МГц, терминал
//       6000 8N1 (ПЗУ fw_mon v5 НЕ перешивается: бод масштабируется
//       клоком, 4800 @ 2,5 МГц -> 6000 @ 3,125 МГц). CLK_DIV=2 не
//       годится: CPU 6,25 МГц - ВНЕ ТУ;
//     - X2 = ~X1 сохранён (фикс clk10-29/30/32); на порт X2 добавлен
//       keep - страховка от same-D регистра (дефект фита 8:55);
//     - бюджет MC (план clk10-35): -12 (cnt 4 + por_cnt 6 + BUF) /
//       +10 (t0_q 1 + por_sh 8 + por_run) -> ожидаем ~98 MC.
//
// ЧТО ИЗМЕНЕНО в v3.5 (2026-10-28, регистровая противофаза X2, clk10-39/41):
// 10) Фит v3.4 (10:06PM) подтвердил худшее: комб. assign X2 = ~X1 фиттер
//     снова поднял в регистр FDCPE с D = XOR(x1_q, t0_q) = D(x1_q) -
//     X2 В ФАЗЕ с X1 (keep-страховка на порте НЕ сработала). CPU в
//     железе не задет (clk10-38: монитор работает, X2 тактирует CPU),
//     но противофаза - требование даташита ВМ85А; чиним ПО ПОСТРОЕНИЮ:
//     X2 = РЕГИСТР с D, ОТЛИЧНЫМ от D(x1) -> same-D слияние невозможно:
//     - div2: x2_q <= x1_q - задержка 1 клок = ПОЛПЕРИОДА (период 2 клока),
//       D(x2_q)=x1_q != D(x1_q)=~x1_q; init (x1_q=1, x2_q=0);
//     - div4: x2_q <= ~(x1_q ^ t0_q): x1_q_next = x1_q ^ t0_q, т.е.
//       x2_q(t+1) = ~x1_q(t+1) - точная противофаза с 0-го такта
//       (трасса фронтов: x1 1,1,0,0,...; x2 0,0,1,1,...);
//       D(x2_q)=XNOR(x1_q,t0_q) != D(x1_q)=XOR(x1_q,t0_q);
//     - fallback чётных N>=6: x2_q тогглит при cnt==MEV СИНХРОННО с
//       x1_q, init (1,0) -> комплементарны всегда (toggle-пара);
//     - нечётная ветка: x2_p - двойник x1_p (posedge при cnt==0, INIT
//       инверсный), X2 = x2_p ^ x1_n = ~x1_p ^ x1_n = ~X1 ТОЧНО, без
//       сдвига duty (вариант «задержка на клок» ломал бы 50/50 при N=5);
//     - keep на порте X2 сохранён (держит сеть отдельной);
//     - бюджет: +1 MC в каждой чётной ветке, +1 MC (x2_p) в нечётной.
//
// ЧТО ИЗМЕНЕНО в v3.6 (2026-10-29, полуцелый делитель 25/2,5, clk10-49):
// 11) ДЕЛИТЕЛЬ: целевой режим владельца - X1/X2 = 10 МГц -> CPU 5,000 МГц
//     (ровно паспортный максимум ВМ85А, БЕЗ разгона; вариант «/2» ->
//     12,5 МГц / CPU 6,25 ОТКЛОНЁН владельцем как разгон). Внешний
//     каскад НЕ тронут: U7 (LTC6905-100) -> шунт H1 1-2 (DIV=GND, /4)
//     -> GCK3 = 25,00 МГц (замер Task 29-d). 25/10 = 2,5 - деление
//     ПОЛУЦЕЛОЕ, toggle-каскадом недостижимо -> НОВАЯ ветка g_div2p5
//     (выбор: CLK_DIV=2 + НОВЫЙ параметр CLK_HALF=1):
//     - cnt: mod-5 по posedge (0..4), wrap по декоду cnt==4;
//     - x1_p (posedge, INIT=1): D = (cnt != 4) -> '1' интервалы
//       [0,160)+[200,360)... нс (по 160 нс, low по 40 в [160,200)+200k);
//     - x1_n (NEGEDGE, INIT=0): set при cnt==2 (t=60+200k), clear при
//       cnt==3 (t=100+200k) -> '1' импульсы 40 нс в [60,100)+200k;
//     - X1 = x1_p ^ x1_n: узор по полутактам 20 нс "11100" повтор ->
//       фронты через РОВНО 100 нс = 10,000 МГц (high 60 / low 40 нс,
//       duty 60/40). Контраст с «наивным» posedge-делением (фронты
//       80/120 нс, период плавает): negedge-сдвиг n выравнивает
//       ПЕРИОД. Duty X1 процессору безразличен: внутренний /2 ВМ85А
//       тактируется ФРОНТАМИ -> CLK = 5,000 МГц, период 200 нс,
//       duty РОВНО 50/50;
//     - x2_p (posedge, INIT=0): D = (cnt == 4) = НЕ D(x1_p), двойник с
//       инверсным INIT (механизм п.10) -> X2 = x2_p ^ x1_n = ~x1_p ^
//       x1_n = ~X1 ТОЧНО с 0-го такта; same-D слияние невозможно;
//     - init (x1_p=1, x1_n=0, x2_p=0) = установившийся узор -> X1
//       стартует '1' (X2 '0') БЕЗ переходного процесса;
//     - регистры ТОЛЬКО существующие (cnt/x1_p/x1_n/x2_p объявлены под
//       legacy-ветки, при (2,1) принадлежат целевой ветке): +3 MC
//       против ветки div4 (t0_q/x1_q/x2_q элайзятся) -> ~98/108;
//     - por_ce = (cnt==4)|(cnt==1): сэмпл по posedge в t=40+200k и
//       t=160+200k -> 1 импульс за период X1 (120/80 нс попеременно,
//       в среднем ровно 100 нс);
//     - ВНИМАНИЕ п.9: в ветке 4 ДЕКОДА (==4/==1/==2/==3) - mod-5 иначе
//       недостижим; аудит .rpt по чек-листу g)-h) ОБЯЗАТЕЛЕН
//       (полярности декодов!).
// 12) ПОСЛЕДСТВИЯ 10 МГц (пересчёт от v3.4, всё в ТУ):
//     - CLK OUT (CPU.37) = 5,000 МГц, T = 200 нс, duty ровно 50%;
//     - POR = 8 x por_ce = 800 нс (норма 3 такта CLK = 600 нс, запас
//       1,33x - ТОТ ЖЕ, что в v3.4 при 6,25);
//     - окно TX-маски 2^8 x 100 нс = 25,6 мкс; окно SOD=0 после сброса
//       сжимается до ~4-20 мкс (код ПЗУ неизменен, такт в 1,6 раза
//       быстрее) - запас 1,28x ТОТ ЖЕ, что в v3.4; TXM_W=8 НЕ тронут;
//     - терминал: 6000 8N1 -> РОВНО 9600 8N1 (ПЗУ fw_mon v5 не
//       перешивается: 4800 @ CPU 2,5 -> 6000 @ 3,125 -> 9600 @ 5 МГц);
//     - автомат шины: WB-импульс 160 нс < зазора WR#(вверх)->ALE
//       (1 T = 200 нс при CPU 5 МГц), конфликтная область на A-сетях
//       <= 60 нс (п.4) - без изменений; остальное байт-в-байт v3.5.
//
// 13) УПРОЩЕНИЕ TX-ТРАКТА (v3.7, clk10-51): «хвост экспериментов» в
//     UART-линии вырезан. Было (v2-v3.6): txm_cnt<7:0> (8 FF, ~9 МЦ,
//     почти весь FB4) тикал по por_ce и через 2^TXM_W=256 тиков (25,6
//     мкс @ 10 МГц) открывал транзит TX=SOD; до того TX='1'. Мотив
//     маски - датасшит IM1821ВМ85А (вывод SR): «...установку в исходное
//     (нулевое) состояние ... триггеров входа INR4 и ВЫХОДА TFD» -
//     сброс CPU очищает SOD в '0', прошивка поднимает линию первым
//     SIM'ом через ~4-20 мкс (TXIDLE fw_mon v5) -> голый транзит =
//     «фиктивный start-bit», пустой фрейм в терминале (наблюдалось
//     в v2-эпоху). Стало: txm_cnt и параметр TXM_W удалены; sod_q
//     (IO-MC входа SOD) синхронизирует вход по clk 25 МГц; tx_pass
//     (1 лог. MC) захватывает линию по ПЕРВОМУ SOD='1' после сброса
//     (async clear по cpu_rst); tx_q (регистр IO-MC пина TX, INIT=1,
//     async set по cpu_rst) выдаёт TX. Итог: -7..-8 МЦ (прогноз
//     ~102 -> ~94/108), FB4 почти пуст; окно SOD=0 покрыто ПО СТРОЕНИЮ
//     (ноль не пропускается, пока прошивка сама не поднимет линию) -
//     TXM_W, запас 1,28x и привязка к частоте X1/CPU упразднены
//     (работает на 3,125/5/6,25 МГц и с любой длиной init); латентность
//     транзита <= 2 такта 25 МГц (80 нс = 0,4 такта CLK 200 нс = 0,08%
//     бита 9600); сброс/кнопка уводят TX='1' мгновенно (async set, без
//     клока). Требование к прошивке одно - первое касание SOD после
//     сброса = SOD:=1 (fw_mon v5 делает это в TXIDLE; любой soft-UART
//     начинает кадр с idle '1'). Теоретическое слабое место: ложный
//     SOD='1' в окне (звон шины выше VIH) открыл бы захват раньше -
//     физически невероятен (вход CPU в сбросе статичен); лечение -
//     захват по 2 сэмплам подряд (+1 FF, см. симуляцию v3.7).
//
// ЧТО ИЗМЕНЕНО в v3.8 (2026-10-29, делитель = one-hot кольцо, clk10-52):
// 14) ДВОИЧНЫЙ mod-5 СЧЁТЧИК ЗАМЕНЁН 5-ТРИГГЕРНЫМ КОЛЬЦОМ-СДВИГОМ
//     (идея владельца и коллеги: «кольцевой счётчик на сдвиговом
//     регистре»). Мотивация по фиту v3.6 (10-29,Successful): МЦ 102/108,
//     входы ФБ 197/216 - стена по ВХОДАМ ФБ (4 ФБ на 35-36/36, FB6
//     Exhausted 36/36), птермов свободно половина. Узел платил входную
//     ренту В ДВА ФБ сразу: FB6 (пины X1/X2) ел cnt<0..3> + x1_p/x2_p/
//     x1_n = 7 входов из 36; FB4 ел cnt<0..3> + x1_n = 5 (+копия декода
//     por_ce $OpTx$FX_DC$163 на 4 литерала cnt<0..3>). В кольце
//     СОСТОЯНИЕ = ВЫХОД ТРИГГЕРА: все 4 декода равенства (==4 wrap,
//     ==1, ==2, ==3) исчезают - терять полярность нечему (класс п.9
//     добит в последнем узле тактового тракта; аудит чек-листа h)
//     упрощается до сравнения 1-2 литеральных птермов). Плюс:
//     -1 МЦ (счётчик в нетлисте фита v3.6 = 4 триггера: cnt<3> выжил
//     как балласт 4-го бита; кольцу нужно ровно 5+1); птермы узла
//     11 -> 8, макс. ширина литерала 4 -> 2 (у рестарта - 5); входы:
//     FB6 7 -> 6, FB4 5 -> 0..2, копии por_ce: 4 литерала cnt ->
//     2 литерала r1/r4.
//     ПОСТРОЕНИЕ (эквивалентность v3.6 доказана трассировкой фронтов и
//     scripts/sim_v38_ring.py - 200 мкс байт-в-байт, ПАСС):
//     - r0..r4: one-hot сдвиг по posedge: r_i <= r_{i-1} & ~r_{i+1} &
//       & ~r_i («убей преемника»). В легальном one-hot оба литерала
//       всегда '1' -> D = r_{i-1}, поведение НЕ меняется. Литералы
//       самоочистки гасят ВСЕ нелегальные состояния: соседняя пара '1'
//       отказывается двигаться и умирает за 1 фронт (оба приёмника
//       заняты), тройки/все-1 -> 00, из 00 рестарт r0 по NOR5;
//       ЛЮБОЕ из 32 состояний -> one-hot за <= 2 фронта. НАИВНОЕ
//       кольцо (r_i <= r_{i-1}) НЕ ГОДИТСЯ: соседняя пара '1' ходит
//       по кольцу ВЕЧНО (2x частота), а 00000 = МЁРТВЫЙ клок; v3.6
//       выплывал из нелегалов до 12 тактов - самоочистка обязательна,
//       цена: +2 литерала на триггер, +0 птермов, +0 МЦ;
//     - x1_p/x2_p СОКРАЩЕНЫ (не +2 триггера против v3.6, а -2):
//       x1_p == ~r0 и x2_p == r0 ТОЧНО - оба обновляются ОДНИМ posedge
//       из одного состояния: x1_p <= (cnt!=4) даёт '0' только в
//       состоянии 0 (= ~r0), x2_p <= (cnt==4) даёт '1' только в
//       состоянии 0 (= r0). Отсюда X1 = (~r0) ^ x1_n, X2 = r0 ^ x1_n;
//       SOP функций X1/X2 различны по построению - same-D слияние
//       невозможно (механизм п.10 сохранён);
//     - x1_n БЕЗ ИЗМЕНЕНИЙ (negedge, INIT=0): set при r2, clear при
//       r3 - те же фронт-пары, что (cnt==2)/(cnt==3);
//     - por_ce = r1 | r4 (те же интервалы, что (cnt==4)|(cnt==1));
//     - INIT r0=1, r1..r4=0 (заплавлен, как init-тройка v3.6) -
//       состояние 0 при старте. ЕДИНСТВЕННОЕ отличие от v3.6: до
//       ПЕРВОГО posedge X1='0'/X2='1' (v3.6: 1/0) - CPU всё это время
//       в POR (por_run=1), схемно незначимо; с первого фронта
//       X1/X2/por_ce/por_run совпадают с v3.6 пофронтово (узор
//       "11100", 10,000 МГц 60/40, CLK 5 МГц ровно 50/50, por_ce 6/4,
//       POR 800 нс);
//     - legacy-ветки (div2/div4/чётные N>=6/нечётные) НЕ тронуты:
//       cnt, x1_p, x2_p остаются объявленными (элайзятся при (2,1)).
//
// ЧТО ИЗМЕНЕНО в v3.9 (2026-10-29, кольцо 5 -> 7 триггеров, clk10-54):
// 15) ОТКАТ ЧАСТОТЫ ПО РЕЗУЛЬТАТАМ ЖЕЛЕЗА: экземпляр ИМ1281ВМ85А не
//     держит CPU 5 МГц - «самые простые тесты крайне нестабильно
//     запускаются, но запустившись вроде бы работают» (сигналы живые:
//     адреса/ALE/сброс/X1-X2 в противофазе - дефект НЕ в тракте CPLD).
//     Решение владельца и коллеги: остаться в семействе one-hot
//     колец и РАСШИРИТЬ кольцо 5 -> 7 (ряд из 25 МГц: N=5 -> X1
//     10,00 МГц; N=7 -> 7,14; N=9 -> 5,56...), v3.8 остаётся откатом.
//     ПОСТРОЕНИЕ (вся остальная логика байт-в-байт v3.8; legacy-ветки
//     не тронуты):
//     - r5/r6 добавлены, кольцо r0..r6: сдвиг с САМООЧИСТКОЙ, УСИЛЕННОЙ
//       против v3.8: r_i <= r_{i-1} & ~r_i & ~r_{i+1} & ~r_{i+2}
//       (kill ПРЕЕМНИКА И ЕГО СОСЕДА), рестарт из 00 по NOR7. Причина
//       усиления: формула коллеги (r_i <= r_{i-1} & ~r_{i+1} & ~r_i) для
//       N=7 НЕ гасит пары '1' на дистанции 3-4 - они ОРБИТИРУЮТ ВЕЧНО
//       (14 состояний из 128; в N=5 проблема отсутствует - малое кольцо
//       сталкивает пары при обходе; поймано sim_v39_ring7.py ДО фита).
//       С двойным kill: gap-1 -> 00 -> рестарт; gap-2/3 - последователь
//       блокирован, лидер идёт; gap-4 - лидера блокирует его собственный
//       kill-литерал через wrap (~r_{q+7} = ~r_q). ЛЮБОЕ из 128 состояний
//       -> one-hot за <= 2 фронта (sim_v39_ring7.py, полный перебор);
//     - x1_n (negedge, INIT=0): set при r3, clear при r4
//       (SET=(N-1)/2=3, CLR=(N+1)/2=4) -> импульс 40 нс, как в v3.8;
//     - X1 = (~r0)^x1_n: high 100 / low 40 нс (duty 71/29), фронты
//       через РОВНО 140 нс = 2x25/7 = 7,143 МГц; X2 = r0^x1_n = ~X1
//       ТОЧНО (SOP различны, п.10/14); внутренний /2 ВМ85А по ФРОНТАМ
//       -> CLK = 3,571 МГц, период РОВНО 280 нс, duty ровно 50/50;
//     - por_ce = r1 | r6: интервалы 200/80 нс (в среднем ровно 140 нс);
//       POR = 8 x 140 = 1120 нс; норма 3 такта CLK = 840 нс -> запас
//       1,33x (тот же, что v3.8: 800/600);
//     - автомат шины НЕ тронут (домен 25 МГц): /WE 80 нс, t_AS 40 нс -
//       ФИКСИРОВАННЫЕ. При T=280 нс зазор WR#(вверх)->след.ALE
//       сжимается до ~0,25..0,45 T = 70..126 нс (при T=400 было
//       100..180); окно захвата T1H = gap + ~0,9T минус 160..200 нс
//       на завершение WB-цепочки -> запас ~120..220 нс (3..5 тактов
//       25 МГц) - закрыт, НО коэффициенты 0,25..0,45 сняты платой при
//       T=1280: после фита ПЕРЕИЗМЕРИТЬ зазор на осциллографе (п.4
//       шапки; арбитр - осциллограф, как и для фазы X1/X2);
//     - бюджет: +2 МЦ (r5/r6), ~+2..3 PT, рестарт-птерм r0.D
//       расширяется 5 -> 7 литералов (шина PT XC9500 - 36, запас);
//       свободно было 21 МЦ (FB2 - 6, FB3 - 6, FB1 - 5, FB6 - 2, FB5
//       - 2) и 17 входов ФБ - ложится с запасом (прогноз ~89/108 MC,
//       ~209/540 PT, ~201-204/216 входов ФБ);
//     - TX-захват v3.7 ПО УРОВНЮ частотно-независим - не тронут.
//     ПОСЛЕДСТВИЯ (пересчёт от v3.8):
//     - терминал: 9600 -> 1920 x 25/7 = 6857 8N1 (ПЗУ fw_mon v5 не
//       перешивается: бод = 1920 x f_CPU; 4800@2,5 -> 6000@3,125 ->
//       9600@5 -> 6857@3,571; CH340G произвольные боды держит);
//     - CLK OUT = 3,571 МГц duty 50%; POR 1120 нс; t_RD/t_WR CPU
//       растут (280+ нс против 200 при 5 МГц) - маржа памяти
//       увеличивается (гипотеза нестабильного старта - CPU за гранью).
//
// ЧТО ИЗМЕНЕНО в v3.9.1 (2026-10-30, CS_n writeback без защёлки, clk10-62):
// 16) ЗАЩЁЛКА wb_ram_q УДАЛЕНА (предложение коллеги, вердикт clk10-61:
//     ПРАВ). Единственный читатель wb_ram_q был CS_n, а in_wb
//     (state >= S_WB1) уже влечёт условие защёлки:
//     - S_WB1 достижим ТОЛЬКО из ветки «запись завершена» в T2
//       (wr_seen && WRn) и ТОЛЬКО при !IOM && A15 - тем же фронтом
//       ставится и защёлка (в v3.9: строки 794+797 в одном begin);
//     - в WB2..WB4 wb_ram_q не переприсваивается (держит 1);
//     - сброс СИНХРОННЫЙ, одним фронтом со state (в v3.9: 743+746) -
//       окна «state в WB, wb_ram_q=0» нет даже при cpu_rst посреди
//       импульса /WE;
//     - драйверы WB (A-сети, D-шина, WE_n) УЖЕ работали от in_wb без
//       защёлки - правка делает CS_n консистентным с WB-трактом.
//     Изменение RTL (против v3.9): удалены reg wb_ram_q, его сброс и
//     взвод; уравнение:
//       было:  assign CS_n = (in_wb && wb_ram_q) ? 1'b0 : (!A15 | IOM);
//       стало: assign CS_n = in_wb ? 1'b0 : (!A15 | IOM);
//     остальное байт-в-байт v3.9 (кольцо N=7, POR, TX v3.7, автомат).
//     ЗАЩИТА ЗАПИСИ СОХРАНЕНА ПОСТРОЕНИЕМ: в WB1..WB4 CS_n=0 БЕЗ
//     A15/IOM - живой декод во время конфликта адресов по-прежнему не
//     участвует; /WE как был, от in_welo (2 тика = 80 нс).
//     ЭКВИВАЛЕНТНОСТЬ (scripts/sim_v391_equiv.py + scripts/tb_v391_diff.v,
//     Icarus Verilog 12.0): (а) полный перебор произведения машин
//     (state, rd_seen, wr_seen, wb_ram_q) x 64 комбинации входов от
//     стартового состояния - 0 расхождений, инвариант «in_wb ->
//     wb_ram_q=1» на всех достижимых состояниях; (б) дифференциальная
//     симуляция двух RTL (v3.9 и v3.9.1 в одном тестбенче, общий
//     стимул): все выходы/шины/лог ОЗУ бит-в-бит на направленных
//     сценариях (запись ОЗУ с новым ALE-циклом и сменой адреса посреди
//     WB - защита п.5, PUSH-стресс, IO/ПЗУ записи, ALE-глюк в T2,
//     cpu_rst в каждой фазе WB1..WB4, «дыхание» защёлки, TX-захват,
//     POR) и на случайном стимуле, 0 расхождений; спеки /WE = ровно
//     80 нс и t_AS >= 40 нс соблюдены.
//     ЦЕНА/ВЫГОДА (по фиту v3.9): -1 МЦ (88 -> 87; wb_ram_q = FB2_17,
//     зарытая, пина нет), -5 ПТ (214 -> ~209), FB1 -1 вход; факт
//     подтверждает фит владельца (п.3 TODO, чек-лист g/h).
//
// ЧТО ИЗМЕНЕНО в v3.9.2 (2026-10-30, делитель: кольцо -> счётчик,
// линия lowsize, clk10-65):
// 17) КОЛЬЦО one-hot N=7 ЗАМЕНЕНО ДВОИЧНЫМ СЧЁТЧИКОМ mod-7 (директива
//     владельца: «работаем над снижением размера HDL дизайна в CPLD»;
//     линия beta/lowsize, база v3.9.1). Мотивация по фиту v3.9
//     (10-29 8:45PM): 88/108 МЦ, входы ФБ 202/216 (исчерпаны FB1/FB3/
//     FB6 по входам, FB4 по МЦ), узел тактирования = 8 триггеров
//     (r0..r6 + x1_n). Кольцо в v3.8 выбрали ради входной ренты
//     (декоды равенства ели входы ДВУХ ФБ), но МЦ-бюджет оно платит
//     сполна: 7 триггеров состояния. Двоичный mod-7 хранит то же
//     состояние в 3:
//     - cnt[2:0]: двоичный 0..6 по posedge, wrap по декоду cnt==6,
//       INIT=000 (легальная орбита); нелегальное 111 недостижимо, а
//       при внешнем попадании восстанавливается за 1 фронт
//       (7+1 = 8 -> переполнение 3 бит -> 000);
//     - фаза X1 - КОМБИНАЦИОННАЯ: X1 = (cnt != 0) ^ x1_n - точный
//       эквивалент (~r0) ^ x1_n кольца (состояние k кольца <=>
//       cnt==k, включая INIT: r0=1 <=> cnt=0). Узор X1 «1111100»
//       (high 100 / low 40 нс), X2 = (cnt == 0) ^ x1_n = ~X1 ТОЧНО,
//       фронты РОВНО через 140 нс, CLK CPU 280 нс 50/50 - БИТ-В-БИТ
//       v3.9;
//     - x1_n: set cnt==3 / clear cnt==4 (NEGEDGE) - те же фазы, что
//       r3/r4 кольца, импульс 40 нс в [140,180) периода 280 нс;
//     - por_ce = (cnt == 1) | (cnt == 6) - те же состояния, что
//       r1|r6: интервалы 200/80 нс, POR = 8 x 140 = 1120 нс БИТ-В-
//       БИТ v3.9 (пара {0,1} дала бы один импульс 80 нс за период ->
//       POR 2240 нс - ЗАБРАКОВАНО по требованию эквивалентности);
//     - ЦЕНА: декоды равенства ВЕРНУЛИСЬ в узел (класс п.9 - фиттер
//       трижды терял полярность декодов в фятах 10-22); теперь они
//       3-битные и дешёвые, чек-лист h) требует сверку уравнений по
//       таблице истинности; ядра X1/X2 выросли 2 -> 4 ПТ (SOP
//       инверсии декода cnt!=0 = cnt0|cnt1|cnt2);
//     - ЭКОНОМИЯ: -4 МЦ (8 -> 4 триггера узла; прогноз 88 -> 84/108,
//       85 если фиттер выделит por_ce в хелпер-МЦ), ПТ ~+11..+36
//       (репликация por_ce в por_sh_D против хелпера), входы ФБ:
//       FB4 -4 (r0..r6 -> cnt0..2), ядра X1/X2 +2 входа;
//     - ЭКВИВАЛЕНТНОСТЬ ДОКАЗАНА ДВУМЯ СТУПЕНЯМИ:
//       (1) дифсимуляция двух RTL (v3.9.1 и v3.9.2 в одном тестбенче,
//           общий стимул: POR, чтения/записи/writeback шины, порты
//           SEG/DIG/SND/KBCOL/KBROW, TX v3.7, ALE-глюки, cpu_rst) -
//           ВСЕ выходы бит-в-бит, 0 расхождений (scripts/tb_v392_diff.v,
//           Icarus Verilog 12.0);
//       (2) узел побитно против точной модели кольца v3.9 на 200 мкс
//           + перебор состояний cnt (scripts/sim_v392_div7.py: фронты
//           140 нс, duty 71/29, X2=~X1, por_ce 200/80, POR 1120 нс,
//           CPU 280 нс 50/50, живучесть из любого состояния);
//     - ПОСЛЕДСТВИЯ: нет (частоты, терминал 6857 8N1, тайминги шины,
//       TX, порты - без изменений; откат - RTL v3.9.1, .jed v3.9
//       10-29 8:45PM известен хороший).
//
//  18) v3.9.3 (линия lowsize, 2026-11-02; директива владельца: меру по
//      сбросу отрабатывать по линии lowsize, в более новой прошивке):
//      СБРОС ЛОГИКИ ПЕРЕВЕДЁН НА СЕТЬ GSR. Что было (v3.9-v3.9.2,
//      Task 25): пин RST (SW20) физически на выводе I/O/GSR (P1), НО
//      сеть GSR НЕ использовалась - сброс был СИНХРОННЫМ через D-gating:
//      cpu_rst = RST | por_run входил литералами в D-функции ВСЕХ
//      триггеров логики. Цена по фиту v3.9.2 (rpt 10-30 8:32PM): RST и
//      por_run импортированы во ВСЕ 6 ФБ (12 из 216 входов ФБ = 6,7%
//      бюджета - крупнейшая статья после шины), ~70 уравнений несли
//      защиты NOT RST / NOT por_run (давление на ПТ), OR (RST) x3.
//      Что стало: триггеры логики (state, rd_seen, wr_seen, addr_latch,
//      bus_reg, seg_q, dig_q, snd_q, kbcol_q) описаны АСИНХРОННО
//      (posedge clk or posedge RST, if (RST)) - фиттер сводит общий
//      асинхронный сброс на СЕТЬ GSR: минус ~2 входа в большинстве ФБ
//      (прогноз вх.ФБ 180 -> ~168-172), минус литералы сброса в
//      D-функциях (прогноз ПТ ~209 -> ~190-205); МЦ 84-85, триггеры 54,
//      ноги 72 - БЕЗ изменений.
//      ВНЕ ДОМЕНА GSR (сознательно, бит-в-бит v3.9.2):
//        - делитель cnt/x1_n: X1 не глушится при сбросе, фаза CLKOUT
//          не прыгает (свойство v3.9 сохранено построением);
//        - por_sh/por_run: POR только по питанию (INIT=FF/1); повторный
//          POR по-прежнему невозможен (после 00 сдвиг держит нули);
//        - sod_q: свободный ход;
//        - tx_pass/tx_q: async SR по cpu_rst (PT-SR v3.7) - cpu_rst
//          держит tx_pass=0 ВЕСЬ POR: враждебный SOD в окне POR не
//          «захватывает» линию TX (ложный старт-бит невозможен);
//        - RESET_IN = ~(RST | por_run): БЕЗ ИЗМЕНЕНИЙ, бит-в-бит
//          v3.9.2 (мгновенный взвод/снятие по кнопке сохранены).
//      ПОВЕДЕНИЕ (отличия от v3.9.2): сброс логики стал АСИНХРОННЫМ -
//      при нажатии значения фиксируются мгновенно (v3.9.2 - на такт
//      позже), при отпускании снимаются мгновенно (v3.9.2 - на такт
//      позже). Нормальные циклы шины бит-в-бит v3.9.2 (дифсимуляция
//      tb_v393_diff; окно 45 ns вокруг фронтов кнопки исключено из
//      сравнения как ОЖИДАЕМОЕ свойство меры, не дефект).
//      РИСК ЗАКРЫТ ГЕЙТОМ: в окне POR (por_run=1) FSM v3.9.3 ЖИВОЙ
//      (GSR не активен), а шина CPU в сбросе «floated» (ВМ85А:
//      управления/адрес/данные в 3-м состоянии) - вход в writeback
//      гейтится (!por_run в S_T2): импульс /WE в окне POR невозможен
//      ПО ПОСТРОЕНИЮ (spec-проверки tb_v393_diff + sim_v393_gsr.py).
//      Метастабильность снятия GSR - класс-риск XC9500 (recovery/
//      removal при снятии в случайной фазе такта): вероятность мала,
//      FSM самозатухающий (защиты v3 сохранены: default->IDLE, abort
//      по ALE, повторный захват) - осознанный компромисс меры.
//      ВЕРИФИКАЦИЯ: (1) дифсимуляция v3.9.2 vs v3.9.3 (scripts/
//      tb_v393_diff.v + run_tb_v393.sh, Icarus 12.0): все выходы и обе
//      шины каждые 5 ns, враждебные «плавания» шины в окне POR, сбросы
//      посреди WB/портов/random, виртуальные ОЗУ равны; (2) scripts/
//      sim_v393_gsr.py: семантика сброса - RESET_IN >= 840 ns нормы
//      для любого нажатия, ноль /WE в окне POR, равенство
//      пост-сбросных состояний, X1/por-цепь бит-в-бит v3.9.2.
//      ЭКОНОМИКА РЕШЕНИЯ: альтернатива «por_sh 8->4» (Plan B
//      txclient) при por_ce ~140 ns даёт POR 560 ns < нормы 840 ns -
//      НЕЛЕГАЛЬНА без переделки строба; GSR-мера дешевле и не трогает
//      тайминги CPU.
//
//  19) v3.9.4 (линия lowsize, 2026-11-05; М1 из txclient v8, применена
//      там по одобрению владельца «Делай M1» 11-3; сюда - по одобрению
//      «Делаем Б» 11-5): POR-СЧЁТЧИК 8 -> 4 БИТА, строб por_ce = x1_n
//      (1 импульс 40 нс в [140,180) каждого периода cnt 280 нс; set
//      cnt==3 / clear cnt==4 по negedge) вместо пары декодов
//      (cnt==1)|(cnt==6) с интервалами {200,80} нс. Что меняется:
//      ТОЛЬКО POR-цепь (reg [3:0] por_sh = 4'hF, сдвиг {1'b0,
//      por_sh[3:1]}, строб) - логика шины, делитель cnt/x1_n/X1/X2,
//      UART-транзиты (v3.7) и GSR-сброс (п.18) БЕЗ ПРАВОК; норм-путь
//      бит-в-бит v3.9.3.
//      ТАЙМИНГ: POR = 4 x 280 = 1120 нс >= нормы 840 нс (3 такта
//      CLK OUT), запас 1,33x - как в v3.9.2/v3.9.3 (там 8 x ~140 =
//      1120-1140 нс); от INIT фактический низ RESET_IN ~1020-1040 нс
//      (4 строба с шагом 280 нс, por_run падает на такт после 4-го
//      сдвига F->7->3->1->0). Возражение п.18 («por_sh 8->4: POR
//      560 нс < 840») считало СТАРЫЙ строб 2/период (4x140=560) - со
//      стробом 1/период мера легальна (снято в txclient v8).
//      Декодов равенства в POR-пути больше НЕТ (классы фитов 7:31 и
//      8:55 остаются исключёнными); цена строба - 1 импорт ФБ (x1_n
//      уже в узле) вместо 2 хелперов $OpTx$FX_DC$449/452 фита v3.9.3.
//      ВЕРИФИКАЦИЯ: (1) дифсимуляция v3.9.3 vs v3.9.4 (scripts/
//      tb_v394_diff.v + run_tb_v394.sh, Icarus 12.0): все выходы и обе
//      шины каждые 5 ns; окно POR закрыто (момент снятия por_run
//      ОЖИДАЕМО отличается: 4-й строб + такт против 8-го), RST-окна
//      сравниваются СТРОГО (поведение GSR идентично); T0 - цикл-точная
//      проверка POR-цепи v3.9.4 по RTL (INIT F/1, ровно 4 сдвига
//      F->7->3->1->0, por_run >= 840 нс, повторного POR нет);
//      (2) враждебные «плавания» шины в окне POR - /WE не рождается
//      (гейт !por_run п.18 бит-в-бит).
//      ЭКОНОМИКА (прогноз): МЦ 85 -> 79-81 (-4 por_sh<7:4>, -2 хелперы
//      декода), ПТ 195 -> ~170-180 (T-цепи 4ПТ/5лит -> 2ПТ/3лит),
//      вх.ФБ 171 -> ~164-168, триггеры 54 -> 50. Норма POR 840 нс
//      соблюдена; повторный POR невозможен (после 0000 сдвиг держит
//      нули).
//
//  20) v3.9.5 (линия lowsize, 2026-11-05; ИСПРАВЛЕНИЕ ДЕФЕКТА СТАРТА
//      v3.9.3/v3.9.4 - жалоба владельца 11-5: «после включения питания
//      плата запускается очень нестабильно, по кнопке сброса не
//      стартует, помогает только передёргивание питания; на плате
//      товарища не запускается вовсе; v3.9.2 запускается стабильно»):
//      GSR-ИСТОЧНИК РАСШИРЕН: RST -> cpu_rst = RST | por_run.
//      ЧТО БЫЛО (п.18, v3.9.3): асинхронный сброс логики ПО КНОПКЕ
//      ТОЛЬКО - в окне POR (~1 мкс) FSM и флаги ЖИВЫ, а шина CPU в
//      сбросе «floated» (ВМ85А 3-стирует управления/адрес/данные,
//      линейки дрейфуют вместе с растром VCC) - FSM бродит по
//      T1H/T2 под плавающими ALE/RDn/WRn/IOM/A15, пачкает
//      rd_seen/wr_seen/addr_latch/bus_reg/seg_q/dig_q/kbcol_q/snd_q
//      и встречает CPU на выходе из сброса ГРЯЗНОЙ (класс-эффекты:
//      rd_drive=1 -> контеншн CPLD против '573 на A-сетях, мусорные
//      декоды портов, глубоко испачканные шинные регистры). v3.9.2
//      был невосприимчив: cpu_rst держал ВСЮ логику в IDLE/нулях
//      КАЖДЫЙ такт POR. ДЕЛЬТА - 2 СЛОВА: always @(posedge clk or
//      posedge cpu_rst) / if (cpu_rst) - условие v3.9.2, СТРУКТУРА
//      v3.9.3 (сброс асинхронный и уходит в СЕТЬ GSR, теперь от узла
//      cpu_rst, а не от ноги RST напрямую). СВОЙСТВА: (1) в окне POR
//      логика чистится асинхронно с t=0 (GSR=1 от INIT por_run=1) -
//      чистый выход в IDLE ГАРАНТИРОВАН; (2) кнопка RESET - прежняя
//      (cpu_rst=1 при RST=1, мгновенный взвод/снятие сохранены);
//      (3) POR-цепь por_sh/por_run, делитель cnt/x1_n и sod_q - как
//      были ВНЕ GSR (por_run в GSR нельзя - сбрасывал бы сам себя);
//      (4) гейт !por_run в S_T2 (п.18) ОСТАЁТСЯ вторым рубежом
//      (бесплатно); (5) tx_pass/tx_q (async SR по cpu_rst) - без
//      правок. ВЕРИФИКАЦИЯ: (1) fuzz-тест окна POR (scripts/
//      tb_por_fuzz.v + run_tb_por_fuzz.sh, Icarus 12.0; модель
//      «плавающей» шины - случайные переключения ALE/RDn/WRn/IOM/
//      A15/A/D, 100 сидов): ГРЯЗЬ В МОМЕНТ СНЯТИЯ por_run -
//      v3.9.2 0/100 (структурная гарантия держит), v3.9.4 100/100
//      (ДЕФЕКТ ВОСПРОИЗВЕДЁН), v3.9.5 0/100 (фикс восстанавливает
//      гарантию); rd_drive-контеншн в окне POR: v3.9.4 86 тактов на
//      100 сидов, v3.9.2/v3.9.5 0; WE_n=0 в POR: 0 у всех (гейт
//      !por_run держит); «грязь на старте CPU» (+200 нс хвост):
//      v3.9.2 84/100 - хвост ОБЩИЙ для обеих линий (после POR
//      cpu_rst снят и в v3.9.2), в поле v3.9.2 стабилен - хвост
//      вымывается первым реальным циклом CPU, а вот ВХОДИТЬ в него
//      грязной и глубоко (порты/шины от всего POR) - смерть старта:
//      этим и отличается v3.9.4; (2) дифсим v3.9.4 vs v3.9.5
//      (scripts/tb_v395_diff.v + run_tb_v395.sh): 0 расхождений на
//      норм-пути (окно POR закрыто, RST-окна строго); (3) POR-цепь
//      бит-в-бит v3.9.4 (4 строба x1_n, RESET_IN ~1020-1040 нс >=
//      840 нс). ЭКОНОМИКА: источник GSR = узел cpu_rst вместо ноги
//      RST: ожидание +1 ПТ (OR) в ФБ гейта RESET_IN (RST и por_run
//      уже импортированы туда), вх.ФБ +0..2; ЕСЛИ фиттер НЕ сведёт
//      узел на GSR (fallback - PT-сбросы на каждом flopa) -
//      функционально то же, дороже по ПТ/вх (анатомия v3.9.2: ~12
//      вх.ФБ на импорты RST/por_run) - .rpt НА РАЗБОР в обоих
//      случаях, НЕ прошивать без аудита.
//
//  21) v3.9.6 (линия lowsize, 2026-11-06; ХАРДРЕНИНГ ЦЕПИ СБРОСА -
//      жалоба владельца 11-6 на v3.9.5 (у ОБОИХ фитов, Exhaustive ON
//      и OFF): «только выкл-вкл питания возвращает работоспособность
//      по сбросу; просто сброс не может восстановить работоспособность,
//      пока она не восстановится по питанию»; гипотеза п.1 разбора
//      (подтяжка цепи RST) владельцем СНЯТА - резистор стоит давно,
//      мера сделана НЕЗАВИСИМОЙ от цепи RST платы). ПРИЧИНА: в фите
//      v3.9.5 GSR НЕ свёлся (fallback) - сырой пин RST доходил
//      НАПРЯМУЮ до гейта RESET_IN<=NOT por_run AND NOT RST (нога CPU)
//      и до 40 PTC-сбросов CLR/PRE=NOT RESET_IN: любой мид-рейл/
//      дребезг/помеха на SW20 размазывает моменты фактического снятия
//      сброса у CPU и у триггеров на время фронта (симуляция
//      sim_v395_rst_float.py: спад 10 мкс - BOOT 7-10/20, ложные /WE
//      и контеншн A/AD у ~50% сидов; у механической кнопки на
//      отпускании - миллисекунды дребезга). МЕРА - RST входит в
//      кристалл ТОЛЬКО через регистры:
//      (a) 2FF-синхронизатор rst_meta/rst_sync (вне сброса, INIT=0) -
//          сырой пин больше не касается ни PTC-сбросов, ни RESET_IN;
//      (b) квалификатор rst_press/rst_qcnt: переворот на 8-м такте
//          ПОДРЯД устойчивого rst_sync != rst_press - дребезг/глитч
//          короче 280 нс не виден вовсе; длиннее - ПОЛНОЦЕННЫЙ
//          повторный сброс: каждый взвод заново чистит все 40
//          триггеров, ПОСЛЕДНЕЕ снятие всегда из held-чистого
//          состояния регистровым фронтом;
//      (c) cpu_rst = rst_press | por_run - ТОЛЬКО регистровые
//          источники (комбинаций от пинов в цепи сброса больше НЕТ);
//      (d) RESET_IN - РЕГИСТР reset_q (INIT=0: CPU в сбросе с t=0 до
//          всякого клока - как от INIT=SET por_run в v3.9.5; вне
//          сброса): снятие сброса CPU ВСЕГДА чистым фронтом, моменты
//          отпускания CPU и логики совпадают до скоха одной сети;
//      (e) гейт S_T2: !por_run -> !por_run AND !rst_press (рубеж
//          п.18/20 распространён на окна кнопочного сброса);
//      (f) начатый импульс /WE (80 нс) НЕ обрывается: квалификатор
//          (400 нс) длиннее импульса - запись доводится до конца
//          (полный t_WP ОЗУ), сброс гасит драйвы сразу после.
//      СВОЙСТВА: POR бит-в-бит v3.9.4 (por_sh/por_run не тронуты),
//      низ RESET_IN по питанию 1020 -> до 1160 нс (норма 840, запас
//      x1,35); латентность кнопки 11 тиков счёта (2FF + 8 такт
//      квалификатора + reset_q) = 400..440 нс от пина на взвод и на
//      снятие (кнопка живёт в миллисекундах); tx_pass/
//      tx_q - прежний async SR, источник - регистровый cpu_rst.
//      НОВОЕ СВОЙСТВО: глитч на RST короче ~280 нс (8 тактов) сброс
//      НЕ вызывает (в v3.9.5 вызывал любой). ЦЕНА: +7 рег (57),
//      прогноз 85-87 МЦ / 220-230 ПТ / 165-172 вх.ФБ (у v3.9.5 было
//      79/217/163/50; свободно 29 МЦ). СИМ: tb_v396_rst.v (Icarus):
//      POR/чистая кнопка/дребезг 8 экскурсий/глитчи 100+250 нс/сброс
//      посреди /WE-импульса/регистровость RESET_IN, норм-путь
//      эквивалентен v3.9.5.
//
//  22) v3.9.7 (линия lowsize, 2026-11-06; директива владельца:
//      «возвращаем в дизайн 3.9.7 делитель на основе кольцевого
//      сдвигового регистра»; продолжение исследования застревания
//      «только по питанию» в 3.9.3-3.9.6). Возврат КОЛЬЦА one-hot
//      r0..r6 (v3.9/v3.9.1) вместо двоичного mod-7 cnt[2:0]
//      (v3.9.2-3.9.6). МОТИВ: застревание сведено к аналоговой
//      лотерее включения (дополнение 11-6bis: класс M1 - clk 25 МГц
//      не стартует; tb_poweron P2 воспроизводит ПОЛНЫЙ симптом-
//      комплекс жалобы на RTL любой версии), гипотеза о «недопустимой
//      ситуации» делителя опровергнута перебором - НО единственной
//      конфигурацией узла тактирования, дававшей в ПОЛЕ стабильные
//      сессии, остаётся КОЛЬЦО (v3.9/v3.9.1: «отлично всё работает»
//      10-29 у обоих экземпляров; счётчик v3.9.2 стабилен только по
//      выборке владельца). v3.9.7 - ПОЛЕВОЙ ЭКСПЕРИМЕНТ С ОДНОЙ
//      ПЕРЕМЕННОЙ: машина состояний делителя возвращена, ВСЁ
//      остальное - БЕЗ ПРАВОК:
//        - строб por_ce = x1_n и por_sh[3:0] (М1, п.19) СОХРАНЕНЫ:
//          POR бит-в-бит v3.9.4-3.9.6 (4 x 280 = 1120 нс); строб
//          кольца v3.9.1 (r1|r6, por_sh 8 бит) НЕ возвращается -
//          иначе в эксперименте две переменные;
//        - GSR (п.18), источник GSR = cpu_rst (п.20), хардренинг RST
//          (п.21), TX-транзиты (v3.7), автомат шины, legacy-ветки
//          делителя - БЕЗ ПРАВОК;
//        - x1_n: set r3 / clear r4 (NEGEDGE) - те же фазы, что
//          set cnt==3 / clear cnt==4 счётчика: X1/X2/por_ce/por_run
//          БИТ-В-БИТ v3.9.6 (дифсим tb_v397_diff.v: 0 расхождений на
//          всех выходах и обеих шинах, POR и кнопка включительно).
//      Отказоустойчивость к стохастике включения - с запасом против
//      счётчика: ЛЮБОЕ из 128 кодов power-up -> one-hot за <= 2
//      фронта (двойной kill + рестарт NOR7, п.15; на RTL v3.9.7 -
//      tb_poweron_v397 P0a: 128 x 16 x 2 = 4096 комбинаций с
//      por-цепью, дрейн por_run <= 1600 нс у ВСЕХ - ПАСС).
//      ЦЕНА: +4 МЦ (узел 4 -> 8 триггеров; прогноз ~88-90/108), ядра
//      X1/X2 4 -> 2 ПТ (XOR от r0 вместо декода cnt!=0), декоды
//      равенства УШЛИ из узла (класс п.9 в узле уничтожен снова).
//      КРИТЕРИЙ ПОЛЕВОГО ЭКСПЕРИМЕНТА: если лотерея включения с
//      v3.9.7 СОХРАНИТСЯ - она ЗА ПРЕДЕЛАМИ делителя (clk-тракт
//      U7 LTC6905/H1/GCK3 или питание) и главным инструментом
//      остаётся чек-лист D1-D4 (README, дополнение 11-6bis); если
//      ИСЧЕЗНЕТ - у стохастики была цифровая компонента в анатомии
//      фита узла (размещение/трассировка), и кольцо - рабочая
//      конфигурация узла для этой платы.
//
//  23) v3.9.8 (линия lowsize, 2026-11-06; схема владельца, сообщение
//      11-6bis-2: «почему ты держишься за 25МГц входной частоты на
//      CPLD, берем делитель /2 и делаем все гораздо проще» + код
//      кольца N=7 на 50 МГц: X1 = r0 duty 1/7, X2 = противофаза,
//      por_ce раз в 140 нс). УПРОЩЕНИЕ УЗЛА ТАКТИРОВАНИЯ: вход CPLD
//      50 МГц (перемычка H1 БЕЗ шунта: DIV=/2 генератора U7 ~100
//      МГц; штатное положение с шунтом давало 25), кольцо r0..r6
//      (п.22, БЕЗ ИЗМЕНЕНИЙ) тактируется 50 МГц НАПРЯМУЮ (период
//      140 нс):
//        - x1_n и negedge-домен УДАЛЕНЫ из целевой ветки: вставка второй
//          кромки в период кольца (весь смысл x1_n в v3.9-v3.9.7) больше
//          не нужна - её даёт сам clk 50. Декларация x1_n в RTL СОХРАЕНА
//          только для legacy g_div_odd (XST компилирует ВСЕ ветки
//          generate - без декларации HDLCompilers:28; в нетлисте целевой
//          конфигурации её БЫТЬ НЕ ДОЛЖНО). X1 = r0: фронт строго
//          каждые 140 нс (7,143 МГц), duty 1/7 (high 20 / low 120
//          нс); внутренний /2 ВМ85А тактируется фронтами X1 ->
//          CLK = 3,571 МГц, период 280 нс, duty РОВНО 50% -
//          ЧАСТОТА CPU НЕ МЕНЯЛАСЬ. X2 = r1|r2|r3|r4|r5|r6 = ~r0 в
//          каждом легальном one-hot состоянии - 6-ПТ OR БЕЗ
//          одиночной инверсии регистра (класс п.10/прецедент v3.4:
//          фиттер поднимал ~X1 в регистр В ФАЗЕ; в illegal-кодах
//          кольца на самоочистке (<= 2 фронта при включении) X2
//          отличается от ~X1 - транзиент на мёртвой для CPU фазе
//          POR, схемно незначимо);
//        - ЛОГИКА (rst/TX/FSM/порты) остаётся на 25 МГц: clk25 =
//          /2-триггер clk25_q от clk 50 (INIT=0 - фаза фиксиро-
//          вана). МОТИВ: XC95108-15 FSM/шина на 50 МГц НЕ закроет,
//          а /WE 80 нс (2 тика), квалификатор кнопки 320 нс (8
//          тиков) и все тиковые константы v3.9.2-3.9.7 обязаны
//          остаться - значит логика живёт на clk25 БИТ-В-БИТ
//          v3.9.7 (в .rpt - только смена тактовой сети; прецедент
//          внутреннего такта на GCK-сети: complement of clk ->
//          GCK2 в фите v3.9.5);
//        - por-цепь ПЕРЕВЕДЕНА в 50-домен: por_sh[7:0] (Init=FF),
//          строб por_ce = r0 - РОВНО ОДИН за период кольца 140 нс
//          («раз в 140 нс» владельца). ПОЧЕМУ НЕ r1|r6 дословно:
//          на кольце 50 МГц r1|r6 стреляет ДВАЖДЫ за период (каждые
//          70 нс) - POR уполовинился бы (280-560 нс при 4-8 битах
//          против нормы 840); а сэмпл 20-нс стробов кольца тактом
//          clk25 - ФАЗОВАЯ ЛОТЕРЕЯ: при чётной фазе стробы видны
//          (состояния r1/r6 совпадают с кромками), при нечётной -
//          НЕ ВИДНЫ ВОВСЕ (clk25 вечно сэмплирует r0/r2/r4) -> POR
//          не кончается НИКОГДА. В 50-домене строб - синхронное
//          включение того же такта: детерминировано при любой фазе.
//          POR = 8 x 140 = 1120 нс - НОМИНАЛ v3.9.4-3.9.7 (4 x 280),
//          запас 1,33x; фактический дрейн por_sh 1000 нс и снятие
//          por_run на кромке 1020 нс СОВПАДАЮТ с v3.9.7;
//      ВСЁ ОСТАЛЬНОЕ БЕЗ ПРАВОК: кольцо (п.22), GSR (п.18),
//      источник GSR = cpu_rst (п.20), хардренинг RST (п.21), TX
//      (v3.7), автомат шины, legacy-ветки делителя (в них clk25 =
//      прямой clk - элайзятся при (2,1)). СТОХАСТИКА ВКЛЮЧЕНИЯ:
//      128 кодов кольца x 8 por_sh x 2 фазы clk25 = 2048 комбинаций
//      (tb_poweron_v398 P0a) - one-hot <= 2 фронтов, дрейн por_run
//      <= 1200 нс. ЦЕНА: +1 МЦ (clk25_q) +4 МЦ (por_sh 4->8) -1 МЦ
//      (x1_n) = +4 МЦ; прогноз ~92-94/108. ГЛАВНЫЙ РИСК ФИТА: сеть
//      clk25 (выход триггера) должна сесть на глобальную тактовую;
//      РИСК АНАЛОГОВЫЙ: high X1 теперь 20 нс (было min 40) - если
//      генерация CPU сорвётся, откат одной строкой: X1 = r0 | r1
//      (high 40 нс), частоты те же.
//
// ЧТО ИЗМЕНЕНО в v3.9.9h (линия hiclock, 2026-11-07; директива владельца:
// «на базе 3.9.8 поднять частоту до 4,167 МГц, создать её в hiclock»):
// 24) ЕДИНСТВЕННАЯ ПЕРЕМЕННАЯ - ДЛИНА КОЛЬЦА: r0..r6 -> r0..r5 (N=7 -> N=6),
//     ВСЁ ОСТАЛЬНОЕ БАЙТ-В-БАЙТ v3.9.8 (clk25 = /2 для логики, por-цепь
//     50-домена, GSR п.18/20, хардренинг RST п.21, TX v3.7, автомат шины,
//     legacy-ветки). Ряд частот кольца на 50 МГц: CPU = 25/N - N=6 даёт
//     4,167 МГц (ближайший шаг вверх от 3,571; 4,0 из ряда недостижим):
//     - X1 = r0: фронт строго каждые 120 нс (8,333 МГц), duty 1/6 (high
//       20 / low 100 нс); внутренний /2 ВМ85А тактируется ФРОНТАМИ X1 ->
//       CLK = 4,167 МГц, период 240 нс, duty ровно 50% (в ТУ ВМ85А до 5;
//       экземпляр владельца 5,0 не тянул - п.15; 4,167 = 83% предела);
//     - X2 = r1|r2|r3|r4|r5 = ~r0 в каждом легальном one-hot - 5-ПТ OR
//       БЕЗ инверсии регистра (класс п.10, как п.23);
//     - кольцо: тот же двойной kill r_i <= r_{i-1} & ~r_i & ~r_{i+1} &
//       & ~r_{i+2} (wrap mod 6), рестарт из 00 по NOR6. АРГУМЕНТ П.15
//       (gap-4 через wrap N=7) НА N=6 НЕ ПЕРЕНОСИТСЯ АВТОМАТИЧЕСКИ -
//       самоочистка доказана ЗАНОВО полным перебором
//       (beta/hiclock/scripts/sim_v399h_ring6.py): ЛЮБОЕ из 64 кодов ->
//       one-hot за <= 2 фронтов (макс = 2), орбита периода 6 у всех,
//       one-hot устойчив вечно; негативные контроли: наивное кольцо
//       (без kill) из пары '11' ходит вечно, ОДИНАРНЫЙ kill (v3.8)
//       на N=6 орбитит 22 кода из 64 - двойной kill НЕОБХОДИМ и
//       ДОСТАТОЧЕН (перебор);
//     - por-цепь НЕ ТРОНУТА (por_sh[7:0], Init=FF, строб por_ce = r0):
//       строб 20 нс раз в 120 нс; POR = 8 x 120 = 960 нс; норма 3 такта
//       CLK = 720 нс при CPU 4,167 -> запас 1,33x ТОТ ЖЕ (масштабируется
//       с N при любом); модель power-on (1024 комбинации: 64 x 8 por_sh
//       x 2 фазы clk25_q): снятие por_run <= 980 нс из ЛЮБОГО кода,
//       штатный старт (por_sh=FF) - стробы 20/140/.../860, снятие на
//       кромке 880 нс (у v3.9.8: 1020 - масштаб 6/7 = 874, сошлось);
//     - ЛОГИКА 25 МГц НЕ ТРОНУТА: clk25_q, /WE 80 нс, квалификатор
//       кнопки 320 нс, FSM, TX - бит-в-бит v3.9.8 (та же тактовая сеть);
//     - ПОСЛЕДСТВИЯ ДЛЯ ШИНЫ (T = 240 нс): зазор WR#(вверх)->след.ALE
//       = 0,25..0,45 T = 60..108 нс (при T=280 было 70..126); окно
//       захвата T1H = gap + 0,9T - 160..200 нс = ~76..164 нс (2..4 тика
//       25 МГц) - закрыт, НО ТОНЬШЕ v3.9.8 (там 120..220). Коэффициенты
//       сняты платой при T=1280 - ПОСЛЕ ФИТА ПЕРЕИЗМЕРИТЬ зазор на
//       осциллографе (п.4/п.15; ориентир: при T=200, эпоха CPU 5,
//       FSM был жив - срывал сам CPU, не шина);
//     - память: t_RD/t_WR CPU сжимаются до ~240 нс против 280 при
//       3,571 (при 200 в 5-МГц эпоху память жила) - маржа есть;
//     - терминал: 6857 -> 8000 8N1 (бод = 1920 x f_CPU = 48000/6 РОВНО;
//       CH340G произвольные боды держит);
//     - бюджет МЦ: -1 (r6) -> прогноз 93/108; ПТ -2..3 (X2 6->5 ПТ,
//       рестарт NOR7->NOR6), вх.ФБ ~178-183. Откаты: по частоте -
//       v3.9.8 (N=7, 3,571); по duty X1 (если 20 нс high перестанет
//       заводить генерацию) - X1 = r0 | r1 (high 40 нс), частоты те же.
//     ВЕРИФИКАЦИЯ (Icarus Verilog 12.0, tools/iverilog): (1) элаборация
//     ВСЕХ 5 веток generate - 0 ошибок; (2) tb_poweron_v399h (адаптация
//     эталона tb_poweron_v398 + блок PX геометрии 120 нс): P0a - полный
//     перебор 1280 комбинаций (64 кольца x 10 por_sh x 2 фазы clk25) -
//     one-hot за <= 2 фронтов из ЛЮБОГО кода, дрейн por_sh в 00 за
//     <= 1400 нс НАВСЕГДА, por_run падает и не возвращается, clk25_q
//     640/640; P0b - орбита дрейна FF->7F->3F->1F->0F->07->03->01->00
//     монотонная; PX - 50 фронтов X1 шагом РОВНО 120 нс, high РОВНО
//     20 нс, X2 == ~X1 в каждом сэмпле, por_ce РОВНО 1 строб/120 нс,
//     RESET_IN снялся через 900 нс; P1 - 1 «ошибка» эталонного класса
//     окна 40 нс (самозаживление 100/100 - не хуже эталона v3.9.8,
//     у которого 3; путь сброса байт-в-байт v3.9.8); P2-P5 ПАСС (см.
//     README). Узел проверен ТАКЖЕ точной моделью перебора:
//     beta/hiclock/scripts/sim_v399h_ring6.py - 0 ошибок. Логика вне
//     узла не менялась и дифсим-верифицирована в v3.9.8 (69 044
//     выборки, 0 расхождений).
//
// 25) ФИТ 1 v3.9.9h (11-6 11:29PM, SUCCESSFUL; DENSITY, Input Limit 28,
//     Pterm 18, Exhaustive OFF; архив: retro_pcld_top
//     (v399h-fit1-1106-1129PM).rpt в beta/hiclock) - АУДИТ ПАСС по
//     чек-листу README (a-h):
//     - КОЛЬЦО: X1 = r0 (FB6_3, pin 68, 2 ПТ/6 вх, INIT SET) + r1..r5
//       (INIT RESET, все в FB6) = 6 триггеров, r6 В НЕТЛИСТЕ НЕТ;
//       уравнения фиттера = RTL БАЙТ-В-БАЙТ (r0.D = (r5 & ~r0 & ~r1 &
//       ~r2) | NOR6 - рестарт из 00 на месте; kill-литералы на месте;
//       декодов равенства НЕТ);
//     - X2 = r1|..|r5: СВОЯ МЦ FB6_5 (pin 69), 1 ПТ/5 вх - фиттер
//       свернул 5-ПТ OR в NOR-форму с инверсией выхода (класс п.10,
//       эквивалент точный); X2 КОМБИНАЦИОННЫЙ (регистра нет - «в фазе
//       r0» исключено); keep=TRUE сработал (сеть отдельная);
//     - clk25_q: 1 триггер (FTCPE, T='1', 0 ПТ, INIT RESET) - КАК В
//       v3.9.8 (локальная сеть 25 МГц, железом подтверждено);
//     - POR-цепь: por_sh[7:0] на clk 50 (INIT FF), строб = X1,
//       por_run = por_sh(0) (INIT SET) -> POR = 8 x 120 = 960 нс
//       (норма 720 нс, запас 1,33x - тот же);
//     - СБРОС БАЙТ-В-БАЙТ v3.9.8 (п.21): RST P1 - обычный вход (GSR НЕ
//       использован), rst_meta/rst_sync/rst_qcnt/rst_press на clk25
//       (квалификатор 320 нс), wr_seen_RSTF = !rst_press & !por_run,
//       RESET_IN - регистр (FB4_3, INIT RESET);
//     - РЕСУРСЫ = ПРОГНОЗ ТОЧНО: 93/108 МЦ (86%), 286/540 ПТ (53%),
//       181/216 вх.ФБ (84%), 64/108 рег, 72/81 ноги (X1 P68, X2 P69,
//       clk P29 -> GCK3 - единственная глобальная); дельта к v3.9.8:
//       -1 МЦ (r6), -1 ПТ, -2..-4 вх.ФБ (183-185 -> 181), -1 рег;
//       исчерпаны ФБ3 (входы 36/36), ФБ4 и ФБ6 (МЦ 18/18);
//     - WARNING:Cpld:897 - буфер D<7> (D<7>_BUFR в FB5_3, 5 ПТ/12 вх) -
//       ИЗВЕСТНЫЙ КЛАСС (у v3.9.8 тот же), не блокер; первый
//       подозреваемый при бит-специфичных сбоях D7; INFO:Cpld BUFG по
//       P29 - штатно;
//     ВЕРДИКТ: ФИТ ЗОЛОТОЙ - .jed СТРОИТЬ И ШИТЬ. ОГОВОРКА ПО ЖЕЛЕЗУ:
//     у ЭТОГО экземпляра ВМ85А 4,17 МГц УЖЕ ОТКЛОНЯЛАСЬ (v3.10 - «не
//     тянет», v3.11 с POR 5,58 такта - не стартует; 10-29/30, история
//     первой кампании в README beta/hiclock) - v3.9.9h перепроверяет ту
//     же частоту на НОВОЙ архитектуре тактирования (кольцо N=6 напрямую
//     от 50 МГц, X1 duty 1/6 вместо 50/50, X2 = ~X1) по директиве
//     владельца; при неудаче откат - известный хороший .jed v3.9.8
//     (перепрошивка, без пайки).
//
// Что делать владельцу (TODO 78, ред. v3.9.9h; статус 11-7: п.1-2 ВЫПОЛНЕНЫ - фит 1 SUCCESSFUL 11-6 11:29PM, аудит п.25; остались п.3-4):
//  1) в ISE-проекте заменить top_suart.v на ЭТОТ файл (Set as Top Module);
//  2) UCF БЕЗ ИЗМЕНЕНИЙ (hdl/top_suart.ucf, те же ноги; clk = P29 GCK3);
//  3) фит и .rpt НА АУДИТ ДО ПРОШИВКИ (чек-лист ниже). Обязательные
//     точки v3.9.9h (КОЛЬЦО one-hot r0..r5 на clk 50 МГц + clk25 = /2,
//     п.24) + v3.7 (TX): ветка g_div2p5 - r0..r5 (6 триггеров one-hot,
//     двойной kill п.15/24, clk 50 МГц; INIT: r0=SET - состояние 0,
//     r1..r5=RESET); r6 В НЕТЛИСТЕ НЕТ (удалён, N=6 - появился: собран
//     исходник v3.9.8!); clk25_q (Init=RESET, T-триггер: D = NOT clk25_q,
//     clk 50 МГц) - такт ЛОГИКИ 25 МГц; x1_n В НЕТЛИСТЕ НЕТ (удалён,
//     negedge-домена больше нет); X1 = r0 (1 ПТ, регистр r0 МОЖЕТ
//     лечь в IO-MC пина), X2 = r1 OR r2 OR r3 OR r4 OR r5
//     (5 ПТ, БЕЗ инверсии - в легальном one-hot = ~X1 ТОЧНО; если
//     фиттер показал X2 регистром В ФАЗЕ r0 - БРАК, не шить);
//     ДЕКОДОВ РАВЕНСТВА В УЗЛЕ БЫТЬ НЕ ДОЛЖНО (кольцо, п.22/23;
//     появились ==-декоды - собран ИСХОДНИК v3.9.2-3.9.6!);
//     cnt/x1_p/x2_p/t0_q/x1_q/x2_q/x1_n в нетлисте ОТСУТСТВУЮТ
//     (legacy-ветки элайзятся); por_sh - сдвиг (8 бит, Init=FF,
//     clk 50 МГц), строб por_ce = r0 (ДЕКОДОВ В POR-ЦЕПИ НЕТ),
//     por_run.D = por_sh[0], por_run Init=SET (обе - clk 50 МГц);
//     rst_meta/rst_sync/rst_qcnt/rst_press/reset_q/sod_q/tx_pass/
//     tx_q/state_FSM - clock = clk25 (НЕ clk!); reset_q -
//     FDCPE(clk25,'0','0') БЕЗ PRE; wb_ram_q В НЕТЛИСТЕ НЕТ
//     (v3.9.1), CS_n в Equations - от state_FSM_FFd1..3 + A15/IOM
//     (литерала wb_ram_q БЫТЬ НЕ ДОЛЖНО);

//  3a) v3.9.3 (GSR, п.18): в .rpt - "Global set/reset net(s) used",
//     "GSR : 1"; D-функции логики БЕЗ литералов сброса (NOT RST /
//     NOT por_run исчезли); уравнение RESET_IN = (por_run) OR (RST)
//     СОХРАНИЛОСЬ; tx_pass/tx_q - async SR по cpu_rst; por-цепь и
//     cnt/x1_n/sod_q - без GSR. ЕСЛИ GSR НЕ применился - rpt НА
//     РАЗБОР, НЕ прошивать (фит функционально корректен, но мера
//     не сработала);
//  3b) v3.9.8 (М1 ред. п.23): в .rpt por_sh - РОВНО 8 триггеров
//     (por_sh<7:0>, FTCPE, clock = clk пин 50 МГц); литерал строба -
//     r0 (декодов в POR-цепи НЕТ; x1_n/cnt<0..2> в POR-цепи НЕТ);
//     por_run.D = por_sh[0], Init=SET; clk25_q - РОВНО 1 триггер
//     (D = NOT clk25_q, clk 50 МГц); ЕСЛИ por_sh 4 бита
//     (v3.9.4-3.9.7) ИЛИ 16 бит - собран НЕ ТОТ исходник, rpt НА
//     РАЗБОР;
//  3c) v3.9.5 (GSR-источник = cpu_rst, п.20): в .rpt СЕТЬ GSR
//     ИСПОЛЬЗУЕТСЯ ("Global set/reset net(s) used", "GSR : 1"); в
//     Node Listing узел cpu_rst (или $-хелпер с RST|por_run) с
//     признаком GSR; D-функции логики БЕЗ литералов сброса (NOT RST /
//     NOT por_run нет); por-цепь por_sh<7:0>/por_run ВНЕ GSR (Init=SET
//     сохранён!), cnt/clk25_q/sod_q вне GSR; tx_pass/tx_q - async SR по
//     cpu_rst; RESET_IN = (por_run) OR (RST) сохранён; ЕСЛИ GSR НЕ
//     применился (PT-сбросы) - функционально корректно, но дорого:
//     rpt НА РАЗБОР, не прошивать без сверки ресурсов;
//  3d) v3.9.6 (хардренинг сброса, п.21): в нетлисте rst_meta/rst_sync/
//     rst_press/rst_qcnt<2:0>/reset_q - все ВНЕ сброса/GSR; reset_q -
//     Init=RESET (FDCPE(clk25,'0','0') БЕЗ PRE - CPU держится с t=0;
//     константа '0' в уравнении = признак Init, сверять как у por-цепи
//     - прецедент 2565246: cpldfit Init в печати не виден); литерал
//     RST в .rpt - ТОЛЬКО во входах ФБ rst_meta (1 ФБ), в D/PT-
//     функциях БОЛЬШЕ НИГДЕ (v3.9.5: RST стоял в гейте RESET_IN);
//     уравнения-ожидания: reset_q.D = NOT por_run AND NOT rst_press;
//     rst_press.D = rst_sync при rst_qcnt==7 (иначе hold, 4-6 ПТ);
//     rst_qcnt<2:0> - счётчик 0..7 с обнулением при
//     rst_sync==rst_press; гейт S_T2 - с !rst_press; D-функции логики
//     по-прежнему БЕЗ литералов сброса; GSR (если сведётся - от узла
//     cpu_rst) ОПЦИОНАЛЕН: PT-сбросы анатомии v3.9.5 корректны;
//     прогноз: МЦ 85-87, ПТ 220-230, вх.ФБ 165-172, рег 57.
//  4) ПАСС -> .jed в плату; ПЕРЕД этим переставить перемычку H1 БЕЗ
//     шунта (DIV=/2, U7 ~50 МГц на GCK3; ЕСЛИ шунт не переставлен -
//     всё работает ВДВОЕ медленнее: X1 3,57 МГц, CPU 1,79 МГц - это
//     НЕ поломка, просто верни шунт на место); осциллограф: GCK3 =
//     50 МГц, X1 = 8,33 МГц (период ровно 120 нс, high 20 / low 100 -
//     duty 1/6), X2 = 8,33 ПРОТИВОФАЗА (два луча - решает и вопрос
//     полярности X2; если X2 в фазе - БРАК фита, класс п.10),
//     RESET_IN низ ~0,88 мкс по питанию (8 стробов x 120 нс, п.24),
//     CLKOUT = 4,17 МГц duty 50%; ЕСЛИ генерация CPU не заведётся
//     (high X1 20 нс - как в v3.9.8, железом подтверждено; риск -
//     САМА частота 4,167 для экземпляра ВМ85А) - откат по частоте:
//     v3.9.8 (N=7, 3,571); откат по duty одной строкой RTL:
//     X1 = r0 | r1 (high 40 нс), частоты те же;
//  5) терминал 8000 8N1 (бод = 1920 x f_CPU: 4800@2,5 -> 6000@3,125
//     -> 9600@5 -> 6857@3,571 -> 8000@4,167); ПОСЛЕ ФИТА: зазор
//     WR#(вверх)->след.ALE на осциллографе (ожидание 60..108 нс) и
//     PUSH-стресс - окно WB тоньше v3.9.8 (п.24).
//
// -- ЧЕК-ЛИСТ .rpt ПОСЛЕ ФИТА v3.4 (пройтись по распечатке глазами!) --
//  a) clk = P29 (GCK3, знак "User Assigned"), RST = P1 (GSTR);
//     на GCK3 подано 50 МГц (H1 без шунта); в .rpt сеть clk25
//     (такт ЛОГИКИ) - желательно на ГЛОБАЛЬНОЙ тактовой сети
//     (прецедент: complement of clk -> GCK2 в фите v3.9.5); если
//     фиттер повесил clk25 на обычную трассировку - проверить
//     skew/setup в отчете о временах (25 МГц закрывались с запасом
//     во всех фятах v3.9.x);
//  b) ВСЕ constraint-ноги со знаком "~" (фиттер НЕ переставлял);
//  c) PGND (Unused IO Ground) = РОВНО {P74,P75,P76,P78,P79,P81,
//     P95,P96,P98} - 9 шт (P73 = выход SID, в PGND БЫТЬ НЕ ДОЛЖНА);
//  d) входы на местах (INP): X2 P69, RSTOUT P70, SOD P72, INTAn P80,
//     HLDA P82, CLKOUT P83, S0 P94, S1 P89, AH8 P10, AH9 P12, AH10 P18,
//     AH11 P14, AH12 P4, AH13 P8, AH14 P3, RX P38;
//  e) выходы: READY P87='1', CS1 P99='1', TX P39=tx_q (IO-MC регистр,
//     транзит SOD с захватом v3.7), SID P73=RX (транзит), X1 P68
//     (r0, duty 1/6: high 20 / low 100 нс, v3.9.9h), X2 P69
//     (r1 OR r2 OR r3 OR r4 OR r5 = ~r0 = ~X1 в легальном
//     one-hot, БЕЗ инверсии регистра - v3.9.9h, п.10/24);
//  f) v3.9.2: GSR НЕ использовался (сброс через D-gating, Task 25).
//     v3.9.3: СЕТЬ GSR ИСПОЛЬЗУЕТСЯ (п.18): "Global set/reset net(s)
//     used" + "GSR : 1" в Pin Resources; строка RST в Node Listing -
//     тип GSR/I/O с признаком GSR; в D-уравнениях ЛОГИКИ нет защит
//     "NOT RST"/"NOT por_run" (v3.9.2: NOT RST x70, NOT por_run x55,
//     OR (RST) x3 - должны ИСЧЕЗНУТЬ); RST в списках входов ФБ - не
//     более 1 (ФБ RESET_IN); por_run - только у tx_pass/tx_q/RESET_IN;
//     RESET_IN = (por_run) OR (RST) СОХРАНИЛОСЬ; cnt/x1_n/por_sh/
//     por_run/sod_q - БЕЗ GSR; ЕСЛИ "Global set/reset net(s) unused"
//     СОХРАНИЛОСЬ - фиттер не дал частичный GSR: фит функционально
//     корректен (PT-сбросы), но мера не сработала - rpt НА РАЗБОР,
//  g) MC < 108 (прогноз ~95 после v3.2: +x1_n, +2 por_cnt, +wb_ram_q, +8 txm_cnt;
//     -1 триггер автомата: 8 состояний = 3 триггера; v3.1: POR_W 14->6 = -8; v3.2: +1 por_run;
//     v3.6: ~98 - ветка div4 (-t0_q,-x1_q,-x2_q) заменена на cnt(3)+x1_p+x1_n+x2_p (+6));
//     v3.7: -txm_cnt (-8 FF и декод txm_run), +sod_q/tx_pass/tx_q
//     (tx_q/sod_q - в IO-MC пинов TX/SOD, логических +1) -> прогноз ~94/108;
//     v3.8: делитель 4+3 -> 5+1 триггера (cnt<3> фита v3.6 - балласт
//     4-го бита) -> прогноз ~93/108; входы ФБ 197 -> ~191 (узел платил
//     7 входов в FB6 и 5 в FB4 - теперь 6 и 0..2));
//     Maximum Frequency >> 25 МГц;
//     v3.9.2: узел 8 -> 4 триггера (кольцо r0..r6+x1_n -> cnt<2:0>+x1_n)
//     -> прогноз ~84/108 МЦ (85, если фиттер выделит por_ce в
//     хелпер-МЦ); ПТ ~214 -> ~225-250 (ядра X1/X2 по 4 ПТ + x1_n 4 ПТ
//     + cnt 4-7 ПТ; por_ce репликацией в por_sh_D или хелпером);
//     входы ФБ ~202 -> ~196-208 (FB4: r0..r6 -> cnt0..2, -4);
//     v3.9.7: узел 4 -> 8 триггеров (возврат кольца, п.22) -> прогноз
//     ~88-90/108 МЦ (у v3.9.6 было 85-87); ядра X1/X2 4 -> 2 ПТ
//     (XOR от r0 вместо декода cnt!=0);
//     v3.9.8: +clk25_q, por_sh 4 -> 8 бит, -x1_n = +4 МЦ -> прогноз
//     ~92-94/108 МЦ (у v3.9.7 прогноз ~88-90); ПТ ~225-240 (X2 - 6 ПТ
//     против 2), вх.ФБ ~170-180 (X2 ест 6 колец в FB6); Maximum
//     Frequency: узел 50 МГц (кольцо/clk25_q/por_sh на GCK3) и
//     логика 25 МГц (clk25) - ОБЕ должны закрыться;
//     v3.9.9h: кольцо 7 -> 6 триггеров (-r6) = -1 МЦ -> прогноз
//     93/108 МЦ (факт v3.9.8: 94); ПТ -2..3 (X2 - 5 ПТ, рестарт
//     NOR6), вх.ФБ ~178-183; Maximum Frequency: как v3.9.8 - узел
//     50 МГц и логика 25 МГц (clk25) - ОБЕ должны закрыться;
//  h) в Equations (v3.9.9h, КОЛЬЦО one-hot r0..r5 на clk 50 МГц +
//     clk25 = /2, п.24): состояние узла = ВЫХОДЫ триггеров r0..r5
//     (кольцо п.22/24, N=6); декодов равенства (==N) В УЗЛЕ БЫТЬ НЕ ДОЛЖНО
//     - появились: собран исходник v3.9.2-3.9.6! x1_n В НЕТЛИСТЕ
//     НЕТ - появился: собран исходник v3.9.7! (декларация x1_n в RTL -
//     ТОЛЬКО для legacy g_div_odd: XST компилирует все ветки generate;
//     в целевой конфигурации (2,1) - элайзится). Ожидаемые уравнения
//     (двойной kill п.15; фиттер вправе СОКРАЩАТЬ kill-литералы -
//     в легальном one-hot они избыточны; сверять ТАБЛИЦЕЙ
//     истинности, не полярностью одного терма; класс п.9 - фиттер
//     трижды терял инверсию декодов в фятах 10-22):
//       r1.D = r0 AND NOT r1 AND NOT r2 AND NOT r3;
//       r2.D = r1 AND NOT r2 AND NOT r3 AND NOT r4;
//       r3.D = r2 AND NOT r3 AND NOT r4 AND NOT r5;
//       r4.D = r3 AND NOT r4 AND NOT r5 AND NOT r0;
//       r5.D = r4 AND NOT r5 AND NOT r0 AND NOT r1;
//       r0.D = r5 AND NOT r0 AND NOT r1 AND NOT r2 OR (NOT r0 AND
//              NOT r1 AND NOT r2 AND NOT r3 AND NOT r4 AND NOT r5)
//              (2 птерма; второй - рестарт из 00, NOR6; вырожденный
//              случай r0=1: оба птерма 0 - hold);
//       Init: r0=SET, r1..r5=RESET (все - clk 50 МГц, GCK3);
//       clk25_q.D = NOT clk25_q  (T-триггер /2, clk 50 МГц,
//              Init=RESET) - такт ЛОГИКИ 25 МГц;
//       X1 = r0  (1 ПТ; регистр r0 МОЖЕТ лечь в IO-MC пина P68);
//       X2 = r1 OR r2 OR r3 OR r4 OR r5  (5 ПТ, БЕЗ инверсии
//              регистра - в легальном one-hot = NOT r0 = ~X1 ТОЧНО;
//              класс п.10/прецедент v3.4: если фиттер поднял X2 в
//              регистр В ФАЗЕ r0 - БРАК, CPU не заведётся);
//       por_ce = r0  (1 ПТ, 50-домен);
//       por_sh 8 бит (сдвиг вправо, 0 в MSB, Init=FF, clk 50 МГц),
//       por_run.D = por_sh[0] (Init=SET, clk 50 МГц);
//       rst_meta/rst_sync/rst_qcnt<2:0>/rst_press/reset_q/sod_q/
//       tx_pass/tx_q/state_FSM_FFd1..3 - clock = clk25 (НЕ clk!);
//       reset_q = FDCPE(clk25,'0','0') БЕЗ PRE (Init=RESET);
//       state = 3 триггера (без FFd4); v3.7: txm_cnt НЕТ - вместо
//       него sod_q/tx_pass/tx_q (3 FF, декодов НЕТ; tx_q и sod_q
//       должны лечь в IO-MC пинов TX P39 и SOD P72, tx_pass - лог.
//       MC); cnt/x1_p/x2_p/t0_q/x1_q/x2_q/x1_n/wb_ram_q/r6 В
//       НЕТЛИСТЕ БЫТЬ НЕ ДОЛЖНО (legacy-ветки элайзятся, защёлка -
//       v3.9.1; r6 удалён при N=6);
//       CS_n - уравнение от state_FSM_FFd1..3/A15/IOM БЕЗ литерала
//       wb_ram_q.
//     ГЛАВНАЯ ТОЧКА АУДИТА: сеть clk25 - на ГЛОБАЛЬНОЙ тактовой
//     (прецедент: complement of clk -> GCK2, фит v3.9.5); если
//     фиттер повесил clk25 на обычную трассировку - проверить
//     skew/setup в отчете о временах.
//     История узла/прогнозы по версиям: v3.9.1: МЦ 87, узел 8
//     триггеров (кольцо+x1_n), por_ce = r1|r6, por_sh 8 бит;
//     v3.9.2: МЦ ~84-85 (узел 4: cnt<2:0>+x1_n, кольцо удалено),
//     ПТ ~225-250; v3.9.3: GSR - D-функции логики БЕЗ литералов
//     сброса, вх.ФБ ~168-172, ПТ ~190-205; v3.9.4 (М1): por_sh
//     4 бита (Init=F, F->7->3->1->0), строб por_ce = x1_n
//     (ДЕКОДОВ В POR-ЦЕПИ НЕТ), МЦ 79-81, ПТ ~170-180, триггеры
//     50; v3.9.5: источник GSR = cpu_rst = RST|por_run; v3.9.6:
//     хардренинг RST (+rst_meta/rst_sync/rst_press/rst_qcnt<2:0>/
//     reset_q; рег 57, МЦ 85-87, ПТ 220-230, вх.ФБ 165-172; RST -
//     только во входах ФБ rst_meta); v3.9.7: узел 4 -> 8 триггеров
//     (r0..r6+x1_n вместо cnt<2:0>+x1_n), прогноз МЦ ~88-90, ПТ
//     ~215-230 (ядра X1/X2 4 -> 2 ПТ, kill-литералы кольца),
//     вх.ФБ ~165-175; логика шины/сброса бит-в-бит v3.9.6;
//     v3.9.8: вход 50 МГц (H1 без шунта), кольцо на clk 50, узел
//     8 триггеров (r0..r6 + clk25_q), por_sh 8 бит на clk 50
//     (строб r0), x1_n удалён, X2 - 6-ПТ OR; прогноз МЦ ~92-94,
//     ПТ ~225-240, вх.ФБ ~170-180; логика шины/сброса бит-в-бит
//     v3.9.7 (такт clk -> clk25);
//     v3.9.9h: кольцо 7 -> 6 (r0..r5, -r6), узел 7 триггеров
//     (r0..r5 + clk25_q), X2 - 5-ПТ OR, рестарт NOR6; прогноз МЦ 93,
//     ПТ ~222-238, вх.ФБ ~178-183; логика шины/сброса бит-в-бит
//     v3.9.8.
//=====================================================================
// История (как в v1/top_nouart, логика чтения не менялась):
// Топология: AD0-AD7 процессора, A0-A7 flash/SRAM и CPLD - ОДНА медь
// (сети A0..A7). CPLD = регистровый трансивер:
//   чтение: память видит адрес в T1 (ALE=1) -> данные на D0-D7
//   захватываются в последний тик T1 -> в T2 (CPU отпустил AD) CPLD
//   выдаёт данные на A-сети;
//   запись: в T2 CPU гонит данные по A-сетям (CPLD Hi-Z), CPLD захватывает;
//   после WR#(вверх) - «отложенная запись» (writeback): CPLD сам ставит
//   защёлкнутый адрес на A-сети + данные на D-сети и даёт импульс
//   /WE_RAM (в v3: импульс защищён от ALE, см. п.4 шапки).
// Метод захвата - повторное сэмплирование, пока строб активен (последний
// сэмпл гарантированно валиден); без edge-детекторов и PT-клоков;
// v3.9.8 - два домена: узел тактирования 50 МГц (кольцо/clk25_q/
// por-цепь на GCK3) и логика 25 МГц (clk25 = /2-триггер), вся
// тиковая семантика логики - 25 МГц как в v3.9.2-3.9.7 (п.23).
// Сброс: SW20 -> RST (нажатие = 1, Task 25) + POR (v3.4: сдвиговый;
// 1120 нс @ 7,14 МГц в v3.9) -> RESET_IN=0;
// v3.9.3: сброс ЛОГИКИ - асинхронный по RST через СЕТЬ GSR (п.18);
// cpu_rst остался только для tx_pass/tx_q (PT-SR, защита окна POR)
// и RESET_IN; v3.9.6: сырой RST - только в синхронизатор, cpu_rst =
// rst_press|por_run (регистры), RESET_IN - регистр reset_q (п.21).
// RAM подтверждена на железе (Task 69-j: 4 паттерна x 32K без ошибок,
// T=1280 нс; режим T=400 нс - этот файл; tb v3: T3b/T3d/T3e PUSH-stress).
//=====================================================================

module retro_pcld_top #(parameter POR_W = 6,    // v3.4: НЕ используется (POR - сдвиговый 8 бит, п.9 шапки); оставлен для совместимости тестбенча
                        parameter CLK_DIV = 2,  // v3.9.9h: (2,1) = КОЛЬЦО one-hot N=6 -> X1 8,333 МГц (CPU 4,167, п.24; история: v3.9.2 = двоичный mod-7, п.17); 4 -> 6,25 (v3.4); 2+HALF=0 -> 12,5 ВНЕ ТУ; 5 = XOR-пара legacy (п.9)
                        parameter CLK_HALF = 1) ( // v3.6: 1 = ветка g_div2p5 (учитывается ТОЛЬКО при CLK_DIV=2; v3.9.2: счётчик mod-7, п.17); 0 = старые целочисленные ветки; v3.7: параметр TXM_W УДАЛЕН вместе с TX-маской (п.13)
    // ---- такт и глобальный сброс ----
    input  wire       clk,          // 50 МГц (v3.9.8: перемычка H1 БЕЗ шунта - DIV=/2 генератора U7; штатное /4 давало 25,00 - замер Task 29-d), U1.29 (P29, GCK3)
    input  wire       RST,          // SW20, U1.1 (P1, GSR): покой = 0, нажатие = 1 (актив.1 - доказано платой, Task 25); v3.9.6: пин входит ТОЛЬКО в синхронизатор rst_meta (п.21), GSR-ресурс ноги не задействован
    // ---- шина i8085 (входы автомата) ----
    input  wire       ALE,          // cpu1 U1.93 (P93), нога 30
    input  wire       WRn,          // cpu2 U1.92 (P92), нога 31 (активный 0)
    input  wire       RDn,          // cpu3 U1.91 (P91), нога 32 (активный 0)
    input  wire       IOM,          // cpu5 U1.88 (P88), нога 34: 1=IO, 0=память
    input  wire       A15,          // U1.97 (P97) - декод памяти
    // ---- мультиплексированная шина AD0-AD7 = сети A0..A7 (bidir) ----
    inout  wire [7:0] A,            // A0=P26 A1=P21 A2=P19 A3=P17 A4=P15 A5=P13 A6=P11 A7=P9
    // ---- шина данных памяти (bidir) ----
    inout  wire [7:0] D,            // D0=P30 D1=P32 D2=P35 D3=P36 D4=P34 D5=P31 D6=P27 D7=P22
    // ---- управление памятью (активный 0) ----
    output wire       CSr_n,        // P20 /CE_ROM -> U10.22 (flash /CE)
    output wire       OEr_n,        // P16 /OE_ROM -> U10.24
    output wire       CS_n,         // P25 /CE_RAM -> U4.22  (RAM /CE)
    output wire       OE_n,         // P37 /OE_RAM -> U4.24
    output wire       WE_n,         // P24 /WE_RAM -> U4.29 (только writeback!)
    output wire       CS1,          // P99 CS(CE2) -> U4.30, константа '1'
    // ---- поддержка процессора ----
    output wire       X1,           // P68 cpu21, нога 1: 8,33 МГц (r0, duty 1/6: high 20 / low 100 нс, период ровно 120 нс) -> CPU 4,17 МГц (v3.9.9h, внутренний /2 ВМ85А)
    output wire       READY,        // P87 cpu6, нога 35: константа '1' (без wait)
    output wire       RESET_IN,     // P84 cpu7, нога 36: активный 0 = сброс CPU; v3.9.6: регистр reset_q (п.21)
    // ---- soft-UART транзиты (Task 70-a) ----
    output wire       SID,          // P73 cpu17, нога 5 (CPU.SID): транзит RX -> приём (RIM 20h)
    output wire       TX,           // P39: цепь платы «RX» -> CH340G.RXD; TX = tx_q - регистровый транзит SOD с захватом (v3.7, SIM 30h)
    // ---- индикация и звук (выходы активным 0, §6) ----
    output wire [7:0] seg,          // {dp56,g,f,e,d,c,b,a} = P60/5/66/58/57/61/62/45
    output wire [3:0] dig,          // dig0..3 = P6/63/65/48 -> R -> VT1..VT4
    output wire       SND,          // P67 -> BUZZER1.1 (пассивный, прямой бит; A4 порта 01h)
    // ---- наблюдатели: «мёртвые» пины как Hi-Z входы (* keep *) ----
    // (* keep *) обязателен для ног БЕЗ нагрузки: без него XST выкидывает
    // входы (Xst:3005), а выкиннутый пин опция "Ground on Unused IOs"
    // ЗАЗЕМЛИТ - там выходы CPU и X2 (GND запрещён даташитом). ЭТО И ЕСТЬ
    // «ОШИБКА С НОГАМИ» ИЗ ФИТА владельца (Task 68-f).
    // SOD (P72) и RX (P38) теперь ИСПОЛЬЗУЮТСЯ (транзиты) - keep им больше
    // не нужен, но входами остаются.
    (* keep = "TRUE" *) output wire X2,  // P69 cpu20, нога 2: противофаза X1 (v3.9.9h: r1|r2|r3|r4|r5 = ~r0 в легальном one-hot, БЕЗ инверсии регистра - п.10/24); keep - сеть отдельно (страховка, п.9)
    (* keep = "TRUE" *) input wire RSTOUT,    // P70 cpu19, нога 3
    input  wire       SOD,          // P72 cpu18, нога 4 (CPU.SOD) - теперь транзит в TX
    (* keep = "TRUE" *) input wire INTAn,     // P80 cpu11, нога 11
    (* keep = "TRUE" *) input wire HLDA,      // P82 cpu9,  нога 38
    (* keep = "TRUE" *) input wire CLKOUT,    // P83 cpu8,  нога 37
    (* keep = "TRUE" *) input wire S0,        // P94 cpu0,  нога 29
    (* keep = "TRUE" *) input wire S1,        // P89 cpu4,  нога 33
    (* keep = "TRUE" *) input wire AH8,       // P10 цепь A8,  нога 21 - адрес памяти
    (* keep = "TRUE" *) input wire AH9,       // P12 цепь A9,  нога 22
    (* keep = "TRUE" *) input wire AH10,      // P18 цепь A10, нога 23
    (* keep = "TRUE" *) input wire AH11,      // P14 цепь A11, нога 24
    (* keep = "TRUE" *) input wire AH12,      // P4  цепь A12, нога 25
    (* keep = "TRUE" *) input wire AH13,      // P8  цепь A13, нога 26
    (* keep = "TRUE" *) input wire AH14,      // P3  цепь A14, нога 27
    input  wire       RX,           // P38 цепь платы «TX» (CH340G.TXD) - теперь транзит в SID; заземлять НЕЛЬЗЯ (выход CH340G)
    // ---- клавиатура (Task 34) ----
    output wire       col0,         // P44 SW1/SW5/SW9/SW13/SW17 (KBCOL.0)
    output wire       col1,         // P43 SW2/SW6/SW10/SW14/SW18 (KBCOL.1)
    output wire       col2,         // P42 SW3/SW7/SW11/SW15/SW19 (KBCOL.2)
    output wire       col3,         // P41 SW4/SW8/SW12/SW16 (KBCOL.3; SW20 вне матрицы)
    input  wire       row0,         // P56 R25 подтяжка, SW1
    input  wire       row1,         // P55 R24, SW5
    input  wire       row2,         // P54 R23, SW9
    input  wire       row3,         // P52 R22, SW13
    input  wire       row4          // P51 R21, SW17
);

  //=============================================================
  // Узел тактирования v3.9.9h (линия hiclock, п.24 шапки; база v3.9.8
  // = п.23, схема владельца 11-6bis-2): вход 50 МГц (H1 БЕЗ шунта -
  // DIV=/2 U7), кольцо r0..r5 (N=6) на clk 50 МГц (период 120 нс);
  // X1 = r0 (фронт строго каждые 120 нс = 8,333 МГц, duty 1/6),
  // X2 = r1|..|r5 = ~r0, внутренний /2 ВМ85А -> CPU 4,167 МГц duty
  // 50% (единственная переменная против v3.9.8 - длина кольца);
  // x1_n УДАЛЁН (вторая кромка даётся самим clk 50). ЛОГИКА - на
  // clk25 = /2-триггер clk25_q
  // (25 МГц: /WE 80 нс, квалификатор 320 нс, все тиковые константы
  // живы; XC95108-15 FSM на 50 МГц не закроет). por-цепь - в
  // 50-домене (por_sh 8 бит, строб r0; сэмпл стробов тактом clk25 -
  // фазовая лотерея). Legacy-ветки (div2/div4/чёт/нечёт) сохранены
  // для отката - при (2,1) элайзятся, в них clk25 = прямой clk.
  // ВНИМАНИЕ: старый HDLCompiler (ISE) НЕ принимает localparam и
  // reg-инициализаторы ВНУТРИ generate-блока -> выносим на scope модуля.
  //=============================================================
  reg [2:0] cnt = 3'd0;   // ТОЛЬКО legacy-ветки (N>=6, нечётные - элайзятся;
                          // целевая g_div2p5 с v3.9.7 - КОЛЬЦО r0..r5, п.22/24).
                          // Сужение [3:0]->[2:0] по рецепту v3.10: старшие
                          // биты - балласт МЦ; 3 бит хватает всем legacy
                          // N<=14 (MEV<=7)
  wire por_ce;

  // Константы делителя (на уровне модуля, не в generate!) - нужны
  // только fallback-ветке (чётные N>=6) и нечётной ветке
  localparam [3:0] MEV   = CLK_DIV / 2 - 1;   // для чётного N
  localparam [3:0] NMOD  = CLK_DIV - 1;       // для нечётного N
  localparam [3:0] NHALF = (CLK_DIV + 1) / 2; // =3 при /5 (НЕ 2!)

  // Триггеры делителя (reg) тоже на уровне модуля (инициализаторы
  // в generate тоже проблемные для этого XST). Неиспользуемые ветки XST вырезает.
  reg  x1_q = 1'b1;  // чётные 2/4 (откат): INIT=1, X1 стартует с '1'
  reg  t0_q = 1'b0;  // каскад полу-такта для CLK_DIV=4 (t0_q = clk/2)
  reg  x1_p = 1'b1;  // нечётная legacy-ветка (при (2,1) элайзится)
  // v3.9.8: clk25 - /2-триггер для ЛОГИКИ (rst/TX/FSM/порты): XC95108-15
  // FSM/шина на 50 МГц не закрывает, а все тиковые константы (/WE 80 нс,
  // квалификатор 320 нс) обязаны остаться - логика живёт на 25 МГц,
  // узел тактирования (кольцо/por-цепь) - на 50. INIT=0 - фаза
  // фиксирована (первый posedge clk25 - второй posedge clk пина).
  reg  clk25_q = 1'b0;  // /2: такт ЛОГИКИ 25 МГц из clk 50 МГц (ЦЕЛЕВАЯ g_div2p5)
  wire clk25;           // такт логики (в legacy-ветках - прямой clk)
  // v3.9.8 (фикс fit-ошибки HDLCompilers:28): x1_n в ЦЕЛЕВОЙ g_div2p5
  // УДАЛЁН (п.23), НО декларация обязательна: XST компилирует ВСЕ ветки
  // generate, а legacy g_div_odd (XOR-пара v3) на неё ссылается (x1_n <=
  // ~x1_n, X1 = x1_p ^ x1_n, X2 = x2_p ^ x1_n). В нетлисте целевой
  // конфигурации (2,1) x1_n БЫТЬ НЕ ДОЛЖНО (ветка элайзится).
  reg  x1_n = 1'b0;  // ТОЛЬКО legacy g_div_odd (элайзится; в целевой ветке не используется)
  reg  x2_q = 1'b0;  // v3.5: противофаза X2, чётные ветки (INIT=0 при x1_q=1)
  reg  x2_p = 1'b0;  // v3.5: двойник x1_p с инверсным INIT (нечётная legacy-ветка)
  // v3.9.9h (линия hiclock, п.24 шапки; ЦЕЛЕВАЯ g_div2p5, база v3.9.8):
  // состояние узла = one-hot КОЛЬЦО r0..r5 (N=6), тактируемое clk 50
  // МГц (период 120 нс). Самоочистка двойным kill: ЛЮБОЕ из 64 кодов
  // -> one-hot за <= 2 фронта (sim_v399h_ring6.py: полный перебор 64
  // кодов x 8 por_sh x 2 фазы = 1024 комбинаций; аргумент п.15 на N=6
  // не переносился - доказан заново перебором; кольцо сокращено). Строб
  // por_ce = r0 (50-домен). X1 = r0, X2 = сумма r1..r5.
  reg  r0 = 1'b1;    // состояние 0 (X1 = r0; рестарт из 00)
  reg  r1 = 1'b0;    // состояние 1 (вход X2)
  reg  r2 = 1'b0;    // состояние 2 (вход X2)
  reg  r3 = 1'b0;    // состояние 3 (вход X2)
  reg  r4 = 1'b0;    // состояние 4 (вход X2)
  reg  r5 = 1'b0;    // состояние 5 (вход X2)

  // v3.5: X2 - РЕГИСТР противофазы (п.10 шапки, clk10-41): каждая ветка
  // generate даёт СВОЙ драйвер X2 (в целевой ветке v3.9.8 - комбина-
  // ционный OR колец r1..r5 = ~r0 в легальном one-hot; регистров на
  // пине НЕТ). Прецедент v3.4: комб. ~X1 фиттер поднимал в регистр
  // В ФАЗЕ - поэтому X2 построен БЕЗ одиночной инверсии регистра:
  // 6-ПТ OR нечувствителен к классу п.10. keep на порте X2 удерживает
  // сеть отдельной (страховка).

  generate
    if (CLK_DIV == 2 && CLK_HALF == 1) begin : g_div2p5
      // v3.9.9h ЦЕЛЕВАЯ ветка (линия hiclock, п.24 шапки; база v3.9.8):
      // кольцо r0..r5 (N=6, ЕДИНСТВЕННАЯ переменная против v3.9.8) на
      // clk 50 МГц - период 120 нс; X1 = r0 напрямую (x1_n удалён:
      // вторую кромку даёт сам clk 50), X2 = OR(r1..r5) = ~r0 в
      // легальном one-hot, clk25 = /2 для ЛОГИКИ, por-цепь - в
      // 50-домене со стробом r0:
      //   r0..r5: one-hot по posedge с ДВОЙНЫМ kill
      //     r_i <= r_{i-1} & ~r_i & ~r_{i+1} & ~r_{i+2} (wrap mod 6);
      //     рестарт из 00 по NOR6 в r0. ЛЮБОЕ из 64 состояний ->
      //     one-hot за <= 2 фронта (п.15/24; v3.9.9h: полный перебор
      //     64 x 8 x 2 = 1024 комбинаций, sim_v399h_ring6.py);
      //     INIT r0=1, r1..r5=0 - состояние 0;
      //   X1 = r0: фронт строго каждые 120 нс (8,333 МГц), duty 1/6
      //     (high 20 / low 100 нс); внутренний /2 ВМ85А тактируется
      //     ФРОНТАМИ X1 -> CLK = 4,167 МГц, период 240 нс, duty
      //     РОВНО 50% (в ТУ ВМ85А до 5; экземпляр владельца 5,0 не
      //     тянул - п.15; 4,167 = 83% предела);
      //     ЕСЛИ генерация CPU не заведётся на 20-нс high (как в
      //     v3.9.8, железом подтверждено) - откат одной строкой:
      //     X1 = r0 | r1 (high 40 нс), частоты те же;
      //   X2 = r1|r2|r3|r4|r5 = ~r0 в каждом легальном one-hot -
      //     5-ПТ OR БЕЗ инверсии регистра (класс п.10/прецедент
      //     v3.4: фиттер поднимал ~X1 в регистр В ФАЗЕ); в
      //     illegal-кодах на самоочистке (<= 2 фронта при включении)
      //     X2 отличается от ~X1 - транзиент во время POR, схемно
      //     незначимо;
      //   clk25_q (INIT=0): T-триггер от clk 50 -> clk25 = 25 МГц -
      //     такт ВСЕЙ ЛОГИКИ (rst/TX/FSM/порты): тиковые константы
      //     (/WE 80 нс, квалификатор 320 нс) живут бит-в-бит
      //     v3.9.7; фаза фиксирована INIT.
      // por_ce = r0 (50-домен): РОВНО ОДИН строб 20 нс за период
      //   кольца 120 нс (r1|r5 на кольце 50 давало бы 2 строба за
      //   период - POR уполовинился бы).
      //   por-цепь НЕ МОЖЕТ жить на clk25: сэмпл 20-нс стробов
      //   кольца тактом clk25 - фазовая лотерея (при нечётной фазе
      //   clk25 вечно сэмплирует r0/r2/r4 - стробы НЕ ВИДНЫ ВОВСЕ,
      //   POR не кончается НИКОГДА); в 50-домене строб - синхронное
      //   включение того же такта - детерминировано.
      //   por_sh[7:0]: 8 x 120 = 960 нс (норма 3 такта CLK = 720 нс
      //   при CPU 4,167), запас 1,33x - ТОТ ЖЕ, что v3.9.8
      //   (масштабируется с N); штатный старт: стробы
      //   20/140/.../860, снятие por_run на кромке 880 нс (модель
      //   power-on: <= 980 нс из любого начального кода).
      always @(posedge clk) begin
        // сдвиг + двойной kill + рестарт из 00 (кольцо п.15/22/24, N=6)
        r0 <= (r5 & ~r0 & ~r1 & ~r2) | (~r0 & ~r1 & ~r2 & ~r3 & ~r4 & ~r5);
        r1 <= r0 & ~r1 & ~r2 & ~r3;
        r2 <= r1 & ~r2 & ~r3 & ~r4;
        r3 <= r2 & ~r3 & ~r4 & ~r5;
        r4 <= r3 & ~r4 & ~r5 & ~r0;
        r5 <= r4 & ~r5 & ~r0 & ~r1;
      end
      always @(posedge clk)
        clk25_q <= ~clk25_q;   // /2: такт ЛОГИКИ 25 МГц (INIT=0 - фаза фиксирована)
      assign clk25 = clk25_q;
      assign X1 = r0;   // 8,333 МГц, период ровно 120 нс, duty 1/6 (20/100)
      assign X2 = r1 | r2 | r3 | r4 | r5;  // = ~r0 в легальном one-hot,
                        // БЕЗ инверсии регистра (класс п.10/прецедент v3.4)
      assign por_ce = r0;  // v3.9.9h: 1 строб 20 нс за период кольца 120 нс -
                           // ровно ОДИН posedge за период по построению
                           // (r1|r5 на кольце 50 давало бы 2 строба за период)
    end else if (CLK_DIV == 2) begin : g_div2
      assign clk25 = clk;   // legacy: логика на прямом clk (ветка элайзится при (2,1))
      // ЦЕЛЕВАЯ ветка /2: x1_q тогглит КАЖДЫЙ клок - вентиль = константа,
      // декодов нет вовсе
      always @(posedge clk)
        x1_q <= ~x1_q;
      always @(posedge clk)
        x2_q <= x1_q;          // v3.5: задержка 1 клок = ПОЛПЕРИОДА (период 2),
                               // D=x1_q != D(x1_q)=~x1_q; init (1,0) -> x2=~x1
      assign X1 = x1_q;        // 12,5 МГц, duty 50%
      assign X2 = x2_q;        // v3.5: регистровая противофаза
      assign por_ce = ~x1_q;   // 1 такт из 2 = 1 раз за период X1
    end else if (CLK_DIV == 4) begin : g_div4
      assign clk25 = clk;   // legacy: логика на прямом clk (ветка элайзится при (2,1))
      // ЦЕЛЕВАЯ ветка /4 (v3.4): каскад t0_q -> x1_q; x1_q тогглит при
      // t0_q=1 (каждые 2 клока). Вентиля - литералы t0_q/x1_q, декодов НЕТ
      always @(posedge clk)
        t0_q <= ~t0_q;              // clk/2
      always @(posedge clk)
        if (t0_q) x1_q <= ~x1_q;    // clk/4, duty 50%
      always @(posedge clk)
        x2_q <= ~(x1_q ^ t0_q);     // v3.5: x2_q(t+1) = ~x1_q(t+1) - точная
                                    // противофаза с 0-го такта; D=XNOR != D(x1_q)=XOR
      assign X1 = x1_q;             // 6,25 МГц
      assign X2 = x2_q;             // v3.5: регистровая противофаза
      assign por_ce = ~t0_q & ~x1_q; // 1 такт из 4 = 1 раз за период X1
    end else if (CLK_DIV % 2 == 0) begin : g_div_even
      assign clk25 = clk;   // legacy: логика на прямом clk (ветка элайзится при (2,1))
      // FALLBACK чётных N>=6: старый счётчик mod-N/2 (СОДЕРЖИТ декоды -
      // только для отката; целевые режимы 2/4 - выше)
      always @(posedge clk)
        cnt <= (cnt == MEV) ? 4'd0 : cnt + 4'd1;
      always @(posedge clk)
        if (cnt == MEV) x1_q <= ~x1_q;
      always @(posedge clk)
        if (cnt == MEV) x2_q <= ~x2_q;  // v3.5: toggle СИНХРОННО с x1_q,
                                        // init (1,0) -> комплементарны всегда
      assign X1 = x1_q;                        // duty 50% (период CLK_DIV тактов)
      assign X2 = x2_q;                        // v3.5: регистровая противофаза
      assign por_ce = (cnt == 4'd0) && !x1_q;  // 1 раз за период X1
    end else begin : g_div_odd
      assign clk25 = clk;   // legacy: логика на прямом clk (ветка элайзится при (2,1))
      // нечётное деление (ветка v3): XOR-пара - НЕ ТРОНУТА (clk10-35)
      always @(posedge clk)
        cnt <= (cnt == NMOD) ? 4'd0 : cnt + 4'd1;
      always @(posedge clk)
        if (cnt == 4'd0) x1_p <= ~x1_p;    // переворот каждые CLK_DIV тактов
      always @(negedge clk)
        if (cnt == NHALF) x1_n <= ~x1_n;   // сдвиг полпериода -> duty 50%
      always @(posedge clk)
        if (cnt == 4'd0) x2_p <= ~x2_p;    // v3.5: двойник x1_p (INIT 0 vs 1)
      assign X1 = x1_p ^ x1_n;             // duty РОВНО 50% (100/100 нс)
      assign X2 = x2_p ^ x1_n;             // v3.5: = ~x1_p ^ x1_n = ~X1 ТОЧНО,
                                           // без сдвига duty (не задержка на клок)
      assign por_ce = (cnt == 4'd0);       // 1 раз за период X1
    end
  endgenerate
  
  //=============================================================
  // POR (v3.9.8, п.23: М1 ред. - 8-битный СДВИГОВЫЙ регистр por_sh
  // в 50-домене): 0 в MSB сдвигается вправо, bit0 очищается
  // ПОСЛЕДНИМ -> por_run снимается ровно через 8 тиков por_ce.
  // ДЕКОДОВ НЕТ (ни ==0, ни !=0, НИ В СТРОБЕ): фиттер дважды печатал
  // por-декоды с потерянной инверсией (фит 7:31: por_cnt(0): T=NOT en
  // -> POR=1 клок; фит 8:55: por_run.D=(por_cnt==0)) - класс
  // конструкций убран; строб r0 декодов не содержит вовсе.
  // ПОЧЕМУ 50-ДОМЕН: сэмпл 20-нс стробов кольца тактом clk25 -
  // фазовая лотерея (при нечётной фазе clk25 стробы НЕ ВИДНЫ ВОВСЕ -
  // por_run не снимается НИКОГДА); в 50-домене строб - синхронное
  // включение того же такта - детерминировано при любой фазе.
  // INIT=FF/1 -> RESET_IN=0 до всякого клока (счёт только при живом
  // clk через por_ce из делителя); por_run остаётся РЕГИСТРОМ (v3.2,
  // п.8 шапки - защита от схлопывания PT / Placement Failed).
  // Длительность: POR = 8 x 120 нс = 960 нс (строб r0 - 1 раз за
  // период кольца 120 нс, п.24); норма 3 такта
  // CLK OUT = 720 нс @ 4,17 МГц (запас 1,33x - тот же, что в
  // v3.9.2-3.9.8, масштабируется с N); фактический низ RESET_IN
  // от INIT ~900 нс (дрейн 880 нс + кромка clk25 40 нс; модель
  // power-on: снятие por_run <= 980 нс из любого начального кода).
  // Повторный POR невозможен: после 00 сдвиг держит нули навсегда.
  //=============================================================
  reg [7:0] por_sh = 8'hFF;      // v3.9.8 (п.23): сдвиг вправо, clk 50 МГц:
                                 // FF -> 7F -> 3F -> ... -> 01 -> 00 (8 стробов)
  reg  por_run = 1'b1;           // FF-копия для cpu_rst (v3.2; INIT=SET)
  always @(posedge clk) begin
    por_run <= por_sh[0];        // снятие, когда '0' дойдёт до bit0 (8-й тик)
    if (por_ce) por_sh <= {1'b0, por_sh[7:1]};
  end

  //=============================================================
  // v3.9.6 (п.21): ХАРДРЕНИНГ ЦЕПИ СБРОСА. Сырой пин RST входит в
  // кристалл ТОЛЬКО через 2FF-синхронизатор + квалификатор; решения
  // о сбросе принимают ТОЛЬКО регистры: мид-рейл/дребезг/помеха на
  // SW20 физически не доходят ни до 40 сбросовых входов триггеров,
  // ни до ноги RESET_IN (в v3.9.5 RST шёл НАПРЯМУЮ в гейт RESET_IN
  // и в PTC-сбросы NOT RESET_IN - fallback фита 11-5).
  //   rst_meta/rst_sync - синхронизатор (вне сброса, INIT=0);
  //   rst_qcnt/rst_press - квалификатор: переворот rst_press на 8-м
  //     такте ПОДРЯД устойчивого rst_sync != rst_press (двусторонний:
  //     и взвод, и снятие квалифицированы); дребезг короче 280 нс не
  //     виден вовсе, длиннее - полноценный повторный сброс (каждый
  //     взвод заново чистит все 40 триггеров - ПОСЛЕДНЕЕ снятие
  //     всегда из held-чистого состояния, регистровым фронтом);
  //   cpu_rst = rst_press | por_run - ТОЛЬКО регистровые источники;
  //   reset_q - РЕГИСТР выхода RESET_IN (INIT=0: CPU в сбросе с t=0
  //     до всякого клока; снятие - чистым фронтом, как по питанию).
  // Латентность кнопки: 11 тиков счёта (2FF + 8 такт квалификатора +
  // reset_q) = 400..440 нс от пина на взвод и снятие (кнопка живёт в
  // миллисекундах). POR НЕ ТРОНУТ: por_sh/
  // por_run бит-в-бит v3.9.4, низ RESET_IN по питанию до 1160 нс
  // (норма 840 нс, запас x1,35).
  //=============================================================
  reg  rst_meta  = 1'b0;         // ловец метастабильности (вне сброса, INIT=0)
  reg  rst_sync  = 1'b0;         // синхронизованный RST (вне сброса, INIT=0)
  reg  rst_press = 1'b0;         // квалифицированный сброс кнопки (INIT=0)
  reg [2:0] rst_qcnt = 3'b000;   // счётчик квалификации 0..7 (INIT=0)
  wire cpu_rst = rst_press | por_run; // v3.9.6: сброс ТОЛЬКО от регистров
  reg  reset_q = 1'b0;           // РЕГИСТР RESET_IN (INIT=0 - CPU держится с t=0)
  always @(posedge clk25) begin   // v3.9.8: логика на clk25 (п.23)
    rst_meta <= RST;
    rst_sync <= rst_meta;
  end
  always @(posedge clk25) begin   // v3.9.8: логика на clk25 (п.23)
    if (rst_sync != rst_press) begin
      if (&rst_qcnt) begin
        rst_press <= rst_sync;   // 8-й такт подряд - переворот состояния
        rst_qcnt  <= 3'b000;
      end else
        rst_qcnt  <= rst_qcnt + 3'b001;
    end else
      rst_qcnt  <= 3'b000;       // линия вернулась к состоянию - счёт с нуля
  end
  always @(posedge clk25)       // v3.9.8: логика на clk25 (п.23)
    reset_q <= ~cpu_rst;         // снятие сброса CPU - всегда чистым фронтом

  //=============================================================
  // TX-транзит с ЗАХВАТОМ (v3.7, clk10-51; п.3/13 шапки) - замена
  // TX-маски v2-v3.6: txm_cnt (8 FF, ~9 МЦ) и параметр TXM_W УДАЛЕНЫ,
  // окно больше НЕ таймерное. Факт датасшита IM1821ВМ85А (вывод SR):
  // аппаратный сброс очищает триггер TFD (SOD) в '0' -> после снятия
  // RESET_IN линия SOD='0' до первого SIM прошивки с SDE=1 (fw_mon v5:
  // TXIDLE, ~4-20 мкс при CPU 5 МГц). Голый транзит SOD->TX дал бы
  // «фиктивный start-bit» - пустой фрейм в терминале. Вместо таймера -
  // схемный захват ПО УРОВНЮ (частота и длина init прошивки не важны):
  //   sod_q   - синхронизация входа SOD по clk 25 МГц (XST положит в
  //             IO-MC входа P72; метастабильность гасится ДО использо-
  //             вания, статический путь пин SOD -> пин TX разорван);
  //   tx_pass - «линия захвачена прошивкой»: async clear по cpu_rst
  //             (v3.9.3: СОЗНАТЕЛЬНО НЕ переведён на GSR - cpu_rst
  //             держит tx_pass=0 ВЕСЬ POR, враждебный SOD в окне POR
  //             не «захватывает» линию; см. п.18);
  //             взводится первым сэмплом SOD='1' после сброса;
  //   tx_q    - выходной регистр TX (IO-MC пина P39, INIT=1, async set
  //             по cpu_rst): в сбросе TX='1' мгновенно и БЕЗ клока;
  //             после захвата - транзит sod_q с латентностью <= 2 такта
  //             25 МГц (80 нс = 0,4 такта CLK 200 нс = 0,08% бита 9600).
  // Полный цикл: POR/кнопка -> TX='1'; CPU вне сброса, SOD='0'
  // (сброшен SR-ом) -> TX='1' ДЕРЖИТСЯ сам (ноль не пропускается);
  // TXIDLE прошивки (SOD 0->1) -> захват, дальше бит-в-бит транзит.
  // Теория (см. п.13): ложный SOD='1' в окне открыл бы захват раньше -
  // физически невероятен (вход CPU в сбросе статичен); лечение -
  // захват по 2 сэмплам подряд (+1 FF).
  //=============================================================
  reg sod_q   = 1'b0;            // синхронизатор входа SOD (без сброса)
  reg tx_pass = 1'b0;            // «линия захвачена прошивкой» (INIT=0)
  reg tx_q    = 1'b1;            // выходной регистр TX (IO-MC; INIT=1)
  always @(posedge clk25)                        // v3.9.8: логика на clk25 (п.23)
    sod_q <= SOD;                                  // свободный ход, без сброса
  always @(posedge clk25 or posedge cpu_rst)     // v3.9.8: логика на clk25 (п.23)
    if (cpu_rst)    tx_pass <= 1'b0;
    else if (sod_q) tx_pass <= 1'b1;               // первый SOD='1' от прошивки
  always @(posedge clk25 or posedge cpu_rst)     // v3.9.8: логика на clk25 (п.23)
    if (cpu_rst) tx_q <= 1'b1;
    else         tx_q <= tx_pass ? sod_q : 1'b1;   // до захвата - чистый idle

  //=============================================================
  // Автомат шины: 7 состояний = 3 триггера (v3; в v1 было 10/4 триггера -
  // WBW/WBS/WBS2 удалены: hold-off 0, см. п.4 шапки; WB1..WB4 ЗАЩИЩЕНЫ
  // от ALE)
  //=============================================================
  localparam S_IDLE = 3'd0,   // ожидание ALE; A/D в Hi-Z; /OE включён (декод)
             S_T1H  = 3'd1,   // T1: CPU держит адрес на A-сетях; идёт захват
             S_T2   = 3'd2,   // строб: чтение - выдача данных на A; запись - захват
             S_WB1  = 3'd3,   // WB: адрес на A + данные на D (t_AS 40 нс до /WE)
             S_WB2  = 3'd4,   // /WE=0 - импульс НАЧАЛСЯ: защищён от ALE
             S_WB3  = 3'd5,   // /WE=0 (импульс = 2 тика = 80 нс >= t_WP ОЗУ)
             S_WB4  = 3'd6;   // /WE=1: удержание адреса/данных (t_AH/t_DH памяти)

  // Task 46: прагма против ONE-HOT перекодировки автомата XST
  // (контроль у владельца: в .rpt НЕ должно быть state_FSM_FFd4..10;
  // v3: автомат = РОВНО 3 триггера state_FSM_FFd1..3; 7 состояний (без WBW).
  // synthesis attribute fsm_encoding of state is "compact"
  reg  [2:0] state  = S_IDLE;
  reg        rd_seen = 1'b0;    // строб чтения замечен в T2
  reg        wr_seen = 1'b0;    // строб записи замечен в T2

  // Захваченные шинные регистры
  reg [7:0] addr_latch = 8'h00;  // адрес с A-сетей (T1) - нужен writeback и декоду порта
  reg [7:0] bus_reg    = 8'h00;  // данные: чтение (с D-сети в T1) ИЛИ запись (с A-сети в T2)

  // Порты индикации/звука (§5): захват по записи в порт при IO/M#=1
  reg [7:0] seg_q = 8'hFF;       // 1 в регистре = сегмент горит; выход инвертируется
  reg [3:0] dig_q = 4'hF;        // 1 = цифра выбрана; выход инвертируется
  reg       snd_q = 1'b0;
  reg [3:0] kbcol_q = 4'h0;      // колонки (порт 02h), INIT 0000 = все выкл
  wire io_rd_kb = IOM & ~addr_latch[2] & addr_latch[1] & addr_latch[0]; // чтение 03h (KBROW)

  // Комбинационные группы (v3):
  //   wb_out = in_wb БЕЗ !ALE: драйверы A/D держат адреса/данные до конца
  //     защищённого импульса (п.4 шапки); снятие - при выходе в IDLE.
  //   rd_drive с !ALE - чтение как в v1 (мгновенный обрыв при новом цикле).
  wire in_wb   = (state >= S_WB1);                       // WB1..WB4: A/D драйвятся
  wire in_welo = (state == S_WB2) || (state == S_WB3);   // /WE низ
  wire wr_phase = (state >= S_T2);                       // T2..WB4: /OE памяти off
  wire wb_out   = in_wb;                                 // защищённый writeback-драйв
  wire rd_drive = (state == S_T2) && rd_seen && !RDn && !ALE; // A-пины отдают данные

  //=============================================================
  // Шинный движок
  //=============================================================
  always @(posedge clk25 or posedge cpu_rst) begin // v3.9.6: сброс логики по cpu_rst = rst_press|por_run (регистры, п.21; асинхронная структура GSR п.18/20 сохранена); v3.9.8: такт логики clk25 (п.23)
    if (cpu_rst) begin
      state      <= S_IDLE;
      rd_seen    <= 1'b0;
      wr_seen    <= 1'b0;
      addr_latch <= 8'h00;
      bus_reg    <= 8'h00;
      seg_q      <= 8'hFF;   // INIT «8888.» на индикаторе
      dig_q      <= 4'hF;
      snd_q      <= 1'b0;
      kbcol_q    <= 4'h0;
    end else begin
      // --- захват повторным сэмплированием: последний сэмпл валиден ---
      // v3: захват возможен только в T1H, т.е. ПОСЛЕ завершения WB
      // (структурно: из WB в T1H попадаешь только через IDLE) - adm.
      // addr_latch НЕ может перезаписаться посреди импульса (п.6 шапки).
      if (state == S_T1H && ALE) begin
        addr_latch <= A;                 // адрес стабилен весь T1
        if (!IOM) bus_reg <= D;          // данные памяти (доступ начался в начале T1)
      end
      if (state == S_T2 && !WRn) begin
        bus_reg <= A;                    // данные записи (CPU держит до WR#(вверх))
        if (IOM) begin                   // запись в порт: декод по тройке A2,A1,A0 (Task 34)
          case (addr_latch[2:0])
            3'b000: seg_q <= A;          // 00h: сегменты
            3'b001: begin                // 01h: разряды + SND
              dig_q <= A[3:0];
              snd_q <= A[4];
            end
            3'b010: kbcol_q <= A[3:0];   // 02h: колонки клавиатуры
            default: ;                   // 03h чтение; 04h-07h резерв (UART удалён, Task 69)
          endcase
        end
      end
      // --- трекинг стробов ---
      if (state == S_T2 && !RDn) rd_seen <= 1'b1;
      if (state == S_T2 && !WRn) wr_seen <= 1'b1;
      // --- переходы ---
      // v3: ALE ОБРЫВАЕТ только T2 (защита от глюка); в WB1..WB4 НЕ
      // вмешивается - импульс /WE защищён (п.4 шапки).
      if (ALE && state == S_T2 && !((wr_seen && WRn) || (rd_seen && RDn))) begin
        state   <= S_IDLE;
        rd_seen <= 1'b0;
        wr_seen <= 1'b0;
      end else begin
        case (state)
          S_IDLE: if (ALE) state <= S_T1H;
          S_T1H:  if (!ALE) state <= S_T2;
          S_T2: begin
            // приоритет записи: RDn-глюк во время записи не должен прерывать её
            if (wr_seen && WRn) begin
              wr_seen  <= 1'b0;
              // writeback только для записи в ОЗУ (8000-FFFF); запись в ПЗУ
              // отбрасывается (по железу /WE flash не подключён), порт пропускается
              // v3.9.3 (п.18): гейт POR - FSM в окне POR живой (GSR не
              // активен), шина CPU в сбросе «floated» (ВМ85А: управле-
              // ния/адрес/данные в 3-м состоянии) - вход в writeback
              // ЗАПРЕЩЁН, иначе плавающие ALE/WRn могли бы родить /WE
              state <= (!IOM && A15 && !por_run && !rst_press) ? S_WB1 : S_IDLE; // v3.9.6: гейт и на кнопку (п.21)
            end else if (rd_seen && RDn) begin
              rd_seen <= 1'b0;
              state <= S_IDLE;         // отпускание A-пинов через 1 тик после RD#(вверх)
            end
          end
          S_WB1: state <= S_WB2;       // t_AS 40 нс; hold-off 0 (см. п.4 шапки)
          S_WB2: state <= S_WB3;       // /WE низ - защищён, идёт до конца
          S_WB3: state <= S_WB4;
          S_WB4: state <= S_IDLE;      // импульс закончен, всё снято в IDLE
          default: state <= S_IDLE;
        endcase
      end
    end
  end

  //=============================================================
  // Тристейт-драйверы шины
  //=============================================================
  // Task 34: при чтении порта 03h A_I(0..4) = row0-4 (mux KBROW),
  // AD7-5 = 000. UART-статус (IN 05h) удалён вместе с UART (Task 69).
  assign A = rd_drive ? (io_rd_kb ? {3'b000, row4, row3, row2, row1, row0}
                                  : bus_reg)
            : wb_out   ? addr_latch : 8'bZZZZZZZZ;
  assign D = wb_out ? bus_reg : 8'bZZZZZZZZ;

  //=============================================================
  // Декод памяти минимальной ширины (§5): 1 терм на кристалл
  // v3.9.1 (п.16 шапки): /CE ОЗУ в writeback - ОТ СОСТОЯНИЯ FSM
  // (in_wb); защёлка wb_ram_q удалена - in_wb достижим только через
  // T2-запись в ОЗУ и уже влечёт её условие (эквивалентность v3.9
  // доказана: полный перебор состояний + дифсимуляция двух RTL).
  // Живой декод A15 во время конфликта адресов по-прежнему НЕ
  // участвует: в WB1..WB4 CS_n = 0 без A15/IOM - запись ОЗУ
  // защищена как в v3 (защита п.5 шапки сохранена построением).
  //=============================================================
  assign CSr_n = A15 | IOM;             // /CE_ROM = !( !A15 & !IOM )
  assign CS_n  = in_wb ? 1'b0 : (!A15 | IOM);   // v3.9.1: было (in_wb && wb_ram_q) ? ... (п.16)
  assign OEr_n = CSr_n | wr_phase;      // /OE гасится с T2 - данные уже захвачены,
  assign OE_n  = CS_n  | wr_phase;      // иначе SRAM воевала бы с CPLD на D в writeback
  // v3: /WE НЕ обрывается ALE - импульс доводится до конца (п.4 шапки);
  // безопасно: автомат доходит до WB4/IDLE за 5 тиков; сброс гасит импульс:
  // v3.9.2 - cpu_rst за такт (sync), v3.9.3 - GSR мгновенно (п.18);
  // v3.9.6 - импульс 80 нс квалификатор (400 нс) НЕ успевает оборвать:
  // начатая запись доводится до конца (полный t_WP ОЗУ), сброс гасит
  // драйвы сразу после её завершения (п.21f).
  assign WE_n  = !in_welo;
  assign CS1   = 1'b1;

  //=============================================================
  // Поддержка CPU (§3, ред. Task 19) + soft-UART транзиты (Task 70-a).
  // Держатели '0' (TRAP, RST7.5/6.5/5.5, INTR, HOLD, A16-A18) удалены
  // из HDL - их пины (9 шт) заземлит фиттер (Ground on Unused IOs).
  // SID (P73) с Task 70-a - ВЫХОД CPLD (транзит RX), в держатели
  // больше не входит (PGND 10 -> 9).
  //=============================================================
  assign RESET_IN = reset_q;          // v3.9.6 (п.21): РЕГИСТР; активный 0 по даташиту: 0 = сброс CPU (кнопка после квалификатора или POR); INIT=0 - CPU держится с t=0; снятие - чистым регистровым фронтом
  assign READY = 1'b1;          // без wait-state - иначе вечные TW
  // Транзиты soft-UART (Task 70-a); TX - регистровый, см. блок v3.7 выше:
  assign SID = RX;              // приём:  CH340G.TXD (P38) -> CPU.SID (P73), RIM 20h
  assign TX  = tx_q;            // передача: CPU.SOD (P72) -> CH340G.RXD (P39), SIM 30h;
                                // регистр с захватом после первого SOD='1' (v3.7):
                                // в покое прошивка держит SOD='1' (stop/idle) - это
                                // и есть enable линии; в сбросе/до захвата TX='1'

  //=============================================================
  // Индикация и звук: выходы инвертированы (общий анод, активный 0)
  //=============================================================
  assign seg = ~seg_q;
  assign dig = ~dig_q;
  assign SND = snd_q;
  // Task 34: колонки клавиатуры - зарегистрированные выходы, прямые уровни
  // (активная колонка = 1, остальные 0; после сброса 0000 - безопасно)
  assign col0 = kbcol_q[0];
  assign col1 = kbcol_q[1];
  assign col2 = kbcol_q[2];
  assign col3 = kbcol_q[3];

endmodule
