digitalinvitro/CPLD-plus-8085/beta/txclient/top_txclient_v8.v

//=====================================================================
// top_txclient.v v8 (TXCLIENT, база v3.9.3) - retro_pcld_top + МОНИТОР ЗАПИСЕЙ CPU В
// ОЗУ (ОКНО 8000h-BFFFh - решение владельца, п.22) -> HOLD -> UART-TX
// [addr_hi][addr_lo][data] 1 923 077 8N1 в ПК; hi-байт - СЕРИАЛЬНЫЙ ЗАХВАТ С ЖИВЫХ
// AH-ПИНОВ (9 тиков в shreg<8>, п.20/22) + кадры 2/3 - СЕРИАЛЬНАЯ ПРЕДЗАГРУЗКА
// во время передачи предыдущего (п.22/23): параллельных загрузок shreg БОЛЬШЕ НЕТ,
// ИСТОЧНИКИ КАДРОВ СДВИГАЮТСЯ К LSB - инжекция ОДНОГО провода вместо 16-входового
// мультиплексора (п.23);
// фильтрация по региону и рендер - НА СТОРОНЕ ПК; soft-UART SOD УДАЛЁН (п.18) +
// CPU 3,57 МГц (X1/X2 = 7,14 МГц; делитель: двоичный счётчик mod-7, п.17;
// CS_n в writeback ОТ СОСТОЯНИЯ FSM, п.16; СБРОС ЛОГИКИ И СЕРИАЛИЗАТОРА ->
// СЕТЬ GSR, п.24; POR 4 бита со стробом x1_n - МЕРА М1, п.25)
// (Task 77, 2026-10-20; v3.1 POR_W 14->6, v3.2 por_run регистровый - 2026-10-22;
//  v3.4 декод-иммунный патч clk10-35 - 2026-10-28; v3.5 регистровая
//  противофаза X2 clk10-41 - 2026-10-28; v3.6 полуцелый делитель 25/2,5 ->
//  X1/X2 = 10 МГц, CPU 5 МГц - 2026-10-29; v3.7 TX-маска txm_cnt УДАЛЕНА,
//  захват по первому SOD='1' - 2026-10-29; v3.8 делитель = one-hot кольцо
//  вместо двоичного mod-5 - 2026-10-29; v3.9 кольцо расширено 5 -> 7
//  триггеров: X1/X2 = 7,14 МГц, CPU 3,57 МГц (экземпляр ИМ1281ВМ85А 5 МГц
//  не тянет - нестабильный старт) - 2026-10-29; v3.9.1 CS_n в writeback
//  от состояния FSM, защёлка wb_ram_q удалена (п.16) - 2026-10-30;
//  v3.9.2 делитель: кольцо one-hot N=7 -> двоичный счётчик mod-7,
//  линия lowsize (п.17) - 2026-10-30; v3.9.3 сброс логики -> СЕТЬ GSR
//  (низсайз, п.18) - 2026-11-02; v7 = база v3.9.3: сброс логики И
//  сериализатора -> GSR, cpu_rst удалён (п.24) - 2026-11-03; v8 = v7 + МЕРА
//  М1 (аудит фита 1 v7, одобрена владельцем «Делай M1»): por_sh 8 -> 4 бита,
//  строб por_ce = x1_n (1 строб/цикл cnt) - 2026-11-03). База: v1 (Task 70-a, логика чтения/захвата
// не тронута), X1 поднят 1,5625 -> 5 МГц (CPU 781,25 кГц -> 2,5 МГц,
// T = 400 нс) - план одобрен владельцем («Делаем!»).
//
// ЧТО ИЗМЕНЕНО в v3 (против v1):
//  1) ДЕЛИТЕЛЬ: XOR-пара /5 от 25 МГц -> X1 = 5 МГц с РОВНО 50% duty
//     (100/100 нс): триггер x1_p переключается по posedge при cnt==0,
//     триггер x1_n - по negedge при cnt==3 (=(N+1)/2 для нечётного N!),
//     X1 = p XOR n. INIT x1_p=1, x1_n=0 -> X1 стартует с '1' (как
//     в .rpt: X1 Init=SET).
//     ВНИМАНИЕ: вариант «negedge при cnt==2» из черновика плана даёт
//     60/140 нс (30/70) - ЗАБРАКОВАН; правильный декод (N+1)/2 (здесь
//     cnt==3), проверен разбором фронтов и тестбенчем (duty-monitor
//     90..110 нс).
//     Параметр CLK_DIV для отката: чётное N -> простой toggle-триггер
//     (X1 = 25/N МГц, 50%), нечётное N -> XOR-пара. CLK_DIV=8 -> X1
//     3,125 МГц (режим v2). Возврат к v1 (X1 1,5625) - старый файл из
//     git-истории (mod-16).
//  2) POR_W 12 -> 14: квант = период X1 = 200 нс -> POR = 16384x200 нс =
//     3,28 мс (в v1 было 2,62 мс при кванте 640 нс; порядок длительности
//     сохранён для медленных блоков питания).
//  3) TX-ТРАНЗИТ С ЗАХВАТОМ (v3.7, замена TX-маски v2-v3.6, txm_cnt
//     УДАЛЁН - см. п.13): датасшит (вывод SR) - аппаратный сброс CPU
//     очищает SOD в '0', и до первого SIM прошивки линия '0' = «вечный
//     start-bit» -> пустой фрейм в терминале. В v3.7 транзит открывает
//     ПЕРВЫЙ сэмпл SOD='1' (TXIDLE прошивки) - захват ПО УРОВНЮ, без
//     счётчика и без привязки к частоте; в сбросе и до захвата TX='1'
//     (чистый idle, без BREAK).
//  4) WRITEBACK - ЗАЩИЩЁННЫЙ ИМПУЛЬС /WE (главное изменение шины!).
//     При T=400 нс реальный зазор WR#(вверх)->след.ALE = 0,25..0,45 T =
//     100..180 нс (плата: 320..580 нс при T=1280; PUSH = write-write).
//     Схема v1 «3 тика выдержки + обрыв по ALE» здесь ТЕРЯЕТ запись
//     (ALE обрывает /WE до импульса -> PUSH портит стек!). В v3:
//     hold-off 3 -> 0 (WBW удалён) и импульс /WE ДОВОДИТСЯ ДО КОНЦА
//     НЕЗАВИСИМО ОТ ALE; драйверы A/D держат СТАРЫЙ адрес/данные до
//     конца импульса. Конфликт с новым адресом CPU (если ALE успел)
//     выигрывает CPLD (24 мА против 2 мА у ВМ85), адрес на входах ОЗУ
//     стабилен весь импульс (t_AS 40 нс, /WE 80 нс), запись попадает
//     по адресу.
//     Почему hold-off РОВНО 0 (а не 1 по плану): после импульса автомат
//     должен УСПЕТЬ в T1H и захватить адрес СЛЕДУЮЩЕГО цикла до
//     ALE#спада. Зазор для этого = ALE#спад - (WR#+P+160) = gap-P-100:
//     при gap=100, P=40 остаётся 0 нс - захват НЕ происходит (поймано
//     в tb, T3c писала по старому адресу!). С hold-off 0: всё закрывается
//     с запасом >= 2 тактов при любом gap >= 100 нс (0,25T). t_DH-GARD
//     не нужен: данные записи уже в bus_reg (захват в T2), а бой на
//     A-сетях выигрывает CPLD (слабый драйвер TB = 2 мА у CPU).
//     Область конфликта <= 60 нс, штатный режим (tb: wb_fight считается
//     отдельно; все проверки t_AS/t_WP/wdel в tb остаются).
//  5) /CE ОЗУ ВО ВРЕМЯ WRITEBACK - ЗАЩЁЛКНУТЫЙ (wb_ram_q, +1 триггер):
//     живой декод CS_n=!A15|IOM во время конфликта адресов читал бы
//     НОВЫЙ адрес CPU и мог сорвать запись (новый адрес = ROM). Защёлка
//     ставится в момент захвата строба (T2, A15/IOM стабильны до конца
//     цикла). В v3.9.1 защёлка УДАЛЕНА - п.16: CS_n в WB от состояния
//     FSM, эквивалентность доказана.
//  6) ЗАХВАТ T1H СТРУКТУРНО ЗАЩИЩЁН: из WB в T1H можно попасть только
//     через IDLE, поэтому addr_latch НЕ перезаписывается посреди
//     импульса. Цепочка WB сжата до 4 состояний (hold-off 0), чтобы
//     успеть захватить адрес СЛЕДУЮЩЕГО цикла в T1 при зазоре
//     100 нс (см. п.4).
// ЧТО ИЗМЕНЕНО в v3.1/v3.2 (2026-10-22, одобрено владельцем «Делаем POR_W = 6»):
//  7) POR_W 14 -> 6: POR = 2^6 x 200 нс = 12,8 мкс = 32 такта CLK OUT
//     (было 3,28 мс = 8192 такта - запас x2730). Даташит 8085A/P8085AH
//     (1821ВМ85А - функциональный аналог 80C85): «RESET IN should be kept
//     low a minimum of three clock periods» ПОСЛЕ power-up = 3 x 400 нс =
//     1,2 мкс при работающем клоке; запас x10. CLK OUT (CPU.37, P83)
//     тикает весь интервал сброса - процессорные структуры тактируются
//     и готовы (аргумент владельца), квитанция CPU - RSTOUT=1 (P70).
//     Счёт стартует только при живом clk 25 МГц (por_ce из делителя),
//     INIT=FF держит RESET_IN=0 до всякого клока; покрытие подъёма VCC
//     проверяется осциллограммой включения (VCC / RESET_IN P84 /
//     CLKOUT P83 / RSTOUT P70). Экономия: por_cnt 14 -> 6 = -8 MC
//     (100/108 -> ~92/108), por_run 14 -> 6 входов, T-цепи заимствования
//     короче, путь por_cnt->seg/dig (36 нс) укорачивается.
//  8) v3.2 (10-22, фит v3.1 упал - Placement Failed): por_run сделан
//     РЕГИСТРОМ (+1 MC). Механизм отказа: комб. por_run=(por_cnt!=0)
//     из 6 бит фиттер СХЛОПНУЛ в PT всех приёмников cpu_rst -> ширина
//     PT и число FB-входов выросли (209/216), 12 выходов ушли в
//     BUFR-буферы (+12 MC, WARNING 897; всего 104 MC), хелпер
//     $OpTx$FX_SC$257 (8 PT/15 входов) не поместился ни в один FB
//     (ERROR:Cpld:892/868). В v3 (14 бит) порог схлопывания не пускал -
//     обходились локальными копиями декода POR ($OpTx$FX_DC, 27 шт).
//     FF-выход не схлопывается в принципе - структура стабильна.
//     Ожидание v3.2: MC ~95, буферы ~3 (как v3), фит ОК.
//
// ЧТО ИЗМЕНЕНО в v3.4 (2026-10-28, декод-иммунный патч clk10-35):
//  9) Фиттер ТРИ раза терял полярность на свёрнутых декодах равенства:
//     фит 7:31 - cnt_T0=(cnt==4) БЕЗ инверсии (счётчик залип -> X1=X2=
//     12,5 МГц) и por_cnt(0): T=NOT en (POR схлопнулся до 1 клока);
//     фит 8:55 (CLK_DIV=2) - cnt_T(0)=(cnt==0) снова без инверсии
//     (X1 замерзает: тактовой нет вообще), por_run.D=(por_cnt==0)
//     инвертировано (сброс снимается за 1 клок), X2 стал РЕГИСТРОМ с
//     D=D(x1_q) - X2 В ФАЗЕ с X1 вместо противофазы. Не чиним
//     инструмент - убираем класс конструкций целиком:
//     - чётные ветки 2/4 = ЦЕПОЧКИ TOGGLE-ТРИГГЕРОВ: /2 -> x1_q тогглит
//       каждый клок; /4 -> t0_q=clk/2, x1_q тогглит при t0_q=1. Вентиля -
//       1-2 литерала, декодов равенства НЕТ (нечему терять полярность);
//     - POR = 8-бит сдвиговый регистр por_sh (INIT=FF): по por_ce сдвиг
//       вправо, 0 в MSB, bit0 очищается ПОСЛЕДНИМ; por_run.D = por_sh[0].
//       Декоды (por_cnt==0)/(por_cnt!=0) исчезли из нетлиста. POR =
//       8 x por_ce = 8 x 160 нс = 1,28 мкс @ CLK_DIV=4/25 МГц (норма:
//       3 такта CLK OUT = 0,96 мкс @ 3,125 МГц, запас 1,33x). Повторный
//       POR невозможен: после 00 сдвиг держит нули. por_run остаётся
//       РЕГИСТРОМ (v3.2, п.8 - защита от Placement Failed);
//     - нечётная ветка (XOR-пара) и fallback чётных N>=6 (счётчик cnt)
//       НЕ тронуты - при CLK_DIV=4 элайзятся; txm_cnt не тронут (оба
//       фита печатали его бит в бит - на этом узле инструмент не сбит);
//     - CLK_DIV 5 -> 4: замер подтверждён (12 МГц на X1/X2 старого
//       джеда = GCK3/2 = 25/2) -> U7 = LTC6905-100, GCK3 = 25,00 МГц
//       (версия -80 НЕ подтвердилась). X1 = 6,25 МГц duty 50%, CPU =
//       3,125 МГц (в ТУ ВМ85А: до 5), CLK OUT = 3,125 МГц, терминал
//       6000 8N1 (ПЗУ fw_mon v5 НЕ перешивается: бод масштабируется
//       клоком, 4800 @ 2,5 МГц -> 6000 @ 3,125 МГц). CLK_DIV=2 не
//       годится: CPU 6,25 МГц - ВНЕ ТУ;
//     - X2 = ~X1 сохранён (фикс clk10-29/30/32); на порт X2 добавлен
//       keep - страховка от same-D регистра (дефект фита 8:55);
//     - бюджет MC (план clk10-35): -12 (cnt 4 + por_cnt 6 + BUF) /
//       +10 (t0_q 1 + por_sh 8 + por_run) -> ожидаем ~98 MC.
//
// ЧТО ИЗМЕНЕНО в v3.5 (2026-10-28, регистровая противофаза X2, clk10-39/41):
// 10) Фит v3.4 (10:06PM) подтвердил худшее: комб. assign X2 = ~X1 фиттер
//     снова поднял в регистр FDCPE с D = XOR(x1_q, t0_q) = D(x1_q) -
//     X2 В ФАЗЕ с X1 (keep-страховка на порте НЕ сработала). CPU в
//     железе не задет (clk10-38: монитор работает, X2 тактирует CPU),
//     но противофаза - требование даташита ВМ85А; чиним ПО ПОСТРОЕНИЮ:
//     X2 = РЕГИСТР с D, ОТЛИЧНЫМ от D(x1) -> same-D слияние невозможно:
//     - div2: x2_q <= x1_q - задержка 1 клок = ПОЛПЕРИОДА (период 2 клока),
//       D(x2_q)=x1_q != D(x1_q)=~x1_q; init (x1_q=1, x2_q=0);
//     - div4: x2_q <= ~(x1_q ^ t0_q): x1_q_next = x1_q ^ t0_q, т.е.
//       x2_q(t+1) = ~x1_q(t+1) - точная противофаза с 0-го такта
//       (трасса фронтов: x1 1,1,0,0,...; x2 0,0,1,1,...);
//       D(x2_q)=XNOR(x1_q,t0_q) != D(x1_q)=XOR(x1_q,t0_q);
//     - fallback чётных N>=6: x2_q тогглит при cnt==MEV СИНХРОННО с
//       x1_q, init (1,0) -> комплементарны всегда (toggle-пара);
//     - нечётная ветка: x2_p - двойник x1_p (posedge при cnt==0, INIT
//       инверсный), X2 = x2_p ^ x1_n = ~x1_p ^ x1_n = ~X1 ТОЧНО, без
//       сдвига duty (вариант «задержка на клок» ломал бы 50/50 при N=5);
//     - keep на порте X2 сохранён (держит сеть отдельной);
//     - бюджет: +1 MC в каждой чётной ветке, +1 MC (x2_p) в нечётной.
//
// ЧТО ИЗМЕНЕНО в v3.6 (2026-10-29, полуцелый делитель 25/2,5, clk10-49):
// 11) ДЕЛИТЕЛЬ: целевой режим владельца - X1/X2 = 10 МГц -> CPU 5,000 МГц
//     (ровно паспортный максимум ВМ85А, БЕЗ разгона; вариант «/2» ->
//     12,5 МГц / CPU 6,25 ОТКЛОНЁН владельцем как разгон). Внешний
//     каскад НЕ тронут: U7 (LTC6905-100) -> шунт H1 1-2 (DIV=GND, /4)
//     -> GCK3 = 25,00 МГц (замер Task 29-d). 25/10 = 2,5 - деление
//     ПОЛУЦЕЛОЕ, toggle-каскадом недостижимо -> НОВАЯ ветка g_div2p5
//     (выбор: CLK_DIV=2 + НОВЫЙ параметр CLK_HALF=1):
//     - cnt: mod-5 по posedge (0..4), wrap по декоду cnt==4;
//     - x1_p (posedge, INIT=1): D = (cnt != 4) -> '1' интервалы
//       [0,160)+[200,360)... нс (по 160 нс, low по 40 в [160,200)+200k);
//     - x1_n (NEGEDGE, INIT=0): set при cnt==2 (t=60+200k), clear при
//       cnt==3 (t=100+200k) -> '1' импульсы 40 нс в [60,100)+200k;
//     - X1 = x1_p ^ x1_n: узор по полутактам 20 нс "11100" повтор ->
//       фронты через РОВНО 100 нс = 10,000 МГц (high 60 / low 40 нс,
//       duty 60/40). Контраст с «наивным» posedge-делением (фронты
//       80/120 нс, период плавает): negedge-сдвиг n выравнивает
//       ПЕРИОД. Duty X1 процессору безразличен: внутренний /2 ВМ85А
//       тактируется ФРОНТАМИ -> CLK = 5,000 МГц, период 200 нс,
//       duty РОВНО 50/50;
//     - x2_p (posedge, INIT=0): D = (cnt == 4) = НЕ D(x1_p), двойник с
//       инверсным INIT (механизм п.10) -> X2 = x2_p ^ x1_n = ~x1_p ^
//       x1_n = ~X1 ТОЧНО с 0-го такта; same-D слияние невозможно;
//     - init (x1_p=1, x1_n=0, x2_p=0) = установившийся узор -> X1
//       стартует '1' (X2 '0') БЕЗ переходного процесса;
//     - регистры ТОЛЬКО существующие (cnt/x1_p/x1_n/x2_p объявлены под
//       legacy-ветки, при (2,1) принадлежат целевой ветке): +3 MC
//       против ветки div4 (t0_q/x1_q/x2_q элайзятся) -> ~98/108;
//     - por_ce = (cnt==4)|(cnt==1): сэмпл по posedge в t=40+200k и
//       t=160+200k -> 1 импульс за период X1 (120/80 нс попеременно,
//       в среднем ровно 100 нс);
//     - ВНИМАНИЕ п.9: в ветке 4 ДЕКОДА (==4/==1/==2/==3) - mod-5 иначе
//       недостижим; аудит .rpt по чек-листу g)-h) ОБЯЗАТЕЛЕН
//       (полярности декодов!).
// 12) ПОСЛЕДСТВИЯ 10 МГц (пересчёт от v3.4, всё в ТУ):
//     - CLK OUT (CPU.37) = 5,000 МГц, T = 200 нс, duty ровно 50%;
//     - POR = 8 x por_ce = 800 нс (норма 3 такта CLK = 600 нс, запас
//       1,33x - ТОТ ЖЕ, что в v3.4 при 6,25);
//     - окно TX-маски 2^8 x 100 нс = 25,6 мкс; окно SOD=0 после сброса
//       сжимается до ~4-20 мкс (код ПЗУ неизменен, такт в 1,6 раза
//       быстрее) - запас 1,28x ТОТ ЖЕ, что в v3.4; TXM_W=8 НЕ тронут;
//     - терминал: 6000 8N1 -> РОВНО 9600 8N1 (ПЗУ fw_mon v5 не
//       перешивается: 4800 @ CPU 2,5 -> 6000 @ 3,125 -> 9600 @ 5 МГц);
//     - автомат шины: WB-импульс 160 нс < зазора WR#(вверх)->ALE
//       (1 T = 200 нс при CPU 5 МГц), конфликтная область на A-сетях
//       <= 60 нс (п.4) - без изменений; остальное байт-в-байт v3.5.
//
// 13) УПРОЩЕНИЕ TX-ТРАКТА (v3.7, clk10-51): «хвост экспериментов» в
//     UART-линии вырезан. Было (v2-v3.6): txm_cnt<7:0> (8 FF, ~9 МЦ,
//     почти весь FB4) тикал по por_ce и через 2^TXM_W=256 тиков (25,6
//     мкс @ 10 МГц) открывал транзит TX=SOD; до того TX='1'. Мотив
//     маски - датасшит IM1821ВМ85А (вывод SR): «...установку в исходное
//     (нулевое) состояние ... триггеров входа INR4 и ВЫХОДА TFD» -
//     сброс CPU очищает SOD в '0', прошивка поднимает линию первым
//     SIM'ом через ~4-20 мкс (TXIDLE fw_mon v5) -> голый транзит =
//     «фиктивный start-bit», пустой фрейм в терминале (наблюдалось
//     в v2-эпоху). Стало: txm_cnt и параметр TXM_W удалены; sod_q
//     (IO-MC входа SOD) синхронизирует вход по clk 25 МГц; tx_pass
//     (1 лог. MC) захватывает линию по ПЕРВОМУ SOD='1' после сброса
//     (async clear по cpu_rst); tx_q (регистр IO-MC пина TX, INIT=1,
//     async set по cpu_rst) выдаёт TX. Итог: -7..-8 МЦ (прогноз
//     ~102 -> ~94/108), FB4 почти пуст; окно SOD=0 покрыто ПО СТРОЕНИЮ
//     (ноль не пропускается, пока прошивка сама не поднимет линию) -
//     TXM_W, запас 1,28x и привязка к частоте X1/CPU упразднены
//     (работает на 3,125/5/6,25 МГц и с любой длиной init); латентность
//     транзита <= 2 такта 25 МГц (80 нс = 0,4 такта CLK 200 нс = 0,08%
//     бита 9600); сброс/кнопка уводят TX='1' мгновенно (async set, без
//     клока). Требование к прошивке одно - первое касание SOD после
//     сброса = SOD:=1 (fw_mon v5 делает это в TXIDLE; любой soft-UART
//     начинает кадр с idle '1'). Теоретическое слабое место: ложный
//     SOD='1' в окне (звон шины выше VIH) открыл бы захват раньше -
//     физически невероятен (вход CPU в сбросе статичен); лечение -
//     захват по 2 сэмплам подряд (+1 FF, см. симуляцию v3.7).
//
// ЧТО ИЗМЕНЕНО в v3.8 (2026-10-29, делитель = one-hot кольцо, clk10-52):
// 14) ДВОИЧНЫЙ mod-5 СЧЁТЧИК ЗАМЕНЁН 5-ТРИГГЕРНЫМ КОЛЬЦОМ-СДВИГОМ
//     (идея владельца и коллеги: «кольцевой счётчик на сдвиговом
//     регистре»). Мотивация по фиту v3.6 (10-29,Successful): МЦ 102/108,
//     входы ФБ 197/216 - стена по ВХОДАМ ФБ (4 ФБ на 35-36/36, FB6
//     Exhausted 36/36), птермов свободно половина. Узел платил входную
//     ренту В ДВА ФБ сразу: FB6 (пины X1/X2) ел cnt<0..3> + x1_p/x2_p/
//     x1_n = 7 входов из 36; FB4 ел cnt<0..3> + x1_n = 5 (+копия декода
//     por_ce $OpTx$FX_DC$163 на 4 литерала cnt<0..3>). В кольце
//     СОСТОЯНИЕ = ВЫХОД ТРИГГЕРА: все 4 декода равенства (==4 wrap,
//     ==1, ==2, ==3) исчезают - терять полярность нечему (класс п.9
//     добит в последнем узле тактового тракта; аудит чек-листа h)
//     упрощается до сравнения 1-2 литеральных птермов). Плюс:
//     -1 МЦ (счётчик в нетлисте фита v3.6 = 4 триггера: cnt<3> выжил
//     как балласт 4-го бита; кольцу нужно ровно 5+1); птермы узла
//     11 -> 8, макс. ширина литерала 4 -> 2 (у рестарта - 5); входы:
//     FB6 7 -> 6, FB4 5 -> 0..2, копии por_ce: 4 литерала cnt ->
//     2 литерала r1/r4.
//     ПОСТРОЕНИЕ (эквивалентность v3.6 доказана трассировкой фронтов и
//     scripts/sim_v38_ring.py - 200 мкс байт-в-байт, ПАСС):
//     - r0..r4: one-hot сдвиг по posedge: r_i <= r_{i-1} & ~r_{i+1} &
//       & ~r_i («убей преемника»). В легальном one-hot оба литерала
//       всегда '1' -> D = r_{i-1}, поведение НЕ меняется. Литералы
//       самоочистки гасят ВСЕ нелегальные состояния: соседняя пара '1'
//       отказывается двигаться и умирает за 1 фронт (оба приёмника
//       заняты), тройки/все-1 -> 00, из 00 рестарт r0 по NOR5;
//       ЛЮБОЕ из 32 состояний -> one-hot за <= 2 фронта. НАИВНОЕ
//       кольцо (r_i <= r_{i-1}) НЕ ГОДИТСЯ: соседняя пара '1' ходит
//       по кольцу ВЕЧНО (2x частота), а 00000 = МЁРТВЫЙ клок; v3.6
//       выплывал из нелегалов до 12 тактов - самоочистка обязательна,
//       цена: +2 литерала на триггер, +0 птермов, +0 МЦ;
//     - x1_p/x2_p СОКРАЩЕНЫ (не +2 триггера против v3.6, а -2):
//       x1_p == ~r0 и x2_p == r0 ТОЧНО - оба обновляются ОДНИМ posedge
//       из одного состояния: x1_p <= (cnt!=4) даёт '0' только в
//       состоянии 0 (= ~r0), x2_p <= (cnt==4) даёт '1' только в
//       состоянии 0 (= r0). Отсюда X1 = (~r0) ^ x1_n, X2 = r0 ^ x1_n;
//       SOP функций X1/X2 различны по построению - same-D слияние
//       невозможно (механизм п.10 сохранён);
//     - x1_n БЕЗ ИЗМЕНЕНИЙ (negedge, INIT=0): set при r2, clear при
//       r3 - те же фронт-пары, что (cnt==2)/(cnt==3);
//     - por_ce = r1 | r4 (те же интервалы, что (cnt==4)|(cnt==1));
//     - INIT r0=1, r1..r4=0 (заплавлен, как init-тройка v3.6) -
//       состояние 0 при старте. ЕДИНСТВЕННОЕ отличие от v3.6: до
//       ПЕРВОГО posedge X1='0'/X2='1' (v3.6: 1/0) - CPU всё это время
//       в POR (por_run=1), схемно незначимо; с первого фронта
//       X1/X2/por_ce/por_run совпадают с v3.6 пофронтово (узор
//       "11100", 10,000 МГц 60/40, CLK 5 МГц ровно 50/50, por_ce 6/4,
//       POR 800 нс);
//     - legacy-ветки (div2/div4/чётные N>=6/нечётные) НЕ тронуты:
//       cnt, x1_p, x2_p остаются объявленными (элайзятся при (2,1)).
//
// ЧТО ИЗМЕНЕНО в v3.9 (2026-10-29, кольцо 5 -> 7 триггеров, clk10-54):
// 15) ОТКАТ ЧАСТОТЫ ПО РЕЗУЛЬТАТАМ ЖЕЛЕЗА: экземпляр ИМ1281ВМ85А не
//     держит CPU 5 МГц - «самые простые тесты крайне нестабильно
//     запускаются, но запустившись вроде бы работают» (сигналы живые:
//     адреса/ALE/сброс/X1-X2 в противофазе - дефект НЕ в тракте CPLD).
//     Решение владельца и коллеги: остаться в семействе one-hot
//     колец и РАСШИРИТЬ кольцо 5 -> 7 (ряд из 25 МГц: N=5 -> X1
//     10,00 МГц; N=7 -> 7,14; N=9 -> 5,56...), v3.8 остаётся откатом.
//     ПОСТРОЕНИЕ (вся остальная логика байт-в-байт v3.8; legacy-ветки
//     не тронуты):
//     - r5/r6 добавлены, кольцо r0..r6: сдвиг с САМООЧИСТКОЙ, УСИЛЕННОЙ
//       против v3.8: r_i <= r_{i-1} & ~r_i & ~r_{i+1} & ~r_{i+2}
//       (kill ПРЕЕМНИКА И ЕГО СОСЕДА), рестарт из 00 по NOR7. Причина
//       усиления: формула коллеги (r_i <= r_{i-1} & ~r_{i+1} & ~r_i) для
//       N=7 НЕ гасит пары '1' на дистанции 3-4 - они ОРБИТИРУЮТ ВЕЧНО
//       (14 состояний из 128; в N=5 проблема отсутствует - малое кольцо
//       сталкивает пары при обходе; поймано sim_v39_ring7.py ДО фита).
//       С двойным kill: gap-1 -> 00 -> рестарт; gap-2/3 - последователь
//       блокирован, лидер идёт; gap-4 - лидера блокирует его собственный
//       kill-литерал через wrap (~r_{q+7} = ~r_q). ЛЮБОЕ из 128 состояний
//       -> one-hot за <= 2 фронта (sim_v39_ring7.py, полный перебор);
//     - x1_n (negedge, INIT=0): set при r3, clear при r4
//       (SET=(N-1)/2=3, CLR=(N+1)/2=4) -> импульс 40 нс, как в v3.8;
//     - X1 = (~r0)^x1_n: high 100 / low 40 нс (duty 71/29), фронты
//       через РОВНО 140 нс = 2x25/7 = 7,143 МГц; X2 = r0^x1_n = ~X1
//       ТОЧНО (SOP различны, п.10/14); внутренний /2 ВМ85А по ФРОНТАМ
//       -> CLK = 3,571 МГц, период РОВНО 280 нс, duty ровно 50/50;
//     - por_ce = r1 | r6: интервалы 200/80 нс (в среднем ровно 140 нс);
//       POR = 8 x 140 = 1120 нс; норма 3 такта CLK = 840 нс -> запас
//       1,33x (тот же, что v3.8: 800/600);
//     - автомат шины НЕ тронут (домен 25 МГц): /WE 80 нс, t_AS 40 нс -
//       ФИКСИРОВАННЫЕ. При T=280 нс зазор WR#(вверх)->след.ALE
//       сжимается до ~0,25..0,45 T = 70..126 нс (при T=400 было
//       100..180); окно захвата T1H = gap + ~0,9T минус 160..200 нс
//       на завершение WB-цепочки -> запас ~120..220 нс (3..5 тактов
//       25 МГц) - закрыт, НО коэффициенты 0,25..0,45 сняты платой при
//       T=1280: после фита ПЕРЕИЗМЕРИТЬ зазор на осциллографе (п.4
//       шапки; арбитр - осциллограф, как и для фазы X1/X2);
//     - бюджет: +2 МЦ (r5/r6), ~+2..3 PT, рестарт-птерм r0.D
//       расширяется 5 -> 7 литералов (шина PT XC9500 - 36, запас);
//       свободно было 21 МЦ (FB2 - 6, FB3 - 6, FB1 - 5, FB6 - 2, FB5
//       - 2) и 17 входов ФБ - ложится с запасом (прогноз ~89/108 MC,
//       ~209/540 PT, ~201-204/216 входов ФБ);
//     - TX-захват v3.7 ПО УРОВНЮ частотно-независим - не тронут.
//     ПОСЛЕДСТВИЯ (пересчёт от v3.8):
//     - терминал: 9600 -> 1920 x 25/7 = 6857 8N1 (ПЗУ fw_mon v5 не
//       перешивается: бод = 1920 x f_CPU; 4800@2,5 -> 6000@3,125 ->
//       9600@5 -> 6857@3,571; CH340G произвольные боды держит);
//     - CLK OUT = 3,571 МГц duty 50%; POR 1120 нс; t_RD/t_WR CPU
//       растут (280+ нс против 200 при 5 МГц) - маржа памяти
//       увеличивается (гипотеза нестабильного старта - CPU за гранью).
//
// ЧТО ИЗМЕНЕНО в v3.9.1 (2026-10-30, CS_n writeback без защёлки, clk10-62):
// 16) ЗАЩЁЛКА wb_ram_q УДАЛЕНА (предложение коллеги, вердикт clk10-61:
//     ПРАВ). Единственный читатель wb_ram_q был CS_n, а in_wb
//     (state >= S_WB1) уже влечёт условие защёлки:
//     - S_WB1 достижим ТОЛЬКО из ветки «запись завершена» в T2
//       (wr_seen && WRn) и ТОЛЬКО при !IOM && A15 - тем же фронтом
//       ставится и защёлка (в v3.9: строки 794+797 в одном begin);
//     - в WB2..WB4 wb_ram_q не переприсваивается (держит 1);
//     - сброс СИНХРОННЫЙ, одним фронтом со state (в v3.9: 743+746) -
//       окна «state в WB, wb_ram_q=0» нет даже при cpu_rst посреди
//       импульса /WE;
//     - драйверы WB (A-сети, D-шина, WE_n) УЖЕ работали от in_wb без
//       защёлки - правка делает CS_n консистентным с WB-трактом.
//     Изменение RTL (против v3.9): удалены reg wb_ram_q, его сброс и
//     взвод; уравнение:
//       было:  assign CS_n = (in_wb && wb_ram_q) ? 1'b0 : (!A15 | IOM);
//       стало: assign CS_n = in_wb ? 1'b0 : (!A15 | IOM);
//     остальное байт-в-байт v3.9 (кольцо N=7, POR, TX v3.7, автомат).
//     ЗАЩИТА ЗАПИСИ СОХРАНЕНА ПОСТРОЕНИЕМ: в WB1..WB4 CS_n=0 БЕЗ
//     A15/IOM - живой декод во время конфликта адресов по-прежнему не
//     участвует; /WE как был, от in_welo (2 тика = 80 нс).
//     ЭКВИВАЛЕНТНОСТЬ (scripts/sim_v391_equiv.py + scripts/tb_v391_diff.v,
//     Icarus Verilog 12.0): (а) полный перебор произведения машин
//     (state, rd_seen, wr_seen, wb_ram_q) x 64 комбинации входов от
//     стартового состояния - 0 расхождений, инвариант «in_wb ->
//     wb_ram_q=1» на всех достижимых состояниях; (б) дифференциальная
//     симуляция двух RTL (v3.9 и v3.9.1 в одном тестбенче, общий
//     стимул): все выходы/шины/лог ОЗУ бит-в-бит на направленных
//     сценариях (запись ОЗУ с новым ALE-циклом и сменой адреса посреди
//     WB - защита п.5, PUSH-стресс, IO/ПЗУ записи, ALE-глюк в T2,
//     cpu_rst в каждой фазе WB1..WB4, «дыхание» защёлки, TX-захват,
//     POR) и на случайном стимуле, 0 расхождений; спеки /WE = ровно
//     80 нс и t_AS >= 40 нс соблюдены.
//     ЦЕНА/ВЫГОДА (по фиту v3.9): -1 МЦ (88 -> 87; wb_ram_q = FB2_17,
//     зарытая, пина нет), -5 ПТ (214 -> ~209), FB1 -1 вход; факт
//     подтверждает фит владельца (п.3 TODO, чек-лист g/h).
//
// ЧТО ИЗМЕНЕНО в v3.9.2 (2026-10-30, делитель: кольцо -> счётчик,
// линия lowsize, clk10-65):
// 17) КОЛЬЦО one-hot N=7 ЗАМЕНЕНО ДВОИЧНЫМ СЧЁТЧИКОМ mod-7 (директива
//     владельца: «работаем над снижением размера HDL дизайна в CPLD»;
//     линия beta/lowsize, база v3.9.1). Мотивация по фиту v3.9
//     (10-29 8:45PM): 88/108 МЦ, входы ФБ 202/216 (исчерпаны FB1/FB3/
//     FB6 по входам, FB4 по МЦ), узел тактирования = 8 триггеров
//     (r0..r6 + x1_n). Кольцо в v3.8 выбрали ради входной ренты
//     (декоды равенства ели входы ДВУХ ФБ), но МЦ-бюджет оно платит
//     сполна: 7 триггеров состояния. Двоичный mod-7 хранит то же
//     состояние в 3:
//     - cnt[2:0]: двоичный 0..6 по posedge, wrap по декоду cnt==6,
//       INIT=000 (легальная орбита); нелегальное 111 недостижимо, а
//       при внешнем попадании восстанавливается за 1 фронт
//       (7+1 = 8 -> переполнение 3 бит -> 000);
//     - фаза X1 - КОМБИНАЦИОННАЯ: X1 = (cnt != 0) ^ x1_n - точный
//       эквивалент (~r0) ^ x1_n кольца (состояние k кольца <=>
//       cnt==k, включая INIT: r0=1 <=> cnt=0). Узор X1 «1111100»
//       (high 100 / low 40 нс), X2 = (cnt == 0) ^ x1_n = ~X1 ТОЧНО,
//       фронты РОВНО через 140 нс, CLK CPU 280 нс 50/50 - БИТ-В-БИТ
//       v3.9;
//     - x1_n: set cnt==3 / clear cnt==4 (NEGEDGE) - те же фазы, что
//       r3/r4 кольца, импульс 40 нс в [140,180) периода 280 нс;
//     - por_ce = (cnt == 1) | (cnt == 6) - те же состояния, что
//       r1|r6: интервалы 200/80 нс, POR = 8 x 140 = 1120 нс БИТ-В-
//       БИТ v3.9 (пара {0,1} дала бы один импульс 80 нс за период ->
//       POR 2240 нс - ЗАБРАКОВАНО по требованию эквивалентности);
//     - ЦЕНА: декоды равенства ВЕРНУЛИСЬ в узел (класс п.9 - фиттер
//       трижды терял полярность декодов в фятах 10-22); теперь они
//       3-битные и дешёвые, чек-лист h) требует сверку уравнений по
//       таблице истинности; ядра X1/X2 выросли 2 -> 4 ПТ (SOP
//       инверсии декода cnt!=0 = cnt0|cnt1|cnt2);
//     - ЭКОНОМИЯ: -4 МЦ (8 -> 4 триггера узла; прогноз 88 -> 84/108,
//       85 если фиттер выделит por_ce в хелпер-МЦ), ПТ ~+11..+36
//       (репликация por_ce в por_sh_D против хелпера), входы ФБ:
//       FB4 -4 (r0..r6 -> cnt0..2), ядра X1/X2 +2 входа;
//     - ЭКВИВАЛЕНТНОСТЬ ДОКАЗАНА ДВУМЯ СТУПЕНЯМИ:
//       (1) дифсимуляция двух RTL (v3.9.1 и v3.9.2 в одном тестбенче,
//           общий стимул: POR, чтения/записи/writeback шины, порты
//           SEG/DIG/SND/KBCOL/KBROW, TX v3.7, ALE-глюки, cpu_rst) -
//           ВСЕ выходы бит-в-бит, 0 расхождений (scripts/tb_v392_diff.v,
//           Icarus Verilog 12.0);
//       (2) узел побитно против точной модели кольца v3.9 на 200 мкс
//           + перебор состояний cnt (scripts/sim_v392_div7.py: фронты
//           140 нс, duty 71/29, X2=~X1, por_ce 200/80, POR 1120 нс,
//           CPU 280 нс 50/50, живучесть из любого состояния);
//     - ПОСЛЕДСТВИЯ: нет (частоты, терминал 6857 8N1, тайминги шины,
//       TX, порты - без изменений; откат - RTL v3.9.1, .jed v3.9
//       10-29 8:45PM известен хороший).
//
// ЧТО ИЗМЕНЕНО в TXCLIENT v1 (2026-11-01, папка beta/txclient, база v3.9.2;
// директива владельца: «нам не нужен TX [терминальный] - убери SOD; будем
// знать, когда процессор пишет в область вывода UART; дизайн в beta/txclient»):
// 18) SOFT-UART ПЕРЕДАЧА (SOD-транзит v3.7) УДАЛЕНА, ВМЕСТО НЕГО - АППАРАТНЫЙ
//     МОНИТОР ЗАПИСЕЙ CPU В СТРАНИЦУ-ОКНО ОЗУ + UART-ПЕРЕДАТЧИК В ПК:
//     - sod_q/tx_pass/tx_q (3 МЦ) удалены; SOD (P72) - вход-наблюдатель
//       без нагрузки (* keep *); TX (P39) теперь выход сериализатора
//       (shreg[0] в IO-MC - регистровое качество вывода v3.7 сохранено);
//     - приём НЕ тронут: CH340G.TXD -> RX (P38) -> транзит -> CPU.SID
//       (RIM 20h) - «на ввод процессор продолжает осуществлять приём
//       сам программным способом» (директива владельца);
//     - ПРОТОКОЛ: программа пишет байт в страницу WIN_PAGE (localparam,
//       F000h-F0FFh), CPLD сам, БЕЗ портов и БЕЗ участия прошивки:
//       (1) в T1 цикла записи (ALE=1) декод win_hit = !IOM &&
//           {A15..A8}==WIN_PAGE -> hold_req=1 -> CPU.HOLD (P81, ВЫХОД
//           вместо прежнего PGND - «рубильник DMA без пайки» стал
//           схемой); HOLD стабилен задолго до T2 -> ВМ85А сэмплирует
//           его в T2 ЭТОГО ЖЕ машинного цикла, HLDA - в конце его же
//           (следующих циклов нет - addr_latch/bus_reg не перезаписать);
//       (2) T2: данные записи штатно в bus_reg (захват v3 не тронут);
//           writeback WB1..WB4 в ОЗУ идёт КАК В v3.9.2 - запись не
//           теряется и не дублируется (при HLDA CPU флоат, WB чист);
//       (3) после HLDA (синхронизатор hlda_q, 1 ступень - прецедент
//           sod_q; вход квазистатический) и возврата FSM в IDLE -
//           пакет 2 байта 8N1: [addr_lo (A0-A7 из addr_latch)]
//           [data (bus_reg)]; старший байт адреса = WIN_PAGE,
//           КОНСТАНТА (ПК знает её): 2 байта вместо 3 - это -8 FF и
//           -10 бит-периодов: 3-байтовый пакет требует +8 FF под
//           захват A8-A15 (во время HLDA AH-пины флоат) и НЕ ЛЕЗЕТ
//           в 108 МЦ при базе v3.9.2 - многостраничное окно можно
//           добавить только после экономии в базе;
//       (4) в момент загрузки 2-го байта в shreg hold_req/tx_req
//           СНИМАЮТСЯ - CPU покидает HLDA и работает, пока хвост
//           пакета доезжает (задержка вывода ~11-13 мкс на запись);
//       (5) пока CPU вне шины (hold_req | hlda_q = tx_hold), CS_n/
//           CSr_n гасятся жёстко: A15/IOM CPU ФЛОАТ и живой декод
//           выбирал бы память случайно (в v3.9.2 HLDA не бывал -
//           защита новая; выбор ОЗУ в WB по-прежнему от FSM, п.16);
//     - БОД: 25 МГц/13 = 1 923 077,8 8N1 (localparam BAUD_DIV;
//       115200 - перестраховка снята по вопросу владельца «почему не
//       на большей частоте»: CH340G держит до 2 Мбит, от кварца 12 МГц
//       даёт ~1 923 077 с ошибкой <0,2%, допуск 8N1 ~4%); счётчик бода
//       сбрасывается при загрузке КАЖДОГО байта - дрожь фронтов 0
//       тактов; альтернативы: 16 -> 1 562 500 (wrap без декода),
//       25 -> 1 000 000 (обоюдно точный: 25/25 и 12/12), 50 -> 500 000;
//     - чтение окна / исполнение кода из окна: CPU замирает на один
//       цикл (пинг-понг HOLD-HLDA БЕЗ пакета) - прошивке окно только
//       ЗАПИСЫВАТЬ; очередь НЕ нужна: hold_req пакета #2 взводится
//       ещё при работающем сериализаторе #1 (release - на загрузке
//       2-го байта) - потерь нет, потолок ~77 тыс. записей/с;
//     - ПОРТЫ НЕ ИСПОЛЬЗУЮТСЯ вовсе: 04h-07h в v3.9.2 - резерв от
//       удалённого UART (Task 69), в txclient не нужны (детект -
//       ТОЛЬКО по записи в страницу памяти, вопроса владельца о
//       «порте 07h» больше не существует);
//     - ЭКВИВАЛЕНТНОСТЬ БАЗЫ: вся логика v3.9.2 (делитель mod-7, POR,
//       FSM шины с writeback, порты 00h-03h, KBROW, транзит RX->SID)
//       байт-в-байт; изменения: -блок v3.7, +блок txclient, +гейты
//       CS_n/CSr_n (tx_hold), +выход HOLD, SOD -> наблюдатель;
//     - БЮДЖЕТ (прогноз от фита v3.9.2 85/108): -3 МЦ (sod_q/tx_pass/
//       tx_q) +22 лог. МЦ (hold_req/tx_req/hlda_q 3, tx_byte 2,
//       bit_cnt 4, baud_cnt 4, shreg 10 - shreg[0] в IO-MC P39) =
//       ~104/108 (хелперы декодов win_hit/baud_tick - до 105-106);
//       входы ФБ: 180 + 8 (AH8-AH14, HLDA с нагрузкой; A15 уже был)
//       - 1 (SOD) = ~187/216; ПТ ~209 + 25-40 = ~235-250/540; ноги
//       72/81 (SOD остаётся входом-наблюдателем, HOLD - выход);
//       PGND 9 -> 8 ({P74,P75,P76,P78,P79,P95,P96,P98}, P81 = ВЫХОД);
//       план Б при переборе: shreg 10 -> 8 бит с синтезом start/stop
//       на bit_cnt (-2 МЦ, +3-4 ПТ, TX станет комбинационным мульти-
//       плексором - хуже фронтов; только если фит не ляжет);
//     - ВЕРИФИКАЦИЯ ДО ФИТА (scripts/): tb_txclient.v (Icarus, у
//       владельца; в песочнице iverilog недоступен) + sim_txclient.py
//       (модель FSM+монитора+сериализатора, ПРОГНАН: бит = ровно
//       13 тактов, содержимое пакетов, HOLD в T1 окна, релиз на
//       загрузке 2-го байта, гейты CS в tx_hold, негативные: не-окно,
//       IO-запись, чтение окна, бэку-ту-бэк, сброс посреди пакета).
//
//
// ЧТО ИЗМЕНЕНО в TXCLIENT v2 (2026-11-01; вопрос владельца «захват большей
// страницы ОЗУ чем 4К не получается?» - ПОЛУЧАЕТСЯ: ВСЯ память, предел снят):
// 19) ОКНО F0xx РАЗВЁРНУТО В ВСЁ ОЗУ + ПОЛНЫЙ 16-БИТНЫЙ АДРЕС В ПАКЕТЕ:
//     - в v1 считалось: «3-байтовый пакет требует +8 FF под захват A8-A15
//       (во время HLDA AH-пины флоат), 112 > 108 - не лезет». ТРЮК v2
//       снимает +8 FF ПОЛНОСТЬЮ: hi-байт НЕ ХРАНИМ В ОТДЕЛЬНОМ РЕГИСТРЕ -
//       он грузится ПРЯМО В shreg стробом захвата T2 (первый тик !WRn,
//       AH-пины ЕЩЁ ЖИВЫ - CPU в цикле записи, HOLD взят в T1) и шлётся
//       ПЕРВЫМ. Байт 2 = addr_latch (A0-A7), байт 3 = bus_reg (данные) -
//       оба уже в регистрах базы. Регистров в txclient НЕ ПРИБАВИЛОСЬ;
//     - ТРИГГЕР: запись в ОЗУ = !IOM && A15 && S0 && !S1 (статус ВМ85А:
//       MW = IO/M#=0, S1=0, S0=1; OF/MR = S1=1; HALT = S0=S1=0) -
//       статус стабилен с начала машинного цикла, сэмплируется с ALE в T1.
//       ЧТЕНИЯ БОЛЬШЕ НЕ ТОРМОЗЯТ ВОВСЕ (в v1 чтение окна = пинг-понг
//       HOLD-HLDA 1-2 мкс; при полном ОЗУ без S0/S1 замирал бы КАЖДЫЙ
//       доступ к памяти - S0/S1 в v2 ОБЯЗАТЕЛЬНЫ);
//     - ПАКЕТ 3 БАЙТА 8N1: [A15..A8][A7..A0][данные] - ПК сам решает, что
//       это (видеобуфер/терминал/лог), CPLD - прозрачный логгер записей
//       (директива владельца «на ПК определяется запись в какой регион
//       происходит»); A15 в hi-байте всегда 1 - ПК может сверять;
//     - ЦЕНА: HOLD ДО КОНЦА ПАКЕТА (в v1 релиз был на загрузке 2-го
//       байта): раньше релиза байт 3 ещё не в shreg, а hi СЛЕДУЮЩЕЙ
//       записи при работающем CPU грузился бы в работающий shreg ->
//       порча хвоста пакета #1. HOLD = T1..конец пакета = 30 бит x
//       520 нс ~ 15,7 мкс/запись; пакет 30 бит = 15,6 мкс; потолок
//       ~55 тыс. записей/с (v1: ~77 тыс.); экран 80x25 = 2000 байт
//       ~ 36 мс; одиночная запись ~16-18 мкс до посылки;
//     - ИСКЛЮЧЕНИЕ СТРАНИЦЫ: localparam EXCL_PAGE = 8'hFF - страница FFh
//       (стек/переменные fw_mon FFE8-FFF8) НЕ пишется в поток и НЕ
//       тормозит CPU (win_hit=0): иначе каждый CALL/PUSH стоил бы
//       +15,6..31 мкс. 8'h00 = без исключений (страница 00 = ПЗУ, всё
//       равно не пишется; сравнение с другой страницей - литералы те же);
//     - РЕЛИЗ hold_req - В КОНЦЕ ПАКЕТА (TXB_DAT, стоп-бит); защитная
//       ветка IDLE (hold_req && hlda_q && state==S_IDLE) сохранена:
//       если пакет НЕ стартовал (ложный взвод - глюк S0/S1), HOLD
//       снимается без пакета (пинг-понг, как чтение в v1);
//     - tx_req УДАЛЁН (-1 МЦ): факт записи подтверждает сам !WRn в T2;
//       классификация записи/чтения - по S0/S1 в T1; двойная загрузка
//       shreg исключена (!wr_seen - первый тик строба, и TXB_IDLE);
//     - СТАРТ ПАКЕТА - в T2, ДО HLDA/WB: TX - отдельная нога, с шиной
//       не воюет; WB1..WB4 и рукопожатие HOLD-HLDA идут во время
//       передачи байта 1 - задержка вывода не растёт от ожидания HLDA;
//     - БЮДЖЕТ (от фита v3.9.2 85/108): -3 МЦ (soft-UART v3.7) +21 лог.
//       МЦ (hold_req, hlda_q, tx_byte<1:0>, bit_cnt<3:0>, baud_cnt<3:0>,
//       shreg<9:1>, shreg<0> в IO-MC P39) = ~103/108 (хелперы декодов -
//       до 104-105); ПТ ~240-260/540 (+8-16 на загрузку ah_bus в shreg,
//       -8-10 на упрощение win_hit/релиза против v1); вх. ФБ ~195/216
//       (+8: ah_bus в ФБ сериализатора; сами AH-пины уже в матрице с v1);
//       ноги 72/81 БЕЗ ИЗМЕНЕНИЙ - UCF v1 ПОДХОДИТ БЕЗ ПРАВОК;
//     - ВЕРИФИКАЦИЯ ДО ФИТА: scripts/sim_txclient_v2.py (цикл-точная
//       модель: 3 кадра/пакет и содержимое hi/lo/data, сетка 13 тиков,
//       HOLD в T1 записи и релиз В КОНЦЕ пакета, чтение/IO/ПЗУ/страница-
//       исключение без HOLD, ложная классификация -> защитный релиз,
//       бэку-ту-бэк, сброс посреди пакета, гейты CS в tx_hold) +
//       scripts/tb_txclient.v у владельца (Icarus).
//
// ЧТО ИЗМЕНЕНО в TXCLIENT v3 (2026-11-01; фит v2 у владельца 11-1 9:26AM:
// Placement Failed - здесь разбор и лекарство):
// 20) СЕРИАЛЬНЫЙ ЗАХВАТ hi-байта - AH-ПИНЫ ВХОДЯТ РОВНО В 1 ФБ:
//     - ДИАГНОЗ ФИТА v2 (retro_pcld_top.rpt 11-1 9:26AM, XC95108-15-PQ100):
//       MC 90/108, ПТ 328/540 - есть запас; УЗКОЕ МЕСТО - входы ФБ: 216/216
//       (100%, все 6 ФБ 36/36*), ERROR:Cpld:891 "Cannot place signal
//       shreg<4>. Too many function block inputs required", 21 узел не
//       размещён (shreg<2,4,5,7>, addr_latch<0..6>, hlda_q, por_sh<3..7>,
//       state_FSM_FFd2, bit_cnt<1>, $OpTx$-хелперы), 6хWARNING:Cpld:896 в
//       FB3 (буферы BUFR D<5..1>,TX - +6 МЦ). ПРИЧИНА: параллельная
//       загрузка ah_bus в shreg (п.19) требует входы {A15,AH14..AH8} В
//       КАЖДЫЙ ФБ, ГДЕ ЛЕЖИТ ТРИГГЕР shreg - а shreg расползается по
//       3-4 ФБ (FB2/FB4/FB6 в провалившемся фите) = +8-9 вх. х 3-4 ФБ,
//       плюс коллапс: D-функции shreg по 25-29 входов (shreg<6> 28,
//       shreg<3> 29, shreg<1> 26); сверху - входы FSM/счётчиков/POR.
//       Дополнительно: UCF НЕ ПРИМЕНИЛСЯ - HOLD встал на P95 (земля
//       флэш-A16!), P81 ушёл в unused (заземлилась бы) - фит собран БЕЗ
//       beta/txclient/top_txclient.ucf; ПЕРЕ-ФИТОВАТЬ ТОЛЬКО С НИМ;
//     - ЛЕКАРСТВО (v3): hi-байт НЕ грузится параллельно - он СДВИГАЕТСЯ
//       В shreg С ЖИВЫХ AH-ПИНОВ: 10 тиков подряд (25 МГц) в shreg<9>
//       заходят [старт=0, A8, A9, ..., A15, стоп=1], весь shreg тогдаже
//       сдвигается вправо (каждый тик!) - после 10-го тика кадр
//       [старт][A8..A15][стоп] ЛЕЖИТ В shreg ГОТОВЫЙ (старт-бит уже в
//       shreg[0]), cap_run падает и TX сразу уходит в '0' - кадр 1
//       emerges сам. МУЛЬТИПЛЕКСОР ВХОДА (8:1 по ah_rev + 2 константы)
//       нужен ТОЛЬКО shreg<9> - AH-ПИНЫ ВХОДЯТ В 1 ФБ вместо 3-4
//       (экономия ~16-24 вх.ФБ против v2 - провал устранён по построению);
//     - МЕХАНИКА: cap_run (1 триггер) ставится тем же стробом (state==S_T2
//       && !WRn && !wr_seen && hold_req && TXB_IDLE), счётчик фазы -
//       ШТАТНЫЙ bit_cnt (0..9, новых триггеров нет); во время фазы case
//       (tx_byte) не выполняется (ветка cap_run), защитный релиз IDLE
//       недостижим; TX = shreg[0] | cap_run (IO-MC: 1 ПТ, +1 литерал) -
//       во время захвата TX='1' (чистый idle, джанк сдвига не виден);
//     - ТАЙМИНГ ЗАХВАТА: старт захвата - на тик ПОСЛЕ первого !WRn (перепад
//       state в T2; строб !wr_seen), 10 тиков сдвига = ~440 нс от спада WR#.
//       ОКНО ВАЛИДНОСТИ AH-пинов: CPU держит адрес весь цикл записи и
//       флоатит ТОЛЬКО после HLDA (конец цикла + квитанция) = ~650-700 нс
//       от спада WR# - захват завершается с запасом >=130 нс; WR# сам низок
//       ~500-560 нс. Старт-бит начинается на ~440 нс позже, чем в v2 - на
//       фоне пакета 15,6 мкс не видно; протокол ПОЛНОСТЬЮ ТОТ ЖЕ
//       ([hi][lo][data], бит 520 нс) - ПК-софт не меняется;
//     - БЮДЖЕТ: +cap_run (1 МЦ) против v2 = 85 - 3 + 22 лог. МЦ = ~104/108
//       (как у v1!); ПТ +15-20 (мультиплексор in_9 ~10 ПТ в ОДНОМ МЦ,
//       D_9 = !cap | in_9, гейт TX) = ~250-270/540; вх.ФБ ~200-204/216
//       (против 216/216 ПРОВАЛА v2: +8 AH в 1 ФБ, +cap_run в 3-4 ФБ,
//       +bit_cnt уже там); ножки/UCF - без изменений, шить С
//       beta/txclient/top_txclient.ucf (HOLD = P81!);
//     - ПЛАН Б (RTL не трогая): в ISE Process Properties -> Fit ->
//       "Collapsing Input Limit" 36 -> 20-24 (фитайтер сам просил:
//       ERROR 891 "Consider reducing the collapsing input limit") -
//       запрет коллапса заставит вынести загрузки ah_bus в хелпер-МЦ
//       (запас 18 МЦ есть); попробовать на v2, если v3 не ляжет;
//     - ВЕРИФИКАЦИЯ: scripts/sim_txclient_v3.py (фаза захвата цикл-точна:
//       ровно 10 тиков, TX='1' всю фазу, старт-бит на тике 10, кадры
//       [hi][lo][data] - протокол тот же) + scripts/tb_txclient_v3.v.
//
// ЧТО ИЗМЕНЕНО в TXCLIENT v4 (2026-11-01; фит v3 у владельца 11-1 11:02AM:
// СНОВА Placement Failed - здесь разбор и лекарство):
// 21) РЕГИСТРОВЫЕ ХЕЛПЕРЫ adv_q/ld_q + shreg 10 -> 9 БИТ - ДЕКОДЫ СЧЁТЧИКОВ
//     ВЫНУТЫ ИЗ D-ФУНКЦИЙ shreg:
//     - ДИАГНОЗ ФИТА v3 (retro_pcld_top.rpt 11-1 11:02AM, XC95108-15-PQ100,
//       заархивирован: retro_pcld_top (v3-fit-1101-1102AM-FAILED).rpt):
//       MC 91/108 размещено + 15 узлов НЕ РАЗМЕЩЕНО (реальная потребность
//       106/108), ПТ 331/540 - запас; УЗКОЕ МЕСТО ТО ЖЕ - входы ФБ 216/216
//       (все 6 ФБ 36/36*), ERROR:Cpld:891 "Cannot place signal por_sh<0>",
//       не разместились: hold_req__or0000_D2 (24 вх.!), shreg<2,6,7,8,9>,
//       por_sh<0..7>, rd_drive_D2. Сериальный захват v3 СДЕЛАЛ СВОЁ
//       (AH-пины в 1 ФБ: D-функции битов shreg 25-29 -> 16-22 вх.), НО
//       КАЖДАЯ ЗАГРУЗКА КАДРА ВСЁ ЕЩЁ НЕСЁТ ПОЛНЫЙ ДЕКОД: baud_tick
//       (4 вх) + bit_cnt==9 (4 вх) + tx_byte (2 вх) = 10-11 литералов
//       х 2-3 загрузки НА КАЖДЫЙ БИТ shreg, и это КОПИРУЕТСЯ В КАЖДЫЙ ФБ,
//       ГДЕ ЛЕЖИТ БИТ (фит разложил shreg по FB2/FB4/FB5/FB6) = ~80-100
//       слотов входов на сериализатор против ~45-50 при упаковке в 1-2 ФБ.
//       Input Limit 28 (Compiler Options) - декоды в лимит ВЛЕЗАЮТ, но
//       дублирование по ФБ - нет; Collapsing Input Limit в фите НЕ трогался;
//     - ЛЕКАРСТВО (v4): два ХЕЛПЕРА-ТРИГГЕРА:
//         adv = (tx_byte != IDLE) && baud_tick;  ld = adv && (bit_cnt==9);
//         adv_q <= adv;  ld_q <= ld;
//       выход триггера НЕ РАСТВОРИМ в D-функциях потребителей (коллапс
//       физически невозможен) - каждый ФБ с битом shreg платит 1 вход
//       вместо ~10. D-функция бита shreg сжимается с 16-22 до ~9 входов
//       (adv_q, ld_q, сосед, источник, tx-селект, RST/por) -> ВСЕ 9 бит
//       shreg упаковываются в 1-2 ФБ (~45-50 слотов вместо ~80-100);
//       hold_req.D ~24 -> ~20 (релиз конца пакета = ld_q + tx_byte вместо
//       развёрнутого декода baud/bit/tx);
//     - shreg 10 -> 9 БИТ: стоп-бит НЕ ХРАНИТСЯ - его подставляет ИНЖЕКТ
//       '1' при сдвиге ({1'b1, shreg[8:1]}): после 9 сдвигов shreg == все
//       '1' = idle, ОТДЕЛЬНАЯ idle-загрузка (10'h3FF в v2/v3) УДАЛЕНА - в
//       конце кадра 3 меняются только tx_byte/hold_req. Кадры 2/3 грузятся
//       как {addr_latch / bus_reg, 1'b0} (9 бит, старт в b0);
//     - ЗАХВАТ hi-байта 10 -> 8 ТИКОВ: старт-бит НЕ сдвигается с AH - он
//       ПРЕДЗАГРУЖАЕТСЯ (shreg <= 9'h000 на старте захвата: b0=0 = старт,
//       b8..b1 = 0 вымываются 8 сдвигами); мультиплексор входа стал ЧИСТЫМ
//       8:1 (ah_rev[bit_cnt[2:0]] - БЕЗ констант старта/стопа и БЕЗ 3-бит
//       вычитания v3); TX = shreg[0] | cap_run прячет и предзагрузку;
//     - ФАЗИРОВКА СЕТКИ: в конце захвата baud_cnt <= 4'd1 (НЕ 0!): первый
//       тик сдвига кадра приходит на 12-м такте, сдвиг (adv_q) - на 13-м
//       ПОСЛЕ спада TX - старт-бит РОВНО 13 тиков; загрузки кадров - по
//       ld_q (на такт ПОЗЖЕ baud_tick), НО baud_cnt НЕ трогается -
//       свободный ход держит сетку 13 тиков и зазоры 0 (симуляция: фронты
//       кадров точно на сетке S1+130*k);
//     - ПРОВОД НЕ ИЗМЕНИЛСЯ ВОВСЕ: [hi][lo][data] 8N1, бит 520 нс, кадр
//       ровно 130 тиков, зазоры 0, HOLD до конца пакета, релиз в стоп-бит
//       кадра 3 (+1 такт к v3 - не видно). ПК-софт БЕЗ ПРАВОК;
//     - БЮДЖЕТ: MC 106 (потребность v3) + 2 хелпера - 1 (9-й бит shreg)
//       = ~107/108; ПТ ~330-350/540 (мультиплексор проще v3: минус
//       константы и вычитание); вх.ФБ ~185-205/216 - ЗАПАС впервые с v2;
//       ноги/UCF - без изменений, шить С beta/txclient/top_txclient.ucf
//       (HOLD = P81!);
//     - ПЛАН Б (если 107-й МЦ или входы всё же не лягут): (а) ISE Fit ->
//       "Collapsing Input Limit" 36 -> 20-24 (ERROR 891 сам просит; на v4
//       докручивает упаковку хелперов); (б) +1 МЦ: вынести защитный релиз
//       в регистр rel_q = hold_req && hlda_q && state==S_IDLE && TXB_IDLE
//       && !cap_run; (в) por_sh 8 -> 4 (БАЗА - только с одобрения!);
//     - ВЕРИФИКАЦИЯ: scripts/sim_txclient_v4.py (фаза захвата цикл-точна:
//       ровно 8 тиков, предзагрузка старт-бита, TX='1' всю фазу, старт-бит
//       на тике 9 от первого !WRn; сетка 13 тиков, зазоры 0, кадры
//       [hi][lo][data]; HOLD весь пакет) + scripts/tb_txclient_v4.v.
//
// ЧТО ИЗМЕНЕНО в TXCLIENT v5 (2026-11-01; фит v4 у владельца 11-1 6:16PM:
// ТРЕТИЙ Placement Failed - здесь разбор и лекарство; вопрос владельца
// «может всё таки перейти к захвату конкретного региона ОЗУ, скажем
// 8000-C000?» - ДА, окно принято, НО одного окна мало - главное лекарство
// в п.22.2/22.3):
// 22) ОКНО 8000h-BFFFh + СЕРИАЛЬНАЯ ПРЕДЗАГРУЗКА кадров 2/3 + СТРОБ
//     «ТОЛЬКО ВЗВОД» - ПОЛНЫЙ УХОД ОТ ПАРАЛЛЕЛЬНЫХ ЗАГРУЗОК shreg:
//     - ДИАГНОЗ ФИТА v4 (retro_pcld_top.rpt 11-1 6:16PM, XC95108-15-PQ100,
//       заархивирован: retro_pcld_top (v4-fit-1101-618PM-FAILED).rpt):
//       MC 94/108 размещено + 12 узлов НЕ РАЗМЕЩЕНО (реальная потребность
//       106/108 - В ЛИМИТЕ!), ПТ 307/540 - запас, ноги 73/81 - запас;
//       УЗКОЕ МЕСТО ТО ЖЕ - входы ФБ 212/216 (98%, свободно 4 слота на
//       ВЕСЬ кристалл), ERROR:Cpld:892 "Cannot place signal shreg<8>" +
//       WARNING 897 (буферизация A<4> в FB1); не разместились shreg<1..8>
//       (10-14 ПТ, 17-27 вх.), baud_cnt<1..3> (6-9 ПТ, 17-19 вх.),
//       por_sh<1> (3 ПТ/6 вх. - не влез из-за 4 свободных слотов ВОВСЕ).
//       Хелперы adv_q/ld_q СДЕЛАЛИ СВОЁ (декоды кадров больше не копируются
//       в биты shreg - v3-диагноз снят), НО остались три жира: (а)
//       ПАРАЛЛЕЛЬНЫЕ ЗАГРУЗКИ {addr_latch / bus_reg, 1'b0} в конце кадров -
//       8+8 источников данных + декоды ld_q/tx_byte в КАЖДЫЙ ФБ с битом
//       shreg; (б) 9-литеральный СТРОБ ЗАХВАТА (state==S_T2 & !WRn &
//       !wr_seen & hold_req & TXB_IDLE) с предзагрузкой shreg<=000
//       размазан по 13 регистрам (9 бит shreg + 4 baud_cnt); (в) win_hit
//       с 7-литеральным декодом EXCL_PAGE держит AH8-14 в FB6:
//       hold_req__or0000_D2 = 10 ПТ/23 вх., HOLD = 8 ПТ/19 вх.;
//     - ЛЕКАРСТВО 22.1 (вопрос владельца): ОКНО = 8000h-BFFFh (A15 & !AH14,
//       2 литерала вместо 7): AH8-13 уходят из FB6, hold_req__or0000_D2
//       растворяется (hold_req.D ~3 ПТ/~11 вх., HOLD ~2-3 ПТ/~9 вх.),
//       стек fw_mon (FFEx-FFF8) и C000-FFFF - вне окна ПО ПОСТРОЕНИЮ
//       (стек - и БЕЗ HOLD, как и было; расширение окна = +6 литералов -
//       именно это не лезло в v2-v4);
//     - ЛЕКАРСТВО 22.2: кадры 2/3 грузятся в shreg СЕРИАЛЬНО, ВО ВРЕМЯ
//       ПЕРЕДАЧИ предыдущего кадра (классический двойной буфер): вход
//       shreg<8> на тике bc кадра N = бит (bc-1) кадра N+1: bc0 -> '1'
//       (стоп текущего кадра), bc1 -> '0' (старт следующего - только если
//       кадр ЕСТЬ), bc2..9 -> addr_latch[bc-2] (кадр 2) / bus_reg[bc-2]
//       (кадр 3) / '1' (кадра 4 нет - idle-заполнение). ПАРАЛЛЕЛЬНЫХ
//       ЗАГРУЗОК БОЛЬШЕ НЕТ: D-функция бита shreg<8:1> = 3 ПТ/~5 вх.
//       (сосед, cap_run, adv_q) - ВСЕ 9 бит ложатся в ОДИН ФБ по
//       построению; источники данных (AL/D/AH) - только в мультиплексорах
//       in_cap/in_frame, каждый в СВОЁМ МЦ;
//     - ЛЕКАРСТВО 22.3: строб захвата = ТОЛЬКО взвод cap_run (8 литералов
//       в ОДНОМ триггере вместо размазки на 13): предзагрузка shreg<=000
//       УДАЛЕНА (старт-бит заходит через in_cap на bc==0), bit_cnt/baud_cnt
//       в стробе НЕ трогаются (bit_cnt==0 в TXB_IDLE - структурный
//       инвариант: ld_q в конце кадра 3 и сброс пишут 0; baud_cnt
//       фазируется jam'ом <=1 в конце захвата), !wr_seen из строба УДАЛЕНА
//       (повторный старт блокирует !cap_run: со 2-го тика !WRn cap_run уже
//       1 - состояние то же, минус 1 литерал);
//     - ЗАХВАТ hi-байта 8 -> 9 ТИКОВ (bc 0..8): старт-бит НЕ предзагружен,
//       а заходит через мультиплексор на bc==0; последнее чтение AH - на
//       400-й нс от спада WR# (окно валидности AH до флоата после HLDA
//       650-700 нс - запас ~250 нс; в v4 было 360);
//     - ФАЗИРОВКА: старт-бит кадра 1 виден на тике 10 от первого !WRn
//       (в v4 - на 9-м: фаза захвата длиннее на такт); ДАЛЬШЕ СЕТКА ТА
//       ЖЕ: baud_cnt<=1 в конце захвата -> старт-бит ровно 13 тиков,
//       зазоры 0, кадр ровно 130 тиков (симуляция: фронты на сетке
//       S1+130*k). ПРОВОД НЕ ИЗМЕНИЛСЯ: [hi][lo][data] 8N1, бит 520 нс -
//       ПК-софт БЕЗ ПРАВОК;
//     - БЮДЖЕТ: МЦ ~105-107/108 (v4: потребность 106; -hold_req__or0000_D2,
//       +in_cap/in_frame - 1-2 хелпер-МЦ); ПТ ~330-360/540; вх.ФБ
//       ~170-195/216 - ЗАПАС впервые с v1; ноги 73/81, UCF БЕЗ ПРАВОК
//       (AH8-14 - входы мультиплексора in_cap, A15 - in_cap и win_hit);
//     - ПЛАН Б (если не влезет): (а) ISE Fit -> Properties -> "Collapsing
//       Input Limit" 36 -> 24-28 (fitter сам просил в ERROR 892; все узлы
//       уже мелкие - докрутит упаковку без новых МЦ); (б) окно сужать
//       ЕЩЁ (A15 & !AH14 & !AH13 = 8000-9FFF и т.п.); (в) por_sh 8 -> 4
//       (БАЗА - только с одобрения!);
//     - ВЕРИФИКАЦИЯ: scripts/sim_txclient_v5.py (фаза захвата цикл-точна:
//       ровно 9 тиков, старт-бит заходит через мультиплексор, TX='1' всю
//       фазу, старт-бит на тике 10 от первого !WRn; СЕРИАЛЬНАЯ предзагрузка
//       кадров 2/3 - байты совпадают бит-в-бит с v4; сетка 13 тиков, зазоры
//       0; HOLD весь пакет; окно: FFxx И C000-FFFF - без HOLD/пакета;
//       записи 8000/8001/B37E - пакет с полным 16-битным адресом) +
//       scripts/tb_txclient_v5.v.
//
// ЧТО ИЗМЕНЕНО в TXCLIENT v6 (2026-11-01; фит v5 у владельца 11-1 7:31PM:
// ЧЕТВЁРТЫЙ Placement Failed - здесь разбор и лекарство; окно НЕ сужается,
// новых триггеров НОЛЬ):
// 23) ИСТОЧНИКИ КАДРОВ 2/3 СДВИГАЮТСЯ К LSB - ИНЖЕКЦИЯ ОДНОГО ПРОВОДА:
//     - ДИАГНОЗ ФИТА v5 (retro_pcld_top.rpt 11-1 7:31PM, XC95108-15-PQ100,
//       заархивирован: retro_pcld_top (v5-fit-1101-731PM-FAILED).rpt):
//       МЦ 103/108 размещено + 8 узлов НЕ РАЗМЕЩЕНО (потребность ~111/108 -
//       ПЕРЕЛИВ ~3 МЦ, впервые считаемся и по МЦ!), ПТ 383/540 - запас,
//       ноги 73/81 - запас; УЗКОЕ МЕСТО ПО-ПРЕЖНЕМУ входы ФБ 213/216
//       (99%, 5 из 6 ФБ по 36/36), ERROR:Cpld:892 "Cannot place signal
//       shreg<8>" (18 ПТ/26 вх.); не разместились shreg<8>, bit_cnt<1>,
//       tx_byte_FSM_FFd2, hold_req__or0000 (5 ПТ/17 вх.), дубли
//       A<3>_BUFR/A<4>_BUFR (по 10 ПТ/12 вх. - WARNING 896, FB1
//       переполнен) и 2 хелпера mux ($OpTx$1712/1718). Хелперы 22.2
//       СДЕЛАЛИ СВОЁ (shreg<1..7> РАЗМЕСТИЛИСЬ - в фите v4 не размещался
//       НИ ОДИН; por_sh/baud_cnt тоже легли), НО: мультиплексор in_frame
//       ВСЁ РАВНО тащит 8+8 источников (addr_latch[bc-2] ИЛИ bus_reg[bc-2])
//       - XST свернул его ЦЕЛИКОМ в shreg<8>.D = 26 входов (18 ПТ) -
//       в такой ФБ не помещается. Окно 8000-BFFF сработало (AH8-13 из FB6
//       ушли: hold_req__or0000 23 -> 17 вх.), но 17 всё равно много при
//       забитых ФБ;
//     - ЛЕКАРСТВО 23.1: addr_latch и bus_reg СДВИГАЮТСЯ ВПРАВО (к LSB)
//       СИНХРОННО с инжекцией: тик adv_q с bc=2..9 кадра N читает
//       addr_latch[0]/bus_reg[0] И СДВИГАЕТ регистр ({1'b0, r[7:1]}):
//       за 8 тиков мимо инжекции проходят ВСЕ 8 бит (A0..A7 / D0..D7),
//       к концу кадра регистр = 0. in_frame худеет с 26 до ~8 входов
//       (bc, tx_byte, addr_latch[0], bus_reg[0], константы), mux-хелперы
//       ($OpTx$ с литералами D(i)/addr_latch(i), i>0) УМИРАЮТ, D-функция
//       shreg<8> становится размещаемой. НОВЫХ ТРИГГЕРОВ НОЛЬ - регистры
//       уже есть; цена - 3 ПТ на бит (терм сдвига adv_q & TXB & bc>=2)
//       в addr_latch<7:0>/bus_reg<7:0>;
//     - БЕЗОПАСНОСТЬ БАЗЫ: сдвиг начинается с bc=2 ПЕРВОГО кадра - это
//       ~1,9 мкс после WR#(вверх); writeback (WB1..4, A/D-пины гонят
//       addr_latch/bus_reg) кончается через ~0,2 мкс - ЗАПАС ~1,7 мкс
//       (симуляция: в окне WB регистры НЕ трогаются, ОЗУ принимает
//       запись штатно; при TD6-тесте содержимое кадров бит-в-бит как v5).
//       Вне пакета регистры НЕ сдвигаются (условия TXB_HI/TXB_LO + adv_q),
//       загрузка в T1/T2 - прежняя (приоритет загрузки выше - else-if);
//     - ПРОГНОЗ: -4..-6 хелпер-МЦ ($OpTx$1712/1713/1716/1717/1718/1719
//       умирают вместе с 16-источниковым mux), дубли A<3:4>_BUFR
//       складываются обратно в FB1 (минус 2 МЦ) -> МЦ ~102-106/108
//       (перелив 3 МЦ закрыт); вх.ФБ ~185-205/216 (минус 14-16 импортов
//       AL/D в ФБ shreg<8>, минус импорты хелперов); ПТ ~350-380/540
//       (+24-40 сдвиги, минус 40-60 mux); ноги/UCF БЕЗ ПРАВОК;
//     - ПРОВОД НЕ ИЗМЕНИЛСЯ ВОВСЕ: [hi][lo][data] 8N1, бит 520 нс, кадр
//       130 тиков, зазоры 0, HOLD до конца пакета. ПК-софт БЕЗ ПРАВОК;
//     - ПЛАН Б (если не влезет): (а) ISE Fit -> Properties ->
//       "Collapsing Input Limit" 36 -> 24-28 (ERROR 892 сам просит; узлы
//       уже мелкие - докрутит упаковку без новых МЦ); (б) окно ЕЩЁ уже
//       (A15 & !AH14 & !AH13 = 8000-9FFFh); (в) BAUD_DIV 13 -> 16 (бод
//       1 562 500, натуральный wrap минус декод ==12); (г) por_sh 8 -> 4
//       (БАЗА - только с одобрения!);
//     - ВЕРИФИКАЦИЯ: scripts/sim_txclient_v6.py - 55/55 ПАСС (2026-11-02;
//       модель РОВНО по RTL: инжекция СТАРОГО LSB + сдвиг источников в
//       шинном движке с приоритетом ниже загрузки). Всё из v5 + сдвиг
//       источников структурно (T12): в окне WB (WB1..WB4) регистры ЦЕЛЫ
//       (/WE 2 тика, /CE ОЗУ=0 - writeback состоялся); на 1-й инжекции
//       (bc=2 кадра 1) addr_latch ещё цел; addr_latch=0 к началу кадра 2,
//       bus_reg=0 к началу кадра 3; содержимое кадров бит-в-бит как v5
//       ([80][12][5A], порядок A8->A15 - тест 0xB3, границы BFFF/C000)) +
//       scripts/tb_txclient_v6.v.
//
// 24) TXCLIENT v7 (2026-11-03; база v3.9.3 - директива владельца
//     «на основе последнего lowsize дизайна можно попробовать txclient»):
//     СБРОС ЛОГИКИ И СЕРИАЛИЗАТОРА ПЕРЕВЕДЁН НА СЕТЬ GSR. Что было
//     (база v3.9.2 во всех фитах txclient): cpu_rst = RST | por_run
//     входил СИНХРОННО в D-функции ВСЕХ триггеров (Task 25); в
//     проваленном фите v5 (rpt 11-1 7:31PM) фиттер развёрнул его в
//     RST x151 + por_run x155 = 306 литералов сброса (+12 импортов RST/
//     por_run во все 6 ФБ) - прямое давление на узлы, не разместившиеся
//     в v4/v5 (shreg<8> 18ПТ/26вх, bit_cnt<1>, tx_byte_FSM_FFd2,
//     hold_req__or0000). Мера доказана на v3.9.3 (фит 11-2, железо
//     ПАСС): литералы 133 -> 3, вх.ФБ 180 -> 171/173, ПТ 209 -> 192/195.
//     Что стало: ОБА always-блока (шинный движок 38 триггеров:
//     state/rd_seen/wr_seen/addr_latch/bus_reg/seg_q/dig_q/snd_q/
//     kbcol_q + сериализатор 24: hold_req/hlda_q/cap_run/tx_byte/
//     bit_cnt/baud_cnt/shreg/adv_q/ld_q) описаны АСИНХРОННО (posedge
//     clk or posedge RST, if (RST)) - фиттер сводит общий асинхронный
//     сброс на СЕТЬ GSR (пин P1 и так GSR/I/O): минус ~306 литералов,
//     минус ~12 импортов ФБ; wire cpu_rst УДАЛЁН (в коде 0 упоминаний;
//     RESET_IN считает RST|por_run напрямую - без изменений).
//     ВНЕ ДОМЕНА GSR (сознательно, бит-в-бит v3.9.3):
//       - por_sh/por_run: POR только по питанию (INIT=FF/1), повторный
//         POR невозможен (после 00 сдвиг держит нули);
//       - делитель cnt/x1_n: X1 не глушится при сбросе (свойство v3.9).
//     ЗАЩИТА ОКНА POR (класс v3.9.3 п.18 + СПЕЦИФИКА txclient): FSM и
//     сериализатор в окне POR живые (GSR не активен), шина CPU в сбросе
//     «floated» (ВМ85А: управления/адрес/данные в 3-м состоянии):
//       - вход в writeback ГЕЙТЕТСЯ (!por_run в S_T2) - импульс /WE в
//         окне POR невозможен ПО ПОСТРОЕНИЮ (как v3.9.3);
//       - взвод hold_req ГЕЙТЕТСЯ (!por_run в T1H) - НОВОЕ, аналога в
//         v3.9.3 не было (там не было HOLD-движка): floated A/S0/S1 не
//         взводят hold_req; БЕЗ гейта came HOLD/HLDA в окне POR, а
//         floated WRn в T2 родил бы ложный захват и мусорный кадр в TX
//         (cap_run возможен ТОЛЬКО при hold_req=1 - второго гейта не
//         нужно).
//     ПОВЕДЕНИЕ (отличия от v6): сброс стал АСИНХРОННЫМ - нажатие SW20
//     мгновенно гасит FSM и пакет (HOLD падает сразу, TX -> '1' сразу,
//     shreg -> 1FF через SET-ветку GSR; v6 - на такт позже). Нормальные
//     циклы шины и пакеты бит-в-бит v6 (дифсимуляция).
//     РИСК GSR (recovery/removal при снятии кнопки асинхронно к
//     25 МГц) - класс-риск XC9500, как v3.9.3: самозатухающий (FSM в
//     IDLE, оба гейта стоят, защитный релиз IDLE сохранён) -
//     осознанный компромисс; на v3.9.3 железом НЕ проявился (плата
//     11-2 прошита и работает).
//     ВЕРИФИКАЦИЯ: (1) scripts/sim_txclient_v7.py - все сценарии v6 +
//     НОВОЕ (п.24): hostile-«плавания» шины в окне POR (пор_run=1) -
//     ноль /WE, ноль HOLD, ноль TX-активности, ноль cap_run; сброс
//     посреди пакета гасит HOLD мгновенно (GSR-семантика, не на такт);
//     пост-сбросные состояния бит-в-бит значениям RST-ветки; (2)
//     scripts/tb_txclient_v7.v - для владельца (Icarus).
//     ЭКОНОМИКА: план Б п.23 не тронут (Collapsing Input Limit 24-28,
//     окно 8000-9FFF, BAUD_DIV 16); GSR-мера закрывает и «por_sh 8->4»
//     (см. п.18 lowsize: POR 560 нс < нормы 840 - нелегально; GSR
//     дешевле и тайминги CPU не трогает).
//
// 25) TXCLIENT v8 (2026-11-03; МЕРА М1 из аудита фита 1 v7, ОДОБРЕНА
//     владельцем «Делай M1»): POR-ЦЕПОЧКА por_sh 8 -> 4 БИТА СО СТРОБОМ
//     ВДВОЕ РЕЖЕ. Что было (v3.9.2/v7): por_sh 8 бит, строб por_ce =
//     (cnt==1)|(cnt==6) - 2 строба/период cnt 280 нс (интервалы {200,80}
//     нс, в среднем 140 нс) - наследие требования БИТ-В-БИТ v3.9; в фите
//     1 v7 декод por_ce (6 литералов) фиттер реплицировал во ВСЕ 8
//     T-цепей por_sh (FTCPE: T_k = por_ce AND (sh[k] XOR sh[k+1])).
//     Что стало: por_sh<3:0> (INIT=F); в ветке g_div2p5 строб por_ce =
//     x1_n - регистровый импульс 40 нс в [140,180) каждого периода cnt
//     (п.17), РОВНО ОДИН posedge-строб за период ПО ПОСТРОЕНИЮ. ТРИ
//     ПРИЧИНЫ выбора x1_n (а не декода одного состояния cnt):
//       1) декодов равенства в POR-пути ТЕПЕРЬ НЕТ ВОВСЕ - класс фитов
//          7:31/8:55 («por-декоды с потерянной инверсией», п.8 шапки)
//          остаётся исключён (в v7 декод возвращался: 2 ПТ по 3 литерала
//          в каждой из 8 T-цепей);
//       2) T-цепь бита худеет до x1_n AND (sh[k] XOR sh[k+1]) - 2 ПТ/3
//          литерала (por_sh<3> - 1 ПТ/2 литерала: в сдвиг входит '0');
//       3) цена строба - 1 импорт ФБ (x1_n) вместо 3 (cnt<0..2> в фите
//          1 v7 разбросаны по ФБ1/ФБ2/ФБ6).
//     ТАЙМИНГ: POR = 4 x 280 = 1120 нс; норма 3 такта CLK OUT = 840 нс
//     @ 3,57 МГц - запас по номиналу 1,33x (как в v3.4/v3.8/v7); от
//     INIT фактический низ RESET_IN ~1040 нс (первый строб x1_n на
//     t=160 нс, снятие por_run на 26-м такте 25 МГц; в v7 было ~1160 нс)
//     - ОБЕ величины >= нормы. Возражение п.18 lowsize («por_sh 8->4:
//     POR 560 нс < 840») считало СТАРЫЙ строб 2/период (4 x 140 = 560)
//     - со стробом 1/период мера легальна. Точка осциллографа чек-листа
//     «RESET_IN низ ~1,04 мкс» (см. «Что делать» п.4).
//     ЭКОНОМИКА (арифметика аудита от фита 1 v7): потребность МЦ 114 ->
//     110: минус por_sh<7:4> (-4 МЦ; вся четвёрка por_sh<3:0> - в ФБ2:
//     18/18* -> 14), на оставшихся 4 битах -8 ПТ (T-цепи 2ПТ/5лит ->
//     2ПТ/3лит) и минус ПТ/вх.ФБ самих убранных бит; триггеров 71 (75-4);
//     62 регистра GSR-домена НЕ ИЗМЕНИЛИСЬ. МЦ всё ещё впритык (110 >
//     108) - shreg<8> (18ПТ/19вх, ERROR:Cpld:892) М1 НЕ ЛЕЧИТ; далее по
//     плану аудита: М2 (Collapsing Input Limit 28 -> 18, В ISE ПОСЛЕ
//     М1), М3/М4 - резервы.
//     ГРАНИЦЫ: X1/X2/CLK/шина/пакеты БИТ-В-БИТ v7 (por_ce нагружен
//     ТОЛЬКО в por-цепь; окно POR той же длительности, наружу не видно);
//     por_sh/por_run ВНЕ домена GSR - как v7 (POR только по питанию,
//     повторный POR невозможен: после 0000 сдвиг держит нули).
//     FALLBACK-ветки делителя (g_div2/g_div4/g_div_even/g_div_odd):
//     por_ce СВОИ (не тронуты), por_sh там тоже 4 бита - POR = 4 x
//     период строба >= нормы 3 такта CLK у ВСЕХ веток (коэффициент
//     4/3; в целевых сборках ветки элайзятся).
//     ВЕРИФИКАЦИЯ: (1) scripts/sim_txclient_v8.py - все сценарии v7 +
//     НОВОЕ T0: цикл-точная модель POR-цепи (cnt mod-7 + x1_n +
//     por_sh<3:0> + por_run): стробы ровно каждые 7 тиков (280 нс),
//     ровно 4 сдвига (F->7->3->1->0), por_run падает на 26-м такте
//     (1040 нс >= 21 такта нормы), повторного POR нет (0000 держится
//     1000 тиков), все сценарии v6/v7 без изменений; (2)
//     scripts/tb_txclient_v8.v - для владельца (Icarus): T0 -
//     структурная проверка por_sh 4'hF -> 4'h0 и por_run 1 -> 0 без
//     возврата.
//
// Что делать владельцу (TODO, ред. txclient v8; база v3.9.3/GSR):
//  1) в ISE-проекте заменить top_suart.v на ЭТОТ файл (Set as Top Module);
//  2) UCF: beta/txclient/top_txclient.ucf (= hdl/top_suart.ucf + NET
//     "HOLD" LOC = "P81"; остальные ноги без изменений; clk = P29 GCK3);
//  3) фит и .rpt НА АУДИТ ДО ПРОШИВКИ (чек-лист ниже). Обязательные
//     точки v3.9.2 (делитель-счётчик mod-7): ветка g_div2p5 - cnt<2:0>
//     (3 триггера, двоичный 0..6, wrap по декоду cnt==6), INIT: cnt=
//     RESET (000 - легальная орбита); x1_n (Init=RESET, NEGEDGE clk,
//     D=(cnt==3) OR (x1_n AND NOT(cnt==4))); X1 = NOT(cnt==0) XOR x1_n,
//     X2 = (cnt==0) XOR x1_n - комбинационные XOR-выходы, регистров
//     на пинах НЕТ (если фиттер поднял в регистр - проверить init-пару
//     X1/X2 и фазу на осциллографе); ДЕКОДЫ РАВЕНСТВА В УЗЛЕ ЕСТЬ (п.17)
//     - СВЕРЯТЬ ПО УРАВНЕНИЯМ чек-листа h) (класс п.9: фиттер трижды
//     терял полярность декодов в фятах 10-22); r0..r6/x1_p/x2_p/
//     t0_q/x1_q/x2_q/wb_ram_q в нетлисте ОТСУТСТВУЮТ; por_sh<3:0> - сдвиг
//     4 бита (v8/М1 п.25: INIT=F; T-цепи = x1_n AND (sh[k] XOR sh[k+1])
//     - 2 ПТ/3 литерала; ДЕКОДОВ cnt В POR-цепи БЫТЬ НЕ ДОЛЖНО -
//     появились: фит собран из СТАРОГО исходника v7), por_run.D =
//     por_sh[0], por_run Init=SET; state = 3 триггера.
//     ТОЧКИ TXCLIENT v6: hold_req (Init=RESET; выход HOLD P81), hlda_q,
//     cap_run (фаза захвата, Init=RESET), tx_byte<1:0> (4 состояния:
//     IDLE/HI/LO/DAT), bit_cnt<3:0> (штатный счётчик кадров И фазы
//     захвата), baud_cnt<3:0> (wrap по декоду baud_cnt==12 при
//     BAUD_DIV=13), shreg<8:0> - shreg<0> в IO-MC TX P39 (Init=SET -
//     idle '1'; TX = shreg[0] | cap_run - 1 ПТ), adv_q/ld_q (РЕГИСТРОВЫЕ
//     хелперы п.21, Init=RESET - в нетлисте быть ОБЯЗАНЫ и НЕ
//     коллапсировать), in_cap (mux AH-пинов) и in_frame (инжекция ОДНОГО
//     провода: addr_latch[0] ИЛИ bus_reg[0], п.23 - хелпер-МЦ или
//     растворены в shreg<8>.D, оба варианта легальны); в shreg<8:2>
//     литералов addr_latch/bus_reg БЫТЬ НЕ ДОЛЖНО, в shreg<8>.D
//     допустимы РОВНО addr_latch[0] и bus_reg[0] (литералы с индексами
//     1-7 появились - фит собран из СТАРОГО исходника); в addr_latch<7:0>
//     и bus_reg<7:0> ДОЛЖНО быть слагаемое сдвига п.23 (adv_q & TXB_HI/LO
//     & bc>=2 & сосед) - нет: фит из старого исходника;
//     tx_req В НЕТЛИСТЕ
//     БЫТЬ НЕ ДОЛЖНО (удалён в v2!); sod_q/tx_pass/tx_q В НЕТЛИСТЕ
//     БЫТЬ НЕ ДОЛЖНО (soft-UART v3.7 удалён!) - появились: собран
//     СТАРЫЙ исходник;
//  3a) v7 (GSR, п.24): в .rpt - "Global set/reset net(s) used",
//     "GSR : 1"; литералов RST/por_run в D-функциях ЛОГИКИ и
//     СЕРИАЛИЗАТОРА НЕТ (v5: RST x151 + por_run x155 = 306 - должны
//     ИСЧЕЗНУТЬ); cpu_rst в нетлисте НЕТ; уравнение RESET_IN =
//     (por_run) OR (RST) СОХРАНИЛОСЬ; два гейта !por_run на месте
//     (S_T2->WB1 и взвод hold_req); por-цепь и cnt/x1_n - без GSR;
//     v8 (М1 п.25): por_sh<3:0> - 4 бита со стробом x1_n, декодов cnt
//     в POR-цепи НЕТ.
//     ЕСЛИ GSR НЕ применился - rpt НА РАЗБОР, НЕ прошивать (фит
//     функционально корректен, но мера не сработала);
//  4) ПАСС -> .jed в плату; осциллограф: X1 = 7,14 МГц (период ровно
//     140 нс, high 100 / low 40), X2 = 7,14 ПРОТИВОФАЗА (два луча -
//     решает и вопрос полярности X2), RESET_IN низ ~1,04 мкс по
//     питанию (v8/М1: 4 строба x 280 нс, снятие на 26-м такте 25 МГц;
//     в v7 было ~1,12-1,16 при 8 x 140), CLKOUT = 3,57 МГц duty 50%; НОВОЕ: TX P39 idle '1',
//     после ЗАПИСИ в ОЗУ 8000-BFFF - пакет 3 байта 8N1, бит 520 нс;
//     HOLD P81 '1' от T1 цикла записи ДО КОНЦА пакета (30 бит),
//     HLDA cpu9 '1' между; ЧТЕНИЯ ОЗУ HOLD НЕ ДАЮТ (S0/S1); запись
//     в FFxx (стек) И в C000-FFFF (вне окна, п.22) - HOLD/пакета нет;
//  5) ПК: приёмник 1 923 077 8N1 (CH340G произвольный бод - сниппет
//     termios/BOTHER в beta/txclient/README.md); пакет: [адрес A15-A8]
//     [адрес A7-A0][данные] - фильтрация по региону и рендер на ПК;
//     альтернативные BAUD_DIV: 16 -> 1 562 500, 25 -> 1 000 000,
//     50 -> 500 000.
//
// -- ЧЕК-ЛИСТ .rpt ПОСЛЕ ФИТА v3.4 (пройтись по распечатке глазами!) --
//  a) clk = P29 (GCK3, знак "User Assigned"), RST = P1 (GSTR);
//  b) ВСЕ constraint-ноги со знаком "~" (фиттер НЕ переставлял);
//  c) PGND (Unused IO Ground) = РОВНО {P74,P75,P76,P78,P79,P95,P96,P98}
//     - 8 шт (P81 = ВЫХОД HOLD txclient и P73 = выход SID, в PGND БЫТЬ
//     НЕ ДОЛЖНЫ);
//  d) входы на местах (INP): X2 P69, RSTOUT P70, SOD P72 (наблюдатель
//     БЕЗ нагрузки - следить, чтобы фиттер не выкинул пин), INTAn P80,
//     HLDA P82 (ТЕПЕРЬ С НАГРУЗКОЙ - синхронизатор txclient), CLKOUT
//     P83, S0 P94, S1 P89, AH8 P10, AH9 P12, AH10 P18, AH11 P14,
//     AH12 P4, AH13 P8, AH14 P3, RX P38, A15 P97;
//  e) выходы: READY P87='1', CS1 P99='1', TX P39=shreg[0] (IO-MC
//     регистр сериализатора txclient), SID P73=RX (транзит), HOLD P81
//     =hold_req ('1' на время пакета; в покое '0' = прежний PGND),
//     X1 P68 (XOR NOT(cnt==0)^x1_n, v3.9.2), X2 P69 (XOR (cnt==0)^x1_n
//     = ~X1, v3.9.2);
//  f) v6 (база v3.9.2): GSR НЕ использовался (сброс через D-gating,
//     Task 25). v7 (п.24): СЕТЬ GSR ИСПОЛЬЗУЕТСЯ: "Global set/reset
//     net(s) used" + "GSR : 1" в Pin Resources; строка RST в Node
//     Listing - тип GSR/I/O с признаком GSR (P1, буфер GSR/I); в
//     D-уравнениях ЛОГИКИ и СЕРИАЛИЗАТОРА нет защит "NOT RST"/
//     "NOT por_run" (v5: 306 вхождений - должны ИСЧЕЗНУТЬ); RST в
//     списках входов ФБ - не более 1 (ФБ RESET_IN); por_run - только
//     у RESET_IN и двух гейтов (!por_run в hold_req.D и переходе
//     S_T2->WB1); RESET_IN = (por_run) OR (RST) СОХРАНИЛОСЬ; por_sh/
//     por_run/cnt/x1_n - БЕЗ GSR (9 регистров); 62 регистра логики и
//     сериализатора - async SR по RST (GSR), у shreg<8:0> - SET
//     (INIT 1FF, TX idle '1' в сбросе). ЕСЛИ "Global set/reset net(s)
//     unused" СОХРАНИЛОСЬ - фиттер не дал частичный GSR: фит
//     функционально корректен (PT-сбросы), но мера не сработала -
//     rpt НА РАЗБОР, НЕ прошивать;
//  g) MC < 108 (прогноз ~95 после v3.2: +x1_n, +2 por_cnt, +wb_ram_q, +8 txm_cnt;
//     -1 триггер автомата: 8 состояний = 3 триггера; v3.1: POR_W 14->6 = -8; v3.2: +1 por_run;
//     v3.6: ~98 - ветка div4 (-t0_q,-x1_q,-x2_q) заменена на cnt(3)+x1_p+x1_n+x2_p (+6));
//     v3.7: -txm_cnt (-8 FF и декод txm_run), +sod_q/tx_pass/tx_q
//     (tx_q/sod_q - в IO-MC пинов TX/SOD, логических +1) -> прогноз ~94/108;
//     v3.8: делитель 4+3 -> 5+1 триггера (cnt<3> фита v3.6 - балласт
//     4-го бита) -> прогноз ~93/108; входы ФБ 197 -> ~191 (узел платил
//     7 входов в FB6 и 5 в FB4 - теперь 6 и 0..2));
//     Maximum Frequency >> 25 МГц;
//     v3.9.2: узел 8 -> 4 триггера (кольцо r0..r6+x1_n -> cnt<2:0>+x1_n)
//     -> прогноз ~84/108 МЦ (85, если фиттер выделит por_ce в
//     хелпер-МЦ); ПТ ~214 -> ~225-250 (ядра X1/X2 по 4 ПТ + x1_n 4 ПТ
//     + cnt 4-7 ПТ; por_ce репликацией в por_sh_D или хелпером);
//     входы ФБ ~202 -> ~196-208 (FB4: r0..r6 -> cnt0..2, -4);
//     txclient v1: -3 МЦ (sod_q/tx_pass/tx_q) +22 лог. МЦ -> ~104/108
//     (история);
//     txclient v2 (п.19): -3 МЦ (soft-UART v3.7) +21 лог. МЦ (hold_req,
//     hlda_q, tx_byte<1:0>, bit_cnt<3:0>, baud_cnt<3:0>, shreg<9:1>,
//     shreg<0> в IO-MC P39) -> прогноз ~103/108 (хелперы декодов -
//     до 104-105); ПТ ~240-260 (+8-16 на загрузку ah_bus в shreg);
//     вх. ФБ ~195/216 (+8: ah_bus в ФБ сериализатора); tx_req НЕТ;
//     ног 72/81, UCF v1 без правок; плана Б нет - запас вернулся;
//     txclient v4 (п.21): +2 хелпера (adv_q/ld_q) -1 (shreg 9 бит) ->
//     потребность 106/108, НО входы ФБ 212/216, 12 узлов не размещено
//     (ПРОВАЛ, п.22);
//     txclient v5 (п.22): окно 8000-BFFF (-6 литералов в win/hold),
//     сериальная предзагрузка кадров 2/3 (в shreg - только сосед+
//     cap_run+adv_q), строб = взвод cap_run (1 триггер вместо 13):
//     прогноз был ~105-107/108 МЦ - ФАКТ ФИТА v5: 103/108 + 8 UnMapped
//     (shreg<8> 18ПТ/26вх, bit_cnt<1>, tx_byte_FFd2, hold_req__or0000
//     17вх, A<3:4>_BUFR, 2 mux-хелпера) = ~111; вх.ФБ 213/216, ПТ 383/540
//     (ПРОВАЛ, п.23);
//     txclient v6 (п.23): сдвиг источников кадров к LSB (инжекция 1
//     провода, mux-хелперы умирают, дубли A<3:4>_BUFR складываются):
//     прогноз ~102-106/108 МЦ, вх.ФБ ~185-205/216, ПТ ~350-380; план Б:
//     Collapsing Input Limit 24-28;
//     txclient v7 (п.24): GSR-сброс (база v3.9.3): минус 306 литералов
//     сброса, минус ~12 импортов RST/por_run; эффект меры доказан на
//     v3.9.3 (вх.ФБ -7..-9, ПТ -14..-17 при 133 литералах; здесь их
//     306 - выигрыш НЕ МЕНЬШЕ) -> прогноз МЦ ~100-105/108, вх.ФБ
//     ~178-198/216, ПТ ~335-375/540; триггеров 75 (v6: 75), ноги 73/81,
//     UCF без правок; shreg<8> ОБЯЗАН разместиться (его D худеет ещё
//     и от ухода cpu_rst-развёрток);
//     txclient v8 (п.25, М1): por_sh 8 -> 4 бита, строб por_ce = x1_n:
//     из фита 1 v7 потребность МЦ 114 -> 110 (минус por_sh<7:4>), ПТ
//     310 -> ~290-300, вх.ФБ 208 -> ~204; триггеров 71 (75-4), из них
//     62 в GSR-домене (без изменений); por-цепь без декодов cnt (T-
//     цепи = x1_n AND (sh[k] XOR sh[k+1])); shreg<8> (18ПТ/19вх,
//     ERROR:Cpld:892) М1 НЕ ЛЕЧИТ - следующий шаг М2 (Collapsing Input
//     Limit 28 -> 18, В ISE ПОСЛЕ М1);
//  h) в Equations (v3.9.2, счётчик mod-7): cnt - двоичный 0..6,
//     wrap по декоду cnt==6. Ожидаемые уравнения (D- ИЛИ T-реализация
//     - обе легальны, сверять ТАБЛИЦЕЙ истинности, не полярностью
//     одного терма; класс п.9 - фиттер трижды терял инверсию декода):
//       T-версия: cnt<0>: T = NOT(cnt2 AND cnt1); cnt<1>: T = cnt0;
//                 cnt<2>: T = cnt1 AND cnt0  (4 ПТ на три);
//       D-версия: D0 = NOT(cnt1) AND NOT(cnt0) OR NOT(cnt2) AND
//                 NOT(cnt0); D1 = NOT(cnt2) AND NOT(cnt1) AND cnt0 OR
//                 NOT(cnt2) AND cnt1 AND NOT(cnt0) OR cnt2 AND
//                 NOT(cnt1) AND cnt0; D2 = NOT(cnt2) AND cnt1 AND
//                 cnt0 OR cnt2 AND NOT(cnt1) AND NOT(cnt0);
//       Init cnt = RESET (000);
//     x1_n - NEGEDGE clk, D = (cnt==3) OR (x1_n AND NOT(cnt==4))
//     (~4 ПТ: NOT(cnt==4) = cnt2 OR cnt1 OR cnt0) (Init=RESET);
//     X1 = cnt0 AND NOT(x1_n) OR cnt1 AND NOT(x1_n) OR cnt2 AND
//     NOT(x1_n) OR NOT(cnt0) AND NOT(cnt1) AND NOT(cnt2) AND x1_n
//     (4 ПТ), X2 зеркально (4 ПТ) - комбинационные XOR-выходы БЕЗ
//     регистров на пинах (SOP РАЗЛИЧНЫ - same-D слияние невозможно,
//     п.10/17); por_ce = (cnt==1) OR (cnt==6) = NOT(cnt2) AND
//     NOT(cnt1) AND cnt0 OR cnt2 AND cnt1 (2 ПТ; DC на нелегальном
//     111) - либо разворот литералами в por_sh_D, либо хелпер-МЦ
//     (обе реализации легальны; хелпер = 85 МЦ вместо 84);
//     por_sh 8 бит (сдвиг вправо, 0 в MSB, por_ce - строб сдвига),
//     por_run.D = por_sh[0] (Init=SET); state = 3 триггера
//     (state_FSM_FFd1..3, без FFd4); v3.7: txm_cnt НЕТ - вместо него
//     sod_q/tx_pass/tx_q (3 FF, декодов НЕТ; tx_q и sod_q должны лечь
//     в IO-MC пинов TX P39 и SOD P72, tx_pass - лог. MC);
//     r0..r6/x1_p/x2_p/t0_q/x1_q/x2_q/wb_ram_q В НЕТЛИСТЕ БЫТЬ НЕ
//     ДОЛЖНО (кольцо удалено v3.9.2, защёлка - v3.9.1); CS_n -
//     уравнение от state_FSM_FFd1..3/A15/IOM БЕЗ литерала wb_ram_q.
//     r1.D = r0 AND NOT r2, r2.D = r1 AND NOT r3, r3.D = r2 AND NOT r4,
//     r4.D = r3 AND NOT r5, r5.D = r4 AND NOT r6, r6.D = r5 AND NOT r0
//     (по 1 птерму); r0.D = r6 AND NOT r1 AND NOT r0 OR (NOT r0 AND
//     NOT r1 AND NOT r2 AND NOT r3 AND NOT r4 AND NOT r5 AND NOT r6)
//     (2 птерма; второй - рестарт из 00); Init: r0=SET, r1..r6=RESET;
//     x1_n - NEGEDGE clk, D = (r3) OR (x1_n AND NOT(r4)) (Init=RESET);
//     X1 = NOT(r0) XOR x1_n, X2 = r0 XOR x1_n - комбинационные XOR-
//     выходы БЕЗ регистров на пинах (SOP по 2 птерма, функции РАЗНЫЕ -
//     same-D слияние невозможно, п.10/14/15); por_ce = r1 OR r6;
//     ДЕКОДОВ РАВЕНСТВА (==N) В УЗЛЕ БЫТЬ НЕ ДОЛЖНО - появились:
//     собран СТАРЫЙ исходник!; cnt/x1_p/x2_p/t0_q/x1_q/x2_q в нетлисте
//     ОТСУТСТВУЮТ (legacy-ветки элайзятся); por_sh 8 бит (сдвиг вправо,
//     0 в MSB), por_run.D = por_sh[0] (Init=SET); state = 3 триггера
//     (state_FSM_FFd1..3, без FFd4); v3.7: txm_cnt НЕТ - вместо него
//     sod_q/tx_pass/tx_q (3 FF, декодов НЕТ; tx_q и sod_q должны лечь
//     в IO-MC пинов TX P39 и SOD P72, tx_pass - лог. MC);
//     v3.9.1: wb_ram_q ОТСУТСТВУЕТ (была FB2_17, зарытая), МЦ 87;
//     v3.9.2: МЦ ~84-85 (узел 4 триггера), ПТ ~225-250, r0..r6
//     ОТСУТСТВУЮТ (кольцо заменено счётчиком cnt<2:0>);
//     txclient v2 (п.19): hold_req.D = hold_req OR (state==S_T1H) AND
//     ALE AND NOT(IOM) AND A15 AND S0 AND NOT(S1) AND NOT(ah==EXCL_PAGE)
//     (ah = {A15,AH14..AH8}; декод !=FFh - 8 литералов, ИЛИ-свёрнуты;
//     1-2 ПТ; Init=RESET, в покое HOLD P81='0' = прежний PGND);
//     hlda_q.D = HLDA (синхронизатор, 1 ступень - прецедент sod_q);
//     СТАРТ ПАКЕТА (T2, первый тик !WRn): shreg<9:1>.D = NOT(wr_seen)
//     AND hold_req AND TXB_IDLE AND {1, ah} - hi-байт адреса грузится
//     ПРЯМО В shreg (AH-пины живы, п.19); shreg - сдвиг вправо
//     {1, данные, start}, TX = shreg[0] из IO-MC P39 (Init=SET ->
//     idle '1'); перезагрузки в тиках конца стоп-бита: TXB_HI -> lo
//     (addr_latch), TXB_LO -> data (bus_reg), TXB_DAT -> idle 3FF +
//     hold_req<=0 (РЕЛИЗ В КОНЦЕ ПАКЕТА); защитная ветка TXB_IDLE:
//     hold_req<=0 при hold_req AND hlda_q AND (state==IDLE) (пакет не
//     стартовал); baud_cnt 0..12 при BAUD_DIV=13 (wrap-декод ==12;
//     при 16 - естественный перенос), сброс при загрузке КАЖДОГО
//     байта (дрожь фронтов 0); бит = РОВНО 13 тактов 25 МГц = 520 нс
//     (1 923 077 8N1); tx_req В НЕТЛИСТЕ БЫТЬ НЕ ДОЛЖНО (удалён в v2);
//     CS_n/CSr_n содержат литерал tx_hold = hold_req OR hlda_q
//     (гашение выбора памяти, пока CPU вне шины).
//     txclient v3 (п.20, СЕРИАЛЬНЫЙ захват): hold_req.D - как в v2;
//     cap_run.D = cap_run OR (state==S_T2) AND NOT(WRn) AND NOT(wr_seen)
//     AND hold_req AND TXB_IDLE (Init=RESET; clear - bit_cnt==9 в фазе);
//     shreg<9>.D = NOT(cap_run) OR in_9, in_9 = (bit_cnt==9) OR
//     SUM(bit_cnt==k+1) AND ah_rev[k], k=0..7 (ah_rev = {AH8..AH14,A15} -
//     ~11 ПТ в ОДНОМ МЦ - AH-пины только в 1 ФБ!); shreg<8:1>.D =
//     cap_run AND shreg<9:2> OR (TXB_HI AND бит9 AND addr_latch) OR
//     (TXB_LO AND бит9 AND bus_reg) OR (NOT cap_run AND shreg<9:2>)
//     (AH-пинов НЕТ!); shreg<0>.D = то же с бит1; bit_cnt в фазе
//     захвата тогглит КАЖДЫЙ тик (не по baud_tick); TX = shreg[0] OR
//     cap_run (IO-MC P39, 1 ПТ); [v2 (история провала): shreg<9:1>.D
//     содержали ah_bus параллельно - входы ФБ 216/216, ERROR 891].
//     [txclient v1 (история): hold_req.D = ... (адрес hi == WIN_PAGE);
//     tx_req.D = tx_req OR (state==S_T2) AND NOT(WRn) AND hold_req;
//     релиз на загрузке 2-го байта - в v2 заменено на релиз в конце
//     пакета и старт в T2.]
//     п.23.1 (ПРОВАЛ КОМПИЛЯЦИИ у владельца 11-2: XST HDLCompilers:28
//     "'...' has not been declared", x17 - al_shift/br_shift, bit_cnt,
//     tx_byte). В КОММИЧЕННОМ v6 все объявления БЫЛИ (строки 1472-1494),
//     а фронт-енд XST такой порядок «использование выше объявления»
//     пропускает - v5 с тем же построением (in_cap/in_frame выше reg
//     tx_byte/bit_cnt) СКОМПИЛИРОВАЛСЯ и дошёл до плейсмента (в .rpt v5
//     нет ни одной HDLCompilers, 94 упоминания bit_cnt в нетлисте).
//     Вывод: вероятная причина у владельца - НЕСИНХРОННАЯ локальная
//     копия rtl_txclient/top_txclient_v6.v без блока объявлений.
//     ЛЕКАРСТВО ДВОЙНОЕ. (1) Файл сделан стойким к ЛЮБОМУ компилятору:
//     блок объявлений сериализатора (BAUD_DIV, hold_req/hlda_q/cap_run,
//     tx_hold/win_hit, TXB_*, tx_byte/bit_cnt/baud_cnt/shreg, baud_tick,
//     adv/ld, adv_q/ld_q, in_cap/in_frame, al_shift/br_shift) вынесен
//     ПЕРЕД шинный движок, ВНУТРИ блока регистры подняты выше in_cap/
//     in_frame (мультиплексоры их читают) - объявление опережает
//     использование ВЕЗДЕ; текст выражений НЕ менялся - поведение
//     бит-в-бит как п.23. (2) СКОПИРОВАТЬ свежий файл в rtl_txclient/
//     и перекомпилировать; если ошибка повторится на свежем файле -
//     прислать полный список. Порядок объявлений отныне проверяется
//     автоматически: scripts/check_decl_order.py (ловит класс
//     HDLCompilers:28 до ISE; на v6-до правки даёт ровно набор XST).
//     txclient v7 (п.24): D-функции state/rd_seen/wr_seen/addr_latch/
//     bus_reg/seg_q/dig_q/snd_q/kbcol_q/hold_req/hlda_q/cap_run/
//     tx_byte/bit_cnt/baud_cnt/shreg/adv_q/ld_q - БЕЗ литералов
//     сброса (чистая логика); SR-входы 62 регистров логики и
//     сериализатора - RST (СЕТЬ GSR), у shreg<8:0> - SET (значение
//     1FF); por-цепь бит-в-бит v3.9.2 (por_sh сдвиг, por_run.D =
//     por_sh[0], Init=SET); hold_req.D = hold_req OR (state==S_T1H)
//     AND ALE AND win_hit AND NOT por_run (новый гейт п.24);
//     state: T2->WB1 = ... AND NOT por_run (гейт v3.9.3); cpu_rst в
//     нетлисте ОТСУТСТВУЕТ; RESET_IN = por_run OR RST (без изменений).
//=====================================================================
// История (как в v1/top_nouart, логика чтения не менялась):
// Топология: AD0-AD7 процессора, A0-A7 flash/SRAM и CPLD - ОДНА медь
// (сети A0..A7). CPLD = регистровый трансивер:
//   чтение: память видит адрес в T1 (ALE=1) -> данные на D0-D7
//   захватываются в последний тик T1 -> в T2 (CPU отпустил AD) CPLD
//   выдаёт данные на A-сети;
//   запись: в T2 CPU гонит данные по A-сетям (CPLD Hi-Z), CPLD захватывает;
//   после WR#(вверх) - «отложенная запись» (writeback): CPLD сам ставит
//   защёлкнутый адрес на A-сети + данные на D-сети и даёт импульс
//   /WE_RAM (в v3: импульс защищён от ALE, см. п.4 шапки).
// Метод захвата - повторное сэмплирование, пока строб активен (последний
// сэмпл гарантированно валиден); без edge-детекторов и PT-клоков - один
// домен 25 МГц (ARCHITECTURE.md v0.3, §4, §9.3).
// Сброс: SW20 -> RST (нажатие = 1, Task 25) + POR (v3.4: сдвиговый;
// 1120 нс @ 7,14 МГц в v3.9) -> RESET_IN=0;
// v7 (п.24): сброс ЛОГИКИ и СЕРИАЛИЗАТОРА - асинхронный по RST через
// СЕТЬ GSR; cpu_rst удалён; por_sh/por_run - вне домена (POR только
// по питанию); гейты !por_run - в S_T2->WB1 и на взводе hold_req.
// RAM подтверждена на железе (Task 69-j: 4 паттерна x 32K без ошибок,
// T=1280 нс; режим T=400 нс - этот файл; tb v3: T3b/T3d/T3e PUSH-stress).
//=====================================================================

module retro_pcld_top #(parameter POR_W = 6,    // v3.4: НЕ используется (POR - сдвиговый 8 бит, п.9 шапки); оставлен для совместимости тестбенча
                        parameter CLK_DIV = 2,  // v3.9.2: (2,1) = двоичный счётчик mod-7 -> X1 7,143 МГц (CPU 3,571, в ТУ, п.17); 4 -> 6,25 (v3.4); 2+HALF=0 -> 12,5 ВНЕ ТУ; 5 = XOR-пара legacy (п.9)
                        parameter CLK_HALF = 1) ( // v3.6: 1 = ветка g_div2p5 (учитывается ТОЛЬКО при CLK_DIV=2; v3.9.2: счётчик mod-7, п.17); 0 = старые целочисленные ветки; v3.7: параметр TXM_W УДАЛЕН вместе с TX-маской (п.13)
    // ---- такт и глобальный сброс ----
    input  wire       clk,          // 25 МГц (измерено Task 29-d: GCK3 = 25,00), U1.29 (P29)
    input  wire       RST,          // SW20, U1.1 (P1, GSR): покой = 0, нажатие = 1 (актив.1 - доказано платой, Task 25); v7: пин заведён на СЕТЬ GSR (п.24)
    // ---- шина i8085 (входы автомата) ----
    input  wire       ALE,          // cpu1 U1.93 (P93), нога 30
    input  wire       WRn,          // cpu2 U1.92 (P92), нога 31 (активный 0)
    input  wire       RDn,          // cpu3 U1.91 (P91), нога 32 (активный 0)
    input  wire       IOM,          // cpu5 U1.88 (P88), нога 34: 1=IO, 0=память
    input  wire       A15,          // U1.97 (P97) - декод памяти
    // ---- мультиплексированная шина AD0-AD7 = сети A0..A7 (bidir) ----
    inout  wire [7:0] A,            // A0=P26 A1=P21 A2=P19 A3=P17 A4=P15 A5=P13 A6=P11 A7=P9
    // ---- шина данных памяти (bidir) ----
    inout  wire [7:0] D,            // D0=P30 D1=P32 D2=P35 D3=P36 D4=P34 D5=P31 D6=P27 D7=P22
    // ---- управление памятью (активный 0) ----
    output wire       CSr_n,        // P20 /CE_ROM -> U10.22 (flash /CE)
    output wire       OEr_n,        // P16 /OE_ROM -> U10.24
    output wire       CS_n,         // P25 /CE_RAM -> U4.22  (RAM /CE)
    output wire       OE_n,         // P37 /OE_RAM -> U4.24
    output wire       WE_n,         // P24 /WE_RAM -> U4.29 (только writeback!)
    output wire       CS1,          // P99 CS(CE2) -> U4.30, константа '1'
    // ---- поддержка процессора ----
    output wire       X1,           // P68 cpu21, нога 1: 7,14 МГц (50/7, XOR NOT(cnt==0)^x1_n, период ровно 140 нс) -> CPU 3,57 МГц (v3.9.2, счётчик mod-7)
    output wire       READY,        // P87 cpu6, нога 35: константа '1' (без wait)
    output wire       RESET_IN,     // P84 cpu7, нога 36: активный 0 = ~(RST|POR)
    output wire       HOLD,         // P81 cpu10, нога 39: запрос DMA txclient (п.18; РАНЕЕ - PGND «HOLD=0»)
    // ---- soft-UART транзиты (Task 70-a) ----
    output wire       SID,          // P73 cpu17, нога 5 (CPU.SID): транзит RX -> приём (RIM 20h)
    output wire       TX,           // P39: цепь платы «RX» -> CH340G.RXD; TX = tx_q - регистровый транзит SOD с захватом (v3.7, SIM 30h)
    // ---- индикация и звук (выходы активным 0, §6) ----
    output wire [7:0] seg,          // {dp56,g,f,e,d,c,b,a} = P60/5/66/58/57/61/62/45
    output wire [3:0] dig,          // dig0..3 = P6/63/65/48 -> R -> VT1..VT4
    output wire       SND,          // P67 -> BUZZER1.1 (пассивный, прямой бит; A4 порта 01h)
    // ---- наблюдатели: «мёртвые» пины как Hi-Z входы (* keep *) ----
    // (* keep *) обязателен для ног БЕЗ нагрузки: без него XST выкидывает
    // входы (Xst:3005), а выкиннутый пин опция "Ground on Unused IOs"
    // ЗАЗЕМЛИТ - там выходы CPU и X2 (GND запрещён даташитом). ЭТО И ЕСТЬ
    // «ОШИБКА С НОГАМИ» ИЗ ФИТА владельца (Task 68-f).
    // RX (P38) используется (транзит в SID). SOD (P72) с TXCLIENT v1 -
    // наблюдатель БЕЗ нагрузки: keep ОБЯЗАТЕЛЕН (иначе Xst:3005 выкинет
    // пин, "Ground on Unused IOs" заземлит его - а это ВЫХОД CPU!)
    (* keep = "TRUE" *) output wire X2,  // P69 cpu20, нога 2: противофаза X1 (v3.9.2: (cnt==0) ^ x1_n, SOP(X2) != SOP(X1), п.10/17); keep - сеть отдельно (страховка, п.9)
    (* keep = "TRUE" *) input wire RSTOUT,    // P70 cpu19, нога 3
    (* keep = "TRUE" *) input wire SOD, // P72 cpu18, нога 4 (CPU.SOD): TXCLIENT - транзит УДАЛЁН,
                                        // вход-наблюдатель без нагрузки (заземлять НЕЛЬЗЯ - выход CPU)
    (* keep = "TRUE" *) input wire INTAn,     // P80 cpu11, нога 11
    (* keep = "TRUE" *) input wire HLDA,      // P82 cpu9,  нога 38
    (* keep = "TRUE" *) input wire CLKOUT,    // P83 cpu8,  нога 37
    (* keep = "TRUE" *) input wire S0,        // P94 cpu0,  нога 29: статус MW txclient v2 (п.19)
    (* keep = "TRUE" *) input wire S1,        // P89 cpu4,  нога 33: статус MW txclient v2 (п.19)
    (* keep = "TRUE" *) input wire AH8,       // P10 цепь A8,  нога 21 - адрес памяти
    (* keep = "TRUE" *) input wire AH9,       // P12 цепь A9,  нога 22
    (* keep = "TRUE" *) input wire AH10,      // P18 цепь A10, нога 23
    (* keep = "TRUE" *) input wire AH11,      // P14 цепь A11, нога 24
    (* keep = "TRUE" *) input wire AH12,      // P4  цепь A12, нога 25
    (* keep = "TRUE" *) input wire AH13,      // P8  цепь A13, нога 26
    (* keep = "TRUE" *) input wire AH14,      // P3  цепь A14, нога 27
    input  wire       RX,           // P38 цепь платы «TX» (CH340G.TXD) - теперь транзит в SID; заземлять НЕЛЬЗЯ (выход CH340G)
    // ---- клавиатура (Task 34) ----
    output wire       col0,         // P44 SW1/SW5/SW9/SW13/SW17 (KBCOL.0)
    output wire       col1,         // P43 SW2/SW6/SW10/SW14/SW18 (KBCOL.1)
    output wire       col2,         // P42 SW3/SW7/SW11/SW15/SW19 (KBCOL.2)
    output wire       col3,         // P41 SW4/SW8/SW12/SW16 (KBCOL.3; SW20 вне матрицы)
    input  wire       row0,         // P56 R25 подтяжка, SW1
    input  wire       row1,         // P55 R24, SW5
    input  wire       row2,         // P54 R23, SW9
    input  wire       row3,         // P52 R22, SW13
    input  wire       row4          // P51 R21, SW17
);

  //=============================================================
  // Делитель 25 МГц (v3.6 clk10-49; v3.8 one-hot кольцо clk10-52;
  // v3.9: кольцо РАСШИРЕНО 5 -> 7 триггеров, clk10-54).
  // ЦЕЛЕВАЯ ветка v3.9.2 - g_div2p5 (CLK_DIV=2, CLK_HALF=1 - селектор
  // исторический): N=7 -> X1 = 2x25/7 = 7,143 МГц (период 140 нс),
  // CPU = 3,571 МГц: двоичный счётчик mod-7 + XOR с комбинационной
  // фазой (cnt!=0) и x1_n. Декоды равенства ВЕРНУЛИСЬ в узел (класс
  // п.9 шапки!) - теперь 3-битные и дешёвые; уравнения-ожидания -
  // чек-лист h), выходы бит-в-бит v3.9 (доказано tb_v392_diff.v).
  // Целевые ветки v3.4 (div2/div4, без декодов) и legacy (нечётная,
  // fallback N>=6) сохранены для отката - при (2,1) элайзятся, в
  // нетлист не попадают.
  // ВНИМАНИЕ: старый HDLCompiler (ISE) НЕ принимает localparam и
  // reg-инициализаторы ВНУТРИ generate-блока -> выносим на scope модуля.
  //=============================================================
  reg [2:0] cnt = 3'd0;   // v3.9.2: ЦЕЛЕВАЯ g_div2p5 - двоичный mod-7 (0..6, п.17);
                          // fallback-ветки (N>=6, нечётные) элайзятся. Сужение [3:0]->[2:0]
                          // по рецепту v3.10: старшие биты - балласт МЦ; 3 бит хватает
                          // всем legacy N<=14 (MEV<=7)
  wire por_ce;

  // Константы делителя (на уровне модуля, не в generate!) - нужны
  // только fallback-ветке (чётные N>=6) и нечётной ветке
  localparam [3:0] MEV   = CLK_DIV / 2 - 1;   // для чётного N
  localparam [3:0] NMOD  = CLK_DIV - 1;       // для нечётного N
  localparam [3:0] NHALF = (CLK_DIV + 1) / 2; // =3 при /5 (НЕ 2!)

  // Триггеры делителя (reg) тоже на уровне модуля (инициализаторы
  // в generate тоже проблемные для этого XST). Неиспользуемые ветки XST вырезает.
  reg  x1_q = 1'b1;  // чётные 2/4 (откат): INIT=1, X1 стартует с '1'
  reg  t0_q = 1'b0;  // каскад полу-такта для CLK_DIV=4 (t0_q = clk/2)
  reg  x1_p = 1'b1;  // нечётная legacy-ветка (при (2,1) элайзится)
  reg  x1_n = 1'b0;  // ЦЕЛЕВАЯ v3.9.2 g_div2p5 (NEGEDGE): set cnt==3 / clear cnt==4
  reg  x2_q = 1'b0;  // v3.5: противофаза X2, чётные ветки (INIT=0 при x1_q=1)
  reg  x2_p = 1'b0;  // v3.5: двойник x1_p с инверсным INIT (нечётная legacy-ветка)
  // v3.9.2 (ЦЕЛЕВАЯ g_div2p5): состояние узла = cnt[2:0] - двоичный
  // mod-7 (п.17 шапки). Кольцо r0..r6 (v3.8/v3.9, 7 триггеров) УДАЛЕНО:
  // экономия 4 МЦ. Фаза X1 - комбинационный декод (cnt != 0) вместо
  // выхода триггера r0; x1_n остался (те же фазы, что r3/r4 кольца).
  // Эквивалентность выходов v3.9 бит-в-бит: tb_v392_diff.v.

  // v3.5: X2 - РЕГИСТР противофазы (п.10 шапки, clk10-41): каждая ветка
  // generate даёт СВОЙ драйвер X2 и свой регистр (x2_q / x2_p) с D,
  // ОТЛИЧНЫМ от D(x1) - same-D слияние невозможно по построению
  // (в v3.4 комб. ~X1 фиттер снова поднял в регистр В ФАЗЕ, п.9).
  // keep на порте X2 удерживает сеть отдельной (страховка).
  // v3.9.2: в g_div2p5 X2 = (cnt == 0) ^ x1_n; SOP(X2) != SOP(X1)
  // (инверсия декода фазы) - same-D слияние по-прежнему невозможно.

  generate
    if (CLK_DIV == 2 && CLK_HALF == 1) begin : g_div2p5
      // v3.9.2 ЦЕЛЕВАЯ ветка (двоичный счётчик mod-7, п.17 шапки):
      // X1 = 2x25/7 = 7,143 МГц, CPU = 3,571 МГц - ЧАСТОТЫ, УЗОР X1/X2
      // И POR БИТ-В-БИТ v3.9 (кольцо заменено счётчиком, экономия
      // 4 МЦ: 8 -> 4 триггера узла). Машина (узор по полутактам 20 нс:
      // X1 = "1111100" повтор, X2 = "0000011" повтор):
      //   cnt[2:0]: двоичный mod-7 (0..6) по posedge, wrap по декоду
      //     cnt==6, INIT=000 - ЛЕГАЛЬНАЯ орбита с 1-го такта,
      //     переходного процесса нет; нелегальное 111 недостижимо из
      //     орбиты, а при внешнем попадании само восстанавливается за
      //     1 фронт: 7+1 = 8 -> переполнение 3 бит -> 000 (перебор
      //     состояний в sim_v392_div7.py). Декоды равенства ВЕРНУЛИСЬ
      //     в узел (класс п.9!) - 3-битные, дешёвые; уравнения-
      //     ожидания - чек-лист h), сверять по таблице, не по поляр-
      //     ности одного терма;
      //   x1_n (NEGEDGE, INIT=0): set при cnt==3, clear при cnt==4 -
      //     РОВНО те же фазы, что r3/r4 кольца -> импульс 40 нс в
      //     [140,180) каждого периода 280 нс;
      //   X1 = (cnt != 0) ^ x1_n: эквивалент (~r0) ^ x1_n кольца
      //     (состояние k кольца <=> cnt==k, включая INIT r0=1 <=>
      //     cnt=0): фронты через РОВНО 140 нс (7,143 МГц), high 100 /
      //     low 40 нс (duty 71/29); внутренний /2 ВМ85А тактируется
      //     ФРОНТАМИ X1 -> CLK = 3,571 МГц, период 280 нс, duty РОВНО
      //     50%;
      //   X2 = (cnt == 0) ^ x1_n = ~X1 ТОЧНО (SOP функций X1/X2
      //     различны -> same-D слияние невозможно, п.10); ядро XOR
      //     подросло 2 -> 4 ПТ (SOP декода cnt!=0 = cnt0|cnt1|cnt2 -
      //     цена комбинационной фазы вместо триггера r0);
      //   INIT (cnt=0, x1_n=0): (cnt!=0)=0 -> X1='0'/X2='1' до первого
      //     posedge - та же фаза, что у кольца (r0=1 в состоянии 0),
      //     узор установившийся с 1-го полутакта.
      // por_ce = x1_n (v8, МЕРА М1 п.25): x1_n - регистровый импульс
      //   40 нс в [140,180) каждого периода cnt 280 нс (п.17) -> РОВНО
      //   ОДИН posedge-строб за период ПО ПОСТРОЕНИЮ (интервалы ровно
      //   280 нс). POR = 4 x 280 = 1120 нс (норма 3 такта CLK = 840 нс,
      //   запас по номиналу 1,33x; от INIT por_run падает на ~1040 нс -
      //   первый строб на t=160 нс). В v7 было (cnt==1)|(cnt==6) - 2
      //   строба/период (наследие требования БИТ-В-БИТ v3.9): декод на
      //   6 литералов фиттер реплицировал во ВСЕ 8 T-цепей por_sh (фит
      //   1 v7). В v8: (1) декодов равенства в POR-пути НЕТ ВОВСЕ (класс
      //   фитов 7:31/8:55 с потерянной полярностью декодов исключён);
      //   (2) T-цепь бита худеет до x1_n AND (sh[k] XOR sh[k+1]) -
      //   2 ПТ/3 литерала; (3) цена строба - 1 импорт ФБ (x1_n) вместо
      //   3 (cnt<0..2> в фите 1 v7 разбросаны по ФБ1/ФБ2/ФБ6).
      always @(posedge clk) begin
        if (cnt == 3'd6) cnt <= 3'd0;        // wrap (декод cnt==6 - класс п.9!)
        else             cnt <= cnt + 3'd1;  // 111 недостижим; попадание -> 000 за 1 фронт
      end
      always @(negedge clk)
        if (cnt == 3'd3)      x1_n <= 1'b1;
        else if (cnt == 3'd4) x1_n <= 1'b0;
      assign X1 = (cnt != 3'd0) ^ x1_n;  // = (~r0) ^ x1_n кольца (п.17);
                                         // 7,143 МГц, период ровно 140 нс (100/40)
      assign X2 = (cnt == 3'd0) ^ x1_n;  // = r0 ^ x1_n = ~X1 ТОЧНО
      assign por_ce = x1_n;  // v8/М1 (п.25): 1 строб/цикл cnt (было r1|r6)
    end else if (CLK_DIV == 2) begin : g_div2
      // ЦЕЛЕВАЯ ветка /2: x1_q тогглит КАЖДЫЙ клок - вентиль = константа,
      // декодов нет вовсе
      always @(posedge clk)
        x1_q <= ~x1_q;
      always @(posedge clk)
        x2_q <= x1_q;          // v3.5: задержка 1 клок = ПОЛПЕРИОДА (период 2),
                               // D=x1_q != D(x1_q)=~x1_q; init (1,0) -> x2=~x1
      assign X1 = x1_q;        // 12,5 МГц, duty 50%
      assign X2 = x2_q;        // v3.5: регистровая противофаза
      assign por_ce = ~x1_q;   // 1 такт из 2 = 1 раз за период X1
    end else if (CLK_DIV == 4) begin : g_div4
      // ЦЕЛЕВАЯ ветка /4 (v3.4): каскад t0_q -> x1_q; x1_q тогглит при
      // t0_q=1 (каждые 2 клока). Вентиля - литералы t0_q/x1_q, декодов НЕТ
      always @(posedge clk)
        t0_q <= ~t0_q;              // clk/2
      always @(posedge clk)
        if (t0_q) x1_q <= ~x1_q;    // clk/4, duty 50%
      always @(posedge clk)
        x2_q <= ~(x1_q ^ t0_q);     // v3.5: x2_q(t+1) = ~x1_q(t+1) - точная
                                    // противофаза с 0-го такта; D=XNOR != D(x1_q)=XOR
      assign X1 = x1_q;             // 6,25 МГц
      assign X2 = x2_q;             // v3.5: регистровая противофаза
      assign por_ce = ~t0_q & ~x1_q; // 1 такт из 4 = 1 раз за период X1
    end else if (CLK_DIV % 2 == 0) begin : g_div_even
      // FALLBACK чётных N>=6: старый счётчик mod-N/2 (СОДЕРЖИТ декоды -
      // только для отката; целевые режимы 2/4 - выше)
      always @(posedge clk)
        cnt <= (cnt == MEV) ? 4'd0 : cnt + 4'd1;
      always @(posedge clk)
        if (cnt == MEV) x1_q <= ~x1_q;
      always @(posedge clk)
        if (cnt == MEV) x2_q <= ~x2_q;  // v3.5: toggle СИНХРОННО с x1_q,
                                        // init (1,0) -> комплементарны всегда
      assign X1 = x1_q;                        // duty 50% (период CLK_DIV тактов)
      assign X2 = x2_q;                        // v3.5: регистровая противофаза
      assign por_ce = (cnt == 4'd0) && !x1_q;  // 1 раз за период X1
    end else begin : g_div_odd
      // нечётное деление (ветка v3): XOR-пара - НЕ ТРОНУТА (clk10-35)
      always @(posedge clk)
        cnt <= (cnt == NMOD) ? 4'd0 : cnt + 4'd1;
      always @(posedge clk)
        if (cnt == 4'd0) x1_p <= ~x1_p;    // переворот каждые CLK_DIV тактов
      always @(negedge clk)
        if (cnt == NHALF) x1_n <= ~x1_n;   // сдвиг полпериода -> duty 50%
      always @(posedge clk)
        if (cnt == 4'd0) x2_p <= ~x2_p;    // v3.5: двойник x1_p (INIT 0 vs 1)
      assign X1 = x1_p ^ x1_n;             // duty РОВНО 50% (100/100 нс)
      assign X2 = x2_p ^ x1_n;             // v3.5: = ~x1_p ^ x1_n = ~X1 ТОЧНО,
                                           // без сдвига duty (не задержка на клок)
      assign por_ce = (cnt == 4'd0);       // 1 раз за период X1
    end
  endgenerate
  
  //=============================================================
  // POR (v3.4, clk10-35; v8/МЕРА М1 п.25): 4-битный СДВИГОВЫЙ регистр
  // por_sh. 0 в MSB сдвигается вправо, bit0 очищается ПОСЛЕДНИМ ->
  // por_run снимается ровно через 4 тика por_ce. ДЕКОДОВ НЕТ (ни ==0,
  // ни !=0, ни декода строба - строб = регистр x1_n целевой ветки,
  // 1 импульс за период cnt): фиттер дважды печатал por-декоды с
  // потерянной инверсией (фит 7:31: por_cnt(0): T=NOT en -> POR=1 клок;
  // фит 8:55: por_run.D=(por_cnt==0)) - класс конструкций убран, в v8
  // пор-цепь декодов ЛИШИЛАСЬ ОКОНЧАТЕЛЬНО.
  // INIT=F/1 -> RESET_IN=0 до всякого клока (счёт только при живом
  // clk через por_ce из делителя); por_run остаётся РЕГИСТРОМ (v3.2,
  // п.8 шапки - защита от схлопывания PT / Placement Failed); v7:
  // por_sh/por_run ВНЕ домена GSR (п.24) - POR только по питанию.
  // Длительность: POR = 4 x por_ce. @ N=7 (v8/М1) por_ce = 1 строб за
  // период cnt 280 нс (x1_n) -> POR = 1120 нс; норма 3 такта CLK OUT =
  // 840 нс @ 3,57 МГц (запас по номиналу 1,33x; от INIT фактический
  // низ RESET_IN ~1040 нс - первый строб x1_n на t=160 нс).
  // Повторный POR невозможен: после 0000 сдвиг держит нули навсегда.
  //=============================================================
  reg [3:0] por_sh = 4'hF;       // сдвиг вправо: F -> 7 -> 3 -> 1 -> 0 (М1: было 8'hFF)
  reg  por_run = 1'b1;           // FF-копия POR (v3.2; INIT=SET); v7: вне
                                 // домена GSR - POR только по питанию (п.24)
  // v7 (п.24): wire cpu_rst УДАЛЁН - логика (38 триггеров) и
  // сериализатор (24) сбрасываются АСИНХРОННО через СЕТЬ GSR по RST;
  // por_run остался для RESET_IN и ДВУХ гейтов окна POR (!por_run в
  // S_T2->WB1 и на взводе hold_req).
  always @(posedge clk) begin
    por_run <= por_sh[0];        // снятие, когда '0' дойдёт до bit0 (4-й тик)
    if (por_ce) por_sh <= {1'b0, por_sh[3:1]};
  end


  //=============================================================
  // Автомат шины: 7 состояний = 3 триггера (v3; в v1 было 10/4 триггера -
  // WBW/WBS/WBS2 удалены: hold-off 0, см. п.4 шапки; WB1..WB4 ЗАЩИЩЕНЫ
  // от ALE)
  //=============================================================
  localparam S_IDLE = 3'd0,   // ожидание ALE; A/D в Hi-Z; /OE включён (декод)
             S_T1H  = 3'd1,   // T1: CPU держит адрес на A-сетях; идёт захват
             S_T2   = 3'd2,   // строб: чтение - выдача данных на A; запись - захват
             S_WB1  = 3'd3,   // WB: адрес на A + данные на D (t_AS 40 нс до /WE)
             S_WB2  = 3'd4,   // /WE=0 - импульс НАЧАЛСЯ: защищён от ALE
             S_WB3  = 3'd5,   // /WE=0 (импульс = 2 тика = 80 нс >= t_WP ОЗУ)
             S_WB4  = 3'd6;   // /WE=1: удержание адреса/данных (t_AH/t_DH памяти)

  // Task 46: прагма против ONE-HOT перекодировки автомата XST
  // (контроль у владельца: в .rpt НЕ должно быть state_FSM_FFd4..10;
  // v3: автомат = РОВНО 3 триггера state_FSM_FFd1..3; 7 состояний (без WBW).
  // synthesis attribute fsm_encoding of state is "compact"
  reg  [2:0] state  = S_IDLE;
  reg        rd_seen = 1'b0;    // строб чтения замечен в T2
  reg        wr_seen = 1'b0;    // строб записи замечен в T2

  // Захваченные шинные регистры
  reg [7:0] addr_latch = 8'h00;  // адрес с A-сетей (T1) - нужен writeback и декоду порта
  reg [7:0] bus_reg    = 8'h00;  // данные: чтение (с D-сети в T1) ИЛИ запись (с A-сети в T2)

  // Порты индикации/звука (§5): захват по записи в порт при IO/M#=1
  reg [7:0] seg_q = 8'hFF;       // 1 в регистре = сегмент горит; выход инвертируется
  reg [3:0] dig_q = 4'hF;        // 1 = цифра выбрана; выход инвертируется
  reg       snd_q = 1'b0;
  reg [3:0] kbcol_q = 4'h0;      // колонки (порт 02h), INIT 0000 = все выкл
  wire io_rd_kb = IOM & ~addr_latch[2] & addr_latch[1] & addr_latch[0]; // чтение 03h (KBROW)

  // Комбинационные группы (v3):
  //   wb_out = in_wb БЕЗ !ALE: драйверы A/D держат адреса/данные до конца
  //     защищённого импульса (п.4 шапки); снятие - при выходе в IDLE.
  //   rd_drive с !ALE - чтение как в v1 (мгновенный обрыв при новом цикле).
  wire in_wb   = (state >= S_WB1);                       // WB1..WB4: A/D драйвятся
  wire in_welo = (state == S_WB2) || (state == S_WB3);   // /WE низ
  wire wr_phase = (state >= S_T2);                       // T2..WB4: /OE памяти off
  wire wb_out   = in_wb;                                 // защищённый writeback-драйв
  wire rd_drive = (state == S_T2) && rd_seen && !RDn && !ALE; // A-пины отдают данные

  //=============================================================
  // TXCLIENT v6: ОБЪЯВЛЕНИЯ сериализатора (п.19/20/21/22/23 шапки).
  // Блок вынесен ПЕРЕД шинный движок (п.23.1 шапки, HDLCompilers:28):
  // al_shift/br_shift читаются в ШИННОМ ДВИЖКЕ ниже (else-if ветки
  // сдвига источников кадров 2/3), bit_cnt/tx_byte - в in_cap/in_frame;
  // Verilog требует, чтобы объявление опережало использование. Текст
  // выражений НЕ менялся - только порядок строк; всегда-блоки (шинный
  // движок и сериализатор) - на своих прежних местах.
  //=============================================================
  // ОКНО ЗАХВАТА (п.22, решение владельца): 8000h-BFFFh = A15=1 && A14=0.
  // Стек/переменные fw_mon (FFEx-FFF8h) и вся старшая половина C000-FFFFh
  // ВНЕ ОКНА ПО ПОСТРОЕНИЮ - отдельного декода-исключения (EXCL_PAGE=FFh
  // в v2-v4, +6 литералов в win_hit/hold_req/HOLD) БОЛЬШЕ НЕТ - именно он
  // держал AH8-14 в FB6 и не давал фиту уложиться во входы ФБ. Расширить
  // окно -> вернуть (ah_bus != 8'hFF) в win_hit (и помнить: это НЕ влезало).
  localparam [3:0] BAUD_DIV = 4'd13;  // 25 МГц/13 = 1 923 077 бод 8N1 (CH340G до 2 Мбит; от кварца 12 МГц - ошибка <0,2%);
                                      // альтернативы: 16 -> 1 562 500 (wrap без декода),
                                      // 25 -> 1 000 000 (обоюдно точный с CH340G: 25/25 и 12/12), 50 -> 500 000
  reg  hold_req = 1'b0;   // CPU.HOLD (P81): запрос захвата шины ('0' в покое = прежний PGND)
  reg  hlda_q   = 1'b0;   // синхронизатор HLDA (1 ступень - прецедент sod_q; вход квазистатический)
  reg  cap_run  = 1'b0;   // фаза сериального захвата hi-байта (9 тиков, п.20/22)
  wire tx_hold  = hold_req | hlda_q;  // CPU вне шины (HOLD ожидается ИЛИ грант активен):
                                      // гашение выбора памяти (A15/IOM CPU флоат в HLDA!)
  wire win_hit  = !IOM && A15 && !AH14 && S0 && !S1; // окно 8000h-BFFFh (п.22): запись в ОЗУ (статус MW, п.19)
  // Сериализатор: 9-бит сдвиговый регистр {data, start}, LSB-первый,
  // TX = shreg[0] (IO-MC P39); между кадрами зазора НЕТ - следующий байт
  // СЕРИАЛЬНО предзагружается во время передачи текущего (п.22); после
  // пакета shreg сам приходит в все-'1' (idle) - отдельных загрузок нет.
  localparam [1:0] TXB_IDLE = 2'd0, TXB_HI = 2'd1, TXB_LO = 2'd2, TXB_DAT = 2'd3;
  reg [1:0] tx_byte  = TXB_IDLE;
  reg [3:0] bit_cnt  = 4'd0;
  reg [3:0] baud_cnt = 4'd0;
  reg [8:0] shreg    = 9'h1FF;    // idle '1': TX='1' до всякого клока и в сбросе (как tx_q v3.7)
  wire baud_tick = (baud_cnt == (BAUD_DIV - 4'd1));
  // Вход shreg<8>, фаза захвата (9 тиков, bc 0..8): bc0 = '0' (старт-бит
  // заходит через мультиплексор - ПРЕДЗАГРУЗКИ БОЛЬШЕ НЕТ, п.22),
  // bc1..8 = A8..A15 с живых AH-пинов (LSB первый; последнее чтение -
  // на 400-й нс от спада WR#, окно валидности AH 650-700 нс):
  wire in_cap = (bit_cnt == 4'd0) ? 1'b0 :
                (bit_cnt == 4'd1) ? AH8  :
                (bit_cnt == 4'd2) ? AH9  :
                (bit_cnt == 4'd3) ? AH10 :
                (bit_cnt == 4'd4) ? AH11 :
                (bit_cnt == 4'd5) ? AH12 :
                (bit_cnt == 4'd6) ? AH13 :
                (bit_cnt == 4'd7) ? AH14 : A15;
  // Вход shreg<8> в кадрах (п.22/23): тик bc кадра N несёт бит (bc-1) кадра
  // N+1: bc0 = '1' (стоп текущего), bc1 = '0' (старт следующего - только
  // если он ЕСТЬ), bc2..9 = данные следующего (AL для кадра 2, D для
  // кадра 3; кадра 4 нет - '1' = idle-заполнение). v6 (п.23): источник
  // СДВИГАЕТСЯ К LSB синхронно с инжекцией - тут ОДИН провод на кадр,
  // а не 8+8 (уравнение shreg<8>.D ~8 вх. вместо 26 - ERROR 892 закрыт):
  wire in_frame = (bit_cnt == 4'd0) ? 1'b1 :
                  (bit_cnt == 4'd1) ? ((tx_byte == TXB_HI || tx_byte == TXB_LO) ? 1'b0 : 1'b1) :
                  (tx_byte == TXB_HI) ? addr_latch[0] :
                  (tx_byte == TXB_LO) ? bus_reg[0] : 1'b1;
  // РЕГИСТРОВЫЕ хелперы (п.21): тик сдвига кадра и тик конца стоп-бита.
  // Выход триггера фиттер НЕ МОЖЕТ коллапсировать в D-функции потребителей -
  // каждый ФБ с битом shreg платит 1 вход вместо ~10 развёрнутых декодов
  // (baud_tick 4 вх + bit_cnt 4 вх + tx_byte 2 вх, копия в каждый ФБ) -
  // именно это дублирование уронило фиты v2/v3 (216/216 вх.ФБ).
  wire adv = (tx_byte != TXB_IDLE) && baud_tick;  // тик сдвига кадра
  wire ld  = adv && (bit_cnt == 4'd9);            // конец стоп-бита кадра
  reg  adv_q = 1'b0, ld_q = 1'b0;                 // регистры - коллапс невозможен
  // v6 (п.23): сдвиг источников кадров К LSB - СИНХРОННО с инжекцией:
  // тик adv_q с bc>=2 читает [0] и сдвигает регистр ({1'b0, r[7:1]}) -
  // за 8 тиков (bc 2..9) мимо инжекции проходят ВСЕ 8 бит, к концу кадра
  // регистр = 0. Старт ЛИШЬ с bc=2 ПЕРВОГО кадра (~1,9 мкс после
  // WR#(вверх)) - WB (A/D-пины гонят эти регистры) кончается через
  // ~0,2 мкс; вне пакета сдвига НЕТ (TXB_HI/TXB_LO + adv_q); загрузка
  // T1/T2 - прежняя (else-if в шинном движке). bc>=2 = |bit_cnt[3:1]
  // (bit_cnt 0..9; bc=0,1 - константы стоп/старт, источник не читается).
  wire al_shift = adv_q && (tx_byte == TXB_HI) && (|bit_cnt[3:1]);
  wire br_shift = adv_q && (tx_byte == TXB_LO) && (|bit_cnt[3:1]);
  //=============================================================
  // Шинный движок
  //=============================================================
  always @(posedge clk or posedge RST) begin // v7: асинхронный сброс логики по RST -> СЕТЬ GSR (п.24)
    if (RST) begin
      state      <= S_IDLE;
      rd_seen    <= 1'b0;
      wr_seen    <= 1'b0;
      addr_latch <= 8'h00;
      bus_reg    <= 8'h00;
      seg_q      <= 8'hFF;   // INIT «8888.» на индикаторе
      dig_q      <= 4'hF;
      snd_q      <= 1'b0;
      kbcol_q    <= 4'h0;
    end else begin
      // --- захват повторным сэмплированием: последний сэмпл валиден ---
      // v3: захват возможен только в T1H, т.е. ПОСЛЕ завершения WB
      // (структурно: из WB в T1H попадаешь только через IDLE) - adm.
      // addr_latch НЕ может перезаписаться посреди импульса (п.6 шапки).
      if (state == S_T1H && ALE) begin
        addr_latch <= A;                 // адрес стабилен весь T1
        if (!IOM) bus_reg <= D;          // данные памяти (доступ начался в начале T1)
      end else if (al_shift) begin       // v6 (п.23): источник кадра 2 едет к LSB -
        addr_latch <= {1'b0, addr_latch[7:1]}; // старт ~1,9 мкс после WR#(вверх),
      end                                // WB (A-пины отсюда) уже кончился (~0,2 мкс)
      if (state == S_T2 && !WRn) begin
        bus_reg <= A;                    // данные записи (CPU держит до WR#(вверх))
        if (IOM) begin                   // запись в порт: декод по тройке A2,A1,A0 (Task 34)
          case (addr_latch[2:0])
            3'b000: seg_q <= A;          // 00h: сегменты
            3'b001: begin                // 01h: разряды + SND
              dig_q <= A[3:0];
              snd_q <= A[4];
            end
            3'b010: kbcol_q <= A[3:0];   // 02h: колонки клавиатуры
            default: ;                   // 03h чтение; 04h-07h резерв (Task 69); txclient: вывод -
                                         // записи в ОЗУ (окно логгера 8000h-BFFFh), порты не участвуют (п.22)
          endcase
        end
      end else if (br_shift) begin       // v6 (п.23): источник кадра 3 едет к LSB -
        bus_reg <= {1'b0, bus_reg[7:1]}; // D-пины (WB) давно отпущены; приоритет
      end                                // загрузки T2 выше (CPU заморожен на пакет)
      // --- трекинг стробов ---
      if (state == S_T2 && !RDn) rd_seen <= 1'b1;
      if (state == S_T2 && !WRn) wr_seen <= 1'b1;
      // --- переходы ---
      // v3: ALE ОБРЫВАЕТ только T2 (защита от глюка); в WB1..WB4 НЕ
      // вмешивается - импульс /WE защищён (п.4 шапки).
      if (ALE && state == S_T2 && !((wr_seen && WRn) || (rd_seen && RDn))) begin
        state   <= S_IDLE;
        rd_seen <= 1'b0;
        wr_seen <= 1'b0;
      end else begin
        case (state)
          S_IDLE: if (ALE) state <= S_T1H;
          S_T1H:  if (!ALE) state <= S_T2;
          S_T2: begin
            // приоритет записи: RDn-глюк во время записи не должен прерывать её
            if (wr_seen && WRn) begin
              wr_seen  <= 1'b0;
              // writeback только для записи в ОЗУ (8000-FFFF); запись в ПЗУ
              // отбрасывается (по железу /WE flash не подключён), порт пропускается
              // v7 (п.24): гейт POR - FSM в окне POR живой (GSR не активен),
              // шина CPU в сбросе «floated» (ВМ85А: управления/адрес/данные
              // в 3-м состоянии) - вход в writeback ЗАПРЕЩЁН, иначе
              // плавающие ALE/WRn могли бы родить /WE (класс v3.9.3 п.18)
              state <= (!IOM && A15 && !por_run) ? S_WB1 : S_IDLE;
            end else if (rd_seen && RDn) begin
              rd_seen <= 1'b0;
              state <= S_IDLE;         // отпускание A-пинов через 1 тик после RD#(вверх)
            end
          end
          S_WB1: state <= S_WB2;       // t_AS 40 нс; hold-off 0 (см. п.4 шапки)
          S_WB2: state <= S_WB3;       // /WE низ - защищён, идёт до конца
          S_WB3: state <= S_WB4;
          S_WB4: state <= S_IDLE;      // импульс закончен, всё снято в IDLE
          default: state <= S_IDLE;
        endcase
      end
    end
  end

  //=============================================================
  // TXCLIENT v6 (п.19/20/21/22/23 шапки): монитор ЗАПИСЕЙ CPU в ОЗУ ОКНА
  // 8000h-BFFFh (решение владельца, п.22; полный 16-битный адрес в пакете)
  // + UART-ПЕРЕДАТЧИК В ПК. Классический терминальный soft-UART (SOD-транзит
  // v3.7) УДАЛЁН (п.18): TX (P39) - аппаратный сериализатор пакетов
  // [addr_hi][addr_lo][data] 8N1. Фильтрация по региону и рендер
  // (видеобуфер/терминал) - НА СТОРОНЕ ПК (директива владельца).
  //   v5: hi-байт - СЕРИАЛЬНЫЙ захват с живых AH-пинов (п.20/22), кадры
  //   2/3 - СЕРИАЛЬНАЯ ПРЕДЗАГРУЗКА во время передачи предыдущего (п.22):
  //   параллельных загрузок shreg БОЛЬШЕ НЕТ; строб захвата - ТОЛЬКО взвод
  //   cap_run; win_hit - 5 литералов (окно A15 & !AH14). shreg 9 бит.
  //   v6 (п.23): источники кадров 2/3 (addr_latch/bus_reg) СДВИГАЮТСЯ К LSB
  //   синхронно с инжекцией - in_frame инжектирует ОДИН провод (al[0]/br[0]),
  //   16-входового мультиплексора БОЛЬШЕ НЕТ (фит v5: shreg<8>.D = 26 вх.,
  //   ERROR 892); D-функция бита shreg - 3 ПТ; сдвиг стартует с bc=2 (WB
  //   давно позади), к концу своего кадра источник = 0.
  //   Последовательность на одну запись в ОЗУ 8000-BFFF:
  //     1) T1: win_hit (S0/S1 = MW, A15=1, A14=0) -> hold_req=1 -> HOLD P81;
  //        ВМ85А сэмплирует HOLD в T2 этого же цикла, HLDA - в конце его;
  //        ЧТЕНИЯ HOLD НЕ ДАЮТ ВОВСЕ (S1=1);
  //     2) T2 (первый тик !WRn): данные - в bus_reg (штатный захват v3);
  //        cap_run=1 (ТОЛЬКО взвод, п.22): 9 тиков - старт-бит ('0' на
  //        bc==0) и A8..A15 сдвигом с AH-пинов (живы весь цикл записи);
  //        затем TX='0' - старт-бит виден на тике 10 от первого !WRn;
  //     3) во время кадров 1/2 следующий байт СЕРИАЛЬНО предзагружается:
  //        инжекция 1 провода, источник едет к LSB (п.23); на ld_q меняются
  //        только tx_byte/hold_req; конец байта 3 (стоп): tx_byte->IDLE,
  //        hold_req=0 (shreg уже все '1') - CPU покидает HLDA ПОСЛЕ конца
  //        пакета (раньше нельзя: hi следующей записи попал бы в
  //        работающий сериализатор);
  //     4) IO/ПЗУ/вне окна (FFxx, C000-FFFF): hold_req НЕ взводится -
  //        ноль издержек; защитная ветка IDLE снимает hold_req, если
  //        пакет не стартовал (глюк классификации) - пинг-понг без пакета.
  //   Бюджет: факт v5 103+8 МЦ/213 вх.ФБ; v6: минус mux-хелперы и дубли
  //   A<3:4>_BUFR -> ~102-106 МЦ, вх.ФБ ~185-205/216 (п.23).
  //=============================================================
  // Объявления сериализатора (BAUD_DIV, hold_req/hlda_q/cap_run,
  // tx_hold/win_hit, TXB_*, tx_byte/bit_cnt/baud_cnt/shreg, baud_tick,
  // adv/ld, adv_q/ld_q, in_cap/in_frame, al_shift/br_shift) - ВЫШЕ,
  // перед шинным движком (п.23.1 шапки): объявление должно опережать
  // использование (HDLCompilers:28). Всегда-блок сериализатора:
  always @(posedge clk or posedge RST) begin // v7: асинхронный сброс сериализатора по RST -> СЕТЬ GSR (п.24)
    if (RST) begin
      hold_req <= 1'b0;  hlda_q <= 1'b0;  cap_run <= 1'b0;
      tx_byte  <= TXB_IDLE;  bit_cnt <= 4'd0;  baud_cnt <= 4'd0;
      shreg <= 9'h1FF;  adv_q <= 1'b0;  ld_q <= 1'b0;
    end else begin
      hlda_q   <= HLDA;                                  // синхронизация HLDA (async от CPU)
      baud_cnt <= baud_tick ? 4'd0 : baud_cnt + 4'd1;    // свободный ход; сетка 13 тиков - ЕДИНАЯ
      adv_q    <= adv;  ld_q <= ld;                      // хелперы п.21 (регистры - НЕ коллапсируют)
      if (cap_run) begin
        // ФАЗА ЗАХВАТА hi-байта (п.22): сдвиг КАЖДЫЙ тик (не по baud_tick!);
        // вход - мультиплексор in_cap в shreg<8>; счётчик - штатный bit_cnt.
        // Старт-бит заходит через мультиплексор на bc==0 (предзагрузки НЕТ)
        // - ровно 9 тиков, bc 0..8.
        shreg   <= {in_cap, shreg[8:1]};
        bit_cnt <= bit_cnt + 4'd1;
        if (bit_cnt == 4'd8) begin                         // 9-й тик: кадр собран,
          cap_run  <= 1'b0;                                // старт-бит уже в shreg[0]
          tx_byte  <= TXB_HI;
          bit_cnt  <= 4'd0;
          baud_cnt <= 4'd1;                                // ФАЗА под adv_q (п.21): сдвиг кадра
        end                                                // ровно на 13-м такте после спада TX
      end else begin
        case (tx_byte)
          TXB_IDLE:
            // защита от ложного взвода (глюк классификации S0/S1): пакет
            // НЕ стартовал, а HLDA уже пришёл - пинг-понг без пакета
            if (hold_req && hlda_q && state == S_IDLE) hold_req <= 1'b0;
          TXB_HI, TXB_LO, TXB_DAT: begin
            if (adv_q)                                     // сдвиг бита - И В ТИК ld_q ТОЖЕ
              shreg <= {in_frame, shreg[8:1]};             // (там adv_q=1): следующий байт
                                                           // уже в потоке (п.22), мультиплексор
                                                           // подставляет стоп('1')/старт('0')
            if (ld_q) begin                                // конец стоп-бита (на такт позже baud_tick,
              bit_cnt <= 4'd0;                             // п.21); baud_cnt НЕ трогаем: сетка 13 тиков
              if (tx_byte == TXB_HI)                       // держится свободным ходом
                tx_byte <= TXB_LO;                         // байт 2 (AL) УЖЕ предзагружен
              else if (tx_byte == TXB_LO)
                tx_byte <= TXB_DAT;                        // байт 3 (D) УЖЕ предзагружен
              else begin
                tx_byte  <= TXB_IDLE;                      // shreg уже все '1' (in_frame='1'
                hold_req <= 1'b0;                          // после кадра 3) - РЕЛИЗ (п.19/22)
              end
            end else if (adv_q) begin
              bit_cnt <= bit_cnt + 4'd1;
            end
          end
        endcase
      end
      // Взвод (T1) и СТАРТ ЗАХВАТА (T2, первый тик !WRn) - ПОСЛЕ case/if:
      // T1: статус = запись в ОЗУ ОКНА (S0/S1, 8000-BFFF) -> hold_req=1 -
      //     HOLD ВМ85А сэмплирует в T2 ЭТОГО ЖЕ цикла;
      // T2: ТОЛЬКО взвод cap_run (п.22) - предзагрузки/очисток НЕТ:
      //     старт-бит заходит через in_cap на bc==0, bit_cnt==0 в TXB_IDLE
      //     - структурный инвариант (ld_q конца кадра 3 и сброс пишут 0),
      //     baud_cnt фазируется jam'ом <=1 в конце захвата; повторный
      //     старт исключён (!cap_run: со 2-го тика !WRn cap_run уже 1).
      //     case (tx_byte) в фазе захвата НЕ выполняется - защитный
      //     релиз IDLE недостижим.
      // v7 (п.24): гейт POR - floated A/S0/S1 в окне POR не взводят
      // hold_req (иначе HOLD/HLDA в окне POR, а floated WRn в T2 родил
      // бы ложный захват и мусорный кадр в TX; cap_run возможен только
      // при hold_req=1 - отдельного гейта не нужно)
      if (state == S_T1H && ALE && win_hit && !por_run) hold_req <= 1'b1;
      if (state == S_T2 && !WRn && hold_req && tx_byte == TXB_IDLE && !cap_run)
        cap_run <= 1'b1;
    end
  end

  //=============================================================
  // Тристейт-драйверы шины
  //=============================================================
  // Task 34: при чтении порта 03h A_I(0..4) = row0-4 (mux KBROW),
  // AD7-5 = 000. UART-статус (IN 05h) удалён вместе с UART (Task 69).
  assign A = rd_drive ? (io_rd_kb ? {3'b000, row4, row3, row2, row1, row0}
                                  : bus_reg)
            : wb_out   ? addr_latch : 8'bZZZZZZZZ;
  assign D = wb_out ? bus_reg : 8'bZZZZZZZZ;

  //=============================================================
  // Декод памяти минимальной ширины (§5): 1 терм на кристалл
  // v3.9.1 (п.16 шапки): /CE ОЗУ в writeback - ОТ СОСТОЯНИЯ FSM
  // (in_wb); защёлка wb_ram_q удалена - in_wb достижим только через
  // T2-запись в ОЗУ и уже влечёт её условие (эквивалентность v3.9
  // доказана: полный перебор состояний + дифсимуляция двух RTL).
  // Живой декод A15 во время конфликта адресов по-прежнему НЕ
  // участвует: в WB1..WB4 CS_n = 0 без A15/IOM - запись ОЗУ
  // защищена как в v3 (защита п.5 шапки сохранена построением).
  //=============================================================
  // TXCLIENT: пока CPU вне шины (tx_hold = hold_req | hlda_q), A15/IOM
  // ФЛОАТ - живой декод дал бы случайный выбор памяти; /CE ОЗУ и ПЗУ
  // гасятся жёстко (выбор ОЗУ в WB - по-прежнему от состояния FSM, п.16;
  // в v2 HOLD держится весь пакет - до 15,6 мкс, см. п.19).
  assign CSr_n = (A15 | IOM) | tx_hold;                  // /CE_ROM = !( !A15 & !IOM & !tx_hold )
  assign CS_n  = in_wb ? 1'b0 : (tx_hold ? 1'b1 : (!A15 | IOM)); // v3.9.1: от FSM (п.16); txclient: +tx_hold
  assign OEr_n = CSr_n | wr_phase;      // /OE гасится с T2 - данные уже захвачены,
  assign OE_n  = CS_n  | wr_phase;      // иначе SRAM воевала бы с CPLD на D в writeback
  // v3: /WE НЕ обрывается ALE - импульс доводится до конца (п.4 шапки);
  // безопасно: автомат доходит до WB4/IDLE за 5 тиков; сброс гасит импульс:
  // v6 - cpu_rst за такт (sync), v7 - GSR мгновенно (п.24).
  assign WE_n  = !in_welo;
  assign CS1   = 1'b1;

  //=============================================================
  // Поддержка CPU (§3, ред. Task 19) + TXCLIENT v2 (п.19 шапки).
  // Держатели '0' (TRAP, RST7.5/6.5/5.5, INTR, A16-A18) удалены из HDL -
  // их пины (8 шт) заземлит фиттер (Ground on Unused IOs). HOLD (P81)
  // ИЗ ДЕРЖАТЕЛЕЙ УШЁЛ: теперь это ВЫХОД hold_req (запрос DMA txclient;
  // в покое '0' - электрически то же, что прежний PGND, пайки нет).
  // SID (P73) с Task 70-a - ВЫХОД CPLD (транзит RX), в PGND БЫТЬ НЕ ДОЛЖНА.
  //=============================================================
  assign RESET_IN = ~(RST | por_run); // активный 0 по даташиту: 0 = сброс CPU (SW20 нажата или POR)
  assign READY = 1'b1;          // без wait-state - иначе вечные TW
  assign HOLD  = hold_req;      // cpu10 HOLD(39), U1.81/P81: '0' в покое (= прежний PGND),
                                // '1' = захват шины на время пакета (п.19)
  // Приём - программный (директива владельца), транзит RX->SID не тронут;
  // передача - аппаратный сериализатор txclient (блок выше), TX = shreg[0] | cap_run:
  assign SID = RX;              // приём:  CH340G.TXD (P38) -> CPU.SID (P73), RIM 20h
  assign TX  = shreg[0] | cap_run; // передача: пакет [addr_hi][addr_lo][data] -> CH340G.RXD (P39);
                                // idle/стоп = '1' (INIT shreg=1FF), в сбросе TX='1'
                                // (v7: сброс shreg по GSR - SET-ветка, п.24);
                                // | cap_run - джанк фазы захвата (вкл. предзагрузку 000)
                                // не виден в линии (п.20/21): оба слагаемых -
                                // выходы триггеров (1 ПТ в IO-MC)
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
