digitalinvitro/CPLD-plus-8085/beta/01_timer/rom/uart_echo_diag2.asm

; =====================================================================
; beta/01_timer -- ТЕСТ-ПРОШИВКА ПЗУ: ПОЛНОЦЕННЫЙ UART (ПРИЁМ-ПЕРЕДАЧА,
; ЭХО) + ДИАГНОСТИКА ПРИЁМА НА ДИСПЛЕЕ, ВЕРСИЯ 2 (БИТЫ ХВОСТА).
; Интервальный таймер CPLD (beta v3.3b3, порт 04h -> RST 7.5),
; 2400 бод (TMR_N=8), 8N1.
;
; ЭТО diag v1 (uart_echo_diag.asm) + ЗАПИСЬ БИТОВ ХВОСТА В E.
; ЛОГИКА ЭХА И СЕТКА ВЫБОРКИ НЕ ТРОНУТЫ (ре-арм в векторе 003Ch,
; выборки данных d0..d7 -- те же инструкции на тех же адресах).
;
; Файл в кодировке CP1251 (как все исходники проекта, кроме asm85.py).
;
; Сборка (из этой папки):
;   python3 asm85.py uart_echo_diag2.asm -o uart_echo_diag2.hex -l uart_echo_diag2.lst
;
; Железо: retro_PCLD_board V2 + CPLD beta v3.3b3 + USB-мост CH340G (U6).
; CPLD НЕ МЕНЯЛСЯ (транзит SID <= RX безусловен, по .rpt: RX = вход P38,
; SID = выход P73). Прошивается ВМЕСТО монитора fw_mon с нулевого
; смещения flash A29040B. После теста вернуть монитор.
;
; ЗАЧЕМ ВЕРСИЯ 2: отчёт владельца по diag v1 -- счётчик старт-битов
; ТИКАЕТ на каждое нажатие, эхо в терминале почти всегда НЕВИДИМО,
; изредка выходит буква 'ю' (CP1251, байт 0FEh). Сигнатурная модель
; (scripts/uart/sim_rx_signature.py) показывает: при ЧЕСТНЫХ 2400 бод
; приём даёт байт = коду клавиши на ЛЮБОЙ фазе/латентности (1000/1000
; прогонов) -- мусор невозможен. А вот терминал, шлющий ВДВОЕ МЕДЛЕННЕЕ
; (~1200 бод), даёт ИМЕННО наблюдаемое: 'a'->06 (невидимый), 'b'->18,
; SP->00, а клавиши 'o'/'?' -> 0FEh = 'ю' в CP1251 (единичные случаи).
; Диагноз нужен В ЖЕЛЕЗЕ -- версия 2 добавляет биты хвоста.
;
; ЧТО ДОБАВЛЕНО (v2):
;   E -- биты ХВОСТА кадра (3 интервала после d7, H=3..1): ISR пишет
;        линию SID в E, MSB-first: E = t1<<2 | t2<<1 | t3.
;        При правильной сетке хвост ложится на стоп/idle = все 1 =>
;        E = 7. E < 7 -- сетка уползла (биты хвоста поймали данные).
;   Дисплей: [DIG0 = счётчик старт-битов B mod 16]
;            [DIG1 = E, 0..7 (7 = хвост чист)]
;            [DIG2-3 = принятый байт]
;   После RESET: «0.0.0.0.» (маячок старта, как в diag v1).
;
; ЧТЕНИЕ (вводить по одному символу; опорные точки -- 'a' и Enter):
;   байт = коду клавиши ('a'->61), E = 7  -- приём исправен на 2400:
;       терминал ДЕЙСТВИТЕЛЬНО шлёт 2400 8N1, эхо обязано быть видимым;
;   'a'->06, E=0..4 (или 'o'->FE, т.е. 'ю' в терминале) -- терминал
;       шлёт ВДВОЕ медленнее (~1200): ВЫСТАВИТЬ 2400 8N1. ВНИМАНИЕ:
;       монитор fw_mon v5 работает на 4800 8N1, старый v1 -- на 2400;
;       профиль терминала мог остаться от монитора;
;   байт F8..FF ('я'/'ю'/мусор из р-я) на ЛЮБОЙ клавише -- терминал
;       шлёт ~4800 (профиль монитора v5): ВЫСТАВИТЬ 2400 8N1;
;   байт верный, E < 7 -- сетка уползает к концу кадра (сообщить код E);
;   счётчик тикает, байт 00, E = 0, без ввода -- линия прижата к 0.
;
; ТАЙМИНГ ПРИЁМА (не менялся, подробности в uart_echo_test.asm):
;   MAIN опрашивает SID (RIM) в цикле с DI; поймав старт-фронт:
;   OUT TMRP <- RXN1 (1,5 бита, 12 при N=8) -> SIM 08h (сброс латча
;   RST 7.5 ПОСЛЕ загрузки -- залетевший фронт выброшен атомарно)
;   -> INR B -> L=0, E=0, H=11, EI. Сетка ISR: ре-арм в векторе 003Ch;
;   кадр = 12Q (d0) + 8x8Q (d1..d7) + 3x8Q (хвост -- урок v4: эхо-старт
;   ПОСЛЕ конца кадра приёмника ПКА). В v2 хвост, как и данные, читает
;   линию (RIM) -- цена ~7 байт и ~3 мкс в НЕкритичных интервалах:
;   ре-арм в векторе, период = N тикам ровно, длина ISR в сетку не
;   входит; выборки d0..d7 -- побайтно те же инструкции.
;
; РЕГИСТРЫ: C -- фаза TX (0Bh заряжен, 0Ah старт, 09h..02h данные,
;   01h стоп, 0FFh покой); D -- сдвиговый TX; H -- интервалы RX
;   (11..4 выборки, 3..1 хвост-с-записью-E, 0 покой); L -- накопитель
;   байта; E -- биты хвоста (ДИАГ, MSB-first, 0..7); B -- счётчик
;   старт-битов (ДИАГ, ISR не трогает); A/флаги -- рабочие.
;   Вложенных прерываний нет.
; =====================================================================

; ---- параметры (можно переопределить ключами -D) ----
TMR_N   EQU 8               ; бит = N x Q: 8 -> ~2460 бод (цель 2400)
RXN1    EQU TMR_N + TMR_N//2 ; 1-й зазор приёма = 1,5 бита (12 при N=8)
SIMW    EQU 1Bh             ; SIM: MSE=1 -- маски применить: 5.5/6.5
                            ; маскировать, 7.5 РАЗРЕШИТЬ; R7.5=1 -- латч
                            ; сброшен (гасим возможный мусор до EI)
SIMLR   EQU 08h             ; SIM: R7.5=1, MSE=0, SDE=0 -- ТОЛЬКО сброс
                            ; латча RST 7.5 (маски и SOD не трогаем)

; ---- порты ----
SEGP    EQU 00h             ; SEG: D0=a..D6=g, D7=dp (1 = горит в регистре)
DIGP    EQU 01h             ; DIG: D3-D0 разряды (D4 = SND -- не трогаем)
TMRP    EQU 04h             ; таймер: запись N (период = N x Q)

; ---- диагностика: ОЗУ (SRAM с 8000h, стек на FFFF -- конфликтов нет) ----
MUXI    EQU 8000h           ; индекс разряда дисплея 0..3
BYTE0   EQU 8001h           ; последний принятый байт (пишет ISR)

; ---- векторы ----
        ORG 0000h
        JMP MAIN            ; сброс
; ВАЖНО: вектор 003Ch занят ре-армом ЦЕЛИКОМ (MVI+OUT = 003Ch-003Fh),
; JMP не нужен -- автомат продолжается с 0040h. Ре-арм ПЕРВЫМ действием:
; период = N тикам ровно (сетка не зависит от длины ISR).
        ORG 003Ch
        MVI A,TMR_N         ; РЕ-АРМ СЕТКИ (7 тактов)
        OUT TMRP            ; (10 тактов) -- 8 квантов = 1 бит

; ---- ISR: вентиль TX -> TX-автомат -> RX-автомат ----
        ORG 0040h
        MOV A,H             ; вентиль: RX активен (H>0)?
        ORA A
        JZ TXRUN
        JMP RX              ; RX активен: TX НЕ двигаем (заморозка кадра,
                            ;   SOD держит текущий уровень)
TXRUN:  MOV A,C             ; --- TX-автомат (фазы как в v4) ---
        CPI 0FFh            ; 0FFh = покой?
        JZ TXIDLE
        DCR C               ; следующая фаза
        MOV A,C
        CPI 0Ah             ; 0Ah = старт-бит
        JZ TXST
        CPI 1               ; 01h = стоп-бит
        JZ TXSP
; --- фаза данных (d0..d7): как в v4, байт уже в D ---
        MOV A,D
        RRC                 ; A7 <- D0 (очередной бит данных)
        ANI 80h
        ORI 40h             ; SSE=1; MSE=0 -- маски НЕ трогаем
        SIM                 ; SOD <- бит
        STC                 ; единицы едут сверху: после d7 в D уже '1'
        MOV A,D
        RAR                 ; D >>= 1 (D7 <- 1)
        MOV D,A
        JMP RX
TXST:   MVI A,40h           ; SOD=0 -- старт-бит (D загружен ЗАРАНЕЕ:
        SIM                 ;   из релиза приёма или из MAIN)
        JMP RX
TXSP:   MVI A,0C0h          ; SOD=1 -- стоп-бит
        SIM
        MVI C,0FFh          ; однобайтовый режим: сразу в покой (кадры
        JMP RX              ;   редкие -- 2-й стоп-бит не нужен)
TXIDLE: MVI A,0C0h          ; покой: SOD=1 (каждый тик подтверждаем)
        SIM
; --- RX-автомат: интервалы кадра в H, байт копится в L ---
RX:     MOV A,H
        ORA A
        JZ RXE              ; H=0 -- приём не активен
        CPI 4               ; H>=4 (H=11..4) -- фаза данных d0..d7;
        JM RXTAIL           ; H=3..1 -- хвост (с записью E в v2)
        RIM                 ; SID -> A7 (транзит RX->SID в CPLD)
        ANI 80h
        RAR                 ; CY <- SID
        MOV A,L
        RAR                 ; L = (L>>1) | SID<<7 -- LSB-first
        MOV L,A
        JMP RXDCR           ; v2: обход записи хвоста (данные уже взяты)
RXTAIL: RIM                 ; v2 ДИАГ: бит линии хвоста -> E, MSB-first:
        ANI 80h             ;   t1 -> бит 2, t2 -> бит 1, t3 -> бит 0;
        RAR                 ;   при чистой сетке E = 7 (стоп + idle)
        MOV A,E
        RAL                 ; E = (E<<1) | SID
        MOV E,A
RXDCR:  DCR H               ; интервал отработан
        MOV A,H
        ORA A
        JNZ RXE             ; кадр приёма не кончился
        MOV A,L             ; ДИАГ: копия принятого байта на дисплей
        STA BYTE0           ;   (даже если эхо ниже будет уронено)
        MOV A,C             ; --- РЕЛИЗ: кадр кончился (H=0) ---
        CPI 0FFh            ; TX свободен?
        JNZ RXE             ; занят -- байт отбрасываем (v1, без очереди)
        MOV D,L             ; эхо: сдвиговый TX <- принятый байт
        MVI C,0Bh           ; следующий фронт = старт-бит эха
RXE:    EI
        RET

; ---- MAIN ----
        ORG 00B0h           ; v2: сдвинут с 00A0h (+10 байт в ISR)
MAIN:   LXI SP,0FFFFh       ; стек -- верх ОЗУ (конвенция v2)
        MVI A,0C0h          ; SOD=1 (idle) -- ПЕРВЫМ делом гасим возможный
        SIM                 ; BREAK: после сброса SOD=0; TX-маска CPLD и так
                            ; держит '1' 51,2 мкс, но не полагаемся на неё
        MVI A,0             ; ДИАГ: MUXI=0, BYTE0=0 -- дисплей «0.0.0.0.»
        STA MUXI
        STA BYTE0
        MVI B,0             ; ДИАГ: счётчик старт-битов -- с нуля
        MVI E,0             ; ДИАГ: биты хвоста -- с нуля
        MVI A,SIMW
        SIM                 ; маски: 5.5/6.5 закрыты, 7.5 разрешён, латч сброшен
        MVI D,'>'           ; баннер-символ (один; кадр уйдёт сами собой)
        MVI C,0Bh           ; фаза: следующий фронт = старт-бит '>'
        MVI A,TMR_N
        OUT TMRP            ; пуск таймера: 1-й фронт через N тиков
        MVI H,0             ; RX покой
        MVI L,0
        EI
BAN:    MOV A,C             ; ждём конца баннера (C -> 0FFh на стоп-фазе)
        CPI 0FFh
        JNZ BAN
; --- главный цикл: опрос SID (приём) + эхо + мультиплексия дисплея ---
POLL:   CALL DMUX           ; ДИАГ: шаг мультиплексии (EI включён; портит
        DI                  ;   только A/флаги -- критично, см. шапку);
                            ;   далее опрос КАК В v1
        RIM                 ; «залетевший» фронт сетки не обслужится,
        ANI 80h             ; латч ловится -- выбросим ниже
        JNZ POLL            ; 1 = idle (покой линии)
        ; --- старт-бит пойман (SID=0) ---
        MVI A,RXN1          ; 1-й зазор = 1,5 бита: загрузка ДО сброса
        OUT TMRP            ; латча! Любой залетевший фронт старого
        MVI A,SIMLR         ; отсчёта мог сработать только ДО этой точки
        SIM                 ; (после загрузки новый фронт >= 11 квантов):
                            ; SIM 08h выбрасывает их АТОМАРНО, гонки нет
        INR B               ; ДИАГ: +1 пойманный старт-бит (вне критичного
                            ;   пути -- ПОСЛЕ арма, до EI)
        MVI L,0             ; накопитель байта -- с нуля
        MVI E,0             ; ДИАГ: биты хвоста -- с нуля
        MVI H,11            ; 11 интервалов: 12Q (d0) + 8x8Q (d1..d7)
        EI                  ;              + 3x8Q (хвост -- урок v4)
RWAIT:  MOV A,H             ; ждём конца приёма (H -> 0 в релизе)
        ORA A
        JNZ RWAIT
EWAIT:  MOV A,C             ; ждём конца эха (C -> 0FFh на стоп-фазе)
        CPI 0FFh
        JNZ EWAIT
        JMP POLL

; ---- ДИАГНОСТИКА: мультиплексия дисплея (по одному разряду за вызов) ----
; DIG0=B mod 16, DIG1=E (0..7), DIG2=байт.мл, DIG3=байт.ст (hex).
; ПОРТИТ ТОЛЬКО A/флаги (HSEG сохраняет HL через PUSH/POP; B/C/D/E
; не трогает) -- безопасно при EI: ISR в покое тоже трогает лишь A.
; Сегменты пишем ДО разряда (SEGP -> DIGP) -- без призраков.
        ORG 0100h           ; v2: сдвинут с 00F0h (ISR +10 байт, MAIN с 00B0h)
DMUX:   LDA MUXI
        INR A
        ANI 3
        STA MUXI            ; A = новый индекс 0..3
        CPI 1
        JZ DMX1
        CPI 2
        JZ DMX2
        CPI 3
        JZ DMX3
        MOV A,B             ; индекс 0: счётчик стартов, мл. ниббл
        ANI 0Fh
        CALL HSEG
        MVI A,01h
        OUT DIGP
        RET
DMX1:   MOV A,E             ; индекс 1 (v2): биты хвоста 0..7 (ждём 7)
        ANI 07h
        CALL HSEG
        MVI A,02h
        OUT DIGP
        RET
DMX2:   LDA BYTE0           ; индекс 2: мл. ниббл байта
        ANI 0Fh
        CALL HSEG
        MVI A,04h
        OUT DIGP
        RET
DMX3:   LDA BYTE0           ; индекс 3: ст. ниббл байта
        RRC
        RRC
        RRC
        RRC
        ANI 0Fh
        CALL HSEG
        MVI A,08h
        OUT DIGP
        RET
HSEG:   PUSH H              ; A = ниббл -> OUT SEGP = паттерн; HL целы
        MOV H,A
        MVI L,SEGTAB & 0FFh
        ADD L               ; lo + ниббл: переноса нет (lo=60h, см. ниже)
        MOV L,A
        MVI H,SEGTAB//256
        MOV A,M
        POP H
        OUT SEGP
        RET

        ORG 0160h           ; lo = 60h: 60h+0Fh без переноса -- ADD L точен
SEGTAB: DB 3Fh,06h,5Bh,4Fh,66h,6Dh,7Dh,07h  ; '0'-'7' (a..g, dp=0)
        DB 7Fh,6Fh,77h,7Ch,39h,5Eh,79h,71h  ; '8'-'F'
        END
