digitalinvitro/CPLD-plus-8085/beta/lowsize/rom/asm85.py

#!/usr/bin/env python3
# -*- coding: utf-8 -*-
"""
asm85.py — мини-ассемблер Intel 8085 для тест-прошивок retro_PCLD_board.

Кодировка: UTF-8 (это инструмент сборки, а не исходник HDL — правило CP1251
на него не распространяется). Исходник .asm читается как CP1251 (с фолбэком
на UTF-8), листинг пишется в CP1251 — как принято в проекте.

Возможности:
  - двухпроходная сборка, метки, выражения (+ - * / и скобки);
  - числа: 1234h / 0x1234 / 123 / 0110b (двоичное) / 'A' (символ) / $ (текущий адрес);
  - директивы: ORG, EQU, DB, DW, IF expr / ELSE / ENDIF, END;
  - условная сборка под варианты прошивки: -D TONE=0;
  - вывод Intel HEX (16 байт в записи, тип 00 + EOF 01) и листинга;
  - режим --disasm: дизассемблирование готового .hex для проверки.

Использование:
  python3 asm85.py src.asm -o out.hex [-l out.lst] [-D NAME=VAL ...]
  python3 asm85.py --disasm out.hex

Система команд: полная таблица 8085 (MOV/MVI/LXI/LDA/STA/LHLD/SHLD/STAX/LDAX/
арифметика с регистром и немедленным операндом/переходы/вызовы/PUSH/POP/INR/DCR/
INX/DCX/DAD/RST/SIM/RIM/EI/DI/HLT и прочие одномашинные).
"""
import argparse
import re
import sys

# ---------------------------------------------------------------- таблицы

REGR = {'B': 0, 'C': 1, 'D': 2, 'E': 3, 'H': 4, 'L': 5, 'M': 6, 'A': 7}
RP = {'B': 0, 'D': 1, 'H': 2, 'PSW': 3, 'SP': 3}   # PUSH/POP: PSW; LXI/INX/DCX/DAD: SP
RP_NO_PSW = {'B': 0, 'D': 1, 'H': 2, 'SP': 3}

# одномашинные (без операндов)
IMPL1 = {
    'NOP': 0x00, 'HLT': 0x76, 'EI': 0xFB, 'DI': 0xF3,
    'SIM': 0x30, 'RIM': 0x20,
    'CMA': 0x2F, 'STC': 0x37, 'CMC': 0x3F, 'DAA': 0x27,
    'RLC': 0x07, 'RRC': 0x0F, 'RAL': 0x17, 'RAR': 0x1F,
    'XCHG': 0xEB, 'XTHL': 0xE3, 'PCHL': 0xE9, 'SPHL': 0xF9,
    'RET': 0xC9, 'RC': 0xD8, 'RNC': 0xD0, 'RZ': 0xC8, 'RNZ': 0xC0,
    'RM': 0xF8, 'RP': 0xF0, 'RPE': 0xE8, 'RPO': 0xE0,
}
# группа "мнемоника регистр": ADD/ADC/SUB/SBB/ANA/XRA/ORA/CMP
GRP_R = {
    'ADD': 0x80, 'ADC': 0x88, 'SUB': 0x90, 'SBB': 0x98,
    'ANA': 0xA0, 'XRA': 0xA8, 'ORA': 0xB0, 'CMP': 0xB8,
}
# группа "мнемоника imm8"
GRP_I8 = {
    'OUT': 0xD3, 'IN': 0xDB,
    'ADI': 0xC6, 'ACI': 0xCE, 'SUI': 0xD6, 'SBI': 0xDE,
    'ANI': 0xE6, 'XRI': 0xEE, 'ORI': 0xF6, 'CPI': 0xFE,
}
# группа "мнемоника addr16"
GRP_A16 = {
    'JMP': 0xC3, 'JNZ': 0xC2, 'JZ': 0xCA, 'JNC': 0xD2, 'JC': 0xDA,
    'JPO': 0xE2, 'JPE': 0xEA, 'JP': 0xF2, 'JM': 0xFA,
    'CALL': 0xCD, 'CNZ': 0xC4, 'CZ': 0xCC, 'CNC': 0xD4, 'CC': 0xDC,
    'CPO': 0xE4, 'CPE': 0xEC, 'CP': 0xF4, 'CM': 0xFC,
    'LDA': 0x3A, 'STA': 0x32, 'LHLD': 0x2A, 'SHLD': 0x22,
}
GRP_RP = {'INX': 0x03, 'DCX': 0x0B, 'DAD': 0x09}   # + rp<<4
GRP_STX = {'STAX': 0x02, 'LDAX': 0x0A}             # только B(0)/D(1)

LABEL_RE = re.compile(r'^\s*([A-Za-z_][A-Za-z0-9_]*)\s*:\s*(.*)$')
HEX_RE = re.compile(r'\b([0-9][0-9A-Fa-f]*)[hH]\b')
BIN_RE = re.compile(r'\b([01]+)[bB]\b')
DEC_RE = re.compile(r'\b([0-9]+)[dD]\b')


class AsmError(Exception):
    pass


def expr_eval(text, syms, loc):
    """Вычислить выражение: числа h/0x/dec/bin/'c'/$, символы, + - * / ()."""
    if text is None or str(text).strip() == '':
        raise AsmError('пустое выражение')
    s = str(text).strip()
    if HEX_RE.search(s):
        s = HEX_RE.sub(lambda m: '0x' + m.group(1), s)
    if DEC_RE.search(s):
        s = DEC_RE.sub(lambda m: m.group(1), s)
    if BIN_RE.search(s):
        s = BIN_RE.sub(lambda m: '0b' + m.group(1), s)
    s = s.replace('$', ' LOC ')
    s = re.sub(r"'(.)'", lambda m: str(ord(m.group(1))), s)
    ns = dict(syms)
    ns['LOC'] = loc
    ns['__builtins__'] = {}
    try:
        val = eval(s, ns, ns)  # noqa: S307 — контролируемый ввод ассемблера
    except Exception as e:
        raise AsmError('не вычисляется выражение %r: %s' % (text, e))
    if not isinstance(val, int):
        raise AsmError('выражение %r — не целое' % text)
    return val & 0xFFFFFFFF


class Line:
    __slots__ = ('no', 'text', 'label', 'mnem', 'ops', 'addr', 'bytes')

    def __init__(self, no, text):
        self.no = no
        self.text = text
        self.label = None
        self.mnem = ''
        self.ops = []
        self.addr = None
        self.bytes = b''


def read_source(path):
    raw = open(path, 'rb').read()
    try:
        text = raw.decode('cp1251')
        enc = 'cp1251'
    except UnicodeDecodeError:
        text = raw.decode('utf-8')
        enc = 'utf-8 (фолбэк!)'
    return text, enc
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
