digitalinvitro/CPLD-plus-8085/(commit log)

2026-10-20 Добавлен тестовый файл: описание сути репозитория от ИИ-агента
2026-10-20 Очистка репозитория перед наполнением новыми файлами проекта
2026-10-20 Добавлен SCHEMATIC.md — центральная база знаний схемы
    Файл конвертирован из CP1251 в UTF-8 и вычитан (34 исправления):
    орфография, синтаксис, стилистика, типографика. Техническое
    содержание (пины, цепи, компоненты, факты) не менялось.
2026-10-20 SCHEMATIC.md: коррективы владельца
    1. 'программная память' -> ПЗУ (U10)
    2. Разбиты слепленные строки списка компонентов (USB2/U7, J1/BUZZER1/LED2)
    3. Раздел H1: расписаны положения перемычки и их действия (таблица)
    4. Уточнены конденсаторы: электролиты C14/C16 1000 мкФ, остальное —
    блокировочная керамика 0,1 мкФ
    5. Жаргон заменён на научный стиль: клок, грабли, рельс, кастомный,
    джампер, комп, слит, ДШ, diff, переген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
2026-10-20 SCHEMATIC.md: U7 идентифицирован как LTC6905HS5-80 — разделы про генератор, перемычку H1 и §7.5 переписаны по даташиту LTC6905-XXX (DIV: VCC=/1, float=/2, GND=/4; опорная 80 МГц)
2026-10-20 SCHEMATIC.md: заполнена колонка «Имя в .net» в §6 — фактические имена 126 цепей сопоставлены с нетлистом (восстановлен из git-истории); имя U7 LTC6905HS5-80 добавлено в §4
2026-10-20 Add hardware/: нетлист, SVG-схема и BOM (экспорт EasyEDA 2026-10-20)
    - retro_PCLD_board-V2_2026-10-20.net — нетлист: 74 компонента, 126 цепей, 394 пина, с номиналами
    - retro_PCLD_board-V2_2026-10-20.svg — визуальная схема (лист Sheet_1, REV 1.0)
    - BOM_CPLD_108_for_retro-V2_2026-10-20.csv — BOM, конвертирован в UTF-8; добавлена
    отсутствовавшая в экспорте позиция LD1: 4-разрядный индикатор 14,2 мм, общий анод,
    Kingbright CA56-126WA
    - README.md — состав, происхождение и итоги сверки с этало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
2026-10-21 Add hdl/: Verilog-проект top_suart v3 + UCF + отчёт фиттера cpldfit
    - top_suart.v v3: soft-UART транзитом, XOR-делитель /5, POR 3,28 мс, CPU 2,5 МГц
    - top_suart.ucf: 72 ноги; 3 устаревших комментария исправлены (X1 = 25/5 = 5 МГц,
    col3 без SW20)
    - retro_pcld_top.rpt: фит успешен, 0 ошибок — 100/108 MC (93%), 246/540 PT (46%),
    202/216 FB-входов (94%), 72/81 ног; clk -> GCK3 (P29), дополнение clk -> GCK2
    - сверка отчёта фиттера с UCF: 72/72 пина совпали
    - кодировка исходников CP1251 (для Xilinx ISE); на github.com ки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
2026-10-21 Update hdl/: отчёт фита с тайминг-констрейнтом на clk (21:55)
    - фит successful, 0 ошибок; пины 72/72 сверены с UCF на этом фите тоже
    - ресурсы выросли (timing-driven): 103/108 MC (95%), 308/540 PT (57%),
    212/216 FB-входов (98%); буферизация D<7>/<6>/<0> (была только D<7>)
    - в cpldfit-отчёте результатов статического тайминга нет (slack/Fmax) —
    вердикт 'мет/не мет' даст Post-Fit Static Timing Report (отдельный шаг ISE)
    - README: исправлено семейство — XC95108 это XC9500 CPLDs, не CoolRu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
2026-10-21 hdl/: тайминг-констрейнт TS_clk 25 МГц в UCF + отчёт trce Timing.twx, README — результаты тайминга
    - top_suart.ucf: добавлен блок владельца (Constraints Editor 2026-10-21):
    NET "clk" TNM_NET = clk; TIMESPEC TS_clk = PERIOD "clk" 25 MHz HIGH 50%;
    комментарии-правки Task 8 сохранены, 72 LOC-ноги не тронуты
    - Timing.twx: post-fit тайминг trce (прогон без .pcf — констрейнты игнорированы,
    фактические задержки валидны): худший цикл FF->FF 36 нс = Fmax 27,78 МГц,
    запас +4 нс к 25 МГц; полуп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
2026-10-22 manuals/: руководство по программированию (PDF + MD + 7 SVG-схем)
    Разделы: память и порты, звук (скважность/ШИМ, периодический сигнал,
    скважность 2/4/20), динамическая индикация (кадр, яркость разрядов),
    последовательный канал SID/SOD (тракт, кадр 8N1, PAUSE), листинги и памятка.
    MD-версия синхронна PDF 1:1, картинки — относительные ссылки на SVG.
2026-10-22 manuals/: 2.3 — распределение токов в разряде: R240 один на цифру, ток делится между горящими сегментами («8.» тусклее «1» при той же скважности); выравнивание скважностью разрядов
2026-10-22 Fix stable baseline v3.2; open beta/ for hardware experiments
    - hdl/top_suart.v v3.2: XOR-делитель /5 (X1=5MHz, CPU 2.5MHz), POR_W=6
    (12.8us), por_run as register, writeback-protected /WE + latched RAM /CE,
    TX-mask 51.2us — final fit 'POR6' successful: 91/108 MC, 0 placement
    warnings, 72/72 pins == UCF, PGND checklist closed (9 pins exact)
    - hdl/retro_pcld_top.rpt: replaced with final v3.2 fit report
    - hdl/Timing.twx: removed (belongs to an older run, not this design)
    - hdl/README.md: baseline status block, final fit numbers, resource
    history 100->103->91 MC
    - MEMORY_MAP.md, PORTS_MAP.md: board reference docs
    - beta/: experiment area on top of the stable baseline; first can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
2026-10-22 beta/01_timer: detailed resource analysis of programmable interval timer
    - vector choice: RST 7.5 (P75, edge+latch, SIM-masked, vector 003Ch);
    INTR rejected (needs RST-code on D in INTA cycle), TRAP non-maskable
    - key finding: ALL 6 interrupt legs (P74..P81) sit in FB6 which has 0
    free macrocells -> 1 MC must be freed there (fitter recompaction plan)
    - timing math: tick from CLKOUT 2.5 MHz, quant 2^8*400ns=102.4us,
    8-bit range 0.1..26.2 ms; 50 Hz = N=194
    - option 1 (target): prescaler 2^8 + 8-bit reloadable down-counter =
    17 MC (tight), ~140-170 PT, 35-45 FB inputs (main risk)
    - option 2 (fallback): fixed 2^16 -> 26.2 ms / 38 Hz, trivial inputs
2026-10-22 beta/01_timer: Verilog — программируемый интервальный таймер -> RST 7.5 (P75), 17 MC
    - top_suart.v v3.3b1: стабильный v3.2 + таймер (логика v3.2 не тронута):
    tmr_pre[7:0] — свободный счёт вверх с CE=por_ce (X1 5 МГц), квант тика
    256x200нс = 51,2 мкс; тик = обёртка 7Fh->80h (1 PT, без edge-детектора);
    tmr_cnt[7:0] — вычитающий, загрузка N с A-сети при OUT 04h (дисциплина
    seg_q), СТОП в нуле, INIT/сброс FFh (нет ложного фронта после RESET);
    RST75 = уровень (tmr_cnt==0) на P75 —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
2026-10-22 beta/01_timer: v3.3b2 — лекарство от провального фита v3.3b1
    Фит v3.3b1: Placement Failed (ERROR:Cpld:892 cnt<3>, ERROR:Cpld:868),
    FB-входы 202/216, 8 сирот, WARNING 897 (A<4> в BUFR). Диагноз: остров
    16 MC при 17 свободных зажал фиттер по MC -> каскадное схлопывание 10
    хелперов XST в приёмники (вся логика v3.2 распухла по FB-входам) +
    монстр $OpTx$FX_SC$97 (8 PT/31 вход) в FB6.
    Лекарство (урок v3.2 — FF не схлопывается):
    - прескалер = {tmr_hi[1:0], por_cnt[5:0]}: por_cnt после POR свободн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
2026-10-22 beta/01_timer: v3.3b3 — лекарство от второго провального фита v3.3b2
    Диагноз (rpt 10-22 19:35): MC 109/108 (103+6 сирот), 7 WARNING 897 —
    регистры bus_reg<1..5,7>/seg_q<0> выселены из пиновых МС в BUFR-буферы.
    Причина: остров таймера (+13 MC) лишил фиттер запаса — cpldfit перестал
    выносить общие стробы в хелперы (в v3.2: $OpTx$FX_SC$164 + обратная
    связь RESET_IN), приёмники распухли +3..+6 FB-входов (166->203).
    Лекарство: факторинг зафиксирован в исходнике (* k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
2026-10-22 beta/01_timer: v3.3b3 — ФИТ УСПЕШЕН (rpt 10-22 22:04): 103/108 MC
    SUCCESSFUL, 0 ERROR, сирот 0 (в v3.3b2: ERROR 892, 109>108).
    MC 103/108 (запас 5 — лучше сметы ~106), PT 257/540, FB-входы 188/216
    (цель <=200), пины 73/81 (+RST75 P75). План Б' не понадобился.
    Сверка чек-листа: bus_reg<1..5>/seg<0> в своих пиновых МС; хелперы
    cpu_rst/al_cap/bus_rd/wr_cap/por_ce живы (по 1 МС); tmr_cnt/tmr_tick_q/
    tmr_load_q/RST75 на месте; txm_cnt свободный счёт вверх; cnt<3> нет;
    PGND = 8 шт; GSR не используется.
    Единственное отклонен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
2026-10-22 beta/01_timer: тест-прошивка ПЗУ для проверки таймера — тон ~465 Гц + мигание 'g' ~1 Гц
    - rom/timer_test.asm (CP1251): вектор 003Ch -> ISR; тон (инверсия SND каждое
    прерывание, N=20 -> 1,024 мс), мигание 'g' (каскад 116x4 = 464 прерыв.),
    ре-арм OUT 04h из ISR, MAIN = HLT-цикл; заполнение 00h (не FFh=RST 7)
    - rom/asm85.py: мини-ассемблер 8085 (двухпроходный, Intel HEX, -D/IF/ELSE,
    листинг CP1251, дизасм; отложенные EQU со ссылками на метки)
    - rom/verify_hex.py: побайтовая сверка о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
2026-10-23 beta/01_timer: фикс тест-прошивки v2 — убран PUSH B/POP B из ISR (счётчик мигания B:C затирался восстановлением, 'g' не мигал; тон не менялся). Эталон verify_hex.py и README обновлены (протокол дефек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
2026-10-23 beta/01_timer: разбор осциллограммы v2 (493,024 Гц, меандр 50/50) — BUZZER1 активный, «нечистый» тон = его внутренний генератор, не дефект; (N−1)-квант подтверждён на v2; добавлен разделительный обра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
2026-10-23 beta/01_timer: тест UART — таймер как задатчик бодрейта (1 прерывание = 1 бит, 2400 бод) + референс на софт-делеях; уточнение модели кванта (период = N тиков, Q≈50,7 мкс, clk≈25,2 МГц); фикс DB-разме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
2026-10-23 beta/01_timer: фикс UART v4 — 2-й стоп-бит (дамп владельца 2400: мусор сериями в ~25% строк); TX 2465 бод (+2,7%) при кадрах вплотную давал след. старт-фронт на 26% бита раньше конца кадра приёмника 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
2026-10-23 beta/01_timer: веха — UART TX v4 ПАСС на железе (владелец 10-24: «текст ровный»), коллизия границы кадра и 2-й стоп-бит подтверждены; BUZZER1 заменён владельцем на пассивный (тон чище; глитч = выброс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
2026-10-23 beta/01_timer: тест UART приём-передача (эхо) — uart_echo_test 229 байта: приём через RIM/SID (опрос с DI, залетевшие фронты выбрасываются SIM 08h ПОСЛЕ загрузки 1,5 бита — гонка латча исключена), се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
2026-10-23 beta/01_timer: диагностика приёма uart_echo_diag (эхо v1 + индикатор на дисплее) — на железе баннер '>' есть, эха нет: приём PC->плата упражняется впервые, бумажная сверка чиста (транзит SID<=RX в фи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
2026-10-23 beta/01_timer: diag v2 — биты хвоста (вердикт по кейсу «счётчик тикает, эхо невидимо, редкая 'ю'»); сигнатурная модель: при честных 2400 мусор невозможен (1000/1000 свипов), картина владельца совпада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
2026-10-23 beta/01_timer: diag v3 — полный таймлайн кадра в hex-терминале; отчёт владельца: paste 46 символов -> 21 эхо-байт, ВСЕ = 00h при подтверждённых 2400 8N1 — при честных 2400 декод 00h невозможен (sim_r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
2026-10-24 beta/01_timer/README: самоидентификация образа по отчёту владельца «1234 -> эхо один байт 00, дисплей 0050» — diag3 эхирует ТРИ байта всегда, однобайтовое эхо = образ в ПЗУ не взялся; перепроверка ст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
2026-10-24 beta/01_timer: diag v4 — исправленный ввод (RLC вместо RAR, защита накопителя L, порядок эха); дамп владельца (10-24) = diag3 байт-в-байт, наблюдение «любой ввод → 00 00 00» воспроизведено instructio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
2026-10-26 beta/01_timer: diag v5 — «кричащий баннер» (дискриминатор «одиночный кадр vs тракт» после 10-25 «вместо '>' терминал получает 00»): ISR 0000h-00FFh / init MAIN 0100h-0129h / DMUX+HSEG+SEGTAB 0170h-01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
2026-10-26 beta/01_timer: diag v6 — «монитор SID» (последний дискриминатор после ПАССА diag5: TX цел, остался уровень RX-линии): ISR/init/DMUX = diag5 байт-в-байт (двойная сверка vs diag5 И vs diag4, 0 расхожде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
2026-10-26 beta/01_timer: репо догоняет документацию — бэкфилл верификационного инструментария, упомянутого в README и сообщениях коммитов, но не закоммиченного (причина жалобы «не нахожу diag6» при живых образ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
2026-10-26 beta/README: журнал проблем — diag6 на железе 10-26, исход N1 (лучший): дисплей 8B 8 1 + приглашение '>' после сброса => SID idle ВЫСОКИЙ, RIM 8Bh бит-в-бит в норме (SID=1, RST7.5-латч чист, IE=1, ма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
2026-10-26 beta/01_timer: ветка ПРИОСТАНОВЛЕНА решением владельца (возврат к baseline v3.2)
    - Журнал: итоги верификации на момент снятия (TX ПАСС v4; RX-уровень ПАСС
    дважды: diag6 N1 + DMM владельца до CPU.SID; эхо-тест diag4 не прогнан)
    - Журнал 10-27: расшифровка 'моргания' дисплея diag6 (DIG0=норма приёма,
    DIG3: 8/0 отличаются только сегментом g, DIG2 ghost ~1.6%, DIG1 в покое
    - единственный открытый пункт, ничего не блокирует)
    - Путь возврат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
2026-10-28 hdl: РЕЛИЗ v3.4 — первый полностью рабочий фит цепочки тактирования (фит 2026-10-27 10:06PM; железо подтверждено clk10-38: монитор функционален целиком, терминал 6000 8N1)
    - top_suart.v <- оригинал владельца v3.4 (CP1251, 519 строк): CLK_DIV=4,
    делитель — декод-иммунные toggle-цепочки (clk10-35/36: t0_q toggle ->
    X1 = clk/4 = 6,25 МГц duty 50%; XOR-пара /5 и счётчик cnt удалены —
    класс багов «потеря полярности на нечётном делителе» невозможен по
    п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
2026-10-28 beta/hiclock: НОВАЯ ветка — кандидат v3.5 «регистровая противофаза X2» (clk10-41/44) поверх релиза v3.4; hdl/ НЕ ТРОНУТ (670c4da остаётся эталоном, правило №1 beta/)
    Причина: фит v3.4 (10-27 10:06PM) подтвердил same-D слияние — комб. assign
    X2 = ~X1 фиттер поднял в регистр FDCPE с D = XOR(x1_q, t0_q) = D(x1_q),
    X2 В ФАЗЕ с X1 (keep на порте не спас, п.9 шапки). CPU в железе не задет
    (clk10-38 ПАСС: монитор функционален целиком, терминал 6000 8N1), но
    противофаза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
2026-10-28 beta/hiclock: аудит фитов владельца — ФАЙЛ (3 фита подряд из старого исходника, X2 same-D в фазе); таблица фитов, исправление п.5 чек-листа, инструкция пересборки с v3.5
2026-10-28 beta/hiclock: фит 10-28 6:20PM добавлен и проаудирован (clk10-48) — вердикт clk10-46/47 снят
    - retro_pcld_top.rpt (фит владельца 10-28 6:20PM) добавлен в комплект; аудит
    по чек-листу 6/6 ПАСС (init X1 SET/X2 RESET/t0 RESET/por SET, GCK3-only,
    GSR/GTS=0, 95 MC/243 PT/213 FB/59 FF/72 ноги, 0 ERROR, варнинги = v3.4).
    - Вердикт clk10-46/47 «старый исходник, X2 в фазе» СНЯТ: рендер pseudo-VHDL
    cpldfit слеп к полярности XOR-B входа (5-й PT макроячейки), куда сворачивается
    инверсия. Доказател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
2026-10-29 beta/hiclock: фит v3.6 10-29 6:59AM проаудирован ЧАСТИЧНО (clk10-50) — cpldfit упал при записи Equations, .rpt обрезан (49/69 КБ, обрыв на OEr_n); структурная часть 8/10 ПАСС (init-пары, X1/X2 комб. 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
2026-10-29 beta/hiclock: ИСХОДНИКИ v3.6 добавлены (упущены в 4983c6b — README и фит легли, а сами .v остались untracked): top_suart_por6_v36.v (CP1251, эталон для ISE, 40 КБ) + utf8-копия; база v3.5 + ветка g_d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
2026-10-29 beta/hiclock: v3.7 «TX-транзит с захватом» (clk10-51) — TX-маска txm_cnt/TXM_W УДАЛЕНА по директиве владельца (артефакт «хвост экспериментов» в UART-линии); вердикт по идее владельца: ПРА ~90% (регис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
2026-10-29 beta/hiclock: v3.8 «one-hot кольцо в делителе» (clk10-52) поверх v3.7 — идея владельца и коллеги (кольцевой счётчик на сдвиговом регистре) ПРИНЯТА и оптимизирована: вместо +2 триггеров узел стал КОРО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
2026-10-29 beta/hiclock: фит v3.8 10-29 4:39PM проаудирован ПОЛНОСТЬЮ (clk10-53) — 15/15 ПАСС, .jed можно строить. Отчёт ПОЛНЫЙ (62 811 байт, фикс libPortabilityNOSH сработал), 0 ERROR, 897-варнингов 1 (v3.6: 7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
2026-10-29 beta/hiclock: v3.9 «кольцо 5 -> 7 триггеров» (clk10-54) — откат частоты ПО ЖЕЛЕЗУ: экземпляр ИМ1281ВМ85А не держит CPU 5 МГц (нестабильный старт простых тестов, запустившись — работают), кольцо делит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
2026-10-29 beta/hiclock: фит v3.9 10-29 8:45PM добавлен и проаудирован ПОЛНОСТЬЮ (clk10-55) — .jed этого фита УЖЕ НА ПЛАТЕ И РАБОТАЕТ. Отчёт ПОЛНЫЙ (63 333 б, краша писателя нет, 0 ERROR, warning 897 = 1 — тот 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
2026-10-29 beta/hiclock: v3.10 «делитель /3» (clk10-56) — ПОДЪЁМ ЧАСТОТЫ БЕЗ СМЕНЫ ЖЕЛЕЗА: вопрос владельца «можем ли мы поднять входную частоту до 8 или 9 МГц» разобран пробником probe_freq_steps.py (3 модели)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
2026-10-29 beta/hiclock: фит v3.10 10-29 10:07PM проаудирован ПОЛНОСТЬЮ + ЖЕЛЕЗО ОТКЛОНИЛО частоту (clk10-57) — v3.9 возвращается в ПРОИЗВОДСТВО. Отчёт ПОЛНЫЙ (63 647 б, 0 ERROR, warning 897 = 1 — тот же буфер 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
2026-10-29 beta/hiclock: v3.11 «проба старта при удлинённом POR» (clk10-58) поверх v3.10 — по приказу владельца «делаем v3.11». Предыстория: фит v3.10 чист (86/108 МЦ, узел /3 бит-в-бит), ослик X1 = 8,4 МГц (но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
2026-10-29 beta/hiclock: ФИНАЛ кампании частоты (clk10-59) — v3.11 проверена ЖЕЛЕЗОМ на 4,17 МГц: СТАРТА НЕТ, маржа POR исключена, виновато ЯДРО — владелец: «остаемся на дизайне v3.9». Наблюдение владельца (10-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
2026-10-30 clk10-60: расклад ресурсов по блокам (фит v3.10, 86 МЦ/203 ПТ без остатка) + вердикт: подтяжки CS1/READY дают -2 МЦ/-2 ноги, CS_n (/CE ОЗУ) резистором невозможен (декод + защита writeback), пары ФБ н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
2026-10-30 clk10-61: политика нумерации v3.9.x (v3.10/v3.11 — побочная ветка, база = v3.9) + вердикт по предложению коллеги: удаление wb_ram_q — ПРАВ (доказательство проверено построчно против RTL v3.9: 5 посыл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
2026-10-30 beta/hiclock: v3.9.1 ПРИНЯТА ВЛАДЕЛЬЦЕМ (clk10-62) — удаление защёлки wb_ram_q (вер дикт clk10-61): CS_n в writeback ОТ СОСТОЯНИЯ FSM. RTL = v3.9 байт-в-байт минус reg/сброс/взвод wb_ram_q (строки 71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
2026-10-30 beta/hiclock: вердикт по новому предложению коллеги «слить захват адреса с переходом IDLE->T1H» (clk10-63) — ОТКЛОНИТЬ. Что верно: защита п.6 сохраняется (вход в T1H только из IDLE), при «адрес валид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
2026-10-30 beta/lowsize: новая линия СНИЖЕНИЯ ресурсов CPLD (clk10-64, директива владельца) — v3.9.1 перенесена сюда из hiclock (RTL CP1251+UTF8 + 4 скрипта git mv'ом, история чиста). Фиксация поправки владельц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
2026-10-30 beta/lowsize: v3.9.2 «делитель: кольцо one-hot N=7 -> двоичный счётчик mod-7» (clk10-65) — первая версия линии lowsize, ЭКОНОМИЯ -4 МЦ (8 -> 4 триггера узла; прогноз 88 -> ~84/108 МЦ, 85 если фиттер 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
2026-10-30 beta/lowsize/rom: ТЕСТ-ПРОШИВКИ дисплея и клавиатуры (clk10-65, ТЗ владельца) — fw_test_disp.hex + fw_text_kbd.hex, исходники на ассемблере CP1251 (+листинги, FAST-варианты, ассемблер asm85.py). fw_t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
2026-10-30 beta/lowsize + beta/README: аудит фита v3.9.1 владельца (clk10-66) — 10-30 7:28PM, РАБОТАЕТ В ЖЕЛЕЗЕ. Проверены по репозиторию оба пункта памяти владельца: (1) CE2/READY «без пайки» — решение clk10-6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
2026-10-30 beta/lowsize: фит v3.9.2 владельца 10-30 8:32PM — АУДИТ ПАСС; железо: дисплей ПАСС, клавиатура ПАСС; послесвечение глифов устранено блэнкингом (clk10-67). АУДИТ: 85/108 МЦ (79%), 209/540 ПТ, 180/216 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
2026-10-30 beta/lowsize: v3.9.2 ПРИНЯТА владельцем (clk10-68) — прошивки с блэнкингом перепрошиты в железо, послесвечения НЕТ (подтверждение 10-30). Приёмка закрыта полностью: фит-аудит ПАСС, железо — дисплей П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
2026-10-31 beta/lowsize/rom: МОНИТОР fw_mon_ape — дисплей+клавиатура, меню APE_ (clk10-69, ТЗ владельца). F1 (4__1) = меню «APE_» из любого режима; A (0__0) = ввод адреса: 4 тетрады вдвигаются справа («___8»->«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
2026-10-31 beta/lowsize/rom: МОНИТОР fw_mon — меню ACDE (клк10-70, ТЗ владельца). Меню «APE_» -> «ACDE» — 4 буквы ровно на 4 разряда: A (0__0) — адрес, C (0__2) — ввод кода (Code; клавиша C есть на матрице и ра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
2026-10-31 manuals: инструкция пользователя к монитору fw_mon — меню ACdE, с проверенными примерами; ссылка из README lowsize
    manuals/fw_mon_acde_manual.md — инструкция пользователя штатного монитора
    (меню ACdE): клавиатура, все 4 режима, память, 3 примера, заметки. Все
    байты/тайминги примеров проверены перед публикацией (скрипт вне репо):
    - клавиатура 4x5 с номерами SW (карта (row,col) = SW_{row*4+col+1}), тик
    ~32 мс (~500 Гц), дебаунс ~30 мс, авто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
2026-10-31 manuals: PDF-версия инструкции к монитору fw_mon в ретро-стиле — работа с командами иллюстрирована рисунками 7-сегментного индикатора
    manuals/fw_mon_acde_manual_retro.pdf (11 стр., книжный формат, стиль
    ретро-техдокументации на миллиметровке): содержание md-руководства
    без изменений — обложка с индикатором «ACdE», клавиатура, все 4 режима
    (A/C/D/E), память, 3 примера, заметки. Работу с командами иллюстрируют
    рисун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
2026-10-31 beta/txclient: v3.10 txclient — терминальный вывод CPU→PC через захват записи в ПОРТ 07h, транзит SOD удалён (ТЗ владельца «нам не нужен TX и ты можешь убрать SOD… будем знать когда процессор пишет в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
2026-10-31 beta/txclient: TXCLIENT v1 - вывод в ПК без UART-терминала (директива владельца: «убери SOD, будем знать, когда процессор пишет в область вывода UART»; база v3.9.2). Монитор ЗАПИСЕЙ CPU в страницу-ок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
2026-11-01 beta/txclient: TXCLIENT v2 — ответ на вопрос владельца «захват большей страницы ОЗУ чем 4К не получается?» — ПОЛУЧАЕТСЯ: ВСЁ ОЗУ 8000h-FFFFh с ПОЛНЫМ 16-битным адресом в пакете, в тех же МЦ. ТРЮК: hi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
2026-11-01 beta/README: строка 4 очереди (txclient) — v2-логгер как текущий кандидат (всё ОЗУ + 16-битный адрес, S0/S1-классификация, hi прямо в shreg; sim 37/37; прогноз ~103/108 МЦ); v1-окно и v3.10 — сохранё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
2026-11-01 beta/txclient: TXCLIENT v3 — разбор фита v2 у владельца (11-1 9:26AM, Placement Failed) и лекарство: СЕРИАЛЬНЫЙ захват hi-байта, AH-пины входят ровно в 1 ФБ. ДИАГНОЗ (отчёт заархивирован: retro_pcld_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
2026-11-01 beta/txclient: TXCLIENT v4 — фит v3 у владельца (11-1 11:02AM, Placement Failed) разобран и вылечен: РЕГИСТРОВЫЕ хелперы adv_q/ld_q + shreg 10→9 бит. ДИАГНОЗ (отчёт заархивирован: retro_pcld_top (v3-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
2026-11-01 beta/txclient: TXCLIENT v5 — фит v4 у владельца (11-1 6:16PM, Placement Failed) разобран и вылечен; вопрос владельца «может всё таки перейти к захвату конкретного региона ОЗУ, скажем 8000-C000?» — ДА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
2026-11-01 beta/txclient: TXCLIENT v6 — фит v5 у владельца (11-1 7:31PM, Placement Failed, отчёт заархивирован: retro_pcld_top (v5-fit-1101-731PM-FAILED).rpt) разобран и вылечен: СДВИГ ИСТОЧНИКОВ КАДРОВ 2/3 К L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
2026-11-01 beta/txclient: TXCLIENT v6, правка компиляции (п.23.1) - ответ на провал HDL-компиляции у владельца 11-2: XST HDLCompilers:28 "'...' has not been declared" x17 (al_shift 1338/1355, bit_cnt 1454-1461+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
2026-11-02 beta/lowsize: v3.9.3 «сброс логики -> СЕТЬ GSR» (п.18 шапки) - мера по сбросу отработана по линии lowsize по директиве владельца («эта мера направленная на снижение размера прошивки, нужно отрабатыва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
2026-11-02 beta/lowsize: v3.9.3 «сброс логики -> СЕТЬ GSR» (п.18 шапки) — МЕРА ЗАКРЫТА ПО ПОЛНОМУ ЦИКЛУ (фит + симуляции + ЖЕЛЕЗО). Ответ на контрольный запрос владельца «Еще раз проверь отчет синтеза по этой ж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
2026-11-02 beta/lowsize: v3.9.3 — ВТОРОЙ ФИТ 11-2 9:54PM ПРОШИТ В ЖЕЛЕЗО И РАБОТАЕТ; аудит обоих фитов сошёлся, мера п.18 (GSR) закрыта окончательно. Ответ на «Проверяй отчет - железо прошито и работает!»: влад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
2026-11-02 lowsize: README — рекорды ресурсов v3.9.3, расклад по ФБ против предшественников
    - новый раздел: таблица МЦ/вх.ФБ/ПТ по всем 6 ФБ (v3.9/v3.10/v3.9.2/оба фита 11-2),
    воспроизводится fit_survey.py
    - достижения: минимумы ПТ и вх.ФБ одновременно, снят потолок 36/36* (в v3.9 — три ФБ),
    ФБ6 36->22, исчерпанный ФБ4 разгружен, запас прошитого фита 23 МЦ/345 ПТ/45 вх.ФБ
    - исправлена строка о перераспределении МЦ по ФБ (старые дельты не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
2026-11-02 txclient v7: база v3.9.3 — сброс логики и сериализатора -> СЕТЬ GSR (п.24)
    Задание владельца: на основе последнего lowsize дизайна попробовать txclient.
    RTL v6 БЕЗ ПРАВОК (протокол/шина/сериализатор бит-в-бит), меняется только сброс:
    - оба always-блока (38 шинный движок + 24 сериализатор) асинхронно по RST -> GSR
    (схема доказана v3.9.3: фит 11-2 GSR : 1 1, железо ПАСС)
    - cpu_rst УДАЛЁН (в v5-фите 306 литералов RST/por_run - должны исчезнуть)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
2026-11-03 txclient: ФИТ 1 v7 (11-3 6:46PM, Placement Failed) разобран — МЕРА П.24 (GSR) СРАБОТАЛА, стена — ёмкость; отчёт заархивирован, аудит-скрипт fit_audit_v7.py. Ответ владельцу «Готово смотри отчет, фит 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
2026-11-03 txclient: v8 = МЕРА М1 (одобрена владельцем «Делай M1») — por_sh 8->4 СО СТРОБОМ ВДВОЕ РЕЖЕ. RTL top_txclient_v8_utf8.v / top_txclient_v8.v (CP1251, близнецы бит-в-бит): кодовая дельта v7->v8 РОВНО 4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
2026-11-03 txclient: аудит фита 1 v8 (11-3 8:47PM, Placement Failed — ОЖИДАЕМЫЙ сценарий «Что делать» п.4): М1 перебила прогноз — потребность 114 → 103 МЦ (прогноз был 110), бездомных узлов 7 → 3 (все пять D<X>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
2026-11-04 beta/hwuart: НОВАЯ ЛИНИЯ — аппаратный UART-трансивер v4.0.0 на базе lowsize v3.9.3 (полудуплексное ядро 23 МЦ). Директива владельца 11-3 («отставим пока txclient… полноценный UART трансивер, пусть по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
2026-11-04 hwuart v4.0.0: порядок объявлений - блок автомата ВЫШЕ ядра UART (HDLCompilers:28)
    Первый прогон ISE упал: 'state'/'S_T2'/'addr_latch' has not been declared
    (старые строки 985-989) - декоды io_wr_tx/io_rd_rx/io_rd_st в ядре UART
    ссылаются на объявления автомата шины, стоявшие НИЖЕ по файлу.
    Исправление: блок объявлений автомата (localparam S_*, state, rd_seen/
    wr_seen, addr_latch/bus_reg, seg_q/dig_q/snd_q/kbcol_q, io_rd_kb,
    in_wb..rd_drive) перенесён ВЫШЕ секции UART; порядок секций теперь
    POR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
2026-11-04 hwuart: аудит фита 1 v4.0.0 (11-4 8:00PM, Design Rule Checking Failed) — вина ОПЦИЙ фиттера, не RTL
    Опции прогона: Input Limit=1, Pterm Limit=1, Exhaustive=ON (хвост .rpt) —
    против 28/18/OFF во всех 12 прежних прогонах репозитория. При 1/1 свёртка
    запрещена: 430 unmapped buried, из них ~358 интермедиатов $OpTx$
    (BIN_STEP/BIN_AND/FX_DC/FX_SC — 2-входовые цепочки от A/D-мультиплексоров
    и декодов) и ~72 реальных узлов дизайна; 46 выходов + 430 = 476 МЦ ->
    ERROR 837/868. No logic has been mapped; GSR/clo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
2026-11-04 hwuart: аудит фита 2 v4.0.0 (11-4 8:17PM, Placement Failed при ВЕРНЫХ опциях 28/18/OFF) - честная стена вх.ФБ 213/216 (99%), потребность 106 МЦ = прогноз README ТОЧНО; бездомные $OpTx$FX_SC$155 17вх 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
2026-11-04 hwuart: аудит фита 3 v4.0.0 (11-4 8:40PM, Placement Failed) - мера 1 применена ТОЧНО (Input Limit 16, Pterm 18, Exhaustive OFF - хвост .rpt), сработала наполовину: ERROR 892 ушёл, $OpTx$FX_SC$155 (18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
2026-11-04 lowsize v3.9.4: М1 из txclient v8 - POR-счётчик 8->4 со стробом x1_n (одобрено владельцем 'Делаем Б' 11-5, маршрут Б: сначала база, потом перебазирование hwuart -> v4.0.1). ДЕЛЬТА - 3 СТРОКИ: reg [3: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
2026-11-04 lowsize: аудит фита 1 v3.9.4 (11-4 10:15PM, SUCCESSFUL) - М1 применилась ТОЧНО, рекорды линии по всем 4 метрикам; сравнение с прогнозом и родословной 3.9.1-3.9.4 ИТОГ: 82/108 МЦ (76%), 182/540 ПТ (34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
2026-11-04 hwuart v4.0.1: М1 в базу (шаг 2 маршрута Б, команда владельца 'делаем hwuart v4.01' 11-5) - POR-счётчик 8->4 со стробом x1_n. ДЕЛЬТА - 3 СТРОКИ в базовой части top_hwuart_por6_v401.v: reg [3:0] por_s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
2026-11-05 hwuart: аудит фита 1 v4.0.1 (11-5 6:50AM, Placement Failed) - М1 применилась ТОЧНО (пор-цепь бит-в-бит эталону lowsize v3.9.4), стена продвинулась по всем метрикам, но окно для bit_cnt не появилось. 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
2026-11-05 lowsize v3.9.5: ИСПРАВЛЕНИЕ ДЕФЕКТА СТАРТА v3.9.3/v3.9.4 (жалоба владельца 11-5: после включения питания плата запускается очень нестабильно, по кнопке сброса не стартует, передёргивание питания помо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
2026-11-05 lowsize: аудит фита 1 v3.9.5 (11-5 10:40PM, SUCCESSFUL) - чек-лист TODO 3c: п.2/п.3 СОШЛИСЬ, п.1 GSR НЕ свёлся (Global set/reset unused) - сработал предсказанный fallback, разбор показал ДЕШЁВЫЙ вари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
2026-11-06 lowsize v3.9.6: ХАРДРЕНИНГ ЦЕПИ СБРОСА (жалоба владельца 11-6 на v3.9.5, у ОБОИХ фитов Exhaustive ON/OFF: «только выкл-вкл питания возвращает работоспособность по сбросу; просто сброс не может восста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
2026-11-06 lowsize: дополнение 11-6bis - новая фактура владельца (ручной сброс ноги CPU без участия CPLD тоже не помогает; 8.8.8.8 сразу при включении; кнопка N раз - нуль; выкл-вкл питания случайно возвращает 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
2026-11-06 lowsize v3.9.7: ВОЗВРАТ КОЛЬЦЕВОГО ДЕЛИТЕЛЯ (п.22; директива владельца «возвращаем в дизайн 3.9.7 делитель на основе кольцевого сдвигового регистра») + ДОПОЛНЕНИЕ 11-7 (продолжение исследования 3.9.3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
2026-11-06 lowsize v3.9.8: УЗЕЛ ТАКТИРОВАНИЯ НА 50 МГц (п.23; схема владельца 11-6bis-2: «почему ты держишься за 25МГц входной частоты на CPLD, берем делитель /2 и делаем все гораздо проще» + эскиз кольца N=7 н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
2026-11-06 lowsize v3.9.8 ФИКС СИНТЕЗА (жалоба владельца на фит v3.9.8: ERROR:HDLCompilers:28 - строки 1176/1179/1180 'x1_n' has not been declared; директива «исправь, закомить и запушь в 3.9.8, новую не создав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
2026-11-06 hiclock v3.9.9h: ПОДЪЁМ ЧАСТОТЫ CPU 3,571 -> 4,167 МГц (директива владельца: «на базе 3.9.8 поднять частоту до 4.167МГц, создать её в hiclock»). ЕДИНСТВЕННАЯ ПЕРЕМЕННАЯ - ДЛИНА КОЛЬЦА one-hot N=7 -> 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
2026-11-06 hiclock v3.9.9h ПЕРЕНОС В beta/hiclock (директива владельца: «hiclock папка находится в beta, перенеси дизайн туда») + АУДИТ ФИТА 1 (11-6 11:29PM, SUCCESSFUL) - ВЕРДИКТ: ФИТ ЗОЛОТОЙ, ПРОГНОЗ СОШЁЛСЯ 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
2026-11-07 lowsize v3.9.8-clear: ЧИСТКА КОММЕНТАРИЕВ (директива владельца 11-7: «много исторического мусора в комментариях [v3.9.8]... вынести в дневник разработки в корне beta... оставить только те комментарии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
2026-11-07 hiclock ФИНАЛ кампании частоты 2 (11-7, директива владельца: «Нет, у коллеги не пошел 8085 даже на повышенном напряжении питания, отставим попытки выбраться за 4МГц») - ЖЕЛЕЗО ОКОНЧАТЕЛЬНО ОТКЛОНИЛО 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
2026-11-07 fw_mon v2 (Изд. 2, 11-7): F2 = ПОКАЗ АДРЕСА ОПЕРАЦИЙ (директива владельца: «Доработай монитор ACdE - по нажатию на кнопку F2, выводи на дисплей текущий адрес по которому производятся операции»). ДИЗА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
2026-11-07 lowsize v3.9.8-clear ред.2: МЁРТВЫЙ КОД ВЫЧЕРКНУТ (директива владельца после фита ред.1: «ты плохо почистил 398_clear, например там остались неиспользуемые сигналы» - Xst:1780 по x2_q/x2_p/x1_q/x1_p/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
2026-11-07 DEVLOG 11-8: полевой вердикт владельца «монитор работает» - fw_mon v2 (F2 = показ адреса операций) подтверждён железом, петля F2 закрыта (офлайн 54/54 -> железо ПАСС); запись сверху дневника + остато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
2026-11-07 lowsize v3.9.8-clear ред.2: РЕФИТ ПРОАУДИРОВАН - НЕТЛИСТ 1-В-1 ЗОЛОТОМУ v3.9.8, ЖЕЛЕЗО РАБОТАЕТ (слово владельца: «Отчет по 398_clear смотри, железо - работает!»; .rpt 11-7 10:09PM, IL 28/Pterm 18/Ex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
2026-11-07 manuals/fw_mon ИЗД. 2 ред.2: ИСПРАВЛЕНИЯ МАНУАЛА ПРО F2 (директива владельца после железной приёмки монитора). Сверка §7/§1/§2/§9/FAQ с fw_mon.asm (K_F2=12h row4/col2 SW19, K_F2E/KF2B/DSW, PREVST=FFF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
2026-11-07 txuart v1.0 (beta/txuart): ИСКЛЮЧИТЕЛЬНО АППАРАТНЫЙ ПЕРЕДАТЧИК UART 1 562 500 бод - RTL + верификация ГОТОВЫ, ждёт фита владельца (директива 11-8: «организовать исключительно аппаратный трансмиттер U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
2026-11-08 txuart v1.0 АУДИТ ФИТА 1 (11-8 5:10PM, слово владельца «Отчет по дизайну top_txuart_por6, смотри»): Successful, прогноз п.30 сошёлся (100/108 МЦ, 259/540 ПТ, 190/216 вх.ФБ, 71 рег, 72/81 ноги, PGND 9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
2026-11-08 txuart v2.0 НА БАЗЕ v3.9.8-clear (директива владельца: «Берем дизайн beta\lowsize 398_clear и переделываем txuart на основе него»): КОЛЬЦО r0..r6 ВЕРНУЛОСЬ В НЕТЛИСТ, ядро на clk25/cpu_rst, ЦЕЛЬ XC95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
2026-11-08 txuart v2.1: СЖАТИЕ ЯДРА 20 -> 18 МЦ ПОД XC95108 (директива владельца 11-8веч: «У нас нет еще 144 Xilinx, все так же на 108, смотри отчет фит нее лезет»; .rpt 11-8 7:14PM xc95108 FAILED, ERROR:Cpld:8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
2026-11-08 txuart v2.2: УЗЕЛ /4 НА 25 МГЦ (H1 С ШУНТОМ) ПО ДИРЕКТИВЕ ВЛАДЕЛЬЦА (11-9: «уйти на более простой делитель тактовой, подать на вход не 50, а 25, потом /4 и подать на процессор») — RTL + верификация Г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
2026-11-08 txuart v2.2: ФИТ 11-8 23:51 РАЗОБРАН — 103/108 МЦ, ЧЕК-ЛИСТ ЗАКРЫТ (check_fit_v22.py 55/55); ПРОШИВКА ПЗУ ДЛЯ ЖЕЛЕЗНОЙ ПРОВЕРКИ TX ГОТОВА И ПРОСИМУЛИРОВАНА (rom/uart_tx_test, сим 10/10) (директива вл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
2026-11-09 txuart v2.3: МУСОР В ТЕРМИНАЛЕ РАЗОБРАН ПО ДАМПУ — CH340G НЕ УМЕЕТ 1 562 500 (драйвер МОЛЧА ставит 1 500 000, +4,17%) — бод 25/16 -> 25/25 = РОВНО 1 000 000, ТОЧНАЯ сетка CH340G (48М/48, ошибка 0%). 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
2026-11-09 txuart: v2.3 ПРИНЯТА ЖЕЛЕЗОМ (фит 11-9 7:26PM 103/108 - БЕЗ РОСТА МЦ; терминал 1М ЧИСТ) + TXSTRESS v1.0 (rom/txstress) - тест максимальной нагрузки на вывод + uart_speed.ps1 - измеритель скорости/цел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
2026-11-09 txuart: uart_speed.ps1 v1.1 - ИСПРАВЛЕН критический баг v1.0 (доклад владельца 11-10: COM13 1М 8N1 - 9x PropertyAssignmentException «не удается найти свойство PortName/BaudRate/...» + «в [System.Stri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
2026-11-10 txuart: КОРЕНЬ ТРЁХ ПРОГОНОВ НАЙДЕН — БАГ АССЕМБЛЕРА size_of() → hex v1.0 В ПЗУ ИСПОЛНЯЛСЯ КОРРУПТИРОВАННЫМ; TXSTRESS v1.1 (пересборка + чин гейта лендмарков + токен ' TXSTRESS') + uart_speed.ps1 v1.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
    (0) ИСХОДНЫЕ ДАННЫЕ — три прогона владельца 11-10 (COM13, 1 000 000 8N1, TX_BOTH=1, uart_speed v1.1, окно 60 c, txstress_v10.hex в ПЗУ): (1) 60.2 c, 61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
2026-11-10 txuart: TXSTRESS v1.1 ПОДТВЕРЖДЁН ЖЕЛЕЗОМ (8 циклов в пасте владельца 11-10: баннер ловится каждые 1.097-1.100 с = сим-прогноз 1.091; FLOOD 65 536 Б/цикл ровно, паттерн +1 ЦЕЛ, разрывов 0; лендмарков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
2026-11-10 txuart: ПОЛНЫЙ ЛОГ v1.2 (60 с, COM13) РАЗОБРАН — 53/53 ЦИКЛА БЕЗ ЕДИНОГО СБОЯ, ВЕРДИКТ ЗЕЛЁНЫЙ (доклад владельца 11-10-3, uart_speed_v12_com13_60s.log — OEM-866 декодирован в UTF-8, committed). (1) Ж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
2026-11-10 txuart: КОНТРОЛЬНЫЙ ПРОГОН uart_speed v1.3 ПРИНЯТ — 52/52 ЦИКЛА БЕЗ ЕДИНОГО СБОЯ, ВЕРДИКТ «бит-ошибок НЕТ», TXSTRESS-КАМПАНИЯ ЗАКРЫТА (доклад владельца 11-10-3, uart_speed_v13_com13_60s.log — OEM-866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
2026-11-10 gfxstream: ПОТОЛОК ПОЛОСЫ НАЙДЕН В ИСХОДНИКЕ — 42T = СТРАХОВОЧНЫЙ ДВОЙНОЙ OUT (TX_BOTH=1), ПОЛ 8085 = 32T = 97 656 Б/с = 97,7% ЛИНИИ, И hex УЖЕ СОБРАН (txstress_v11_p04.hex, TX_BOTH=0, не прошивался)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
2026-11-10 txuart: ШАГ 0 GFXSTREAM ПРИНЯТ — p04-ПРОГОН 71/71 ЦИКЛА БЕЗ ЕДИНОГО СБОЯ, ПОТОЛОК 32T ПОДТВЕРЖДЁН ЖЕЛЕЗОМ: FLOOD 97 887 Б/с = 97,9% ЛИНИИ, СМЕШАННЫЙ ЦИКЛ 91,4% (доклад владельца 11-10-5, log2 -> uart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
2026-11-10 gfxstream: FIRMWARE GFXSTREAM v1 + ПК-ВЬЮЕР ГОТОВЫ И ПРОВЕРЕНЫ ДО ЖЕЛЕЗА — СИМ ПО РЕАЛЬНОМУ HEX 205 КАДРОВ «ВСЁ ОК» (0 ОТБРОСОВ TX, ПЕРИОД 125 000T ±95T = 25.000 FPS, ПОБАЙТОВАЯ СВЕРКА ПАТТЕРНА), ВЬЮ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
2026-11-10 gfxstream: ЛИСТИНГ gfxstream_v1.lst (738 Б, T-состояния каждого цикла построчно) — довесок к 2df2033; сборка: python3 beta/txuart/rom/txstress/asm8085.py gfxstream_v1.asm gfxstream_v1 > gfxstream_v1.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
2026-11-11 gfxstream: ФИКС — gfx_view.ps1 НЕ ПАРСИЛСЯ В WINDOWS POWERSHELL 5.1 У ВЛАДЕЛЬЦА (9 ОШИБОК PARSERERROR ЕЩЁ ДО ЗАПУСКА): ФАЙЛ БЫЛ UTF-8 БЕЗ BOM, 5.1 ЧИТАЛ ЕГО В CP1251 — КИРИЛЛИЦА = МОДЖИБЕЙК, БАЙТЫ 93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
2026-11-11 gfxstream: ФИКС-2 ВЬЮЕРА — GFX_VIEW.PS1 v1.1, У ВЛАДЕЛЬЦА РАНТАЙМ-ПАДЕНИЕ GUI НА СТРОКЕ 374: «СБОЙ ВЫЗОВА МЕТОДА ИЗ-ЗА ОТСУТСТВИЯ В [System.Object[]] МЕТОДА С ИМЕНЕМ op_Addition». ПРИЧИНА: New-Object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
2026-11-11 gfxstream: ФИКС-3 ВЬЮЕРА (ПЕРФ) — GFX_VIEW.PS1 v1.2: У ВЛАДЕЛЬЦА ПЕРВЫЕ 3 С ШАР ШЁЛ РОВНО (75 ПОЛНЫХ КАДРОВ TYPE 01), НА ДЕЛЬТАХ TYPE 02 — РЫВКИ. ДИАГНОЗ ПО ГРАНИЦЕ ФАЗ: FFh-ДОБИВКА ДЕЛЬТЫ (1798 Б/КА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
2026-11-11 gfxstream: ФИКС-4 ВЬЮЕРА (КАДЕНС ОТРИСОВКИ) — GFX_VIEW.PS1 v1.3: v1.2 У ВЛАДЕЛЬЦА «ВСЁ ТАК ЖЕ», РЫВКИ НА ДЕЛЬТАХ ОСТАЛИСЬ (ГРАНИЦА ~КАДР 75-80 = ПЕРЕХОД TYPE 01 -> TYPE 02). ЦИФРЫ ДОКЛАДА (КАДРЫ 1504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
2026-11-11 gfxstream: ФИКС-5 ВЬЮЕРА (КРАСКА ВНЕ ПОТОКА ЧТЕНИЯ) — GFX_VIEW.PS1 v1.4: ВЛАДЕЛЕЦ ПРИСЛАЛ САМОТЕСТ 12/12 (ДЕКОД 264 МС НА БЮДЖЕТ 5200, ЗАПАС 20Х) + CSV-ЛОГ ЖИВОГО СЕАНСА (-Log), 419 КАДРОВ. ЛОГ ПОДТВ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
2026-11-11 gfxstream: ПРИЁМКА ШАГА 3 ЗАКРЫТА — решающий лог v1.4 у владельца (358 кадров/15,56 с): критерий ФИКС-5 выполнен (пар dt<=5 в полных фазах 0 — все 9 в первых 130 мс холодного старта, буфер 11657 Б); 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
2026-11-11 gfxstream: ДЕМО v2 — БЫСТРЫЙ ШАР + ТРИ СЦЕНЫ (владелец: 'даешь быстрый шар и демонстрацию графических возможностей') — gfxstream_v2.{asm,hex,bin,lst} 1790 Б из 8 КБ, ФОРМАТ ПРОВОДА v1 НЕ ТРОНУТ (TYPE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
2026-11-11 gfxstream: v2.1 — ПЕРИОД КАДРА 46 875 мкс = 3 ТИКА ДИСПЛЕЯ (владелец по живому логу v2 10513 кадров: 'только косое заполнение плавно, остальные резко меняют позицию объектов'). ФОРЕНЗИКА: провод идеа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
2026-11-12 gfxstream: v2.2 КАЛИБРОВКА ПЕРИОДА ПЛАТЫ + ВЬЮЕР v1.5 — по живому логу v2.1 владельца (2606 кадров/120.5 с, 'мячик не плавно и скачет'): ФОРЕНЗИКА (новый анализатор scripts/gfx_log_analyze.py) — пров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
2026-11-12 gfxstream: АНАЛИЗАТОР ЛОГОВ В РЕПО (дополнение к v2.2/f117fd3) — в коммите v2.2 анализатор упоминался как scripts/gfx_log_analyze.py, но в репо не попал (жил в рабочей папке песочницы). Теперь beta/t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
2026-11-12 gfxstream: README ПОДПРОЕКТА beta/gfxstream — сводная документация v2.2/вьюер v1.5: цели и задачи (формат провода v1 заморожен, демо-сцены, калибровка периода под сетку дисплея, диагностика на обеих 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
2026-11-12 xstream: ПОДПРОЕКТ beta/xstream — ПРЕРЫВАНИЕ -> ВЕСЬ ЭКРАН В UART (ТЗ владельца 11-12): 8085 по тику выдаёт весь экран из фиксированного ОЗУ B000h..B7CFh (80x25 = 2000 Б, row-major, CP1251 у клиента)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
2026-11-13 xstream: ПЕРВЫЙ ЖЕЛЕЗНЫЙ ПРОГОН ВЛАДЕЛЬЦА — УРОК 6: глифы-призраки L.L.L.1 поверх ACdE пойманы железом: в XDIG указатель глифа - ПАРА DE, а лежало D=0F5h/E=бит разряда -> LDAX D читал мусор ОЗУ 0F5xx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
2026-11-13 xstream v1.2: ВТОРОЙ ЖЕЛЕЗНЫЙ ОТЧЁТ ВЛАДЕЛЬЦА — ТРИ ДЕФЕКТА ИСПРАВЛЕНЫ. (1) SelfTest №2 FAIL «frames=1, rs=0»: в v1.1 мусор $garb создавался, но НЕ подавался в парсер (потерян Add-Bytes) — подача доб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
2026-11-13 tools/: КАНОН АССЕМБЛЕРА 8085 В РЕПО (просьба владельца 11-13 «создадим на github папку tools, чтобы не искать в контексте и не писать ассемблер заново») — tools/asm85.py v1.1 = СЛИЯНИЕ ДВУХ ЛИНИЙ (a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
2026-11-13 xstream v1.2.1: ТРЕТИЙ ЖЕЛЕЗНЫЙ ОТЧЁТ ВЛАДЕЛЬЦА — v1.2 ПОДТВЕРЖДЁН ЖЕЛЕЗОМ (SelfTest: «ресинк=1, кадр принят без потерь», кейс 2b SEQ=7/scr0=87; «Дисплей работает замечательно» — урок 9 закрыт) + ЛАТ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
2026-11-13 xstream v1.2.2: ЧЕТВЁРТЫЙ ЖЕЛЕЗНЫЙ ОТЧЁТ ВЛАДЕЛЬЦА — ПЕРВЫЙ ЖИВОЙ СЕАНС С -Log ЧИСТ (117.9 с, 2412 кадров, 4 838 677 Б, РЕСИНКОВ 0), РАБОЧАЯ ТОЧКА ПОДТВЕРЖДЕНА ЛОГОМ + ДВА ДЕФЕКТА КЛИЕНТА ИЗ ЛОГА ПОЙ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
2026-11-14 txuart: ЧИСТКА ПАПКИ (директива владельца «оставь только v23») — в beta/txuart остались ровно: top_txuart_por6_v23.v (действующий дизайн v2.3, принят железом, бод ровно 1 000 000), top_txuart.ucf (цо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
2026-11-14 txuart v2.4: УЗЕЛ - ДЕЛИТЕЛЬ владельца 3 FF (t0/x1/x2) вместо кольца one-hot 5 МЦ: -2 МЦ, X2 регистровая точная противофаза (D=~(x1^t0), без лага, однолитеральный БРАК в rpt), частота CPU не изменена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
2026-11-14 txuart v2.5: АУДИТ фита v2.4 - Successful 101/108 (ровно прогноз), но D(X2) напечатан XOR БЕЗ NOT (RTL был XNOR) => X2 в фазе = БРАК, НЕ ШИТЬ; класс 'потеря инверсии' (прецеденты 7:31/8:55), гейт п.9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
